sdylewski/Analog-Redial/README.md

**Home** · [1 · Get a board](docs/board.md) · [2 · Parts & assembly](docs/bom.md) · [3 · Flash & test](docs/flashing.md) · [4 · Set up & use](docs/setup.md)

<p align="center">
  Analog Redial logo
</p>

<h1 align="center">Analog Redial</h1>

<p align="center">
  <b>Bring old telephones back to life.</b><br>
  Plug in one or two analog phones, rotary or touch-tone, and they get real
  dial tone, ringing, an operator recording and an answering machine: a complete standalone phone system.<br>
  Hackable open source hardware and software with a working web UI for configuration.</p>

<p align="center">
  <a href="#everything-it-connects-to">Overview</a> ·
  <a href="#what-can-i-do-with-it">What it does</a> ·
  <a href="#set-it-up-from-your-browser">Web interface</a> ·
  <a href="#what-does-one-cost">Cost</a> ·
  <a href="#build-one">Build one</a> ·
  <a href="#community">Community</a>
</p>

<table>
  <tr>
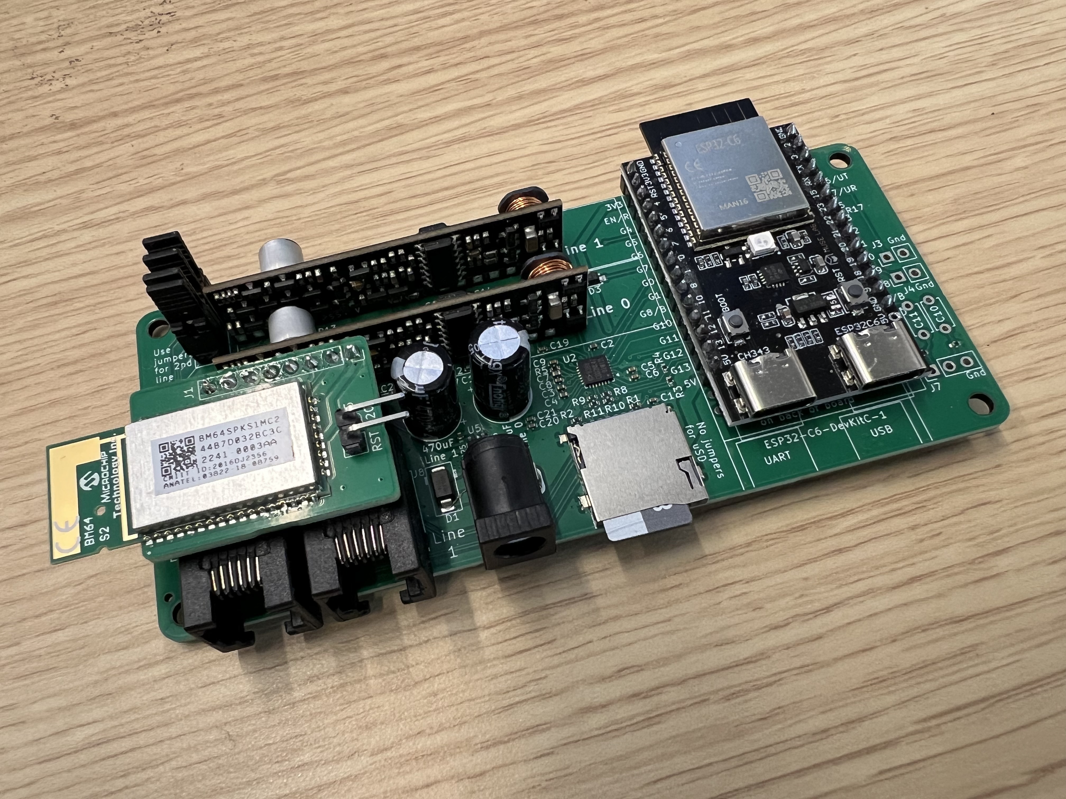
[picture p1: docs/pics/V5_board.jpg]
The Analog Redial board
    <td width="50%"></td>
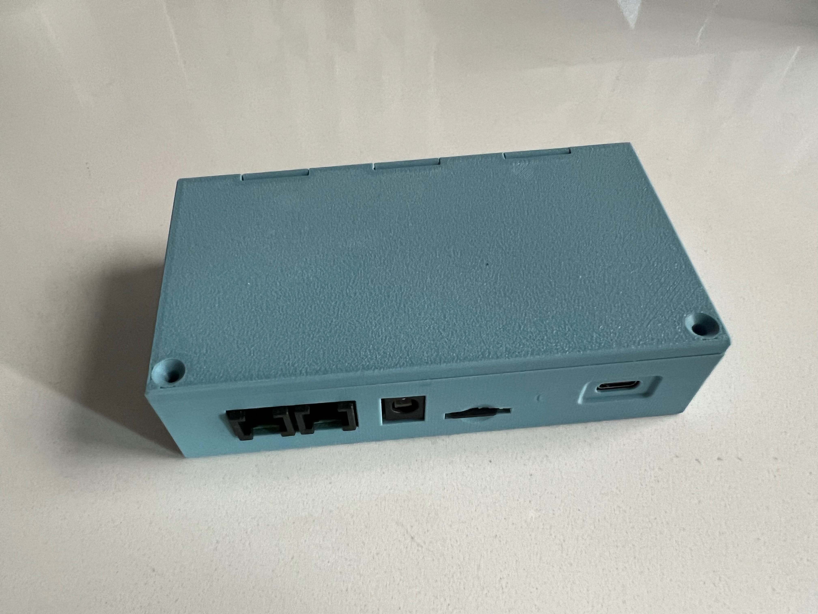
[picture p2: docs/pics/v4_case.jpg]
The board in its 3D-printed case
    <td width="50%"></td>
  </tr>
  <tr>
    <td align="center">The board: an ESP32-C6, an audio codec, with dual phone lines and the bluetooth module.</td>
    <td align="center">In its 3D-printed case <br>(<a href="https://github.com/sdylewski/Analog-Redial/blob/main/docs/case.md">case guide and print files</a>)</td>
  </tr>
</table>

## What can I do with it?

| | What you get | What you need |
|---|---|---|
| **Offline Calling** | Two phones, one board. Dial **321** (configurable) and the other phone rings.  No Wi-Fi required. Use in 2 rooms of a house or a fun toy for kids| 2 phones |
| **A phone that does things** | Dial a code and something happens: play a clip, leave a message, hear a joke. For museum exhibits, art pieces, a wedding guestbook phone. Add your own codes and audio from the browser. | One phone |
| **Call between boards** | Put a board in each room. Each gets its own 4-digit number the first time it's on your Wi-Fi; dial another board's number and its phone rings. It's VoIP over your home network: no server needed. | Two or more boards <br> Wi-Fi |
| **VoIP server** | Register a line with Asterisk, FreePBX or any SIP server and call anything that server can reach, at home or away. If the server goes down, the boards can still call each other directly. | One phone <br> Wi-Fi <br> SIP server |
| **Home Assistant** | Every pickup, hang-up and dial code becomes an event, so a dial code can turn on a light and the phone can ring when your doorbell does. Over MQTT or a plain webhook. *Experimental.* | Wi-Fi and Home Assistant (or any MQTT broker) |
| **Switch things** | Dial a code and a pin goes high for a few seconds or continuously: a relay, a buzzer, a lamp. | One line <br> no microSD <br> a relay |
| **Bluetooth calls** | Pair your mobile and the rotary phone becomes its handset: the bell rings for incoming calls, lift to answer, dial out on the rotary dial. | The BM64 Bluetooth board |

### Why not just buy a VoIP adapter?

You can do a lot with VoIP adapters and an Asterisk server, but this system can work fully offline if desired while also adding VoIP when needed.  There's also the possibility of uSD card access, bluetooth, or 4 GPIO pins to do even more.

## System overview

<p align="center">
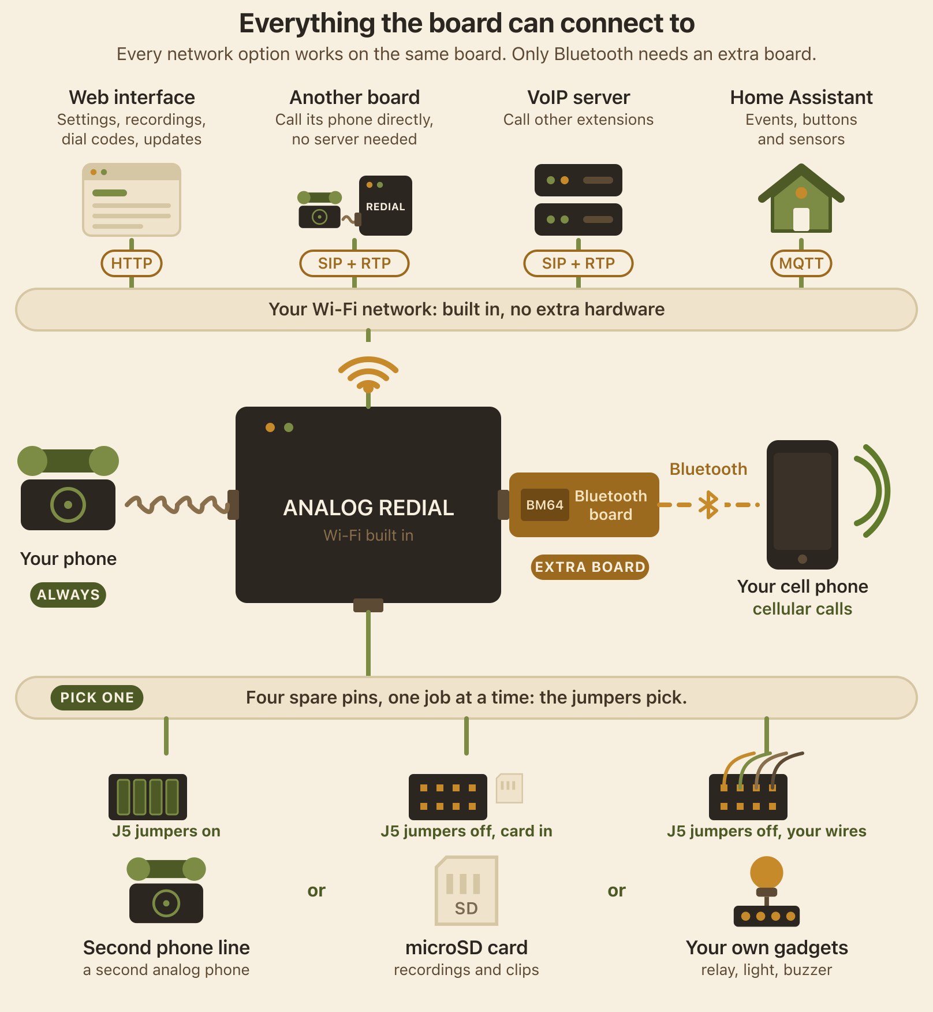
[picture p3: docs/assets/setup-overview-top-web.png]
Everything the Analog Redial board can connect to: one phone always, then a second phone line or a microSD card or your own gadgets on four spare pins chosen with the J5 jumpers; Wi-Fi to the web interface, other Analog Redial boards, a VoIP server and Home Assistant; and Bluetooth to a cell phone 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
  
</p>

Every network option runs on the board's own Wi-Fi, with nothing to add.
Bluetooth is the only one that needs an extra board.

### The finer print

- **Dialing.** Rotary pulse and touch-tone, on either line. Dial codes can be
  up to 10 digits (spaces, dashes and parentheses are ignored). Add your own
  codes and audio clips from the browser and give any built-in
  code a different number. 
  	- Play an audio file after dialing a number: **412** plays dial-up modem sounds
  	- Respond to any number: **314** reads pi aloud.
  	- A kitchen timer: dial **846**, then the number of minutes, and the phone rings when time is up.
  	- An alarm clock: dial **256**, then the time (0730), and the phone rings at that time.
  	- A weather line: dial **1212** for the forecast, read out like the old time-and-temperature numbers.
  	- Optional digit readback speaks each digit you dial (**822**
  on, **821** off)
- **Calls.** Line-to-line calls with ringback and busy tones. 
	- Optional intercom mode: lift one handset, wait, and the other phone rings with its
  own double ring. 
  	- Optional VoIP calls (G.711): directly between Analog Redial boards on the same network, with no server, or through a SIP server such as Asterisk.
- **Sound.** Dial tone, ringback and busy that match your country (North
  America, several European countries, Japan, China, or a generic
  international set). Echo cancellation and earpiece volume per line. An
  off-hook alert if a handset is left off. Experimental voice effects
  (Dalek, chipmunk, robot) mid-call.
- **Messages.** Record a message with **211** and download it from the
  browser. 
  	- Optional per-line answering machine, each line with its own greeting,
  that also answers VoIP or local calls. 
  	- Storage to internal flash or microSD card for hours of storage
  (1-line version only). 
- **Payphones.** Dial tone, ringing, dialing and calls work on a payphone like
  on any phone; the coin mechanism isn't supported yet. See
  [Payphones](docs/setup.md#10-payphones).
- **Home automation.** Every pickup, hang-up, dial code and incoming ring
  can go to Home Assistant, or any system that takes a webhook or MQTT. Home
  Assistant can ring a phone or fire a pin output back. Experimental; see
  [Home Assistant](docs/home-assistant.md).
- **Things on the pins.** A dial code can switch one of four spare pins
  (a relay, a buzzer, a lamp) for a set number of seconds, or toggle it.
- **Day to day.** Quiet hours that silence the bell overnight. Remembers
  several Wi-Fi networks. An optional web password. Firmware updates from
  the browser. A one-button rescue mode for when it can't find its network.
  Board blink codes to indicate activity and errors.
- **Open.** ESP-IDF C firmware under the MIT license, KiCad hardware files,
  and a serial console for debugging.

Full feature list and firmware architecture: [Features](docs/features.md).

---

## Set it up from your browser

The board serves its own web page at **`http://phone.local`**, reachable
from any phone or laptop on your Wi-Fi. No app, no account, no cloud. On
first boot it makes its own Wi-Fi network with a setup page that gets it
onto yours. Firmware is updating frequently, so these are just examples.

<table>
  <tr>
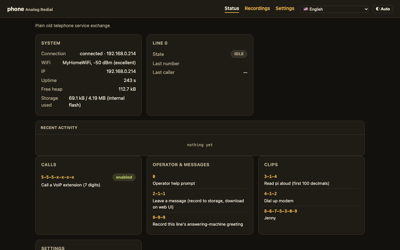
[picture p4: docs/pics/thumbs/status.png]
Status page
    <td align="center" width="33%"><br><b>Status</b><br>Lines, activity, the dial guide</td>
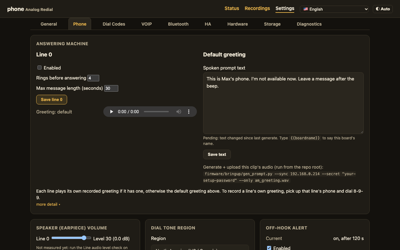
[picture p5: docs/pics/thumbs/settings-phone.png]
Phone settings
    <td align="center" width="33%"><br><b>Phone settings</b><br>Answering machine, tones, effects</td>
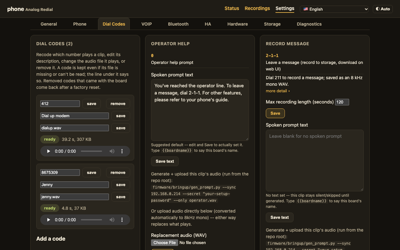
[picture p6: docs/pics/thumbs/settings-dialcodes.png]
Dial codes and prompts
    <td align="center" width="33%"><br><b>Dial codes</b><br>Your own codes and audio</td>
  </tr>
  <tr>
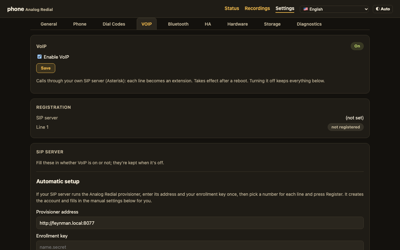
[picture p7: docs/pics/thumbs/settings-voip.png]
VoIP settings
    <td align="center"><br><b>VoIP</b><br>SIP server, generated Asterisk script</td>
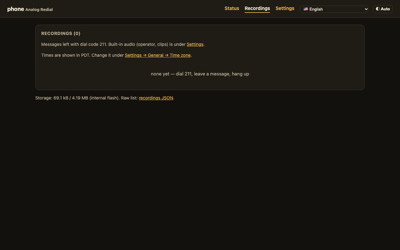
[picture p8: docs/pics/thumbs/recordings.png]
Recordings
    <td align="center"><br><b>Recordings</b><br>Play or download messages</td>
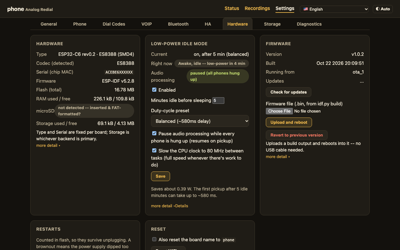
[picture p9: docs/pics/thumbs/settings-hardware.png]
Hardware settings
    <td align="center"><br><b>Hardware</b><br>Line count, microSD, firmware update</td>
  </tr>
</table>

Click any picture for the full page. A guided tour is in
[Set up & use](docs/setup.md).

---

## What does one cost?

US prices from October 2026, including shipping and import tariff:

| | Per board | 5 boards |
|---|---:|---:|
| Assembled PCB from JLCPCB, delivered (5-board minimum) | $17.11 | $85.53 |
| Parts you solder, from DigiKey ([parts list](docs/bom.md)) | $19 | $95 |
| DigiKey shipping, about $5 an order | $1 | $5 |
| **Total, one phone line** | **about $37** | **about $186** |
| Second phone line (optional) | +$10 | +$50 |
| Bluetooth board (optional, v5) | +$15 | +$80 |

**Five boards cost about $186 in all, about $37 each.**
JLCPCB's minimum is five, so it's about $110 up front, with four spare PCBs.
The five-board Bluetooth figure is $15 a board plus about $5 shipping. Buying
the hand-solder parts from AliExpress saves $7 per board.

You'll also want a 2 A USB-C charger (or a regulated 5-6 V, 2 A DC supply for the DC jack; never 9 V or 12 V) and one or two analog phones. 

Most of a small order is fixed PCB setup fees, so boards get cheaper when people
order together. If you'd like a board,
**[fill out the interest form](https://forms.gle/kVKHiXejV6M2ZxC17)**. It's
only to show interest, so I can email you when boards are available on Tindie;
there's no commitment. Questions? [Join the Discord](https://discord.gg/zEZkqfcxqE) and ask there.

Price breakdown: [Get a board](docs/board.md#what-it-costs).

---
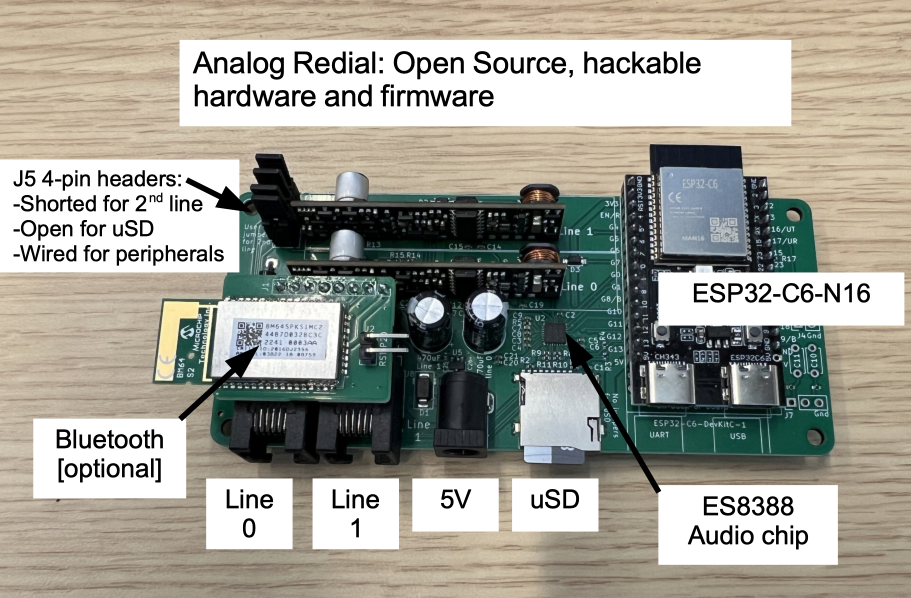
[picture p10: docs/pics/V5_board_annotated.png]
Analog Redial v5 board, with its parts labelled
<br>

## Build one

No surface-mount soldering needed: the fab places the small parts, and
everything you solder is through-hole. If you can solder a header and type a
few commands in a terminal, you can build one.

| Step | Guide | What's in it |
|---|---|---|
| **1** | [Get a board](docs/board.md) | Board versions, ordering from JLCPCB, buying on Tindie, costs |
| **2** | [Parts](docs/bom.md) and [assembly](docs/building.md) | What to buy, soldering order, checks before power-on; [v5 step by step](docs/build-v5.md) |
| **3** | [Flash & test](docs/flashing.md) | Install ESP-IDF, flash the firmware, run the hardware self-test |
| **4** | [Set up & use](docs/setup.md) | Wi-Fi, the web interface, dial codes, your own audio |

Going further: [Troubleshooting](docs/troubleshooting.md) ·
[VoIP setup](docs/voip-setup.md) ·
[Home Assistant](docs/home-assistant.md) ·
[Board reference (v4)](docs/hardware-smd4.md) ·
[Board reference (v5)](docs/hardware-smd5.md) ·
[Features & firmware architecture](docs/features.md) ·
[Firmware developer notes](https://github.com/sdylewski/Analog-Redial/blob/main/firmware/README.md)

> ⚠️ **Phone lines carry real voltage.** The board drives about 48 V DC on
> an off-hook line and about 60 V AC while ringing, with peaks near 90 V.
> Don't touch the phone jacks or the line chips while it's powered, and never
> connect it to your house or telephone-company wiring. This is a hobby
> project, not certified telecom equipment.

---

## Community

- **Discord:** [join the server](https://discord.gg/zEZkqfcxqE) for questions, build help and show-and-tell
- **Want a board?** [Interest form](https://forms.gle/kVKHiXejV6M2ZxC17): just to show interest, so I can email you when boards are available on Tindie. Questions? Ask in the Discord.
- **Bugs and questions:** [GitHub Issues](https://github.com/sdylewski/Analog-Redial/issues)
- **Built one?** Post a picture in the Discord channel! We'd love to see it.

---

## Project history

| When | Version | What it was |
|---|---|---|
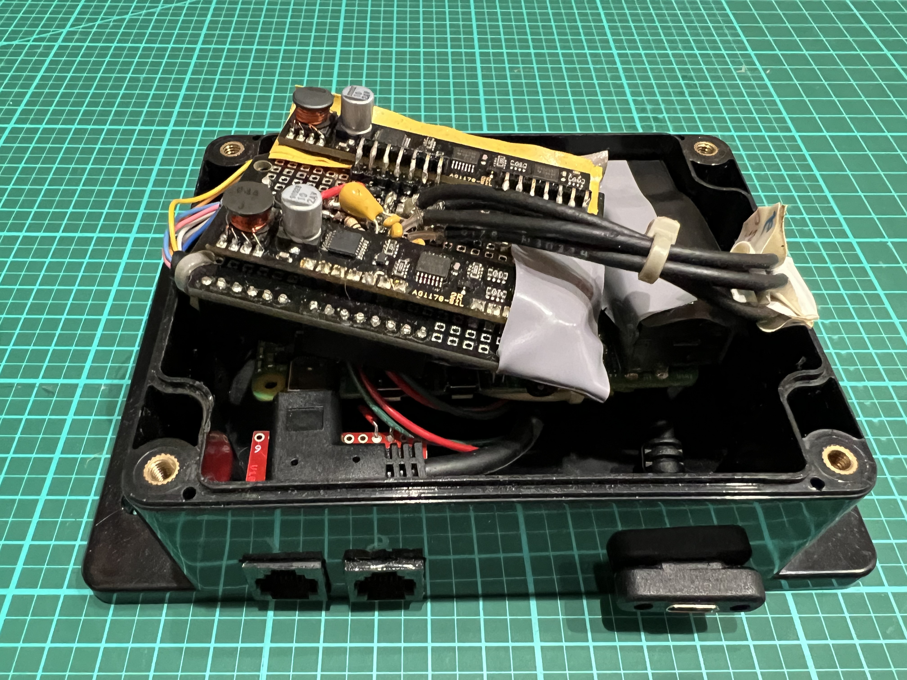
[picture p11: docs/pics/pi_version.jpg]
Raspberry Pi version in its project box
| Aug 2020 | **Raspberry Pi** <br> | A Raspberry Pi 4 in a project box, two SLIC modules hand-wired on breadboard to the GPIO header, and a USB sound dongle per phone line. Hand written python software and shell scripts. No web UI, but it worked!|
| Jun 2026 | **v1** | The first ESP32 board: through-hole, with a WM8731 codec and two AG1170 SLICs. The Pi's job on a $5 microcontroller. Never built because boards got lost in the mail.|
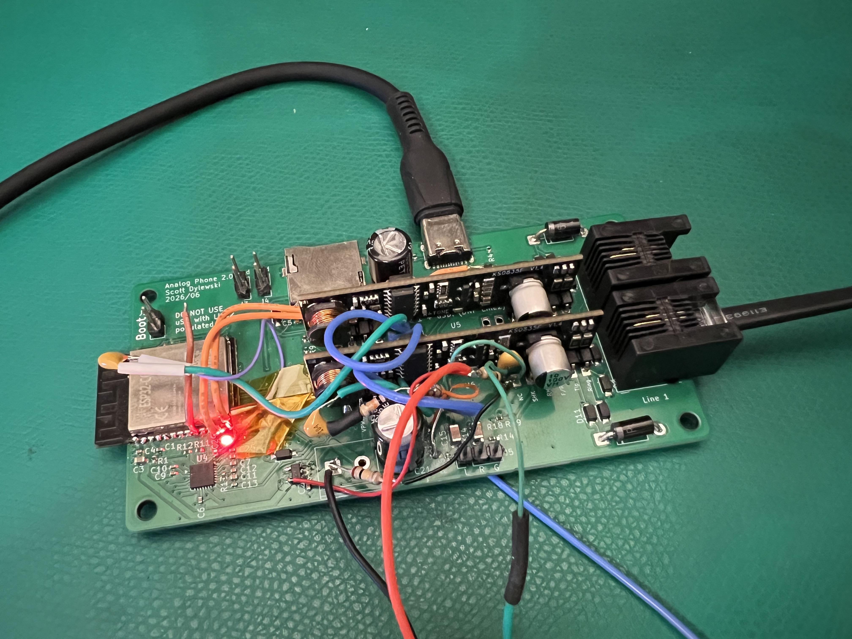
[picture p12: docs/pics/smd2_board.jpg]
Analog Redial v2 board
| Jul 2026 | **v2** <br> | First surface-mount board: ESP32-C6 module, ES8388 codec, AG1171 SLICs, microSD. Required rework on audio lines and usb connection but it worked. |
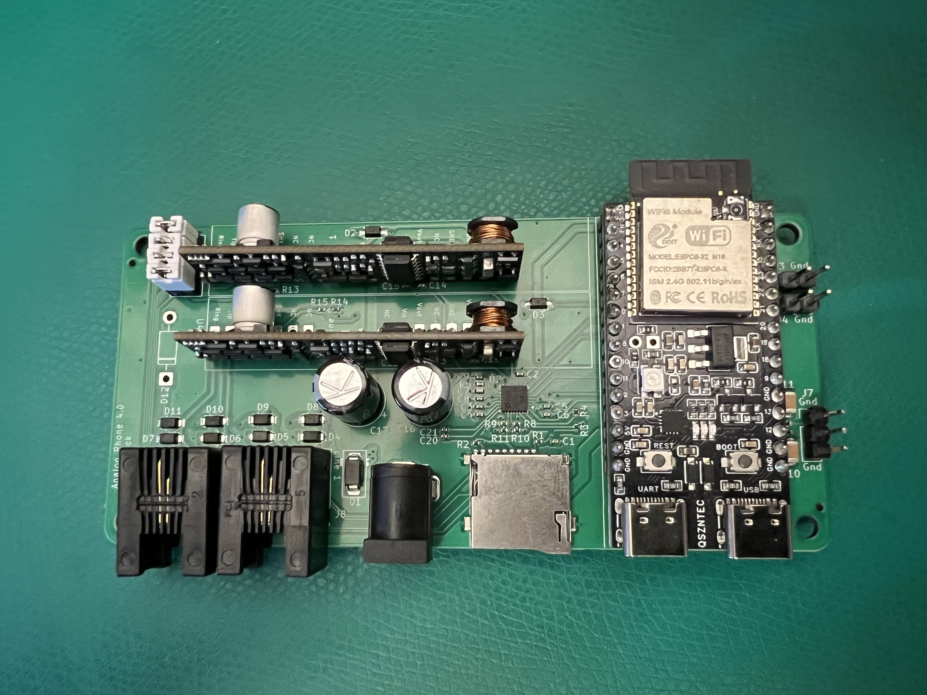
[picture p13: docs/pics/smd4_board.jpg]
Analog Redial v4 board
| Sep 2026 | **v4** <br> | 2-layer, built around a cheaper 32-pin ESP32-C6-DevKitC-1, one or two phone lines, optional microSD. |
| Oct 2026 | **v5** <br>Analog Redial v5 board| Working: takes a genuine or clone ESP32-C6 module, and adds the expansion header (used for the Bluetooth board). <br>**With a clone module, remove the clone's bottom-right 5V pin** (see [Get a board](docs/board.md)). |
| Oct 2026 | **v5.1** | **RECOMMENDED VERSION** v5 with the clone-module 5V pin fixed (nothing to remove) and small silkscreen and fab-file updates. |
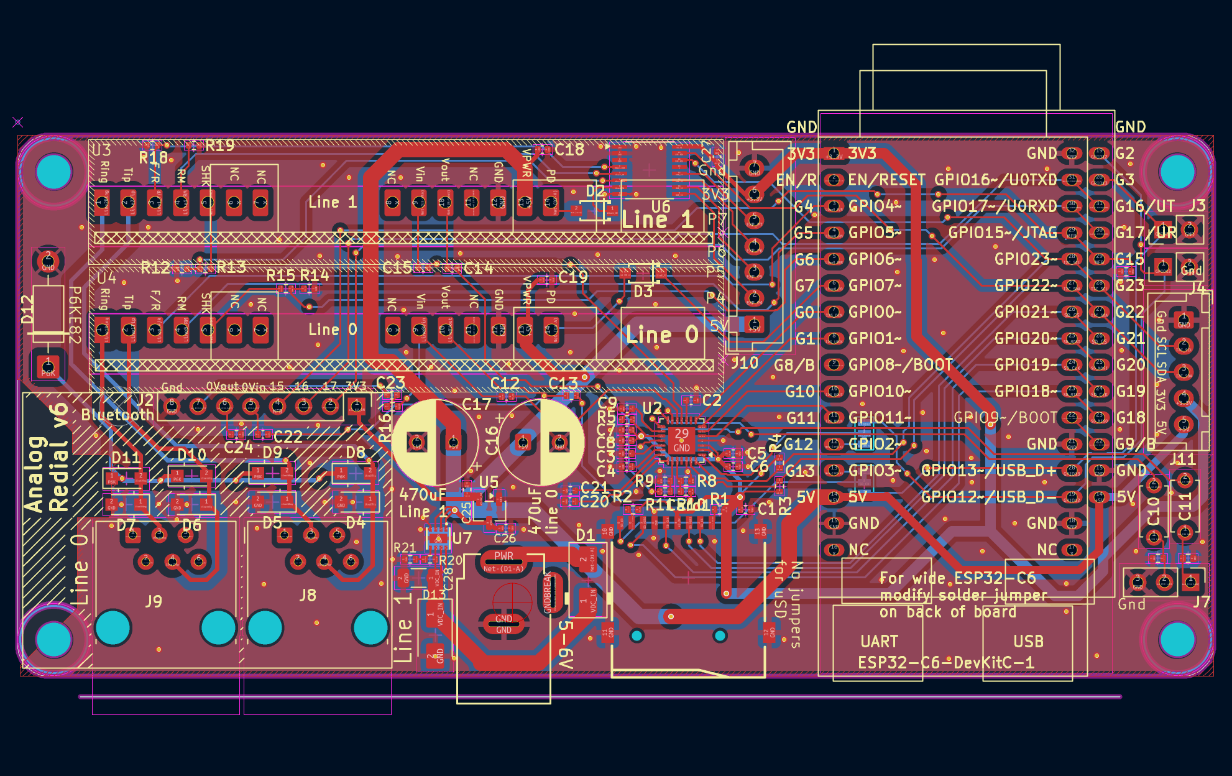
[picture p14: docs/pics/V6_board_top.png]
Analog Redial v6 board
| Nov 2026 | **v6** <br> | **Released, not built or tested yet.** Two phone lines, the microSD card, payphone support and extra I/O all working at once (an I²C I/O expander drives the second line), plus the clone-module 5V pin fix and a 3 A diode (SS34) for the DC jack. |

### Related projects

Other open-source projects that bring old phones back to life:

| | [Analog Redial](https://github.com/sdylewski/Analog-Redial) | [RotaryCell](https://github.com/fregacmols/RotaryCell) | [weeBell](https://github.com/danjulio/weeBell_hardware) | [1dcoinctrl](https://github.com/hharte/1dcoinctrl) |
|---|---|---|---|---|
| **What it is** | Standalone phone system | Cellular conversion | Bluetooth adapter | Payphone coin controller |
| **MCU** | ESP32-C6 | ESP32 (LilyGO) | ESP32 (gCore) | PIC18F |
| **SLIC** | AG1171 | AG1171 | AG1171 | — |
| **Codec** | ES8388 | Passive | ES8388 | — |
| **Custom PCB** | ✅ | ✅ | ✅ | ✅ |
| **Rotary dial** | ✅ | ✅ | ✅ | ✅ |
| **Touch-tone (DTMF)** | ✅ | ❌ | ✅ | ❌ |
| **VoIP / SIP** | ✅ | ❌ | ❌ | ❌ |
| **Bluetooth calling** | ✅ | ❌ | ✅ | ❌ |
| **Cellular (SIM)** | ❌ | ✅ | ❌ | ❌ |
| **Web UI** | ✅ | ✅ Maintenance | ❌ LCD only | ❌ |
| **Answering machine** | ✅ | ❌ | ❌ | ❌ |
| **2nd phone line** | ✅ +$10 | ❌ | ❌ | ✅ Up to 4 |
| **Offline phone-to-phone** | ✅ | ❌ | ❌ | ❌ |
| **Dial codes & actions** | ✅ | ❌ | ❌ | ❌ |
| **Home automation** | ✅ | ❌ | ❌ | ❌ |
| **Payphone coin support** | In progress | ❌ | ❌ | ✅ +/-130 V |
| **OTA firmware update** | ✅ | ✅ | ❌ | ❌ |
| **Battery powered** | USB-C power bank | ✅ | ✅ | ❌ |
| **Approx. cost** | **~$37** (+$15 BT) | **~$60** + SIM | **~$60** shield + gCore (~$80-100) | **~$50-80** est. |
| **License** | MIT | MIT | CC0 | MIT |
| **GitHub stars** | — | 196 | 18 | 75 |

**RotaryCell** puts a cellular modem (LilyGO T-SIM7670G) and an AG1171
inside a rotary phone, turning it into a standalone battery-powered cell
phone with no Wi-Fi needed. It's the most polished project in the list,
with an illustrated build guide and multiple documented builds. The
published BOM is ~$52 for the core parts (LilyGO $29, PCBs $9, AG1171
$8.50, battery $5) plus a SIM card with ongoing service.

**weeBell** by [danjulio](https://github.com/danjulio) pairs a phone to
your cellphone via Bluetooth (the phone becomes a handset). It uses the
same ES8388 codec as Analog Redial, and the gCore it runs on brings a large
display. The POTS shield is
[available assembled on Tindie](https://www.tindie.com/products/30895/)
for about $60, but it also needs a [gCore](https://www.tindie.com/products/29204)
(ESP32 board with a 480 × 320 display, roughly $80-100) and an 18650
battery, so a complete build costs well over $140. weeBell replaces
danjulio's earlier Teensy-based Blue Pot.

**1dcoinctrl** by [hharte](https://github.com/hharte) is a coin-line
controller for Western Electric 1D/2D "dumb" payphones. It generates
+/-130 VDC for coin collect/refund and interfaces with Asterisk — the
closest existing project to the Analog Redial payphone coin board.
It requires a separate ATA and Asterisk server; it does not generate
dial tone or ring voltage itself. Cost is estimated at $50-80 for a
full 4-line build (PIC MCU, DC-DC converter, 7+ relays, PCB).

## License

[MIT](LICENSE) for the firmware and documentation. Hardware design files are
provided as-is for personal and hobby use; see the note in [`LICENSE`](LICENSE).
