sdylewski/Analog-Redial/firmware/README.md

# Analog Redial — ESP32-C6 firmware

ESP-IDF firmware for a two-line analog phone exchange. Replaces the
Raspberry Pi software (`../../pi_rotary_phone`) with on-chip peripherals: an
I²S/I²C audio codec, one or two Silvertel AG1171 SLICs (GPIO), and an
embedded SIP/RTP path for VoIP.

Current production board is **SMD4**, ESP32-C6-DevKitC-1 + **ES8388** codec
+ AG1171 SLIC(s) (`board_pins_smd4.h`) — see
[`../docs/hardware-smd4.md`](../docs/hardware-smd4.md). The original
through-hole reference board (WM8731 codec) is no longer supported by this
firmware; its docs are archived under
[`archive/hardware/through-hole-wm8731/`](../archive/hardware/through-hole-wm8731/).

See [`../docs/features.md`](../docs/features.md) for the feature list and
architecture. GPIO maps live in `components/board/include/`
(`board_pins_smd4.h`, `board_pins_smd.h` for SMD2; `board_pins.h` picks one)
— match `CONFIG_BOARD_*` to your actual board; parts are in
[`docs/bom.md`](../docs/bom.md).

## Requirements

- **ESP-IDF v5.2.8** exactly (the tracked `sdkconfig` is generated by it; the
  build warns on any other version).
- Target: **esp32c6** (ESP32-C6-DevKitC-1 for SMD4, or your own board).

## Toolchain setup (macOS)

Linux and Windows: the install steps for all three are in
[docs/flashing.md §2](../docs/flashing.md#2-install-the-toolchain-once); the build, flash and console
sections below are the same on every OS (on Windows run the Python scripts with `python <script>.py`, and
the port is `COMn`). This section is the longer macOS walk-through.

These steps install ESP-IDF and the cross-compiler/tools on your Mac. You only
run the install once; after that you just `get_idf` (or `source export.sh`) in
each new terminal before building.

Official reference:
[ESP-IDF macOS setup (ESP32-C6)](https://docs.espressif.com/projects/esp-idf/en/v5.2/esp32c6/get-started/linux-macos-setup.html).

### 1. Prerequisites

Install Xcode command-line tools (compiler, `git`, etc.):

```bash
xcode-select --install
```

Install build helpers with Homebrew (you already have `cmake` from Homebrew; add
the rest):

```bash
brew install cmake ninja dfu-util ccache python3
```

Check Python 3 is available (`python3 --version` should be 3.8+).

### 2. Clone ESP-IDF

Pick a fixed install location (default `~/esp`). Use the **v5.2.8** tag --
the version the tracked `sdkconfig` is generated with. (`-b v5.2` is also a
*tag*, meaning 5.2.0, not "latest 5.2"; building on a different version
rewrites `sdkconfig` and shows it as modified.)

```bash
mkdir -p ~/esp
cd ~/esp
git clone -b v5.2.8 --recursive https://github.com/espressif/esp-idf.git
```

That creates `~/esp/esp-idf`. To move an existing checkout to the pinned
version: `git fetch --tags && git checkout v5.2.8 && git submodule update
--init --recursive && ./install.sh esp32c6` (delete any leftover untracked
submodule dirs git warns it couldn't remove), then `idf.py fullclean build`
in a new terminal. Moving the project to a newer ESP-IDF is a deliberate
change: bump `IDF_PINNED_VERSION` in `firmware/CMakeLists.txt`, these docs,
and commit the regenerated `sdkconfig` together.

### 3. Install tools (compiler, OpenOCD, Python venv, …)

Install the toolchain **for ESP32-C6 only** (faster than `all`):

```bash
cd ~/esp/esp-idf
./install.sh esp32c6
```

This downloads compilers and utilities into `~/.espressif/` and may take several
minutes on first run.

If GitHub downloads are slow or fail, use Espressif’s mirror before `install.sh`:

```bash
export IDF_GITHUB_ASSETS="dl.espressif.com/github_assets"
./install.sh esp32c6
```

On Apple Silicon, if you see `bad CPU type in executable` for an old tool, install
Rosetta once: `/usr/sbin/softwareupdate --install-rosetta --agree-to-license`

If Python SSL errors appear on macOS, run Apple’s certificate installer for your
Python (often `Applications/Python 3.x/Install Certificates.command`) — see
[ESP-IDF tool install troubleshooting](https://docs.espressif.com/projects/esp-idf/en/v5.2/esp32c6/get-started/linux-macos-setup.html).

### 4. Activate the environment (every new shell)

ESP-IDF uses a Python virtualenv and PATH changes that are **not** global. In
each terminal where you want `idf.py`:

```bash
. $HOME/esp/esp-idf/export.sh
```

Add a shortcut to `~/.zshrc` so you can type `get_idf` instead:

```bash
echo 'alias get_idf=". $HOME/esp/esp-idf/export.sh"' >> ~/.zshrc
source ~/.zshrc
```

Then in any new terminal:

```bash
get_idf
idf.py --version    # should print ESP-IDF v5.2.8
```

Do **not** put `export.sh` in `.zshrc` permanently — it activates the IDF
virtualenv in every shell and can interfere with other Python tools.

### 5. Find the serial port

Plug in the board (USB). On macOS the port is usually under
`/dev/cu.*` (use `cu`, not `tty`, for flashing):

```bash
ls /dev/cu.usb*
```

Typical names: `/dev/cu.usbmodem101` or `/dev/cu.usbmodem1101`. Unplug/replug
and run `ls` again if unsure which device appeared.

The DevKit’s built-in **USB Serial/JTAG** is the default console for this
firmware (the prompt is the board's name, e.g. `telephono>`). The PCB’s UART headers (J4/J5, GPIO16/17) are an
alternate if you wire them.

### 6. Verify with a smoke test (optional)

After `get_idf`, confirm the toolchain can see your chip:

```bash
cd ~/esp/esp-idf/examples/get-started/hello_world
idf.py set-target esp32c6
idf.py -p /dev/cu.usbmodemXXXX build flash monitor
```

Exit the monitor with **Ctrl+]**. Then build this project (below).

### Cursor / VS Code (optional)

The [Espressif IDF extension](https://marketplace.visualstudio.com/items?itemName=espressif.esp-idf-extension)
can run `idf.py build flash monitor` from the UI. Point it at `~/esp/esp-idf`
and set the project directory to this repo’s `firmware/` folder.

## Build / flash / monitor

```bash
get_idf    # or: . $HOME/esp/esp-idf/export.sh

cd /path/to/esp32_rotary_phone/firmware
idf.py set-target esp32c6    # first time only (or after changing target)
idf.py build
idf.py -p /dev/cu.usbmodemXXXX flash monitor
```

Replace `/dev/cu.usbmodemXXXX` with your port from step 5 above.

### Building for a different board type (SMD2/SMD4/SMD5/SMD5-cheap)

The default `build/` directory (and its tracked `sdkconfig`) targets SMD4.
Every other board type gets its own build directory and its own
`sdkconfig.<type>.defaults` file layered on top of the shared
`sdkconfig.defaults`:

| Board type | Build dir | Kconfig |
|---|---|---|
| SMD4 (default) | `build/` | `CONFIG_BOARD_TYPE_SMD4` |
| SMD2 | `build.smd2/` | `CONFIG_BOARD_TYPE_SMD2` |
| SMD5, real MCU module | `build.smd5/` | `CONFIG_BOARD_TYPE_SMD5` |
| SMD5, AliExpress clone module | `build.smd5_cheap/` | `CONFIG_BOARD_TYPE_SMD5_CHEAP` |
| SMD6 (v6, in progress, not tested on hardware), either MCU module, JP2/JP3 to match | `build.smd6/` | `CONFIG_BOARD_TYPE_SMD6` |

Create (or regenerate) a non-default board's build directory with an
**explicit `-D SDKCONFIG=`** — leaving it out can silently make `idf.py`
write to the *shared root* `sdkconfig` instead of the build directory you
asked for:

```bash
idf.py -B build.smd5 -D SDKCONFIG="build.smd5/sdkconfig" \
  -D SDKCONFIG_DEFAULTS="sdkconfig.defaults;sdkconfig.smd5.defaults" \
  set-target esp32c6
idf.py -B build.smd5 build
```

Then plain `idf.py -B build.smd5 build`/`flash`/`monitor` from then on —
`-B` alone is enough once the build directory's own `sdkconfig` exists.
**Always pass `-B`** for a non-default board type; a bare `idf.py build`
targets `build/` (SMD4) regardless of which directory you last touched.

SMD5's two Kconfig choices exist because of *which MCU module variant* is
soldered down (see `archive/hardware/smd5.md`), not a different
pin map — same SLIC/codec wiring either way. The real module keeps native
USB working (flash/monitor exactly like SMD2/SMD4); the AliExpress clone
module's native-USB pins don't reach the board's own USB connector once
assembled, so that variant's `sdkconfig.smd5_cheap.defaults` leaves the
console on plain UART0 instead — flash and monitor it over an external
UART adapter on `GPIO16`/`GPIO17`/`EN`/`GPIO9`, or use OTA
(`/ota_upload`) once a build is confirmed good.

If you edit a `sdkconfig.<type>.defaults` file, note that defaults files
only fill in values not already set in an existing `sdkconfig` — they never
retroactively override one. Delete the build directory
(`rm -rf build.<type>`) and re-run `set-target` for a defaults-file change
to actually take effect.

### Monitor keys

`idf_monitor` intentionally does **not** bind Ctrl+C to quit — Ctrl+C is
passed through to the target instead. Use:

| Keys | Action |
|---|---|
| **Ctrl+]** | Quit |
| **Ctrl+T, Ctrl+X** | Quit (alternate, if your terminal app eats Ctrl+]) |
| **Ctrl+T, Ctrl+H** | Full shortcut list (menu help) |
| **Ctrl+T, Ctrl+R** | Reset the target (RTS pin toggle) without leaving the monitor |

`Ctrl+T` is the menu prefix — press it, release, then press the second key.

> No PCB yet? You can still flash a bare DevKit and run the console — the
> hardware-dependent commands fail gracefully (e.g. `i2c_scan` finds nothing,
> `hookmon` reads floating pins). The DSP commands (tones, DTMF gen) and the
> state machine run regardless.

## Bring-up checklist (serial console)

After boot you get a prompt named after the board (e.g. `telephono>`). The full
telephony stack is already running concurrently. Type `help` for the full
list.

For a board-agnostic, scripted bring-up (SMD2/SMD4/SMD5), see
[`firmware/bringup/README.md`](bringup/README.md)'s `flash_board.py --setup`
and `bringup_checklist.py` — they drive this same console over serial, one
step per subsystem, without typing each command by hand.

### Console command reference

| Command | Description |
|---|---|
| `board_info` | Board type, line count, I2C pins |
| `i2c_scan` | Probe the I²C bus for the codec |
| `codec_detect` | Check the ES8388 answers on I²C |
| `codec_init` | Initialize the ES8388 codec |
| `codec_dump` | Print codec registers (written vs. read back) |
| `tone <hz> <ms> <line>` | Arbitrary test tone on a line |
| `dialtone\|ringback\|busy [line]` | Call-progress tones |
| `tonetest [line] [tx]` | Plays a 350 + 450 Hz test tone and measures what the SLIC returns: level, clipping and distortion (clean is under 3%). Add `tx` to measure the digital samples going to the codec instead, to tell firmware problems from analog ones. The same measurement backs the Diagnostics page's "Line audio level" check |
| `spkamp <l> <r>` | Earpiece drive level, 1.5 dB per step, 30 = 0 dB, default 24; the web slider uses the same numbers. Re-run `tonetest` after changing it |
| `fx <line> <effect> [both]` | Set a voice effect by hand (1 Dalek, 2 chipmunk, 5 robot, 6 tremolo, 0 off). With `loopback <line> 1` you hear your own voice through it, no call needed |
| `fxtest [Hz] [line] [effect]` | Deterministic effect check: a pure tone (default 1 kHz) through every effect, reporting the two strongest spectral lines out (chipmunk at the default 130%: 1000 Hz → 1300 Hz, Dalek → 970 + 1030 Hz, …), levels, tremolo depth, and the CPU time per 10 ms frame. With a line (handset on-hook) it repeats the test through the real engine path, DAC, SLIC and back in through the hybrid; with an effect number it repeats just that effect three times |
| `fxgain [percent]` | Output gain applied after every voice effect, 10–300% (default 100, resets on reboot) — for testing how much headroom the effects have |
| `dtmfbench` | Times the touch-tone detector per 10 ms audio frame (the CPU it takes out of the audio task) |
| `audiostat` | Counts the frames of clip/VoIP audio that were replaced by silence because the source was late (a dropout adds several; a clip starting and ending adds about 5) |
| `fxstat [secs]` | Live levels through the effects, peak and rms in and out, and how often the peak limiter acted. The same numbers are on the Diagnostics page ("Voice effects: live levels") |
| `silence [line]` | Stop audio on a line |
| `loopback [line] [0\|1]` | Mic → own speaker round-trip |
| `capture [ms]` | RX RMS level meter for both lines |
| `dtmf_gen <digits> [line]` | Emit DTMF digits |
| `slic <line> <pd\|fr\|rm> <0\|1>` | Raw SLIC pin control |
| `ring [line] [secs]` | Ring cadence on a line |
| `hookmon [secs]` | Live SHK / hook state |
| `status` | Per-line telephony state |

## Layout

```
firmware/
├── CMakeLists.txt          # project
├── sdkconfig.defaults      # target esp32c6, console, 4MB flash, custom parts
├── partitions.csv          # factory app + two SPIFFS partitions: storage (writable) + bundled (build-time assets)
├── main/app_main.c         # boot + wire-up + console
└── components/
    ├── board/      # GPIO map (board_pins.h) + I2C bus init + codec auto-detect
    ├── es8388/     # codec I2C driver
    ├── audio/      # I2S engine, routing, RX taps (VoIP seam)
    ├── tones/      # dual-tone + call-progress synth
    ├── dtmf/       # DTMF gen + Goertzel detect
    ├── ag1170/     # SLIC: hook debounce, pulse dial, ring cadence
    ├── dialplan/   # dial-code table (ported from DIAL_CODES.md)
    ├── telephony/  # per-line call state machine
    ├── voip/       # SIP/RTP interface (stub now; impl last)
    └── bringup/    # esp_console test harness
```

## WiFi setup & factory reset

**Setting credentials** — any of:
- Serial console: `wifi_set <ssid> <password>`; or `wifi_scan` then
  `wifi_set #N <password>` for names a terminal can't type (apostrophes,
  accents, emoji); `wifi_set -u` takes `%XX` escapes
- Web UI: **Settings → General → WiFi**
- First boot with nothing saved: the device starts its own **SoftAP**
  (`AnalogRedial-XXXX`, open) — join it and a setup page opens (captive portal),
  or browse to `http://192.168.4.1`.
- No saved network in range (or none will connect after 3 tries each): the
  same setup network comes up, named after the board once it has a name
  (`Analog Redial - <name>`), and the board keeps rescanning every minute to
  rejoin a saved network when one appears.

**Factory-resetting WiFi (GPIO9 / BOOT strap)**

With the device **powered on and running**, short **GPIO9 (BOOT)** to **GND**
(or hold the BOOT button) for **~3 seconds**. The firmware erases the saved
WiFi credentials and reboots into SoftAP provisioning. The status LED flashes
the error pattern while it resets.

> ⚠️ Do this **at runtime, not at power-on**. GPIO9 is a boot strapping pin:
> if it's held low *during reset/power-up* the ROM enters serial-download
> (flashing) mode and the app never runs — so it wouldn't reset anything.
> Power up first (leave BOOT alone), *then* short it once the phone is up.

The chip MAC (Settings → Hardware → Serial) is untouched by a reset; only the
WiFi credentials and — if you never set a custom board name — the auto-picked
name are cleared.

## Notes / current limitations

- **VoIP** (`components/voip`) is a custom embedded SIP UA + RTP/G.711
  (µ-law). It registers to a LAN Asterisk with MD5 digest auth and places/
  answers calls; dial `555` + a 4-digit extension. Configure from Settings →
  VOIP (server + per-line extension/username/password, takes effect on
  reboot) or the console (`sip_set <server> <user0> <pass0> [user1] [pass1]`,
  then reboot) — either writes the same NVS config. That same Settings tab
  also has a "Download Asterisk server setup script" link that generates a
  ready-to-run script for the Asterisk/PBX box (marker-tagged config blocks,
  safe to run alongside other phones already configured on that server).
  Bench-tested registering both accounts and running an outbound call (echo
  test) end to end; no TLS/SRTP (LAN only). Check state with `sip_status`
  or the registration pill on that same Settings page.
- **microSD (single-line build)** — the `sdcard` component mounts a FAT card over SPI
  (CS=21, MOSI=20, SCLK=19, MISO=18 — the pins line 2 otherwise uses) at `/sd`.
  It's a **runtime setting**, not a build option: Settings → General → Board
  hardware → "A microSD card (one phone line)" (or `first_setup.py --lines 1`),
  with the J5 shunts off. Recordings then go to the card; clips and prompts stay
  on internal flash so they survive a card being removed. `sd_test` from the
  console prints card info and a write/read/verify.
- **Audio assets** live in two SPIFFS partitions (`components/storage`):
  `storage` (writable — recordings + anything uploaded over HTTP, subject to
  eviction once near full; protects everything except `rec_`/`cb_`-prefixed
  transient files, not a fixed asset-name allowlist) and `bundled` (built
  from `firmware/assets/` at compile time via `spiffs_create_partition_image`,
  reflashed with every `idf.py flash`, never touched by a recording).
  Playback and the `/media` download route check `storage` first, then fall
  back to `bundled`, so an upload of the same name overrides a bundled
  default without a rebuild. Only `operator.wav`, `am_greeting.wav` and
  `dialup.wav` ship by default (the `BUNDLED_AUDIO` list in
  `main/CMakeLists.txt`) — see
  [`firmware/assets/README.md`](assets/README.md) for the mechanism and why
  the fun-clip test set isn't bundled (copyright). Dial codes with no
  matching file still log and play a confirmation tone.
- **Dial codes** (`components/dialplan`) — the fixed compile-time `TABLE[]`
  covers operator/record/inter-phone/radio/mode codes, but the "silly clip"
  codes (401/411/…) are a separate mutable `dialplan_clip_entry_t` table
  (code + filename + desc + builtin flag), seeded once from
  `dialplan_defaults.h`'s `CLIP_DEFAULTS` -- now just 412, the dial-up modem
  sound -- with plain filenames (`dialup.wav`, not the old `clip_412.wav`
  convention). Settings → Dial Codes lets you recode any of them and/or
  upload new audio for them independently, plus add brand new codes — a real
  `<input type=file>` browser upload (new `multipart.c` reader in `webui` +
  the `audio_convert` component) converts whatever WAV comes in to 8kHz mono,
  no host-side conversion step needed. Settings → Operator has the same kind
  of upload form for `operator.wav` specifically (fixed code `0`, not part of
  the mutable table). MP3 upload is available too behind
  `CONFIG_AUDIO_CONVERT_MP3` (off by default) — see that Kconfig option's
  help text for the real cost (not flash — the RAM/stack minimp3 needs).
- Audio runs at **48 kHz stereo** so the codec sees a clean 12.288 MHz MCLK
  (256fs). VoIP will resample to 8 kHz G.711 in the `voip` component.
- The SLIC's `PD` pin is driven through a diode: GPIO low = power-down,
  released (input) = run (`set_pd_run()` in `ag1170.c`).

## Releasing a firmware update

The web UI's "Check for updates" reads `latest.json` from the repo's `firmware`
branch. To cut a release: tag the commit (`git tag -a v1.2.3 -m v1.2.3`), run
`firmware/release/release.py --version v1.2.3 --notes "..."` from an ESP-IDF
shell (builds every board type in `build.release/`, writes
`release/out/v1.2.3/`), then `--publish --no-build` to force-push the branch.
Details in the script's header. The manifest is readable from a browser only
once the repository is public.
