sdylewski/Analog-Redial/docs/flashing.md

[Home](../README.md) · [1 · Get a board](board.md) · [2 · Parts & assembly](bom.md) · **3 · Flash & test** · [4 · Set up & use](setup.md)

# 3 · Flash & test

Put the firmware on an assembled board and check every part of the hardware
works. No ESP32 experience needed. Most of the time goes into installing the
toolchain, which you only do once.

## 1. What you need

- An assembled board ([step 2](building.md))
- A USB-C cable that carries data, not just power
- A computer running macOS, Linux or Windows
- An analog phone to test with

## 2. Install the toolchain (once)

The firmware is built with **ESP-IDF v5.2.8**, Espressif's official SDK. It
brings its own compiler and Python environment. Install it once, following
the section for your computer. Afterwards you start each session by opening
an "ESP-IDF terminal", which has `idf.py` ready to use.

<details>
<summary><b>macOS</b></summary>

Install Apple's command-line tools and, with [Homebrew](https://brew.sh), the build helpers:

```bash
xcode-select --install
brew install cmake ninja dfu-util python3
```

Then ESP-IDF itself:

```bash
mkdir -p ~/esp && cd ~/esp
git clone -b v5.2.8 --recursive https://github.com/espressif/esp-idf.git
cd esp-idf
./install.sh esp32c6
```

**In every new terminal** you use for this project, activate it:

```bash
. ~/esp/esp-idf/export.sh
```

On Apple Silicon, if a tool fails with `bad CPU type in executable`, install
Rosetta once: `softwareupdate --install-rosetta --agree-to-license`.

</details>

<details>
<summary><b>Linux</b></summary>

Install the build helpers with your distribution's package manager:

```bash
# Ubuntu, Debian, Raspberry Pi OS
sudo apt-get install git wget flex bison gperf python3 python3-pip python3-venv \
  cmake ninja-build ccache libffi-dev libssl-dev dfu-util libusb-1.0-0
# Fedora
sudo dnf install git wget flex bison gperf python3 cmake ninja-build ccache dfu-util libusbx
# Arch
sudo pacman -S --needed gcc git make flex bison gperf python cmake ninja ccache dfu-util libusb
```

Let your user open serial ports (the group is `uucp` on Arch), then log out
and back in:

```bash
sudo usermod -a -G dialout $USER
```

Then ESP-IDF itself:

```bash
mkdir -p ~/esp && cd ~/esp
git clone -b v5.2.8 --recursive https://github.com/espressif/esp-idf.git
cd esp-idf
./install.sh esp32c6
```

**In every new terminal** you use for this project, activate it:

```bash
. ~/esp/esp-idf/export.sh
```

</details>

<details>
<summary><b>Windows</b></summary>

1. Download the **ESP-IDF Tools Installer** from
   [Espressif's download page](https://dl.espressif.com/dl/esp-idf/) and
   pick ESP-IDF **v5.2.8** when it asks for a version. It also installs Git
   and Python.
2. Install to a short path with no spaces (the default `C:\Espressif` is
   fine); a long or spaced path breaks the build.
3. Start each session from the **ESP-IDF 5.2 PowerShell** (or CMD) shortcut
   it adds to the Start menu. That's the terminal the rest of this page
   means.

Windows 10 and 11 recognize the board's USB port with no driver: it shows up
as a `COM` port in Device Manager under *Ports (COM & LPT)*.

Already have ESP-IDF set up by hand? `git clone -b v5.2.8 --recursive
https://github.com/espressif/esp-idf.git C:\esp\esp-idf`, then
`C:\esp\esp-idf\install.bat esp32c6` once, and `C:\esp\esp-idf\export.ps1`
(PowerShell) or `export.bat` (CMD) in every new terminal.

</details>

To check it worked, `idf.py --version` should print `ESP-IDF v5.2.8`. More
detail on every step:
[Espressif's getting-started guide](https://docs.espressif.com/projects/esp-idf/en/v5.2/esp32c6/get-started/)
and the [firmware developer notes](https://github.com/sdylewski/Analog-Redial/blob/main/firmware/README.md).

## 3. Get the code

In the ESP-IDF terminal:

```bash
git clone https://github.com/sdylewski/Analog-Redial.git analog-redial
cd analog-redial/firmware
```

On Windows, clone to a short path with no spaces, such as `C:\redial`
(`cd C:\` first, then `git clone https://github.com/sdylewski/Analog-Redial.git redial`
and `cd redial\firmware`): the build makes deep folder paths, and a long
starting path can push them past Windows' path-length limit.

## 4. Flash it

Plug the board into your computer through the DevKit's USB-C port marked
**USB** (the right-hand one). The DevKitC-1 has two; the other, marked
**UART**, isn't connected to the console on this board.

Then run `flash_board.py` from the ESP-IDF terminal. That terminal's Python
already has the serial and flashing libraries the script needs.

<details open>
<summary><b>macOS</b></summary>

```bash
cd bringup
./flash_board.py --board smd5 --yes
```

The board appears as `/dev/cu.usbmodem…` (`ls /dev/cu.usbmodem*` lists it).
The scripts find it on their own; if they ever need `--port`, use the `cu.`
name, not the `tty.` one.

The first time a script talks to the board over Wi-Fi, macOS may ask whether
your terminal app may find devices on your local network. Allow it, or the
spoken-prompt upload fails with "No route to host".

</details>

<details>
<summary><b>Linux</b></summary>

```bash
cd bringup
./flash_board.py --board smd5 --yes
```

The board appears as `/dev/ttyACM0` (`ls /dev/ttyACM*` lists it).

- **"Permission denied" on the port:** your user isn't in the `dialout`
  group yet (`uucp` on Arch). Run the `usermod` line from step 2, then log
  out and back in.
- **Flashing fails just after plugging in (Ubuntu, Debian, Fedora):**
  ModemManager probes new USB serial ports for a few seconds. Wait 10
  seconds and try again; if it keeps happening, `sudo systemctl stop
  ModemManager` (or remove it if you don't use a USB modem).

</details>

<details>
<summary><b>Windows</b></summary>

In the **ESP-IDF 5.2 PowerShell** (or CMD), run the scripts through `python`:

```powershell
cd bringup
python flash_board.py --board smd5 --yes
```

The board appears as a `COM` port (`COM3`, `COM5`, …) in Device Manager
under *Ports (COM & LPT)*, as "USB Serial Device". The scripts find it on
their own; pass `--port COM5` if several are plugged in.

</details>

`--board smd5` is for a v5 or v5.1 board, including a 30-pin clone whose two solder jumpers were moved (see [the v5 reference](hardware-smd5.md#10-mcu-module-variants)); a clone with the jumpers left at the default needs `--board smd5_cheap`, which has no USB console. A v4 board uses `--board smd4`. The script reads the chip's flash size,
builds the matching image and flashes it. Later flashes don't need
`--board`: the script asks the running firmware what it is.

<details>
<summary>Prefer to drive <code>idf.py</code> yourself?</summary>

Each board type builds in its own directory with its own settings. From
`firmware/`, for a v5 board, create its directory once, then build and flash into it:

```bash
idf.py -B build.smd5 -D SDKCONFIG="build.smd5/sdkconfig" \
  -D SDKCONFIG_DEFAULTS="sdkconfig.defaults;sdkconfig.smd5.defaults" set-target esp32c6
idf.py -B build.smd5 -D SDKCONFIG="build.smd5/sdkconfig" -p <PORT> flash monitor
```

Always pass the same `-B` and `-D SDKCONFIG=` pair, or the build can fall back to
the v4 settings in the default `build/` directory (which a v4 board uses: plain
`idf.py build` and `idf.py -p <PORT> flash monitor`).

On Windows, type each command on one line: the `\` at a line end continues
it on macOS and Linux only.

`<PORT>` is the board's serial device: `/dev/cu.usbmodem…` on macOS,
`/dev/ttyACM…` on Linux, `COM…` on Windows. Leave `-p` off to let idf.py
find it. Quit the monitor with **Ctrl-]**.

On a module with **8 MB** of flash, use a separate directory with the 8 MB
settings added (`smd4` here; use `smd5` for a v5 board):

```bash
idf.py -B build.smd4_8mb -D SDKCONFIG="build.smd4_8mb/sdkconfig" \
  -D SDKCONFIG_DEFAULTS="sdkconfig.defaults;sdkconfig.smd4.defaults;sdkconfig.8mb.defaults" \
  set-target esp32c6
idf.py -B build.smd4_8mb -D SDKCONFIG="build.smd4_8mb/sdkconfig" -p <PORT> flash
```

The number of phone lines and microSD aren't build options: set them after
flashing in Settings → General → Board hardware (or with
`first_setup.py --lines`).

</details>

## 5. Watch it boot

Open the serial monitor from `firmware/`, with the port from step 4:

| | Command |
|---|---|
| macOS | `idf.py -p /dev/cu.usbmodem101 monitor` |
| Linux | `idf.py -p /dev/ttyACM0 monitor` |
| Windows | `idf.py -p COM5 monitor` |

Quit it with **Ctrl-]**. You'll see each part come up (codec, phone lines, audio,
telephony) ending with:

```
All subsystems up. Lift a handset to get dial tone.
```

Lift the handset: you should hear dial tone.

> **Opening the serial port resets the board.** That's how the ESP32-C6's
> USB works, not a fault, so connecting a monitor mid-call ends the call.

## 6. Test the hardware
Note: a lot of these functions are available in the web UI, but the console gives you more control and debugging capability.

The same USB connection gives you a console that works with or without
Wi-Fi. Type `help` for the full list. A good first run on a new board:

1. `selftest`: a guided check of the board's hardware
2. `hookmon 20`: lift and replace the handset a few times and watch it register
3. `dialtone 0`: dial tone on line 0
4. `ring 0 3`: rings the bell for 3 seconds

| Command | What it does |
|---|---|
| `selftest` | Guided hardware check; start here |
| `board_info` | Board type and pin map the firmware is using |
| `codec_detect` | Checks the audio codec answers |
| `status` | State of each phone line |
| `hookmon [secs]` | Shows hook-switch changes as you lift and replace the handset |
| `pulsemon [secs]` | Shows rotary dial pulses with timing |
| `tonemon [secs]` | Shows touch-tone digits |
| `dialtone [line]` / `silence [line]` | Dial tone on or off |
| `ring [line] [secs]` | Ring the bell |
| `capture [ms]` | Live input level meter for both lines |
| `miclevel [secs]` | Handset microphone level; talk into it |
| `spkamp` / `micamp` | Earpiece volume and microphone gain, live |
| `sd_test` | microSD card info plus a write/read check |
| `wifi_status` / `wifi_set <ssid> <pass>` | Check or set Wi-Fi without the web interface. For a network name with an apostrophe, accent or emoji (an iPhone hotspot's "Name’s iPhone"), run `wifi_scan` and use `wifi_set #3 <pass>`; `wifi_set -u` takes `%XX` escapes for any bytes |
| `reboot` | Restart, keeping the monitor attached |

## 7. Preparing boards for someone else

To set up a batch of boards that each come up fresh for whoever gets them:

1. Flash each board and set it up on your own Wi-Fi.
2. Run its checks: `./first_setup.py --host <board> --tests`, or the
   bring-up check under Settings → Diagnostics.
3. Finish with `./first_setup.py --host <board> --reset-wifi`. This forgets
   your Wi-Fi and the board name, keeps everything else, and reboots into
   setup mode.
4. Unplug it once its setup network appears.

On Windows, run these as `python first_setup.py …`. `first_setup.py` uses
`curl`, which macOS, Linux and Windows 10/11 all include, and makes its
spoken prompts on your computer with no other tools to install (the first
run downloads a speech model of about 350 MB).

The recipient powers it up and follows [step 4](setup.md). Full script
reference: [`firmware/bringup/README.md`](https://github.com/sdylewski/Analog-Redial/blob/main/firmware/bringup/README.md).

---

**Next: [4 · Set up & use](setup.md)**
