sdylewski/Analog-Redial/BM64/eeprom_write/eeprom_write.md

# BM64 EEPROM Write — Procedure & Standalone ESP32 Writer Plan

## CONFIRMED 2026-09-25: Full EEPROM read/write protocol (HCI ACL Data)

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

### Required init sequence (must run once after entering IBDK mode)

```
1. 01 31 FC 0C 00 02 00 00 00 00 00 00 00 02 00 00   (vendor init 0xFC31)
2. 01 05 10 00                                         (Read_Buffer_Size)
3. 01 33 0C 07 01 00 02 03 00 04 00                    (Host_Buffer_Size)
4. 01 05 04 0D 00 00 00 00 00 00 00 00 00 00 00 00 00 (Create_Connection → handle 0xFFF)
5. 02 FF 0F 07 00 00 01 03 00 05 02 00                 (ACL setup: memory type)
6. 02 FF 0F 04 00 20 00 00 00                           (ACL setup: buffer config)
```

### EEPROM READ command (ACL Data to handle 0xFFF)

```
02 FF 0F 0E 00  10 01  0A 00 05 02  [ADDR LE32]  [LEN LE32]
│  └─handle──┘  │  │   └─EEPROM──┘
│    ACL hdr    │  │    read type
│   len=14      │  └─status
└─ACL indicator └─sub-cmd: read
```

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

### EEPROM WRITE command

```
02 FF 0F 0F 00  11 01  0B 00 05 02  [ADDR LE32]  [LEN LE32]  [DATA...]
                │  │   └─EEPROM──┘
                │  │    write type
                │  └─status
                └─sub-cmd: write
```

### Firmware commands

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

### Earlier DMS analysis (still valid, just reinterpreted)

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

---

## TOMORROW: quick reference (do this first)

**The one byte that fixes audio:** address `0x348` currently holds `0x09`
("capless with earphone") but needs to be `0x0A` ("single-end with
earphone") to agree with `0x1D7` (already correctly `0x94` = Single End) --
see "Found 2026-09-24 (evening)" section below for the full reasoning. This
is a real inconsistency in Microchip's own `BM64CLS1` reference table, not
something done wrong during the original flash.

1. isUpdate Tool -> memory type = **eeprom** -> connect
2. **Write** single byte: Address `0348`, Length `01`, Value `0A`
3. **Verify**: Read Address `0348`, Length `01` -> should now read `0A`
4. Also re-verify `0x1D7` still reads `94` (bit4=1, Single End) -- should be
   unchanged, just confirming nothing else drifted
5. Return to normal mode, re-pair, re-test audio (record + inspect for real
   varying content, not a flat/repeating tone -- see the analysis approach
   in "Verify audio output" below)

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

---

## What Was Done (2026-09-24)

### Problem
BM64 shipped with speaker output config (`IS2064S_012_SPK02_V2.1_BETA`).
Need headphone DAC output on A0HPL/A0HPR + mic input on MIC_P1.

### Solution
Flashed EEPROM with `MCHP_DSPKv2.1.7_BM64CLS1.txt` (headphone DAC config)
using `isUpdate Tool v3.14` via an ESP32-C6 Arduino bridge sketch.

### Verified EEPROM bytes (headphone DAC)
| Address | Value | Meaning |
|---|---|---|
| 0x0094  | 0x73  | Codec function — headphone DAC output |
| 0x0171  | 0x46  | Audio path config |
| 0x01FC  | 0x4A  | Audio routing |

---

## Found 2026-09-24 (evening): Capless vs Single-End conflict -- needs a fix

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

### The fix (do this first, before anything else, next isUpdate session)

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

---

## Step-by-Step Flash Procedure

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

---

## Key Gotchas Discovered

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

---

## DMS Log Reverse-Engineering Findings (2026-09-24, continued)

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

### DMS log binary format (reverse-engineered)
The `.dmslog8` file wraps every USB `WriteFile`/`ReadFile` call in a
Windows-driver-style record:
```
[00 00 00 00][LEN: uint32 LE][... LEN bytes of raw serial data ...]
```
Records are interspersed with unrelated IOCTL/status-polling noise (a fixed
repeating pattern: `00 02 FF 0F 8E 00 11 01 8A 00 05 02 ...` — this is NOT
serial traffic, just internal DeviceIoControl chatter) and FILETIME-stamped
records (8-byte Windows FILETIME, recognizable by trailing `79 4C DD 01` /
`6A 79 4C DD 01` etc. — the DD 01 high bytes are consistent because the
capture was all done within the same few minutes).

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

```
file offset 0x02313B and 0x0231FF (128 bytes each)
04 00 00 00 00 00 01 04 04 24 00 0A 16 00 B8 06 00 00 31 11 10 18 09 2A 09 00
03 0A 00 9B 00 AE 31 03 05 BF FE FF FE 98 3D 19 86 01 0C 72 10 00 00 00 10 3C
00 00 0A CE 01 A4 03 00 00 52 5A CE E2 00 00 00 00 10 11 30 30 30 30 00 ... (zero-padded to 128 bytes)
```
— **121/121 bytes match EEPROM addresses 0x0006–0x007B exactly (100%)**.

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

---

## Standalone ESP32 EEPROM Writer (TODO)

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

### Update 2026-09-25 (macOS session, continued): live probing + deeper log analysis

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

### Architecture
```
ESP32-C6 firmware:
  setup():
    if (button pressed OR first boot):
      enter_ibdk_mode()
      hci_reset()
      write_eeprom_table(bm64_cls1_eeprom, sizeof(bm64_cls1_eeprom))
      verify_eeprom()
      reset_to_normal()
    else:
      normal_bluetooth_audio_operation()
```
