sdylewski/Analog-Redial/archive/hardware/bk3266.md

# BK3266 Bluetooth module — bring-up journal

> **Driver removed (2026-10-22).** The firmware driver, console commands and
> test scripts mentioned below were deleted when the BK3266 option was replaced
> by the BT401 (`bt401.md`). The last tag that still has them is `v1.0.1`.

> **Status (2026-10-09): firmware written, nothing tested on a real module.**
> The BK3266 daughter board was sent to fab with the SMD5 main board and
> hasn't been mated to anything yet. Everything below marked **UNVERIFIED**
> comes from the vendor's documents. When a real module is on the bench,
> work through [the bring-up sequence](#bring-up-sequence) and write what
> actually happened into [the log](#log) and the unverified list.

A cheap (~$2–3) alternative to the BM64 (~$8–12) for the same job: pair a
phone, and make the rotary phone its handset. Same 8-pin header (`J2` on
SMD5), same analog audio path, different UART protocol — and **it can't
dial out**.

Related files:

| | |
|--|--|
| [`Bluetooth/BK3266_do_not_use/BK3266_RESEARCH.md`](../../Bluetooth/BK3266_do_not_use/BK3266_RESEARCH.md) | Pre-order research: chip, protocol tables, pin descriptions, wiring plan |
| `Bluetooth/BK3266_do_not_use/reference_docs/` | Vendor manuals, protocol spreadsheets, reference schematics |
| `Bluetooth/BK3266_board_v1/` | The daughter board's KiCad project |
| [`smd5.md`](smd5.md) | The main board it plugs into |
| `firmware/components/bt_companion/bk3266*.{c,h}` | The driver |
| `firmware/test/host/` | Protocol tests that run on the Mac (`run.sh`) |
| `firmware/bringup/test_bk3266.py` | The guided bench test |

## What the daughter board is

`Bluetooth/BK3266_board_v1/` — BK3266SR module (40-pin, `U1`), an 8-pin
female socket `J1` that mates with the main board's `J2`, a 6-pin
diagnostic header `J2` (unpopulated), and a few resistors and an LED.

| Ref | What | Notes |
|--|--|--|
| U1 | BK3266SR module | VBAT pin 37, UART pins 10/11, WAKEUP pin 7 |
| J1 | 1×8 female socket | The connection to the main board, see below |
| J2 | 1×6 male header | Probe/tweezer access: S/R, STAT, GND, MODE, COM, PP/CALL |
| R1 | 1 kΩ | LED current (module pin 14 → D2 → R1 → GND) |
| R2 | 1 kΩ | Series on STAT (pin 19) → J2.2 |
| R3 | 1 kΩ | Series on S/R → J2.1. On pin 22 (the duplicate S/R pad); pin 13 is unconnected |
| R4 | 10 kΩ | +3.3 V → J2.5 "COM" (current-limited button supply) |
| D2 | 5 mm LED | Module pin 14 (GPIO8) status LED |

Left unconnected on purpose: both `AUDIOLN`/`AUDIORN` and the right channel
(`AUDIORP`), `AUX_L/R`, `VBUS`, `V2MICBIAS`, the SD pins, `Mute`, `Next/Vol+`,
`Prev/Vol-`, and the two 3 V outputs. `AGND` (pin 40) is tied to GND with the
other grounds.

### J2 diagnostic header

| Pin | Net | Module pin | Use |
|--|--|--|--|
| 1 | S/R | 22 (via 1 kΩ) | Output: high = transmit mode, low = receive. Should read **low**. |
| 2 | STAT | 19 (via 1 kΩ) | Output: high = linked to a phone |
| 3 | GND | | Scope/meter reference |
| 4 | MODE | 12 | Button input, active **high**: bridge 4–5 to press |
| 5 | COM | | +3.3 V through 10 kΩ |
| 6 | PP/CALL | 6 | Button input, active **high**: bridge 5–6 to press |

No shunts, ever: a shunt to GND does nothing and one to 3.3 V holds the
button down, and a 6 s hold powers the module off or re-pairs it.

## How it connects to the SMD5 main board

Both boards' netlists were checked against each other (2026-10-09). The
daughter board uses the same J1 order as the BM64 carrier, so either
plugs into the same header.

| Header pin | Main board `J2` | Daughter board `J1` → BK3266 module |
|--|--|--|
| 1 | `+3.3V_BM` from **U5** (XC6206 LDO) | → `VBAT` (pin 37) |
| 2 | GPIO17 / U0RXD (ESP receives) | ← `TX` (pin 10) |
| 3 | GPIO16 / U0TXD (ESP transmits) | → `RX` (pin 11) |
| 4 | `MFB` net, GPIO15, **R17** 100 kΩ to GND | → `WAKEUP` (pin 7) |
| 5 | **C22** 1 µF ← `Line0Vout` (SLIC) | → `MICP` (pin 30) |
| 6 | **C24** 1 µF to GND | → `MICN` (pin 29) |
| 7 | **C23** 1 µF → **R16** 1 kΩ → `Line0Vin` (SLIC) | ← `AUDIOLP` (pin 33) |
| 8 | GND | → GND, `AGND` |

- **Audio is analog.** The ESP32 never sees it; it only runs the UART and
  (optionally) WAKEUP. Line 0 is the Bluetooth line.
- **Single-ended use of a differential pair.** Only the positive leg of the
  speaker output (`AUDIOLP`) reaches the header; `AUDIOLN` floats. The mic
  input is `MICP` with `MICN` AC-grounded by C24 on the main board.
- **Header orientation matters:** pin 1 is +3.3 V and pin 8 GND, so a board
  mated 180° shorts the LDO.

### Pins the firmware uses

| Signal | Pin | Direction | Handling |
|--|--|--|--|
| UART TX/RX | GPIO16 / GPIO17 | | UART1, **9600 8N1** (the BM64 uses 115200 on the same pins) |
| WAKEUP | GPIO15 | out, rarely | Left as a plain input in normal use; only `bk_wake` drives it |

The module powers itself on at boot, so no wake handshake is needed. The
BM64's MFB sequence is *not* used.

## What the firmware does

Settings → Hardware → **Bluetooth companion module**: *Not fitted* /
*BM64 module fitted* / *BK3266 module fitted (no dial-out)*. Takes effect on
reboot (the two backends use the same UART at different speeds). Settings →
Bluetooth then turns the feature on, as before. `/api/status` carries
`bt_module` (`none`/`bm64`/`bk3266`).

| Feature | BM64 | BK3266 |
|--|--|--|
| Pair a phone from the web UI | yes | yes (`BT_CMD_MATCH`) |
| Incoming call rings the bell, lift handset answers | yes | yes (`BT_CMD_ACK`) |
| Hang up ends the call | yes | yes (`BT_CMD_NACK`) |
| Caller ID in the activity log | yes | yes (frame `0x03`) |
| Move a call placed on the phone to the handset | yes | yes (passthrough on a live call) |
| Dial out (1 + area code + number) | yes | **no** — no command for it; the dialplan stops offering it |
| EEPROM audio configuration check | yes (needed) | n/a |

The driver (`bk3266.c`) runs a task that parses frames and keeps a state
(`bk_state_t`); every 1.5 s it asks `BT_CMD_MY` for the call status, because
the protocol table has no "call ended" message. At start it queries version,
address and name, then sends `BT_CMD_RECMODE` once.

The protocol/state code (`bk3266_proto.c`) has no ESP-IDF dependency and is
tested on the Mac against the vendor's own example frames:
`firmware/test/host/run.sh` → `36 checks, 0 failed`. That proves the framing,
checksum and state mapping do what this note says — not that the module
behaves the way the documents say.

### The protocol in one screen

```
52 42 23  LEN  CMD  DATA...  CRC  23 42 52        9600 8N1
LEN = 3 + len(DATA)        CRC = (LEN + CMD + DATA...) & 0xFF
```

- **To the module:** `CMD = 0x01`, `DATA[0]` = command code.
  `52 42 23 04 01 01 06 23 42 52` = pair.
  Codes: `01` pair, `02` reconnect, `03` disconnect, `04` answer, `05`
  reject, `06` hang up, `07` redial last, `08/09` volume ±, `0A` clear
  pairings, `11` address?, `12` name?, `13` phone name?, `14` version?, `15`
  ACL?, `16` call status?, `1A` volume?, `1D` factory reset, `25` receive
  mode, `29` set name.
- **From the module:** `CMD = 0x00`, `DATA[0]` = status:
  `64` booted, `65` linked, `66/67` ACL no/yes, `68` not connected, `69` HFP
  connected (no call), `70/71/74` calling out, `72` in a call, `73`
  incoming call, `7A` disconnected. Other `CMD`s carry data: `03` caller's
  number, `02` outgoing number, `04` volume, `07` own address, `08` own name,
  `09` phone name, `0A` version.

### Console commands

All on the device's serial console (`idf.py monitor`, or the host scripts).

| Command | Does |
|--|--|
| `bk_selftest` | Parser + state mapping on built-in frames; needs no module |
| `bk_probe` | Is anything answering? Listens 2 s, sends a version query two ways, says what it saw |
| `bk_listen [ms]` | Prints raw bytes and decoded frames |
| `bk_cmd <hex> [ms]` | One command code in a proper frame (works with the driver running too) |
| `bk_frame <cmd> [data] [ms]` | Any CMD + DATA with LEN/CRC computed — for trying the other reading of the protocol |
| `bk_send <hex> [ms]` | Raw bytes, no framing |
| `bk_at <text> [ms]` | A text line + CRLF, for the text-AT firmware variant |
| `bk_state` | Decoded connection/call/name state and parser counters |
| `bk_wake [ms]` | Pulse WAKEUP (GPIO15); a short pulse is a button press |

Everything except `bk_state`/`bk_cmd` needs `bt_enable 0` first (they own
the UART). `bm64_*` commands speak the BM64 protocol and are meaningless on
this module.

## Supply voltage

`+3.3V_BM` (U5, XC6206P332MR) feeds only J2 pin 1, so it can be any voltage
both modules accept without touching anything else. VBAT/BAT_IN ranges:
BK3266SR 3.3–4.2 V (manual; the bare chip says 2.8–4.2 V), BM64 3.2–4.2 V.
A 3.3 V ±2% part sits at the bottom of both. **3.6 V** is the comfortable
choice: the middle of both ranges, and still 0.6 V under the top. The XC6206
family uses the same SOT-23 pinout for every voltage (pin 2 out, pin 3 in),
so it's a drop-in value swap with no layout change; from 5 V in, dropout and
heat are no issue at these currents (≈ 10–20 mA, RF peaks higher; the part is
good for 100–200 mA).

Candidates (checked by web search 2026-10-09, **stock and "basic/extended"
status not confirmed**):

| Part | LCSC/JLCPCB | Voltage |
|--|--|--|
| XC6206P362MR (UMW) | [C351446](https://jlcpcb.com/partdetail/327398-XC6206P362MR/C351446) | 3.6 V |
| XC6206P372MR-G (Torex) | [C6754163](https://www.lcsc.com/product-detail/C6754163.html) | 3.7 V |

Two things this probably doesn't change: the module's UART I/O level
appears to come from its own internal 3 V supply rather than VBAT (pins
38/39 are listed as "3 V output"; not confirmed), and the ESP32 drives it
at 3.3 V either way; and a higher VBAT does nothing for the BK3266's audio
level. Only change the value if bench measurement shows a
problem (open question 7), or just do it on the next spin: it costs nothing.

## Bring-up sequence

Run `firmware/bringup/test_bk3266.py` for the guided version; this is the
manual one, with what each result means.

**Before the module is involved**
1. Mac: `firmware/test/host/run.sh` → all checks pass.
2. Main board: finish the SMD5 bring-up first ([`smd5.md`](smd5.md)). The
   daughter board needs U5's 3.3 V on J2 pin 1 — check it with the module
   *removed* (3.30 V ±2%).
3. Daughter board off the main board: continuity from J1 pins to the module
   pins in the table above (1→37, 2→10, 3→11, 4→7, 5→30, 6→29, 7→33,
   8→GND); no short between 3.3 V and GND.

**With it plugged in** (pin 1 at the 3.3 V end of J2!)
4. Power on. Measure VBAT (J1 pin 1) under load; note the current.
5. Firmware: Settings → Hardware → BK3266 → Save → reboot.
6. `bt_enable 0`, then `bk_selftest` → PASS.
7. `bk_probe`:
   - *Frames decoded* → binary-protocol firmware, carry on.
   - *Nothing at all* → check power, swap TX/RX, scope module pin 10.
   - *Printable text* → text-AT firmware; the binary driver won't work as
     is (see [open question 1](#open-questions)).
8. `bk_listen 10000` while power-cycling: a `status 0x64 ON booted` frame.
9. `bt_enable 1`; wait 8 s; `bk_state` → version, own address and name
   filled in, "last frame … ms ago" small and refreshing.
10. Probe header J2.1 (S/R) with a meter: **low** = receive mode. If it's
    high the module is in transmit mode (see open question 4).
11. Pair: web UI Settings → Bluetooth → *Start pairing*, or `bk_cmd 01`.
    The phone should see the module; `bk_state` → `connected: yes` and the
    phone's name. J2.2 (STAT) goes high.
12. Incoming call from another phone: the bell rings, `bk_state` shows
    `incoming` + caller number; lift the handset → both ends hear each
    other.
13. Hang up from either end: `bk_state` returns to `idle`. **Record what
    the module sent** (`bk_listen` during the hang-up).
14. A call placed from the phone itself, audio moved to the handset.
15. Audio: levels both ways (too hot into Vin? too quiet from the mic?),
    hiss, and whether AGND tied vs floating changes it.

### If it turns out to be the text AT firmware

From the RGB-LED manual (`reference_docs/BK3266_module_manual_RGB-LED_ENGLISH.pdf`,
§1.8; 9600 8N1, lines end `\r\n`). Not implemented; the driver is binary only.

| To the module | Does | Module says |
|--|--|--|
| `BT+PR` / `BT+AC` / `BT+DC` | pair / reconnect / disconnect | |
| `BT+CA` / `BT+CJ` / `BT+CE` / `BT+CR` | answer / reject / hang up / redial last | |
| `BT+GAD` / `BT+GNM` / `BT+GPI` | address / name / PIN | `AD_xxxxxxxxxxxx` / `NA_name` / `PN_1234` |
| `COM+SNAME+xxxx`, `COM+Vxx`, `COM+CALLON` ... | name, volume, call function | `OK` / `ERR` |
| (unsolicited) | | `SY_PO` boot, `BT_CN` connected, `BT_IC` incoming call, `BT_OC` outgoing, `BT_EC` in a call |

No caller-ID message is listed, and (as in the binary protocol) no
dial-this-number command. A text-firmware module could still pair, ring and
answer; it would show no caller number. `bk_probe` does not yet send
`BT+GNM`; `bk_at BT+GNM` does it by hand.

## Open questions

Each is something the documents leave open; the fix named is what the
firmware already does about it, and what to look at on the bench.

| # | Question | Assumed | Settle it by |
|--|--|--|--|
| 1 | **Which firmware is on the module** — the binary "SR" protocol or the text AT one (`BT+CA`, `COM+…`)? Listings say "SR" but vendors flash either. | Binary | `bk_probe`. If text: needs a second driver, and the text firmware's unsolicited events are undocumented |
| 2 | **Does a command go out as CMD `0x01` + code in DATA**, or with the code as CMD? The spreadsheet's worked examples show the former; the research note read the latter. | CMD `0x01` | `bk_probe` tries both and shows which one gets a reply |
| 3 | **What announces a call ending?** The status table has none. | Poll `BT_CMD_MY` every 1.5 s; `0x69` = idle | Hang up during `bk_listen` and read the frames |
| 4 | **Does it boot in transmit mode?** The manual's wording is garbled. | `BT_CMD_RECMODE` once after the first reply | S/R pin (J2.1) before and after; does `0x25` survive a power cycle? |
| 5 | **Are `0x70`, `0x71` and `0x74` all "calling out"?** The sheets disagree on the labels. | All three = outgoing | Place a call from the phone and watch which arrives |
| 6 | **Own address format:** 6 raw bytes or ASCII? | Either (parser handles both) | `bk_state` after boot |
| 7 | **Is 3.3 V enough?** The module manual says VBAT 3.3–4.2 V; the chip datasheet 2.8–4.2 V. U5 gives 3.3 V ±2% (3.23–3.37 V), so it sits at the module's stated minimum. | Fine, probably | Watch `bk_state` for resets, and scope VBAT during a Bluetooth TX burst. If marginal, swap U5 for a 3.6 V part (see [Supply voltage](#supply-voltage)) |
| 8 | **WAKEUP semantics:** the schematic says a short press = disconnect/reconnect; the manual says power on. | Never touch it | `bk_wake 300` with a phone connected |
| 9 | **Output level and DC bias** of `AUDIOLP` into `Line0Vin` (through 1 µF + 1 kΩ). The DAC is rated 1.1 Vrms differential; one leg is about half. | Fine | Scope J1.7 on a call with loud speech |
| 10 | **Does the module need a "single-ended output" setting?** The text firmware has `COM+DACSINGLE`; the binary protocol has no such command. | No | Listen for distortion/low level; compare with `AUDIOLN` jumpered |
| 11 | **Dial-out.** See [Dial-out](#dial-out-what-the-vendor-files-say-2026-10-14). Neither command set has a "dial this number" command; the only call the module starts is `BT_CMD_REDIAL` (`0x07`, last number). Codes `0x26`–`0x28` are undocumented gaps in the table. (An earlier version of this note and the research file read `0x13`–`0x1C` as "DTMF digit 0–9"; in the serial protocol those are queries and test tones. Corrected 2026-10-09.) | None | `firmware/bringup/test_bk3266_dialout.py --number <your other phone> --explore`: tests REDIAL, then the undocumented gaps and a few text-AT guesses, and reports whether the phone started a call |
| 12 | **Name:** `BT_CMD_BT_NAME` (`0x29`) takes the name as DATA. The driver doesn't send it yet, so the module advertises its own default name. | Default name | `bk_frame 01 "29 …name bytes…"` and see what the phone shows |

## Dial-out: what the vendor files say (2026-10-14)

Went back through everything for a way to dial a number from the analog phone.

- **The serial protocol's frame types are one enum in both directions**
  (`BK3266SR_serial_protocol_V1.0.0_ENGLISH.xls`): `0x00` status, `0x01`
  command, `0x02` "data is outgoing number", `0x03` caller number, `0x04`
  volume, `0x05` transmit-mode command, `0x06` found device, `0x07` address,
  `0x08` name, `0x09` phone name, `0x0A` version, `0x0B` "MCU sends an address
  to connect to". The vendor's saved terminal presets (`sscom51.ini` inside
  `BK3266_AT_command_reference.rar`) really do send `0x05` and `0x0B` frames
  with data, so an MCU-sent `0x02` frame carrying digits is the one place a
  dial command would fit. `test_bk3266_dialout.py --explore` already tries it.
- **Command `0x0C` is "reserved"** (`BT_CMD_STOP`). `0x0D`-`0x10` are track
  controls, `0x1E` test mode, `0x1F` idle mode, `0x23` query the connected
  address, `0x27` power off, `0x28` transmit-mode Bluetooth on/off. `0x26` is
  the only other gap.
- **"VOICE NUM 0-9" is not DTMF.** In the ToolKit those names sit in the
  voice-prompt event table (next to LOW BATTERY, INCOMING RINGING, POWER ON):
  they are the "zero".."nine" clips the module plays to read out a caller's
  number.
- **The firmware has an HF VOICE DIAL action** (Siri / Google Assistant,
  HFP `AT+BVRA`), but only as a *button* action the ToolKit can assign to a
  press pattern (`cfg.button_code`). It is not in the serial command table,
  unless `0x0C` turns out to be it.
- **No public SDK.** Beken supplies the BK3266 SDK to customers; nothing
  usable turned up publicly, so adding a dial command to the module's own
  firmware isn't a practical option.

Ways to dial out, best first:

1. **Siri.** Get HF VOICE DIAL triggered (`0x0C` if it is that; otherwise a
   ToolKit change mapping a WAKEUP double-press to it, which the ESP32 can
   pulse on GPIO15 with no hardware change), then the caller says "call Mom"
   or the digits into the handset. Needs the ToolKit to write the module's
   config, which hasn't been tried.
2. **Siri with spoken digits from the ESP32.** The board would speak the
   dialled digits into Siri. The module's mic input comes straight from the
   SLIC's Vout, so the ESP32 can only reach it through the SLIC hybrid's echo
   of Vin; whether that is loud enough is untested.
3. **Use the BM64**, which has a real dial command (`MAKE_CALL`).

## Learned / log

Newest first. Put real bench results here.

- **2026-10-09** — Protocol code and driver written from the spreadsheets
  and manuals; host tests against the spreadsheet's example frames pass.
  Compared both boards' netlists: header pin order matches the BM64
  carrier (so the SMD5 main board needs nothing different between the two
  modules, and the module choice is firmware-only). The daughter board
  puts MICN on the header (the main board's C24 grounds it) and uses the
  duplicate S/R pad (22) for the diagnostic header.

### 2026-10-19: first look at a real module (clone MCU board, jumpers probably default)

No frames at all. With the driver off: `bk_probe` (binary version query two
ways) 0 bytes; `bk_listen` 0 bytes, including after `bk_wake` pulses of 0.3,
1.5, 3 and 4.5 s; `bk_baudscan` (binary + `BT+GNM` + `AT`, 10 baud rates from
1200 to 460800) nothing. `gpiotest 17`: reads high with both the pull-down and
the pull-up enabled, so GPIO17 (module TX) is driven high from outside, i.e. the
line is idle-high, probably a powered module; GPIO16 (our TX) floats as expected.
`bk_selftest` passes (the parser is fine). Not yet separated: module
unpowered/held off, vendor firmware with no UART protocol enabled, or
GPIO16/17 not reaching J2 on this clone module's pads. Next: look at the
daughter board's LED (module GPIO8) and measure `+3.3V_BM` and module pin 10.

### 2026-10-20: second session (daughter board plugged back in, LED added)

3.3 V measured at the daughter board's VBAT (J1 pin 1). A white LED + 1 kΩ was
added on module pin 14 and does not light. Still no bytes at any baud, with
`bk_powercycle` (WAKEUP held 6.5 s, then a 0.3 s press, listening 10 s) and
`bk_wakeseq` patterns for an active-high press (`H1000,L300,H8000` is the
active-low version; `L7000,Z1000,H500,Z8000`; `H20000`). Next, in order of
cheapness: (1) meter on module pin 7 while `bk_wakeseq H20000` runs, which
proves GPIO15 reaches the module; (2) meter on the module's own supply pin 37 under
load, and try 3.6-3.8 V on VBAT (the XC6206 3.3 V sits at the bottom of the
module's range: swap U5 for the 3.6 V part, see Supply voltage above); (3) watch
the LED across a power-up; (4) listen on module TX (pin 10) with a scope or
logic analyser during power-up. Open question: is WAKEUP active-low (R17 would
then be holding the module "pressed")?

### 2026-10-20, later: the module on the genuine-MCU board

Moved the daughter board to the genuine DevKit board (the BM64 carrier went to the clone, where
it works, so the clone's J2 power/ground/UART and its RST_N/P2_0 leads on GPIO18/19 are fine).
The LED on module pin 14 **blinks**, so the module is powered and running (pairing /
discoverable pattern). The UART is still completely silent: no boot chatter, no reply to the
binary version query or to `BT+GNM` / `AT`, at 1200 to 460800 baud, with TX/RX as designed and
swapped (`bk_swap 1`). A silent but running module points at firmware with the UART protocol
disabled, i.e. a plain button/LED module, not the UART variant; the earlier "no LED on the
clone" may have been the LED wired backwards or a power problem on that board (not tested
again). JP2/JP3 only steer MCLK and card-detect and have nothing to do with J2. Next: pair a
phone with it (name?), check the module's label/part number against the vendor variants,
and ask the seller for the UART-protocol firmware if that's what it needs.

### 2026-10-20, evening: what WAKEUP really does; the listing; the QR label

- **WAKEUP is active-high and needs about 3 s to power the module on.** The module switches
  itself off again after a few minutes unpaired (the LED stops blinking, TX goes from
  idle-high to floating). 0.3-1.5 s pulses did nothing; `bk_wakeseq H3500,Z500` brought it
  back (TX idle-high again). So "silent on the clone" earlier proves nothing: it may simply
  have been off. The manual's "short press turns on" is wrong for this module, or "short"
  means a few seconds.
- **UART silent even when on**, at 1200-460800 baud, binary frames and text: `BT+GNM`, `AT`,
  `AT+`, `AT+GMR`, `AT+STATUS` (the KCX_BT_EMITTER "AT+" / "OK+" set from
  reference_docs/BK3266SR_module_photo.jpg, which is really that AT sheet, not a photo),
  with TX/RX as designed and swapped.
- `pinshort 16 17`, `16 15`, `17 15`: GPIO16 and GPIO17 are not joined to each other or to
  WAKEUP, and neither reads as stuck to GND; so no bridge between the TX and RX nets at the
  ESP end of the header.
- **Seller listing** (AliExpress): "AT Commands SPP", "replacement for BK8000L and
  BK6988", supply **3.6-6.5 V** (the BK3266SR manual says 3.3-4.2 V); our +3.3V_BM rail is
  below the listing's minimum. The QR sticker ("RRD-74470F / BH519 / 2024.01.24 / 156c") is a
  batch/traceability label and says nothing about the firmware variant.
- Not yet tried: 3.6-4.0 V on VBAT (U5 -> XC6206P362MR, or a bench supply on J1 pin 1),
  a logic analyser on module pad 10 during the power-on press, other UART pads.

### 2026-10-20, night: it is "BH519", paired with a phone, UART still silent

The module's Bluetooth name is **BH519** (same as the QR sticker); a phone paired with it fine, so audio side is alive.
WAKEUP both ways: held low does nothing, held high ~3.5 s powers it on (TX goes idle-high and
stays so for 4+ min). With a phone connected: `bk_probe`, `AT+`, `AT+GMR`, `AT+STATUS`,
`BT+GAD`, `BT+GPI`, `COM+CALLON`, `COM+V08`, `BT+GNM` (CRLF and LF) at 9600: 0 bytes. Still
unproven: pad mapping on this module (it may not be the BK3266SR pinout), or UART
disabled in its firmware. Candidate regulator for a 3.6 V VBAT: UMW XC6206P362MR (Digikey
17635261, SOT-23-3, same family and footprint as the 3.3 V U5).
