sdylewski/Analog-Redial/archive/hardware/smd5.md

# Analog Redial v5 (SMD5) — dev notes

> **Status: boards back (2026-10-19), first bring-up under way** — see [Bring-up log](#bring-up-log) at the end. Originally sent to fab untested. Ordered together with the BM64
> Bluetooth carrier (`Bluetooth/Bluetooth_board/`) and a BK3266 test board
> (`Bluetooth/BK3266_board_v1/`) for a first look at that module as a BM64
> alternative.

KiCad project: `hardware/kicad/Analog Redial v5/`. Working notes per
[`CLAUDE.md`](../../CLAUDE.md)'s public-vs-internal-docs split; the public
reference is [`docs/hardware-smd5.md`](../../docs/hardware-smd5.md).
Everything not listed here is the same as SMD4 — see
[`smd4.md`](smd4.md) and
[`docs/hardware-smd4.md`](../../docs/hardware-smd4.md).

## What's different from SMD4

- **Dual MCU footprint** (`U1`): takes a genuine Espressif
  ESP32-C6-DevKitC-1 or a cheaper AliExpress clone, selected with two solder
  jumpers (JP2, JP3).
- **Bluetooth header** `J2`, 8 pins, with its own 3.3 V LDO (U5) and MFB
  on GPIO15. Takes the BM64 carrier or the BK3266 daughter board
  ([`bk3266.md`](bk3266.md)); same pins, chosen in Settings → Hardware.
- **SHK divider 10 kΩ / 100 kΩ** (R15/R14 line 0, R13/R12 line 1).

## Dual MCU footprint

The schematic has one symbol (`PCM_Espressif:ESP32-C6-DevKitC-1`, real
module's pad numbering); the footprint is what's dual-compatible. The two
modules disagree at four pad positions:

| Footprint pad | Genuine module | Clone module |
|--|--|--|
| 12 | `GPIO2` | `GPIO12` / `USB_D-` |
| 13 | `GPIO3` | `GPIO13` / `USB_D+` |
| 19 | `GPIO12` / `USB_D-` | `GPIO2` |
| 20 | `GPIO13` / `USB_D+` | `GPIO3` |

The ESP32-C6's native USB is fixed to GPIO12/13 in silicon, so whichever
pads those land on carry live USB on that module. Other duplicate pad
entries in the `.kicad_mod` files (15, 18, 22–31) are positions where both
vendors agree.

### JP3 / JP2: MCLK and card-detect select

| Jumper | Net | Pad 1 (default, bridged) | Pad 3 (clone) |
|--|--|--|--|
| **JP3** | `I2S_MCLK` → codec `MCLK` (U2 pin 1) | footprint pad 12 | footprint pad 19 |
| **JP2** | `SD_CD` → Card1 pin 9 | footprint pad 13 | footprint pad 20 |

Set to match the module, both nets land on GPIO2/GPIO3 and the normal
`CONFIG_BOARD_TYPE_SMD5` build works on either module with native USB.
To switch: cut the 1–2 trace, bridge 2–3. Bridge one side only — both
sides together short GPIO2 to a USB data line.

**Wrong jumper: nothing errors.** What you'll see, and why:

- *Missing MCLK* (JP3 wrong): the ES8388's control port is independent of
  its clock, so I²C works and `codec_detect`, `es8388: init ok`, and the
  self-test's "Audio codec on I²C" and "Codec output configuration" rows all
  pass. With no clock its digital core is stopped: the handset hears **no dial
  tone, no ringback, no prompts, nothing**, and the mic path reads as dead
  (no DTMF detected). Everything that doesn't go through the codec still
  works — hook detection, ringing, Wi-Fi, web UI — which is what makes it
  look like a dead codec rather than a clocking fault. The self-test's
  "Line 0 dial tone" and "audio level" rows fail. Scope U2 pin 1.
- *Card-detect on the wrong pin* (JP2 wrong): the firmware reads a floating
  GPIO with its internal pull-up, always "empty", and logs `no card detected
  (CD pin) -- not attempting a mount`. Settings → Storage shows no card,
  recordings go to internal flash. A card that's seated on a genuine module
  with the clone-side jumper also pulls USB D+ low, so USB stops enumerating.

The MCLK behaviour is what the codec's design implies (it runs as an I²S
slave and needs MCLK); confirm it on the first SMD5 by deliberately
mis-jumpering one board.

| Module | Jumpers | Firmware | Result |
|--|--|--|--|
| Genuine | default | `SMD5` | works |
| Clone | clone side | `SMD5` | works |
| Clone | default | `SMD5_CHEAP` | works, but no USB console (see below) |
| Clone | default | `SMD5` | no audio, microSD "no card" |
| Clone | clone side | `SMD5_CHEAP` | no audio, no USB console |
| Genuine | clone side | `SMD5` | no audio; MCLK and card-detect sit on USB D−/D+, so a seated card stops USB enumerating |

Fastest check: scope U2 pin 1 for 12.288 MHz. Present at the ESP32 pad but
not at the codec means the jumper is on the wrong side.

**J3/J4** (spare 2-pin headers) are on footprint pads 20/19: live USB
D+/D− with the genuine module. Leave them unconnected on those boards.

**KiCad symbol note** (for future spins): use the stock
`Jumper:SolderJumper_3_Bridged12` symbol — its pins really are 1/2/3, with
letters A=1, C=2, B=3, so wire by pin number. SparkFun's
`SolderJumper_3_Bridged12_No_Silk` symbol numbers B and C both as pin 2.
Footprint: `Jumper_3_NC-1_Trace_NoSilk` (only pads 1–2 joined).

### `SMD5_CHEAP` build (clone module, jumpers at default)

Only for a clone board whose jumpers were left at the default, so MCLK and
card-detect are on the clone's GPIO12/13:

- `board_pins_smd4.h` maps MCLK → GPIO12, CD → GPIO13, and
  `board_early_pin_init()` detaches the USB PHY from those pads before
  audio starts. For ~1 s after reset the ROM owns them.
- No USB console: the port disappears ~1 s into every boot. Use the web
  UI, or UART0.
- Flashing over native USB still works (the ROM owns the pads at reset).
  The `download` console command restarts into the ROM; power-cycle when
  flashing is done. BOOT + RESET does the same in hardware.
- A seated microSD card holds USB D+ low (card-detect shorts to GND), so
  USB can't enumerate. Pull the card before flashing.
- `sdkconfig.smd5_cheap.defaults` puts the console on UART0 (GPIO16/17),
  the same pins as the BM64 UART on J2 — they can't share.
- Don't plug a cable into the clone module's own USB-C while the app runs:
  MCLK is on its D− pin.

UART0 flashing (GPIO16 TX, GPIO17 RX, EN, GPIO9 boot strap, with a 3.3 V
USB-serial adapter) works on any module and is the fallback if firmware
won't come up far enough for `download`.

## BM64 Bluetooth header (J2)

8 pins, mating with `J1` on the carrier. Both boards' netlists agree:

| J2 pin | Main board | Carrier J1 → BM64 |
|--|--|--|
| 1 | `+3.3V_BM` from **U5** | `BAT_IN` |
| 2 | GPIO17 / U0RXD (ESP receives) | `HCI_TXD` |
| 3 | GPIO16 / U0TXD (ESP transmits) | `HCI_RXD` |
| 4 | `MFB` → GPIO15, **R17** 100 kΩ to GND | `MFB` |
| 5 | **C22** 1 µF ← `Line0Vout` (SLIC U4 pin 10) | `MIC_P1` |
| 6 | **C24** 1 µF ← GND | `MIC_N1` |
| 7 | **C23** 1 µF → **R16** 1 kΩ → `Line0Vin` | `AOHPL` |
| 8 | GND | GND |

Audio is analog between the BM64 and line 0's SLIC; the ESP32 only drives
the UART and MFB (`bt_companion_line()` always returns line 0). Pin 1 is
3.3 V and pin 8 GND, so a board mated 180° round shorts the LDO. Parts for
this option: [`BOM-bluetooth.md`](BOM-bluetooth.md).

- **Supply:** U5 (XC6206P332MR, +5 V → 3.3 V, C26/C25 1 µF) gives the BM64
  its own rail, isolated from the module's regulator. BAT_IN spec is
  3.2–4.2 V; draw is ~0.6 mA standby, ~16 mA in a call, with short RF peaks
  well above that.
- **MFB** is the BM64's power button. Held high from power-up it triggers a
  master reset that wipes pairings, so R17 holds it low while the ESP32
  boots. Firmware drives it per the datasheet (Fig 5-3/5-4): high 400 ms
  to power on, then low, with a 1 ms wake pulse and ≥150 ms high around
  each UART command. GPIO15 is a strapping pin only for JTAG source select
  with an eFuse that ships unburned, so the pull-down is harmless; GPIO8
  (RGB LED) and GPIO9 (download strap) weren't usable.
- **RST_N** stays unconnected in normal use (internal power-on reset). It's
  only connected for EEPROM programming.
- **R16 (1 kΩ)** limits fault current into the SLIC's Vin from the BM64
  output. C23 at 1 µF puts the corner under ~30 Hz into Vin's ~60 kΩ.
- **Keep line 0's C12 (codec → Vin) at 10 nF.** During a Bluetooth call the
  codec's LOUT1 is a low-impedance output, so C12 shunts the BM64's signal:
  10 nF costs ~1.5 dB at 3 kHz through R16, 100 nF would cost ~9 dB. Line
  1's C15 has no BM64 branch and isn't affected.

### BM64 EEPROM programming (through J5)

The BM64's IBDK mode needs RST_N and P2_0 driven at reset — a one-time step
per module. The carrier brings the two signals out on `J2`, a **1×2**
footprint (pin 1 `P2_0`, pin 2 `RST_N`; the symbol draws four pins but only
two exist on the board). On the main board they come from `J5`, the 2×4
header whose odd pins are the ESP32 side and even pins line 1's SLIC:

| J5 pin | Net | GPIO | Carrier J2 |
|--|--|--|--|
| 3 | `SD_MOSI` / line 1 `RM` | GPIO20 | pin 1 `P2_0` |
| 5 | `SD_CLK` / line 1 `SHK` | GPIO19 | pin 2 `RST_N` |

(Checked 2026-10-09 against both netlists and the firmware's
`BOARD_BT_P20_PIN`/`BOARD_BT_RST_PIN`.) J5 pins 3 and 5 are adjacent in the
same column, so a 1×2 header spans them. With the carrier seated on `J2`
its programming pads do **not** land over J5 (they're ~20 mm off), so this
is done with the carrier connected by wires or a short 2-pin lead, not by
stacking.

1. Pull J5's four shunts (line 1's SLIC, if fitted, is then disconnected).
2. Connect carrier J2 pin 1 to J5 pin 3 and pin 2 to J5 pin 5.
3. Settings → Hardware: one line, BM64 fitted. Run the EEPROM check.
4. Remove the leads and refit the shunts.

`bt_companion_ibdk_enter()` drives GPIO18–20 for this and refuses on a
board configured for two lines.

**Holding the programming header in place.** A 2.54 mm header pin is a
0.64 mm square post (~0.90 mm across the corners). A snug fit needs a
~0.9 mm drill, but JLCPCB's ±0.08 mm plated-hole tolerance is bigger than
the interference, so friction isn't repeatable. Options: stagger alternate
holes 0.05–0.15 mm off the centreline (grip then comes from bending the
pins, set by hole position, which is held more tightly than diameter), or
tack-solder two end pins. Since a dropout mid-write leaves the module
half-configured, tack-soldering is the safe default.

## SHK divider

10 kΩ series, 100 kΩ to ground, both lines. The AG1171's SHK output is
~3.3 V through an internal 3.3 kΩ pull-up (VOH 2.8 V min); with 100 kΩ the
GPIO sees ~2.9 V off-hook, above the C6's 2.475 V input-high threshold, and
a defined low with the SLIC powered down.

## Bring-up checklist

Nothing on this board has been powered yet. In order; stop at the first
thing that's wrong.

**Which firmware, which jumpers.** The two MCU modules differ at four pads
(see above), and the jumpers JP2/JP3 steer `I2S_MCLK` and `SD_CD` to match.
So there's one firmware for both modules as long as the jumpers agree with
the module:

| Module fitted | JP2 / JP3 | Firmware |
|--|--|--|
| Genuine ESP32-C6-DevKitC-1 | as shipped (pads 1–2 bridged) | `smd5` |
| Clone, jumpers moved | cut 1–2, bridge 2–3 | `smd5` |
| Clone, jumpers left | as shipped | `smd5_cheap` (no USB console) |

Moving the jumpers is a cut and a solder blob on the back of the board;
the firmware doesn't change. Do one module at a time and re-check the
table's "wrong jumper" symptom (no audio, microSD "no card") if it
misbehaves.

1. **Before power.** Beep out: +5 V to GND (no short), +3.3 V to GND, U5
   output (`+3.3V_BM`) to GND. Check JP2/JP3 against the module fitted,
   and that only one side of each is bridged.
2. **First power, no phone, no daughter board.** 5 V in. Measure +3.3 V on
   the MCU rail and on `+3.3V_BM` (U5), and the SLIC rails.
3. **Flash.** `firmware/bringup/flash_board.py --board smd5` (or
   `smd5_cheap`), 16 MB or 8 MB is detected from the chip. A fresh board has
   no firmware to ask, so `--board` is required the first time.
4. **Console and board identity.** `board_info` reports the pin map;
   `codec_detect` → ES8388 at 0x10. If audio is silent but I²C answers,
   suspect the MCLK jumper (scope U2 pin 1 for 12.288 MHz).
5. **The standard steps:** `firmware/bringup/bringup_checklist.py`
   (MCU → codec → audio → SLIC → DTMF), then `first_setup.py` for Wi-Fi and
   the default prompts. microSD: insert a card, `sd_test`.
6. **SHK divider.** With a handset lifted, the SHK GPIO should read high
   (~2.9 V with the 10 kΩ / 100 kΩ divider); `hookmon` shows it.
7. **Bluetooth, one module at a time:**
   - BM64 carrier on `J2` (pin 1 at the 3.3 V end). Settings → Hardware →
     BM64, reboot. `bm64_test`, `bm64_addr`, then the EEPROM check
     (programming leads per the section above).
   - BK3266 daughter board: [`bk3266.md`](bk3266.md) has its own sequence
     (`firmware/bringup/test_bk3266.py`).
   Switching modules is a Hardware-tab change plus a reboot; no jumper or
   firmware difference.
8. **Results** go in the sections above (replace "not yet tested") and in
   [`bk3266.md`](bk3266.md)'s log.

## Open questions

- **Clone module regulator.** The clone's onboard 3.3 V regulator is
  smaller than the genuine module's. With the BM64 on U5, it supplies the
  MCU and codec; measure worst-case draw (Wi-Fi TX bursts + codec) on a real
  clone board before relying on it.
- **Clone pad map.** Only the 12/13 ↔ 19/20 swap was checked against a real
  sample (one clone's silkscreen). Verify pad by pad (continuity, or a
  GPIO-toggle build) before ordering a batch.
- **Power sequencing** between the BM64 and the SLICs — see
  [`archive/BLUETOOTH_AUDIO_UPGRADE.md`](../BLUETOOTH_AUDIO_UPGRADE.md).

## Ideas not on this board

- **A multi-function button** on a spare ESP32 GPIO (not on MFB): click to
  start Bluetooth pairing, ~3 s hold for the rescue Wi-Fi network, ~10 s
  to forget Wi-Fi — the same gestures `board_boot_button_start()` already
  handles for BOOT. A side-mounted tactile switch, reachable through the
  enclosure wall.

- **A wider-input DC jack (next board version, idea):** a 5 V step-down converter between
  the DC jack and the diode-OR (D1), so a 9 V wall supply works. The SMD4/SMD5 jack path is
  limited to about 5.5-6 V: the +5 V rail feeds the DevKit's onboard LDO, the AG1171 SLICs
  and U5, an XC6206 rated about 6 V in. Spec the jack as roughly 7-24 V, 9 V recommended; a
  5 V adapter does not work through a buck (no headroom), so 5 V stays on USB-C. Set the
  output about 5.3 V so the rail is still about 5 V after D1. Needs an inductor, input and
  output capacitors, and reverse-polarity and TVS protection at the jack. Listen for
  switching noise on the handset.

  JLCPCB candidates (the MP2315 is custom-order only there):

  | | **MP1584EN** (JLCPCB C49367328, listed "MP1584EN-LF-Z-JSM") | **MP2307DN** (JLCPCB C49375228, "MSMP2307DN-LF-Z") |
  |--|--|--|
  | Input | 4.5-28 V, abs max 30 V (MPS datasheet Rev 1.0) | 4.75-23 V |
  | Output / current | 0.8-25 V, 3 A, current limit 4.0-4.7 A | 0.925 V reference, 3 A |
  | Type | non-synchronous: **external Schottky diode** (3 A, 40 V) | synchronous (100 mΩ switches), no diode |
  | Frequency | set by a resistor, 100 kHz-1.5 MHz (900 kHz typ. at 100 kΩ) | 340 kHz (MPS datasheet; some listings say 380 kHz) |
  | Feedback | 0.8 V (0.776-0.824) | 0.925 V |
  | Headroom | min off time 100 ns: about 95 % duty at 500 kHz, so 5 V out needs about 6 V in | not read (datasheet unavailable here) |
  | Package | SOIC-8E (exposed pad), theta-JA 50 °C/W | SOIC-8N, exposed pad |
  | Status | **Not recommended for new designs**, MPS points to the MP2338 | **NRND** per distributors (not confirmed from the MPS datasheet) |

  Read from the MP1584 datasheet (an RS Components copy; MPS's own site blocks downloads
  here): EN is enabled when floating or above 1.5 V, but its absolute maximum is 6 V, so
  it cannot be tied to Vin at 9 V; the datasheet's circuit uses 100 kΩ (Vin to EN) and
  24.9 kΩ (EN to ground), which only turns the converter on above about 7.5 V. Feedback
  divider for 5.3 V with 40.2 kΩ to ground: **226 kΩ** on top (5.0 V: 210 kΩ). Typical
  circuit: 10 µF input, 22 µF output (ceramic), 10 µH inductor, 100 nF bootstrap, COMP
  network 68.1 kΩ + 220 pF. Soft start 1.5 ms, quiescent 100 µA, UVLO 3.0 V. The efficiency
  curve at 12 V in, 3.3 V out shows about 85-88 % at 1-3 A.

  **Not checked:** the MP2307 datasheet (every copy was blocked or unreadable), so its
  headroom, EN pin and recommended parts are unverified. The two JLCPCB listings carry
  third-party names ("MS..." and "-JSM"), so they may be second-source parts made by other
  companies, not MPS; their own datasheets may differ from the MPS ones above. Get those
  from the JLCPCB part pages before choosing. Rejected earlier: TPS54202 and AP63205 (about
  8 V in for 5 V out), RAA2114054GP3 and MAX77596 (300 mA only), TPS63070 buck-boost ($3.37,
  QFN, accepts any input; the fallback if a 5 V adapter must work), MP2315 (not in stock on
  JLCPCB), XL1509-5.0 (fixed 5 V, 2 A, about 1.5 V dropout, non-synchronous).

## Bring-up log

**2026-10-19, first two boards, no phone attached, one line, no microSD.** Both
flashed with the `smd5` build over native USB (16 MB flash each). Boards
named by MAC: `…b1:14` = genuine DevKitC-1 + BM64 carrier, `…b4:64` = 30-pin
clone + BK3266 board. Settings set from the console with `hwcfg` (new) since a
board in Wi-Fi setup mode can't reach Settings -> Hardware without moving the
laptop off its network.

| Check | Genuine + BM64 | Clone + BK3266 |
|--|--|--|
| Boots, console, `board_info` = SMD5 | ok | ok |
| ES8388 at 0x10 (I²C) | ok | ok |
| Codec -> SLIC -> codec (`tonetest`) | tone returns, -31 dBFS | **no tone**; both ADC inputs read rms ~80 (genuine: 1-3) |
| BT module on UART | BM64 answers at 115200, BD address 3C:BC:32:D0:B7:44; pairing mode (discoverable) starts | **silent** at every baud tried (`bk_baudscan`), binary and text |
| BT EEPROM check | **can't verify**: IBDK entry fails (no P2_0/RST_N leads fitted); the module is "unverified" until they are | n/a |

- Clone + `smd5` firmware and no audio is the documented "clone, jumpers left
  at default" row: MCLK is on the wrong pad. Either move JP2/JP3 to the clone
  side (then `smd5` works with the USB console) or run `smd5_cheap`, which
  has no USB console and puts the console on the same UART0 pins the Bluetooth
  module uses, so serial bring-up of the BK3266 can't be done in that mode.
  Which the jumpers are: unconfirmed, the symptoms point at default.
- BM64 `config check: 6/6 correct, 0 written, error: couldn't enter IBDK`
  prints "6/6 correct" even though nothing could be read: the count is
  misleading when IBDK entry fails.
- Wi-Fi: `the home Wi-Fi` was not in a scan from where the boards sit
  (11 networks seen, not that one); credentials are saved and they will join
  when it is in range.

**2026-10-20.** Genuine + BM64: the carrier's RST_N and P2_0 leads were fitted
on J5 pins 7 and 5 (GPIO18 and GPIO19), one pin off the documented pins 5 and
3 (GPIO19, GPIO20). `bm64_findwire 18` found RST_N; `bm64_diagpins 18 19` told the
firmware; the EEPROM check then ran: 2/6 correct, `bm64_config apply` wrote 4,
6/6 correct, self-test "Bluetooth audio EEPROM" PASS. The pin numbers are now a
runtime setting (NVS), and a failed IBDK entry tries RST/P2_0 swapped once.
Clone + BK3266 and both boards on Wi-Fi (the home Wi-Fi, 2.4 GHz works). OTA over
Wi-Fi of a release image to a 3 MB slot worked; the old-layout gate in the web
UI renders as intended.

**BM64 supply, 2026-10-20 (datasheet DS60001403F).** `BAT_IN` takes 3.2-4.2 V (typical 3.8 V); `ADAP_IN` (4.5-5.5 V) is the
battery-charger input, not a way to run the module, and the datasheet says to power `BAT_IN` from a battery or a
regulated rail. So 5 V straight onto `BAT_IN` is out of range: keep the LDO (U5). The XC6206P372MR-G (3.7 V) is closer to
the BM64's typical 3.8 V than 3.3 V is to its 3.2 V minimum, and meets the BK3266 listing's 3.6 V minimum too.
Two series diodes from 5 V (about 3.8 V under 15 mA) would also work but sag with load; the LDO costs the same.
The BM64's EEPROM audio config lives in the module, so the RST_N / P2_0 leads are only needed to program a new one.

**v5 PCB error, clone module (2026-10-20):** the footprint ties the clone's bottom-right 5V pin to GND; remove that pin (the bottom-left 5V pin supplies 5 V). v6 has the footprint fixed, its 5V wiring for that pad not done yet. Public docs carry the warning (README, board.md, bom.md, hardware-smd5.md).
