sdylewski/Analog-Redial/archive/hardware/ANALOG_REDIAL_SMD5.md

# Analog Redial 5 board (SMD5) — dev notes

> **Status (2026-10-04): sent to fab, not yet tested.** Three boards went out
> together: this main board, the BM64 Bluetooth carrier
> (`Bluetooth/Bluetooth_board/`), and a BK3266 test board
> (`Bluetooth/BK3266_board_v1/`) for a first look at that module as a
> possible BM64 alternative. The fab version includes the re-routes these
> notes used to list as planned (checked against the schematic netlist
> 2026-10-04): MFB on GPIO15 via an 8-pin **J2** BM64 header with a 100 kΩ
> pull-down (R17), the JP3/JP2 MCLK/card-detect solder jumpers, and the
> 100 kΩ SHK divider. Not in it: the multi-function button.

KiCad project: `hardware/kicad/Analog Redial v5/`. These are working notes
per [`CLAUDE.md`](../../CLAUDE.md)'s public-vs-internal-docs split, not a
public build guide. Nothing here is proven until boards come back and get
bench-tested.

## What's different from SMD4

The headline change is the MCU module footprint: SMD5 accepts **either** a
genuine Espressif ESP32-C6-DevKitC-1 module **or** a cheaper AliExpress
clone module with a different physical pinout, via a dual-compatible
footprint (`Scott.pretty/ESP32-C6-DevKitC-dual.kicad_mod` for the real
module, `ESP32-C6-DevKitC-cheap.kicad_mod` for the clone). Everything else
(SLIC/codec/tip-ring layout, clearance rules) carries over unchanged from
SMD4 — see [`ROTARY_PHONE_SMD4.md`](ROTARY_PHONE_SMD4.md) and
[`docs/hardware-smd4.md`](../../docs/hardware-smd4.md) for that baseline.

## The module swap: what actually changes

Both module types are electrically the same chip (ESP32-C6), so the
schematic itself (`Analog Redial v5.kicad_sch`) only needs **one** symbol
(`PCM_Espressif:ESP32-C6-DevKitC-1`, ref `U1`) using the real module's
standard pad numbering. The clone module's PCB routes some of its own chip
pins to *different physical pad positions* than the real module does — the
footprint (not the schematic) is what's dual-compatible, by physically
placing each shared pad number at whichever location lines up with *both*
modules' silkscreens, wherever they agree.

**The one confirmed discrepancy** (found by directly comparing the two
modules side by side): pad positions 12/13 and 19/20 disagree between
vendors.

| Schematic pad # | Real Espressif module | AliExpress clone module |
|--|--|--|
| 12 | `GPIO2` | `GPIO12` / `USB_D-` |
| 13 | `GPIO3` | `GPIO13` / `USB_D+` |
| 19 | `GPIO12` / `USB_D-` | `GPIO2` |
| 20 | `GPIO13` / `USB_D+` | `GPIO3` |

In other words: wherever the real module's native-USB pins physically are,
the clone's `GPIO2`/`GPIO3` show up instead, and vice versa. **This is a
silicon-level constraint, not a Kconfig one**: on the ESP32-C6, the
USB-Serial-JTAG *peripheral* is hard-wired to GPIO12 (D-)/GPIO13 (D+) —
unlike UART/SPI/I²C, which route through a flexible GPIO matrix to whatever
pin you configure, native USB cannot be relocated to different pins in
software. That's exactly why Espressif's own schematic labels these pins
"GPIO12"/"GPIO13" first (with the USB function as a secondary annotation,
same as this project's own symbol does above) — they're ordinary GPIOs any
time the native-USB peripheral isn't in use. **With the real module, it is
in use**: native USB is the board's flash/console link (corrected
2026-09-28 — an earlier version of this note called it "the normal case"
that they're free). So don't put MFB or anything else on GPIO12/13.

**Practical consequence**: whichever physical pad position ends up wired to
this board's actual USB-C/micro connector will only carry real native-USB
signaling with the real Espressif module populated. With the AliExpress
clone installed in the same footprint, that same connector position instead
carries the clone's `GPIO2`/`GPIO3` — ordinary digital pins, not USB — so
the board's own USB port goes data-dead (still fine as power-only) on
clone-populated units. No electrical risk either way (both are just 3.3V
digital pins), just a functional loss of native-USB flash/console on that
variant.

**Layout rule this implies**: apart from the two nets handled by the
jumpers below, don't assign anything to pad positions 12/13/19/20 — one
module or the other puts live USB D-/D+ signaling there.

### Solder-jumper select for MCLK and card-detect (in the fab version)

Decided 2026-09-29; **in the board sent to fab** as **JP3** (`I2S_MCLK`:
pad 1 → footprint pad 12, pad 3 → pad 19) and **JP2** (`SD_CD`: pad 1 → pad
13, pad 3 → pad 20). With the jumpers moved to the clone side, a clone board
can run the normal `CONFIG_BOARD_TYPE_SMD5` build with native USB intact;
`SMD5_CHEAP` is only needed if they're left at the default. Only two nets need a pad in the
swapped group: `I2S_MCLK` and `SD_CD`. Give each a 3-pad solder jumper
(symbol `Jumper:SolderJumper_3_Bridged12`, footprint
`Jumper:SolderJumper-3_P1.3mm_Bridged12_Pad1.0x1.5mm`) so the same net can
reach *either* module's GPIO2/GPIO3:

| Jumper | Centre pad (common) | Default, pre-bridged | Alternate, open |
|--|--|--|--|
| `JP_MCLK` | `I2S_MCLK` → codec `MCLK` | footprint pad **12** = real module `GPIO2` | footprint pad **19** = clone `GPIO2` |
| `JP_CD` | `SD_CD` → `Card1` pin 9 | footprint pad **13** = real module `GPIO3` | footprint pad **20** = clone `GPIO3` |

Both positions land on **GPIO2/GPIO3 in firmware** whichever module is
fitted, so the pin map stops depending on the variant and native USB keeps
its own pads in both cases. The `Bridged12` footprints ship with pads 1-2
joined by a hair-thin trace, so the board has a working default straight
from the fab: cut that trace and blob 2-3 to switch. (Two 2-pad jumpers at
90° work too — the 3-pad part just reads as one A/B selector.)

- **Bridge one side only.** Bridging both shorts pad 12 to pad 19 — with
  the real module that's GPIO2 fighting USB D-.
- **Silkscreen each jumper** ("MCLK: ESP / CLONE"): a wrong one gives a
  board with no audio and no obvious cause.
- **Drop J3/J4 from pads 19/20** while in there. They tap those pads today,
  which with the real module puts header stubs on live USB D-/D+, and after
  this change they'd also hang off the MCLK/CD alternates.
- Signal integrity isn't a concern here (MCLK is 12.288 MHz, card-detect is
  DC). Don't extend the same trick to the USB pair itself.
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
