sdylewski/Analog-Redial/archive/hardware/ROTARY_PHONE_SMD3.md

# Rotary Phone Gateway — SMD3 board

Design reference for the **third** SMD spin. This doc only covers what's
**different from SMD2** — everything else (ES8388 pin table, AG1171 SLIC
wiring, GND/audio path, JLC assembly notes) still applies from
[`smd2.md`](smd2.md) unless noted here (archived: only 3 SMD2 boards were ever built).

KiCad project: `hardware/kicad/Old/Analog Redial v3/`.

## Status
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
