sdylewski/Analog-Redial/docs/pics/case_empty.jpg

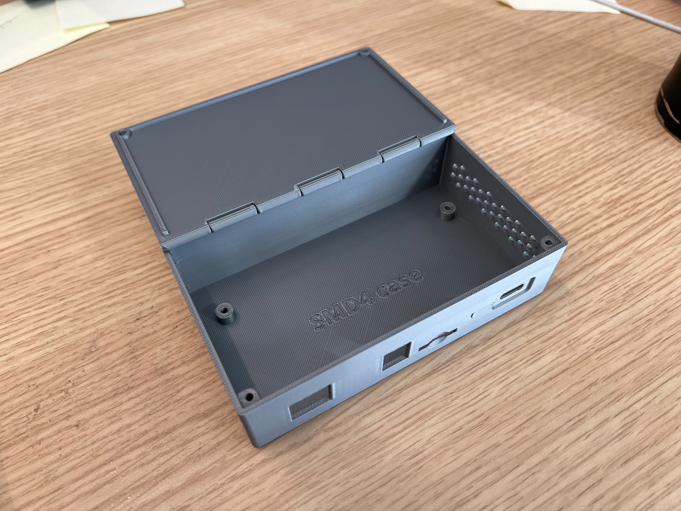
docs/pics/case_empty.jpg
