sdylewski/Analog-Redial/docs/pics/phone_calling.jpg

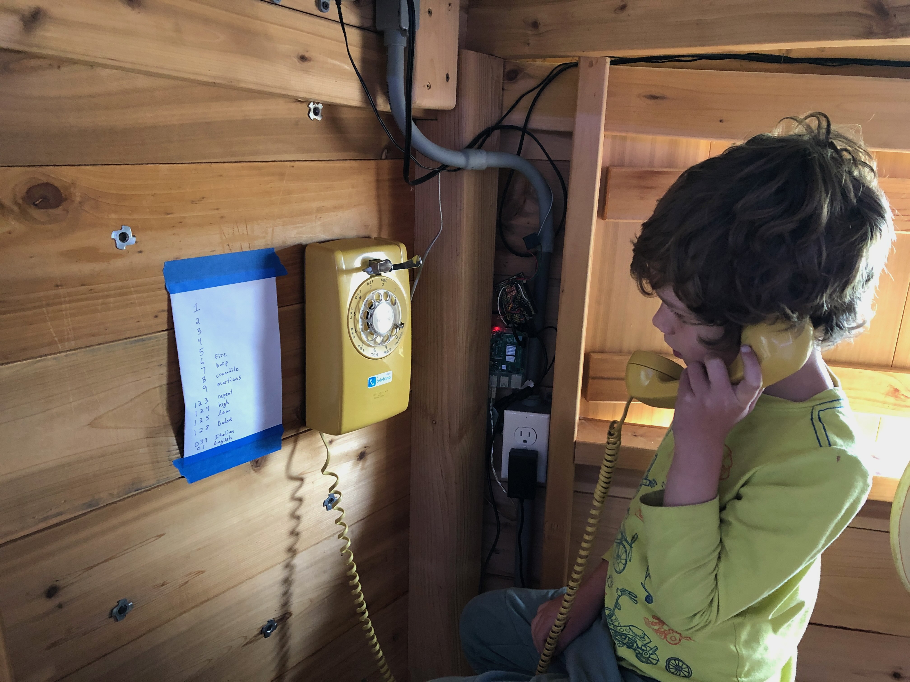
docs/pics/phone_calling.jpg
