sdylewski/Analog-Redial/docs/pics/phone_on_wall.jpg

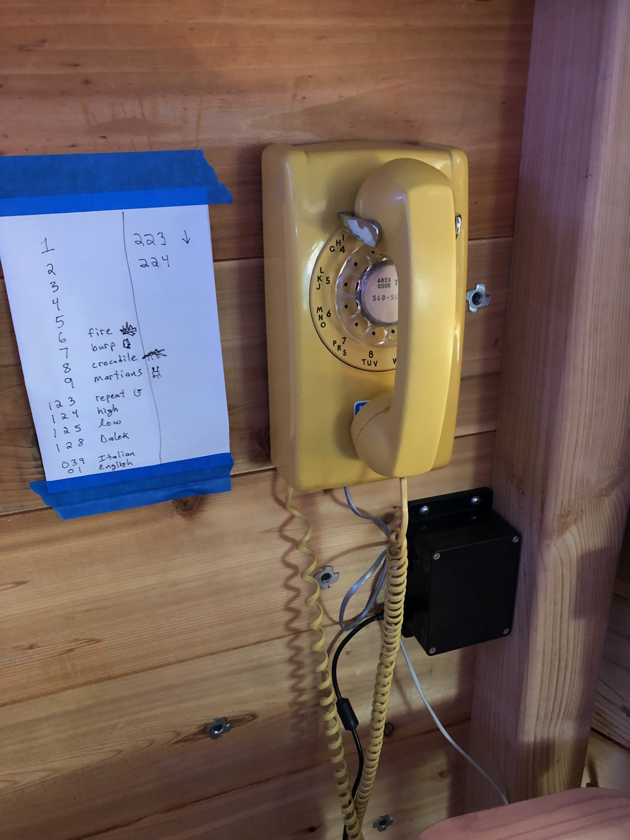
docs/pics/phone_on_wall.jpg
