sdylewski/Analog-Redial/docs/pics/recordings-light.png

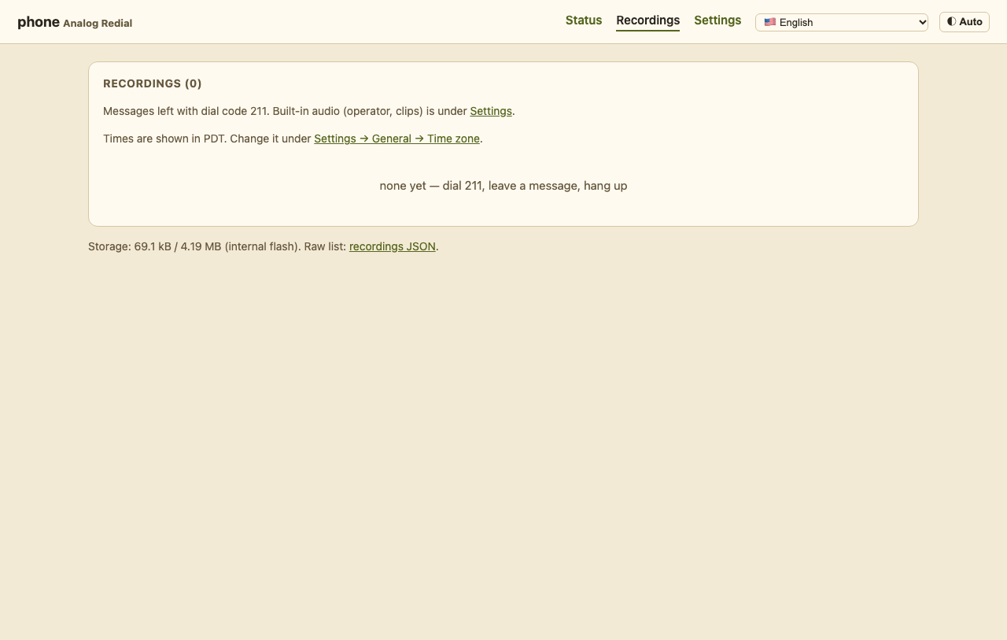
docs/pics/recordings-light.png
