sdylewski/Analog-Redial/docs/pics/settings-bluetooth-light.png

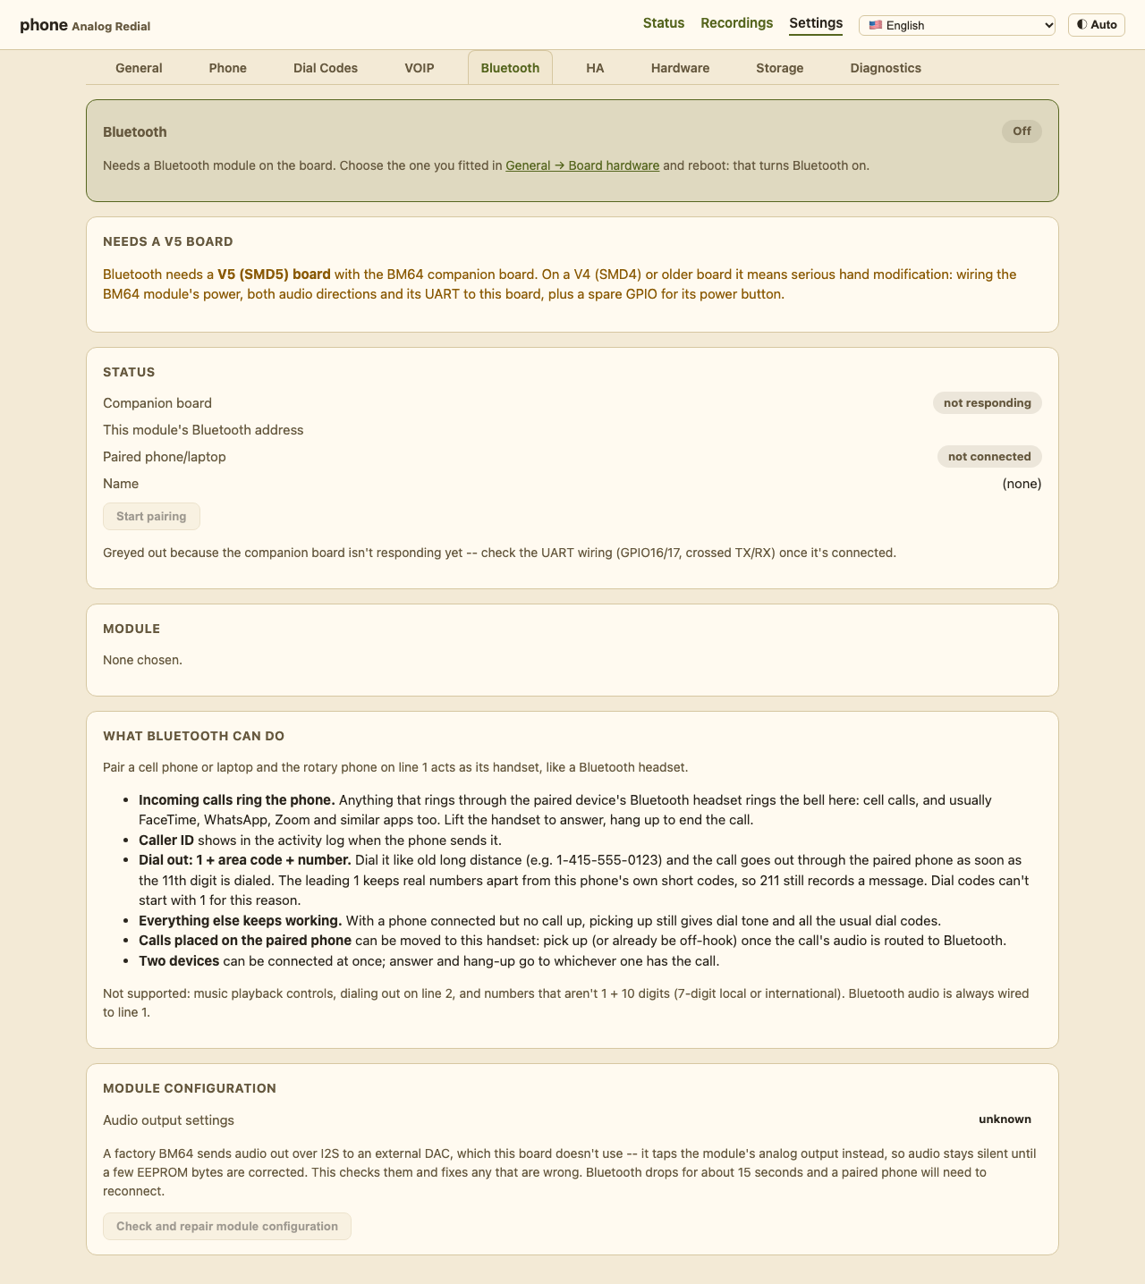
docs/pics/settings-bluetooth-light.png
