sdylewski/Analog-Redial/docs/pics/settings-bluetooth.png

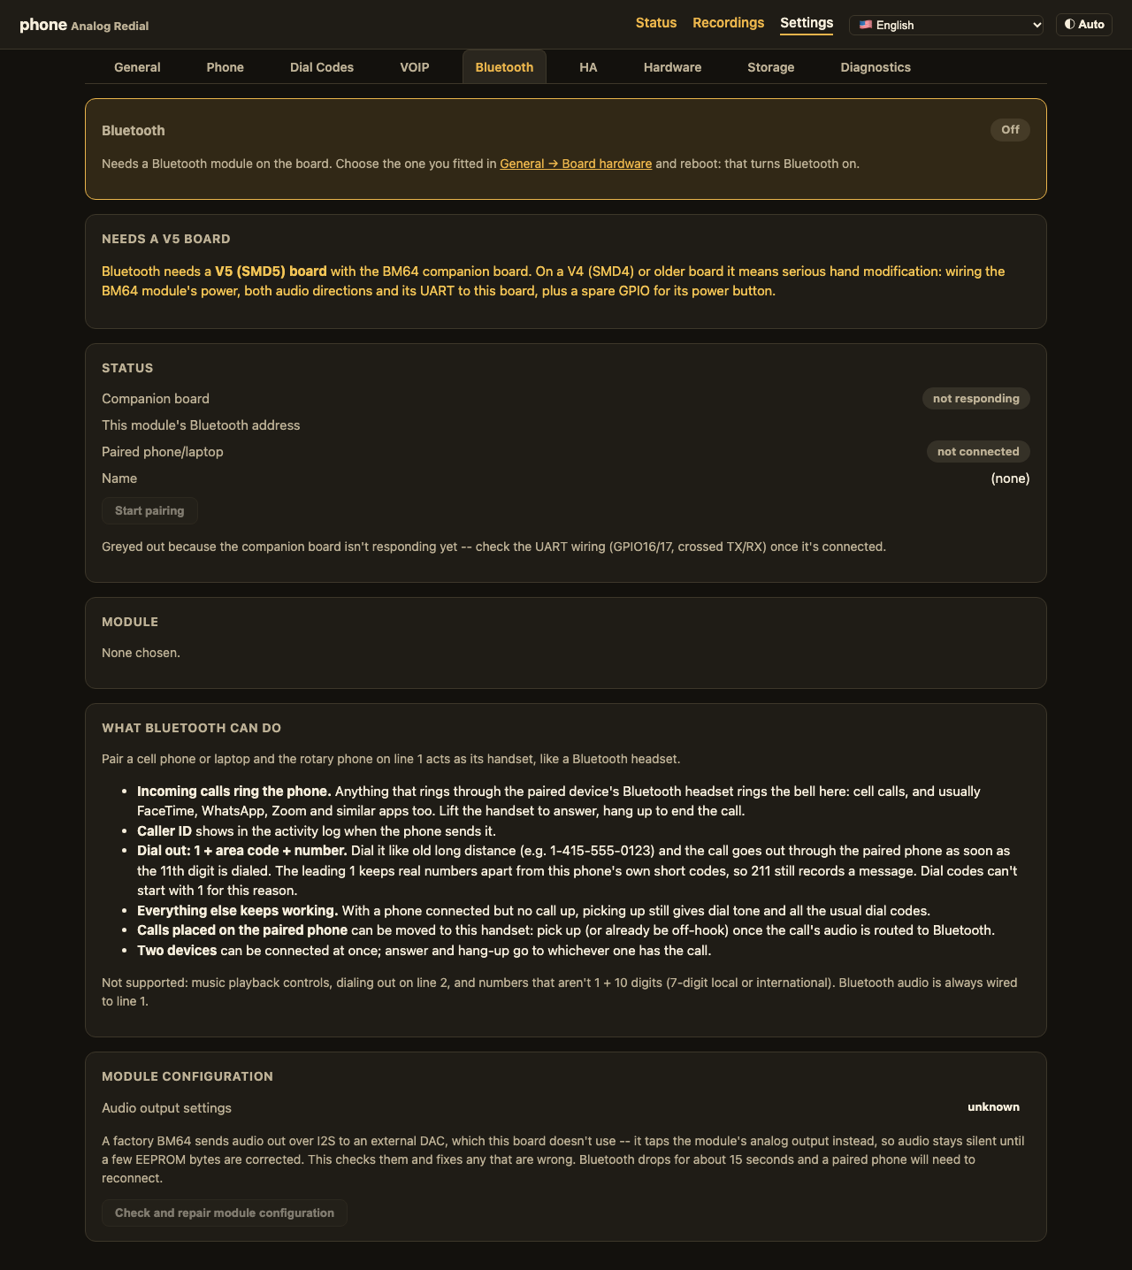
docs/pics/settings-bluetooth.png
