sdylewski/Analog-Redial/docs/pics/settings-diag-light.png

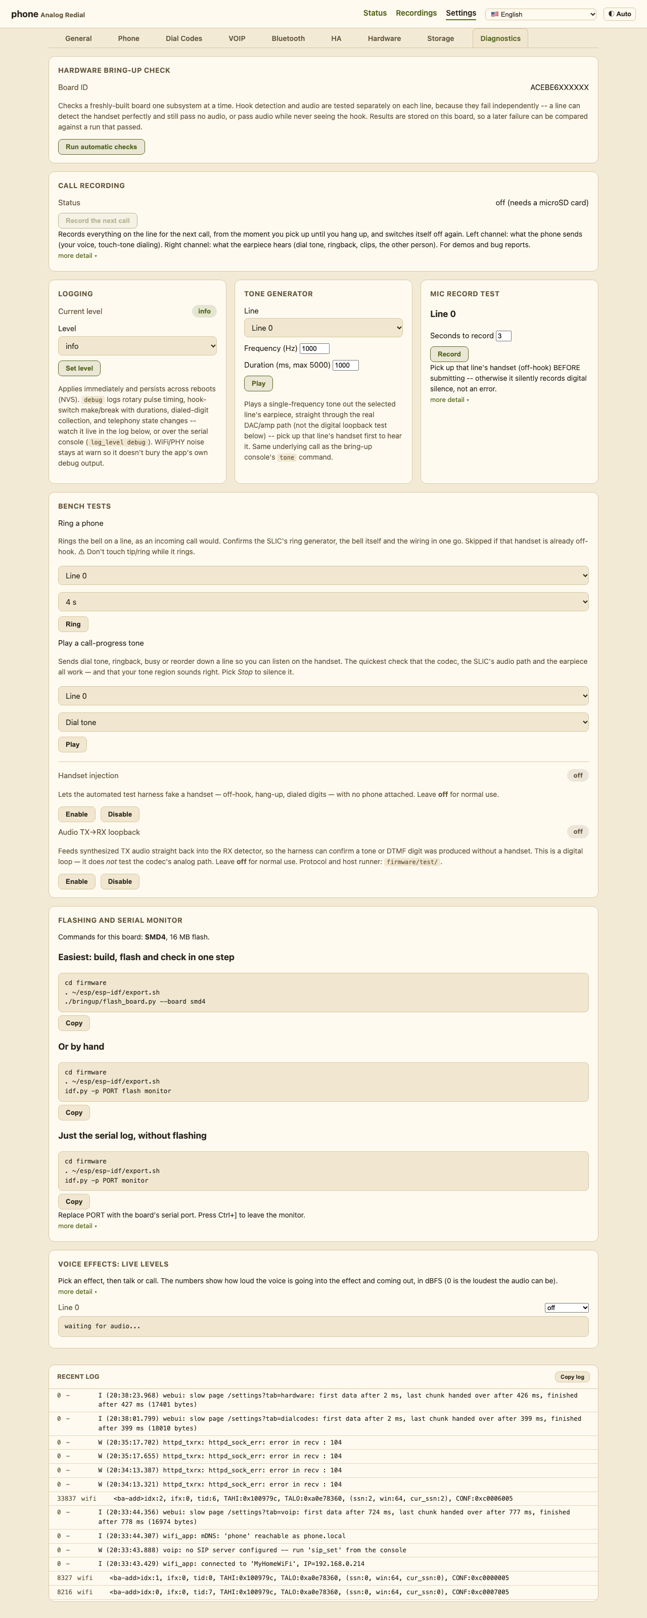
docs/pics/settings-diag-light.png
