sdylewski/Analog-Redial/docs/pics/settings-diag.png

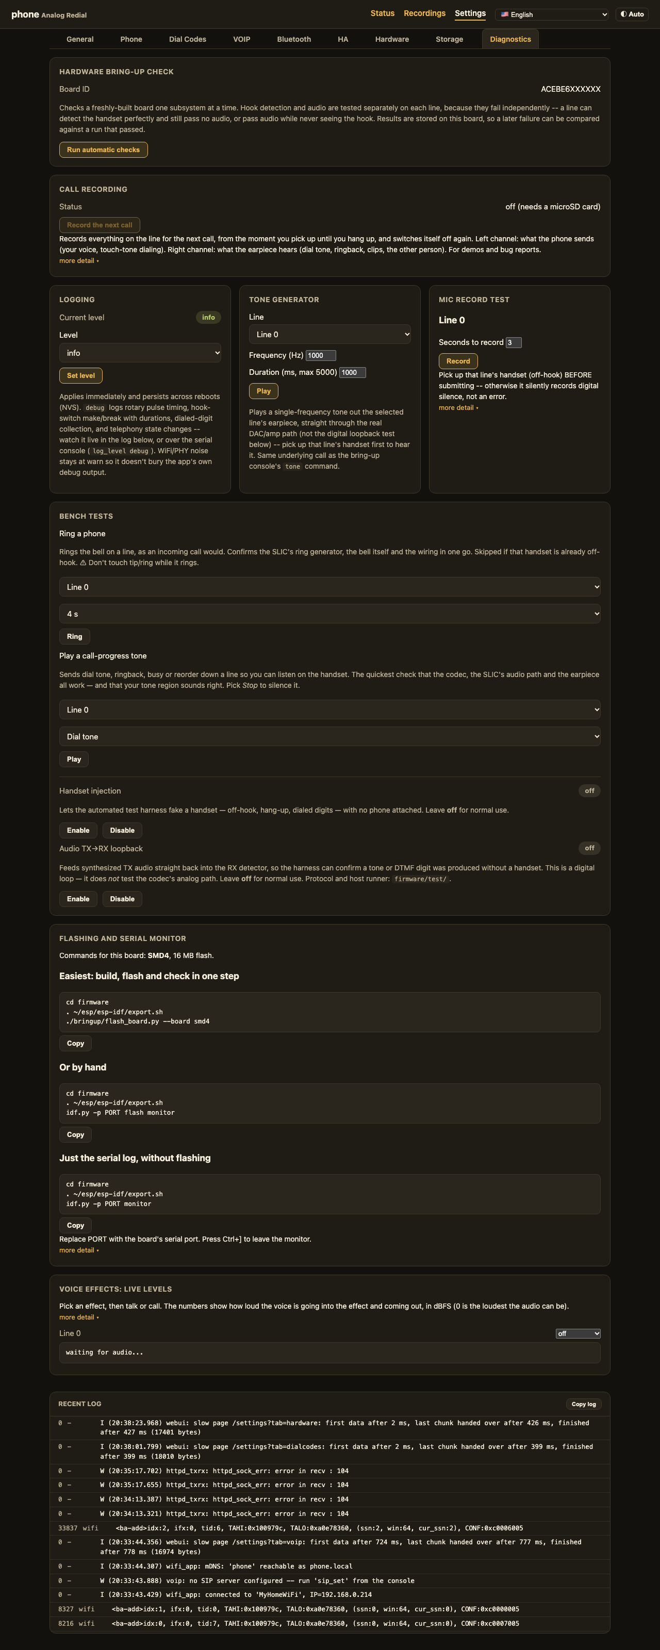
docs/pics/settings-diag.png
