sdylewski/Analog-Redial/docs/pics/settings-dialcodes-light.png

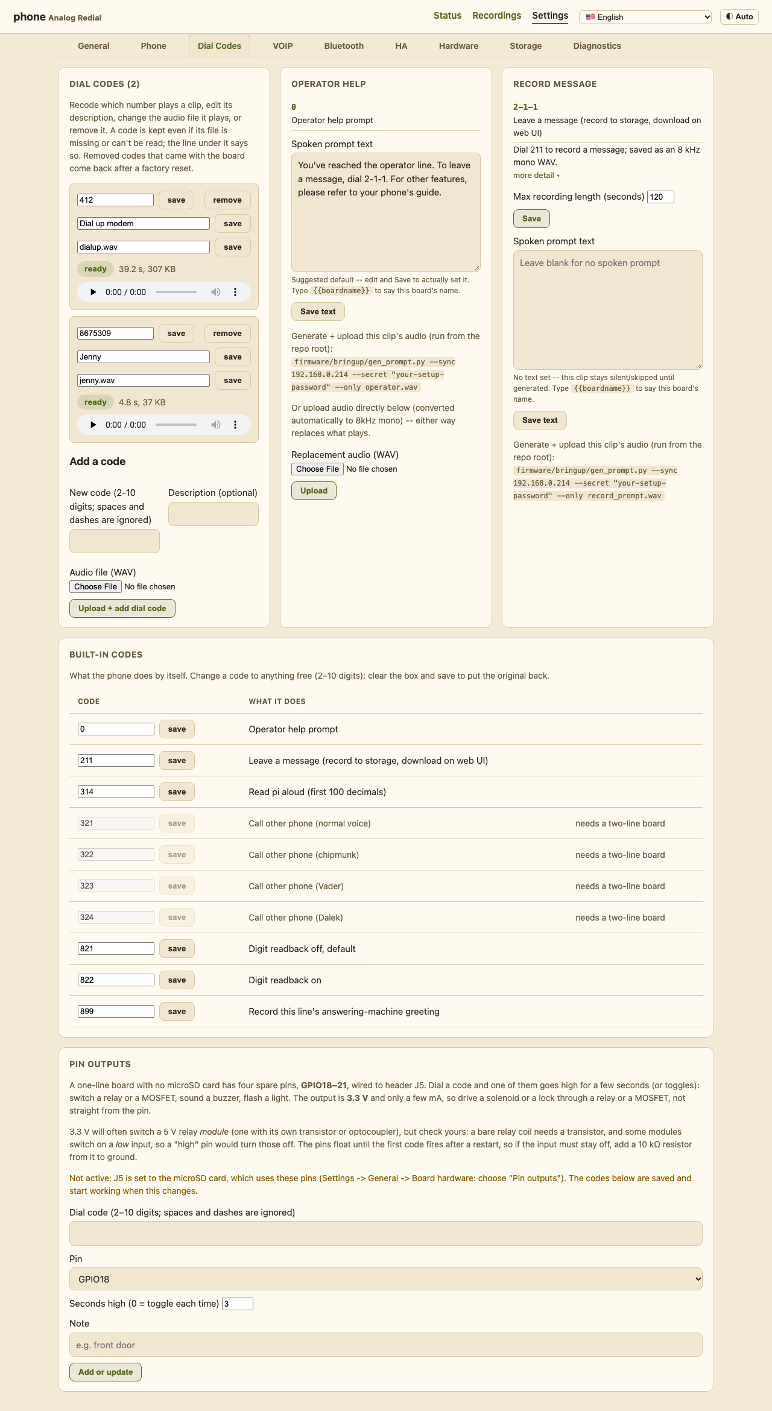
docs/pics/settings-dialcodes-light.png
