sdylewski/Analog-Redial/docs/pics/settings-dialcodes.png

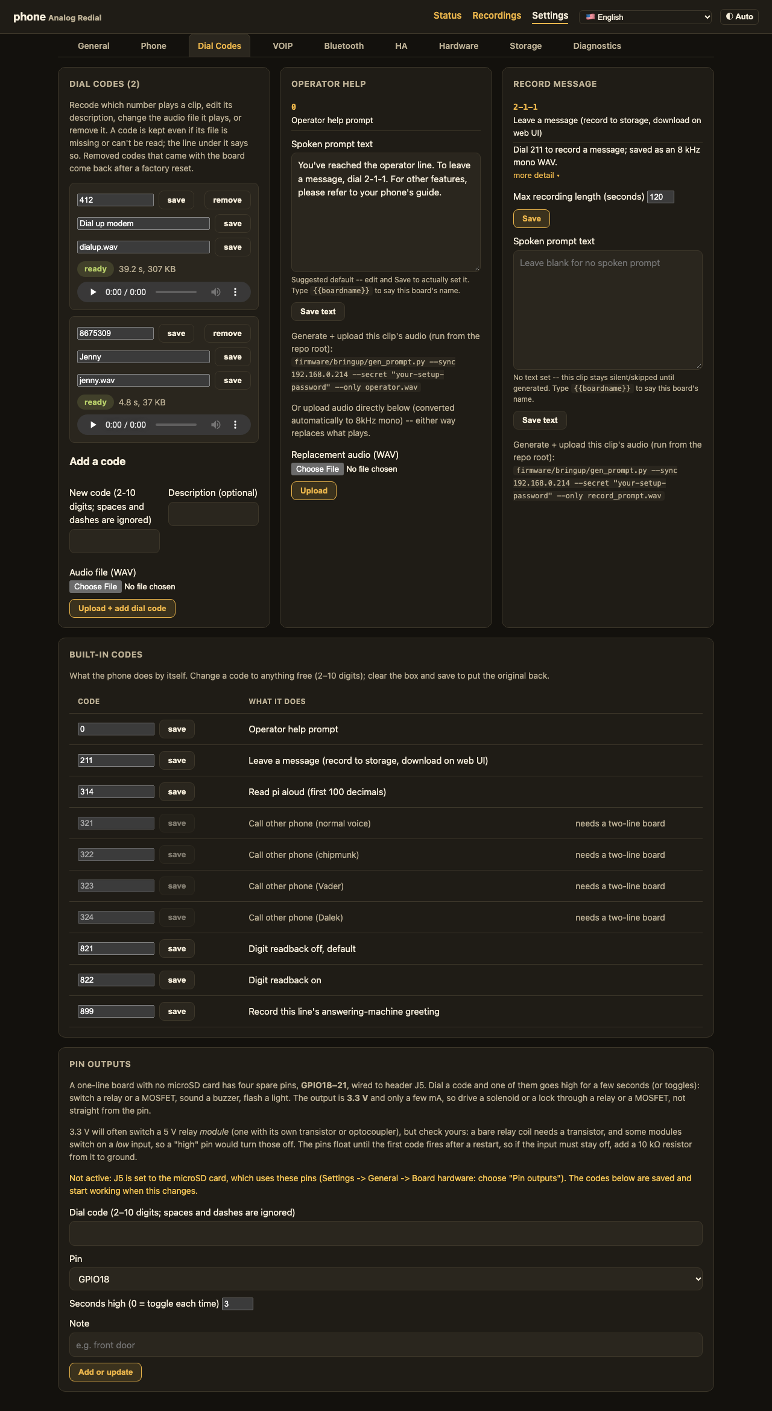
docs/pics/settings-dialcodes.png
