sdylewski/Analog-Redial/docs/pics/settings-general-light.png

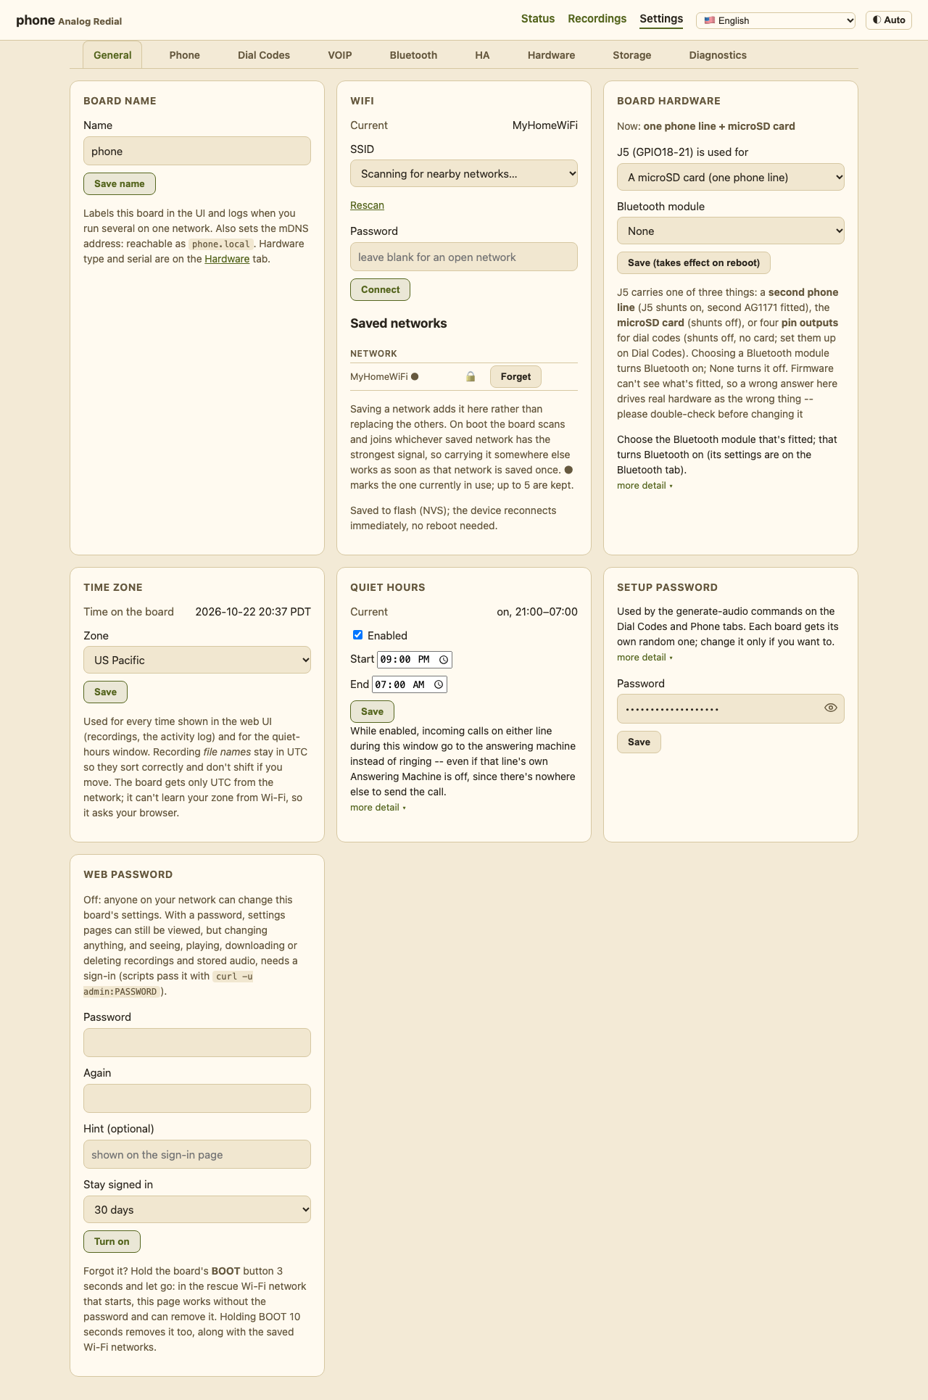
docs/pics/settings-general-light.png
