sdylewski/Analog-Redial/docs/pics/settings-general.png

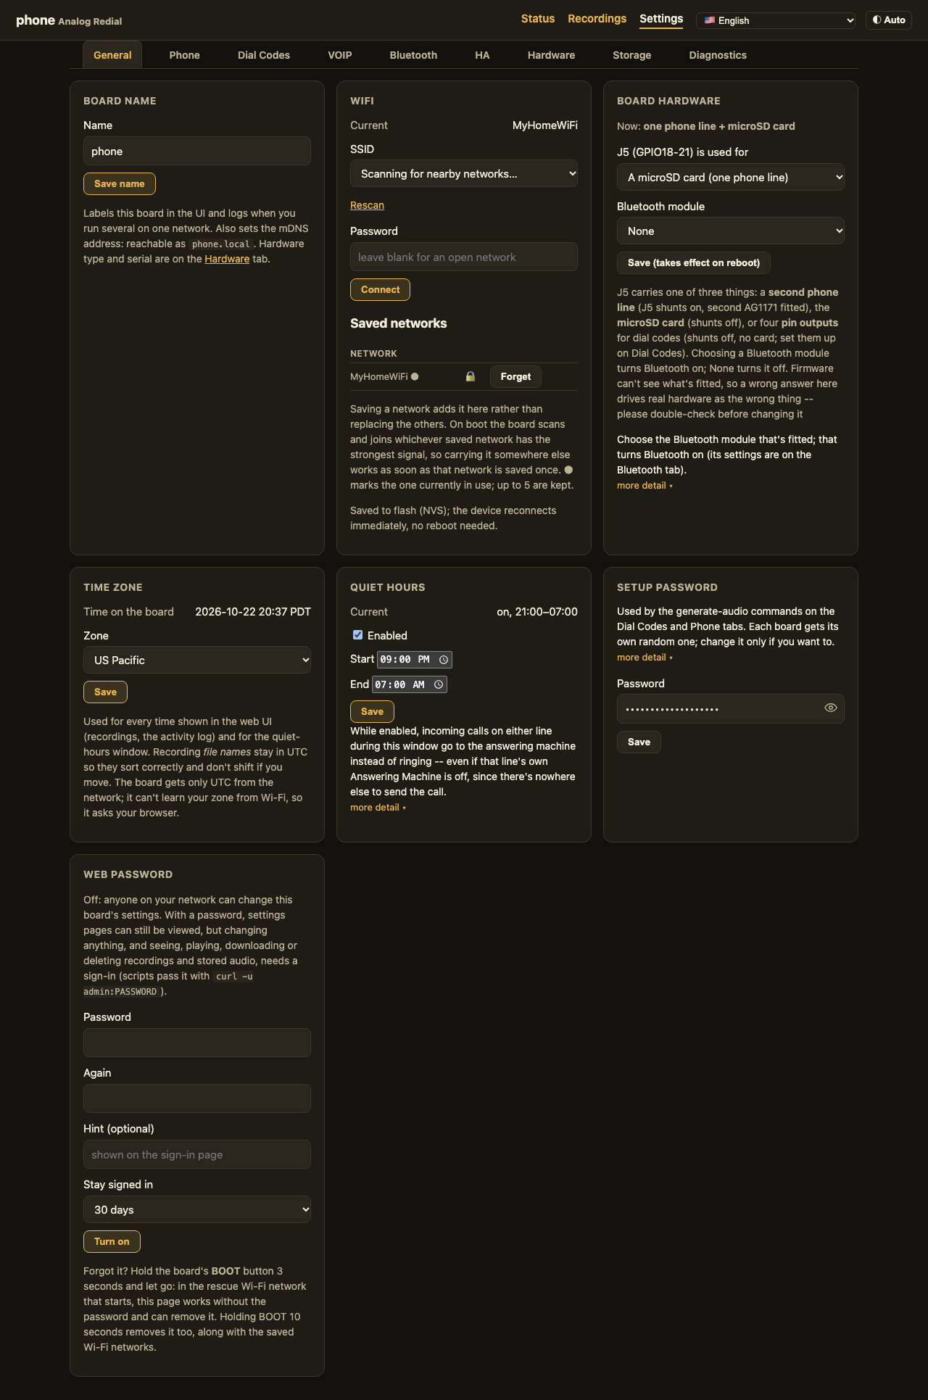
docs/pics/settings-general.png
