sdylewski/Analog-Redial/docs/pics/settings-hardware-light.png

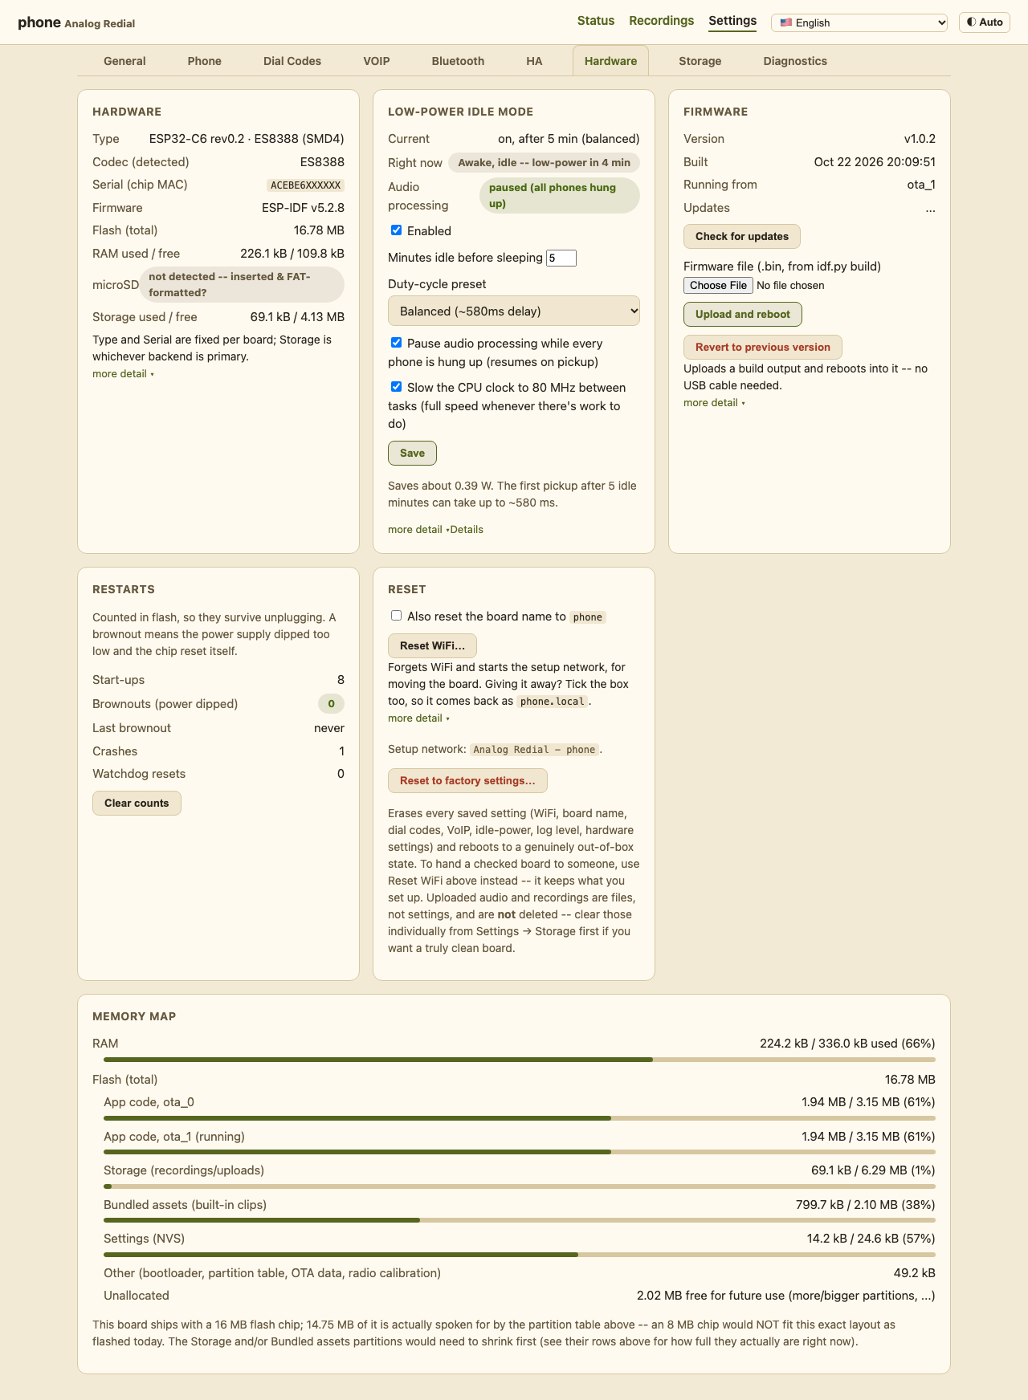
docs/pics/settings-hardware-light.png
