sdylewski/Analog-Redial/docs/pics/settings-hardware.png

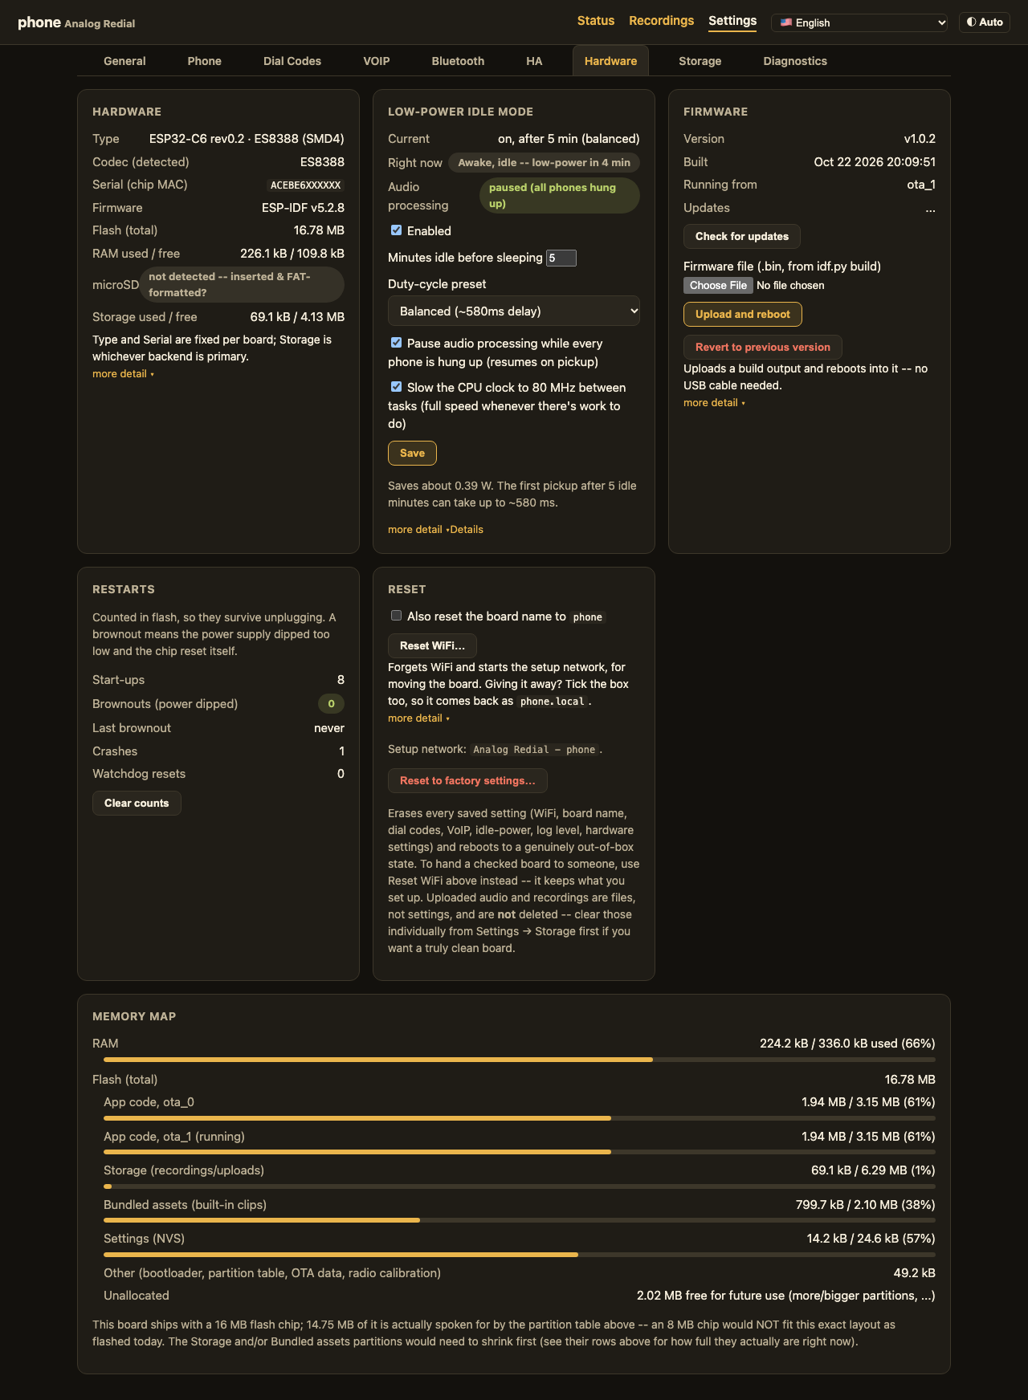
docs/pics/settings-hardware.png
