sdylewski/Analog-Redial/docs/pics/settings-home-light.png

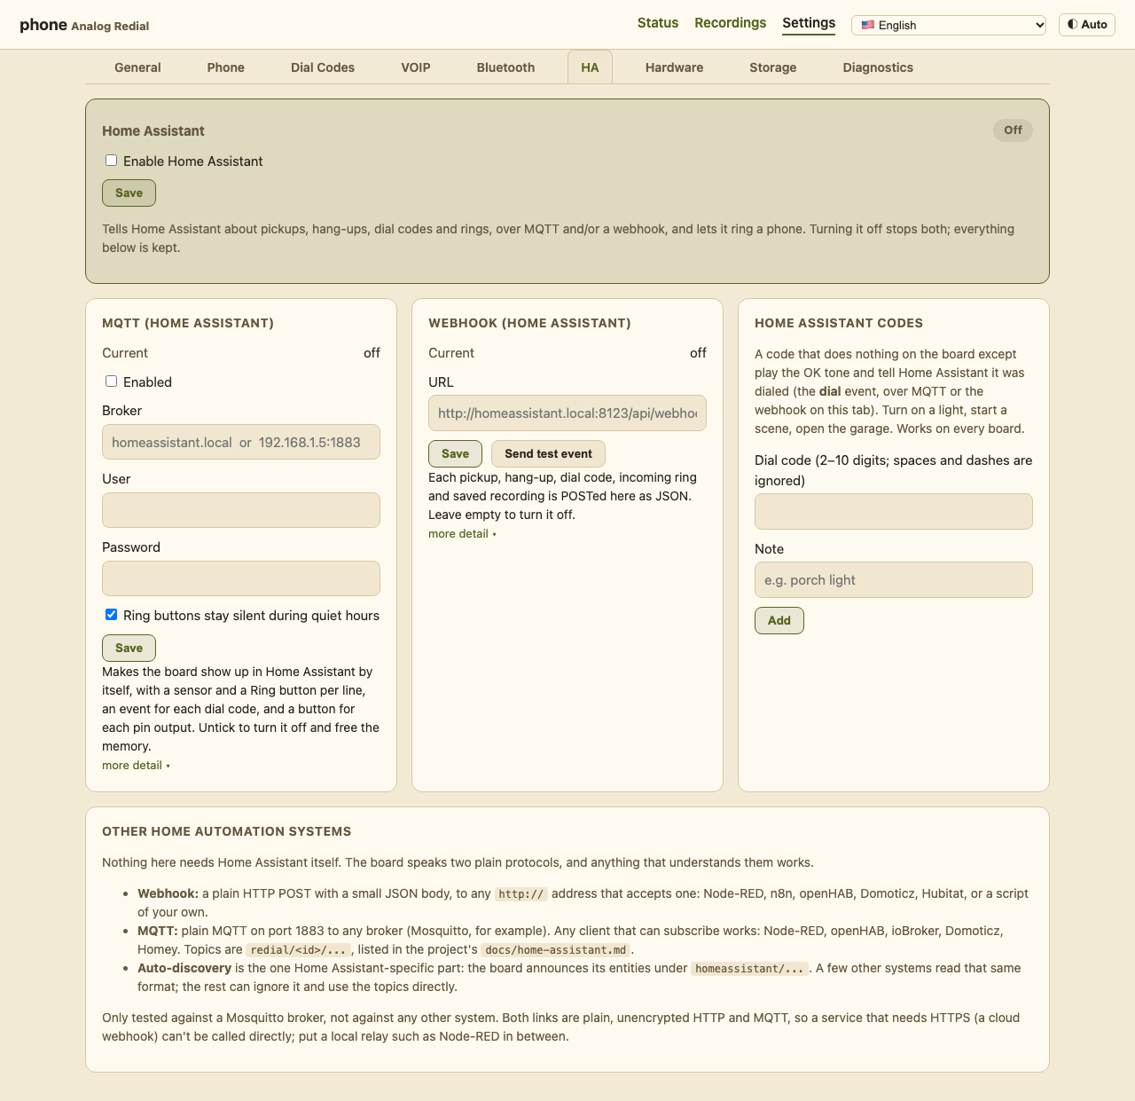
docs/pics/settings-home-light.png
