sdylewski/Analog-Redial/docs/pics/settings-home.png

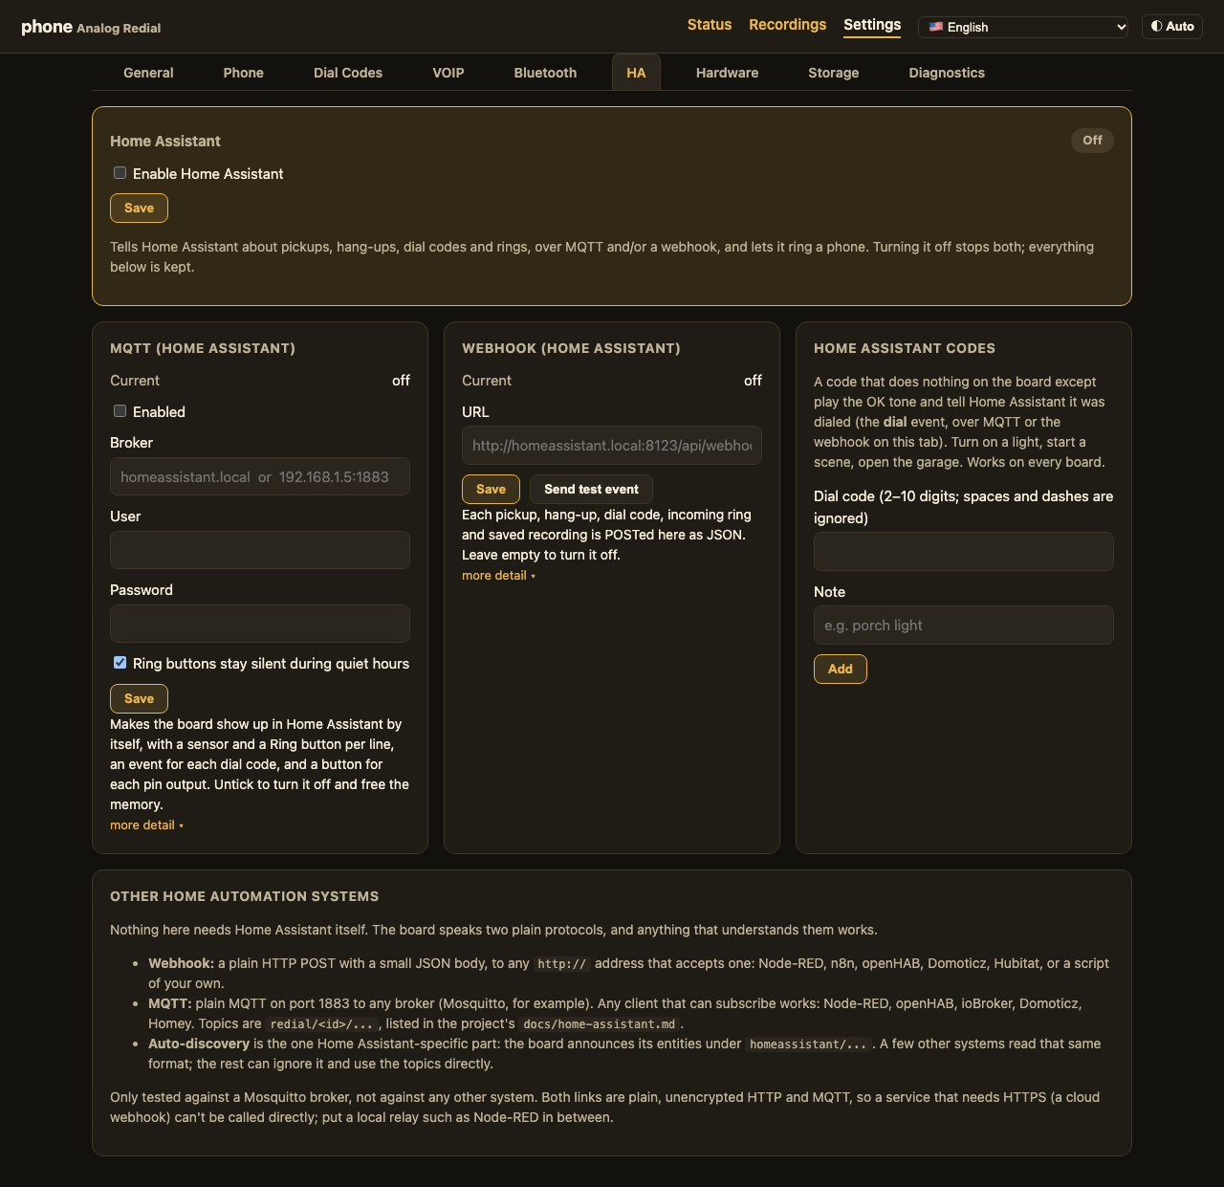
docs/pics/settings-home.png
