sdylewski/Analog-Redial/docs/pics/settings-phone-light.png

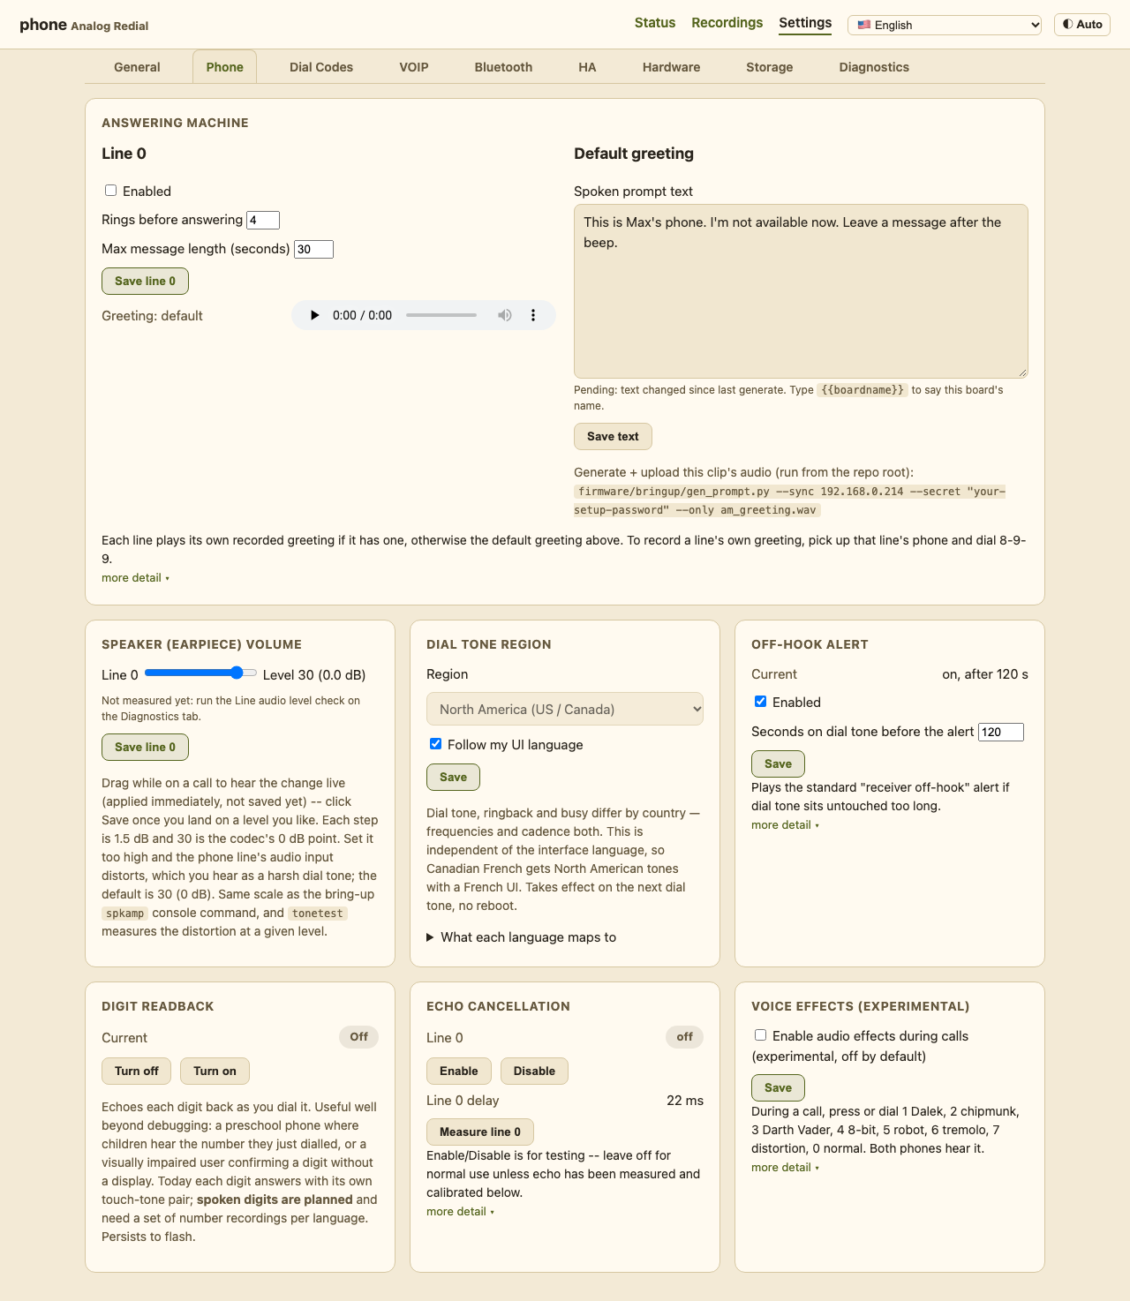
docs/pics/settings-phone-light.png
