sdylewski/Analog-Redial/docs/pics/settings-phone.png

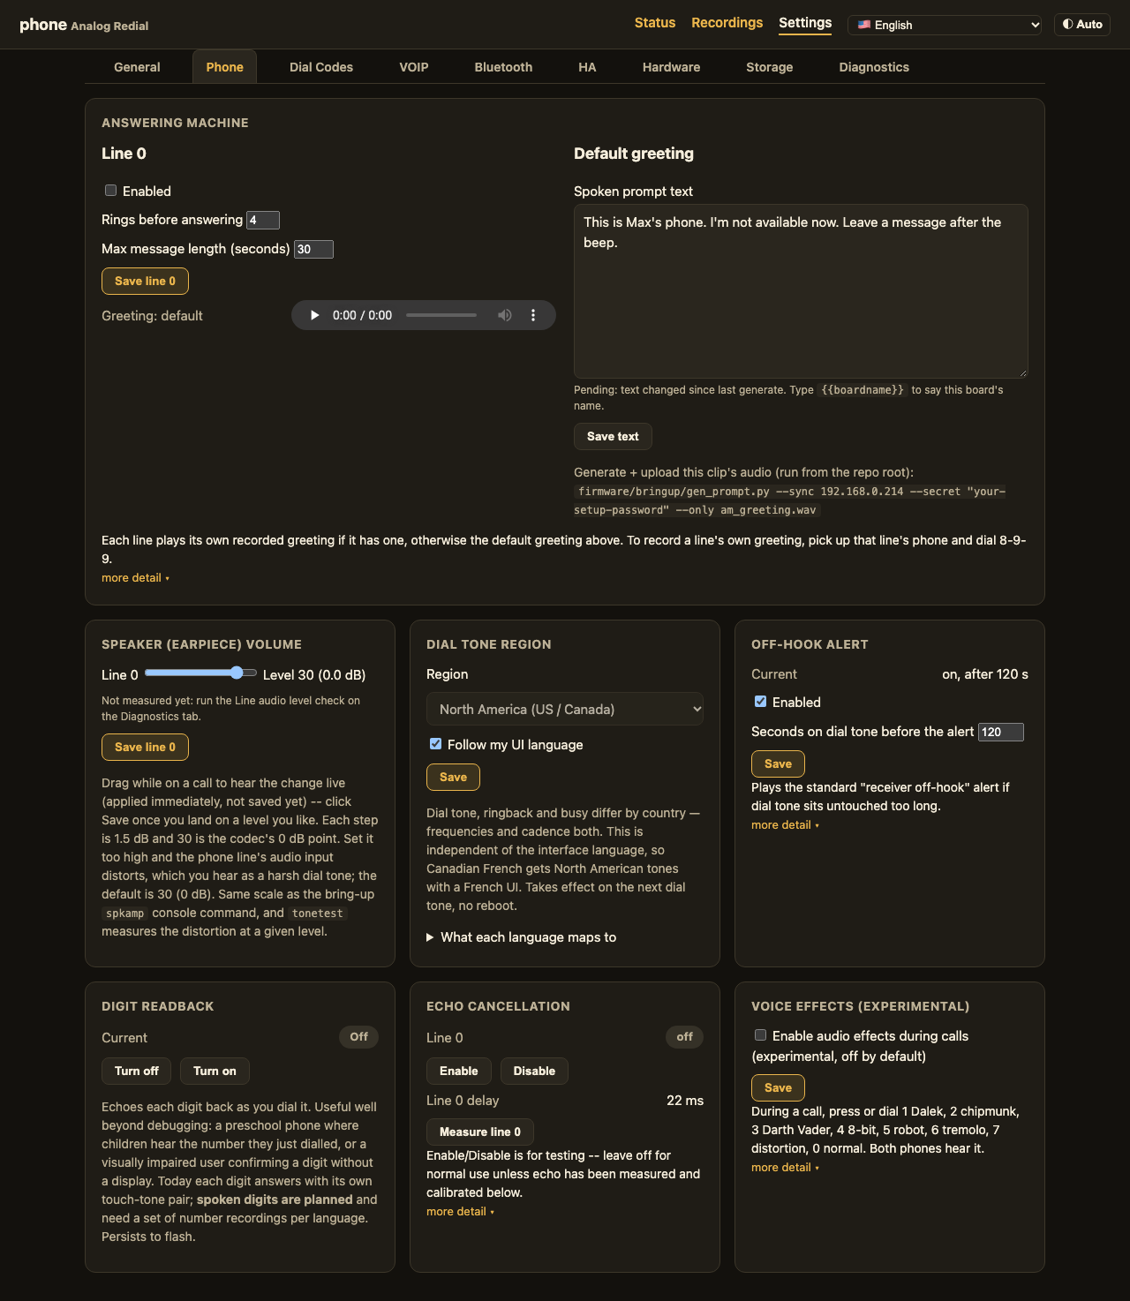
docs/pics/settings-phone.png
