sdylewski/Analog-Redial/docs/pics/settings-storage-light.png

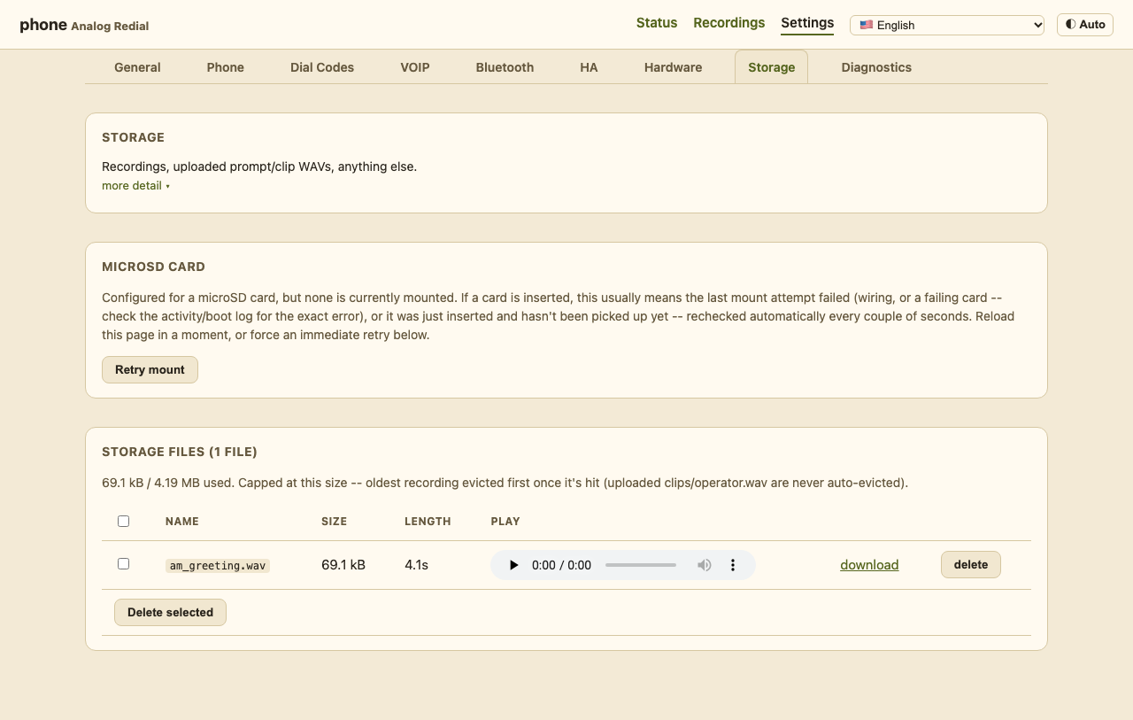
docs/pics/settings-storage-light.png
