sdylewski/Analog-Redial/docs/pics/settings-storage.png

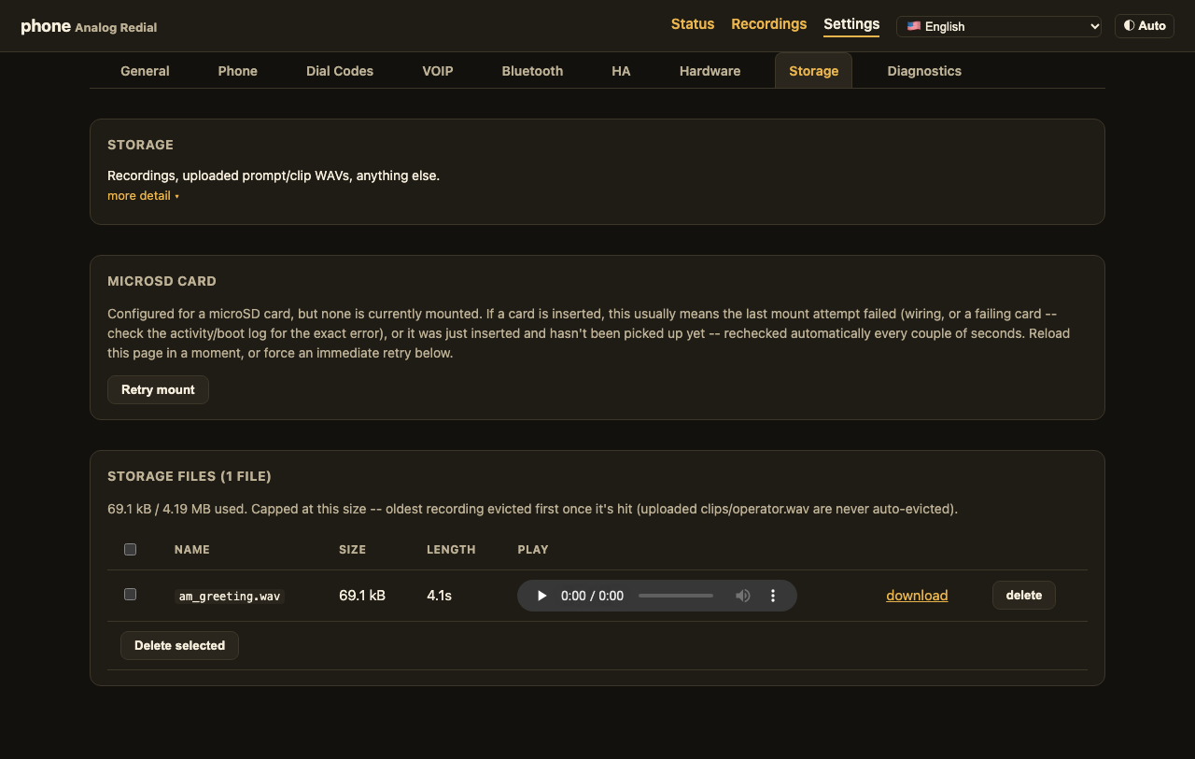
docs/pics/settings-storage.png
