sdylewski/Analog-Redial/docs/pics/settings-voip-light.png

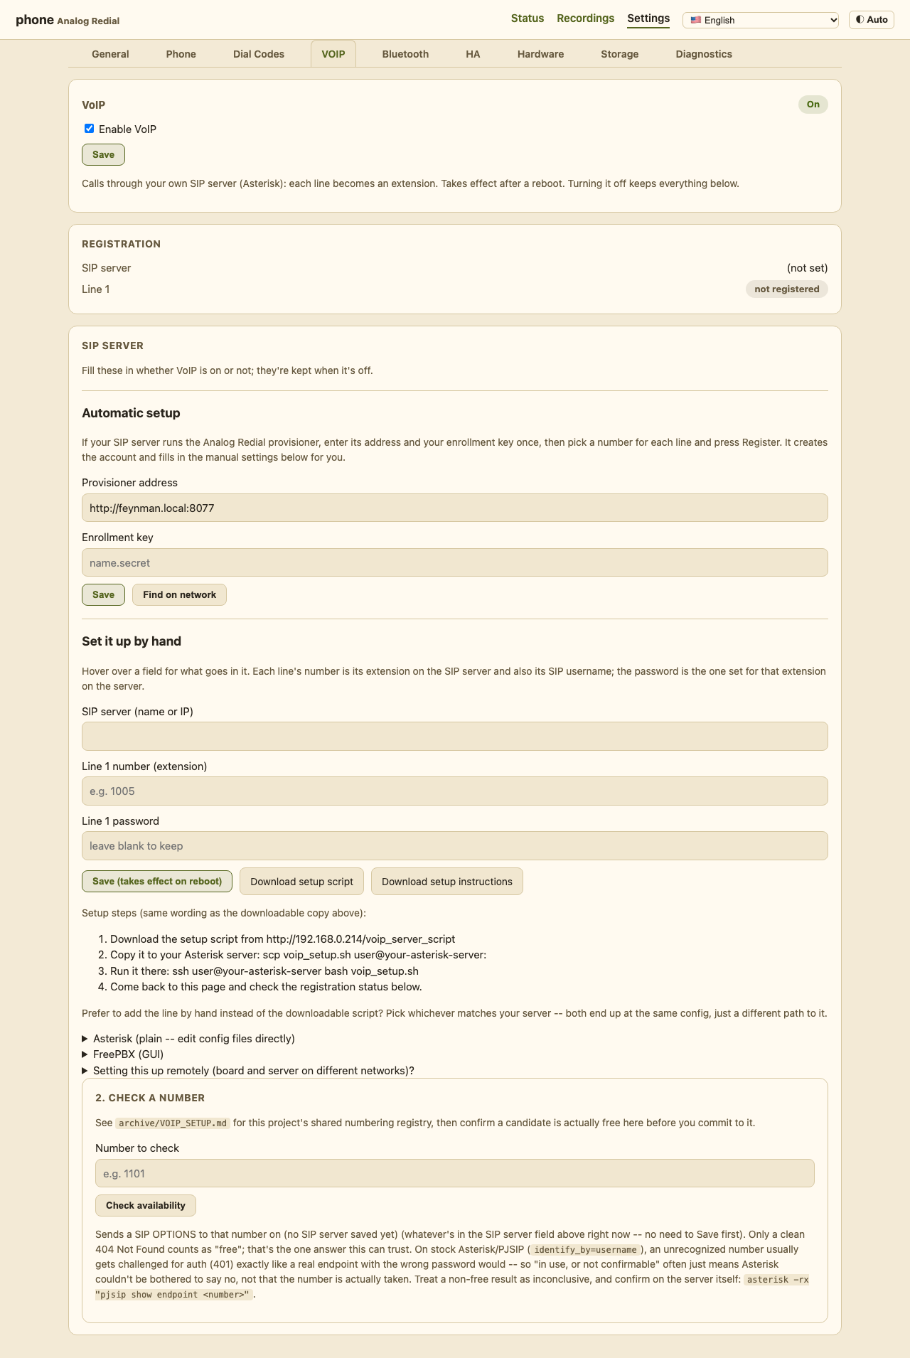
docs/pics/settings-voip-light.png
