sdylewski/Analog-Redial/docs/pics/settings-voip.png

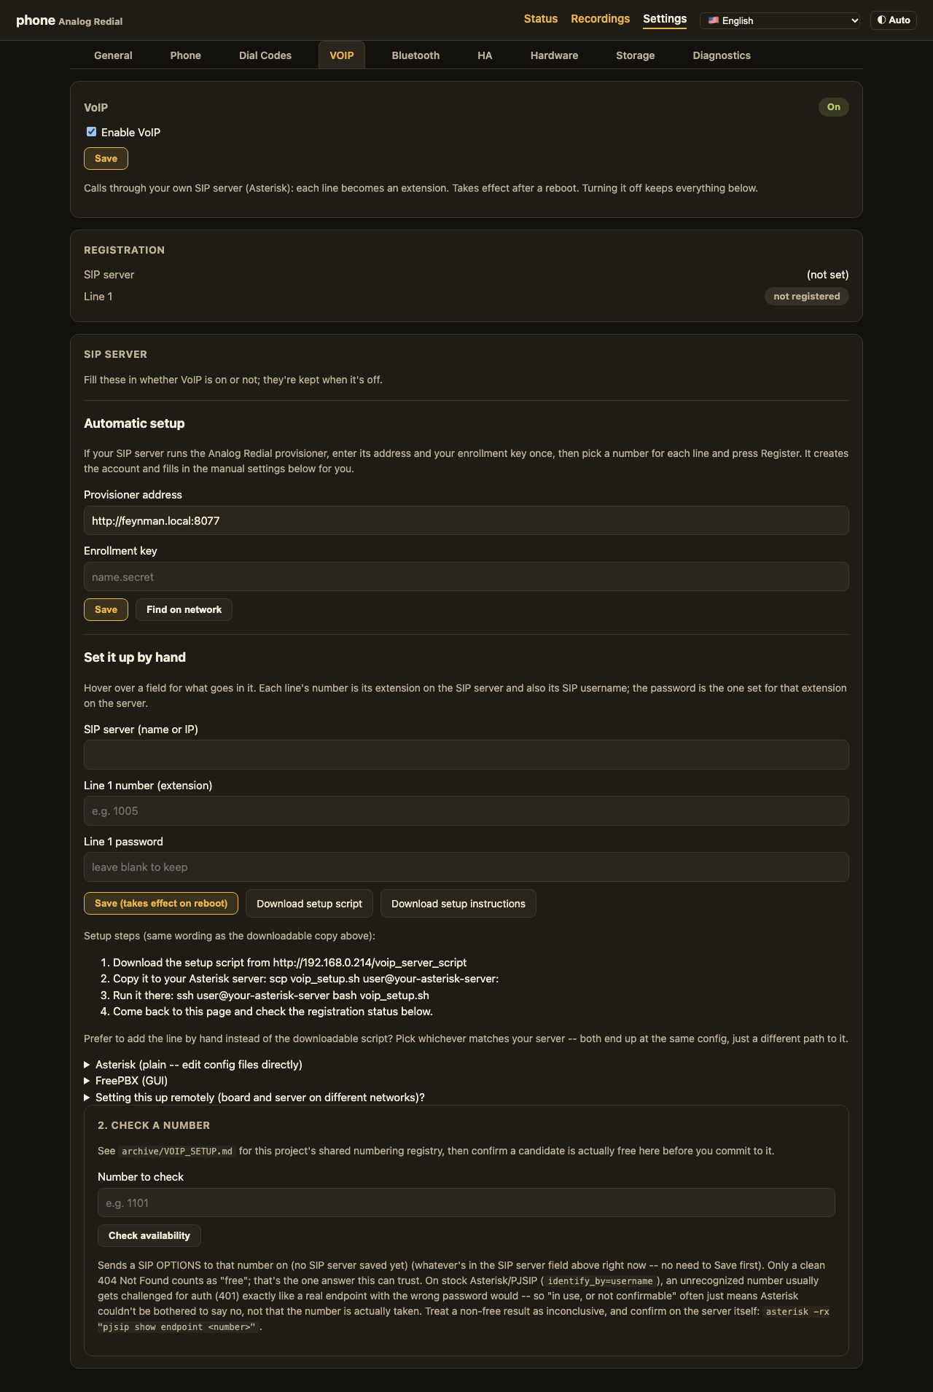
docs/pics/settings-voip.png
