sdylewski/Analog-Redial/docs/pics/smd4_board_annotated.jpg

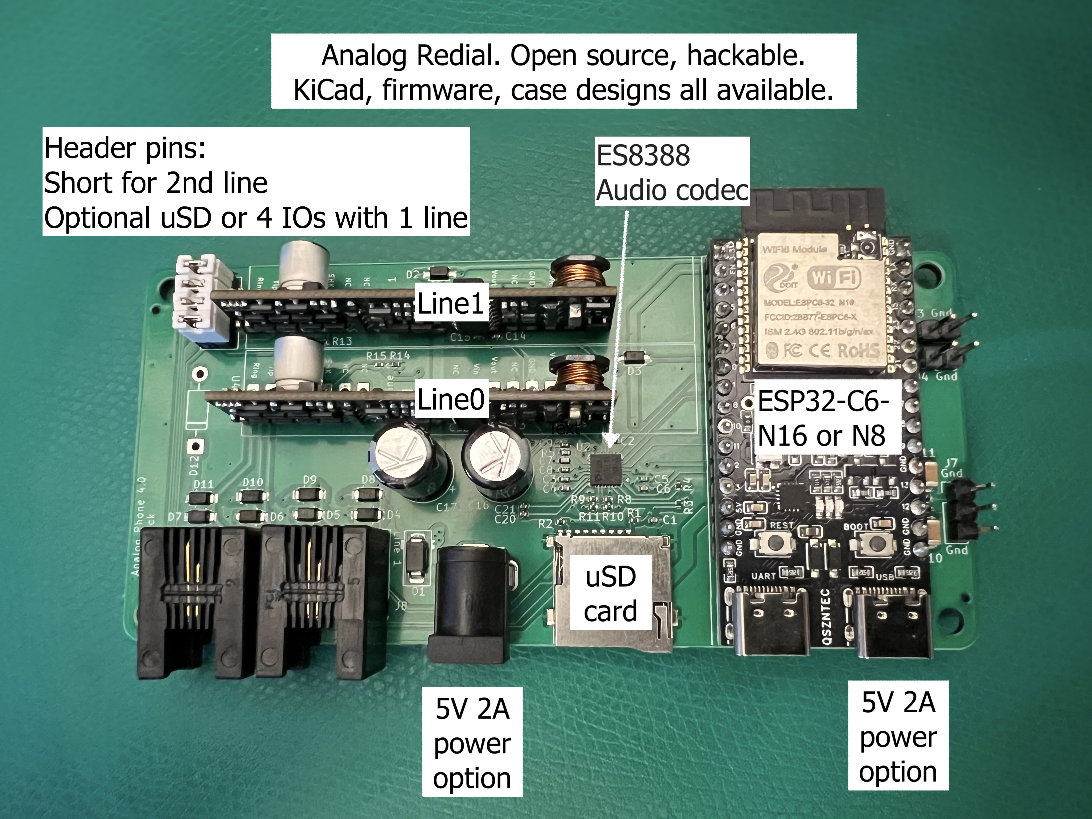
docs/pics/smd4_board_annotated.jpg
