sdylewski/Analog-Redial/docs/pics/smd4_layout_bottom.png

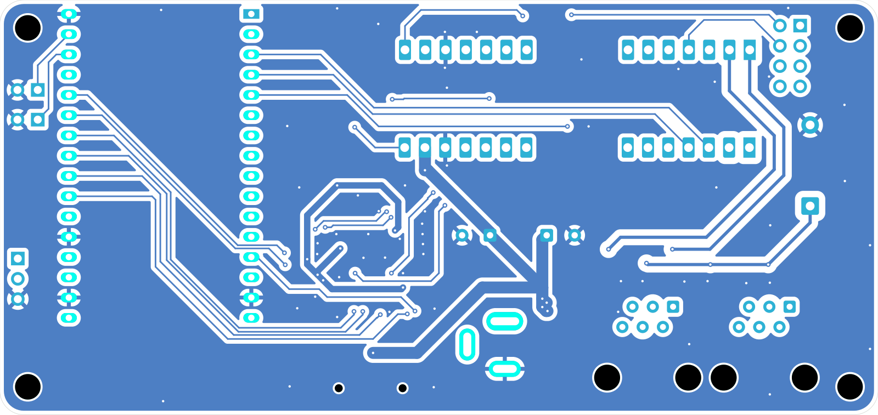
docs/pics/smd4_layout_bottom.png
