sdylewski/Analog-Redial/docs/pics/smd5_layout_bottom.png

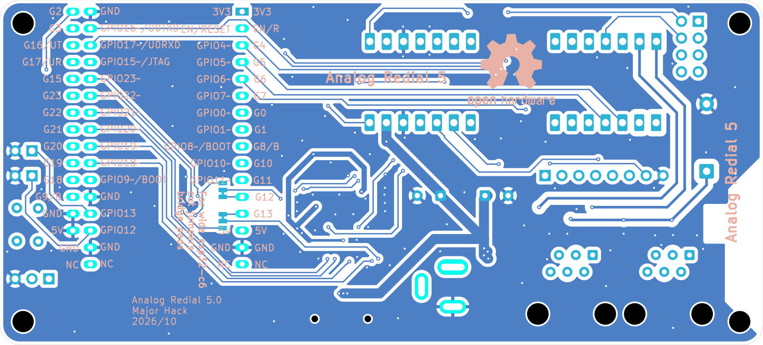
docs/pics/smd5_layout_bottom.png
