sdylewski/Analog-Redial/docs/pics/smd5_layout_top.png

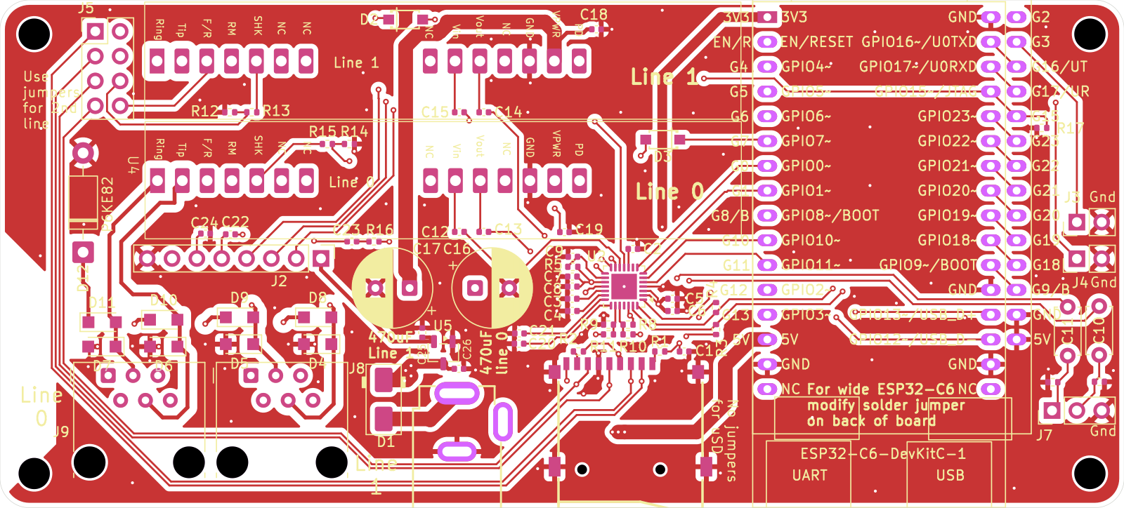
docs/pics/smd5_layout_top.png
