sdylewski/Analog-Redial/docs/pics/status-light.png

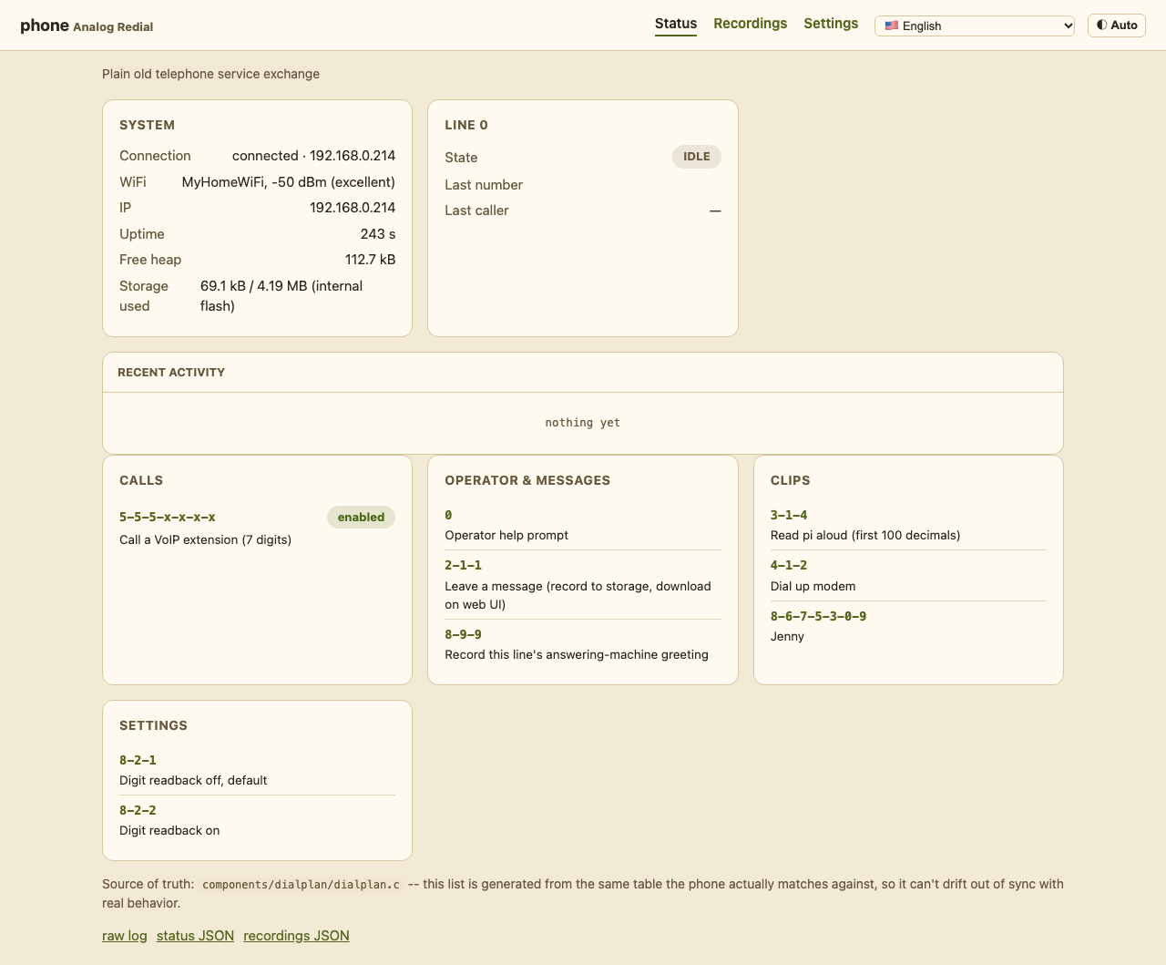
docs/pics/status-light.png
