sdylewski/Analog-Redial/docs/pics/status.png

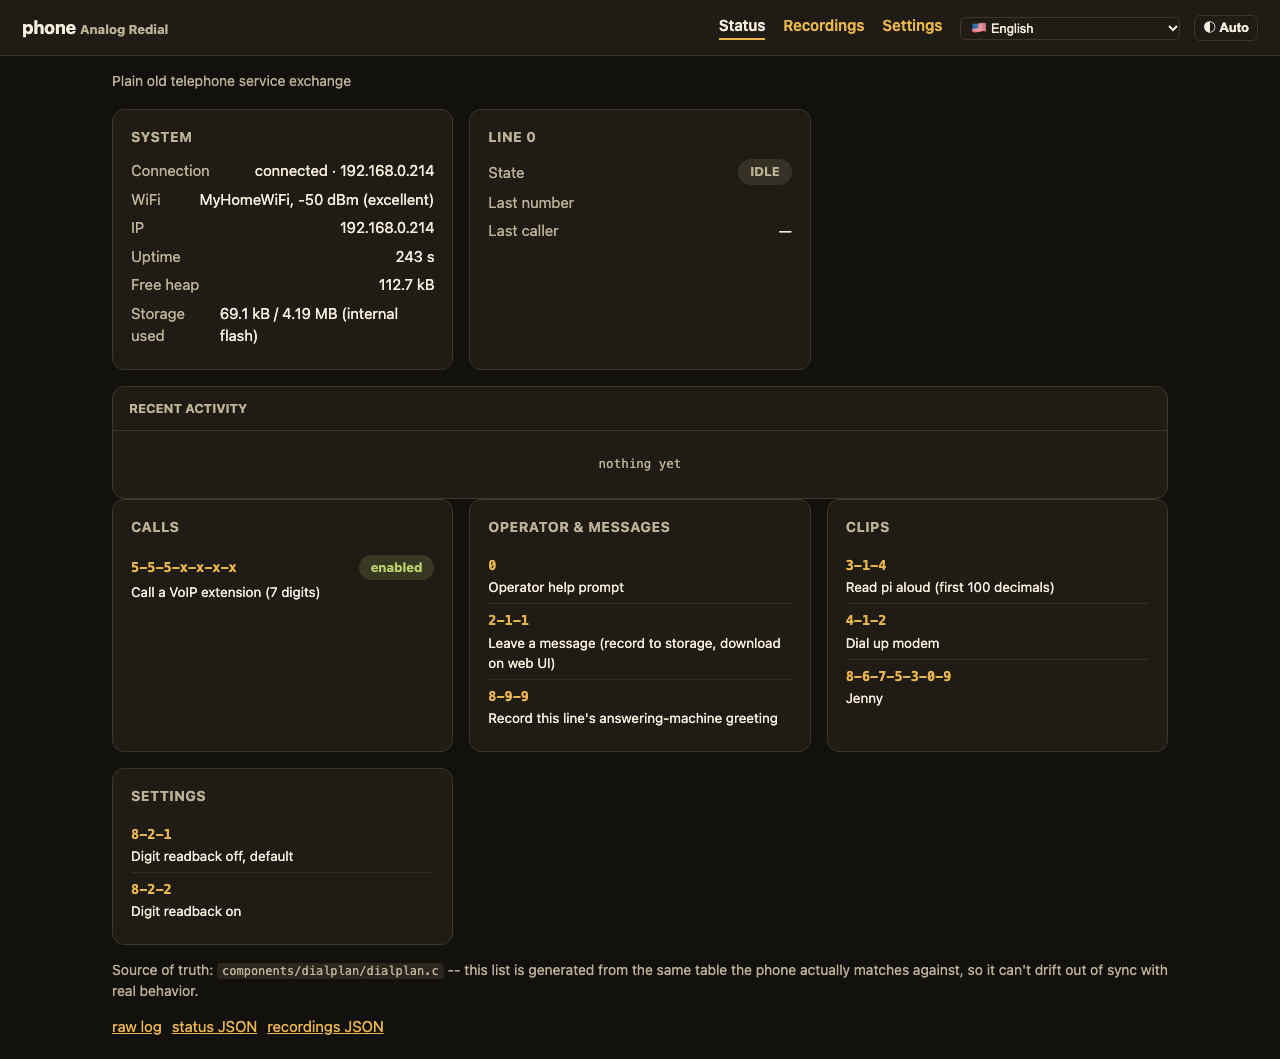
docs/pics/status.png
