sdylewski/Analog-Redial/docs/pics/thumbs/settings-bluetooth-light.png

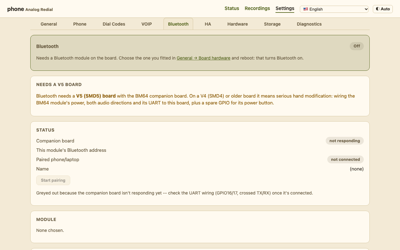
docs/pics/thumbs/settings-bluetooth-light.png
