sdylewski/Analog-Redial/docs/pics/thumbs/settings-bluetooth.png

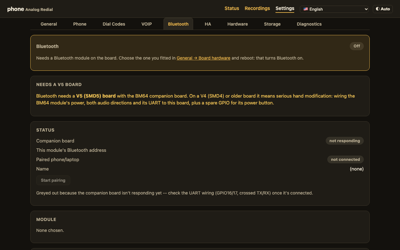
docs/pics/thumbs/settings-bluetooth.png
