sdylewski/Analog-Redial/docs/pics/thumbs/settings-diag-light.png

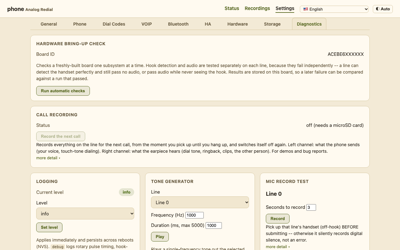
docs/pics/thumbs/settings-diag-light.png
