sdylewski/Analog-Redial/docs/pics/thumbs/settings-dialcodes-light.png

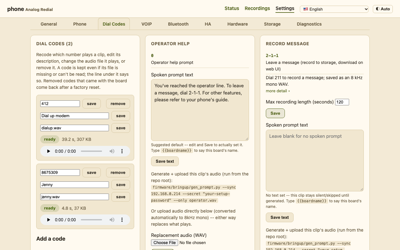
docs/pics/thumbs/settings-dialcodes-light.png
