sdylewski/Analog-Redial/docs/pics/thumbs/settings-general-light.png

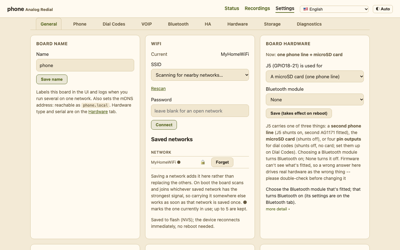
docs/pics/thumbs/settings-general-light.png
