sdylewski/Analog-Redial/docs/pics/thumbs/settings-hardware-light.png

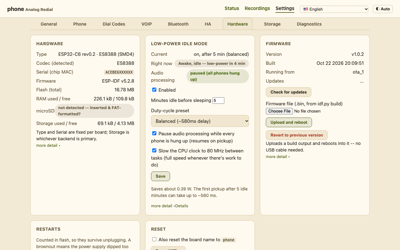
docs/pics/thumbs/settings-hardware-light.png
