sdylewski/Analog-Redial/docs/pics/thumbs/settings-home-light.png

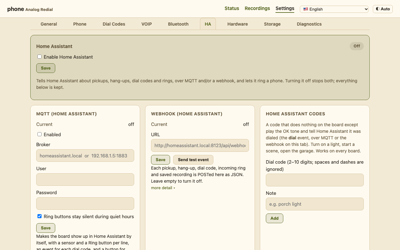
docs/pics/thumbs/settings-home-light.png
