sdylewski/Analog-Redial/docs/pics/thumbs/settings-home.png

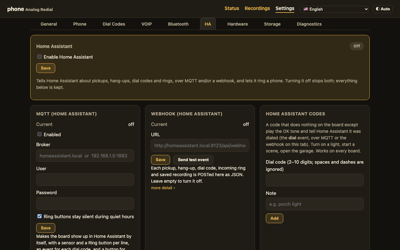
docs/pics/thumbs/settings-home.png
