sdylewski/Analog-Redial/docs/pics/thumbs/settings-phone-light.png

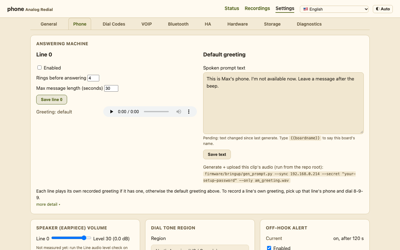
docs/pics/thumbs/settings-phone-light.png
