sdylewski/Analog-Redial/docs/pics/thumbs/settings-storage-light.png

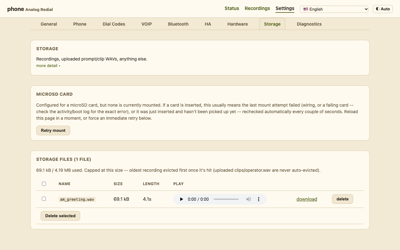
docs/pics/thumbs/settings-storage-light.png
