sdylewski/Analog-Redial/docs/pics/thumbs/settings-voip-light.png

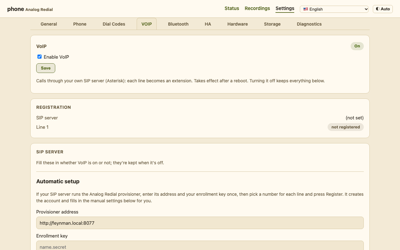
docs/pics/thumbs/settings-voip-light.png
