sdylewski/Analog-Redial/docs/pics/thumbs/status-light.png

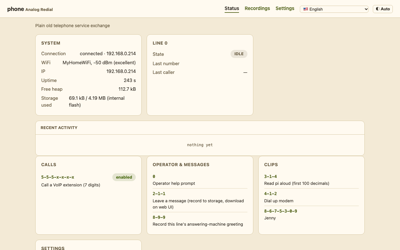
docs/pics/thumbs/status-light.png
