sdylewski/Analog-Redial/docs/pics/v4_case_open.jpg

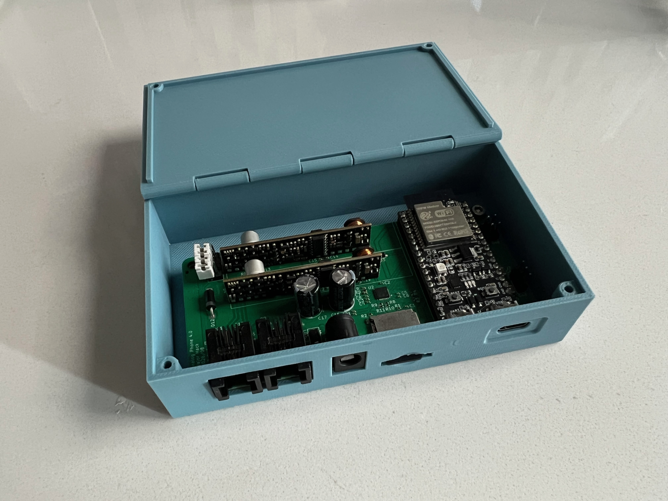
docs/pics/v4_case_open.jpg
