sdylewski/Analog-Redial/docs/pics/V5_board_far.jpg

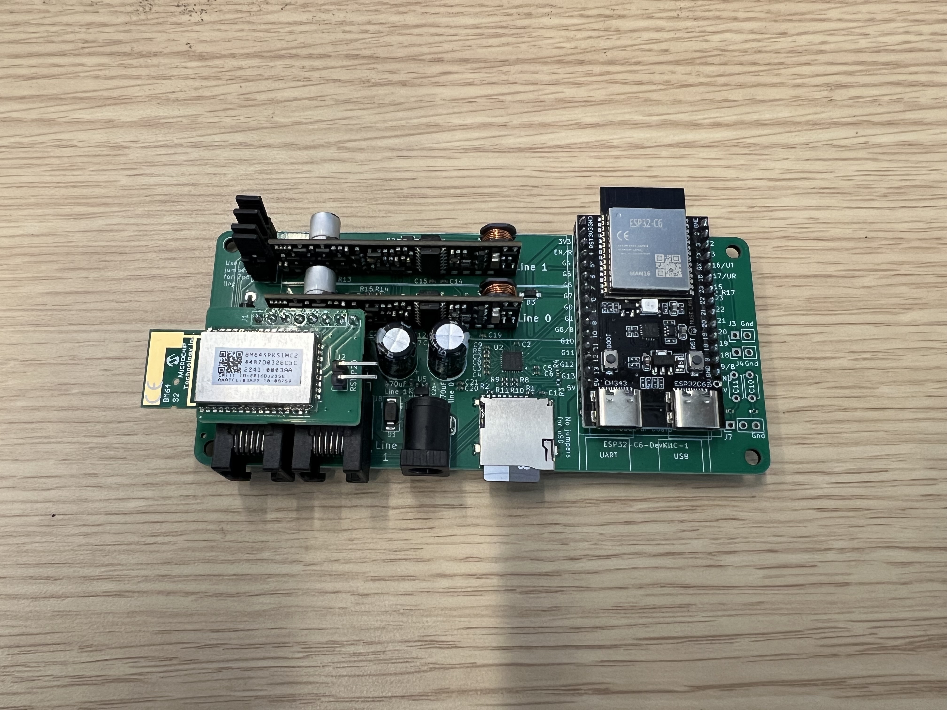
docs/pics/V5_board_far.jpg
