sdylewski/Analog-Redial/docs/pics/v6_board_3d.png

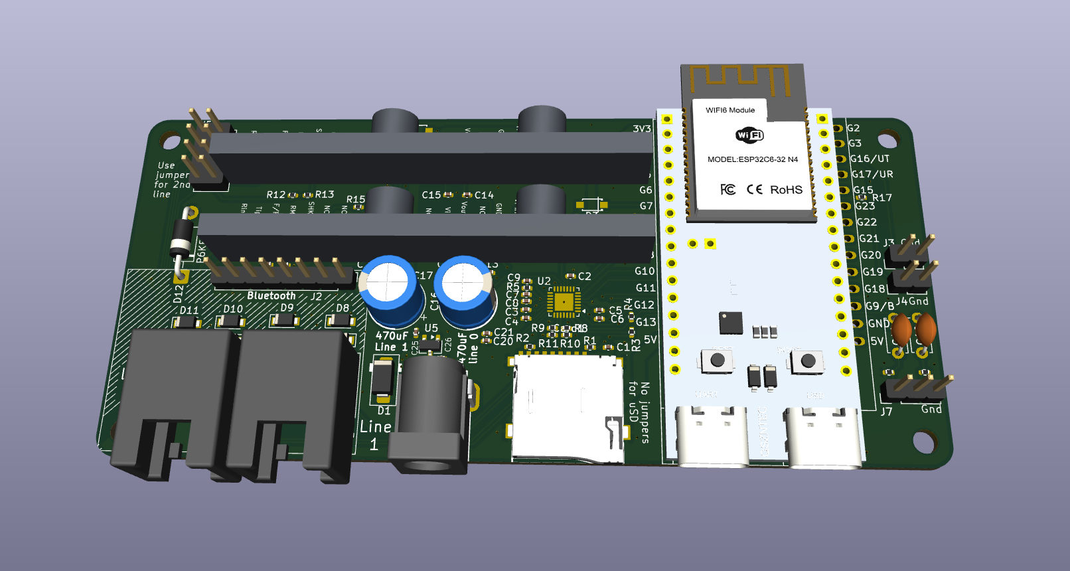
docs/pics/v6_board_3d.png
