sdylewski/Analog-Redial/docs/pics/v6_board_front.png

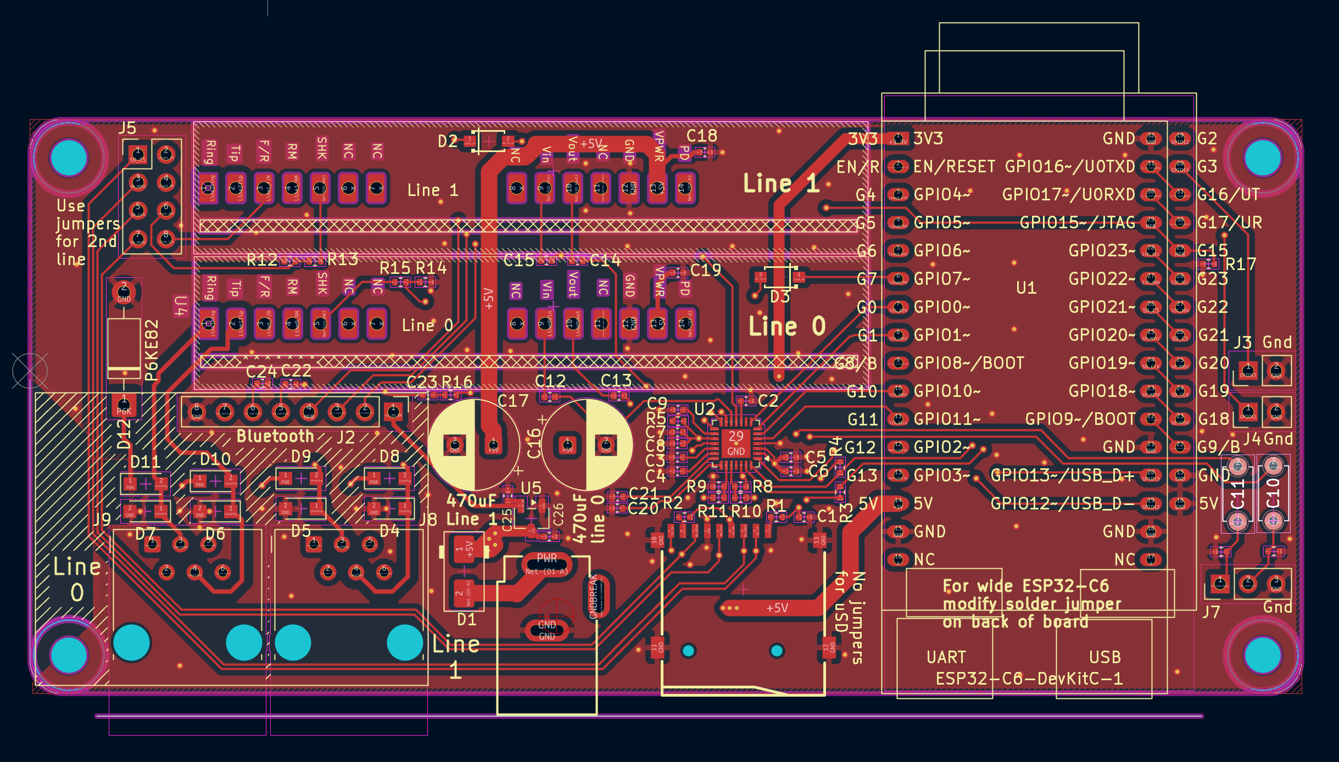
docs/pics/v6_board_front.png
