sdylewski/Analog-Redial/docs/pics/v6_board_rear.png

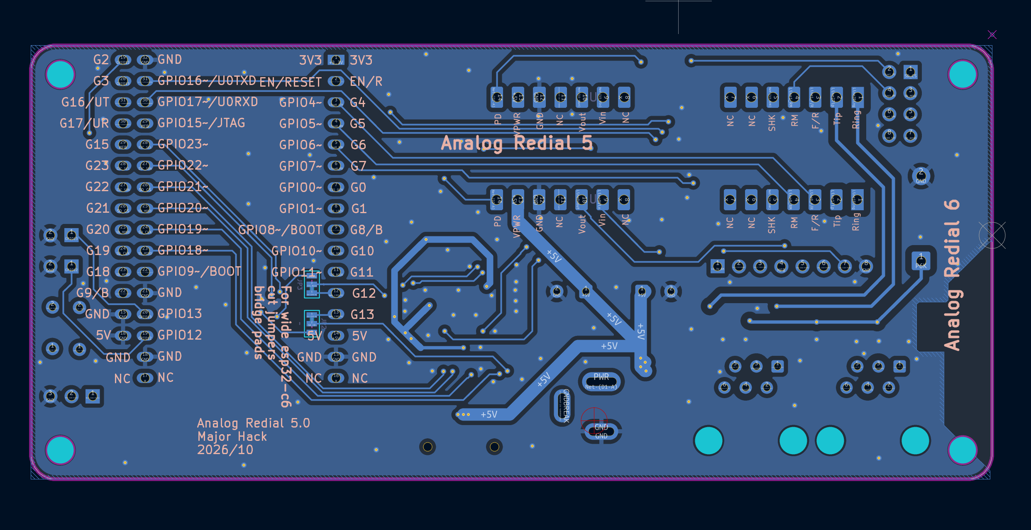
docs/pics/v6_board_rear.png
