sdylewski/Analog-Redial/docs/bom.md

[Home](../README.md) · [1 · Get a board](board.md) · **2 · Parts & assembly** · [3 · Flash & test](flashing.md) · [4 · Set up & use](setup.md)

# 2 · Parts

The parts you solder yourself. The surface-mount parts come already placed
on the board from the fab ([step 1](board.md)). Once you have everything,
continue to [assembly](building.md).

Mark rows done in the leading empty column as you buy them.

Reference designators: **U1** = ESP32-C6-DevKitC-1, **U3**/**U4** = AG1171
SLICs, **J8**/**J9** = their RJ12 jacks, **J1** = DC jack, **J5** =
line-1/microSD jumper header, **Card1** = microSD socket.

---

## Build options

| Build | Lines | microSD | J5 jumpers | Parts |
|---|---|---|---|---|
| **Dual line** | **J9** + **J8** | No | All four pairs bridged | Base board **+ second line** |
| **Single line + microSD** | **J9** only | **Card1** | Open, no shunts | Base board only |
| **Single line + your own gadgets** | **J9** only | No | Open, no shunts | Base board only. **J5** pins 1, 3, 5 and 7 are free for your wires: see below |

**Four spare pins, one job at a time.** The board has four spare pins that
can do one job at a time, and the **J5** jumpers choose which. With the
jumpers **on**, they run the second phone line. With the jumpers **off**,
they read a microSD card if one is in the slot, or they're free for your own
wires (a relay, a light, a buzzer) if not. So it's a second line, or
microSD, or your own gadgets: one of the three.

The firmware checks: put a card in a board set up for two lines and it shuts
line 1 off and shows a warning in the web interface until you remove the
card or switch the board to single-line in Settings → General → Board hardware.

Without microSD, recordings go to internal flash: about 4 MB on a 16 MB module, 1.5 MB on an 8 MB one.

**Your own gadgets.** With the jumpers off and no card in the slot, the four
pins (GPIO18–21) are free on the odd-numbered pins of **J5**:

| J5 pin | GPIO |
|---|---|
| 1 | 21 |
| 3 | 20 |
| 5 | 19 |
| 7 | 18 |

Leave the shunts off (with one in, the pin is wired to line 1's chip), leave
the microSD socket empty, and set J5 to "Pin outputs" in Settings → General →
Board hardware. Then **Settings → Dial Codes → Pin outputs** connects a dial code to
a pin: it goes high for a few seconds, or toggles. The output is **3.3 V**
and only a few mA, so switch a relay or MOSFET with it rather than a load
directly; take ground from any GND on the board.

**Check your relay.** 3.3 V will often switch a 5 V relay *module* (one with
its own transistor or optocoupler), but confirm that yours does:

- A bare relay coil needs a transistor between the pin and the coil.
- Some modules switch on a *low* input, so a "high" pin turns them off.
- The pins float from power-up until the first dial code fires, so if the
  input must stay off in the meantime, add a 10 kΩ resistor from it to
  ground.

---

## Base board: every build · about $19

**Shortcut: [DigiKey parts list for a two-line board](https://www.digikey.com/en/mylists/list/WF3K3HFAQY)**,
ready to add to a cart. For a single-line board, leave out the parts in
*Second phone line*.

DigiKey prices are for quantity 1, checked September 2026, before shipping
(about $5). Generic 2.54 mm headers and M3 hardware aren't priced.

| | Qty | Component | DigiKey | AliExpress | Notes |
|---|-----|---|---|---|---|
| | 1 | **U1** ESP32-C6-DevKitC-1 | [8 MB, 32-pin](https://www.digikey.com/en/products/detail/espressif-systems/ESP32-C6-DEVKITC-1-N8/17728861) $9.00 | [16 MB, 32-pin](https://www.aliexpress.us/item/3256806563223929.html) $7.72 <br> 16 MB 30-pin $4 variant on Ali/Amazon, requires a board mod and 5V DC jack power.  | **16 MB recommended, 8 MB fine.** 8 MB just leaves less room for recordings (see [Flash size](#flash-size-16-mb-or-8-mb)). DigiKey stocks the 8 MB only. Use the **32-pin** module if possible; see [Microcontroller module](#microcontroller-module-32-pin-or-30-pin-clone) |
| | 1 | **U4** AG1171 SLIC (line 0, at **J9**) | [DigiKey](https://www.digikey.com/en/products/detail/silvertel/AG1171/21187236) $8.50 | [AliExpress](https://www.aliexpress.us/item/3256804758849823.html) $3.79 | 14-pin SIL module. DigiKey lead time can be 16 weeks, so buy a spare |
| | 1 | **C16** 470 µF 16 V radial electrolytic | [DigiKey](https://www.digikey.com/en/products/detail/rubycon/16YXJ470M8X11-5/3134104) $0.42 | [AliExpress](https://www.aliexpress.us/item/2255799897996539.html) $1.99 / 20 | Rubycon **16YXJ470M8X11.5**, or any 470 µF ≥16 V that is 8 mm across with 3.5 mm lead spacing |
| | 1 | **J9** RJ12 jack, horizontal, 6p2c | [DigiKey](https://www.digikey.com/en/products/detail/amphenol-cs-fci/87180-062LF/1001369) $1.07 | [AliExpress](https://www.aliexpress.us/item/3256810043215346.html) $3.38 / 10 | Amphenol **87180-062LF**. On AliExpress pick the **322** variant. Alternative: [54601-006](https://www.digikey.com/en/products/detail/amphenol-icc/54601-006/1158894) |
| | 1 | **J5** 2×4 pin header, 2.54 mm | [DigiKey](https://www.digikey.com/en/products/detail/same-sky-formerly-cui-devices/SSK03-MPH-254-B4/28772142) $0.13 | | **SSK03-MPH-254-B4**, or two 1×4 strips cut from any header stock. Fitted on every build |

## Second phone line · +about $10

| | Qty | Component | DigiKey | AliExpress | Notes |
|---|-----|---|---|---|---|
| | 1 | **U3** AG1171 SLIC (line 1, at **J8**) | same as **U4** | same as **U4** | |
| | 1 | **C17** 470 µF 16 V radial | same as **C16** | same as **C16** | |
| | 1 | **J8** RJ12 jack | same as **J9** | same as **J9** | |
| | 4 | **J5** jumper shunts, 2.54 mm | [DigiKey](https://www.digikey.com/en/products/detail/sullins-connector-solutions/QPC02SXGN-RC/2618262) $0.29 / 10 | | **QPC02SXGN-RC**. Bridge all four pairs: 1-2, 3-4, 5-6, 7-8 |

## Optional: DC jack and line protection

| | Qty | Component | DigiKey | AliExpress | Notes |
|---|-----|---|---|---|---|
| | 1 | **J1** DC barrel jack, 5.5 × 2.1 mm | [DigiKey](https://www.digikey.com/en/products/detail/mpd-memory-protection-devices/EJ508A/2439547) $1.25 | [AliExpress](https://www.aliexpress.us/item/3256802445218613.html) $2.70 / 10 | The AliExpress jack is verified to fit. **EJ508A** should, but its pins haven't been checked against the footprint |
| | 1 | **D12** line TVS diode | [DigiKey](https://www.digikey.com/en/products/detail/taiwan-semiconductor-corporation/P6KE82A/1050320) $0.58 | [AliExpress](https://www.aliexpress.us/item/3256809218310441.html) $1.96 / 20 | **P6KE82A**, any maker. Get the **A** version: the plain P6KE82 breaks down too close to ringing voltage. |

### Power: either input, and 2A

USB-C and the DC jack are diode-ORed onto one 5 V rail, so use whichever is
convenient:

- **USB-C** into the DevKit's own port, from a **2A** charger.
- **DC jack**: a **2A**, 5.5 × 2.1 mm, centre-positive, **regulated 5–6 V**
  supply. It loses about 0.4 V through the OR diode, so **5.5–6 V** is better
  than a bare 5 V one.

> ⚠️ **Never use a 9 V or 12 V adapter on the DC jack.** The 5.5 × 2.1 mm jack
> is the same size as those very common adapters, but there is no regulator
> between it and the board: the voltage goes straight to the phone-line chips
> and the 3.3 V regulators (rated about 6 V), and it will destroy them. Check
> the label: **5–6 V DC, centre-positive, regulated**. An unregulated "6 V"
> adapter can read 8 V or more with no load, so avoid those too. If you're not
> sure, power the board from USB-C instead.

2A covers the worst case: two phones ringing at once while the Wi-Fi
transmits. One idle line needs far less, but an undersized supply browns out
mid-ring, which looks exactly like a random reboot.

Fit the DC jack if the board lives somewhere permanent; skip it if it will
always run from a USB charger. 

If using the 30-pin esp32-c6 cheaper variant, you will want the DC jack because the usb-C connection is inset from the edge of the board.

### Is the line TVS worth fitting?

**Recommended.** Normal operation never reaches it (it clamps at 113 V,
above anything the board produces). It protects the SLICs in two realistic
accidents:

- **Someone plugs the board into a real phone line.** The RJ12 jacks look
  exactly like wall jacks, and a live telco line has ring voltage of its own.
- **Surges from outside wiring**: lightning-induced transients and static
  arriving down a long phone cord.

If every phone sits in the same room on a short cord and the jacks can never
reach house wiring, you can leave it off. Otherwise, $0.58 protecting an
$8.50 SLIC is cheap insurance.

## Optional: hacker headers

None of these are needed for any feature. Generic 2.54 mm pin headers.

| Ref | What it is | What it's for |
|-----|---|---|
| **J7** | 1×3 audio monitor output | Mirrors the earpiece audio: scope it, feed a powered speaker, or listen in without picking up. Needs **C10** and **C11** fitted (below) |
| **J3**, **J4** | 1×2 each, signal and GND | **v4:** GPIO16 (J3) and GPIO17 (J4), spare pins for a button, an LED, a relay or a serial port. **v5:** J3 is module pad 20 and J4 pad 19, so what they carry depends on the module. On the genuine 32-pin DevKitC-1 they are GPIO13 (USB D+) and GPIO12 (USB D−), the module's live USB lines: leave them unconnected unless you mean to wire USB there. On a 30-pin clone with JP2/JP3 set for the clone they are GPIO3 (microSD card-detect) and GPIO2 (the codec's MCLK clock): in use, don't connect anything |

**C10/C11, for J7 only:** fit two **1 µF** non-polarized film or ceramic
capacitors in the 5 mm disc footprints. That passes the whole phone band.
To drive headphones directly, use 47 µF electrolytics instead, **+ toward
the codec** (U2) and − toward J7. Left empty, J7 carries no signal.

## Bluetooth board (v5 expansion header, optional)

The v5 board's 8-pin **expansion header** (**J2**; pinout in the [v5 board reference](hardware-smd5.md#9-expansion-header-j2-currently-used-for-the-bluetooth-board)) is currently used for a small board carrying a **BM64** Bluetooth
module (about $14, **working**). The companion's KiCad project is `Bluetooth/BM64/BM64_Board_v1`
in the repository; the main board adds one 3.3 V regulator (**U5**) and a handful of 1 µF capacitors
and resistors that are already on the board.

- **BM64 module:** Microchip `BM64SPKS1MC2-0003AA`, about $14 on
  [DigiKey](https://www.digikey.com/en/products/detail/microchip-technology/BM64SPKS1MC2-0003AA/13252265).
- **Headers:** an 8-pin 2.54 mm female header on the companion, a male one on the main board.
- **One-time setup:** the BM64's audio settings are written to the module by the firmware the first
  time it runs. That needs two thin wires from the companion's 2-pin programming pads to the main
  board's J5 header (the firmware looks for them on GPIO19/20; `bm64_diagpins` in the console tells it
  if they're elsewhere), and the board configured as one line with no microSD. After that the wires come off.
- **Cheaper option:** the DFRobot **DFR0781** (BT401 module), about $3.50 on
  [DigiKey](https://www.digikey.com/en/products/result?keywords=DFR0781) (DigiKey part `1738-DFR0781-ND`)
  or from [AliExpress](https://www.aliexpress.us/item/3256807742050408.html), with call control over a
  simple text command set, wired to the same header. Choose it in Settings → General → Board hardware;
  it needs no setup step. Music, incoming calls and dialing out work on a v5 board, with the module
  hand-wired to the header. An [adapter board](https://github.com/sdylewski/Analog-Redial/tree/main/Bluetooth/DFR0781_BT401/DFR0781_BT401_board_v1) that plugs into the
  header like the BM64 carrier is designed and ready to order, but not yet built or tested. Its parts are
  through-hole: the module, an 8-pin female header, a 1 uF ceramic capacitor, an optional status LED with
  a 1 kohm resistor, and an optional 6-pin header (USB, reset and the right audio channel).
  On AliExpress, choose the **"DAC output"** version: this board takes the module's analog audio output,
  so another version won't work.

---

## Microcontroller module: 32-pin or 30-pin clone

The v5 board also takes a cheap 30-pin clone. They aren't equivalent:

> ⚠️ **v5 boards with the 30-pin clone module: read before soldering.** On a v5 board the clone's
> **bottom-right 5V pin** is wired to **GND** (the footprint is wrong for the clone's pinout). If you fit a
> clone, **take that pin out**: cut it off the module, or leave it unsoldered, so it doesn't connect to the
> board at all. The **bottom-left 5V pin** is then the module's only 5 V connection, and it is enough. Left
> in, the pin shorts the 5 V rail to ground. With the power off, check with a meter that the 5 V pin has no
> continuity to ground. The genuine 32-pin DevKitC-1 is not affected. **v5.1** (and v6) have the footprint
> fixed, so nothing needs removing there.

| | **32-pin (recommended)** | **30-pin clone (v5 only)** |
|----|----|----|
| Part | Genuine ESP32-C6-DevKitC-1 | AliExpress clone, about $4 |
| Fitting | Drops straight in | Move two solder jumpers on back of board, **JP2** and **JP3** |
| USB flashing and console | Works | Works once the jumpers are set |
| Status | Known good | Works; on a v5 board remove one pin first (see the warning above); v5.1 needs nothing |

<table>
  <tr>
    <td width="50%">The Analog Redial v5 board: solder jumpers for the 30-pin clone module</td>
    <td width="50%">(photo coming soon)</td>
  </tr>
  <tr>
    <td align="center">v5 board: modification needed for the cheap 30-pin esp32-c6-devkit</td>
    <td align="center">add photo of finished rework</td>
  </tr>
</table>

Use the genuine module unless you're happy to debug. Details in the
[v5 board reference](hardware-smd5.md#10-mcu-module-variants).

## Flash size: 16 MB or 8 MB

The firmware fits either. What changes is room for recordings on a board
without a microSD card:

| | 16 MB | 8 MB |
|---|---|---|
| Two firmware-update slots | 3.5 MB each | 2.25 MB each |
| Built-in audio | 1.5 MB | 1 MB |
| Recordings, prompts, greetings | 7.375 MB (about 6.9 MB usable) | 2.375 MB (about 2.1 MB usable) |

Nothing to choose by hand: the flashing script reads the flash size off the
chip and builds the right image ([step 3](flashing.md)).

---

**Next: [Assembly](building.md)**
