sdylewski/Analog-Redial/PayPhone/Payphone_coin_board_v1/jlcpcb/production_files/BOM-Payphone_coin_board_v1.csv

Comment | Designator | Footprint | LCSC | Quantity
1.5k | R34,R35,R36,R37,R38,R39,R51 | R_0805_2012Metric | C4310 | 7
100R | R40,R41,R54 | R_0805_2012Metric | C17408 | 3
100R 1206 | R12 | R_1206_3216Metric | C17901 | 1
100k | R2,R3,R55 | R_0805_2012Metric | C149504 | 3
100k 1206 | Rfbt1,Rfbt2,Rfbt3 | R_1206_3216Metric | C17900 | 3
100nF | C16,C17,C18,C19,C2,C24,C25,C26,C27,C28,C3,C4,C6 | C_0805_2012Metric | C28233 | 13
100nF 50V 1206 | C21,C22,C23 | C_1206_3216Metric | C24497 | 3
100pF | Cp1 | C_0805_2012Metric | C1790 | 1
100uH SMDRI127-101MT | L1 | L_SXN_SMDRI127 | C10150 | 1
10R | R26 | R_1206_3216Metric | C17903 | 1
10k | R1,R14,R23,R25,R4,R49,R5,R52,R53,R6 | R_0805_2012Metric | C17414 | 10
12k | R18 | R_0805_2012Metric | C17444 | 1
150k | R13,R17 | R_0805_2012Metric | C17470 | 2
15k | Rfbb4 | R_0805_2012Metric | C17475 | 1
1M | Rz1 | R_0805_2012Metric | C17514 | 1
1M 1206 | R32,R57,R58,R59 | R_1206_3216Metric | C17927 | 4
1N4148W | D4 | D_SOD-123 | C81598 | 1
1R | R11,R45,R46 | R_1206_3216Metric | C17928 | 3
1SMA4744A (15V 1W) | Dz1 | D_SMA | C19077482 | 1
1k | R20,R21,R24,R44,R50,R56,R7,R8,R9 | R_0805_2012Metric | C17513 | 9
1nF | C8 | C_0805_2012Metric | C46653 | 1
2.2R | Rcs1 | R_0805_2012Metric | C17521 | 1
2.2nF | Ct1 | C_0805_2012Metric | C28260 | 1
220uH SMDRI127-221MT | L2 | L_SXN_SMDRI127 | C10151 | 1
22k | Rfbb1 | R_0805_2012Metric | C17560 | 1
27k | R19,R33 | R_0805_2012Metric | C17593 | 2
2N7002 | Q1,Q4 | SOT-23 | C8545 | 2
30k | Rfbb2 | R_0805_2012Metric | C17621 | 1
33k | R27,R28 | R_0805_2012Metric_Pad1.20x1.40mm_HandSolder | C17633 | 2
4.7k | R22 | R_0805_2012Metric | C17673 | 1
470pF | Cf1 | C_0805_2012Metric | C1743 | 1
B5819W | D16,D17,D18,D19 | D_SOD-123 | C8598 | 4
BZT52C12 | D6 | D_SOD-123 | C19077410 | 1
BZT52C22 | D5 | D_SOD-123 | C22375295 | 1
ES2D | D14,D2 | D_SMA | C18199161 | 2
LED red | D7 | LED_0805_2012Metric | C84256 | 1
MC34063ADR2G | U2 | SOIC-8_3.9x4.9mm_P1.27mm | C32078 | 1
MMBT3904 | Q2 | SOT-23 | C20526 | 1
MMBT3906 | Q5 | SOT-23 | C7420354 | 1
SS34 | D1 | D_SMA | C8678 | 1
STN4NF20L | Q3,Q6 | SOT-223-3_TabPin2 | C7603336 | 2
TCA9534APWR | U1 | TSSOP-16_4.4x5mm_P0.65mm | C206010 | 1
green | D10,D11,D12,D13,D15,D8,D9 | LED_0805_2012Metric | C2297 | 7
