sdylewski/Analog-Redial/hardware/kicad/Analog Redial v6/jlcpcb/production_files/BOM-Analog Redial v6.csv

Comment | Designator | Footprint | LCSC | Quantity
100k | R12,R14,R17 | R_0402_1005Metric | C25741 | 3
100nF | C1,C13,C14,C18,C19,C20,C21,C27,C5,C6,C8,C9 | C_0402_1005Metric | C1525 | 12
10R | R5 | R_0402_1005Metric | C25077 | 1
10k | R1,R10,R11,R13,R15,R18,R19,R2,R21,R8,R9 | R_0402_1005Metric | C25744 | 11
10nF | C12,C15 | C_0402_1005Metric | C15195 | 2
10uF | C7 | C_0402_1005Metric | C15525 | 1
1N4148 | D2,D3 | 1N4148W_C81598 | C81598 | 2
1k | R16 | R_0402_1005Metric | C11702 | 1
1uF | C2,C22,C23,C24,C25,C26,C3,C4 | C_0402_1005Metric | C52923 | 8
1uF 50V | C28 | C_1206_3216Metric | C1848 | 1
39k | R20 | R_0402_1005Metric | C25783 | 1
4.7k | R3,R4 | R_0402_1005Metric | C25900 | 2
47k | R6,R7 | R_0402_1005Metric | C25792 | 2
ES8388 | U2 | QFN-28-1EP_4x4mm_P0.45mm_EP2.6x2.6mm | C365736 | 1
SM4007PL | D10,D11,D4,D5,D6,D7,D8,D9 | Nexperia_CFP3_SOD-123W | C64898 | 8
SMAJ22A | D13 | D_SMA | C41376403 | 1
SS34 | D1 | D_SMA | C8678 | 1
TCA9534APWR | U6 | TSSOP-16_4.4x5mm_P0.65mm | C206010 | 1
TF-01A | Card1 | TF-01A | C91145 | 1
WS3222D-8/TR | U7 | WS3222D_WDFN-8_2x2mm_P0.5mm | C239703 | 1
XC6206P332MR | U5 | SOT-23-3 | C5446 | 1
