sdylewski/Analog-Redial/Bluetooth/BM64/BM64_Board_v1/jlcpcb/production_files/BOM-Bluetooth_board.csv

Comment | Designator | Footprint | LCSC | Quantity
BM64SPKS1MC2-0003AA | U5 | BM64_MCH |  | 1
PINHD_1x8_Female | J1 | PinSocket_1x08_P2.54mm_Vertical |  | 1
PINHD_1x4_Male | J2 | PinHeader_1x02_P2.54mm_Vertical |  | 1
