sdylewski/Analog-Redial/Bluetooth/DFR0781_BT401/DFR0781_BT401_board_v1/jlcpcb/production_files/BOM-DFR0781_BT401_board_v1.csv

Comment | Designator | Footprint | LCSC | Quantity
PINHD_1x8_Female | J1 | PinSocket_1x08_P2.54mm_Vertical |  | 1
~ | U1 | DFR0781_BT401_new |  | 1
1k | R1 | R_Axial_DIN0207_L6.3mm_D2.5mm_P10.16mm_Horizontal |  | 1
1uF 105_Ceramic | C1 | C_Disc_D5.0mm_W2.5mm_P2.50mm |  | 1
LED_5mm | D1 | LED_D5.0mm |  | 1
PINHD_1x6_Male | J2 | PinHeader_1x06_P2.54mm_Vertical |  | 1
