sdylewski/Analog-Redial/hardware/kicad/Analog Redial v6/pcbway_production/2026-10-05-18-57-52/Analog Redial v6.kicad_pcb_bom.csv

Designator | Quantity | Value | Footprint | Package | MPN | DNP | Mount_Type | Description | PROD_ID | Voltage | Tolerance | LCSC | KiLib_Generator | Manufacturer | Manufacturer Part | Sim.Device | Sim.Pins
C1, C13, C14, C18, C19, C20, C21, C5, C6, C8, C9 | 11 | 100nF | C_0402_1005Metric |  |  |  | smt | Unpolarized capacitor | CAP-00000 | 1kV | 100% | C1525
C12, C15 | 2 | 10nF | C_0402_1005Metric |  |  |  | smt | Unpolarized capacitor |  |  |  | C15195
C2, C22, C23, C24, C25, C26, C3, C4 | 8 | 1uF | C_0402_1005Metric |  |  |  | smt | Unpolarized capacitor | CAP-00000 | 1kV | 100% | C52923 | SMD_2terminal_chip_molded
C7 | 1 | 10uF | C_0402_1005Metric |  |  |  | smt | Unpolarized capacitor | CAP-00000 | 1kV | 100% | C15525
Card1 | 1 | TF-01A | TF-01A |  |  |  | smt | 1.85mm Connector and Ejector MicroSD Card (TF Card) Push-Push With Locating Pins SMD SD Card / Memory Card Connector ROHS |  |  |  | C91145 |  | Korean Hroparts Elec | TF-01A
D1 | 1 | SS14 | D_SMA |  |  |  | smt | SMA Schottky diode, 40V, 1A, Alternate KiCAD Library |  |  |  | C2480
D10, D11, D4, D5, D6, D7, D8, D9 | 8 | SM4007PL | Nexperia_CFP3_SOD-123W |  |  |  | smt | DO-41 Diode, Rectifier, 1000V, 1A, Alternate KiCad Library |  |  |  | C64898
D2, D3 | 2 | 1N4148 | 1N4148W_C81598 |  |  |  | smt | 150mA 1A 1V@50mA 1uA@75V 400mW 4ns 75V Independent SOD-123 Switching Diodes ROHS |  |  |  | C81598 |  | ST(Semtech) | 1N4148W | D | 1=K 2=A
H1, H2, H3, H4 | 4 | MountingHole_M3 | MountingHole_3.2mm_M3 |  |  |  | tht | 3.2mm Diameter Mounting Hole (M3)
J2 | 1 | PINHD_1x8_Male | PinHeader_1x08_P2.54mm_Vertical |  |  |  | tht | Pin Header male with pin space 2.54mm. Pin Count -8 |  |  |  |  | connector/pin_header_socket
R1, R10, R11, R13, R15, R2, R8, R9 | 8 | 10k | R_0402_1005Metric |  |  |  | smt | Resistor | RES-07856 |  |  | C25744
R12, R14, R17 | 3 | 100k | R_0402_1005Metric |  |  |  | smt | Resistor | RES-07856 |  |  | C25741 | SMD_2terminal_chip_molded
R16 | 1 | 1k | R_0402_1005Metric |  |  |  | smt | Resistor | RES-07856 |  |  | C11702 | SMD_2terminal_chip_molded
R3, R4 | 2 | 4.7k | R_0402_1005Metric |  |  |  | smt | Resistor | RES-07856 |  |  | C25900
R5 | 1 | 10R | R_0402_1005Metric |  |  |  | smt | Resistor | RES-07856 |  |  | C25077
R6, R7 | 2 | 47k | R_0402_1005Metric |  |  |  | smt | Resistor | RES-07856 |  |  | C25792
U2 | 1 | ES8388 | QFN-28-1EP_4x4mm_P0.45mm_EP2.6x2.6mm |  |  |  | smt | Low Power Stereo Audio CODEC With Headphone Amplifier, 24-bit, 8kHz - 96kHz ADC / DAC sampling frequency, 1.8V - 3.3V supply, WQFN-28 |  |  |  | C365736
U5 | 1 | XC6206PxxxMR | SOT-23-3 |  |  |  | smt | Positive 60-250mA Low Dropout Regulator, Fixed Output, SOT-23 |  |  |  | C5446 | package/gullwing
