sdylewski/Analog-Redial/hardware/2026-07-02T230626.csv

Index | Quantity | Part Number | Manufacturer Part Number | Description | Customer Reference | Available | Backorder | Unit Price | Extended Price USD
1 | 10 | 609-1055-ND | 87180-062LF | CONN MOD JACK 6P2C R/A UNSHLD |  | 10 | 0 | 0.83300 | 8.33
2 | 2 | 5061-AG1171-ND | AG1171 | LOW COST RINGING SLIC WITH DC-DC |  | 2 | 0 | 8.50000 | 17.00
3 | 10 | 1189-1146-ND | 16YXJ470M8X11.5 | CAP ALUM 470UF 20% 16V RADIAL TH |  | 10 | 0 | 0.23800 | 2.38
4 | 10 | AP2112K-3.3TRG1DICT-ND | AP2112K-3.3TRG1 | IC REG LINEAR 3.3V 600MA SOT-25 |  | 10 | 0 | 0.17100 | 1.71
5 | 3 | MCP1700T1802ETTCT-ND | MCP1700T-1802E/TT | IC REG LINEAR 1.8V 200MA SOT23-3 |  | 3 | 0 | 0.51000 | 1.53
6 | 10 | 5399-BC846ACT-ND | BC846A | 65V 110@2MA,5V 200MW 100MA NPN S |  | 10 | 0 | 0.04900 | 0.49
7 | 25 | CF14JT15K0CT-ND | CF14JT15K0 | RES 15K OHM 5% 1/4W AXIAL |  | 25 | 0 | 0.02280 | 0.57
8 | 25 | CF14JT4K70CT-ND | CF14JT4K70 | RES 4.7K OHM 5% 1/4W AXIAL |  | 25 | 0 | 0.02280 | 0.57
