sdylewski/Analog-Redial/docs/assets/parts/png/bluetooth-adapter-below.png

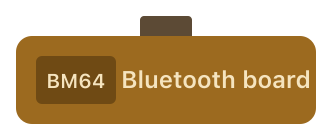
docs/assets/parts/png/bluetooth-adapter-below.png
