sdylewski/Analog-Redial/docs/assets/parts/png/bluetooth-adapter-side.png

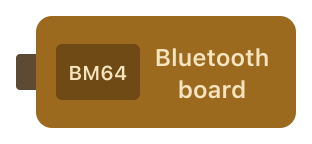
docs/assets/parts/png/bluetooth-adapter-side.png
