sdylewski/Analog-Redial/docs/assets/parts/png/bluetooth-adapter.png

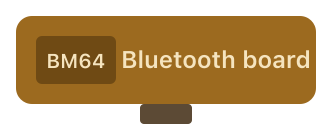
docs/assets/parts/png/bluetooth-adapter.png
