sdylewski/Analog-Redial/docs/assets/parts/png/board-core-down.png

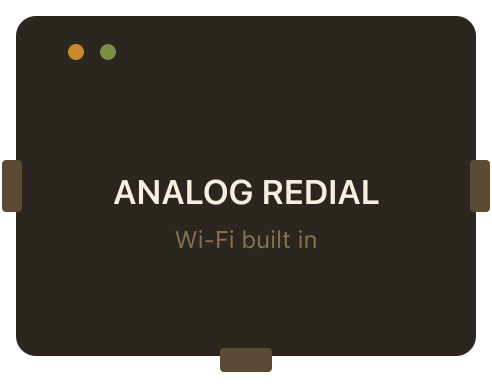
docs/assets/parts/png/board-core-down.png
