sdylewski/Analog-Redial/docs/assets/parts/png/board-core.png

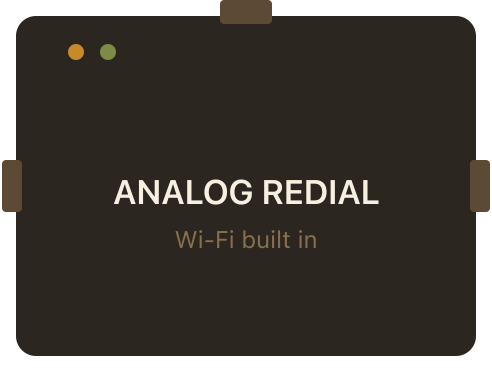
docs/assets/parts/png/board-core.png
