sdylewski/Analog-Redial/docs/assets/parts/png/browser.png

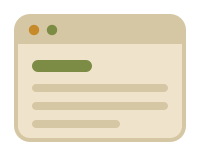
docs/assets/parts/png/browser.png
