sdylewski/Analog-Redial/docs/assets/parts/png/cell-phone.png

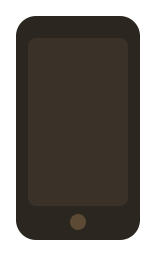
docs/assets/parts/png/cell-phone.png
