sdylewski/Analog-Redial/docs/assets/parts/png/cellular.png

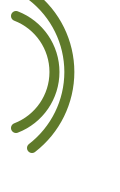
docs/assets/parts/png/cellular.png
