sdylewski/Analog-Redial/docs/assets/parts/png/home.png

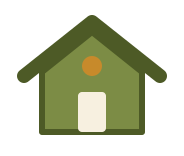
docs/assets/parts/png/home.png
