sdylewski/Analog-Redial/docs/assets/parts/png/j5-jumpers-off-card.png

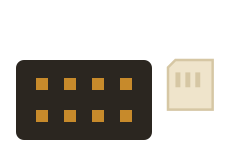
docs/assets/parts/png/j5-jumpers-off-card.png
