sdylewski/Analog-Redial/docs/assets/parts/png/j5-jumpers-off-wires.png

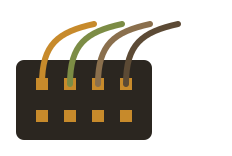
docs/assets/parts/png/j5-jumpers-off-wires.png
