sdylewski/Analog-Redial/docs/assets/parts/png/j5-jumpers-on.png

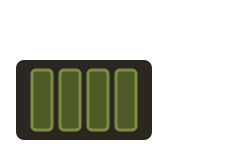
docs/assets/parts/png/j5-jumpers-on.png
