sdylewski/Analog-Redial/docs/assets/parts/png/phone.png

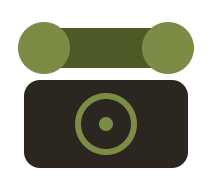
docs/assets/parts/png/phone.png
