sdylewski/Analog-Redial/docs/assets/parts/png/pin-outputs.png

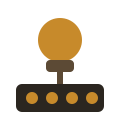
docs/assets/parts/png/pin-outputs.png
