sdylewski/Analog-Redial/docs/assets/parts/png/redial-board.png

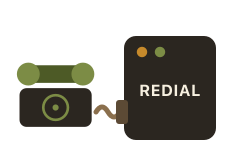
docs/assets/parts/png/redial-board.png
