sdylewski/Analog-Redial/docs/assets/parts/png/server.png

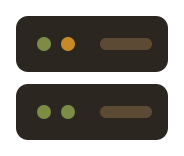
docs/assets/parts/png/server.png
