sdylewski/Analog-Redial/hardware/3d-printed-case/Analog Redial v4/AnalogRedial-4 - Box-SingleLine.step

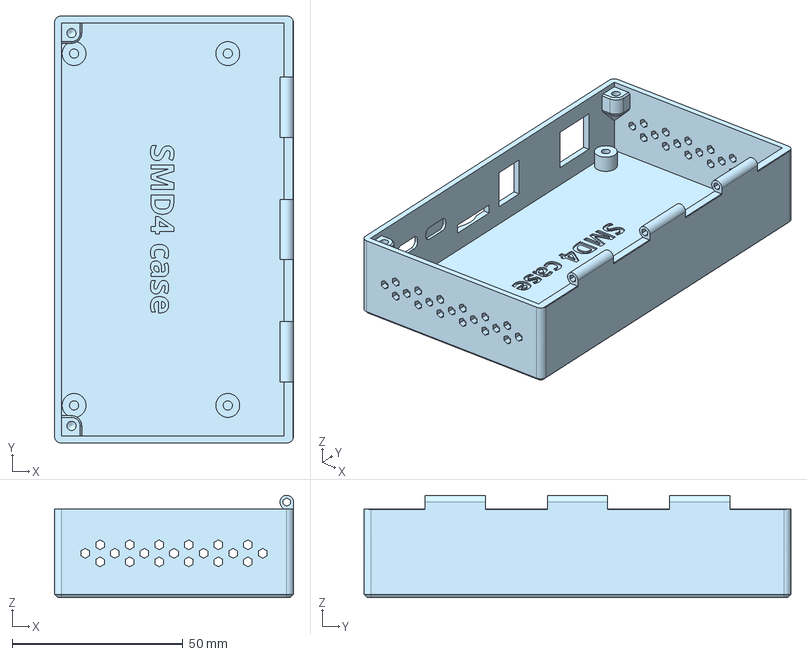
[picture p88: CAD file, 2026-10-08]
hardware/3d-printed-case/Analog Redial v4/AnalogRedial-4 - Box-SingleLine.step
70.0 x 125.0 x 30.0 mm
