sdylewski/Analog-Redial/hardware/3d-printed-case/Analog Redial v4/AnalogRedial-4 - Lid.step

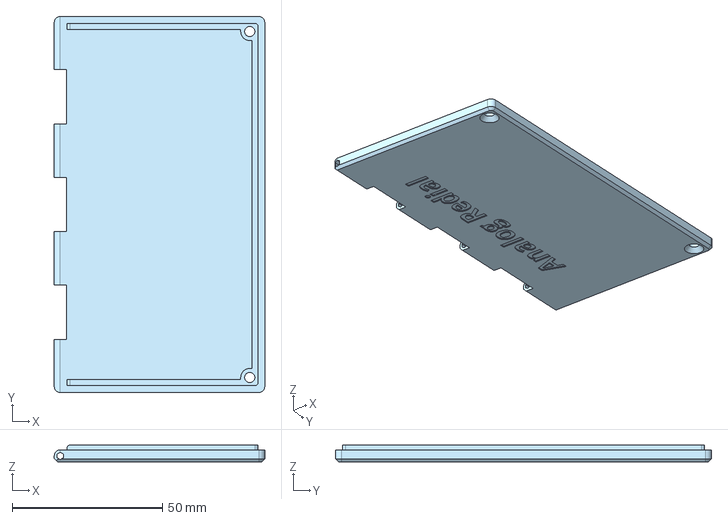
[picture p89: CAD file, 2026-10-08]
hardware/3d-printed-case/Analog Redial v4/AnalogRedial-4 - Lid.step
70.0 x 125.0 x 5.60 mm
