sdylewski/Analog-Redial/hardware/3d-printed-case/Analog Redial v2/AnalogPhone SMD2 - SingleLine - Case.step

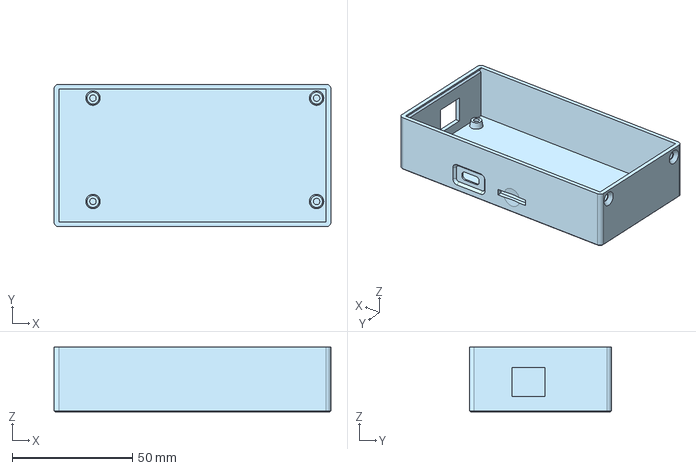
[picture p90: CAD file, 2026-10-08, an earlier design]
hardware/3d-printed-case/Analog Redial v2/AnalogPhone SMD2 - SingleLine - Case.step
115.2 x 59.2 x 27.0 mm
