sdylewski/Analog-Redial/hardware/3d-printed-case/Analog Redial v2/AnalogPhone SMD2 - SingleLine - Lid.step

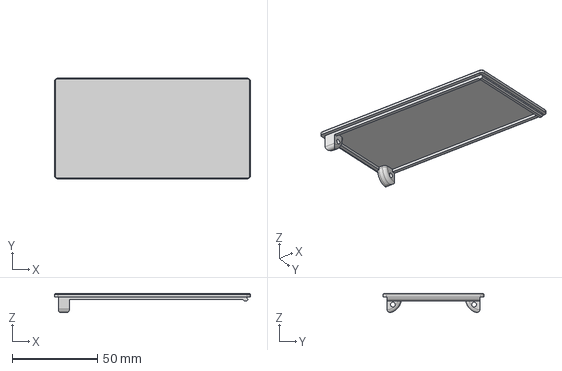
[picture p91: CAD file, 2026-10-08, an earlier design]
hardware/3d-printed-case/Analog Redial v2/AnalogPhone SMD2 - SingleLine - Lid.step
115.2 x 59.2 x 11.2 mm
