sdylewski/Analog-Redial/(list of files, cad)

Other CAD files:
hardware/3d-printed-case/Analog Redial v4/AnalogRedial-4 - Box- DualLine.step
hardware/3d-printed-case/Analog Redial v2/AnalogPhone SMD2 - SingleLine - Case.3mf
hardware/3d-printed-case/Analog Redial v2/AnalogPhone SMD2 - SingleLine - Case.stl
hardware/3d-printed-case/Analog Redial v2/AnalogPhone SMD2 - SingleLine - Lid.stl
hardware/3d-printed-case/Analog Redial v4/AnalogRedial-4 - Box - dualLine.stl
hardware/3d-printed-case/Analog Redial v4/AnalogRedial-4 - Box-SingleLine.stl
hardware/3d-printed-case/Analog Redial v4/AnalogRedial-4 - Lid.stl
