sdylewski/Analog-Redial/hardware/3d-printed-case/README.md

# 3D-printed case

A two-part case, box and lid, for the Analog Redial board. The build guide
(which one to print, screws, assembly) is the
[case page](../../docs/case.md).

<!-- TODO: replace with a photo of the board in its case, e.g. ../../docs/pics/board_in_case.jpg -->
Photo coming soon: the board in its 3D-printed case

## v4 board

In [`Analog Redial v4/`](Analog%20Redial%20v4/). Print one box and the lid.

| File | Print it for |
|---|---|
| `AnalogRedial-4 - Box-SingleLine.stl` | Single-line board |
| `AnalogRedial-4 - Box - dualLine.stl` | Dual-line board |
| `AnalogRedial-4 - Lid.stl` | Either |

The `.step` files are the same parts, for editing in CAD.

## Other boards

- **v5** is 5 mm longer than v4, so the v4 case won't fit it. Its case is
  being designed and will be added here.
