sdylewski/Analog-Redial/docs/setup.md

[Home](../README.md) · [1 · Get a board](board.md) · [2 · Parts & assembly](bom.md) · [3 · Flash & test](flashing.md) · **4 · Set up & use**

# 4 · Set up & use

Get a flashed board onto your Wi-Fi. This describes everything you can do from its
web interface. If someone handed you a ready-made board, start here. If something
isn't working, see [Troubleshooting](troubleshooting.md).

## 1. Get it on your Wi-Fi

Power the board up. With no Wi-Fi saved yet, it makes **its own Wi-Fi
network** for setup:

1. On your phone or laptop, join the open network **`AnalogRedial-XXXX`**.
2. A setup page should pop up. If it doesn't, browse to
   **`http://192.168.4.1`**.
3. Enter your home Wi-Fi name and password, and optionally give the board
   a name. Submit, and it reboots onto your network.

The board needs **2.4 GHz** Wi-Fi; the ESP32-C6 can't use 5 GHz.

The phones work before any of this: dial tone, calls between the two lines,
clips and recordings all run without a network. Wi-Fi is for modifying settings through the web interface, and VoIP.

## 2. Open the web interface

Browse to **`http://phone.local`** from any device on the same Wi-Fi. If you
named the board, it's `http://<name>.local` instead.

- **More than one board?** If `phone` is already taken on the network, the
  board uses `phone1`, `phone2` and so on. Give each board its own name in
  Settings → General to keep it fixed.
- **`.local` not loading?** Some networks don't pass these names. Find the
  board in your router's list of connected devices and open its IP address
  directly.
- **Web password (optional).** Out of the box, anyone on your Wi-Fi can
  change the settings. Settings → General → **Web password** turns on a
  password: settings pages can still be viewed, but changing anything asks
  you to sign in, and so does everything to do with recordings and stored
  audio: the Recordings page, playing, downloading and deleting them. Scripts
  pass it with `curl -u admin:PASSWORD`, or by setting `REDIAL_PASSWORD`
  for the tools in `firmware/bringup/`. The board talks plain HTTP, so the
  password crosses your network unencrypted: it keeps out casual changes
  and other websites, not someone watching your Wi-Fi traffic.
  - **How long you stay signed in** is a setting: until you close the
    browser, 1, 7, 30 (the default), 90 days or 1 year. That's the
    *sign-in*; the password itself never expires. Restarting the board
    always signs everyone out.
  - **A hint** (optional, up to 80 characters) is shown on the sign-in page.
    Anyone who can reach the board can read it, so describe the password
    ("the dog + the year"); don't write it. The board refuses a hint that
    is the password.
  - Forgot it? See [§8](#8-the-boot-button-rescue-and-reset).

## 3. Dialing

On a touch-tone phone, **#** ends a number at once instead of waiting for the pause
after the last digit. Dial codes you set can also use **\*** and **#** (`*72`, say),
and Bluetooth dial-out passes them on for service codes like `*86#`.

The **Status** page always shows the board's current dial codes. The
defaults:

| Dial | What happens |
|---|---|
| **0** | Operator: a spoken help message |
| **211** | Record a message after the beep. Play or download it under Recordings. Spoken prompts start about a second after you dial, so you have time to get the handset to your ear |
| **314** | Reads pi aloud: "three point one four one five...", the first 100 decimals. Hang up to stop |
| **321** | Ring the other phone (two-line boards) |
| **256** | Alarm ("ALM" on the keypad): asks "What time should the alarm ring?", then dial the time as four digits on a 24 hour clock (0730 is 7:30 am, 1815 is 6:15 pm); dial 9 9 instead to cancel. At that time the phone rings in its own pattern (three 2-second rings, repeated up to 8 times; change it on the Alarm card in Settings → Dial Codes) until you pick up, then says "This is your alarm." Rings once, at the next matching time, kept through a restart; needs the board's clock, which it gets over Wi-Fi |
| **412** | A dial-up modem sound, for old times' sake |
| **846** | Timer ("TIM" on the keypad): asks "How many minutes for the timer?", then dial 1 or 2 digits (1-99; a single 0 cancels). One second after the last digit the timer is set and dial tone returns. When it's up the phone rings, up to four times, until you pick up (the ring pattern is on the Timer card), then says "Your timer is done." (change the words in Settings → Dial Codes, Timer card). One timer per line, forgotten if the board restarts |
| **674** | Answering machine messages ("MSG" on the keypad): plays them oldest first. After each one, dial **1** to hear it again, **3** to delete it, or **5** for the next. Deleting or skipping says "Next message." and plays the next one; with none left it says "You have no new messages." The keys work while a message is playing too |
| **1212** | The weather report, once it's set up (Settings → Dial Codes, Weather report card): pick a place by name, download the voice pack once, and dialing reads the forecast, for example "Right now, partly cloudy, and 58 degrees. Today, partly cloudy, with a high of 64 and a low of 51. 20 percent chance of rain." Tick which parts it reads: right now, today (after 5 pm, tonight's low) and tomorrow; Fahrenheit or Celsius. The forecast comes from [Open-Meteo](https://open-meteo.com) once an hour. The voice pack (about 0.9 MB, English) goes in internal storage on a 16 MB board; an 8 MB board needs a microSD card |
| **8675309** | A short spoken message: "If you're trying to reach Jenny, she's not home right now." |
| A board's 4-digit number | A VoIP call straight to another Analog Redial board on your network, no server. Each board's number is on its Settings → VOIP page ([VoIP setup](voip-setup.md)) |
| **555** + 4 digits | A VoIP call to that extension on your SIP server ([VoIP setup](voip-setup.md)) |
| **821** / **822** | Digit readback off / on: each digit you dial is spoken back to you |
| **899** | Record this line's answering-machine greeting |

Add your own codes with your own audio in Settings → Dial Codes. The built-in codes above can be given other codes there too (Built-in codes card); clear a box to put the original back.

**Make a code switch something.** On a one-line board with no microSD card,
four spare pins (GPIO18–21) are wired to header J5. Under Settings → Dial
Codes → **Pin outputs**, pick a code, a pin and a time: dial it and that pin
goes high for that many seconds (or toggles, if you set 0). Wire a relay or
a MOSFET to it to unlock a door, sound a buzzer, switch a lamp. The output
is 3.3 V at only a few mA, so don't connect a solenoid directly. It will
often switch a 5 V relay module, but check that yours does (the parts page
says what to look for). Set the board to
"Pin outputs" under Settings → General → Board hardware, take the four shunts off J5, and leave
the microSD socket empty. The card shows what's in the way if it isn't
active.

**Home Assistant (experimental).** The board can POST every pickup,
hang-up, dial code and incoming ring to a Home Assistant webhook, and Home
Assistant can ring a phone or fire a pin output over HTTP. Or turn on MQTT and
the board appears in Home Assistant as a device. Home Assistant codes are dial
codes whose only job is to tell Home Assistant they were dialed. All three are
on the **Settings → HA** tab, with its on/off switch at the top. It is not tied to Home Assistant: the webhook and MQTT work with any system that speaks plain HTTP or MQTT (see the end of [Home Assistant](home-assistant.md)). Experimental: see [Home Assistant](home-assistant.md).

## 4. The web interface

Click any picture for the full page.

<table>
  <tr>
    <td width="40%"><a href="pics/status.png">Status page</a></td>
    <td valign="top"><b>Status.</b> Each line's state and last caller, this
    phone's number and the other phones on your network it can call, Wi-Fi
    and storage, recent activity (calls, recordings, misdials) and the dial
    guide. On a new board it also shows a one-time setup card for the board
    name and hardware type.</td>
  </tr>
  <tr>
    <td><a href="pics/recordings.png">Recordings page</a></td>
    <td valign="top"><b>Recordings.</b> Messages left with 211 and on the
    answering machine: length, time, play, download, delete.</td>
  </tr>
  <tr>
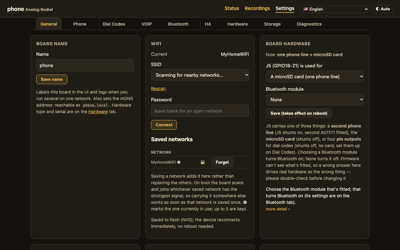
[picture p92: docs/pics/thumbs/settings-general.png]
General settings
    <td></td>
    <td valign="top"><b>Settings → General.</b> Board name, saved Wi-Fi
    networks, the board's hardware (what J5 is used for: a second line,
    microSD or pin outputs; and the Bluetooth module), time zone, quiet
    hours that keep the bell silent overnight, and the passwords.</td>
  </tr>
  <tr>
    <td><a href="pics/settings-phone.png">Phone settings</a></td>
    <td valign="top"><b>Settings → Phone.</b> The answering machine
    per line, your country's dial tone, the off-hook alert, echo
    cancellation, digit readback, voice effects, intercom mode and earpiece
    volume.</td>
  </tr>
  <tr>
    <td><a href="pics/settings-dialcodes.png">Dial codes and prompts</a></td>
    <td valign="top"><b>Settings → Dial Codes.</b> Every clip code
    and its audio, editable: change a code, upload new audio, or add a new
    one. Also the operator message, the record-message prompt, the timer's
    spoken question and message, and the pin outputs.</td>
  </tr>
  <tr>
    <td><a href="pics/settings-voip.png">VoIP settings</a></td>
    <td valign="top"><b>Settings → VOIP.</b> Each line's board-to-board
    number and the other phones found on your network; then, folded away until
    VoIP is turned on, the SIP server and per-line extension, registration
    status, and a generated setup script for your Asterisk server. Walkthrough
    in §6 below.</td>
  </tr>
  <tr>
    <td><a href="pics/settings-hardware.png">Hardware settings</a></td>
    <td valign="top"><b>Settings → Hardware.</b> Board and chip
    details, low-power idle mode (on by default; it saves power when the
    phones have been idle for a few minutes), each line's ring frequency, firmware updates (with a check for new
    releases), restart counts, the memory map, and resets.</td>
  </tr>
  <tr>
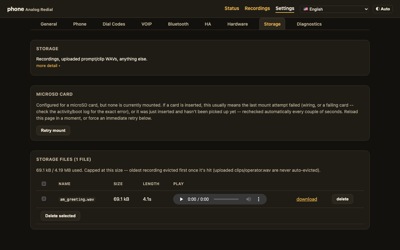
[picture p93: docs/pics/thumbs/settings-storage.png]
Storage settings
    <td></td>
    <td valign="top"><b>Settings → Storage.</b> A file manager for the
    board's flash and the microSD card.</td>
  </tr>
  <tr>
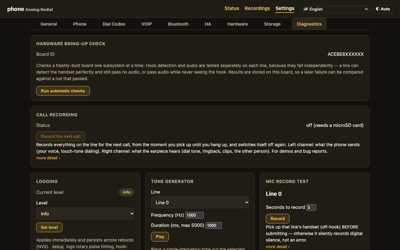
[picture p94: docs/pics/thumbs/settings-diag.png]
Diagnostics
    <td></td>
    <td valign="top"><b>Settings → Diagnostics.</b> The full log, log
    level, the hardware self-test (including a line audio level check that
    recommends an earpiece level, with a button to apply it), a
    ring frequency test for a phone that rings weakly, and a one-shot <b>call recording</b>: arm
    it, lift the handset, and the whole call (dial tone, dialing, voice) is
    saved as a stereo WAV: to the microSD card (up to 20 minutes), or with
    no card to internal flash (a minute or two, using only free space).
    <b>Live call audio</b> sends a line's call, both voices, to OBS or VLC
    on your network as it happens, for filming a video: turn it on, copy
    its link into an OBS Media Source.</td>
  </tr>
</table>

Optional features (VoIP, Bluetooth, Home Assistant, Payphone) always have their tab, so
you can read how they work first. A bar at the top says whether the feature
is on: VoIP, Home Assistant and Payphone have their switch there, and Bluetooth turns on
when you choose its module in Board hardware. Settings are kept while a
feature is off. Bluetooth needs the v5 board with the BM64 companion.

## 5. Your own audio

**From the browser:** Settings → Dial Codes takes a WAV upload in
almost any format (any sample rate, 8 to 32 bit, mono or stereo) and
converts it on the board. Changes take effect immediately, no rebuild.

**From the command line:** `firmware/bringup/gen_prompt.py` makes a clip
from an MP3 or from text (text-to-speech on your computer) and uploads it.
It runs on macOS, Linux and Windows (`python gen_prompt.py` there); text and
WAV files need nothing else installed, while an MP3 needs
[ffmpeg](https://ffmpeg.org) on Linux and Windows.
To build your own clips into every firmware image instead, see
[`firmware/assets/README.md`](https://github.com/sdylewski/Analog-Redial/blob/main/firmware/assets/README.md).

Each dial code's file name is editable in Settings → Dial Codes, so a
built-in code can point at a different clip without being removed.

Use audio you have the rights to. The board ships with its spoken prompts
(the operator message, the record-message prompt, the timer's question and
message, the answering machine's default greeting, the Jenny message and the
spoken digits), made with an open text-to-speech voice, and a public-domain
modem sound.

## 6. VoIP

VoIP has two uses. **Between your own boards** it needs nothing: each line gets
a 4-digit number on first start, and you dial another board's number to ring it.
**Through a server**, register one or both lines with Asterisk, FreePBX or another
SIP server to call beyond your network, then dial **555** + an extension (the same
four digits by default). With the
VoIP provisioner running next to Asterisk, it's one button: Settings →
VOIP → Automatic setup, pick a number, **Register**. Otherwise fill in the
form, download the generated setup script and run it on your server. Calls stay on your local network (no encryption).
Walkthrough: [VoIP setup](voip-setup.md).

## 7. The status light

The DevKit's RGB LED shows what the board is doing. It's deliberately dim.

| Light | Meaning |
|---|---|
| **Red, fast blink** | Starting up |
| **Red, slow blink** | Something failed to start, but the board is running. Check Settings → Diagnostics |
| **Green, slow blink** | Joining Wi-Fi, or waiting in setup mode. If it keeps blinking after boot, it's in setup mode: see [§1](#1-get-it-on-your-wi-fi) |
| **Green, solid** (30 s) | Just joined Wi-Fi |
| **Off** | Running normally |
| **Yellow, fast blink** | Installing a firmware update. Don't unplug it |
| **Amber, double blink every 2 s** | The board restarted because its power supply dipped (a brownout). Dismiss the banner on any page; use a 5 V, 2 A supply |
| **Blue, slow blink** | Bluetooth pairing (v5) |
| **Blue, solid** (5 s) | A phone just connected over Bluetooth (v5) |

## 8. The BOOT button: rescue and reset

With the board **running**, hold the **BOOT** button on the DevKit:

| Hold | What happens |
|---|---|
| **3 seconds, then let go** | **Rescue mode.** The board brings up its own Wi-Fi network (named after the board) for one session, keeping your saved networks. Join it and browse to **192.168.4.1** for the full web interface, which doesn't ask for the web password there, so you can remove a forgotten one (Settings → General). Use this when it can't reach the network in front of it |
| **10 seconds** | **Forget Wi-Fi.** Erases saved networks and the web password, and restarts in setup mode ([§1](#1-get-it-on-your-wi-fi)) |

The light changes at the 3-second mark so you know when to let go. Holding
BOOT **while plugging in** does something different: it puts the chip in
USB flashing mode.

With the board plugged into a computer, the serial console command
`webpass clear` also removes a forgotten web password.

## 9. Updating the firmware

**From the web page.** Settings → Hardware → Firmware shows the version this
board runs and a **Check for updates** button. When a newer release exists for
this board type it says so, shows what changed, and **Install** does the rest:
your browser downloads the release and hands it to the board, which writes it
to the spare slot and restarts into it. If the new version doesn't start, the
board goes back to the old one by itself. A banner on every page tells you when
an update is out; "Not now" hides it for that version. It needs a browser
that's online (the board itself never connects to GitHub).

**By hand.** Build a new image ([step 3](flashing.md)) and either flash it over
USB, or upload the `rotary_phone_gateway.bin` from your build directory in the
same Firmware card. The board checks that the file is a firmware image for this
board type before it will use it.

**When USB is still needed.** A board's first flash, and moving a board to a newer
flash layout (a board keeps working on its old layout until then, and web updates
never change it). Moving to a new layout erases recordings and clips, so download
any you want to keep first. Settings are kept.

## 10. Payphones

The board works with a payphone just as with any other phone: it gives dial
tone, rings the bell, reads the dial or keypad, and handles calls and every
other feature the same way.

**Settings → Payphone (experimental)** adds what a payphone needs, with no
extra hardware:

- **Coin tones:** a payphone whose totalizer still works sends a tone down the
  line for each coin, and the board hears them while the handset is up: one beep
  for a nickel, two for a dime, five short ones for a quarter. Not every phone
  converted for home use still sends them; drop a coin and watch the tab's log.
- **Coin required:** lifting the handset plays a spoken "please deposit" message
  instead of dial tone until the coins add up to the price of a call. Calls need
  the credit; the board's own dial codes can stay free.
- **A message after a coin**, one for each coin or one for all.
- **A coin count** with a reset, simulate buttons for testing, a log of every
  coin, and a `coin` event for Home Assistant.

Set the two spoken messages' text on the tab, then generate their audio like the
operator message (the tab shows the command).

**Not tested yet: the coin mechanism itself**, meaning the coin switches and the
solenoid that collects or returns coins. That needs a separate
[coin board](hardware-coin-board.md), which is sent to fab but not built or tested yet;
its settings are on the same tab, on the Coin board card.

Also still to find out: whether the board can sit inside a payphone's metal
housing and still reach Wi-Fi and Bluetooth through it.

---

**Back to: [Home](../README.md)**
