sdylewski/Analog-Redial/datasheets/S-C 500D and 554B Telephone Wiring Diagram.pdf

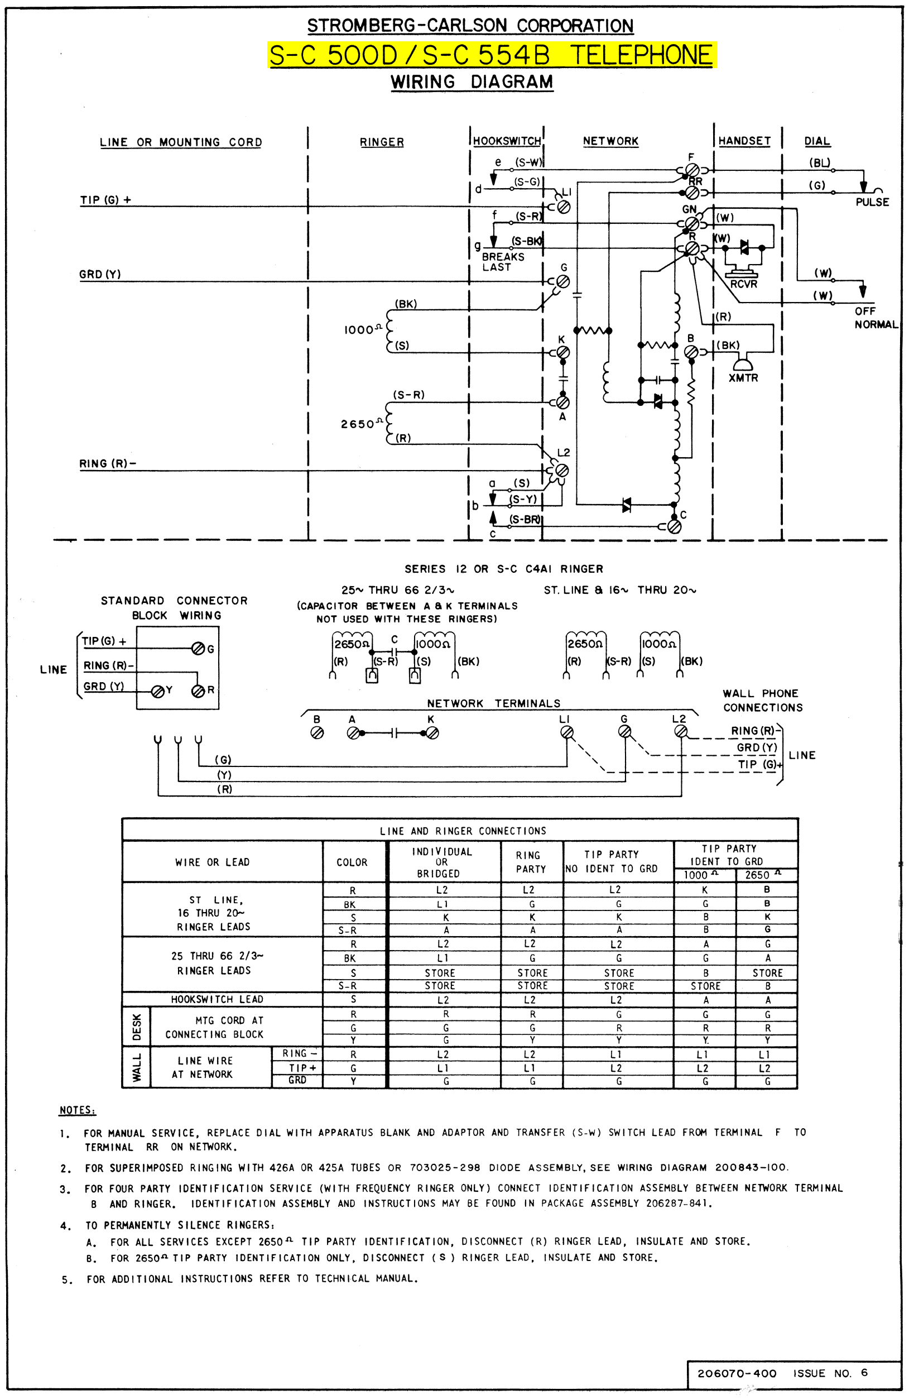
[picture p95: page 1]
