sdylewski/Analog-Redial/docs/assets/setup-overview-docs.png

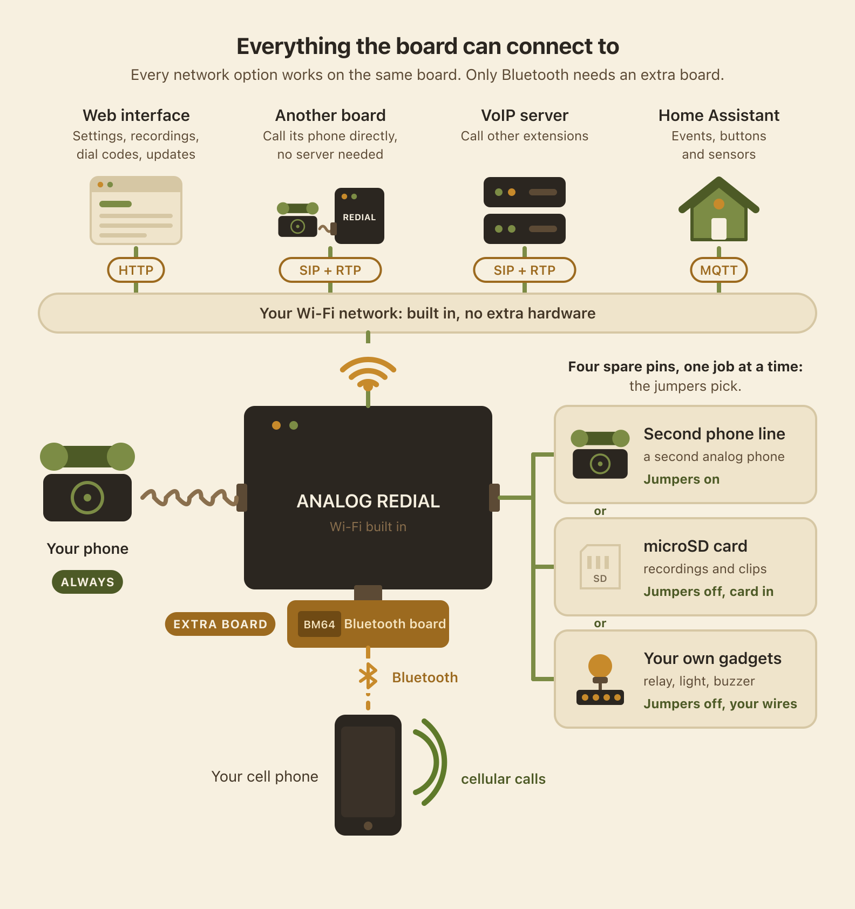
docs/assets/setup-overview-docs.png
