sdylewski/Analog-Redial/docs/assets/setup-overview-letter-landscape-notext.png

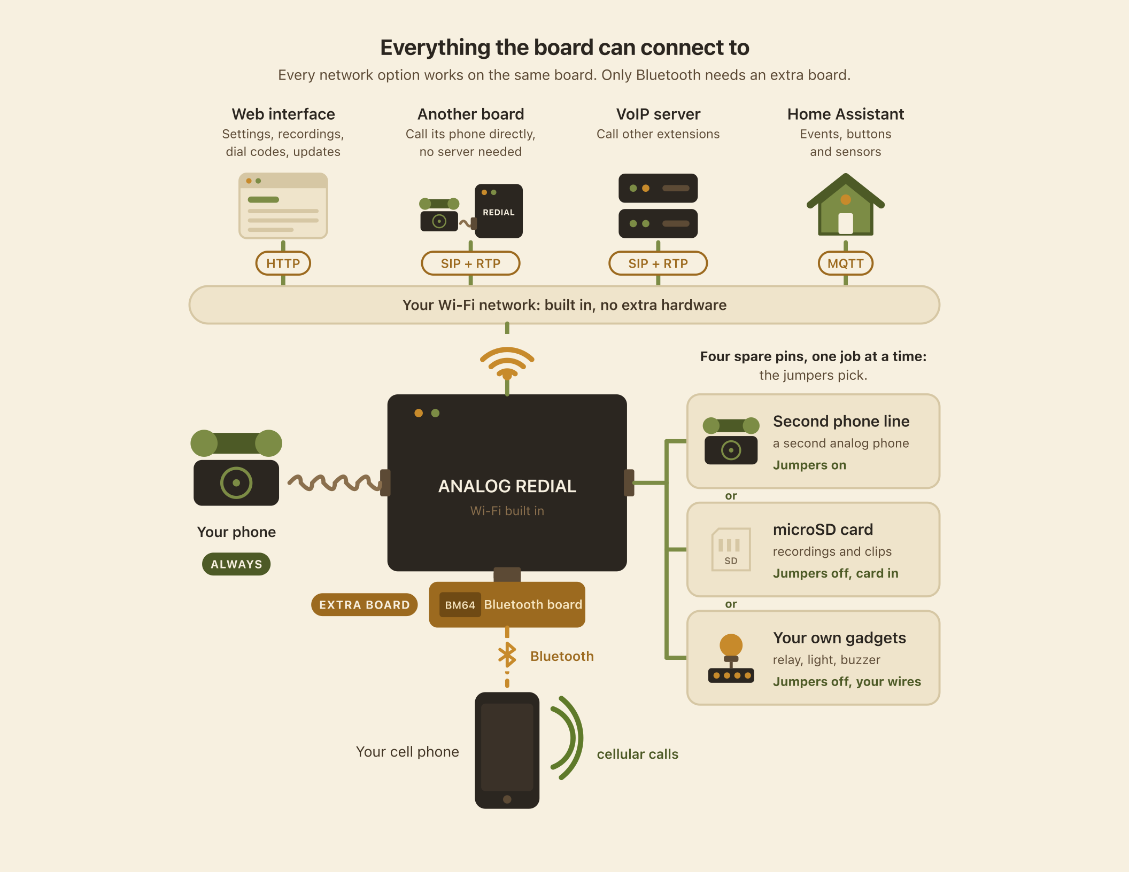
docs/assets/setup-overview-letter-landscape-notext.png
