sdylewski/Analog-Redial/docs/assets/setup-overview-letter-landscape.png

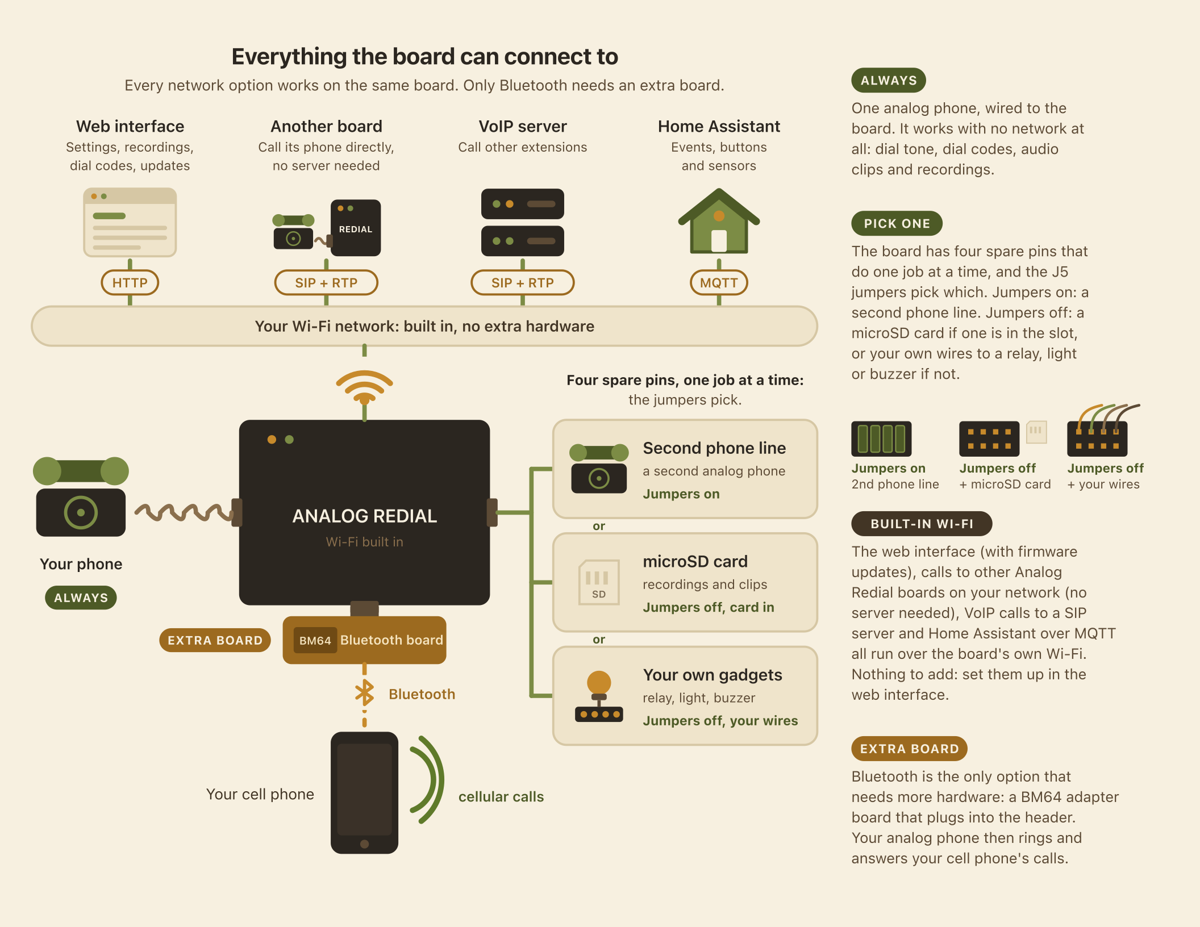
docs/assets/setup-overview-letter-landscape.png
