sdylewski/Analog-Redial/docs/assets/setup-overview-letter-portrait-notext.png

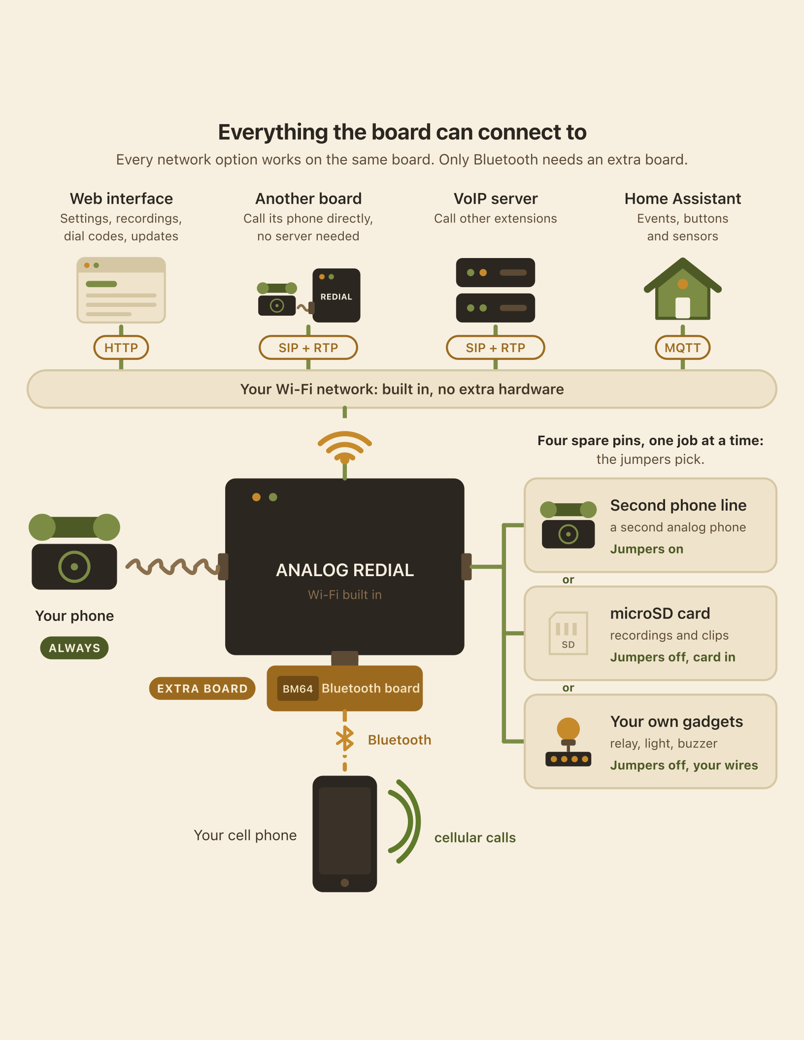
docs/assets/setup-overview-letter-portrait-notext.png
