sdylewski/Analog-Redial/docs/assets/setup-overview-letter-portrait.png

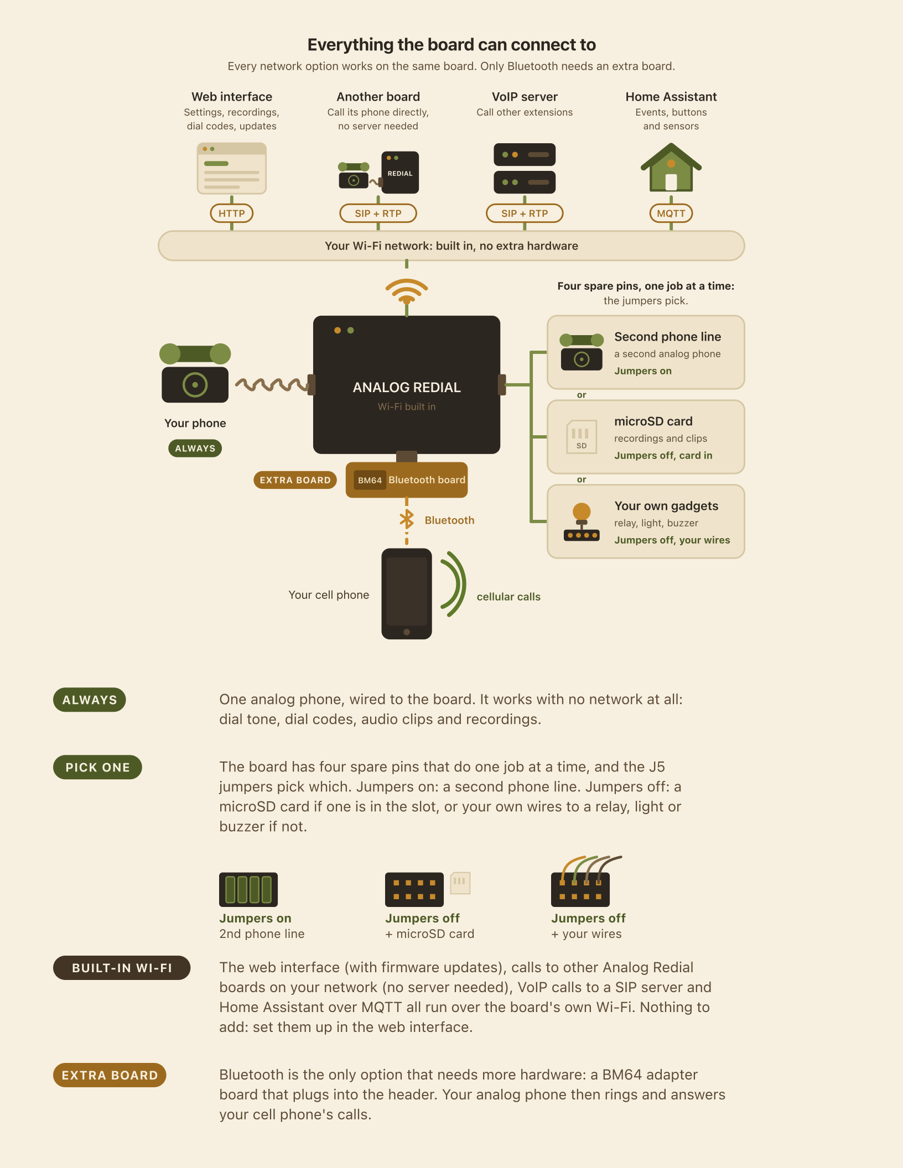
docs/assets/setup-overview-letter-portrait.png
