sdylewski/Analog-Redial/docs/assets/setup-overview-top-letter-landscape-notext.png

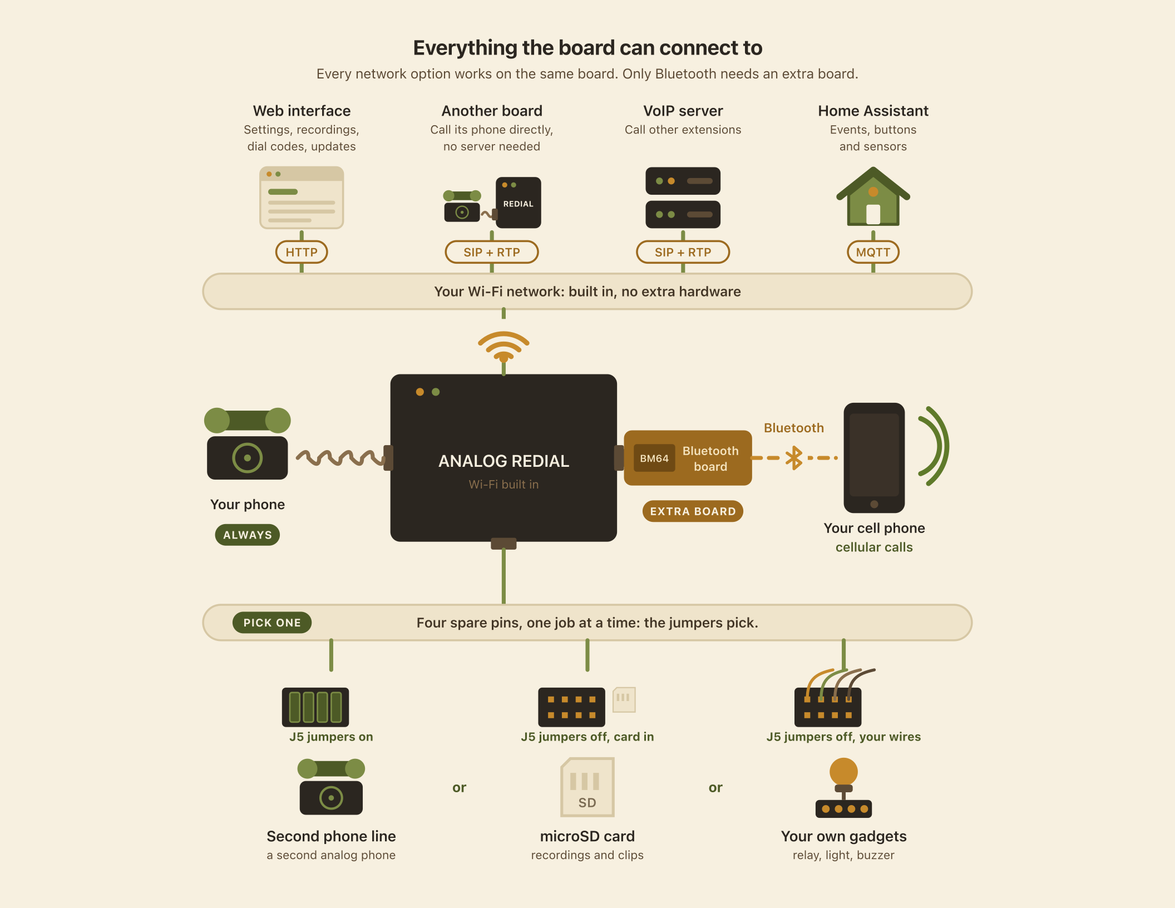
docs/assets/setup-overview-top-letter-landscape-notext.png
