sdylewski/Analog-Redial/docs/assets/setup-overview-top-letter-landscape.png

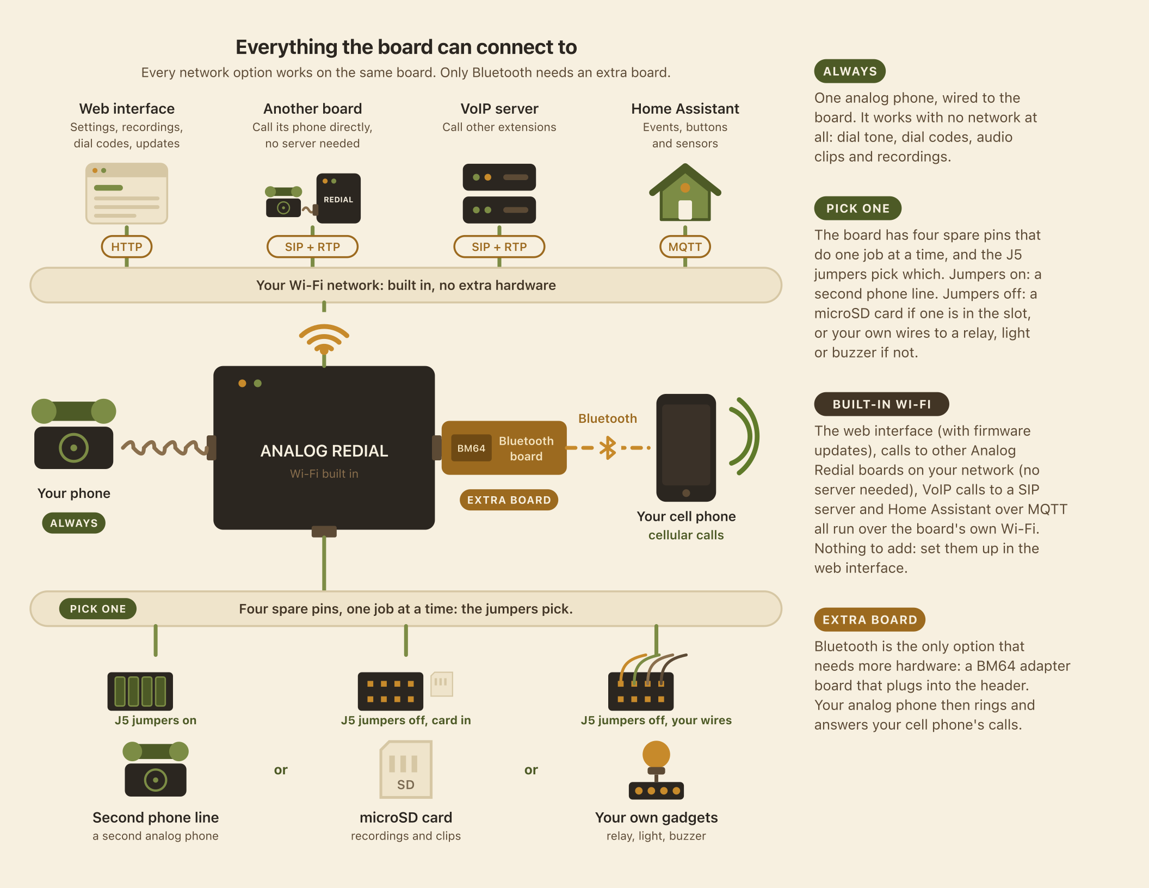
docs/assets/setup-overview-top-letter-landscape.png
