sdylewski/Analog-Redial/docs/assets/setup-overview-top-letter-portrait-notext.png

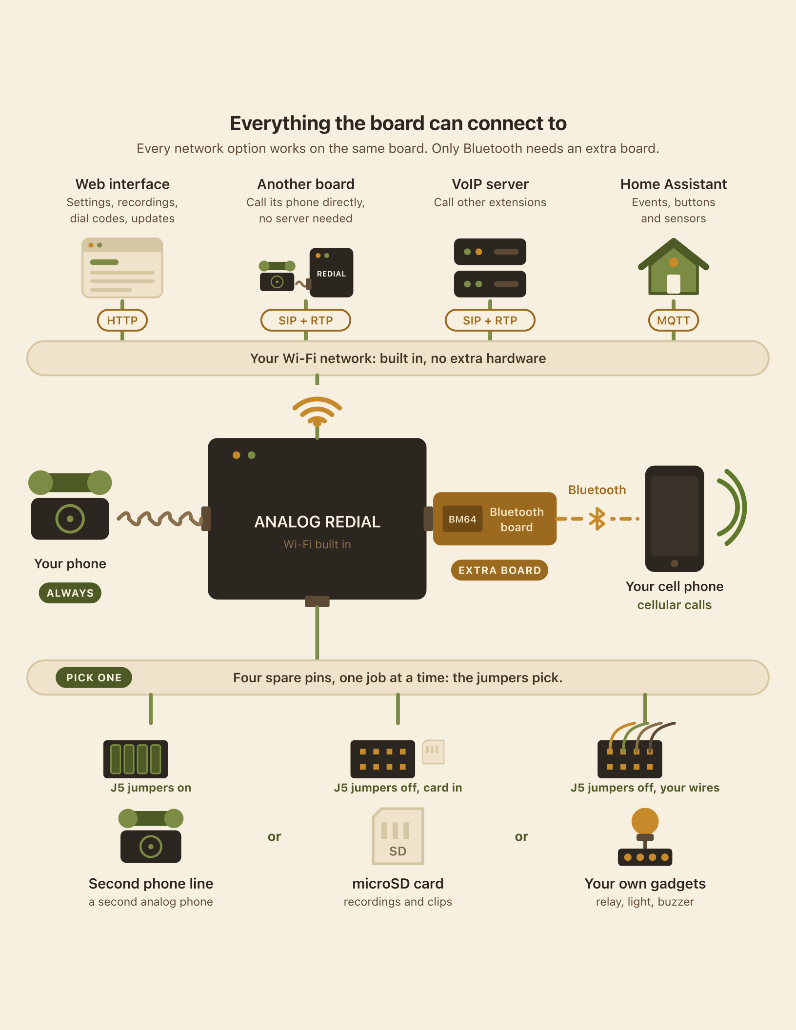
docs/assets/setup-overview-top-letter-portrait-notext.png
