sdylewski/Analog-Redial/docs/assets/setup-overview-top-letter-portrait.png

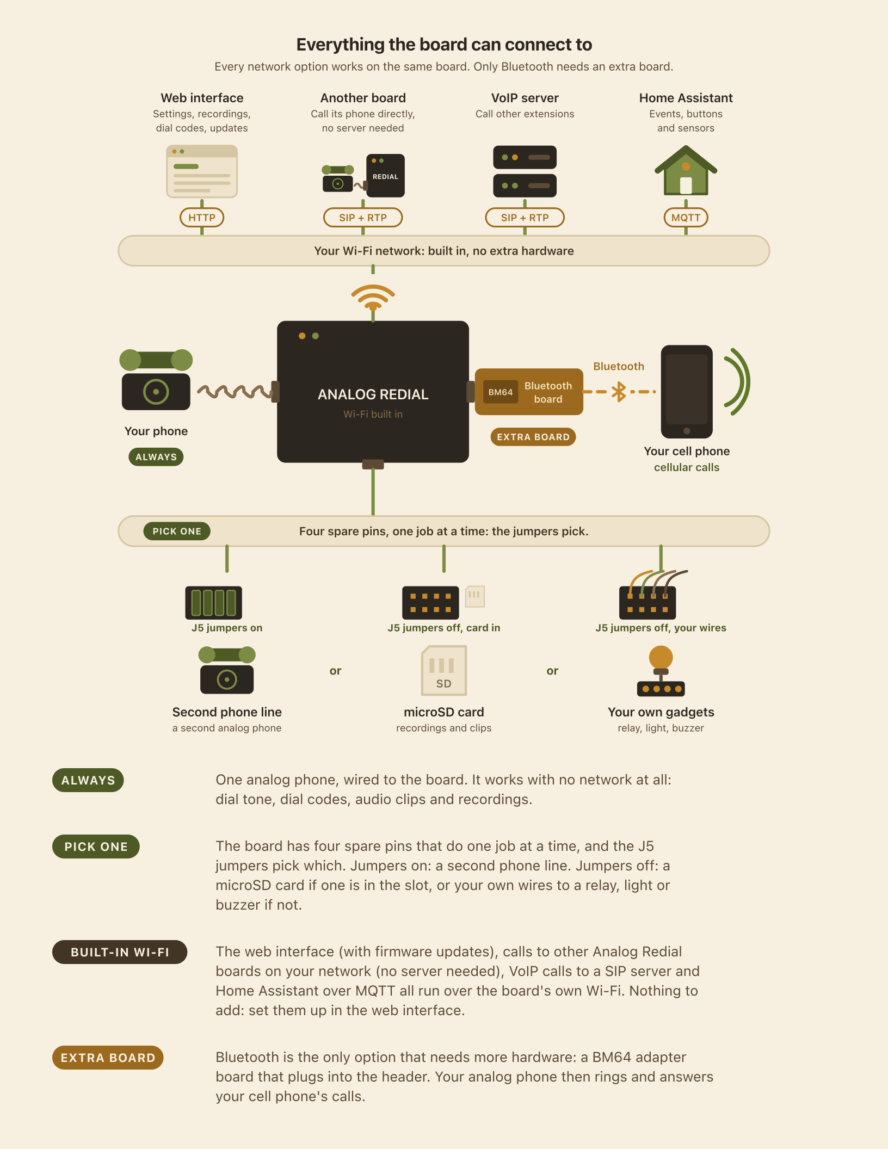
docs/assets/setup-overview-top-letter-portrait.png
