sdylewski/Analog-Redial/docs/assets/setup-two-line-everything.png

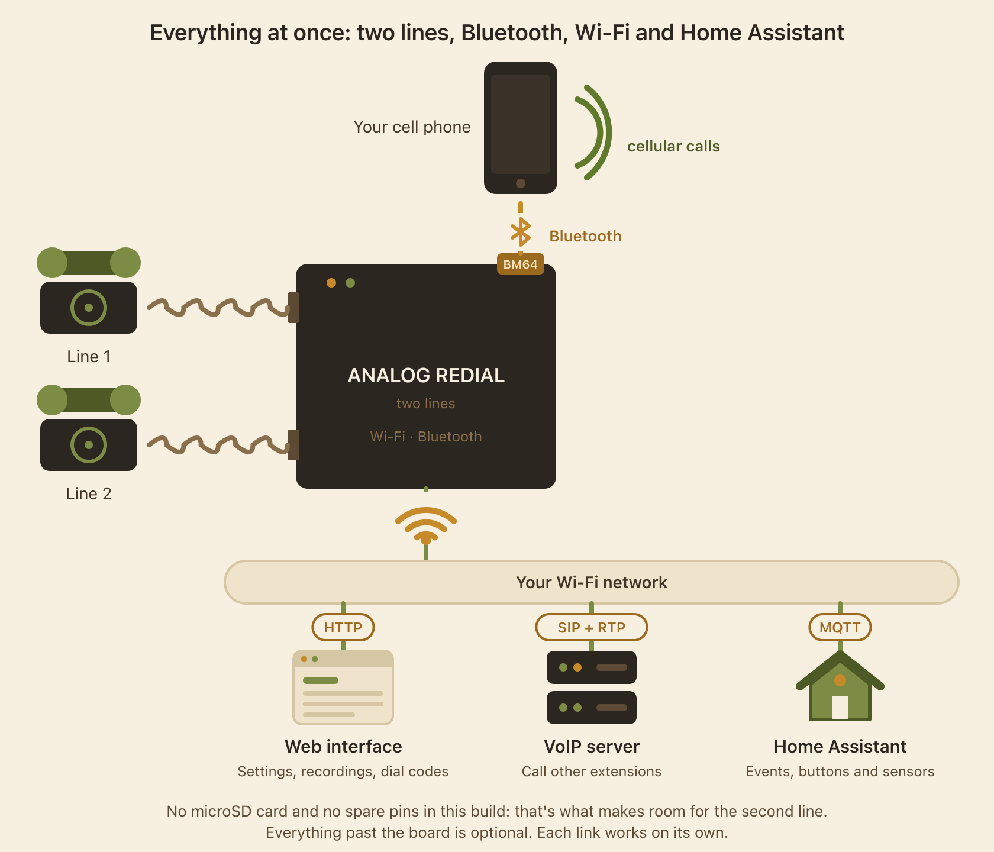
docs/assets/setup-two-line-everything.png
