sdylewski/Analog-Redial/PayPhone/instruction_cards/png/lower_card_example_dialing.png

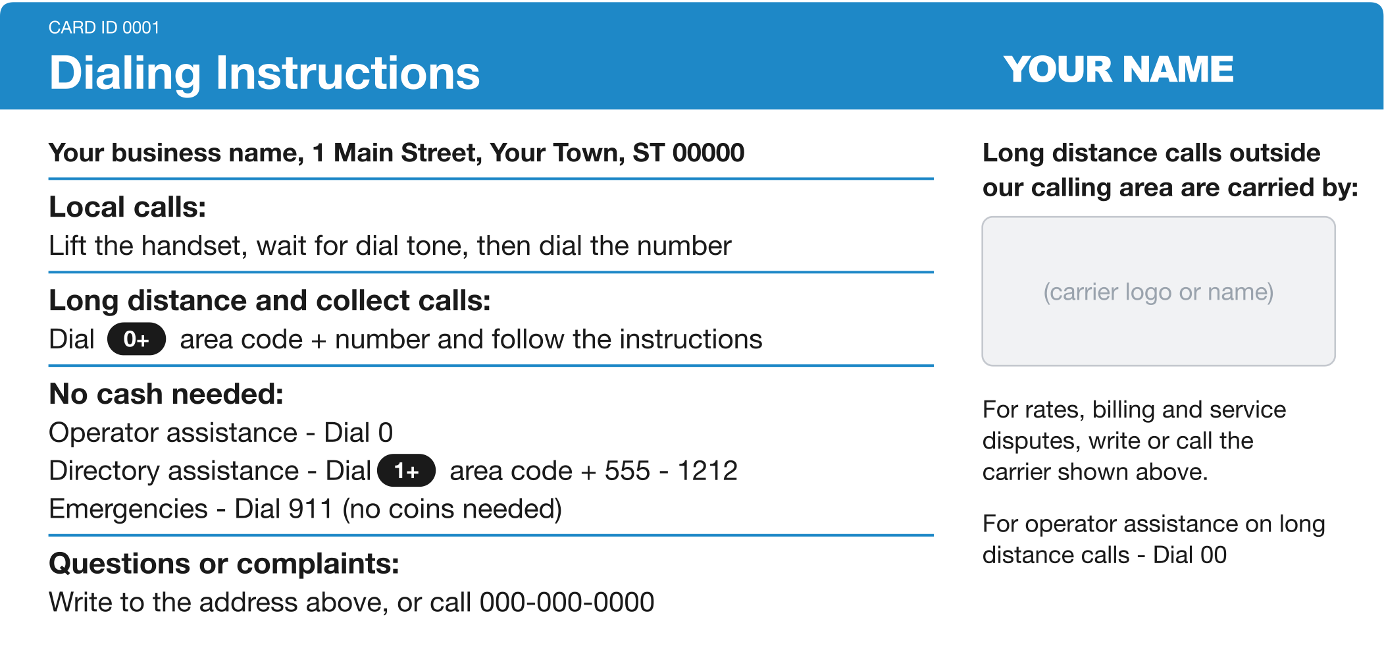
PayPhone/instruction_cards/png/lower_card_example_dialing.png
