sdylewski/Analog-Redial/PayPhone/instruction_cards/png/lower_card_pacific_redial.png

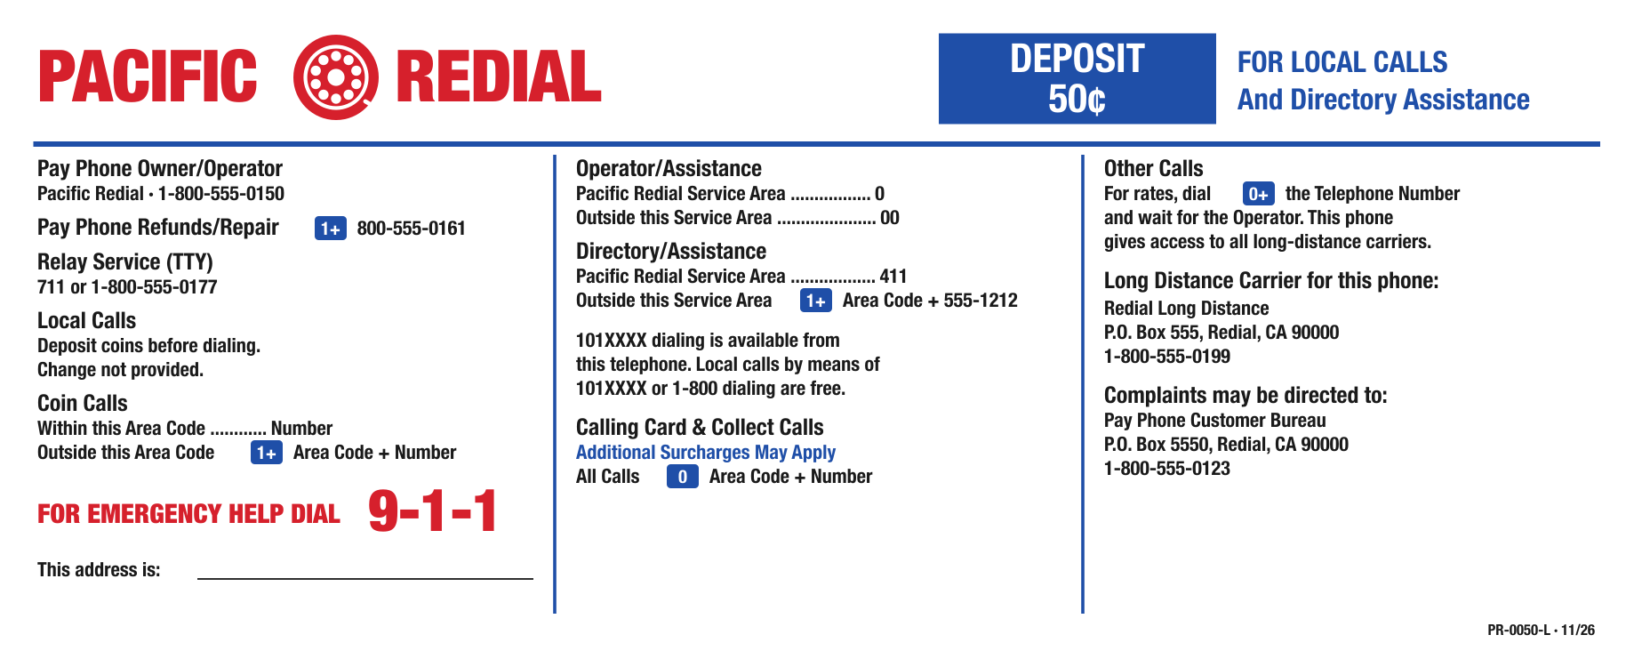
PayPhone/instruction_cards/png/lower_card_pacific_redial.png
