sdylewski/Analog-Redial/PayPhone/instruction_cards/png/upper_card_example_rates.png

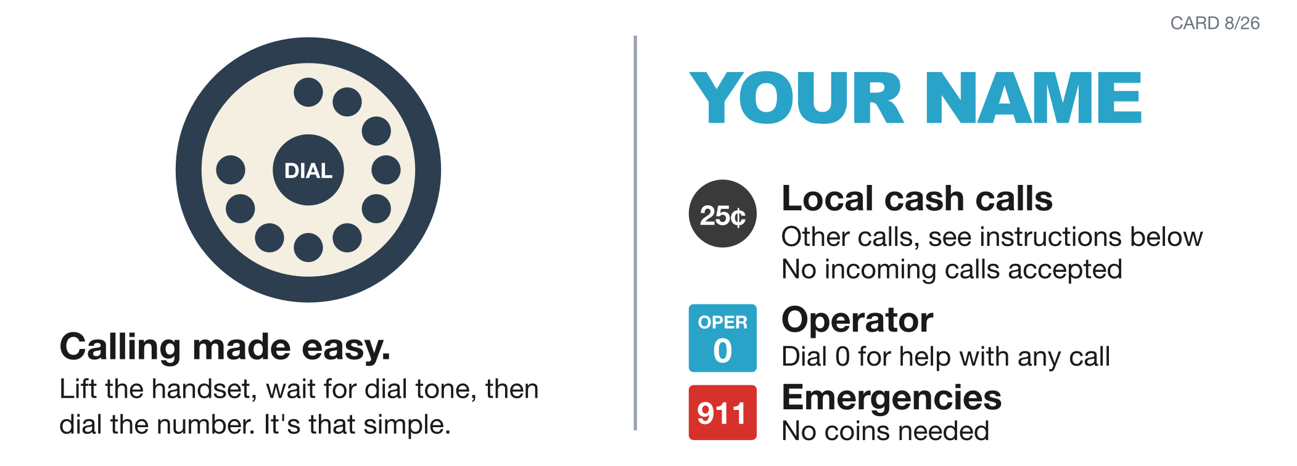
PayPhone/instruction_cards/png/upper_card_example_rates.png
