sdylewski/Analog-Redial/PayPhone/instruction_cards/png/upper_card_example_steps.png

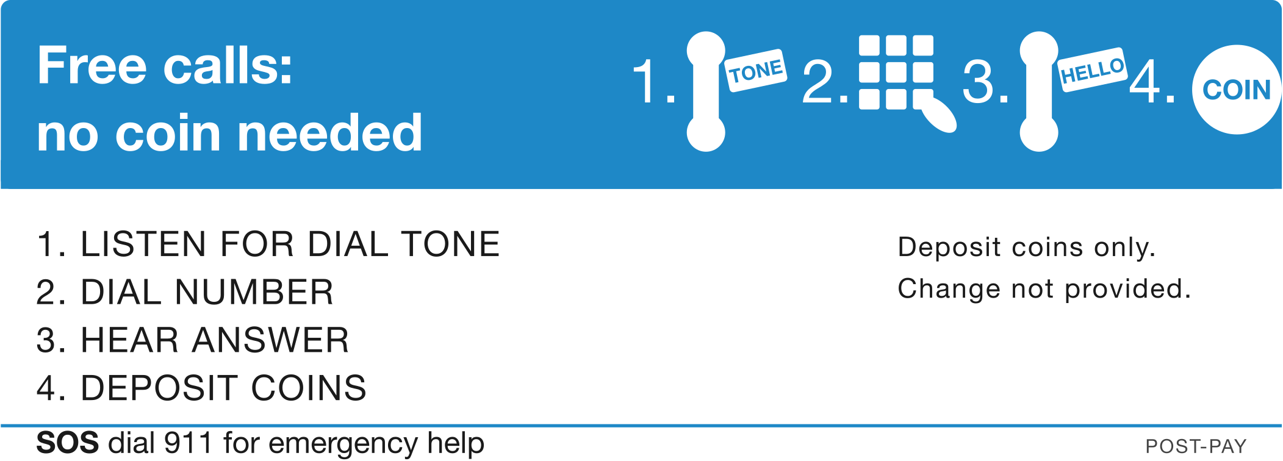
PayPhone/instruction_cards/png/upper_card_example_steps.png
