sdylewski/Analog-Redial/PayPhone/instruction_cards/png/upper_card_pacific_redial.png

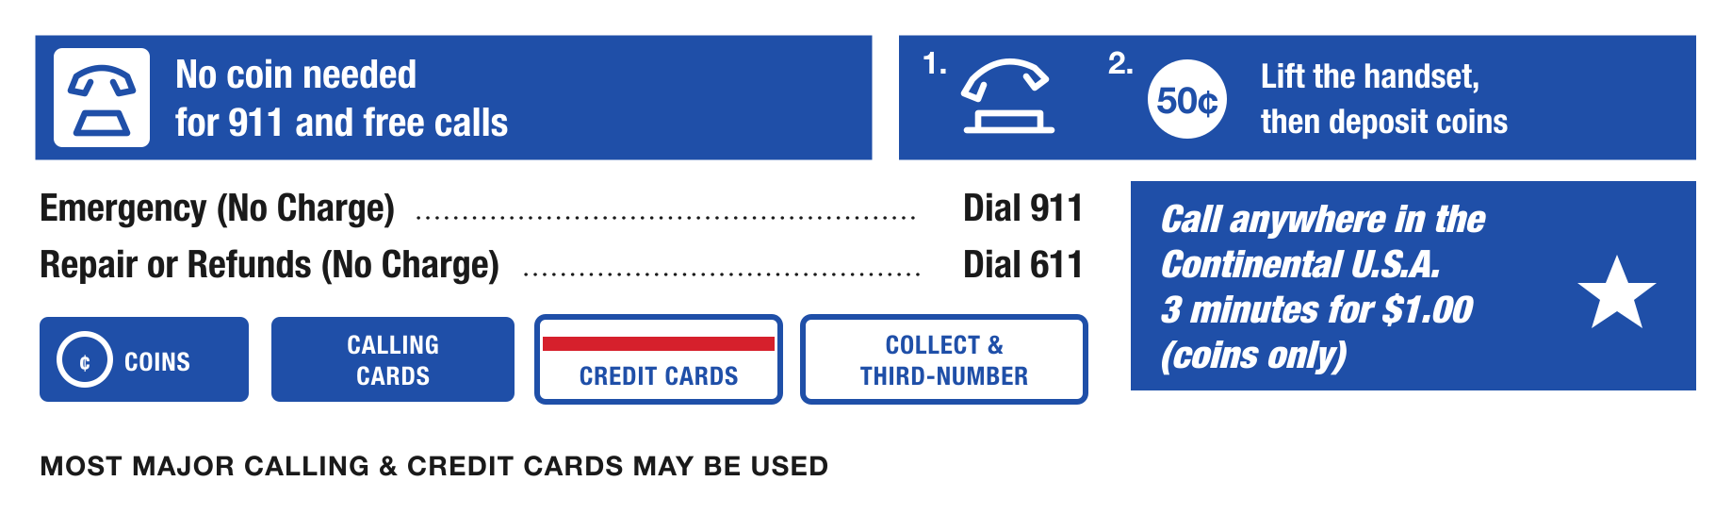
PayPhone/instruction_cards/png/upper_card_pacific_redial.png
