sdylewski/Analog-Redial/firmware/bringup/README.md

# Bring-up guide

**macOS, Linux and Windows.** Run every script here from an ESP-IDF terminal
(`. ~/esp/esp-idf/export.sh` on macOS/Linux, the *ESP-IDF 5.2 PowerShell* or
CMD shortcut on Windows): its Python already has pyserial and esptool. On
macOS and Linux run them as `./flash_board.py ...`; on Windows as
`python flash_board.py ...`. The board's port is `/dev/cu.usbmodem*` on
macOS, `/dev/ttyACM*` on Linux and `COMn` on Windows, and the scripts find it
on their own when one board is plugged in.

Hardware bring-up for Analog Redial boards (SMD2/SMD4/SMD5, ES8388 codec).
Two layers:

1. **On-target console** (`firmware/components/bringup`) — a serial REPL
   built into the firmware itself, with one command per subsystem
   (`codec_init`, `tone`, `slic`, `ring`, `hookmon`, ...). This is what
   actually talks to the hardware.
2. **Host-side scripts** (this folder) — drive that console over serial so
   each subsystem can be tested with one command from your laptop, and so the
   full sequence can be scripted instead of typed by hand.

## flash_board.py — detect the board, build the right image, flash it

```bash
./flash_board.py                 # detect, show the plan, ask, flash
./flash_board.py --setup --host telephono.local   # then run first_setup.py
./flash_board.py --dry-run       # detect only
```

- **Board type:** `--board`, else read from the firmware already on the
  board (`board_info` reports the PCB it was built for and the type the
  board last confirmed booting as), else it asks. A board running firmware
  from before 2026-10-02 only says "smd", so pass `--board` once.
- **Flash size:** read off the chip with esptool — no firmware needed.
- **Build directory:** `build/` for SMD4 on 16 MB (the tracked sdkconfig),
  `build.<board>/` for other boards, `build.<board>_8mb/` for 8 MB parts
  (`partitions_8mb.csv`). Created with the right defaults chain and an
  explicit `SDKCONFIG` path if it doesn't exist yet.
- After flashing it checks `board_info` again and warns if the board last
  confirmed as a different PCB.

## first_setup.py — bring up and provision a board, one gated step at a time

Run it from an ESP-IDF terminal, with the board on
USB and, for the HTTP steps, on Wi-Fi. Close any `idf.py monitor` first — it
holds the serial port.

```bash
./first_setup.py --host telephono.local                 # the usual run
./first_setup.py --host telephono.local --lines 2 --language de
./first_setup.py --chip-info --only chip                # chip, flash size, MAC only
./first_setup.py --host telephono.local --only audio verify
```

Each step runs only if the steps it depends on passed, and the run ends with
a PASS / WARN / FAIL / SKIP table:

| Step | What it does | Gates |
|---|---|---|
| `chip` | *(opt-in, `--chip-info`)* esptool reads chip, flash size, MAC — no firmware needed; warns if flash isn't 16 MB | — |
| `console` | serial REPL answers; reads the board type the firmware was built for | `codec`, `microsd` test, `tests` |
| `codec` | ES8388 found on I²C | `tests` |
| `network` | board answers `/api/status` at `--host` | everything below |
| `hardware` | sets lines / microSD / Bluetooth — only when you pass `--lines`, `--bluetooth` (BM64) or `--bt-module none\|bm64\|bt401` | — |
| `voip` | saves the VoIP provisioner address and enrollment key and reads back the board's ✓/✕ result — only with `--prov-url` (key from `--prov-key` or `REDIAL_PROV_KEY`) | — |
| `microsd` | skipped on 2-line boards (shared pins); WARN if no card is in use; otherwise `sd_test` write/read/verify over serial | — |
| `audio` | generates and uploads `operator.wav`, `record_prompt.wav` (dial 211), `am_greeting.wav`, the answering machine's default greeting ("Leave a message after the beep"; a line's own recording via 899 still wins), and with `--digits`, `digit_0..9.wav` | `verify` |
| `verify` | reads every uploaded file back and checks it's a WAV | — |
| `tests` | *(opt-in, `--tests`)* the interactive `bringup_checklist.py` | — |

The operator message is assembled from what the board actually is: a
single-line board isn't told to dial 321, and the Bluetooth sentence only
appears when Bluetooth is fitted. Prompts go to internal flash, so they don't
depend on a card.

HTTP goes through `curl` (built into macOS, Linux distributions and Windows
10/11): on macOS, Python's sockets to a LAN address are blocked unless the
terminal has Local Network permission. Speech is generated locally by
`gen_prompt.py` with Kokoro, which it installs into `tts_venv/` the first
time; converting the result to the board's 8 kHz WAV needs no other tool
(`afconvert` or `ffmpeg` are used when present, and `ffmpeg` is needed only
for MP3 input or output).

## 1. Build and flash

Board type is a compile-time Kconfig choice — GPIO routing is fixed per PCB,
so this can't be selected at runtime. Pick the one matching your board:

```bash
cd firmware
idf.py set-target esp32c6

idf.py -D "CONFIG_BOARD_TYPE_SMD2=y" build flash monitor
```

**SMD boards also need one more Kconfig setting**, easy to miss since it's a
separate `choice` from the board type above (line count and microSD are runtime
settings in the web UI, not Kconfig):

| Setting | Value for a dual-line SMD board | Why |
|---|---|---|
| `Component config -> ESP System Settings -> Channel for console output` | **USB Serial/JTAG Controller** | SMD boards have no UART bridge chip -- the default (UART0) reads keystrokes from GPIO16/17, which aren't wired to anything the host can talk to. Symptom if wrong: boot log prints fine, but the console never responds to typed input at all (UART0 output is mirrored to USB by the *secondary* console, so you still see logs -- input isn't). |

**`-D "CONFIG_X=y"` on the command line is not reliable for these** — it only sets a
`build/CMakeCache.txt` entry, and a later `reconfigure`/`set-target`/plain `build` can
silently drop it back to the Kconfig default without any error, even if an earlier
build with the same flag succeeded. Confirm the setting actually stuck with
`grep CONFIG_WHATEVER sdkconfig` (project root, not `build/`) after building, and fix
it via `idf.py menuconfig` (writes directly to `sdkconfig`, survives `set-target`) if
it didn't. Press `/` in menuconfig to jump straight to a config symbol by name instead
of hunting through the menu tree.

At boot the firmware also checks that the ES8388 answers at 0x10 on I²C and
logs a warning if it doesn't. Run it manually any time with the
`codec_detect` console command.

## 2. Install the host-side script dependencies

Nothing to do in an ESP-IDF terminal. From any other Python:

```bash
cd firmware/bringup
python3 -m pip install -r requirements.txt      # Windows: python -m pip install -r requirements.txt
```

## 3. Find the serial port

```bash
./serial_probe.py            # Windows: python serial_probe.py
```

It lists the ESP32-C6 boards it finds (by USB ID), or every serial port if
there are none. With exactly one board, every script below auto-detects it.
With more than one, pass `--port` to each script: `--port /dev/cu.usbmodem101`
(macOS), `--port /dev/ttyACM0` (Linux) or `--port COM5` (Windows).

## 4. Run the bring-up sequence

Either run everything in order:

```bash
./bringup_checklist.py       # Windows: python bringup_checklist.py
```

This runs each step below, in order, and stops at the first failure (each
step depends on the previous one working). Pass `--yes` to skip the
confirmation prompt between steps.

Or run one subsystem at a time while debugging a specific block:

| Script | What it checks |
|---|---|
| `test_mcu.py` | Board boots, console REPL responds, reports board type |
| `test_codec.py` | I2C scan finds the codec, `codec_init` succeeds, register dump looks sane |
| `test_audio.py` | Tone generation, ADC capture level, digital loopback (mic -> earpiece) |
| `test_slic.py` | SLIC power-up, hook-switch detection, ringing |
| `test_dtmf.py` | DTMF digit generation and call-progress tones (dial/ringback/busy) |

Each takes `--port`, `--baud`, and (except `test_mcu.py`) `--line 0|1`. Steps
that require a human to listen or lift a handset say so explicitly and print
`Manual check required` at the end — these can't be fully automated without
an audio analyzer on the line.

## gen_weather_pack.py — the weather report's voice pack

The weather report (dial 1212) strings recorded words together: every number from
0 to 110, each kind of weather, and the joining phrases. This script speaks them all
once with Kokoro and writes one file, `firmware/assets/weather/weather_en.pak` (a WAV
with an index chunk), plus `weather_en.json` (its size and SHA-256).

```bash
./gen_weather_pack.py
./gen_weather_pack.py --kokoro-voice bf_emma
```

Commit both files: boards download them from the main branch on GitHub when you press
"Download voice pack" on the Weather report card. To try a new pack before pushing it,
serve the folder from your computer and point a board at it on the console:

```bash
cd firmware/assets/weather && python3 -m http.server 8000
# board console:
weather install http://<your computer's IP>:8000/
weather            # settings, pack, forecast and what it would say
weather play 0     # play the report on line 0 (handset off-hook)
```

## Web UI screenshots for the docs

`screenshot_webui.py <board-ip>` (macOS, needs Google Chrome) saves every
page to `docs/pics/` as `status.png`, `recordings.png` and
`settings-<tab>.png`, overwriting the previous set. It replaces the board's
Wi-Fi name and setup password with placeholders before capturing.

## Audio path on SMD2 (ES8388)

- **RX (mic/line-in):** LIN1 = Line 0, RIN1 = Line 1 — independent left/right
  ADC channels, both digitize simultaneously every I2S frame. (Originally
  Line 1's rx was wired into LIN2, sharing Line 0's left channel via a mux,
  with RIN1/RIN2 dead/grounded — bodge-fixed by moving Line 1's rx to RIN1;
  see `archive/hardware/smd2.md` and the comment in
  `firmware/components/es8388/include/es8388.h`.) `capture` and `loopback`
  see both lines' incoming audio at once.
- **TX (playback):** LOUT1 = Line 0, ROUT1 = Line 1, and both play back
  simultaneously (no mux limitation on this side) — `tone`/`dtmf_gen`/etc.
  work on both lines at once.
- **Debug header J5:** a 3-pin header (LOUT2, ROUT2, GND) for bench-testing
  with headphones. Per the ES8388 datasheet, LOUT2/ROUT2 always carry the
  same left/right mix as LOUT1/ROUT1 — it's a monitor tap of the same two
  lines' tx audio, not an independent signal.

## Manual console reference

If you'd rather drive the console by hand (`idf.py monitor` or any serial
terminal at 115200 8N1), the commands used by the scripts above are:

```
board_info
i2c_scan
codec_detect
codec_init
codec_dump
tone <hz> <ms> <line>
capture <ms>
loopback <line> <0|1>
dtmf_gen <digits> <line>
dialtone|ringback|busy <line>
silence <line>
slic <line> <pd|fr|rm> <0|1>
ring <line> <secs>
hookmon <secs>
status
```

For an audio pass-through test use `loopback` (a DSP/I2S loopback).

`echopulse <line> <on|off> [period_ms]` — periodic timestamped test tone
for characterizing hybrid/line echo on real hardware (oscilloscope or ear,
not a log-timestamp exercise). See [`../../archive/ECHO_DEBUGGING.md`](../../archive/ECHO_DEBUGGING.md).
