sdylewski/Analog-Redial/archive/VERIFY_2026-10.md

# To verify: changes of 2026-10-04 .. 2026-10-10

Everything below was built (all board variants) and, where noted, tested on
one SMD4 board with 8 MB flash over curl and the serial console. What was
*not* done is a person at the phone, a second board, a card in the slot, a
real browser, or any Bluetooth module. Tick items off as you go; put results
in the commit that fixes anything.

Priority: **A** can bite a working board. **B** needs the hardware you have.
**C** needs hardware that hasn't arrived. **D** is housekeeping.

## Status 2026-10-11 (dualphone2, SMD4 16 MB, over an iPhone hotspot)

Proven, with curl: Origin guard (same-origin 303, other site and `null` 403);
web password set / refuse / Basic / cookie / secret script / remove; wrong
board and wrong flash-size images refused with 400; OTA of a correct image
twice (both slots); recordings and name survive an update; `/api/status`
fields (`reset_reason`, `bt_module`, `voip_server_found`). Over serial:
`test_mcu`, `test_codec`, self-test (1 line + microSD confirmed), `sd_test`,
`bk_selftest`, `webpass`.

Still open from this list: everything that needs a handset (section B), the
web password and the Origin guard **in a real browser**, rescue-mode and
10 s-hold password reset, the VoIP provisioner on the PBX, Bluetooth
hardware, and the SMD5 board. The ESP-IDF `reset_reason` reports 11 (USB)
after a software restart on this board; harmless but worth a look.

## Status 2026-10-12: web UI memory and watchdog (dualphone2, SD card mounted)

Before the change, on the board: 64-68 KB free at idle; Dial Codes and
Diagnostics returned **HTTP 500** (they needed 37-50 KB in one block); a
firmware upload was refused once for lack of a buffer; eight browsers took
the low-water mark to 4 KB; two unexplained freezes on 2026-10-11.

After pages were streamed in 4 KB chunks (`7f8ec64`), measured over Wi-Fi:
- All 11 pages answer; contents identical to before (digits ignored) except
  live idle-power text. Dial Codes (8.3 KB) and Diagnostics (22.6 KB) now work.
- Idle free heap 74-79 KB (was 64-68 KB).
- 8 clients, 30 s, on General, Dial Codes, Diagnostics and Recordings: 41 OK,
  2 client-side timeouts (queued behind others); low-water mark 33.6 KB
  (was 4 KB with lighter pages).
- Watchdog does not false-trigger: a 150 s download at 2 KB/s (threshold
  ~100 s) left uptime continuous.
- Time zone changes: 51 changes, incl. 41 under load, no hang.

Not yet done: the watchdog **firing** on a really frozen server
(`webhang yes` from a serial console; expect `webui watchdog` lines, a
restart in ~100 s, and "Restarted: the web server stopped answering" in the
activity log). The cause of the two freezes is still not identified; memory
exhaustion is the leading suspect, not proven.

## Call recording (2026-10-16, dualphone2)

New `callcap` component + Diagnostics card. Arm, pick up, hang up: writes
`call record YYMMDD HHMMSS.wav` to the microSD card (16 kHz stereo; left =
uplink, right = what the earpiece hears). Name is 29 characters: the
requested "call recording ..." is 32 and storage's limit (also baked into the
saved dial-code and prompt tables) is 31.

Tested with test-mode injection and loopback on dualphone2 (MQTT connected,
~58 KB free): arm/arm-again/cancel; a 20.5 s call gave a 20.5 s file (timing
exact), right channel carried the 350 Hz dial tone then the operator clip;
valid 2-channel header; memory returned to baseline after. The first build used
one 24 KB stream buffer and failed silently (largest free block was 19 KB):
now ten 2 KB chunks. Dropped audio (a slow card) is written as silence so the
file keeps real time, and the activity log says how much.

- [ ] With a real handset: dial tone from the instant of pickup, touch-tone
      digits on the left channel, ringback and the far end on the right.
- [ ] Rotary dial clicks: do they show on either channel at all?
- [ ] A long call (5 min): check for "lost to a slow card" and file size.
- [ ] Pull the card mid-call: the file should keep what reached the card.
- [ ] Incoming call: recording starts at pickup, not at ring (by design).
- [ ] Memory: the call starts ~24 KB; fine at 58 KB free, untested lower.

## Memory: player stack, header buffer, AEC, RTP (2026-10-14, dualphone2)

Measured over Wi-Fi (free / largest block, KB):

| | MQTT off | MQTT on |
|---|---|---|
| Idle, before | 76 / 29 | 59 / 29 |
| Idle, after | 83 / 49 | 64 / 36 |
| Playing a WAV, before | 35 / 15 | 17 / 11 |
| Playing a WAV, after | 71 / 43 | 53 / 27 |
| Playing the old dialup.mp3 (OTA'd board) | 33 / 15 | 16 / 11 |

What changed: WAV clips get a 6 KB player stack (MP3 keeps 28 KB) and a 1 KB
read buffer (the header is found by walking chunks, not an 8 KB scan);
AEC's 6.8 KB of buffers are allocated on first enable; 412 ships as 8 kHz
u-law WAV (314 KB, 1 MB bundled image builds); RTP tasks at priority 6
(above httpd) and a failed task start ends the call instead of connecting
it with one-way audio. The SIP task already exits when VoIP is off.

Tested: dial 0 (bundled 16-bit WAV), dial 412 falling back to the bundled
dialup.mp3, a u-law WAV and an afconvert WAV with a 4 KB FLLR chunk (as a
temporary operator.wav, deleted after) all play.

- [x] 2026-10-14 dualphone2: `first_setup.py --only network clips verify`
      uploaded dialup.wav and pointed 412 at it (new /dialcode_set_file);
      dial 412 played it (69 / 40 KB free / largest while playing, against
      33 / 15 with the MP3). The bundled dialup.mp3 is still in `bundled`
      (read-only; it goes at the next USB flash).
- [ ] USB-flash a board so `bundled` holds dialup.wav; dial 412 plays the
      u-law clip via the .mp3 -> .wav fallback (saved code still says .mp3).
- [ ] Decide whether to stop baking dialup.wav into the firmware and rely on
      first_setup.py's `clips` step alone (frees 314 KB of the bundled
      partition; boards nobody runs the script on lose 412).
- [ ] Listen: u-law dial-up and resampling in 256-sample pieces sound right.
- [ ] A VoIP call while a big page loads or a file downloads: no choppy audio.
- [ ] The low-water mark still reaches ~8.5 KB at times (uploads, the MP3
      path with MQTT on); worth finding what else dips it.

## Review fixes + HA codes, message waiting, quiet-hours ring (2026-10-13, dualphone2)

Tested over Wi-Fi with test-mode injection and Mosquitto: HA code 42 added,
conflicting 21 refused; lift + dial 42 gave offhook/dial 42/onhook over MQTT
(through the new event queue) and "dial code 42 for Home Assistant"; dial 211
x3 left messages, count 1 -> 2, MQTT "Mark messages heard" -> 0, Recordings
page view -> 0, each with a `recording` event "message rec_....wav"; ring
with quiet hours on -> skipped (logged), box unticked -> rang 2 s and
stopped; line 1 on a 1-line board and a lifted handset both refused;
Diagnostics test ring rang and stopped; MQTT re-save with blank password kept
it (same broker/user). Two OTAs on the sequential-erase handler: no stall.

Found while testing, fixed: with MQTT connected, every bundled clip (8 kHz)
failed to play ("resample buffer alloc failed": one 24 KB block, 27 KB for
MP3) and the line then sat in PLAYING forever because the player never
called back on a failure. Resampling is now in 256-sample pieces (~3 KB) and
a failed clip still ends. Also: OTA erased the whole 2 MB slot up front in
the web server task (task watchdog warning, one dropped upload).

- [ ] A real handset: pick up during a Home Assistant ring stops it; a real
      incoming call during a HA ring keeps ringing after the HA timer.
- [ ] Two-line board: ring line 1 then line 2 at once; both stop.
- [ ] Answering-machine message (caller hangs up) counts as a new message
      and sends `recording` "voicemail ...".
- [ ] Webhook `answering_machine` event name arrives in full.
- [ ] Clips sound unchanged after the resampling change (operator, 412 MP3).
- [ ] Old saved pin codes (4-slot table) survive the update to 8 slots.

## Home Assistant MQTT (2026-10-13, tested against Mosquitto on dualphone2)

Done: enable/disable from the card; 7 discovery messages valid JSON;
line state, attributes, RSSI and heap published; `cmd/ring/0` rang the
line; a test event arrived on `.../event`; 5 on/off toggles with no leak;
wrong password stays "connecting"; bad host refused with 400; 12 cycles of
wrong-password then restart with no crash (see below). Connected cost
about 21 KB of heap, +46 KB flash.

Found and fixed: esp-mqtt (IDF 5.2.8) writes `client->state` after
`esp_mqtt_client_stop()` returns, so destroying the client at once corrupts
whatever reuses the memory (crashed 1 time in 4 on stop-then-start while
retrying a refused login). `stop()` now waits 300 ms before destroying.

- [ ] Against a real Home Assistant: the device appears; Ring button; the
      event entity fires on dial; the line sensor changes on pickup.
- [ ] A pin button (needs the card out, 1-line board).
- [ ] Line state publishing with a real handset (not exercised: no phone).
- [ ] Broker restart: the board reconnects on its own within ~10 s.

## Home Assistant webhook (2026-10-13, built, never run)

- [ ] Settings → General → Webhook: save an `http://` URL, **Send test
      event**; a `test` POST arrives (`nc -l 8123` on the laptop is enough).
      `https://` is refused with a 400.
- [ ] Lift, dial a code, hang up: `offhook`, `dial` (digits), `onhook` in order.
      An unknown number gives `wrong_number`.
- [ ] Incoming VoIP / line-to-line ring gives `ring` with the caller;
      a saved message gives `recording`.
- [ ] Unreachable URL: phone behaviour unaffected (posts run on their own
      task, 4 s timeout); `/api/status` `webhook_last_status` goes negative.
- [ ] Signed out with a web password set: the card hides the URL.
- [ ] The YAML in `docs/home-assistant.md` against a real Home Assistant.
- [ ] Heap after enabling: expect ~6 KB less (4.6 KB task stack + queue).

## A. Regression risk on boards that already work

- [x] **16 MB board and a fresh flash.** The OTA slots grew to 2 MB
      (`9596baa`) with explicit offsets so `storage` and `bundled` keep
      their addresses. Only the 8 MB layout was exercised. On a 16 MB board:
      flash over USB (OTA can't change the table), confirm recordings and
      dial codes survive, then do one OTA update.
      *Done 2026-10-11: flashed over USB, then two OTA updates on the 16 MB dualphone2; booted, recordings and settings kept.*
- [ ] **Every Settings form still saves in a real browser.** Every POST now
      checks `Origin` (`9ac1d3a`). curl sends no Origin, so this path never
      ran with real headers. Try each tab's Save, the volume sliders,
      voice-effect buttons, Start pairing, firmware upload, and loading the
      page by `.local` name, by IP, and via any alias or proxy you use.
- [ ] **BM64 still works** if you have one wired. `bt_companion.c` now
      dispatches on module type (`6ce8cc2`): enable/disable, status,
      pairing, accept/reject/hang up, dial-out, the EEPROM check.
- [ ] **A board that had "BM64 fitted" saved** still reads as BM64 after
      the update (the old flag is migrated, not cleared): Settings →
      Hardware shows *BM64 module fitted*, Bluetooth tab shows the module.
- [ ] **Setup password / `gen_prompt.py --sync`** still work (the card now
      hides the password and its generate-commands until you're signed in,
      but only when a web password is set).

## B. Fixes that need a person and a phone

- [ ] **Barge-in** (`c6abae9`): let a call go to the answering machine,
      pick up during the greeting, both sides hear each other. Local and via
      VoIP. Also a very quick re-pickup after hang-up: dial tone intact.
- [ ] **Ring safety** (`9df5d61`): lift a handset, run the self-test ringer
      check on that line: no ring voltage in the earpiece. Then a normal
      incoming call still rings, and answering stops the ring.
- [ ] **Loop polarity after ringing** (`102d817`): answer several incoming
      calls; each should be clean (about half used to be reversed).
- [ ] **Incoming VoIP call** (SIP only from the server, `c6abae9`): call
      1005 from 101–104 and answer. Spoofed INVITEs from other hosts were
      ignored; a real one from the server was never tested.
- [ ] **Files with spaces and symbols**: upload `Tom & Jerry.wav`; play it,
      download it, delete it from Storage and from Recordings; bulk-delete
      a mix of names.
- [ ] **Dial-code upload** (`1b844ee`, and the open item in memory that the
      new-code path was never tried on hardware): add a clip named
      `operator.wav` and a second `song.wav` — neither may overwrite the
      other, and a rejected code must not leave a file behind.
- [ ] **Wi-Fi/VoIP passwords with symbols** (`f5327ef`): save a
      full-length password with `& % + "` and confirm it connects/registers.
- [ ] **Long file lists**: with more than 64 recordings (an SD card), the
      Recordings/Storage pages show the *newest*.
- [ ] **Restart reason**: pull power, then trigger a crash or watchdog if
      you can; Recent activity and `/api/status` (`reset_reason`) say why.
- [ ] **Doubled digits from memory redial** (review "not changed"): store a
      number like `5551005` on a push-button phone and redial; if digits go
      missing, the same-digit lockout (~205 ms) is too long.

## B2. SD card

- [x] **Pull the card mid-playback** (`59fb0a6`): no crash; playback ends;
      storage falls back to internal flash; reinserting remounts.
      *Done 2026-10-11: dualphone2: read errors, "card removed", no crash/reboot, auto-remount, card data intact. The wait-for-users branch was not exercised.*
- [ ] Also pull it during a recording, a web upload and a download.
      Expect the operation to fail cleanly, not hang or reboot.
- [ ] Look for `unmounting with N user(s) still active` in the log; if it
      appears, something held the card longer than the 5 s allowance.

## B3. Web password (`d6b999d`)

- [ ] In a real browser: set a password, submit a form while signed out →
      sign-in page → returns to the page, make the change again; sign out;
      30-day cookie survives closing the browser.
- [ ] Password persists across a reboot; sessions don't (sign in again).
- [ ] **Rescue mode** (BOOT 3 s): the board's own network shows the full
      UI with no sign-in and a working *Remove password*. **Not tested.**
- [ ] **10 s hold** removes the password along with the Wi-Fi networks.
      **Not tested.**
- [ ] **The automatic setup network** (no saved Wi-Fi reachable) must NOT
      skip the password. **Not tested** (it's the case that matters).
- [ ] `webpass clear` from the serial console (tested).
- [ ] Lockout: 5 wrong passwords → 30 s refusal, then doubling. Check the
      message in the sign-in page; confirm a right password during lockout
      is also refused.
- [ ] Scripts: `gen_prompt.py --password`, `first_setup.py`,
      `test/verify.py`, `keep_bundled_audio.py` with `REDIAL_PASSWORD` set.
      Only `gen_prompt.py --upload` was run.
- [ ] `docs/setup.md` wording about the web password reads right.

## B4. VoIP provisioner

- [ ] On the PBX host: run the pending
      `sudo install -m 755 ~/redial-provisioner-install/redial_provisioner.py /opt/redial-provisioner/ && sudo systemctl restart redial-provisioner`.
- [ ] Disable the old `rotary-voip-provisioner` service.
- [ ] Keyed register + a call test with an enrolled board end to end.
- [ ] Generated setup script (`8c9b38f`): run it on the PBX with a board
      name containing `$(...)`, a quote and a space; confirm nothing runs
      and the SIP password with `$` is written correctly.
- [ ] HTTPS to your internet server: the certificate bundle is now the
      *common* set (to fit flash). Check the board can reach the real
      server's CA before relying on it.

## C. Bluetooth (no module has been on a board yet)

- [ ] `firmware/test/host/run.sh` on your machine → `36 checks, 0 failed`.
      (Quirk: a binary built straight from the repo tree hung at launch on
      the machine this was written on; the script builds from a copy.)
- [ ] Hardware tab: the three-way module select saves and reloads;
      `first_setup.py --bt-module bt401` sets it.
- [ ] **BT401 bring-up**: follow `archive/hardware/bt401.md` (9 open
      questions): `bt401_probe`, pair, incoming call, answer, hang up.
- [ ] **BT401 dial-out**: `bt401_dial <your other phone>`, then "1 + number"
      from the handset.
- [ ] **3.3 V supply**: scope VBAT at J2 pin 1 under load; swap U5 for a
      3.6 V XC6206 variant if it's marginal (check LCSC stock first).
- [ ] **BM64 carrier programming leads**: carrier J2 pin 1 → J5 pin 3,
      pin 2 → J5 pin 5, shunts pulled.
- [ ] **Module auto-detect** and **wrong-jumper self-check**: ideas only,
      in `archive/FEATURE_IDEAS.md`.

## C2. SMD5 board (not powered yet)

- [ ] Work through the checklist in `archive/hardware/smd5.md`.
- [ ] Deliberately mis-jumper one board (clone + default JP3) and record
      what you see: expected is no audio, codec still answers on I²C.
- [ ] Confirm which firmware each module/jumper combination needs
      (`smd5` vs `smd5_cheap`) and that `flash_board.py --board smd5` works
      on a blank board.
- [ ] 8 MB vs 16 MB parts on SMD5.

## D. Files and documents

- [ ] **The v5 file is not the board that was fabbed.** The fab zip was
      made from the Oct 5 07:00 save; the current `Analog Redial v5.*` is
      the Oct 7 edit: silkscreen text, 14 THT parts now in BOM/position
      files, **46 holes 0.8 → 1.0 mm**, one rotation, RJ12 footprint. The
      as-fabbed file is in git at `d18d89c`. If you reorder, you get these
      changes, so confirm each is intended.
- [ ] Silkscreen text: "Analog Redial 5" vs "v5" (you said you'd do this).
- [ ] The RJ12 3D model path is absolute (`/Users/…/KiCad/Custom/…`).
- [ ] Docs images: `docs/hardware-smd5.md` uses `V5_board_front.png` with
      the alt text "SMD5 PCB bottom"; `docs/board.md` links
      `../docs/pics/v6_board_front.png`. `v6_board_3d.png` and
      `v6_board_rear.png` aren't referenced anywhere.
- [ ] Preview the GitHub Pages site once (links, thumbnails).
- [ ] Shared KiCad library `~/Documents/KiCad/Custom/` (3D models you
      added) isn't in this repo; commit it in its own repo if wanted.
- [ ] Decisions left open in `archive/CODE_REVIEW_2026-10.md` ("Not
      changed — worth a decision": same-digit lockout, ringer self-test
      ending a real ring, RTP source address, small input nits).
- [ ] The 16 MB board you plugged in on Oct 9 (MAC `ac:eb:e6:c0:b6:5c`)
      still has older firmware; none of this has run on it.
