sdylewski/Analog-Redial/PayPhone/Payphone_coin_board_v1/Payphone_coin_board_v1_schematic.pdf

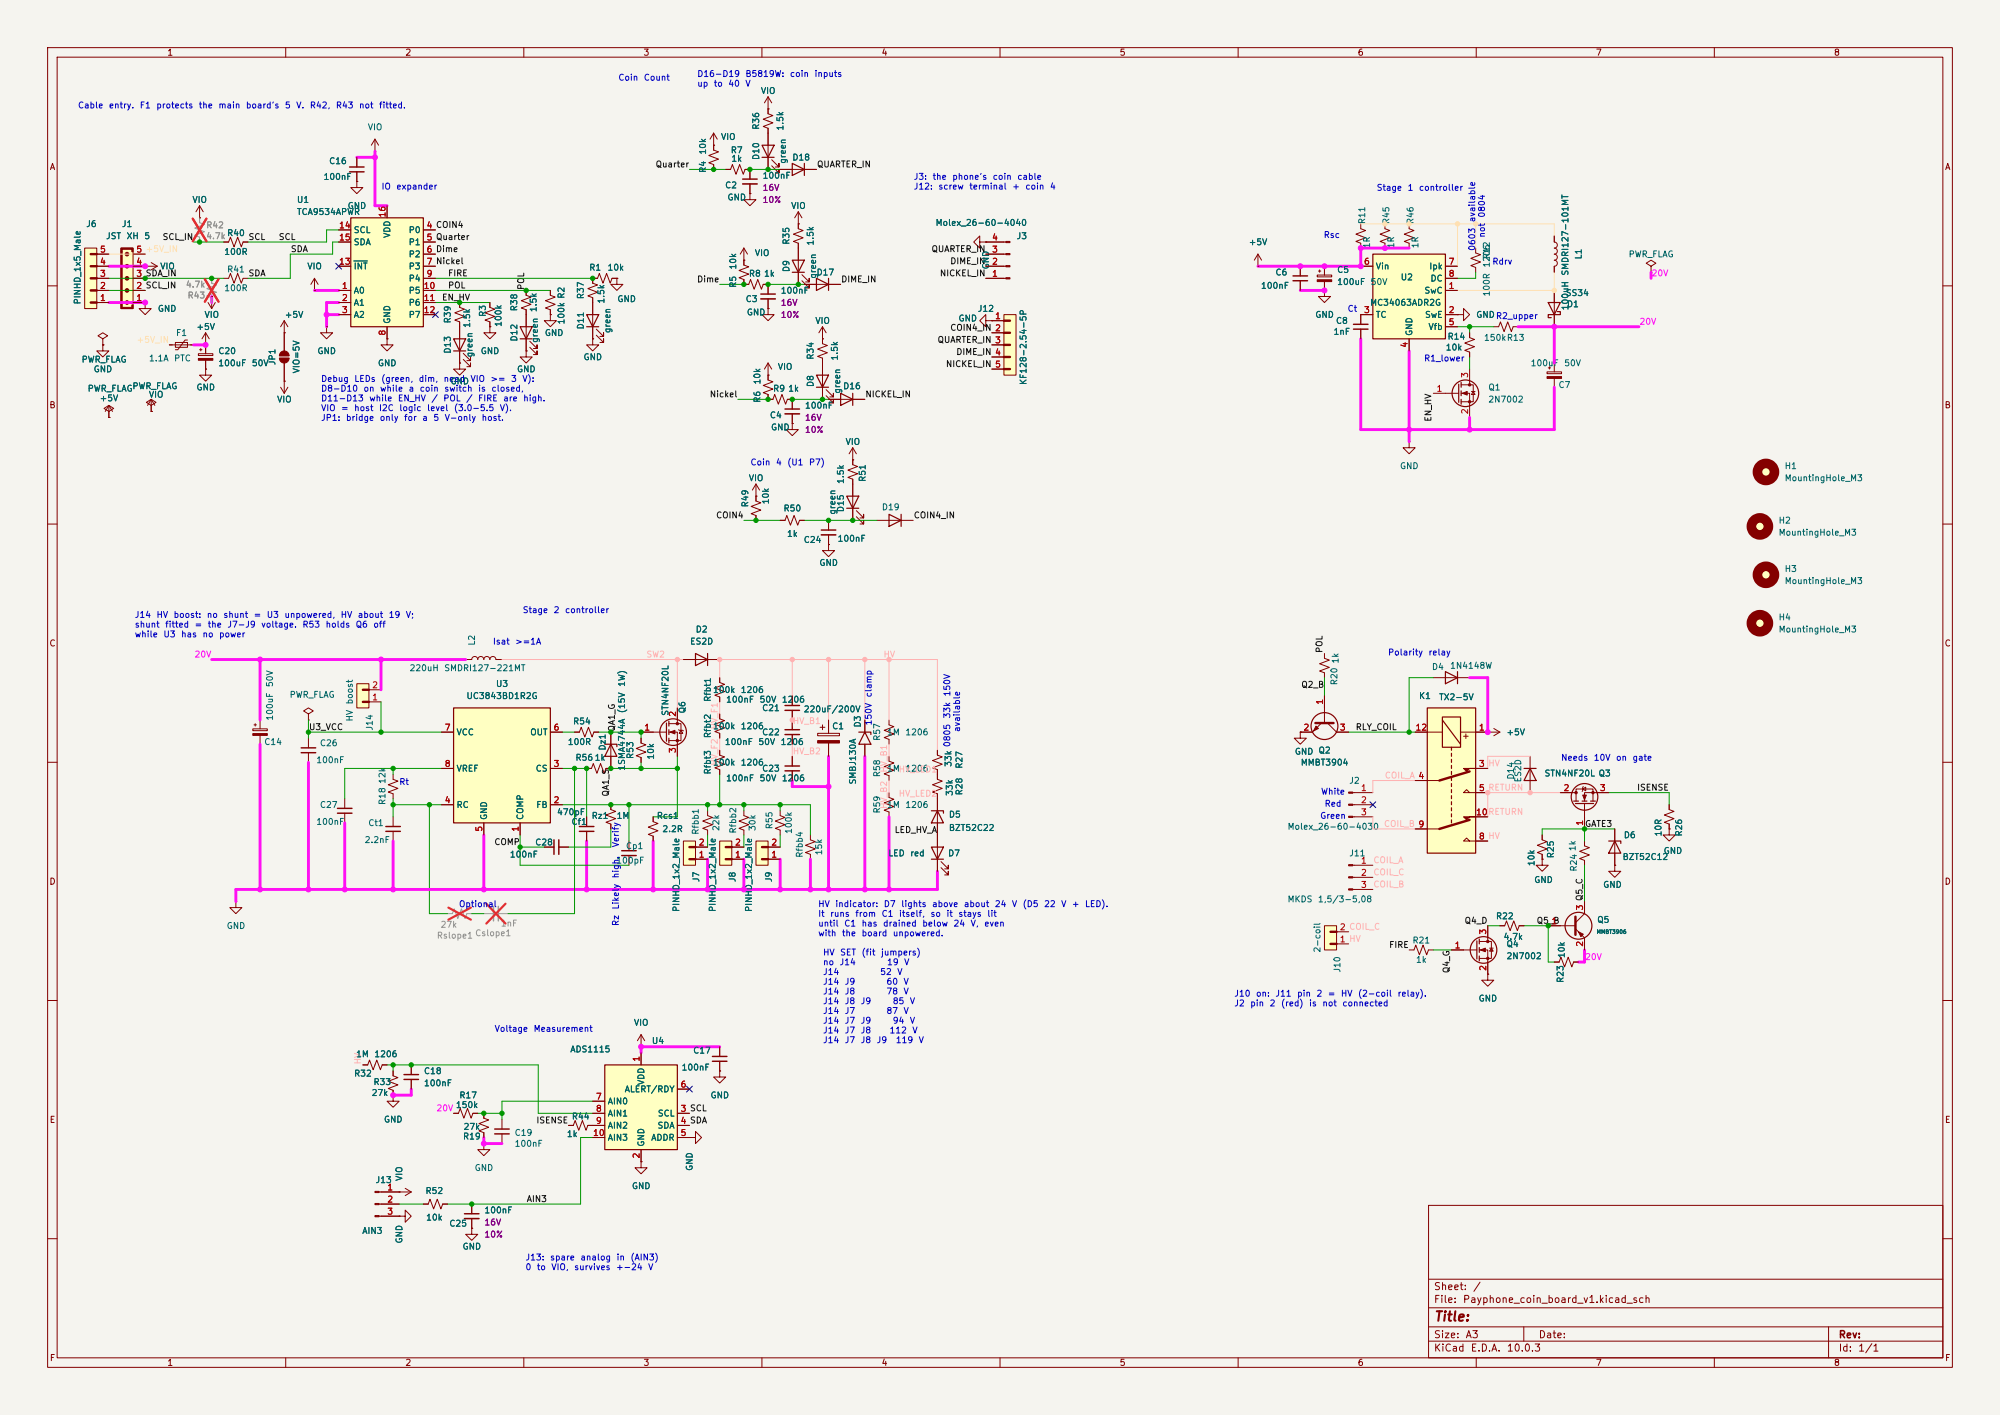
[picture p111: page 1]

D16-D19 B5819W: coin inputs up to 40 V

Cable entry. F1 protects the main board's 5 V. R42, R43 not fitted.

J3: the phone's coin cable
J12: screw terminal + coin 4

Polarity relay White Green Optional

It runs from C1 itself, so it stays lit until C1 has drained below 24 V, even with the board unpowered.

J10 on: J11 pin 2 = HV (2-coil relay). J2 pin 2 (red) is not connected

Size: A3 | Rev: | F Date:
KiCad E.D.A. 10.0.3 | Id: 1/1
