sdylewski/Analog-Redial/hardware/kicad/Analog Redial v6/Analog_Redial_v6_schematic.pdf

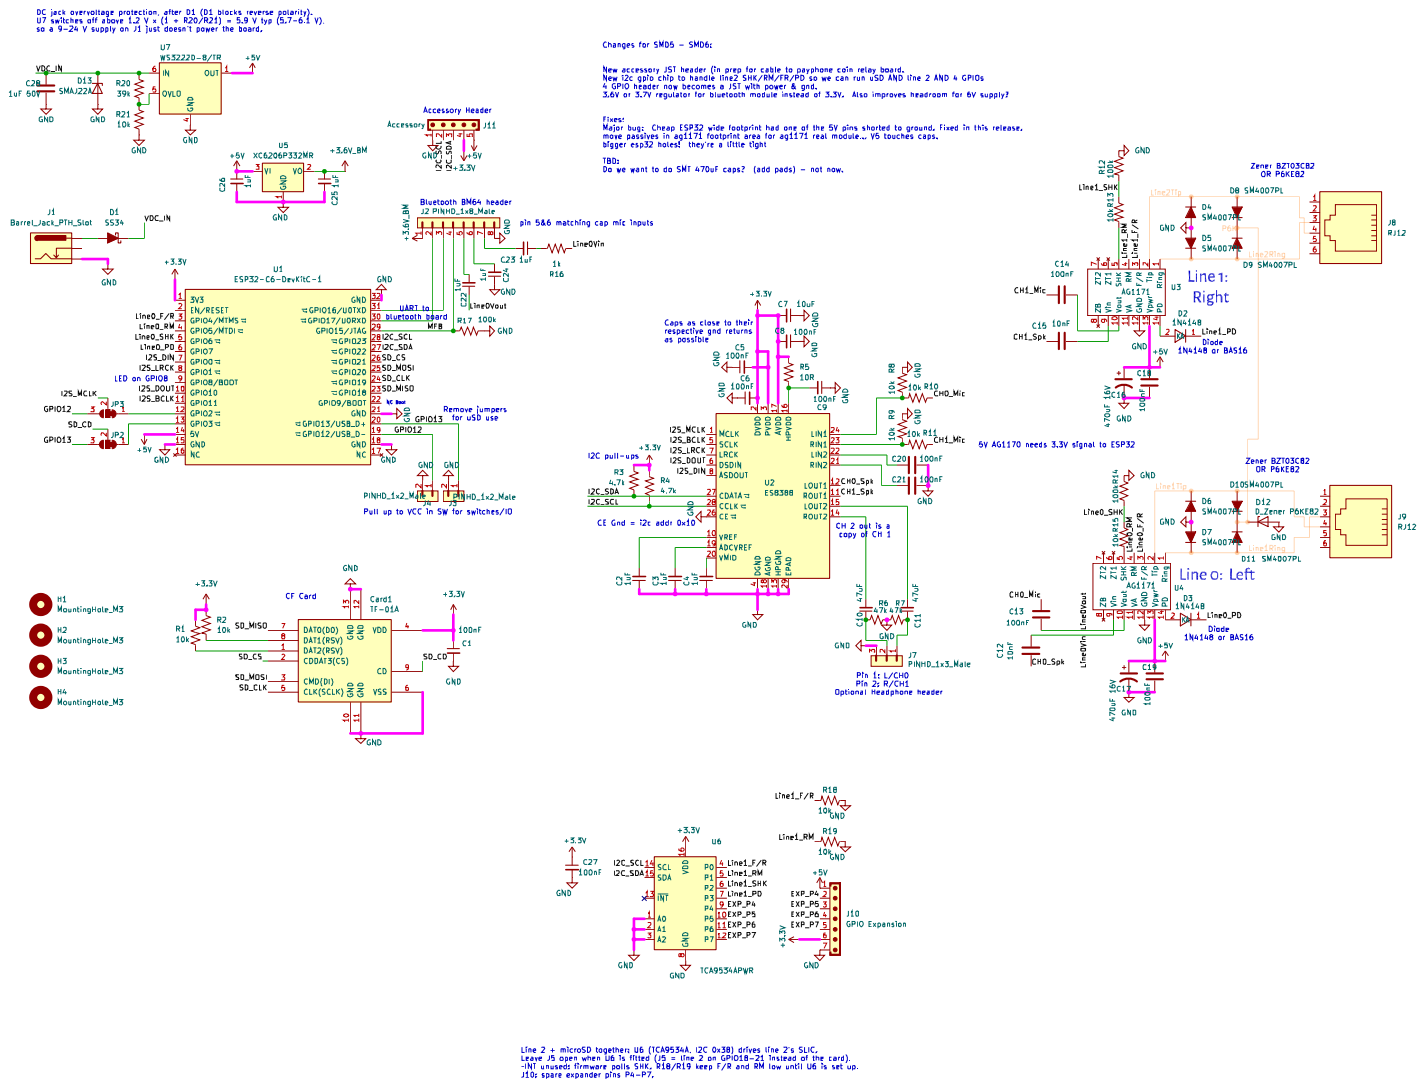
[picture p112: page 1]
