sdylewski/Analog-Redial/hardware/kicad/Analog Redial v2/Print Schematic.pdf

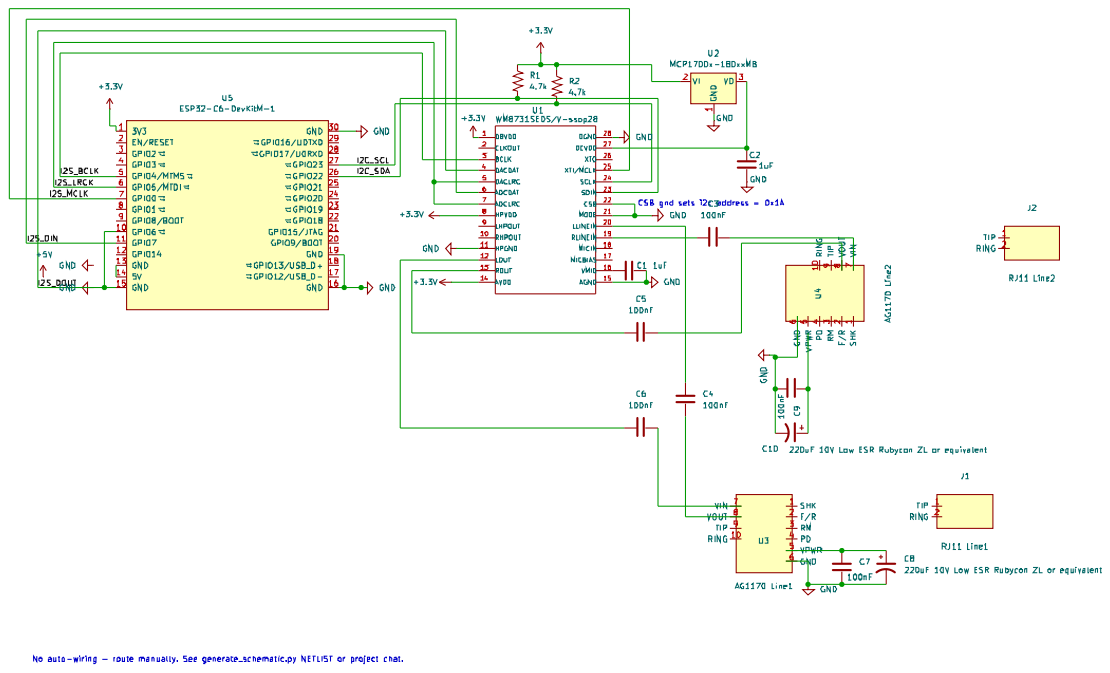
[picture p113: page 1]
