sdylewski/Analog-Redial/hardware/kicad/Analog Redial v6/Analog Redial v6.kicad_pcb

## KiCad design hardware/kicad/Analog Redial v6/Analog Redial v6.kicad_pcb (2026-11-13)

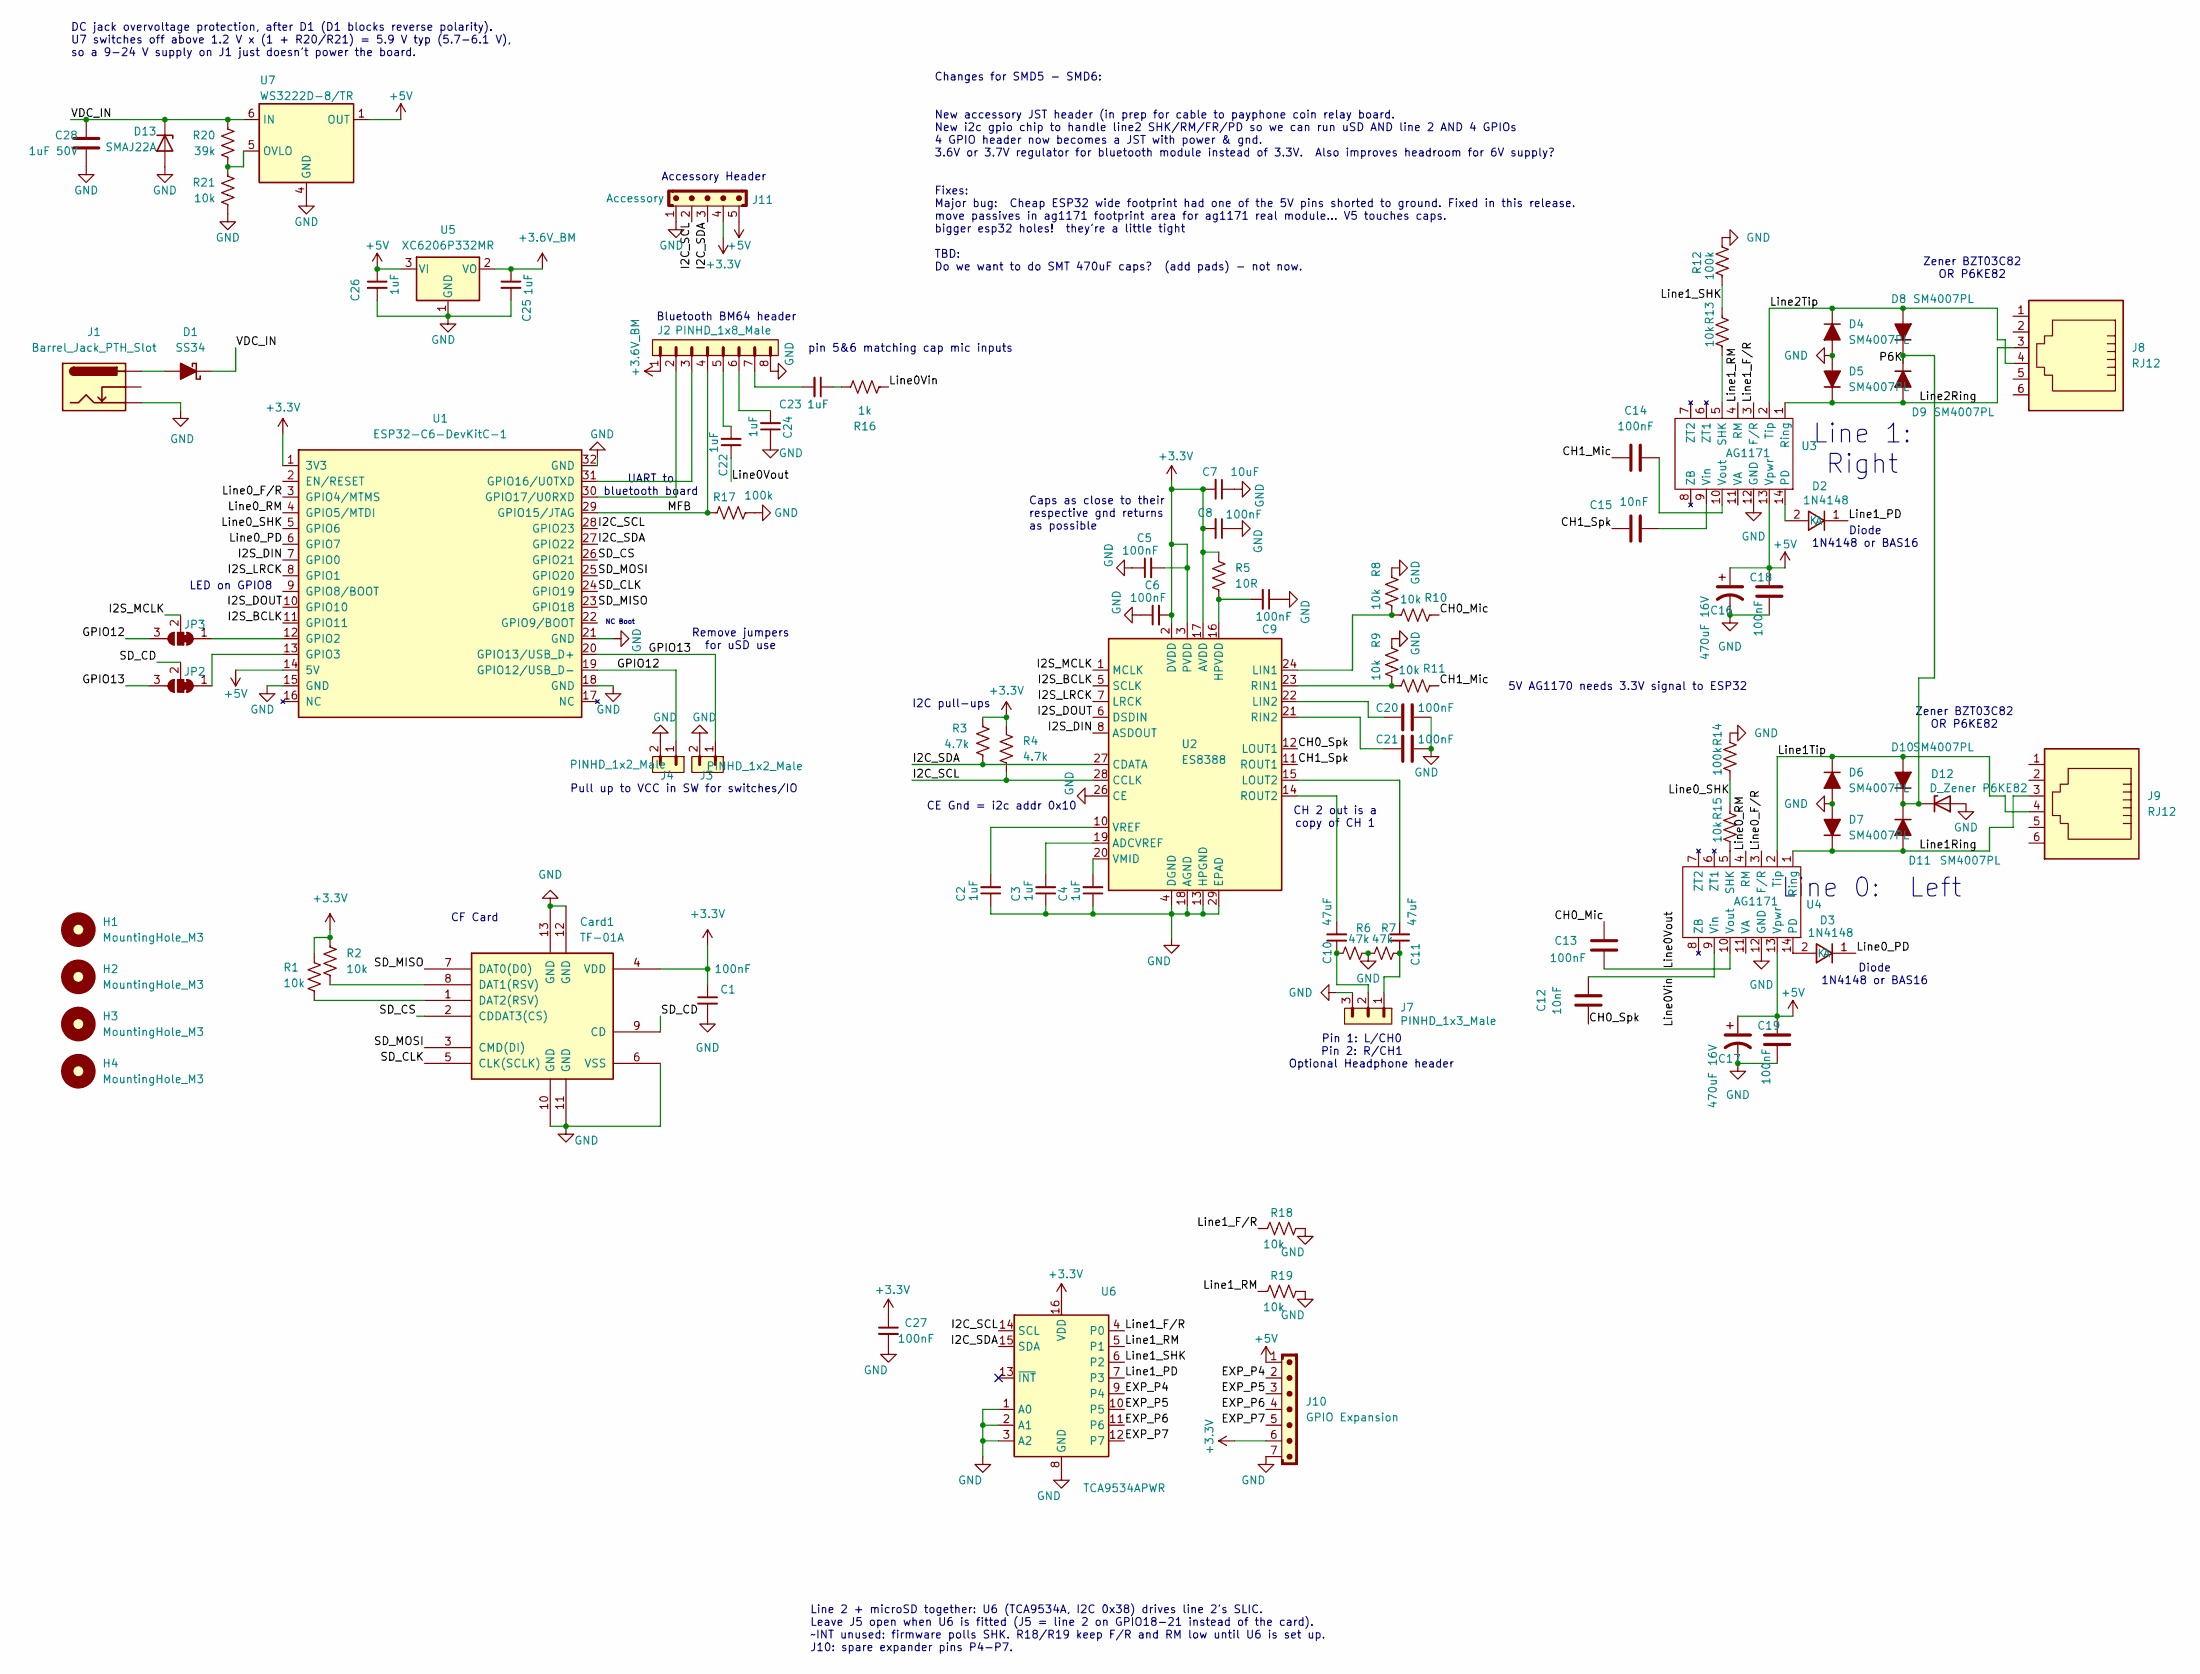
[picture p114: schematic Analog Redial v6.kicad_sch]

Parts:
C1, C5, C6, C8, C9, C27: 100nF; C_0402_1005Metric; Voltage 1kV; Tolerance 100%
C2, C3, C4, C22, C23, C24, C25, C26: 1uF; C_0402_1005Metric; Voltage 1kV; Tolerance 100%
C7: 10uF; C_0402_1005Metric; Voltage 1kV; Tolerance 100%
C10, C11: 47uF; C_Disc_D4.7mm_W2.5mm_P5.00mm; Voltage 1kV; Tolerance 100%
C12, C15: 10nF; C_0402_1005Metric
C13, C14, C18, C19, C20, C21: 100nF; C_0402_1005Metric
C16, C17: 470uF 16V; CP_Radial_D8.0mm_P3.50mm
C28: 1uF 50V; C_1206_3216Metric; LCSC C1848
Card1: TF-01A; Manufacturer Part TF-01A; LCSC C91145
D1: SS34; D_SMA
D2, D3: 1N4148; 1N4148W_C81598; Manufacturer Part 1N4148W; LCSC C81598
D4, D5, D6, D7, D8, D9, D10, D11: SM4007PL; Nexperia_CFP3_SOD-123W
D12: D_Zener P6KE82; D_DO-41_SOD81_P10.16mm_Horizontal
D13: SMAJ22A; D_SMA
H1, H2, H3, H4: MountingHole_M3; MountingHole_3.2mm_M3
J1: Barrel_Jack_PTH_Slot; Barrel_Jack_PTH_Slot_tight
J2: PINHD_1x8_Male; PinHeader_1x08_P2.54mm_Vertical
J3, J4: PINHD_1x2_Male; PinHeader_1x02_P2.54mm_Vertical
J7: PINHD_1x3_Male; PinHeader_1x03_P2.54mm_Vertical
J8, J9: RJ12; RJ12_Amphenol_87180_Horizontal
J10: GPIO Expansion; JST_XH_B7B-XH-A_1x07_P2.50mm_Vertical
J11: Accessory; JST_XH_B5B-XH-A_1x05_P2.50mm_Vertical
JP2, JP3: Jumper_3_NC-1_Trace_NoSilk
R1, R2, R8, R9, R10, R11, R13, R15, R18, R19: 10k; R_0402_1005Metric
R3, R4: 4.7k; R_0402_1005Metric
R5: 10R; R_0402_1005Metric
R6, R7: 47k; R_0402_1005Metric
R12, R14, R17: 100k; R_0402_1005Metric
R16: 1k; R_0402_1005Metric
R20: 39k; R_0402_1005Metric; LCSC C25783
R21: 10k; R_0402_1005Metric; LCSC C25744
U1: ESP32-C6-DevKitC-1; ESP32-C6-DevKitC-dual
U2: ES8388; QFN-28-1EP_4x4mm_P0.45mm_EP2.6x2.6mm
U3, U4: AG1171; AG1171_SIL
U5: XC6206P332MR; SOT-23-3
U6: TCA9534APWR; TSSOP-16_4.4x5mm_P0.65mm; Manufacturer Part TCA9534APWR; LCSC C206010
U7: WS3222D-8/TR; WS3222D_WDFN-8_2x2mm_P0.5mm; LCSC C239703

Connections:
+3.3V: C1.1, C5.2, C6.2, C7.2, C8.2, C27.1, Card1.4 (VDD), J10.6, J11.4, R1.2, R2.1, R3.1, R4.1, R5.1, U1.1 (3V3), U2.2 (DVDD), U2.3 (PVDD), U2.17 (AVDD), U6.16 (VDD)
+3.6V_BM: C25.1, J2.1, U5.2 (VO)
+5V: C16.1, C17.1, C18.1, C19.1, C26.1, J10.1, J11.5, U1.14 (5V), U3.13 (Vpwr), U4.13 (Vpwr), U5.3 (VI), U7.1 (OUT), U7.2 (OUT), U7.3 (OUT)
/CH0_Mic: C13.1, R10.1
/CH0_Spk: C12.1, U2.12 (LOUT1)
/CH1_Mic: C14.2, R11.1
/CH1_Spk: C15.2, U2.11 (ROUT1)
/EXP_P4: J10.2, U6.9 (P4)
/EXP_P5: J10.3, U6.10 (P5)
/EXP_P6: J10.4, U6.11 (P6)
/EXP_P7: J10.5, U6.12 (P7)
/GPIO12: J4.1, JP3.3 (B), U1.19 (GPIO12/USB_D-)
/GPIO13: J3.1, JP2.3 (B), U1.20 (GPIO13/USB_D+)
/I2C_SCL: J11.2, R4.2, U1.28 (GPIO23), U2.28 (CCLK), U6.14 (SCL)
/I2C_SDA: J11.3, R3.2, U1.27 (GPIO22), U2.27 (CDATA), U6.15 (SDA)
/I2S_BCLK: U1.11 (GPIO11), U2.5 (SCLK)
/I2S_DIN: U1.7 (GPIO0), U2.8 (ASDOUT)
/I2S_DOUT: U1.10 (GPIO10), U2.6 (DSDIN)
/I2S_LRCK: U1.8 (GPIO1), U2.7 (LRCK)
/I2S_MCLK: JP3.2 (C), U2.1 (MCLK)
/Line0Vin: C12.2, R16.1, U4.9 (Vin)
/Line0Vout: C13.2, C22.1, U4.10 (Vout)
/Line0_F/R: U1.3 (GPIO4/MTMS), U4.3 (F/R)
/Line0_PD: D3.1 (K), U1.6 (GPIO7)
/Line0_RM: U1.4 (GPIO5/MTDI), U4.4 (RM)
/Line0_SHK: R14.2, R15.1, U1.5 (GPIO6)
/Line1Ring: D7.1 (K), D11.2 (A), J9.3, U4.1 (Ring)
/Line1Tip: D6.1 (K), D10.2 (A), J9.4, U4.2 (Tip)
/Line1_F/R: R18.2, U3.3 (F/R), U6.4 (P0)
/Line1_PD: D2.1 (K), U6.7 (P3)
/Line1_RM: R19.2, U3.4 (RM), U6.5 (P1)
/Line1_SHK: R12.2, R13.1, U6.6 (P2)
/Line2Ring: D5.1 (K), D9.2 (A), J8.3, U3.1 (Ring)
/Line2Tip: D4.1 (K), D8.2 (A), J8.4, U3.2 (Tip)
/MFB: J2.4, R17.2, U1.29 (GPIO15/JTAG)
/P6K: D8.1 (K), D9.1 (K), D10.1 (K), D11.1 (K), D12.1 (K)
/SD_CD: Card1.9 (CD), JP2.2 (C)
/SD_CLK: Card1.5 (CLK(SCLK)), U1.24 (GPIO19)
/SD_CS: Card1.2 (CDDAT3(CS)), U1.26 (GPIO21)
/SD_MISO: Card1.7 (DAT0(D0)), U1.23 (GPIO18)
/SD_MOSI: Card1.3 (CMD(DI)), U1.25 (GPIO20)
/VDC_IN: C28.1, D1.1 (K), D13.1 (K), R20.1, U7.6 (IN), U7.7 (IN), U7.8 (IN)
GND: C1.2, C2.1, C3.1, C4.1, C5.1, C6.1, C7.1, C8.1, C9.1, C16.2, C17.2, C18.2, C19.2, C20.1, C21.1, C24.1, C25.2, C26.2, C27.2, C28.2, Card1.6 (VSS), Card1.10 (GND), Card1.11 (GND), Card1.12 (GND), Card1.13 (GND), D4.2 (A), D5.2 (A), D6.2 (A), D7.2 (A), D12.2 (A), D13.2 (A), J1.GND, J2.8, J3.2, J4.2, J7.3, J10.7, J11.1, R6.1, R7.2, R8.1, R9.1, R12.1, R14.1, R17.1, R18.1, R19.1, R21.2, U1.15 (GND), U1.18 (GND), U1.21 (GND), U1.32 (GND), U2.4 (DGND), U2.13 (HPGND), U2.18 (AGND), U2.26 (CE), U2.29 (EPAD), U3.12 (GND), U4.12 (GND), U5.1 (GND), U6.1 (A0), U6.2 (A1), U6.3 (A2), U6.8 (GND), U7.4 (GND), U7.9 (GND)
unnamed: C10.1, J7.2, R6.2
unnamed: C11.1, J7.1, R7.1
unnamed: C22.2, J2.5
unnamed: C23.1, R16.2
unnamed: C23.2, J2.7
unnamed: C24.2, J2.6
unnamed: Card1.8 (DAT1(RSV)), R2.2
unnamed: Card1.1 (DAT2(RSV)), R1.1
unnamed: D1.2 (A), J1.PWR
unnamed: D2.2 (A), U3.14 (PD)
unnamed: D3.2 (A), U4.14 (PD)
unnamed: JP2.1 (A), U1.13 (GPIO3)
unnamed: JP3.1 (A), U1.12 (GPIO2)
unnamed: J2.3, U1.31 (GPIO16/U0TXD)
unnamed: J2.2, U1.30 (GPIO17/U0RXD)
unnamed: C3.2, U2.19 (ADCVREF)
unnamed: C9.2, R5.2, U2.16 (HPVDD)
unnamed: R8.2, R10.2, U2.24 (LIN1)
unnamed: C20.2, U2.22 (LIN2)
unnamed: C11.2, U2.15 (LOUT2)
unnamed: R9.2, R11.2, U2.23 (RIN1)
unnamed: C21.2, U2.21 (RIN2)
unnamed: C10.2, U2.14 (ROUT2)
unnamed: C4.2, U2.20 (VMID)
unnamed: C2.2, U2.10 (VREF)
unnamed: R13.2, U3.5 (SHK)
unnamed: C15.1, U3.9 (Vin)
unnamed: C14.1, U3.10 (Vout)
unnamed: R15.2, U4.5 (SHK)
unnamed: R20.2, R21.1, U7.5 (OVLO)

Notes on the sheet:
Caps as close to their respective gnd returns as possible
pin 5&6 matching cap mic inputs
LED on GPIO8
Pin 1: L/CH0 Pin 2: R/CH1
Diode 1N4148 or BAS16
NC Boot
Line 2 + microSD together: U6 (TCA9534A, I2C 0x38) drives line 2's SLIC. Leave J5 open when U6 is fitted (J5 = line 2 on GPIO18-21 instead of the card). ~INT unused: firmware polls SHK. R18/R19 keep F/R and RM low until U6 is set up. J10: spare expander pins P4-P7.
CE Gnd = i2c addr 0x10
Remove jumpers for uSD use
CF Card
Line 1: Right
I2C pull-ups
Zener BZT03C82 OR P6KE82
UART to bluetooth board
Pull up to VCC in SW for switches/IO
CH 2 out is a copy of CH 1
Bluetooth BM64 header
Accessory Header
Line 0: Left
5V AG1170 needs 3.3V signal to ESP32
Optional Headphone header
DC jack overvoltage protection, after D1 (D1 blocks reverse polarity). U7 switches off above 1.2 V x (1 + R20/R21) = 5.9 V typ (5.7-6.1 V), so a 9-24 V supply on J1 just doesn't power the board.
Changes for SMD5 - SMD6: New accessory JST header (in prep for cable to payphone coin relay board. New i2c gpio chip to handle line2 SHK/RM/FR/PD so we can run uSD AND line 2 AND 4 GPIOs 4 GPIO header now becomes a JST with power & gnd. 3.6V or 3.7V regulator for bluetooth module instead of 3.3V. A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

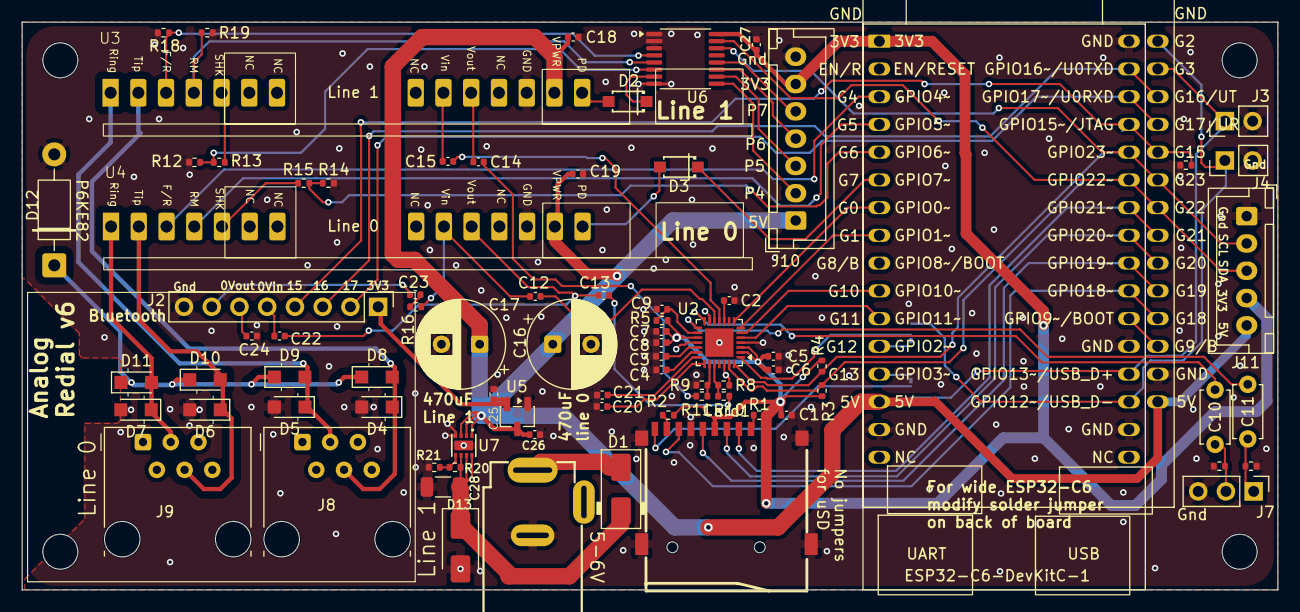
[picture p115: board Analog Redial v6.kicad_pcb from above]

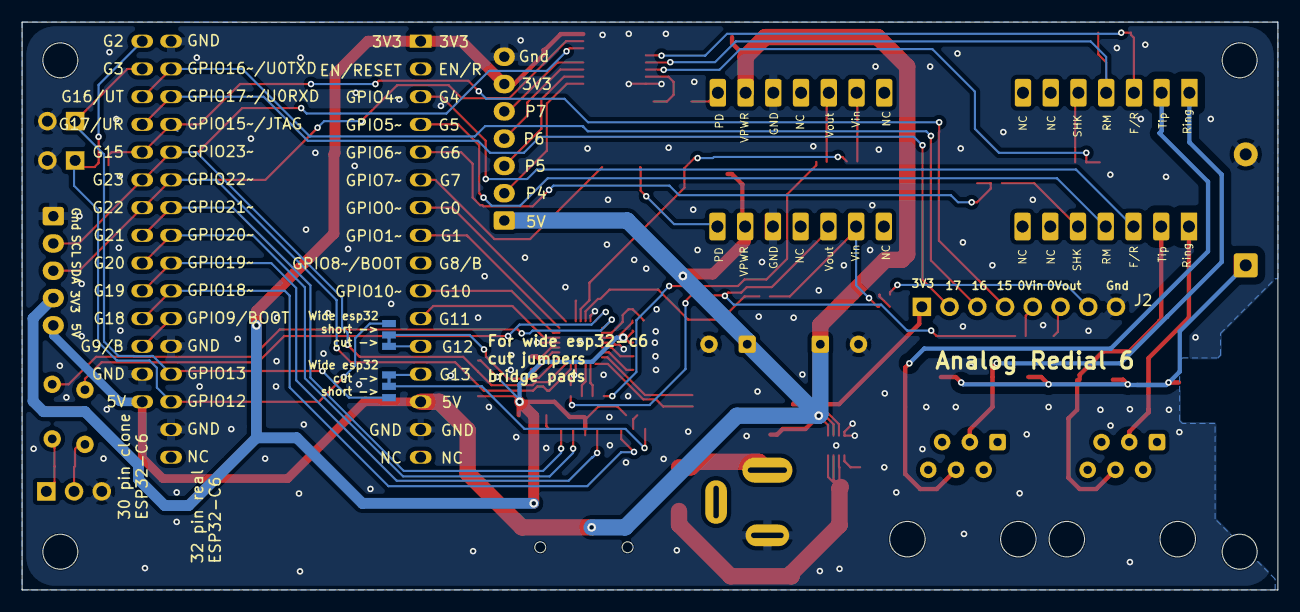
[picture p116: board Analog Redial v6.kicad_pcb from below]

Board: 2 copper layers, 115.0 x 52.0 mm, 85 parts (2 on the bottom side), 73 nets.
