sdylewski/Analog-Redial/PayPhone/Payphone_coin_board_v1/Payphone_coin_board_v1.kicad_pcb

## KiCad design PayPhone/Payphone_coin_board_v1/Payphone_coin_board_v1.kicad_pcb (2026-11-08)

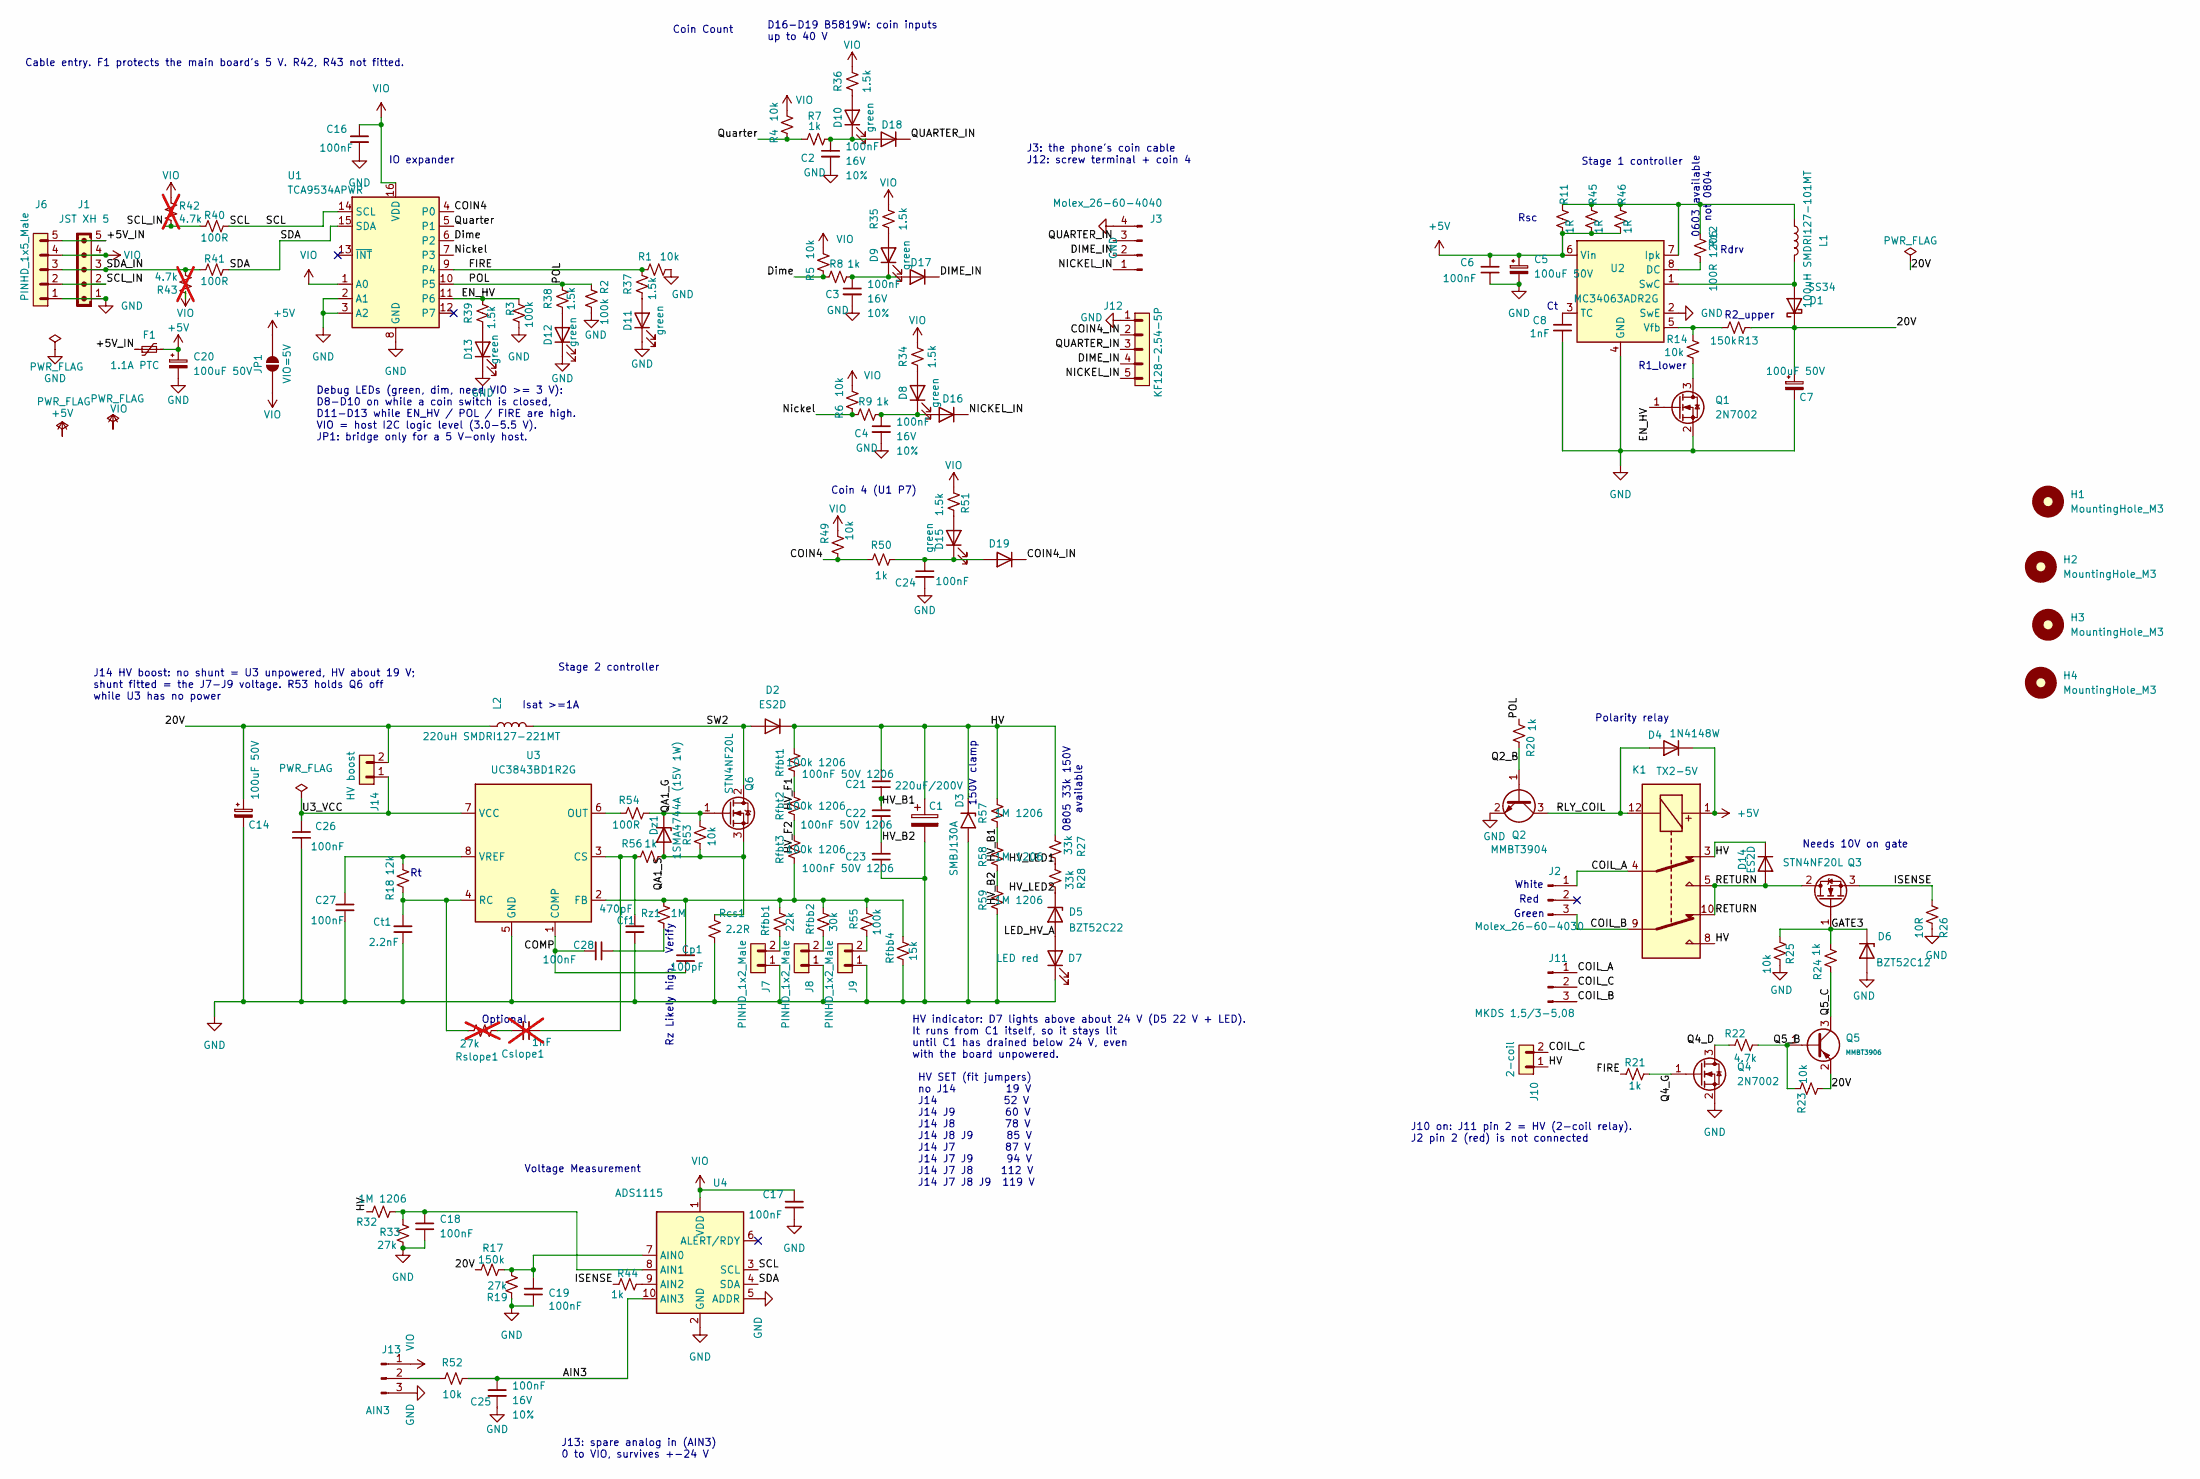
[picture p117: schematic Payphone_coin_board_v1.kicad_sch]

Parts:
C1: 220uF/200V; CP_Radial_D18.0mm_P7.50mm
C2, C3, C4, C24, C25: 100nF; C_0805_2012Metric; Voltage 16V; Tolerance 10%; LCSC C28233
C5, C7, C14, C20: 100uF 50V; CP_Elec_8x10
C6, C16, C17, C18, C19, C26, C27, C28: 100nF; C_0805_2012Metric; LCSC C28233
C8: 1nF; C_0805_2012Metric; LCSC C46653
C21, C22, C23: 100nF 50V 1206; C_1206_3216Metric; LCSC C24497
Cf1: 470pF; C_0805_2012Metric; LCSC C1743
Cp1: 100pF; C_0805_2012Metric; LCSC C1790
Cslope1: 1nF; C_0805_2012Metric; LCSC C46653; not fitted
Ct1: 2.2nF; C_0805_2012Metric; LCSC C28260
D1: SS34; D_SMA; LCSC C8678
D2, D14: ES2D; D_SMA; LCSC C18199161
D3: SMBJ130A; D_SMB
D4: 1N4148W; D_SOD-123; LCSC C81598
D5: BZT52C22; D_SOD-123; LCSC C22375295
D6: BZT52C12; D_SOD-123; LCSC C19077410
D7: LED red; LED_0805_2012Metric; LCSC C84256
D8, D9, D10, D11, D12, D13, D15: green; LED_0805_2012Metric; LCSC C2297
D16, D17, D18, D19: B5819W; D_SOD-123; LCSC C8598
Dz1: 1SMA4744A (15V 1W); D_SMA; LCSC C19077482
F1: 1.1A PTC; Fuse_1812_4532Metric
H1, H2, H3, H4: MountingHole_M3; MountingHole_3.2mm_M3
J1: JST XH 5; JST_XH_B5B-XH-A_1x05_P2.50mm_Vertical
J2: Molex_26-60-4030; Molex_KK-396_A-41791-0003_1x03_P3.96mm_Vertical; MPN 0026604030; DigiKey WM4621-ND
J3: Molex_26-60-4040; Molex_KK-396_A-41791-0004_1x04_P3.96mm_Vertical; MPN 0026604040; DigiKey WM4622-ND
J6: PINHD_1x5_Male; PinHeader_1x05_P2.54mm_Vertical
J7, J8, J9: PINHD_1x2_Male; PinHeader_1x02_P2.54mm_Vertical
J10: 2-coil; PinHeader_1x02_P2.54mm_Vertical
J11: MKDS 1,5/3-5,08; TerminalBlock_Phoenix_MKDS-1,5-3-5.08_1x03_P5.08mm_Horizont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
J12: KF128-2.54-5P; TerminalBlock_Xinya_XY308-2.54-5P_1x05_P2.54mm_Horizontal
J13: AIN3; PinHeader_1x03_P2.54mm_Vertical
J14: HV boost; PinHeader_1x02_P2.54mm_Vertical
JP1: VIO=5V; SolderJumper-2_P1.3mm_Open_RoundedPad1.0x1.5mm
K1: TX2-5V; Relay_DPDT_Omron_G6S-2
L1: 100uH SMDRI127-101MT; L_SXN_SMDRI127; LCSC C10150
L2: 220uH SMDRI127-221MT; L_SXN_SMDRI127; LCSC C10151
Q1, Q4: 2N7002; SOT-23; LCSC C8545
Q2: MMBT3904; SOT-23; LCSC C20526
Q3, Q6: STN4NF20L; SOT-223-3_TabPin2; LCSC C7603336
Q5: MMBT3906; SOT-23; Part MMBT3906; LCSC C7420354
R1, R4, R5, R6, R14, R23, R25, R49, R52, R53: 10k; R_0805_2012Metric; LCSC C17414
R2, R3, R55: 100k; R_0805_2012Metric; LCSC C149504
R7, R8, R9, R20, R21, R24, R44, R50, R56: 1k; R_0805_2012Metric; LCSC C17513
R11, R45, R46: 1R; R_1206_3216Metric; LCSC C17928
R12: 100R 1206; R_1206_3216Metric; LCSC C17901
R13, R17: 150k; R_0805_2012Metric; LCSC C17470
R18: 12k; R_0805_2012Metric; LCSC C17444
R19, R33: 27k; R_0805_2012Metric; LCSC C17593
R22: 4.7k; R_0805_2012Metric; LCSC C17673
R26: 10R; R_1206_3216Metric; LCSC C17903
R27, R28: 33k; R_0805_2012Metric_Pad1.20x1.40mm_HandSolder; LCSC C17633
R32, R57, R58, R59: 1M 1206; R_1206_3216Metric; LCSC C17927
R34, R35, R36, R37, R38, R39, R51: 1.5k; R_0805_2012Metric; LCSC C4310
R40, R41, R54: 100R; R_0805_2012Metric; LCSC C17408
R42, R43: 4.7k; R_0805_2012Metric; LCSC C17673; not fitted
Rcs1: 2.2R; R_0805_2012Metric; LCSC C17521
Rfbb1: 22k; R_0805_2012Metric; LCSC C17560
Rfbb2: 30k; R_0805_2012Metric; LCSC C17621
Rfbb4: 15k; R_0805_2012Metric; LCSC C17475
Rfbt1, Rfbt2, Rfbt3: 100k 1206; R_1206_3216Metric; LCSC C17900
Rslope1: 27k; R_0805_2012Metric; LCSC C17593; not fitted
Rz1: 1M; R_0805_2012Metric; LCSC C17514
U1: TCA9534APWR; TSSOP-16_4.4x5mm_P0.65mm; LCSC C206010
U2: MC34063ADR2G; SOIC-8_3.9x4.9mm_P1.27mm; LCSC C32078
U3: UC3843BD1R2G; SOIC-8_3.9x4.9mm_P1.27mm
U4: ADS1115; ADS1115 Module

Connections:
+5V: C5.1, C6.2, C20.1, D4.1 (K), F1.2, JP1.2 (B), K1.1, R11.2, R45.2, R46.2, U2.6 (Vin)
/20V: C7.1, C14.1, D1.1 (K), J14.2, L2.1, Q5.2 (E), R13.2, R17.2, R23.1
/+5V_IN: F1.1, J1.5, J6.5
/AIN3: C25.1, R52.1, U4.10 (AIN3)
/COIL_A: J2.1, J11.1, K1.4
/COIL_B: J2.3, J11.3, K1.9
/COIL_C: J10.2, J11.2
/COIN4: R49.1, R50.2, U1.4 (P0)
/COIN4_IN: D19.1 (K), J12.2
/COMP: C28.1, Cp1.1, U3.1 (COMP)
/DIME_IN: D17.1 (K), J3.2, J12.4
/Dime: R5.2, R8.2, U1.6 (P2)
/EN_HV: Q1.1 (G), R3.1, R39.2, U1.11 (P6)
/FIRE: R1.2, R21.1, R37.2, U1.9 (P4)
/GATE3: D6.1 (K), Q3.1 (G), R24.2, R25.1
/HV: C1.1, C21.1, D2.1 (K), D3.1 (A1), D14.1 (K), J10.1, K1.3, K1.8, R27.2, R32.2, R57.2, Rfbt1.2
/HV_B1: C21.2, C22.1, R57.1, R58.2
/HV_B2: C22.2, C23.1, R58.1, R59.2
/HV_F1: Rfbt1.1, Rfbt2.2
/HV_F2: Rfbt2.1, Rfbt3.2
/HV_LED1: R27.1, R28.2
/HV_LED2: D5.1 (K), R28.1
/ISENSE: Q3.3 (S), R26.1, R44.1
/LED_HV_A: D5.2 (A), D7.2 (A)
/NICKEL_IN: D16.1 (K), J3.1, J12.5
/Nickel: R6.2, R9.2, U1.7 (P3)
/POL: R2.2, R20.1, R38.2, U1.10 (P5)
/Q2_B: Q2.1 (B), R20.2
/Q4_D: Q4.3 (D), R22.1
/Q4_G: Q4.1 (G), R21.2
/Q5_B: Q5.1 (B), R22.2, R23.2
/Q5_C: Q5.3 (C), R24.1
/QA1_G: Dz1.1 (K), Q6.1 (G), R53.2, R54.1
/QA1_S: Dz1.2 (A), Q6.3 (S), R53.1, R56.1, Rcs1.2
/QUARTER_IN: D18.1 (K), J3.3, J12.3
/Quarter: R4.2, R7.2, U1.5 (P1)
/RETURN: D14.2 (A), K1.5, K1.10, Q3.2 (D)
/RLY_COIL: D4.2 (A), K1.12, Q2.3 (C)
/SCL: R40.2, U1.14 (SCL), U4.3 (SCL)
/SCL_IN: J1.2, J6.2, R40.1, R42.1
/SDA: R41.2, U1.15 (SDA), U4.4 (SDA)
/SDA_IN: J1.3, J6.3, R41.1, R43.1
/SW2: D2.2 (A), L2.2, Q6.2 (D)
/U3_VCC: C26.2, J14.1, U3.7 (VCC)
GND: C1.2, C2.2, C3.2, C4.2, C5.2, C6.1, C7.2, C8.1, C14.2, C16.2, C17.2, C18.2, C19.2, C20.2, C23.2, C24.2, C25.2, C26.1, C27.1, Cf1.1, Ct1.1, D3.2 (A2), D6.2 (A), D7.1 (K), D11.1 (K), D12.1 (K), D13.1 (K), J1.1, J3.4, J6.1, J7.1, J8.1, J9.1, J12.1, J13.3, Q1.2 (S), Q2.2 (E), Q4.2 (S), R1.1, R2.1, R3.2, R19.1, R25.2, R26.2, R33.1, R59.1, Rcs1.1, Rfbb4.1, U1.2 (A1), U1.3 (A2), U1.8 (GND), U2.2 (SwE), U2.4 (GND), U3.5 (GND), U4.2 (GND), U4.5 (ADDR)
unnamed: C28.2, Rz1.1
unnamed: Cslope1.2, Rslope1.2
unnamed: D1.2 (A), L1.2, U2.1 (SwC)
unnamed: D8.2 (A), R34.1
unnamed: D9.2 (A), R35.1
unnamed: D10.2 (A), R36.1
unnamed: C2.1, D10.1 (K), D18.2 (A), R7.1
unnamed: D11.2 (A), R37.1
unnamed: D12.2 (A), R38.1
unnamed: D13.2 (A), R39.1
unnamed: D15.2 (A), R51.1
unnamed: C24.1, D15.1 (K), D19.2 (A), R50.1
unnamed: C4.1, D8.1 (K), D16.2 (A), R9.1
unnamed: C3.1, D9.1 (K), D17.2 (A), R8.1
unnamed: J7.2, Rfbb1.1
unnamed: J8.2, Rfbb2.1
unnamed: J9.2, R55.1
unnamed: J13.2, R52.2
unnamed: Q1.3 (D), R14.2
unnamed: R12.1, U2.8 (DC)
unnamed: L1.1, R11.1, R12.2, R45.1, R46.1, U2.7 (Ipk)
unnamed: C8.2, U2.3 (TC)
unnamed: R13.1, R14.1, U2.5 (Vfb)
unnamed: Cf1.2, Cslope1.1, R56.2, U3.3 (CS)
unnamed: Cp1.2, R55.2, Rfbb1.2, Rfbb2.2, Rfbb4.2, Rfbt3.1, Rz1.2, U3.2 (FB)
unnamed: R54.2, U3.6 (OUT)
unnamed: Ct1.2, R18.2, Rslope1.1, U3.4 (RC)
unnamed: C27.2, R18.1, U3.8 (VREF)
unnamed: C19.1, R17.1, R19.2, U4.7 (AIN0)
unnamed: C18.1, R32.1, R33.2, U4.8 (AIN1)
unnamed: R44.2, U4.9 (AIN2)
VIO: C16.1, C17.1, J1.4, J6.4, J13.1, JP1.1 (A), R4.1, R5.1, R6.1, R34.2, R35.2, R36.2, R42.2, R43.2, R49.2, R51.2, U1.1 (A0), U1.16 (VDD), U4.1 (VDD)

Notes on the sheet:
Voltage Measurement
Rdrv
J14 HV boost: no shunt = U3 unpowered, HV about 19 V; shunt fitted = the J7-J9 voltage. R53 holds Q6 off while U3 has no power
D16-D19 B5819W: coin inputs up to 40 V
R2_upper
Debug LEDs (green, dim, need VIO >= 3 V): D8-D10 on while a coin switch is closed, D11-D13 while EN_HV / POL / FIRE are high. VIO = host I2C logic level (3.0-5.5 V). JP1: bridge only for a 5 V-only host.
Coin Count
IO expander
Needs 10V on gate
Cable entry. F1 protects the main board's 5 V. R42, R43 not fitted.
0805 33k 150V available
Stage 1 controller
Rz Likely high. Verify
Isat >=1A
Coin 4 (U1 P7)
White
Rsc
Optional
Green
150V clamp
HV SET (fit jumpers) no J14 19 V J14 52 V J14 J9 60 V J14 J8 78 V J14 J8 J9 85 V J14 J7 87 V J14 J7 J9 94 V J14 J7 J8 112 V J14 J7 J8 J9 119 V
HV indicator: D7 lights above about 24 V (D5 22 V + LED). It runs from C1 itself, so it stays lit until C1 has drained below 24 V, even with the board unpowered.
J10 on: J11 pin 2 = HV (2-coil relay). J2 pin 2 (red) is not connected
Red
Polarity relay
0603 available not 0804
R1_lower
Stage 2 controller
J13: spare analog in (AIN3) 0 to VIO, survives +-24 V
J3: the phone's coin cable J12: screw terminal + coin 4

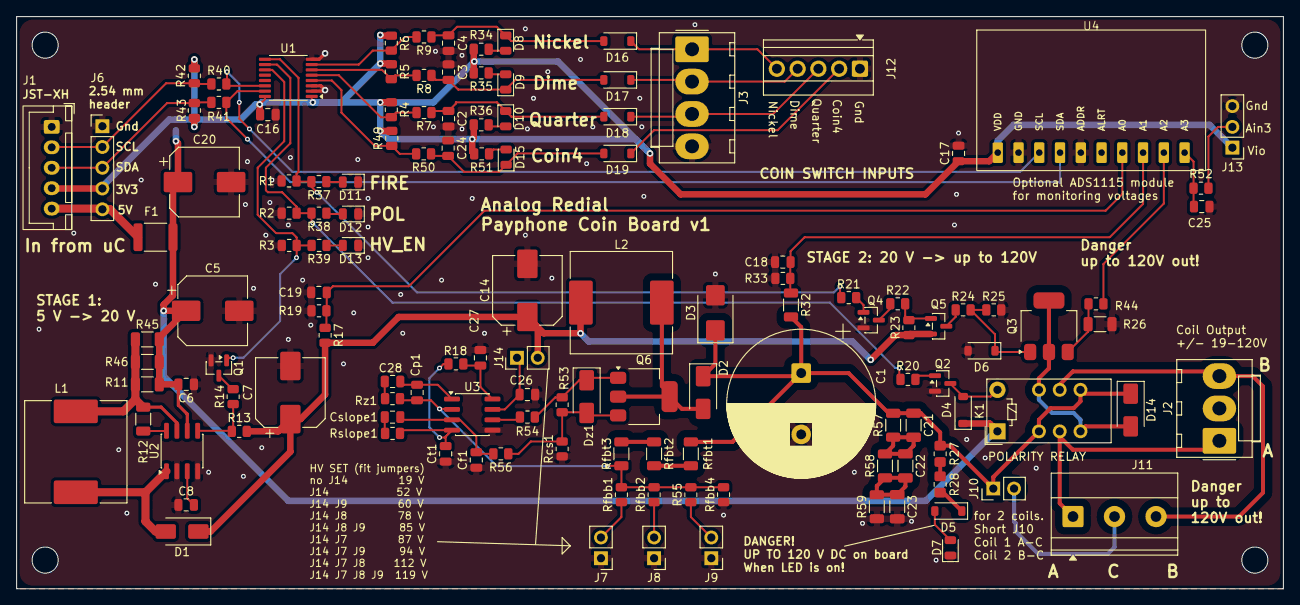
[picture p118: board Payphone_coin_board_v1.kicad_pcb from above]

Board: 2 copper layers, 155.0 x 70.0 mm, 137 parts (1 on the bottom side), 77 nets.
