sdylewski/Analog-Redial/Bluetooth/DFR0781_BT401/DFR0781_BT401_board_v1/DFR0781_BT401_board_v1.kicad_pcb

## KiCad design Bluetooth/DFR0781_BT401/DFR0781_BT401_board_v1/DFR0781_BT401_board_v1.kicad_pcb (2026-10-29)

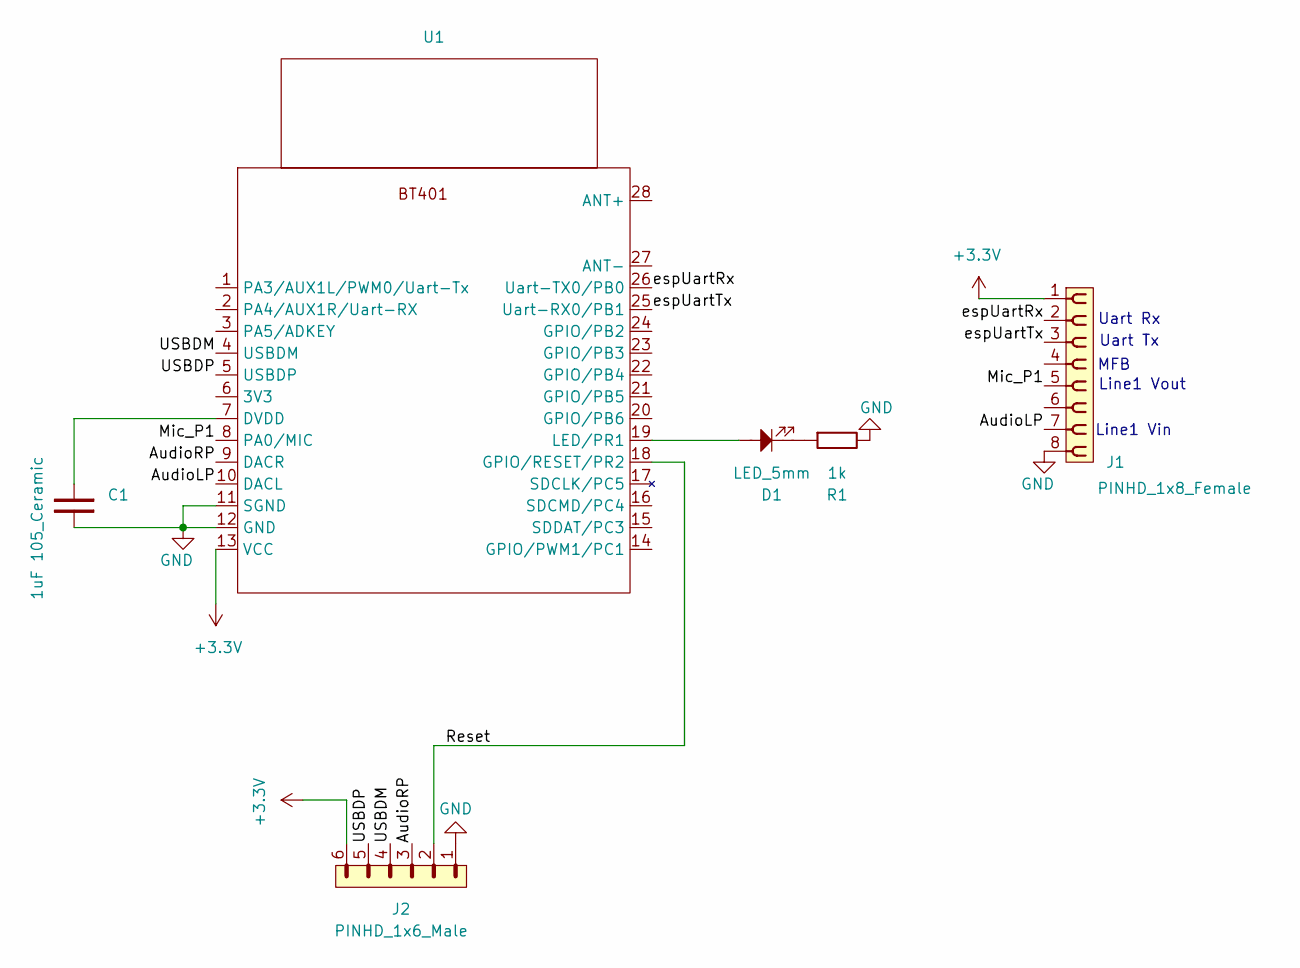
[picture p119: schematic DFR0781_BT401_board_v1.kicad_sch]

Parts:
C1: 1uF 105_Ceramic; C_Disc_D5.0mm_W2.5mm_P2.50mm
D1: LED_5mm; LED_D5.0mm
J1: PINHD_1x8_Female; PinSocket_1x08_P2.54mm_Vertical
J2: PINHD_1x6_Male; PinHeader_1x06_P2.54mm_Vertical
R1: 1k; R_Axial_DIN0207_L6.3mm_D2.5mm_P10.16mm_Horizontal
U1: DFR0781_BT401_new

Connections:
+3.3V: J1.1, J2.6, U1.13 (VCC)
/AudioLP: J1.7, U1.10 (DACL)
/AudioRP: J2.3, U1.9 (DACR)
/Mic_P1: J1.5, U1.8 (PA0/MIC)
/Reset: J2.2, U1.18 (GPIO/RESET/PR2)
/USBDM: J2.4, U1.4 (USBDM)
/USBDP: J2.5, U1.5 (USBDP)
/espUartRx: J1.2, U1.26 (Uart-TX0/PB0)
/espUartTx: J1.3, U1.25 (Uart-RX0/PB1)
GND: C1.2, J1.8, J2.1, R1.2, U1.11 (SGND), U1.12 (GND)
unnamed: D1.1, R1.1
unnamed: C1.1, U1.7 (DVDD)
unnamed: D1.2, U1.19 (LED/PR1)

Notes on the sheet:
Uart Tx
Line1 Vin
Uart Rx
Line1 Vout
MFB

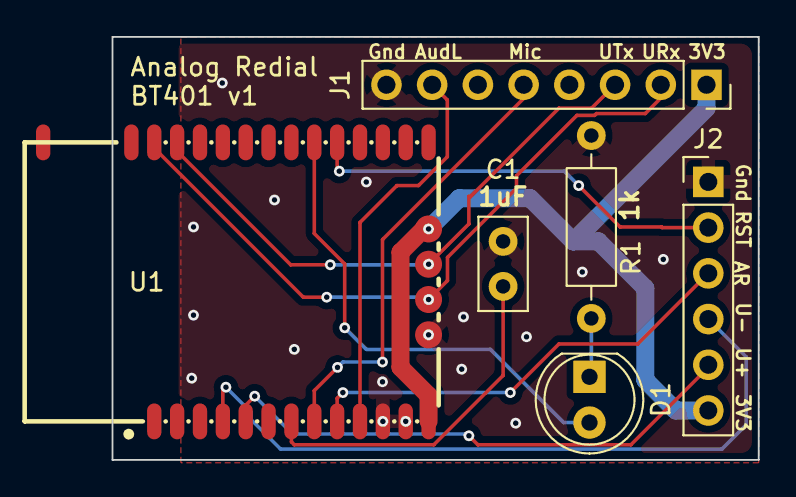
[picture p120: board DFR0781_BT401_board_v1.kicad_pcb from above]

Board: 2 copper layers, 35.9 x 23.5 mm, 6 parts (0 on the bottom side), 13 nets.
