sdylewski/Analog-Redial/Bluetooth/BK3266_board_v1/BK3266_board_v1.kicad_pcb

## KiCad design Bluetooth/BK3266_board_v1/BK3266_board_v1.kicad_pcb (2026-10-04)

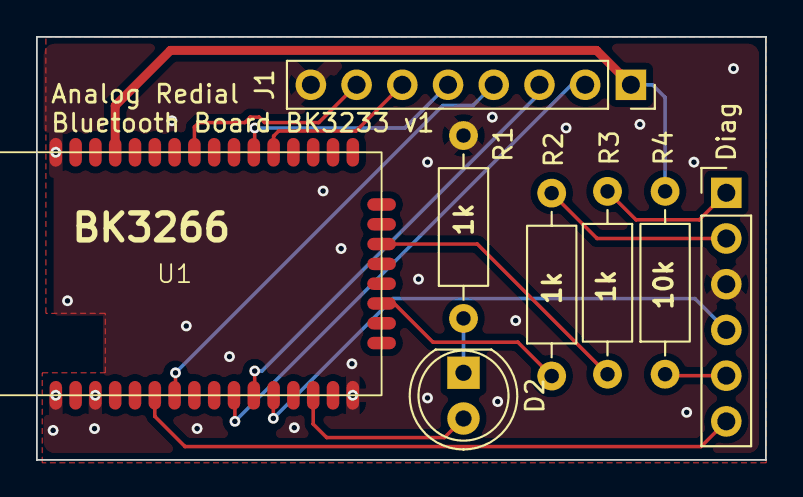
[picture p121: board BK3266_board_v1.kicad_pcb from above]

Board: 2 copper layers, 40.5 x 23.5 mm, 8 parts (0 on the bottom side), 17 nets.

Parts:
D2: LED_5mm; LED_D5.0mm
Diag: PINHD_1x6_Male; PinHeader_1x06_P2.54mm_Vertical
J1: PINHD_1x8_Female; PinSocket_1x08_P2.54mm_Vertical
R1, R2, R3: 1k; R_Axial_DIN0207_L6.3mm_D2.5mm_P10.16mm_Horizontal
R4: 10k; R_Axial_DIN0207_L6.3mm_D2.5mm_P10.16mm_Horizontal
U1: BK3266SR

Connections:
+3.3V: J1.1, R4.2, U1.37 (VBAT_(3.3-4.2V))
/AudioLP: J1.7, U1.33 (AudioLP)
/Mic_N1: J1.6, U1.29 (MicN)
/Mic_P1: J1.5, U1.30 (MicP)
/PP_Call: Diag.6, U1.6 (P.P/Call_(GPIO4))
/Wake: J1.4, U1.7 (Wakeup_(GPIO15))
/espUartRx: J1.2, U1.10 (TX_(GPIO0))
/espUartTx: J1.3, U1.11 (RX_(GPIO1))
GND: Diag.3, J1.8, R1.2, U1.1 (GND), U1.3 (GND), U1.16 (GND), U1.40 (AGND)
unnamed: D2.1, R1.1
unnamed: Diag.1, R3.1
unnamed: Diag.2, R2.2
unnamed: Diag.5, R4.1
unnamed: D2.2, U1.14 (LED_(GPIO8))
unnamed: Diag.4, U1.12 (Mode_(GPIO7)#1)
unnamed: R2.1, U1.19 (STAT_(GPIO10_)
unnamed: R3.2, U1.22 (S/R_(GPIO6)#2)
