sdylewski/Analog-Redial/hardware/kicad/Analog Redial v2/Analog Redial v2.kicad_pcb

## KiCad design hardware/kicad/Analog Redial v2/Analog Redial v2.kicad_pcb (2026-10-04, an earlier design)

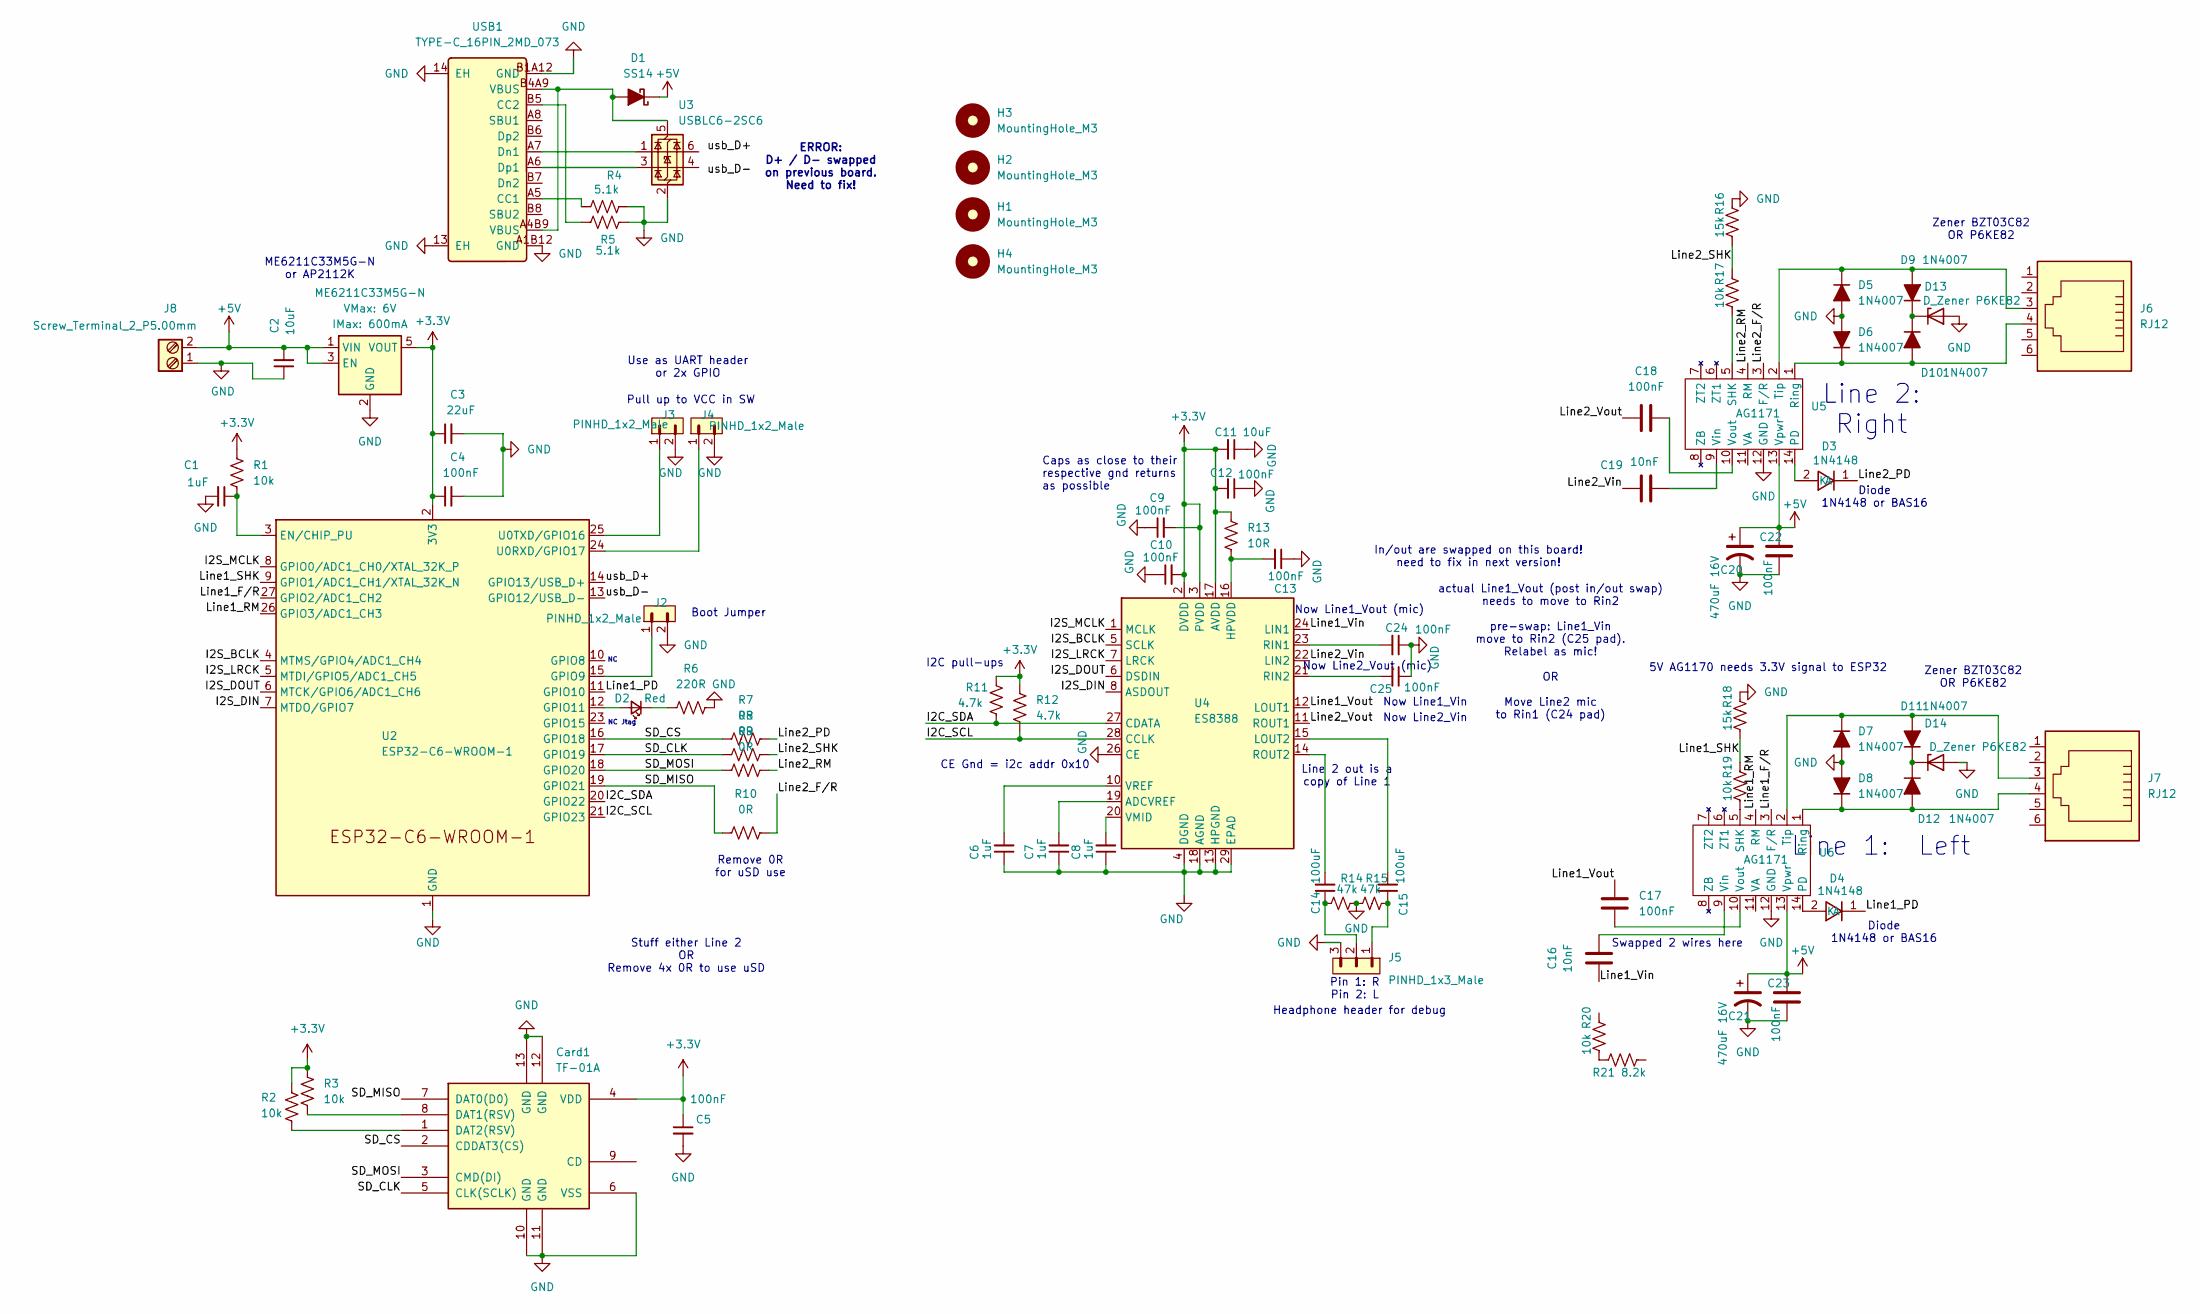
[picture p122: schematic Analog Redial v2.kicad_sch, Rotary Phone SIP Gateway]

Parts:
C1, C6, C7, C8: 1uF; C_0402_1005Metric; Voltage 1kV; Tolerance 100%
C2, C11: 10uF; C_0402_1005Metric; Voltage 1kV; Tolerance 100%
C3: 22uF; C_0603_1608Metric; Voltage 1kV; Tolerance 100%
C4, C5, C9, C10, C12, C13, C24, C25: 100nF; C_0402_1005Metric; Voltage 1kV; Tolerance 100%
C14, C15: 100uF; C_1206_3216Metric; Voltage 1kV; Tolerance 100%
C16, C19: 10nF; C_0402_1005Metric
C17, C18, C22, C23: 100nF; C_0402_1005Metric
C20, C21: 470uF 16V; CP_Radial_D6.3mm_P2.50mm
Card1: TF-01A; Manufacturer Part TF-01A; LCSC C91145
D1: SS14; D_SMA
D2: Red; LED_0603_1608Metric_Red
D3, D4: 1N4148; 1N4148W_C81598; Manufacturer Part 1N4148W; LCSC C81598
D5, D6, D7, D8, D9, D10, D11, D12: 1N4007; 1N4007W_C18199088
D13, D14: D_Zener P6KE82; D_DO-41_SOD81_P10.16mm_Horizontal
H1, H2, H3, H4: MountingHole_M3; MountingHole_3.2mm_M3
J2, J3, J4: PINHD_1x2_Male; PinHeader_1x02_P2.54mm_Vertical
J5: PINHD_1x3_Male; PinHeader_1x03_P2.54mm_Vertical
J6, J7: RJ12; RJ12_Amphenol_87180_Horizontal
J8: Screw_Terminal_2_P5.00mm; TerminalBlock_Phoenix_PT-1,5-2-5.0-H_1x02_P5.00mm_Horizontal
R1, R2, R3, R17, R19, R20: 10k; R_0402_1005Metric
R4, R5: 5.1k; R_0402_1005Metric
R6: 220R; R_0402_1005Metric
R7, R8, R9, R10: 0R; R_0402_1005Metric
R11, R12: 4.7k; R_0402_1005Metric
R13: 10R; R_0402_1005Metric
R14, R15: 47k; R_0402_1005Metric
R16, R18: 15k; R_0402_1005Metric
R21: 8.2k; R_0402_1005Metric
U1: ME6211C33M5G-N; SOT23-5
U2: ESP32-C6-WROOM-1
U3: USBLC6-2SC6; SOT-23-6
U4: ES8388; QFN-28-1EP_4x4mm_P0.45mm_EP2.6x2.6mm
U5, U6: AG1171; AG1171_SIL
USB1: TYPE-C_16PIN_2MD_073; Manufacturer Part TYPE-C 16PIN 2MD(073); LCSC C2765186

Connections:
+3.3V: C3.1, C4.1, C5.1, C9.2, C10.2, C11.2, C12.2, Card1.4 (VDD), R1.2, R2.2, R3.1, R11.1, R12.1, R13.1, U1.5 (VOUT), U2.2 (3V3), U4.2 (DVDD), U4.3 (PVDD), U4.17 (AVDD)
+5V: C2.2, C20.1, C21.1, C22.1, C23.1, D1.1 (K), J8.2, U1.1 (VIN), U1.3 (EN), U5.13 (Vpwr), U6.13 (Vpwr)
/I2C_SCL: R12.2, U2.21 (GPIO23), U4.28 (CCLK)
/I2C_SDA: R11.2, U2.20 (GPIO22), U4.27 (CDATA)
/I2S_BCLK: U2.4 (MTMS/GPIO4/ADC1_CH4), U4.5 (SCLK)
/I2S_DIN: U2.7 (MTDO/GPIO7), U4.8 (ASDOUT)
/I2S_DOUT: U2.6 (MTCK/GPIO6/ADC1_CH6), U4.6 (DSDIN)
/I2S_LRCK: U2.5 (MTDI/GPIO5/ADC1_CH5), U4.7 (LRCK)
/I2S_MCLK: U2.8 (GPIO0/ADC1_CH0/XTAL_32K_P), U4.1 (MCLK)
/Line1_F/R: U2.27 (GPIO2/ADC1_CH2), U6.3 (F/R)
/Line1_PD: D4.1 (K), U2.11 (GPIO10)
/Line1_RM: U2.26 (GPIO3/ADC1_CH3), U6.4 (RM)
/Line1_SHK: R18.2, R19.1, U2.9 (GPIO1/ADC1_CH1/XTAL_32K_N)
/Line1_Vin: C16.1, U4.24 (LIN1)
/Line1_Vout: C17.1, U4.12 (LOUT1)
/Line2_F/R: R10.2, U5.3 (F/R)
/Line2_PD: D3.1 (K), R7.2
/Line2_RM: R9.2, U5.4 (RM)
/Line2_SHK: R8.2, R16.2, R17.1
/Line2_Vin: C19.2, U4.22 (LIN2)
/Line2_Vout: C18.2, U4.11 (ROUT1)
/SD_CLK: Card1.5 (CLK(SCLK)), R8.1, U2.17 (GPIO19)
/SD_CS: Card1.2 (CDDAT3(CS)), R7.1, U2.16 (GPIO18)
/SD_MISO: Card1.7 (DAT0(D0)), R10.1, U2.19 (GPIO21)
/SD_MOSI: Card1.3 (CMD(DI)), R9.1, U2.18 (GPIO20)
/usb_D+: U2.14 (GPIO13/USB_D+), U3.6 (I/O1)
/usb_D-: U2.13 (GPIO12/USB_D-), U3.4 (I/O2)
GND: C1.2, C2.1, C3.2, C4.2, C5.2, C6.1, C7.1, C8.1, C9.1, C10.1, C11.1, C12.1, C13.1, C20.2, C21.2, C22.2, C23.2, C24.1, C25.1, Card1.6 (VSS), Card1.10 (GND), Card1.11 (GND), Card1.12 (GND), Card1.13 (GND), D5.2 (A), D6.2 (A), D7.2 (A), D8.2 (A), D13.2 (A), D14.2 (A), J2.2, J3.2, J4.2, J5.3, J8.1, R4.1, R5.1, R6.2, R14.1, R15.2, R16.1, R18.1, U1.2 (GND), U2.1 (GND), U2.28 (GND), U2.29 (GND), U3.2 (GND), U4.4 (DGND), U4.13 (HPGND), U4.18 (AGND), U4.26 (CE), U4.29 (EPAD), U5.12 (GND), U6.12 (GND), USB1.13 (EH), USB1.14 (EH), USB1.A1B12 (GND), USB1.B1A12 (GND)
unnamed: C14.1, J5.2, R14.2
unnamed: C15.1, J5.1, R15.1
unnamed: Card1.8 (DAT1(RSV)), R3.2
unnamed: Card1.1 (DAT2(RSV)), R2.1
unnamed: D1.2 (A), U3.5 (VBUS), USB1.A4B9 (VBUS), USB1.B4A9 (VBUS)
unnamed: D2.2 (A), U2.12 (GPIO11)
unnamed: D2.1 (K), R6.1
unnamed: D3.2 (A), U5.14 (PD)
unnamed: D4.2 (A), U6.14 (PD)
unnamed: D5.1 (K), D9.2 (A), J6.3, U5.2 (Tip)
unnamed: D6.1 (K), D10.2 (A), J6.4, U5.1 (Ring)
unnamed: D9.1 (K), D10.1 (K), D13.1 (K)
unnamed: D7.1 (K), D11.2 (A), J7.3, U6.2 (Tip)
unnamed: D11.1 (K), D12.1 (K), D14.1 (K)
unnamed: D8.1 (K), D12.2 (A), J7.4, U6.1 (Ring)
unnamed: R20.2, R21.1
unnamed: C1.1, R1.1, U2.3 (EN/CHIP_PU)
unnamed: J2.1, U2.15 (GPIO9)
unnamed: J4.1, U2.24 (U0RXD/GPIO17)
unnamed: J3.1, U2.25 (U0TXD/GPIO16)
unnamed: C7.2, U4.19 (ADCVREF)
unnamed: C13.2, R13.2, U4.16 (HPVDD)
unnamed: C15.2, U4.15 (LOUT2)
unnamed: C24.2, U4.23 (RIN1)
unnamed: C25.2, U4.21 (RIN2)
unnamed: C14.2, U4.14 (ROUT2)
unnamed: C8.2, U4.20 (VMID)
unnamed: C6.2, U4.10 (VREF)
unnamed: R17.2, U5.5 (SHK)
unnamed: C19.1, U5.9 (Vin)
unnamed: C18.1, U5.10 (Vout)
unnamed: R19.2, U6.5 (SHK)
unnamed: C16.2, U6.9 (Vin)
unnamed: C17.2, U6.10 (Vout)
unnamed: R4.2, USB1.A5 (CC1)
unnamed: R5.2, USB1.B5 (CC2)
unnamed: U3.1 (I/O1), USB1.A7 (Dn1)
unnamed: U3.3 (I/O2), USB1.A6 (Dp1)

Notes on the sheet:
Caps as close to their respective gnd returns as possible
Pin 1: R Pin 2: L
Boot Jumper
Headphone header for debug
Remove 0R for uSD use
Stuff either Line 2 OR Remove 4x 0R to use uSD
Diode 1N4148 or BAS16
CE Gnd = i2c addr 0x10
Line 2: Right
actual Line1_Vout (post in/out swap) needs to move to Rin2 pre-swap: Line1_Vin move to Rin2 (C25 pad). Relabel as mic! OR Move Line2 mic to Rin1 (C24 pad)
Swapped 2 wires here
Pull up to VCC in SW
I2C pull-ups
Zener BZT03C82 OR P6KE82
Now Line1_Vout (mic)
NC Jtag
Use as UART header or 2x GPIO
ME6211C33M5G-N or AP2112K
Line 2 out is a copy of Line 1
Now Line1_Vin
Line 1: Left
ERROR: D+ / D- swapped on previous board. Need to fix!
Now Line2_Vout (mic)
5V AG1170 needs 3.3V signal to ESP32
In/out are swapped on this board! need to fix in next version!
Now Line2_Vin

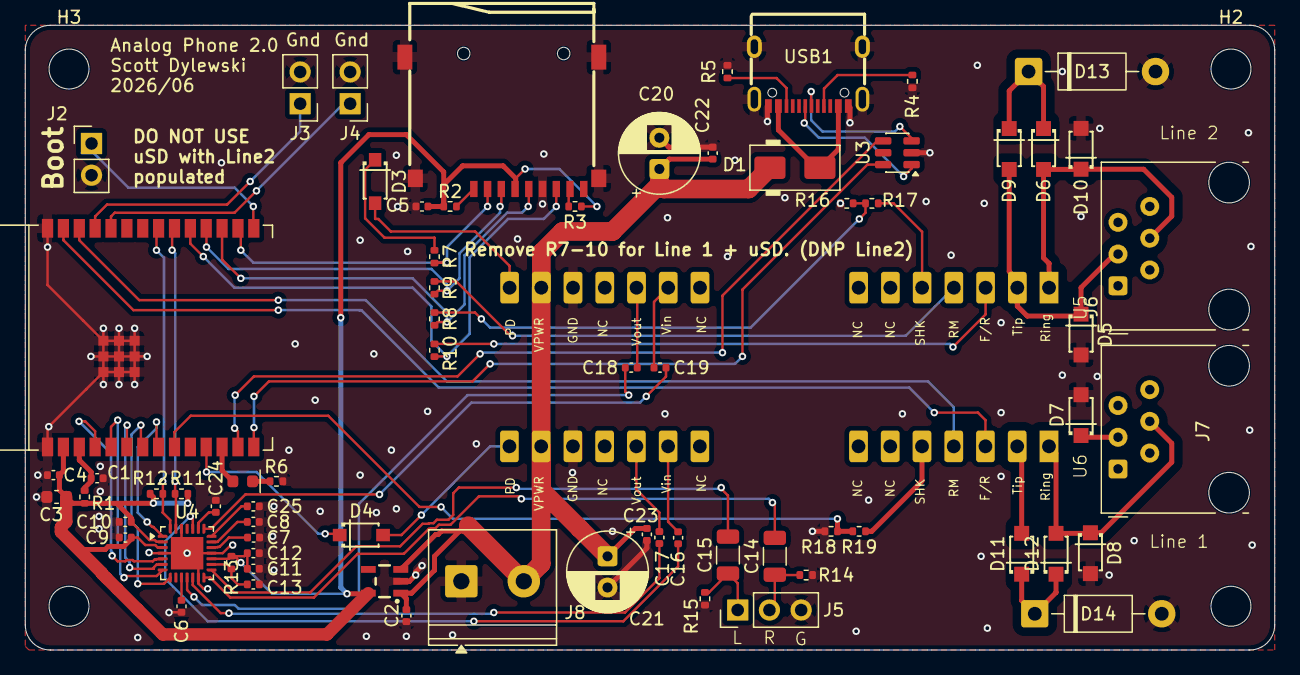
[picture p123: board Analog Redial v2.kicad_pcb from above]

Board: 2 copper layers, 100.0 x 50.0 mm, 77 parts (0 on the bottom side), 65 nets.
