sdylewski/Analog-Redial/Bluetooth/Bluetooth_board/Bluetooth_board.kicad_pcb

## KiCad design Bluetooth/Bluetooth_board/Bluetooth_board.kicad_pcb (2026-09-28)

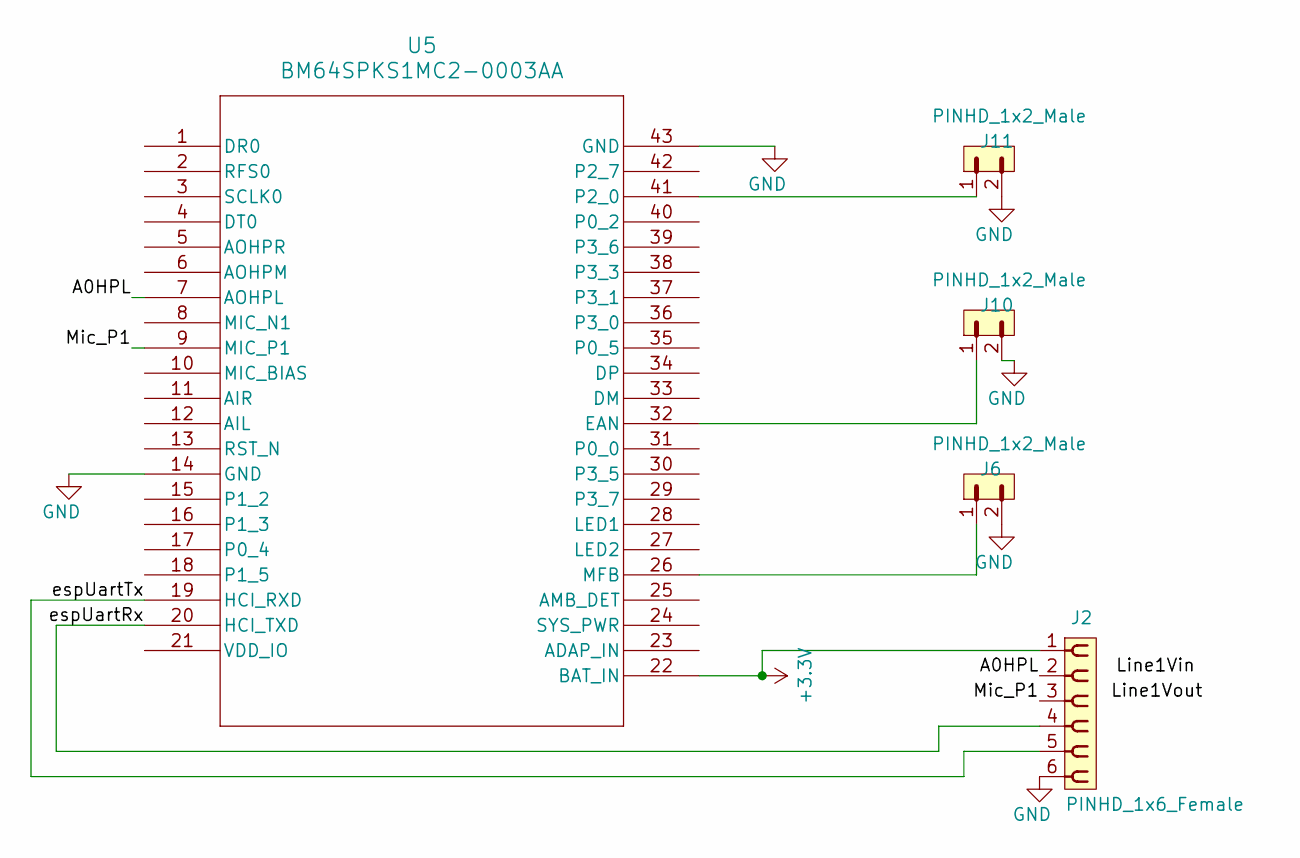
[picture p124: schematic Bluetooth_board.kicad_sch]

Parts:
J2: PINHD_1x6_Female; PinSocket_1x06_P2.54mm_Vertical
J6, J10, J11: PINHD_1x2_Male; PinHeader_1x02_P2.54mm_Vertical
U5: BM64SPKS1MC2-0003AA; BM64_MCH

Connections:
+3.3V: J2.1, U5.22 (BAT_IN)
/A0HPL: J2.2, U5.7 (AOHPL)
/Mic_P1: J2.3, U5.9 (MIC_P1)
/espUartRx: J2.4, U5.20 (HCI_TXD)
/espUartTx: J2.5, U5.19 (HCI_RXD)
GND: J2.6, J6.2, J10.2, J11.2, U5.14 (GND), U5.43 (GND)
unnamed: J10.1, U5.32 (EAN)
unnamed: J6.1, U5.26 (MFB)
unnamed: J11.1, U5.41 (P2_0)

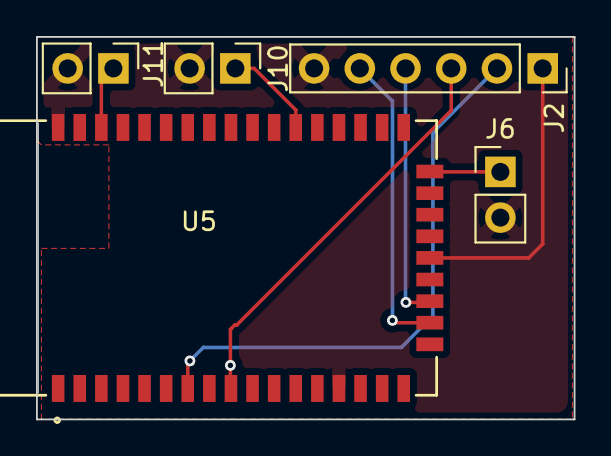
[picture p125: board Bluetooth/Bluetooth_board/Bluetooth_board.kicad_pcb from above]

Board: 2 copper layers, 29.9 x 21.2 mm, 5 parts (0 on the bottom side), 9 nets.
