sdylewski/Analog-Redial/hardware/kicad/Rotary_phone_SMD_old/Rotary_phone_SMD.kicad_pcb

## KiCad design hardware/kicad/Rotary_phone_SMD_old/Rotary_phone_SMD.kicad_pcb (2026-07-06, an earlier design)

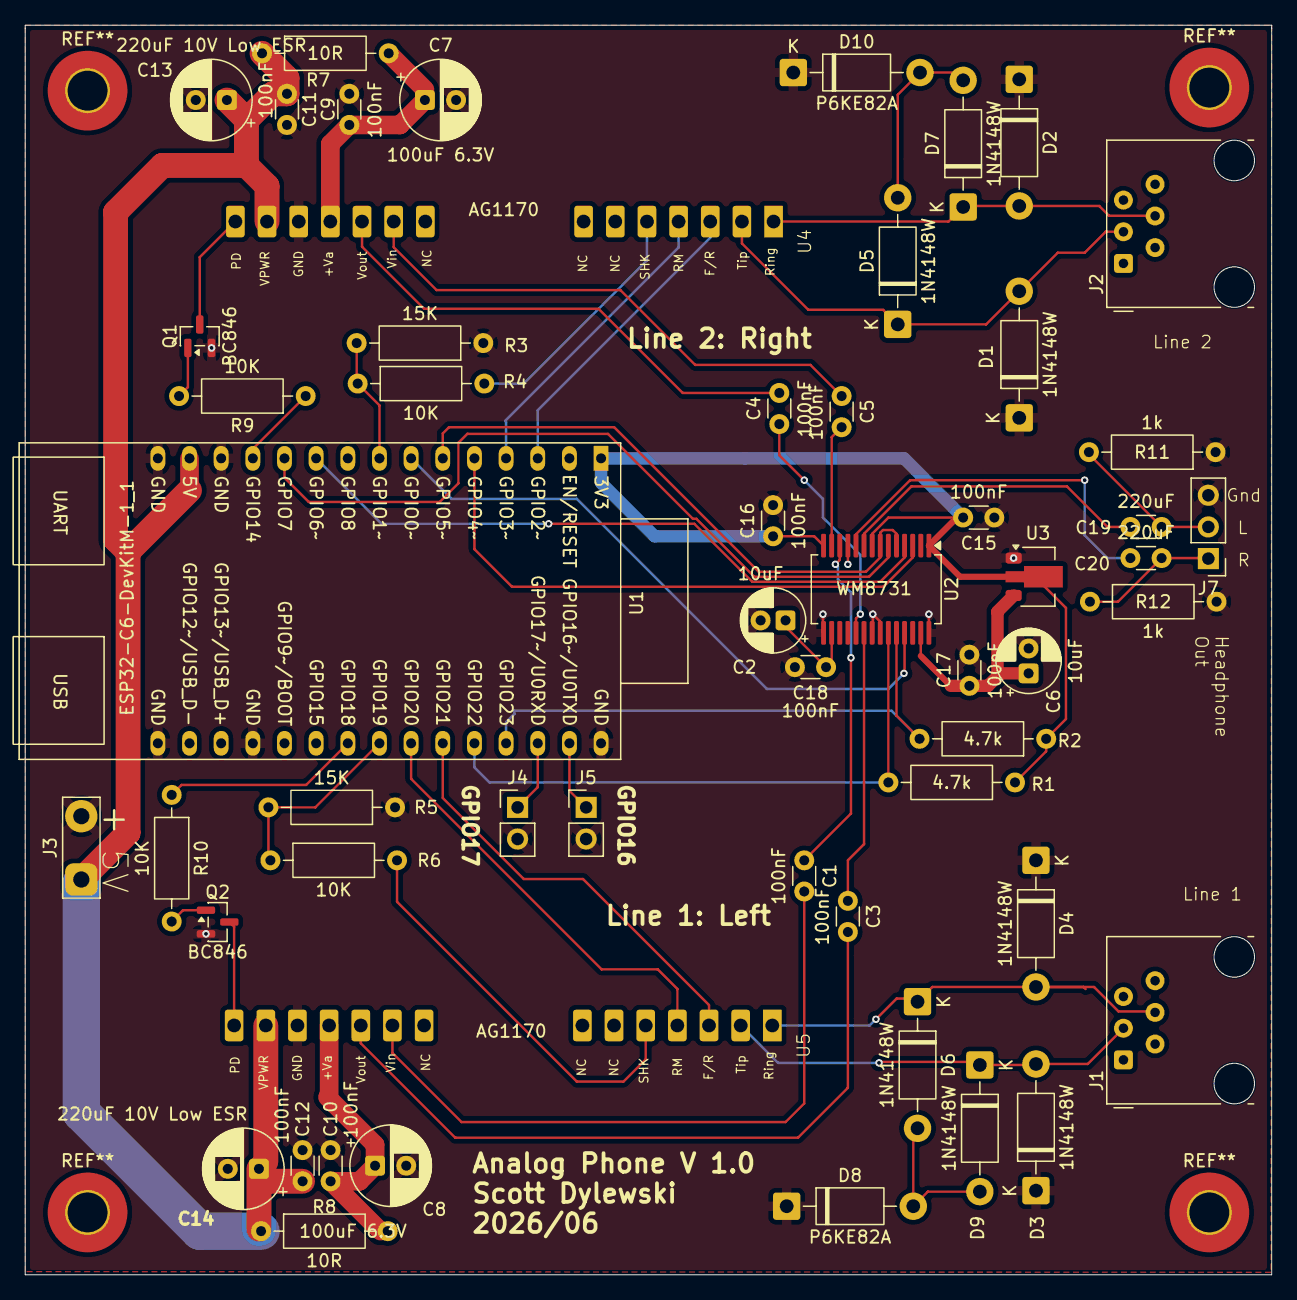
[picture p126: board Rotary_phone_SMD.kicad_pcb from above]

Board: 2 copper layers, 100.0 x 100.2 mm, 55 parts (0 on the bottom side), 48 nets.

Parts:
C1, C3, C4, C5, C9, C10, C11, C12, C15, C16, C17, C18: 100nF; C_0402_1005Metric
C2, C6: 10uF; C_0603_1608Metric
C7, C8: 100uF 6.3V; CP_Elec_6.3x7.7
C13, C14: 220uF 10V Low ESR; CP_Elec_8x10.5
C19, C20: 220uF; CP_Elec_8x10.5
D1, D2, D3, D4, D5, D6, D7, D9: 1N4148W; D_SOD-123
D8, D10: P6KE82A; D_SOD-123
J1, J2: RJ12; RJ12_Amphenol_54601-x06_Horizontal
J3: Conn_01x02_Pin; TestPoint_2Pads_Pitch5.08mm_Drill1.3mm
J4, J5: PINHD_1x2_Male; PinHeader_1x02_P2.54mm_Vertical
J7: PINHD_1x3_Male; PinHeader_1x03_P2.54mm_Vertical
Q1, Q2: BC846; SOT-23
R1, R2: 4.7k; R_0402_1005Metric
R3, R5: 15K; R_0402_1005Metric
R4, R6, R9, R10: 10K; R_0402_1005Metric
R7, R8: 10R; R_0402_1005Metric
R11, R12: 1k; R_0402_1005Metric
U1: ESP32-C6-DevKitM-1_1; ESP32-C6-DevKitM-1
U2: WM8731; WM8731_SSOP-28
U3: MCP1700x-180xxMB; SOT-89-3
U4, U5: AG1170; AG1170_SIL

Connections:
+3.3V: C15.2, C16.1, R1.1, R2.1, U1.1 (3V3), U2.1 (DBVDD), U2.8 (HPVDD), U2.14 (AVDD), U3.2 (VI)
+5V: C11.1, C12.1, C13.1, C14.1, J3.1, R7.1, R8.1, U1.14 (5V), U4.13 (Vpwr), U5.13 (Vpwr)
/I2C_SCL: R2.2, U1.27 (GPIO23), U2.24 (SCLK)
/I2C_SDA: R1.2, U1.26 (GPIO22), U2.23 (SDIN)
/I2S_BCLK: U1.5 (GPIO4/MTMS), U2.3 (BCLK)
/I2S_DIN: U1.11 (GPIO7), U2.6 (ADCDAT)
/I2S_DOUT: U1.10 (GPIO6), U2.4 (DACDAT)
/I2S_LRCK: U1.6 (GPIO5/MTDI), U2.5 (DACLRC), U2.7 (ADCLRC)
/I2S_MCLK: U1.7 (GPIO0), U2.25 (XTI/MCLK)
/Line1_F/R: U1.25 (GPIO21), U5.3 (F/R)
/Line1_PD: R10.1, U1.22 (GPIO18)
/Line1_RM: U1.24 (GPIO20), U5.4 (RM)
/Line1_SHK: R5.2, R6.1, U1.23 (GPIO19)
/Line2_F/R: U1.3 (GPIO2), U4.3 (F/R)
/Line2_PD: R9.1, U1.12 (GPIO14)
/Line2_RM: U1.4 (GPIO3), U4.4 (RM)
/Line2_SHK: R3.2, R4.1, U1.8 (GPIO1)
GND: C2.2, C6.2, C7.2, C8.2, C9.2, C10.2, C11.2, C12.2, C13.2, C14.2, C15.1, C16.2, C17.2, C18.2, D1.1 (K), D2.1 (K), D3.1 (K), D4.1 (K), D8.1 (K), D10.1 (K), J3.2, J4.2, J5.2, J7.3, Q1.2 (E), Q2.2 (E), R3.1, R5.1, R11.1, R12.2, U1.13 (GND), U1.15 (GND), U1.16 (GND), U1.19 (GND), U1.30 (GND), U2.11 (HPGND), U2.15 (AGND), U2.21 (MODE), U2.22 (CSB), U2.28 (DGND), U3.1 (GND), U4.12 (GND), U5.12 (GND)
unnamed: C19.1, J7.2, R11.2
unnamed: C20.1, J7.1, R12.1
unnamed: D1.2 (A), D5.1 (K), J2.3, U4.2 (Tip)
unnamed: D2.2 (A), D7.1 (K), J2.4, U4.1 (Ring)
unnamed: D3.2 (A), D9.1 (K), J1.3, U5.2 (Tip)
unnamed: D4.2 (A), D6.1 (K), J1.4, U5.1 (Ring)
unnamed: D6.2 (A), D8.2 (A), D9.2 (A)
unnamed: D5.2 (A), D7.2 (A), D10.2 (A)
unnamed: Q1.1 (B), R9.2
unnamed: Q1.3 (C), U4.14 (PD)
unnamed: Q2.1 (B), R10.2
unnamed: Q2.3 (C), U5.14 (PD)
unnamed: J5.1, U1.29 (GPIO16/U0TXD)
unnamed: J4.1, U1.28 (GPIO17/U0RXD)
unnamed: C6.1, C17.1, U2.27 (DCVDD), U3.3 (VO)
unnamed: C19.2, U2.9 (LHPOUT)
unnamed: C3.1, U2.20 (LLINEIN)
unnamed: C1.1, U2.12 (LOUT)
unnamed: C20.2, U2.10 (RHPOUT)
unnamed: C4.1, U2.19 (RLINEIN)
unnamed: C5.2, U2.13 (ROUT)
unnamed: C2.1, C18.1, U2.16 (VMID)
unnamed: R4.2, U4.5 (SHK)
unnamed: C7.1, C9.1, R7.2, U4.11 (VA)
unnamed: C5.1, U4.9 (Vin)
unnamed: C4.2, U4.10 (Vout)
unnamed: R6.2, U5.5 (SHK)
unnamed: C8.1, C10.1, R8.2, U5.11 (VA)
unnamed: C1.2, U5.9 (Vin)
unnamed: C3.2, U5.10 (Vout)
