sdylewski/Analog-Redial/Bluetooth/BM64/BM64_Board_v1/Bluetooth_board.kicad_pcb

## KiCad design Bluetooth/BM64/BM64_Board_v1/Bluetooth_board.kicad_pcb (2026-10-20)

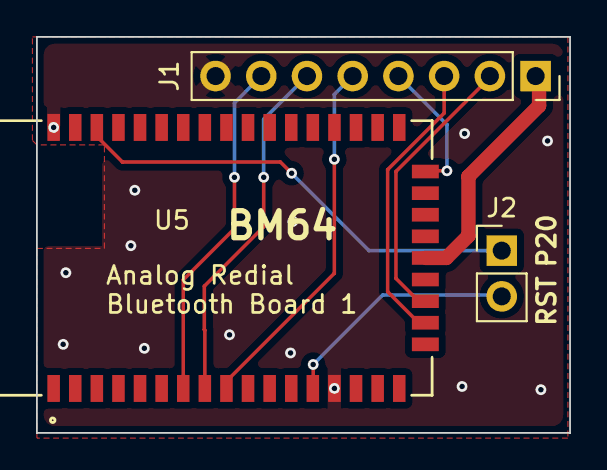
[picture p127: board Bluetooth/BM64/BM64_Board_v1/Bluetooth_board.kicad_pcb from above]

Board: 2 copper layers, 29.6 x 22.0 mm, 3 parts (0 on the bottom side), 10 nets.

Parts:
J1: PINHD_1x8_Female; PinSocket_1x08_P2.54mm_Vertical
J2: PINHD_1x4_Male; PinHeader_1x02_P2.54mm_Vertical
U5: BM64SPKS1MC2-0003AA; BM64_MCH

Connections:
+3.3V: J1.1, U5.22 (BAT_IN)
/A0HPL: J1.7, U5.7 (AOHPL)
/Mic_N1: J1.6, U5.8 (MIC_N1)
/Mic_P1: J1.5, U5.9 (MIC_P1)
/RST: J2.2, U5.13 (RST_N)
/espUartRx: J1.2, U5.20 (HCI_TXD)
/espUartTx: J1.3, U5.19 (HCI_RXD)
GND: J1.8, U5.14 (GND), U5.43 (GND)
unnamed: J1.4, U5.26 (MFB)
unnamed: J2.1, U5.41 (P2_0)
