sdylewski/Analog-Redial/firmware/components/board/board.c

#include "sdkconfig.h"
#if CONFIG_BOARD_TYPE_SMD5_CHEAP
#include "hal/usb_serial_jtag_ll.h"
#endif
#include "board.h"
#include "board_pins.h"
#include "board_config.h"
#include "esp_log.h"
#include "esp_timer.h"
#include "esp_mac.h"
#include "esp_chip_info.h"
#include "esp_idf_version.h"
#include "nvs_flash.h"
#include "nvs.h"
#include "esp_system.h"
#include "driver/gpio.h"
#include "esp_rom_sys.h"
#include "driver/ledc.h"
#include "led_strip.h"
#include "freertos/FreeRTOS.h"
#include "freertos/task.h"
#include <stdbool.h>
#include <stdlib.h>
#include <string.h>
#include <ctype.h>
#include <stdio.h>
#include <time.h>

const char board_image_marker[] = "\x01" "AR-BOARD" "\x02" BOARD_IMAGE_ID "\x03";

static const char *TAG = "board";
static i2c_master_bus_handle_t s_bus;
static board_codec_t s_detected_codec = BOARD_CODEC_NONE;

#define BOARD_NAME_NVS_NS  "board"
#define BOARD_NAME_NVS_KEY "name"
#define BOARD_NAME_MAX     32
#define BOARD_LANG_NVS_KEY "lang"
#define BOARD_LANG_MAX     8
#define BOARD_ROH_EN_KEY   "roh_en"
#define BOARD_ROH_SECS_KEY "roh_secs"
#define BOARD_TONE_LANG_KEY "tone_lang"

void board_early_pin_init(void)
{
#if CONFIG_BOARD_TYPE_SMD5_CHEAP
    /* The chip's ROM hands GPIO12/13 to the native-USB PHY at every reset
     * (D+ pull-up on), and ESP-IDF's GPIO driver doesn't take them back on
     * its own -- with the PHY still attached, MCLK never reaches the
     * codec. The clone's USB port isn't the console on this variant
     * (UART0 is), so nothing is lost. Don't plug a USB cable into the
     * clone module's own native-USB port while it runs: it shares these
     * two pins with MCLK and card-detect. */
    usb_serial_jtag_pull_override_vals_t no_pulls = { 0 };
    usb_serial_jtag_ll_phy_enable_pull_override(&no_pulls);
    usb_serial_jtag_ll_phy_enable_pad(false);
    ESP_LOGI(TAG, "clone MCU module: native USB detached from GPIO12/13 (MCLK, SD card-detect)");
#endif
}

#if BOARD_LINE1_ON_EXPANDER
/* SMD6 reads the bus every few ms, so a reset can land mid-transfer. A slave
 * left holding SDA low then blocks the codec too, and only clocks free it:
 * nine, then a STOP. */
static void i2c_bus_clear(void)
{
    gpio_config_t io = {
        .pin_bit_mask = (1ULL << BOARD_I2C_SCL) | (1ULL << BOARD_I2C_SDA),
        .mode = GPIO_MODE_INPUT_OUTPUT_OD,
        .pull_up_en = GPIO_PULLUP_ENABLE,
        .pull_down_en = GPIO_PULLDOWN_DISABLE,
        .intr_type = GPIO_INTR_DISABLE,
    };
    gpio_set_level(BOARD_I2C_SCL, 1);
    gpio_set_level(BOARD_I2C_SDA, 1);
    gpio_config(&io);
    for (int i = 0; i < 9 && !gpio_get_level(BOARD_I2C_SDA); i++) {
        gpio_set_level(BOARD_I2C_SCL, 0);
        esp_rom_delay_us(5);
        gpio_set_level(BOARD_I2C_SCL, 1);
        esp_rom_delay_us(5);
    }
    gpio_set_level(BOARD_I2C_SDA, 0);
    esp_rom_delay_us(5);
    gpio_set_level(BOARD_I2C_SDA, 1);
    esp_rom_delay_us(5);
}
#endif

esp_err_t board_i2c_init(void)
{
    if (s_bus) {
        return ESP_OK;
    }
#if BOARD_LINE1_ON_EXPANDER
    i2c_bus_clear();
#endif
    i2c_master_bus_config_t cfg = {
        .clk_source = I2C_CLK_SRC_DEFAULT,
        .i2c_port = I2C_NUM_0,
        .scl_io_num = BOARD_I2C_SCL,
        .sda_io_num = BOARD_I2C_SDA,
        .glitch_ignore_cnt = 7,
        .flags.enable_internal_pullup = true,
    };
    esp_err_t err = i2c_new_master_bus(&cfg, &s_bus);
    if (err != ESP_OK) {
        ESP_LOGE(TAG, "i2c_new_master_bus failed: %s", esp_err_to_name(err));
        s_bus = NULL;
        return err;
    }
    ESP_LOGI(TAG, "I2C bus up (SDA=%d SCL=%d, board=%s)", BOARD_I2C_SDA,
             BOARD_I2C_SCL, board_pcb_variant_name());
    return ESP_OK;
}

i2c_master_bus_handle_t board_i2c_bus(void)
{
    return s_bus;
}

#define BOARD_ES8388_ADDR 0x10

void board_detect_codec(void)
{
    if (board_i2c_init() != ESP_OK) {
        ESP_LOGW(TAG, "board_detect_codec: I2C bus not available");
        return;
    }
    if (i2c_master_probe(s_bus, BOARD_ES8388_ADDR, 50) == ESP_OK) {
        s_detected_codec = BOARD_CODEC_ES8388;
        ESP_LOGI(TAG, "codec detect: ES8388 @ 0x10");
    } else {
        s_detected_codec = BOARD_CODEC_NONE;
        ESP_LOGW(TAG, "codec detect: no ES8388 answering at 0x10 (built for %s)",
                 board_pcb_variant_name());
    }
}

board_codec_t board_detected_codec(void) { return s_detected_codec; }

const char *board_codec_name(board_codec_t c)
{
    switch (c) {
        case BOARD_CODEC_ES8388:   return "ES8388";
        default:                    return "none detected";
    }
}

void board_serial_str(char *out, size_t len)
{
    uint8_t mac[6] = {0};
    /* ESP_MAC_WIFI_STA is the base factory MAC -- present even before WiFi
     * starts, and stable across reflashes/NVS erases. */
    esp_read_mac(mac, ESP_MAC_WIFI_STA);
    snprintf(out, len, "%02X%02X%02X%02X%02X%02X",
             mac[0], mac[1], mac[2], mac[3], mac[4], mac[5]);
}

#define PCB_TYPE_NVS_KEY "pcb_type"

static bool s_type_mismatch;

void board_type_check(void)
{
    nvs_handle_t h;
    if (nvs_open(BOARD_NAME_NVS_NS, NVS_READWRITE, &h) != ESP_OK) return;
    char recorded[16] = {0};
    size_t n = sizeof(recorded);
    esp_err_t err = nvs_get_str(h, PCB_TYPE_NVS_KEY, recorded, &n);
    const char *current = board_pcb_variant_name();
    if (err != ESP_OK || !recorded[0]) {
        /* Nothing recorded yet -- first boot ever, or a board already in
         * the field from before this feature existed. Either way, there's
         * nothing to compare against, so record the current type as the
         * trusted baseline rather than flagging a mismatch that isn't
         * actually one. */
        nvs_set_str(h, PCB_TYPE_NVS_KEY, current);
        nvs_commit(h);
        s_type_mismatch = false;
    } else {
        s_type_mismatch = (strcmp(recorded, current) != 0);
        if (s_type_mismatch) {
            ESP_LOGE(TAG, "BOARD TYPE MISMATCH: this firmware is built for %s, but this "
                          "physical board last confirmed booting as %s -- wrong firmware for "
                          "this board (Settings -> Hardware)", current, recorded);
        }
    }
    nvs_close(h);
}

bool board_type_mismatch(void) { return s_type_mismatch; }

void board_type_recorded(char *out, size_t len)
{
    if (len == 0) return;
    out[0] = '\0';
    nvs_handle_t h;
    if (nvs_open(BOARD_NAME_NVS_NS, NVS_READONLY, &h) != ESP_OK) return;
    size_t n = len;
    nvs_get_str(h, PCB_TYPE_NVS_KEY, out, &n);
    nvs_close(h);
}

esp_err_t board_type_confirm(void)
{
    nvs_handle_t h;
    esp_err_t err = nvs_open(BOARD_NAME_NVS_NS, NVS_READWRITE, &h);
    if (err != ESP_OK) return err;
    err = nvs_set_str(h, PCB_TYPE_NVS_KEY, board_pcb_variant_name());
    if (err == ESP_OK) err = nvs_commit(h);
    nvs_close(h);
    if (err == ESP_OK) {
        s_type_mismatch = false;
        ESP_LOGI(TAG, "board type confirmed as %s", board_pcb_variant_name());
    }
    return err;
}

void board_hardware_str(char *out, size_t len)
{
    esp_chip_info_t info;
    esp_chip_info(&info);
    const char *chip =
        (info.model == CHIP_ESP32C6) ? "ESP32-C6" :
        (info.model == CHIP_ESP32C3) ? "ESP32-C3" : "ESP32";
    /* "?" = the probe hasn't run or found nothing (e.g. bench, no codec). */
    const char *codec = (s_detected_codec == BOARD_CODEC_ES8388) ? "ES8388" : "ES8388?";
    snprintf(out, len, "%s rev%d.%d \xc2\xb7 %s (%s)",
             chip, info.revision / 100, info.revision % 100, codec,
             board_pcb_variant_name());
}

void board_name_get(char *out, size_t len)
{
    if (len == 0) return;
    out[0] = '\0';
    nvs_handle_t h;
    if (nvs_open(BOARD_NAME_NVS_NS, NVS_READONLY, &h) == ESP_OK) {
        size_t n = len;
        esp_err_t err = nvs_get_str(h, BOARD_NAME_NVS_KEY, out, &n);
        nvs_close(h);
        if (err == ESP_OK && out[0]) return;
    }
    strncpy(out, CONFIG_MDNS_HOSTNAME, len - 1);
    out[len - 1] = '\0';
}

bool board_name_is_set(void)
{
    nvs_handle_t h;
    if (nvs_open(BOARD_NAME_NVS_NS, NVS_READONLY, &h) != ESP_OK) return false;
    size_t n = 0;
    esp_err_t err = nvs_get_str(h, BOARD_NAME_NVS_KEY, NULL, &n); /* size probe */
    nvs_close(h);
    return err == ESP_OK && n > 1; /* n counts the NUL, so >1 means non-empty */
}

esp_err_t board_name_clear(void)
{
    nvs_handle_t h;
    esp_err_t err = nvs_open(BOARD_NAME_NVS_NS, NVS_READWRITE, &h);
    if (err != ESP_OK) return err;
    nvs_erase_key(h, BOARD_NAME_NVS_KEY); /* NOT_FOUND is fine */
    err = nvs_commit(h);
    nvs_close(h);
    return err;
}

esp_err_t board_name_set(const char *name)
{
    if (!name || !name[0]) return ESP_ERR_INVALID_ARG;
    char trimmed[BOARD_NAME_MAX];
    strncpy(trimmed, name, sizeof(trimmed) - 1);
    trimmed[sizeof(trimmed) - 1] = '\0';

    nvs_handle_t h;
    esp_err_t err = nvs_open(BOARD_NAME_NVS_NS, NVS_READWRITE, &h);
    if (err != ESP_OK) return err;
    err = nvs_set_str(h, BOARD_NAME_NVS_KEY, trimmed);
    if (err == ESP_OK) err = nvs_commit(h);
    nvs_close(h);
    if (err == ESP_OK) ESP_LOGI(TAG, "board name set to '%s'", trimmed);
    return err;
}

/* Every translated string on a web page asks for the language (i18n_str()),
 * a page has hundreds of them, and each flash lookup cost a few ms: a page
 * took a second to render, and the web server starved the audio meanwhile.
 * So it's read from flash once and kept here; board_language_set() updates it. */
static char s_lang_cache[BOARD_LANG_MAX];
static bool s_lang_cached;
static portMUX_TYPE s_lang_mux = portMUX_INITIALIZER_UNLOCKED;

void board_language_get(char *out, size_t len)
{
    if (len == 0) return;
    portENTER_CRITICAL(&s_lang_mux);
    bool have = s_lang_cached;
    if (have) {
        strncpy(out, s_lang_cache, len - 1);
        out[len - 1] = '\0';
    }
    portEXIT_CRITICAL(&s_lang_mux);
    if (have) return;

    char found[BOARD_LANG_MAX] = "en";
    nvs_handle_t h;
    if (nvs_open(BOARD_NAME_NVS_NS, NVS_READONLY, &h) == ESP_OK) {
        char tmp[BOARD_LANG_MAX];
        size_t n = sizeof(tmp);
        if (nvs_get_str(h, BOARD_LANG_NVS_KEY, tmp, &n) == ESP_OK && tmp[0]) {
            strncpy(found, tmp, sizeof(found) - 1);
            found[sizeof(found) - 1] = '\0';
        }
        nvs_close(h);
    }
    portENTER_CRITICAL(&s_lang_mux);
    strncpy(s_lang_cache, found, sizeof(s_lang_cache) - 1);
    s_lang_cache[sizeof(s_lang_cache) - 1] = '\0';
    s_lang_cached = true;
    portEXIT_CRITICAL(&s_lang_mux);
    strncpy(out, found, len - 1);
    out[len - 1] = '\0';
}

esp_err_t board_language_set(const char *lang)
{
    if (!lang || !lang[0]) return ESP_ERR_INVALID_ARG;
    char trimmed[BOARD_LANG_MAX];
    strncpy(trimmed, lang, sizeof(trimmed) - 1);
    trimmed[sizeof(trimmed) - 1] = '\0';

    nvs_handle_t h;
    esp_err_t err = nvs_open(BOARD_NAME_NVS_NS, NVS_READWRITE, &h);
    if (err != ESP_OK) return err;
    err = nvs_set_str(h, BOARD_LANG_NVS_KEY, trimmed);
    if (err == ESP_OK) err = nvs_commit(h);
    nvs_close(h);
    if (err == ESP_OK) {
        portENTER_CRITICAL(&s_lang_mux);
        strncpy(s_lang_cache, trimmed, sizeof(s_lang_cache) - 1);
        s_lang_cache[sizeof(s_lang_cache) - 1] = '\0';
        s_lang_cached = true;
        portEXIT_CRITICAL(&s_lang_mux);
        ESP_LOGI(TAG, "phone language set to '%s'", trimmed);
    }
    return err;
}

bool board_tone_follow_language_get(void)
{
    nvs_handle_t h;
    if (nvs_open(BOARD_NAME_NVS_NS, NVS_READONLY, &h) != ESP_OK) return true;
    uint8_t follow;
    esp_err_t err = nvs_get_u8(h, BOARD_TONE_LANG_KEY, &follow);
    nvs_close(h);
    return (err == ESP_OK) ? (follow != 0) : true;
}

void board_tone_region_get(char *out, size_t len)
{
    if (!out || !len) return;
    nvs_handle_t h;
    out[0] = '\0';
    if (nvs_open(BOARD_NAME_NVS_NS, NVS_READONLY, &h) == ESP_OK) {
        size_t n = len;
        if (nvs_get_str(h, "tone_region", out, &n) != ESP_OK) out[0] = '\0';
        nvs_close(h);
    }
    if (!out[0]) strlcpy(out, "us", len);
}

esp_err_t board_tone_region_set(const char *code)
{
    if (!code || !code[0]) return ESP_ERR_INVALID_ARG;
    nvs_handle_t h;
    esp_err_t err = nvs_open(BOARD_NAME_NVS_NS, NVS_READWRITE, &h);
    if (err != ESP_OK) return err;
    err = nvs_set_str(h, "tone_region", code);
    if (err == ESP_OK) err = nvs_commit(h);
    nvs_close(h);
    return err;
}

int board_feature_get(const char *key)
{
    nvs_handle_t h;
    if (nvs_open(BOARD_NAME_NVS_NS, NVS_READONLY, &h) != ESP_OK) return -1;
    uint8_t v;
    esp_err_t err = nvs_get_u8(h, key, &v);
    nvs_close(h);
    return err == ESP_OK ? (v != 0) : -1;
}

esp_err_t board_feature_set(const char *key, bool on)
{
    nvs_handle_t h;
    esp_err_t err = nvs_open(BOARD_NAME_NVS_NS, NVS_READWRITE, &h);
    if (err != ESP_OK) return err;
    err = nvs_set_u8(h, key, on ? 1 : 0);
    if (err == ESP_OK) err = nvs_commit(h);
    nvs_close(h);
    return err;
}

/* ---- restart record ---- */
static volatile bool s_power_warn;
static bool s_power_announced;

static uint32_t nvs_u32(nvs_handle_t h, const char *key, uint32_t dflt)
{
    uint32_t v;
    return nvs_get_u32(h, key, &v) == ESP_OK ? v : dflt;
}

void board_restart_record(void)
{
    esp_reset_reason_t rr = esp_reset_reason();
    nvs_handle_t h;
    if (nvs_open(BOARD_NAME_NVS_NS, NVS_READWRITE, &h) != ESP_OK) return;
    uint32_t boots = nvs_u32(h, "rst_boots", 0) + 1;
    nvs_set_u32(h, "rst_boots", boots);
    if (rr == ESP_RST_BROWNOUT) {
        nvs_set_u32(h, "rst_bo", nvs_u32(h, "rst_bo", 0) + 1);
        nvs_set_u32(h, "rst_bo_at", boots);
        nvs_set_u8(h, "pwr_warn", 1);
    } else if (rr == ESP_RST_PANIC) {
        nvs_set_u32(h, "rst_crash", nvs_u32(h, "rst_crash", 0) + 1);
    } else if (rr == ESP_RST_INT_WDT || rr == ESP_RST_TASK_WDT || rr == ESP_RST_WDT) {
        nvs_set_u32(h, "rst_wdt", nvs_u32(h, "rst_wdt", 0) + 1);
    }
    uint8_t w = 0;
    nvs_get_u8(h, "pwr_warn", &w);
    s_power_warn = w != 0;
    nvs_commit(h);
    nvs_close(h);
}

void board_restart_stats_get(board_restart_stats_t *out)
{
    memset(out, 0, sizeof(*out));
    out->boots_since_brownout = UINT32_MAX;
    out->power_warning = s_power_warn;
    nvs_handle_t h;
    if (nvs_open(BOARD_NAME_NVS_NS, NVS_READONLY, &h) != ESP_OK) return;
    out->boots = nvs_u32(h, "rst_boots", 0);
    out->brownouts = nvs_u32(h, "rst_bo", 0);
    out->crashes = nvs_u32(h, "rst_crash", 0);
    out->watchdogs = nvs_u32(h, "rst_wdt", 0);
    uint32_t at = nvs_u32(h, "rst_bo_at", 0);
    if (out->brownouts && at && at <= out->boots) out->boots_since_brownout = out->boots - at;
    nvs_close(h);
}

bool board_power_warning(void) { return s_power_warn; }

void board_power_warning_clear(void)
{
    s_power_warn = false;
    nvs_handle_t h;
    if (nvs_open(BOARD_NAME_NVS_NS, NVS_READWRITE, &h) != ESP_OK) return;
    nvs_set_u8(h, "pwr_warn", 0);
    nvs_commit(h);
    nvs_close(h);
}

void board_restart_stats_clear(void)
{
    s_power_warn = false;
    nvs_handle_t h;
    if (nvs_open(BOARD_NAME_NVS_NS, NVS_READWRITE, &h) != ESP_OK) return;
    const char *keys[] = { "rst_boots", "rst_bo", "rst_bo_at", "rst_crash", "rst_wdt", "pwr_warn" };
    for (size_t i = 0; i < sizeof(keys) / sizeof(keys[0]); i++) nvs_erase_key(h, keys[i]);
    nvs_commit(h);
    nvs_close(h);
}

bool board_power_warning_announce(void)
{
    if (!s_power_warn || s_power_announced) return false;
    s_power_announced = true;
    return true;
}

bool board_voice_fx_enabled_get(void)
{
    nvs_handle_t h;
    if (nvs_open(BOARD_NAME_NVS_NS, NVS_READONLY, &h) != ESP_OK) return false;   /* experimental: off unless turned on */
    uint8_t en;
    esp_err_t err = nvs_get_u8(h, "voice_fx_en", &en);
    nvs_close(h);
    return (err == ESP_OK) ? (en != 0) : false;
}

esp_err_t board_voice_fx_enabled_set(bool enabled)
{
    nvs_handle_t h;
    esp_err_t err = nvs_open(BOARD_NAME_NVS_NS, NVS_READWRITE, &h);
    if (err != ESP_OK) return err;
    err = nvs_set_u8(h, "voice_fx_en", enabled ? 1 : 0);
    if (err == ESP_OK) err = nvs_commit(h);
    nvs_close(h);
    return err;
}

size_t board_voice_fx_tuning_get(int16_t *v, size_t n)
{
    nvs_handle_t h;
    if (nvs_open(BOARD_NAME_NVS_NS, NVS_READONLY, &h) != ESP_OK) return 0;
    int16_t tmp[32];
    size_t len = sizeof(tmp), got = 0;
    if (nvs_get_blob(h, "fx_tune", tmp, &len) == ESP_OK) {
        got = len / sizeof(int16_t);
        if (got > n) got = n;
        memcpy(v, tmp, got * sizeof(int16_t));
    }
    nvs_close(h);
    return got;
}

esp_err_t board_voice_fx_tuning_set(const int16_t *v, size_t n)
{
    if (n > 32) return ESP_ERR_INVALID_ARG;
    nvs_handle_t h;
    esp_err_t err = nvs_open(BOARD_NAME_NVS_NS, NVS_READWRITE, &h);
    if (err != ESP_OK) return err;
    err = nvs_set_blob(h, "fx_tune", v, n * sizeof(int16_t));
    if (err == ESP_OK) err = nvs_commit(h);
    /* The earlier single-value keys, from before this was an array. */
    nvs_erase_key(h, "fx_chip_pct");
    nvs_erase_key(h, "fx_rb_mix");
    nvs_erase_key(h, "fx_rb_hz");
    nvs_commit(h);
    nvs_close(h);
    return err;
}

size_t board_voice_fx_keys_get(char *keys, size_t n)
{
    nvs_handle_t h;
    if (nvs_open(BOARD_NAME_NVS_NS, NVS_READONLY, &h) != ESP_OK) return 0;
    char tmp[16];
    size_t len = sizeof(tmp), got = 0;
    if (nvs_get_blob(h, "fx_keys", tmp, &len) == ESP_OK) {
        got = len < n ? len : n;
        memcpy(keys, tmp, got);
    }
    nvs_close(h);
    return got;
}

esp_err_t board_voice_fx_keys_set(const char *keys, size_t n)
{
    if (n > 16) return ESP_ERR_INVALID_ARG;
    nvs_handle_t h;
    esp_err_t err = nvs_open(BOARD_NAME_NVS_NS, NVS_READWRITE, &h);
    if (err != ESP_OK) return err;
    err = nvs_set_blob(h, "fx_keys", keys, n);
    if (err == ESP_OK) err = nvs_commit(h);
    nvs_close(h);
    return err;
}

bool board_alarm_quiet_override_get(void)
{
    nvs_handle_t h;
    if (nvs_open(BOARD_NAME_NVS_NS, NVS_READONLY, &h) != ESP_OK) return false;
    uint8_t v;
    esp_err_t err = nvs_get_u8(h, "alarm_qh", &v);
    nvs_close(h);
    return err == ESP_OK && v != 0;
}

esp_err_t board_alarm_quiet_override_set(bool on)
{
    nvs_handle_t h;
    esp_err_t err = nvs_open(BOARD_NAME_NVS_NS, NVS_READWRITE, &h);
    if (err != ESP_OK) return err;
    err = nvs_set_u8(h, "alarm_qh", on ? 1 : 0);
    if (err == ESP_OK) err = nvs_commit(h);
    nvs_close(h);
    return err;
}

/* Alarm: 2 s on, 1 s off, three times, so it's told apart from a call.
 * Timer: 1 s on, 1 s off, three times. */
static const board_ring_pattern_t RING_PATTERN_DEFAULT[2] = {
    [BOARD_RING_ALARM] = { 2000, 1000, 3 },
    [BOARD_RING_TIMER] = { 1000, 1000, 3 },
};

static board_ring_pattern_t ring_pattern_clamp(board_ring_pattern_t p)
{
    if (p.on_ms < BOARD_RING_ON_MIN_MS) p.on_ms = BOARD_RING_ON_MIN_MS;
    if (p.on_ms > BOARD_RING_ON_MAX_MS) p.on_ms = BOARD_RING_ON_MAX_MS;
    if (p.off_ms < BOARD_RING_OFF_MIN_MS) p.off_ms = BOARD_RING_OFF_MIN_MS;
    if (p.off_ms > BOARD_RING_OFF_MAX_MS) p.off_ms = BOARD_RING_OFF_MAX_MS;
    if (p.count < 1) p.count = 1;
    if (p.count > BOARD_RING_COUNT_MAX) p.count = BOARD_RING_COUNT_MAX;
    return p;
}

board_ring_pattern_t board_ring_pattern_get(board_ring_use_t use)
{
    if (use != BOARD_RING_TIMER) use = BOARD_RING_ALARM;
    board_ring_pattern_t p = RING_PATTERN_DEFAULT[use];
    nvs_handle_t h;
    if (nvs_open(BOARD_NAME_NVS_NS, NVS_READONLY, &h) != ESP_OK) return p;
    board_ring_pattern_t saved;
    size_t len = sizeof(saved);
    if (nvs_get_blob(h, use == BOARD_RING_TIMER ? "ringpat_t" : "ringpat_a", &saved, &len) == ESP_OK &&
        len == sizeof(saved))
        p = ring_pattern_clamp(saved);
    nvs_close(h);
    return p;
}

esp_err_t board_ring_pattern_set(board_ring_use_t use, board_ring_pattern_t p)
{
    if (use != BOARD_RING_TIMER && use != BOARD_RING_ALARM) return ESP_ERR_INVALID_ARG;
    p = ring_pattern_clamp(p);
    nvs_handle_t h;
    esp_err_t err = nvs_open(BOARD_NAME_NVS_NS, NVS_READWRITE, &h);
    if (err != ESP_OK) return err;
    err = nvs_set_blob(h, use == BOARD_RING_TIMER ? "ringpat_t" : "ringpat_a", &p, sizeof(p));
    if (err == ESP_OK) err = nvs_commit(h);
    nvs_close(h);
    return err;
}

esp_err_t board_tone_follow_language_set(bool follow)
{
    nvs_handle_t h;
    esp_err_t err = nvs_open(BOARD_NAME_NVS_NS, NVS_READWRITE, &h);
    if (err != ESP_OK) return err;
    err = nvs_set_u8(h, BOARD_TONE_LANG_KEY, follow ? 1 : 0);
    if (err == ESP_OK) err = nvs_commit(h);
    nvs_close(h);
    if (err == ESP_OK) {
        ESP_LOGI(TAG, "call-progress tones %s language setting",
                 follow ? "now follow" : "no longer follow");
    }
    return err;
}

board_offhook_alert_t board_offhook_alert_get(void)
{
    /* Defaults: on, 120 s. Real switches escalate in stages over ~30-60 s
     * (see the ROH notes in tones.h); 2 minutes is deliberately more patient
     * than a PSTN switch would be -- this is a home phone where sitting on
     * dial tone thinking for a minute is normal, and the alert is loud. */
    board_offhook_alert_t cfg = { .enabled = true, .seconds = 120 };

    nvs_handle_t h;
    if (nvs_open(BOARD_NAME_NVS_NS, NVS_READONLY, &h) != ESP_OK) return cfg;
    uint8_t en;
    if (nvs_get_u8(h, BOARD_ROH_EN_KEY, &en) == ESP_OK) cfg.enabled = (en != 0);
    uint32_t secs;
    if (nvs_get_u32(h, BOARD_ROH_SECS_KEY, &secs) == ESP_OK &&
        secs >= BOARD_OFFHOOK_ALERT_MIN_S && secs <= BOARD_OFFHOOK_ALERT_MAX_S) {
        cfg.seconds = secs;
    }
    nvs_close(h);
    return cfg;
}

esp_err_t board_offhook_alert_set(board_offhook_alert_t cfg)
{
    if (cfg.seconds < BOARD_OFFHOOK_ALERT_MIN_S ||
        cfg.seconds > BOARD_OFFHOOK_ALERT_MAX_S) {
        return ESP_ERR_INVALID_ARG;
    }
    nvs_handle_t h;
    esp_err_t err = nvs_open(BOARD_NAME_NVS_NS, NVS_READWRITE, &h);
    if (err != ESP_OK) return err;
    err = nvs_set_u8(h, BOARD_ROH_EN_KEY, cfg.enabled ? 1 : 0);
    if (err == ESP_OK) err = nvs_set_u32(h, BOARD_ROH_SECS_KEY, cfg.seconds);
    if (err == ESP_OK) err = nvs_commit(h);
    nvs_close(h);
    if (err == ESP_OK) {
        ESP_LOGI(TAG, "off-hook alert %s, %u s",
                 cfg.enabled ? "enabled" : "disabled", (unsigned)cfg.seconds);
    }
    return err;
}

board_intercom_t board_intercom_get(void)
{
    board_intercom_t cfg = { .enabled = false, .seconds = 4 };
    nvs_handle_t h;
    if (nvs_open(BOARD_NAME_NVS_NS, NVS_READONLY, &h) != ESP_OK) return cfg;
    uint8_t v;
    if (nvs_get_u8(h, "icom_en", &v) == ESP_OK) cfg.enabled = (v != 0);
    if (nvs_get_u8(h, "icom_secs", &v) == ESP_OK &&
        v >= BOARD_INTERCOM_MIN_S && v <= BOARD_INTERCOM_MAX_S) cfg.seconds = v;
    nvs_close(h);
    return cfg;
}

esp_err_t board_intercom_set(board_intercom_t cfg)
{
    if (cfg.seconds < BOARD_INTERCOM_MIN_S || cfg.seconds > BOARD_INTERCOM_MAX_S) return ESP_ERR_INVALID_ARG;
    nvs_handle_t h;
    esp_err_t err = nvs_open(BOARD_NAME_NVS_NS, NVS_READWRITE, &h);
    if (err != ESP_OK) return err;
    err = nvs_set_u8(h, "icom_en", cfg.enabled ? 1 : 0);
    if (err == ESP_OK) err = nvs_set_u8(h, "icom_secs", cfg.seconds);
    if (err == ESP_OK) err = nvs_commit(h);
    nvs_close(h);
    if (err == ESP_OK) ESP_LOGI(TAG, "intercom %s, %u s", cfg.enabled ? "enabled" : "disabled", (unsigned)cfg.seconds);
    return err;
}

#define AM_EN_NVS_KEY0     "am_en0"
#define AM_EN_NVS_KEY1     "am_en1"
#define AM_RINGS_NVS_KEY0  "am_rings0"
#define AM_RINGS_NVS_KEY1  "am_rings1"
#define AM_MAXMS_NVS_KEY0  "am_maxms0"
#define AM_MAXMS_NVS_KEY1  "am_maxms1"
#define AM_OTHER_NVS_KEY0  "am_other0"
#define AM_OTHER_NVS_KEY1  "am_other1"

board_am_cfg_t board_am_get(int line)
{
    board_am_cfg_t cfg = { .enabled = false, .rings = 4, .max_ms = 30000, .other_line = false };
    nvs_handle_t h;
    if (nvs_open(BOARD_NAME_NVS_NS, NVS_READONLY, &h) != ESP_OK) return cfg;
    uint8_t en, rings, other;
    if (nvs_get_u8(h, line == 1 ? AM_EN_NVS_KEY1 : AM_EN_NVS_KEY0, &en) == ESP_OK) {
        cfg.enabled = (en != 0);
    }
    if (nvs_get_u8(h, line == 1 ? AM_RINGS_NVS_KEY1 : AM_RINGS_NVS_KEY0, &rings) == ESP_OK &&
        rings >= BOARD_AM_RINGS_MIN && rings <= BOARD_AM_RINGS_MAX) {
        cfg.rings = rings;
    }
    uint32_t ms;
    if (nvs_get_u32(h, line == 1 ? AM_MAXMS_NVS_KEY1 : AM_MAXMS_NVS_KEY0, &ms) == ESP_OK &&
        ms >= BOARD_AM_MAX_MS_MIN && ms <= BOARD_AM_MAX_MS_MAX) {
        cfg.max_ms = ms;
    }
    if (nvs_get_u8(h, line == 1 ? AM_OTHER_NVS_KEY1 : AM_OTHER_NVS_KEY0, &other) == ESP_OK) {
        cfg.other_line = (other != 0);
    }
    nvs_close(h);
    return cfg;
}

esp_err_t board_am_set(int line, board_am_cfg_t cfg)
{
    if (cfg.rings < BOARD_AM_RINGS_MIN || cfg.rings > BOARD_AM_RINGS_MAX ||
        cfg.max_ms < BOARD_AM_MAX_MS_MIN || cfg.max_ms > BOARD_AM_MAX_MS_MAX) {
        return ESP_ERR_INVALID_ARG;
    }
    nvs_handle_t h;
    esp_err_t err = nvs_open(BOARD_NAME_NVS_NS, NVS_READWRITE, &h);
    if (err != ESP_OK) return err;
    err = nvs_set_u8(h, line == 1 ? AM_EN_NVS_KEY1 : AM_EN_NVS_KEY0, cfg.enabled ? 1 : 0);
    if (err == ESP_OK) err = nvs_set_u8(h, line == 1 ? AM_RINGS_NVS_KEY1 : AM_RINGS_NVS_KEY0, cfg.rings);
    if (err == ESP_OK) err = nvs_set_u32(h, line == 1 ? AM_MAXMS_NVS_KEY1 : AM_MAXMS_NVS_KEY0, cfg.max_ms);
    if (err == ESP_OK) err = nvs_set_u8(h, line == 1 ? AM_OTHER_NVS_KEY1 : AM_OTHER_NVS_KEY0, cfg.other_line ? 1 : 0);
    if (err == ESP_OK) err = nvs_commit(h);
    nvs_close(h);
    if (err == ESP_OK) {
        ESP_LOGI(TAG, "line %d: answering machine %s, %u rings, %u ms, other-line %s",
                 line, cfg.enabled ? "enabled" : "disabled", (unsigned)cfg.rings,
                 (unsigned)cfg.max_ms, cfg.other_line ? "on" : "off");
    }
    return err;
}

#define BOARD_TZ_NVS_KEY "tz"

/* setenv("TZ", ...) + tzset() only changes what localtime_r() does --
 * everything else that already cares about wall-clock time uses gmtime_r()
 * explicitly (recording timestamps, telephony.c), so this can't affect
 * them. Safe to call as often as the setting changes; not on any hot path. */
static void board_timezone_apply(const char *tz)
{
    /* "UTC0" rather than no TZ at all: with TZ unset newlib names the zone
     * "GMT", which is what the web UI then shows. */
    setenv("TZ", (tz && tz[0]) ? tz : "UTC0", 1);
    tzset();
}

void board_timezone_get(char *out, size_t len)
{
    if (len == 0) return;
    nvs_handle_t h;
    if (nvs_open(BOARD_NAME_NVS_NS, NVS_READONLY, &h) == ESP_OK) {
        size_t n = len;
        esp_err_t err = nvs_get_str(h, BOARD_TZ_NVS_KEY, out, &n);
        nvs_close(h);
        if (err == ESP_OK) return;
    }
    out[0] = '\0'; /* "" = UTC */
}

bool board_timezone_is_chosen(void)
{
    nvs_handle_t h;
    if (nvs_open(BOARD_NAME_NVS_NS, NVS_READONLY, &h) != ESP_OK) return false;
    size_t n = 0;
    esp_err_t err = nvs_get_str(h, BOARD_TZ_NVS_KEY, NULL, &n);
    nvs_close(h);
    return err == ESP_OK;
}

esp_err_t board_timezone_set(const char *tz)
{
    if (!tz) return ESP_ERR_INVALID_ARG;
    char trimmed[BOARD_TZ_MAX];
    strncpy(trimmed, tz, sizeof(trimmed) - 1);
    trimmed[sizeof(trimmed) - 1] = '\0';

    nvs_handle_t h;
    esp_err_t err = nvs_open(BOARD_NAME_NVS_NS, NVS_READWRITE, &h);
    if (err != ESP_OK) return err;
    err = nvs_set_str(h, BOARD_TZ_NVS_KEY, trimmed);
    if (err == ESP_OK) err = nvs_commit(h);
    nvs_close(h);
    if (err == ESP_OK) {
        board_timezone_apply(trimmed);
        ESP_LOGI(TAG, "timezone set to '%s'", trimmed[0] ? trimmed : "(UTC)");
    }
    return err;
}

void board_timezone_init(void)
{
    char tz[BOARD_TZ_MAX];
    board_timezone_get(tz, sizeof(tz));
    board_timezone_apply(tz);
}

#define QH_EN_NVS_KEY      "qh_en"
#define QH_START_H_NVS_KEY "qh_start_h"
#define QH_START_M_NVS_KEY "qh_start_m"
#define QH_END_H_NVS_KEY   "qh_end_h"
#define QH_END_M_NVS_KEY   "qh_end_m"

board_quiet_hours_t board_quiet_hours_get(void)
{
    /* 21:00-07:00 (9 pm-7 am) once enabled -- see board.h. */
    board_quiet_hours_t cfg = {
        .enabled = false, .start_hour = 21, .start_min = 0, .end_hour = 7, .end_min = 0
    };
    nvs_handle_t h;
    if (nvs_open(BOARD_NAME_NVS_NS, NVS_READONLY, &h) != ESP_OK) return cfg;
    uint8_t en, sh, sm, eh, em;
    if (nvs_get_u8(h, QH_EN_NVS_KEY, &en) == ESP_OK) cfg.enabled = (en != 0);
    if (nvs_get_u8(h, QH_START_H_NVS_KEY, &sh) == ESP_OK && sh <= 23) cfg.start_hour = sh;
    if (nvs_get_u8(h, QH_START_M_NVS_KEY, &sm) == ESP_OK && sm <= 59) cfg.start_min = sm;
    if (nvs_get_u8(h, QH_END_H_NVS_KEY, &eh) == ESP_OK && eh <= 23) cfg.end_hour = eh;
    if (nvs_get_u8(h, QH_END_M_NVS_KEY, &em) == ESP_OK && em <= 59) cfg.end_min = em;
    nvs_close(h);
    return cfg;
}

esp_err_t board_quiet_hours_set(board_quiet_hours_t cfg)
{
    if (cfg.start_hour > 23 || cfg.start_min > 59 || cfg.end_hour > 23 || cfg.end_min > 59) {
        return ESP_ERR_INVALID_ARG;
    }
    nvs_handle_t h;
    esp_err_t err = nvs_open(BOARD_NAME_NVS_NS, NVS_READWRITE, &h);
    if (err != ESP_OK) return err;
    err = nvs_set_u8(h, QH_EN_NVS_KEY, cfg.enabled ? 1 : 0);
    if (err == ESP_OK) err = nvs_set_u8(h, QH_START_H_NVS_KEY, cfg.start_hour);
    if (err == ESP_OK) err = nvs_set_u8(h, QH_START_M_NVS_KEY, cfg.start_min);
    if (err == ESP_OK) err = nvs_set_u8(h, QH_END_H_NVS_KEY, cfg.end_hour);
    if (err == ESP_OK) err = nvs_set_u8(h, QH_END_M_NVS_KEY, cfg.end_min);
    if (err == ESP_OK) err = nvs_commit(h);
    nvs_close(h);
    if (err == ESP_OK) {
        ESP_LOGI(TAG, "quiet hours %s, %02u:%02u-%02u:%02u", cfg.enabled ? "enabled" : "disabled",
                 cfg.start_hour, cfg.start_min, cfg.end_hour, cfg.end_min);
    }
    return err;
}

bool board_quiet_hours_active(void)
{
    board_quiet_hours_t cfg = board_quiet_hours_get();
    if (!cfg.enabled) return false;

    time_t now = time(NULL);
    struct tm t;
    localtime_r(&now, &t);
    int cur = t.tm_hour * 60 + t.tm_min;
    int start = cfg.start_hour * 60 + cfg.start_min;
    int end = cfg.end_hour * 60 + cfg.end_min;

    if (start == end) return true; /* degenerate "all day" window -- fail open, not silent */
    if (start < end) return cur >= start && cur < end;
    return cur >= start || cur < end; /* wraps past midnight, e.g. 21:00-07:00 */
}

#define AEC_DELAY_NVS_KEY0 "aec_delay0"
#define AEC_DELAY_NVS_KEY1 "aec_delay1"

static const char *aec_delay_key(int line)
{
    return (line == 1) ? AEC_DELAY_NVS_KEY1 : AEC_DELAY_NVS_KEY0;
}

uint32_t board_aec_delay_get(int line, uint32_t fallback_ms)
{
    nvs_handle_t h;
    if (nvs_open(BOARD_NAME_NVS_NS, NVS_READONLY, &h) != ESP_OK) return fallback_ms;
    uint32_t ms;
    esp_err_t err = nvs_get_u32(h, aec_delay_key(line), &ms);
    nvs_close(h);
    return (err == ESP_OK) ? ms : fallback_ms;
}

esp_err_t board_aec_delay_set(int line, uint32_t ms)
{
    nvs_handle_t h;
    esp_err_t err = nvs_open(BOARD_NAME_NVS_NS, NVS_READWRITE, &h);
    if (err != ESP_OK) return err;
    err = nvs_set_u32(h, aec_delay_key(line), ms);
    if (err == ESP_OK) err = nvs_commit(h);
    nvs_close(h);
    if (err == ESP_OK) {
        ESP_LOGI(TAG, "line %d: AEC delay %u ms persisted", line, (unsigned)ms);
    }
    return err;
}

uint8_t board_aec_on_get(int line)
{
    nvs_handle_t h;
    if (nvs_open(BOARD_NAME_NVS_NS, NVS_READONLY, &h) != ESP_OK) return 0;
    uint8_t v = 0;
    if (nvs_get_u8(h, line == 1 ? "aec_on1" : "aec_on0", &v) != ESP_OK) v = 0;
    nvs_close(h);
    return v;
}

esp_err_t board_aec_on_set(int line, uint8_t version)
{
    nvs_handle_t h;
    esp_err_t err = nvs_open(BOARD_NAME_NVS_NS, NVS_READWRITE, &h);
    if (err != ESP_OK) return err;
    err = nvs_set_u8(h, line == 1 ? "aec_on1" : "aec_on0", version);
    if (err == ESP_OK) err = nvs_commit(h);
    nvs_close(h);
    return err;
}

bool board_dtmf_tuning_get(int line, void *out, size_t len)
{
    nvs_handle_t h;
    if (nvs_open(BOARD_NAME_NVS_NS, NVS_READONLY, &h) != ESP_OK) return false;
    size_t got = len;
    esp_err_t err = nvs_get_blob(h, (line == 1) ? "dtmf_t1" : "dtmf_t0", out, &got);
    nvs_close(h);
    return err == ESP_OK && got == len;
}

esp_err_t board_dtmf_tuning_set(int line, const void *data, size_t len)
{
    nvs_handle_t h;
    esp_err_t err = nvs_open(BOARD_NAME_NVS_NS, NVS_READWRITE, &h);
    if (err != ESP_OK) return err;
    const char *key = (line == 1) ? "dtmf_t1" : "dtmf_t0";
    if (data) {
        err = nvs_set_blob(h, key, data, len);
    } else {
        err = nvs_erase_key(h, key);
        if (err == ESP_ERR_NVS_NOT_FOUND) err = ESP_OK;
    }
    if (err == ESP_OK) err = nvs_commit(h);
    nvs_close(h);
    return err;
}

uint8_t board_ring_hz_get(int line)
{
    nvs_handle_t h;
    if (nvs_open(BOARD_NAME_NVS_NS, NVS_READONLY, &h) != ESP_OK) return BOARD_RING_HZ_DEFAULT;
    uint8_t hz = 0;
    esp_err_t err = nvs_get_u8(h, (line == 1) ? "ring_hz1" : "ring_hz0", &hz);
    nvs_close(h);
    return (err == ESP_OK && hz >= BOARD_RING_HZ_MIN && hz <= BOARD_RING_HZ_MAX) ? hz : BOARD_RING_HZ_DEFAULT;
}

esp_err_t board_ring_hz_set(int line, uint8_t hz)
{
    if (hz < BOARD_RING_HZ_MIN || hz > BOARD_RING_HZ_MAX) return ESP_ERR_INVALID_ARG;
    nvs_handle_t h;
    esp_err_t err = nvs_open(BOARD_NAME_NVS_NS, NVS_READWRITE, &h);
    if (err != ESP_OK) return err;
    err = nvs_set_u8(h, (line == 1) ? "ring_hz1" : "ring_hz0", hz);
    if (err == ESP_OK) err = nvs_commit(h);
    nvs_close(h);
    if (err == ESP_OK) ESP_LOGI(TAG, "line %d: ring frequency %u Hz persisted", line, (unsigned)hz);
    return err;
}

#define SPK_VOL_NVS_KEY0 "spk_vol0"
#define SPK_VOL_NVS_KEY1 "spk_vol1"

static const char *spk_vol_key(int line)
{
    return (line == 1) ? SPK_VOL_NVS_KEY1 : SPK_VOL_NVS_KEY0;
}

uint8_t board_speaker_volume_get(int line, uint8_t fallback)
{
    nvs_handle_t h;
    if (nvs_open(BOARD_NAME_NVS_NS, NVS_READONLY, &h) != ESP_OK) return fallback;
    uint8_t vol;
    esp_err_t err = nvs_get_u8(h, spk_vol_key(line), &vol);
    nvs_close(h);
    return (err == ESP_OK) ? vol : fallback;
}

esp_err_t board_speaker_volume_set(int line, uint8_t vol)
{
    nvs_handle_t h;
    esp_err_t err = nvs_open(BOARD_NAME_NVS_NS, NVS_READWRITE, &h);
    if (err != ESP_OK) return err;
    err = nvs_set_u8(h, spk_vol_key(line), vol);
    if (err == ESP_OK) err = nvs_commit(h);
    nvs_close(h);
    if (err == ESP_OK) {
        ESP_LOGI(TAG, "line %d: speaker volume %u persisted", line, (unsigned)vol);
    }
    return err;
}

/* Highest earpiece level the self-test's audio-level check found still clean
 * on this line (0 = never measured). The web UI's slider marks it. */
uint8_t board_speaker_clean_max_get(int line)
{
    nvs_handle_t h;
    if (nvs_open(BOARD_NAME_NVS_NS, NVS_READONLY, &h) != ESP_OK) return 0;
    uint8_t v;
    esp_err_t err = nvs_get_u8(h, line == 1 ? "spk_clean1" : "spk_clean0", &v);
    nvs_close(h);
    return (err == ESP_OK) ? v : 0;
}

esp_err_t board_speaker_clean_max_set(int line, uint8_t level)
{
    nvs_handle_t h;
    esp_err_t err = nvs_open(BOARD_NAME_NVS_NS, NVS_READWRITE, &h);
    if (err != ESP_OK) return err;
    err = nvs_set_u8(h, line == 1 ? "spk_clean1" : "spk_clean0", level);
    if (err == ESP_OK) err = nvs_commit(h);
    nvs_close(h);
    return err;
}

#define RECORD_MAX_MS_NVS_KEY "rec_max_ms"

uint32_t board_record_max_ms_get(uint32_t fallback_ms)
{
    nvs_handle_t h;
    if (nvs_open(BOARD_NAME_NVS_NS, NVS_READONLY, &h) != ESP_OK) return fallback_ms;
    uint32_t ms;
    esp_err_t err = nvs_get_u32(h, RECORD_MAX_MS_NVS_KEY, &ms);
    nvs_close(h);
    return (err == ESP_OK) ? ms : fallback_ms;
}

esp_err_t board_record_max_ms_set(uint32_t ms)
{
    if (ms < BOARD_RECORD_MAX_MS_MIN || ms > BOARD_RECORD_MAX_MS_MAX) {
        return ESP_ERR_INVALID_ARG;
    }
    nvs_handle_t h;
    esp_err_t err = nvs_open(BOARD_NAME_NVS_NS, NVS_READWRITE, &h);
    if (err != ESP_OK) return err;
    err = nvs_set_u32(h, RECORD_MAX_MS_NVS_KEY, ms);
    if (err == ESP_OK) err = nvs_commit(h);
    nvs_close(h);
    if (err == ESP_OK) {
        ESP_LOGI(TAG, "record max duration %u ms persisted", (unsigned)ms);
    }
    return err;
}

#define HW_CONFIG_NVS_NS       "board"
#define HW_CONFIG_NVS_KEY_LINES "hw_lines"  /* u8: 1 or 2 */
#define HW_CONFIG_NVS_KEY_SD    "hw_sd"     /* u8: 0 or 1 */
#define HW_CONFIG_NVS_KEY_BT    "hw_bt"     /* u8: 0 or 1 -- a module fitted (written by older firmware: BM64) */
#define HW_CONFIG_NVS_KEY_BTMOD "hw_btmod"  /* u8: board_bt_module_t -- which module */
#define HW_CONFIG_NVS_KEY_CONFIRMED "hw_confirmed" /* u8: 1 once a human has actually reviewed this */

board_hw_config_t board_hw_config_get(void)
{
    /* safe fallback if nothing saved yet */
    board_hw_config_t cfg = { .num_lines = 1, .has_microsd = false, .has_bt_module = false,
                              .bt_module = BOARD_BT_NONE };
    nvs_handle_t h;
    if (nvs_open(HW_CONFIG_NVS_NS, NVS_READONLY, &h) == ESP_OK) {
        uint8_t lines = 0, sd = 0, bt = 0, btmod = 0;
        if (nvs_get_u8(h, HW_CONFIG_NVS_KEY_LINES, &lines) == ESP_OK && (lines == 1 || lines == 2)) {
            cfg.num_lines = lines;
        }
        if (nvs_get_u8(h, HW_CONFIG_NVS_KEY_SD, &sd) == ESP_OK) {
            cfg.has_microsd = (sd != 0);
        }
        if (nvs_get_u8(h, HW_CONFIG_NVS_KEY_BT, &bt) == ESP_OK) {
            cfg.has_bt_module = (bt != 0);
            /* Saved before module types existed: fitted meant BM64. */
            cfg.bt_module = cfg.has_bt_module ? BOARD_BT_BM64 : BOARD_BT_NONE;
        }
        if (nvs_get_u8(h, HW_CONFIG_NVS_KEY_BTMOD, &btmod) == ESP_OK &&
            btmod <= BOARD_BT_BT401) {
            cfg.bt_module = (board_bt_module_t)btmod;
            cfg.has_bt_module = (cfg.bt_module != BOARD_BT_NONE);
        }
        nvs_close(h);
    }
    return cfg;
}

/* Internal: has *any* value ever been written (by a human OR
 * board_hw_config_autodetect()), regardless of whether it's been reviewed?
 * This is the real "has something already claimed GPIO18-21 based on a
 * written config" signal -- board_hw_detect_evidence()'s safety guard needs
 * this, not board_hw_config_is_set() (which now means "human-confirmed" and
 * can be false for a while after autodetect() has already written and
 * applied a guess -- see that function's doc comment). */
static bool hw_config_value_written(void)
{
    nvs_handle_t h;
    if (nvs_open(HW_CONFIG_NVS_NS, NVS_READONLY, &h) != ESP_OK) return false;
    uint8_t lines = 0;
    esp_err_t err = nvs_get_u8(h, HW_CONFIG_NVS_KEY_LINES, &lines);
    nvs_close(h);
    return err == ESP_OK;
}

bool board_hw_config_is_set(void)
{
    nvs_handle_t h;
    if (nvs_open(HW_CONFIG_NVS_NS, NVS_READONLY, &h) != ESP_OK) return false;
    uint8_t confirmed = 0;
    esp_err_t err = nvs_get_u8(h, HW_CONFIG_NVS_KEY_CONFIRMED, &confirmed);
    nvs_close(h);
    return err == ESP_OK && confirmed != 0;
}

esp_err_t board_hw_config_set(board_hw_config_t cfg)
{
    if (cfg.num_lines < 1 || cfg.num_lines > 2) return ESP_ERR_INVALID_ARG;
#if !BOARD_LINE1_ON_EXPANDER
    if (cfg.num_lines == 2 && cfg.has_microsd) return ESP_ERR_INVALID_ARG; /* GPIO18-21 conflict */
#endif
    if (cfg.bt_module > BOARD_BT_BT401) return ESP_ERR_INVALID_ARG;
    /* The two fields describe one fact; callers may fill in either. */
    if (cfg.bt_module == BOARD_BT_NONE && cfg.has_bt_module) cfg.bt_module = BOARD_BT_BM64;
    cfg.has_bt_module = (cfg.bt_module != BOARD_BT_NONE);

    nvs_handle_t h;
    esp_err_t err = nvs_open(HW_CONFIG_NVS_NS, NVS_READWRITE, &h);
    if (err != ESP_OK) return err;
    err = nvs_set_u8(h, HW_CONFIG_NVS_KEY_LINES, (uint8_t)cfg.num_lines);
    if (err == ESP_OK) err = nvs_set_u8(h, HW_CONFIG_NVS_KEY_SD, cfg.has_microsd ? 1 : 0);
    if (err == ESP_OK) err = nvs_set_u8(h, HW_CONFIG_NVS_KEY_BT, cfg.has_bt_module ? 1 : 0);
    if (err == ESP_OK) err = nvs_set_u8(h, HW_CONFIG_NVS_KEY_BTMOD, (uint8_t)cfg.bt_module);
    /* A human went through the Settings/first-boot form and hit Save --
     * that's what makes this "confirmed", not just a value existing (see
     * board_hw_config_autodetect(), which writes lines/sd but deliberately
     * never this flag). */
    if (err == ESP_OK) err = nvs_set_u8(h, HW_CONFIG_NVS_KEY_CONFIRMED, 1);
    if (err == ESP_OK) err = nvs_commit(h);
    nvs_close(h);
    if (err == ESP_OK) {
        ESP_LOGI(TAG, "hardware config set: %d line%s, microSD %s, Bluetooth module: %s",
                 cfg.num_lines, cfg.num_lines == 1 ? "" : "s",
                 cfg.has_microsd ? "yes" : "no",
                 cfg.bt_module == BOARD_BT_BM64 ? "BM64"
                 : cfg.bt_module == BOARD_BT_BT401 ? "BT401" : "none");
    }
    return err;
}

/* Reads BOARD_SD_CD (a dedicated, always-safe-to-read mechanical
 * card-detect switch, SMD4 only) -- separate from the cached-once GPIO18-21
 * read below since this pin has no "might glitch a live peripheral" risk
 * and is worth reflecting live on every call. */
static bool read_card_present(void)
{
#ifdef BOARD_SD_CD
    /* Configure once, not per call. sd_line1_conflict_task() polls this every
     * 2 seconds forever, and ESP-IDF's gpio_config() logs the resulting pin
     * configuration at INFO level -- so re-configuring here buried the console
     * in a "gpio: GPIO[3]| InputEn: 1|..." line every 2 seconds. The level
     * itself is still read live on every call, which is the part that
     * actually needs to be fresh. */
    static bool configured;
    if (!configured) {
        gpio_config_t cd_cfg = {
            .pin_bit_mask = 1ULL << BOARD_SD_CD,
            .mode = GPIO_MODE_INPUT,
            .pull_up_en = GPIO_PULLUP_ENABLE,
        };
        gpio_config(&cd_cfg);
        configured = true;
    }
    return gpio_get_level(BOARD_SD_CD) == 0;
#else
    return false;
#endif
}

static board_hw_evidence_t s_cached_gpio_evidence;
static bool                s_have_cached_gpio_evidence;

board_hw_evidence_t board_hw_detect_evidence(void)
{
    board_hw_evidence_t ev = { .valid = false };

    /* GPIO18-21 are only safe to read as plain inputs if NO driver has
     * claimed them yet -- once a config value has been written
     * (hw_config_value_written() -- by a human OR by
     * board_hw_config_autodetect()'s guess), ag1170_init() may already own
     * them as a SLIC (line 2) or sdcard_init() may own them as SPI
     * (microSD), and re-reading would glitch a live peripheral (e.g. an
     * in-flight SD SPI transaction). Once a real read has happened, though,
     * it's cached and replayed here on every later call in the same boot --
     * autodetect() runs before anything claims these pins, but callers
     * after that (e.g. the Settings -> Hardware page, possibly loaded many
     * times) still need something to show a human sanity-checking the
     * guess against, not just "no evidence available" forever. */
#if BOARD_LINE1_ON_EXPANDER
    /* GPIO18-21 are the microSD socket's alone, so they say nothing about line 1. */
    const bool can_read_pads = false;
#else
    const bool can_read_pads = !hw_config_value_written();
#endif
    if (s_have_cached_gpio_evidence) {
        ev = s_cached_gpio_evidence;
    } else if (can_read_pads) {
        const gpio_num_t pins[4] = {
            BOARD_LINE2_PIN_PD_CS, BOARD_LINE2_PIN_SHK_SCLK,
            BOARD_LINE2_PIN_RM_MOSI, BOARD_LINE2_PIN_FR_MISO,
        };
        for (int i = 0; i < 4; i++) {
            gpio_config_t c = {
                .pin_bit_mask = 1ULL << pins[i],
                .mode = GPIO_MODE_INPUT,
                .pull_up_en = GPIO_PULLUP_DISABLE,
                .pull_down_en = GPIO_PULLDOWN_DISABLE,
            };
            gpio_config(&c);
            ev.raw_levels[i] = gpio_get_level(pins[i]);
        }
        /* An idle/on-hook AG1171 SHK divider (see docs/signal-levels.md)
         * pulls this low at rest; an unpopulated/floating microSD CLK pin
         * has no such reason to read consistently low. Weak evidence, not
         * proof -- purely advisory, see board.h. */
        ev.looks_like_line2 = (ev.raw_levels[1] == 0);
        ev.valid = true;
        s_cached_gpio_evidence = ev;
        s_have_cached_gpio_evidence = true;
    }

    ev.card_present = read_card_present();
    return ev;
}

bool board_sd_line1_conflict(void)
{
#if BOARD_LINE1_ON_EXPANDER
    return false;
#else
    return board_hw_config_get().num_lines == 2 && board_hw_detect_evidence().card_present;
#endif
}

bool board_shared_pads_free(void)
{
#if BOARD_LINE1_ON_EXPANDER
    return false;
#else
    board_hw_config_t cfg = board_hw_config_get();
    return cfg.num_lines == 1 && !cfg.has_microsd;
#endif
}

void board_hw_config_autodetect(void)
{
    if (hw_config_value_written()) return; /* already guessed once, or human-confirmed */

    board_hw_config_t cfg = { .num_lines = 1, .has_microsd = false }; /* fallback if evidence is ambiguous */

#if BOARD_LINE1_ON_EXPANDER
    /* The socket is always wired. The expander answering is the best sign of a
     * second line: with no SLIC fitted, R12 still holds SHK low, so a wrong guess
     * is an idle line nobody can use, and the first-boot banner asks about it. */
    cfg.has_microsd = true;
    if (s_bus && i2c_master_probe(s_bus, BOARD_EXP_I2C_ADDR, 50) == ESP_OK) cfg.num_lines = 2;
#else
    /* card_present first, and decisive if it fires: a card can only be
     * physically seated on a board actually wired for microSD, never a
     * line-2 SLIC -- this is a real mechanical switch reading, not a
     * heuristic. Only SMD4 has this pin (see read_card_present()'s own
     * #ifdef); SMD2 falls through to the SHK-divider evidence below. */
    board_hw_evidence_t ev = board_hw_detect_evidence();
    if (ev.card_present) {
        cfg.has_microsd = true;
    } else if (ev.valid && ev.looks_like_line2) {
        cfg.num_lines = 2;
        cfg.has_microsd = false;
    }
#endif

    nvs_handle_t h;
    if (nvs_open(HW_CONFIG_NVS_NS, NVS_READWRITE, &h) != ESP_OK) return;
    nvs_set_u8(h, HW_CONFIG_NVS_KEY_LINES, (uint8_t)cfg.num_lines);
    nvs_set_u8(h, HW_CONFIG_NVS_KEY_SD, cfg.has_microsd ? 1 : 0);
    /* Deliberately not HW_CONFIG_NVS_KEY_CONFIRMED -- this is a guess, not a
     * human's word; board_hw_config_is_set() must stay false so the
     * first-boot banner still asks for a one-time confirm-or-correct. */
    nvs_commit(h);
    nvs_close(h);

    ESP_LOGI(TAG, "hardware auto-detected: %d line%s, microSD %s (unconfirmed -- "
                  "check Settings -> Hardware when convenient)",
             cfg.num_lines, cfg.num_lines == 1 ? "" : "s", cfg.has_microsd ? "yes" : "no");
}

void board_hostname(char *out, size_t len)
{
    char name[BOARD_NAME_MAX];
    board_name_get(name, sizeof(name));

    /* RFC-1123-ish single label: [a-z0-9-], no leading/trailing '-', never
     * empty (mDNS would reject that). Collapses runs of separators. */
    size_t o = 0;
    bool prev_dash = false;
    for (size_t i = 0; name[i] && o < len - 1; i++) {
        char c = (char)tolower((unsigned char)name[i]);
        if (c == '\'') continue; /* drop apostrophes: "Scott's" -> "scotts" */
        if ((c >= 'a' && c <= 'z') || (c >= '0' && c <= '9')) {
            out[o++] = c;
            prev_dash = false;
        } else if (o > 0 && !prev_dash) {
            out[o++] = '-';
            prev_dash = true;
        }
    }
    while (o > 0 && out[o - 1] == '-') o--; /* trim trailing '-' */
    out[o] = '\0';
    if (out[0] == '\0') {
        strncpy(out, CONFIG_MDNS_HOSTNAME, len - 1);
        out[len - 1] = '\0';
    }
}


#if CONFIG_BOARD_TYPE_SMD2
#define LED_TICK_MS   100  /* fastest blink rate (BOOTING); ERROR blinks
                             * slower by only toggling every few ticks */
#define LED_DUTY_MAX  1023 /* 10-bit LEDC resolution */
#define LED_TIMER     LEDC_TIMER_0
#define LED_CHANNEL   LEDC_CHANNEL_0
#define LED_SPEED     LEDC_LOW_SPEED_MODE /* C6 has no high-speed LEDC mode */

static esp_timer_handle_t   s_led_timer;
static board_led_state_t    s_led_state = BOARD_LED_BOOTING;

static void led_set_duty(uint32_t duty)
{
    ledc_set_duty(LED_SPEED, LED_CHANNEL, duty);
    ledc_update_duty(LED_SPEED, LED_CHANNEL);
}

static void led_timer_cb(void *arg)
{
    static unsigned tick;
    tick++;
    switch (s_led_state) {
    case BOARD_LED_OK:
        led_set_duty(0);
        break;
    case BOARD_LED_ERROR:
        led_set_duty(((tick / 5) % 2) ? LED_DUTY_MAX : 0); /* ~500ms half-period */
        break;
    case BOARD_LED_WIFI_CONNECTING: {
        /* Slow linear ramp up/down (a triangle wave, not a true sine, but
         * reads as "breathing" at this rate and needs no lookup table) --
         * full cycle every 3s (30 ticks at 100ms/tick). */
        const unsigned period = 30, half = period / 2;
        unsigned phase = tick % period;
        uint32_t duty = (phase < half) ? (phase * LED_DUTY_MAX) / half
                                        : LED_DUTY_MAX - ((phase - half) * LED_DUTY_MAX) / half;
        led_set_duty(duty);
        break;
    }
    case BOARD_LED_BOOTING:
    default:
        led_set_duty((tick % 2) ? LED_DUTY_MAX : 0); /* ~100ms half-period */
        break;
    }
}

void board_led_init(void)
{
    ledc_timer_config_t tcfg = {
        .speed_mode = LED_SPEED,
        .duty_resolution = LEDC_TIMER_10_BIT,
        .timer_num = LED_TIMER,
        .freq_hz = 2000,
        .clk_cfg = LEDC_AUTO_CLK,
    };
    ESP_ERROR_CHECK(ledc_timer_config(&tcfg));

    ledc_channel_config_t ccfg = {
        .gpio_num = BOARD_STATUS_LED,
        .speed_mode = LED_SPEED,
        .channel = LED_CHANNEL,
        .intr_type = LEDC_INTR_DISABLE,
        .timer_sel = LED_TIMER,
        .duty = 0,
        .hpoint = 0,
    };
    ESP_ERROR_CHECK(ledc_channel_config(&ccfg));

    const esp_timer_create_args_t targs = {
        .callback = &led_timer_cb,
        .name = "status_led",
    };
    ESP_ERROR_CHECK(esp_timer_create(&targs, &s_led_timer));
    ESP_ERROR_CHECK(esp_timer_start_periodic(s_led_timer, LED_TICK_MS * 1000));
}

void board_led_set_state(board_led_state_t state)
{
    s_led_state = state;
}
#elif CONFIG_BOARD_TYPE_SMD4 || CONFIG_BOARD_TYPE_SMD5 || CONFIG_BOARD_TYPE_SMD5_CHEAP || \
      CONFIG_BOARD_TYPE_SMD6
/* No discrete status LED on this carrier (BOARD_STATUS_LED intentionally
 * not defined -- GPIO11, SMD2's LED pin, is I2S BCLK here instead). This
 * drives the ESP32-C6-DevKitC-1 MODULE's own onboard addressable RGB LED
 * instead, which the carrier leaves completely free (docs/hardware.md's
 * pin table: "GPIO8 (BOOT, strap) -- unconnected, free") -- a WS2812 on
 * GPIO8 is Espressif's standard DevKitC-1 layout, not something specific
 * to this project, so it needs no carrier PCB change. Unverified against
 * the DevKit's own schematic as of writing -- if GPIO8 turns out wrong for
 * a given DevKit revision, only ONBOARD_LED_GPIO below needs to change. */
#define LED_TICK_MS      100
#define ONBOARD_LED_GPIO GPIO_NUM_8
#define LED_OK_HOLD_MS   30000 /* solid green this long after WiFi connects, then off */
#define LED_DIM          2     /* out of 255 -- WS2812 is startlingly bright even at low values;
                                 * confirmed 2026-09-17 that 40 (~16%) was "SUPER BRIGHT" on real
                                 * hardware; 4 (2026-10) was still "pretty bright" on real
                                 * hardware -- halved again, aiming for barely-visible rather than
                                 * a straight 10%-of-255 read of the original complaint. Tune
                                 * further here if still too much (or not enough in bright light) */

static esp_timer_handle_t s_led_timer;
static board_led_state_t  s_led_state = BOARD_LED_BOOTING;
static led_strip_handle_t s_led_strip;
static unsigned           s_ok_ticks;  /* ticks spent in BOARD_LED_OK so far */
static unsigned           s_bt_ticks;  /* ticks spent in BOARD_LED_BT_CONNECTED */
#define LED_BT_HOLD_MS   5000  /* solid blue this long after BT connects, then revert */

static void led_set_rgb(uint8_t r, uint8_t g, uint8_t b)
{
    if (!s_led_strip) return;
    led_strip_set_pixel(s_led_strip, 0, r, g, b);
    led_strip_refresh(s_led_strip);
}

static void led_timer_cb(void *arg)
{
    static unsigned tick;
    tick++;
    switch (s_led_state) {
    case BOARD_LED_OK:
        /* Solid green for LED_OK_HOLD_MS (long enough to glance over and
         * confirm "WiFi's up"), then off -- an indicator that never turns
         * off is easy to stop noticing is even there, and by this point
         * the web UI/console are the real source of truth anyway. */
        s_ok_ticks++;
        if (s_ok_ticks * LED_TICK_MS < LED_OK_HOLD_MS) {
            led_set_rgb(0, LED_DIM, 0);
        } else if (s_power_warn) {
            /* Unacknowledged brownout: amber double blink every 2 s. */
            unsigned t = tick % 20;
            bool on = t == 0 || t == 3;
            led_set_rgb(on ? LED_DIM : 0, on ? 1 : 0, 0);
        } else {
            led_set_rgb(0, 0, 0);
        }
        break;
    case BOARD_LED_ERROR:
        led_set_rgb(((tick / 5) % 2) ? LED_DIM : 0, 0, 0); /* red, ~500ms half-period */
        break;
    case BOARD_LED_WIFI_CONNECTING:
        led_set_rgb(0, ((tick / 5) % 2) ? LED_DIM : 0, 0); /* green, ~500ms half-period */
        break;
    case BOARD_LED_OTA_UPDATING:
        led_set_rgb(((tick / 3) % 2) ? LED_DIM : 0, ((tick / 3) % 2) ? LED_DIM : 0, 0); /* yellow (r+g), ~300ms half-period */
        break;
    case BOARD_LED_BT_PAIRING:
        led_set_rgb(0, 0, ((tick / 5) % 2) ? LED_DIM : 0); /* blue, ~500ms half-period */
        break;
    case BOARD_LED_BT_CONNECTED:
        s_bt_ticks++;
        if (s_bt_ticks * LED_TICK_MS < LED_BT_HOLD_MS) {
            led_set_rgb(0, 0, LED_DIM); /* solid blue */
        } else {
            s_led_state = BOARD_LED_OK; /* revert automatically */
            led_set_rgb(0, 0, 0);
        }
        break;
    case BOARD_LED_BOOTING:
    default:
        led_set_rgb((tick % 2) ? LED_DIM : 0, 0, 0); /* red, ~100ms half-period */
        break;
    }
}

void board_led_init(void)
{
    led_strip_config_t strip_cfg = {
        .strip_gpio_num = ONBOARD_LED_GPIO,
        .max_leds = 1,
        .led_model = LED_MODEL_WS2812,
        .color_component_format = LED_STRIP_COLOR_COMPONENT_FMT_GRB,
    };
    led_strip_rmt_config_t rmt_cfg = {
        .clk_src = RMT_CLK_SRC_DEFAULT,
        .resolution_hz = 10 * 1000 * 1000,
    };
    esp_err_t err = led_strip_new_rmt_device(&strip_cfg, &rmt_cfg, &s_led_strip);
    if (err != ESP_OK) {
        ESP_LOGW(TAG, "onboard RGB LED init failed: %s -- no visible boot/WiFi status "
                      "(wrong GPIO for this DevKit revision? see board.c's board_led_init())",
                 esp_err_to_name(err));
        s_led_strip = NULL;
    }

    const esp_timer_create_args_t targs = {
        .callback = &led_timer_cb,
        .name = "status_led",
    };
    ESP_ERROR_CHECK(esp_timer_create(&targs, &s_led_timer));
    ESP_ERROR_CHECK(esp_timer_start_periodic(s_led_timer, LED_TICK_MS * 1000));
}

void board_led_set_state(board_led_state_t state)
{
    if (state == BOARD_LED_OK && s_led_state != BOARD_LED_OK) s_ok_ticks = 0;
    if (state == BOARD_LED_BT_CONNECTED && s_led_state != BOARD_LED_BT_CONNECTED) s_bt_ticks = 0;
    s_led_state = state;
}
#else
void board_led_init(void) { }
void board_led_set_state(board_led_state_t state) { (void)state; }
#endif

/* ---- BOOT button (GPIO9) watcher ----
 * GPIO9 is a boot strap: held low AT reset the ROM enters serial-download
 * mode and our app never runs. So this only ever reads it *after* boot -- a
 * runtime hold, not a power-on gesture. Free on both PCBs (not in either pin
 * map); the button itself lives on the DevKit module.
 *
 * Two gestures, so the useful one isn't destructive:
 *   ~3 s  -> rescue: bring up the setup SoftAP without touching credentials,
 *            so the web UI is reachable from a phone when the board's normal
 *            network isn't (a demo on someone else's site, a wrong password,
 *            a router that's moved on).
 *   ~10 s -> factory reset: erase WiFi credentials.
 * Holding through the first threshold fires it once, then keeps counting;
 * release before 10 s and only the rescue AP happens. */
#define BOOT_BTN_GPIO        GPIO_NUM_9
#define BOOT_BTN_RESCUE_MS   3000
#define BOOT_BTN_RESET_MS    10000
#define BOOT_BTN_POLL_MS     100

static void (*s_boot_rescue_cb)(void);
static void (*s_boot_reset_cb)(void);

static void boot_button_task(void *arg)
{
    gpio_config_t io = {
        .pin_bit_mask = 1ULL << BOOT_BTN_GPIO,
        .mode = GPIO_MODE_INPUT,
        .pull_up_en = GPIO_PULLUP_ENABLE,   /* idle high; the button shorts to GND */
        .pull_down_en = GPIO_PULLDOWN_DISABLE,
        .intr_type = GPIO_INTR_DISABLE,
    };
    gpio_config(&io);

    int held_ms = 0;
    bool rescue_fired = false;
    while (1) {
        if (gpio_get_level(BOOT_BTN_GPIO) == 0) {
            held_ms += BOOT_BTN_POLL_MS;
            if (!rescue_fired && held_ms >= BOOT_BTN_RESCUE_MS) {
                rescue_fired = true;
                ESP_LOGW(TAG, "BOOT held %d ms -- keep holding to %d ms for a factory reset, "
                              "or release now for the setup AP", held_ms, BOOT_BTN_RESET_MS);
                board_led_set_state(BOARD_LED_WIFI_CONNECTING); /* "let go now" */
            }
            if (held_ms >= BOOT_BTN_RESET_MS) {
                ESP_LOGW(TAG, "BOOT held %d ms -- factory reset", held_ms);
                if (s_boot_reset_cb) s_boot_reset_cb();
                held_ms = 0; rescue_fired = false; /* if the cb didn't reboot, don't re-fire */
            }
        } else {
            if (rescue_fired) {
                /* Released between the two thresholds: the rescue gesture. */
                ESP_LOGW(TAG, "BOOT released after %d ms -- starting the setup AP", held_ms);
                if (s_boot_rescue_cb) s_boot_rescue_cb();
            }
            held_ms = 0;
            rescue_fired = false;
        }
        vTaskDelay(pdMS_TO_TICKS(BOOT_BTN_POLL_MS));
    }
}

void board_boot_button_start(void (*on_rescue)(void), void (*on_factory_reset)(void))
{
    if (!on_rescue && !on_factory_reset) return;
    s_boot_rescue_cb = on_rescue;
    s_boot_reset_cb  = on_factory_reset;
    xTaskCreate(boot_button_task, "boot_btn", 3072, NULL, tskIDLE_PRIORITY + 1, NULL);
}
