sdylewski/Analog-Redial/firmware/bringup/gen_prompt.py

#!/usr/bin/env python3
"""Generate a prompt/clip WAV (text-to-speech or an existing audio file,
converted to the format the device's `player` component expects) and
optionally upload it straight to the phone over HTTP.

The ESP32 has no TTS of its own -- this is the host-side half of milestone 3
(docs/features.md): produce mono 16-bit PCM WAV. Defaults to 8000 Hz -- real
telephone bandwidth is ~300-3400Hz, so 8kHz (Nyquist to 4kHz) is genuine
phone-quality audio, not a compromise -- it's also what G.711 (the VoIP
milestone's eventual codec) uses. 8kHz vs. this device's native 48kHz I2S
rate is a 6x size win (storage is capped at 4MB total on the device) with no
decoder needed: player.c resamples on playback, so the device's live
telephony audio (still 48kHz) is untouched. Pass --rate 48000 if you'd
rather skip resampling for some reason.

Text-to-speech uses Kokoro (preferred: a small open neural model, Apache-2.0, runs
offline on a laptop; default voice af_sarah) when it can be set up, then Piper (also
neural; en_GB-jenny_dioco-medium), then espeak-ng, then macOS `say`. Kokoro needs
`pip install kokoro-onnx soundfile` and about 350 MB of model files. If the Python
running this script doesn't have Kokoro, the script makes its own virtual environment,
firmware/bringup/tts_venv/, installs Kokoro and Piper into it and re-runs itself there
(so a Homebrew or distribution Python that refuses `pip install` is fine), and
downloads the model into firmware/bringup/kokoro_models/, all the first time only
(skipped with --no-auto-install). Pass --kokoro-voice to pick another voice (af_*, am_*, bf_*, bm_*).

The paragraphs below describe the Piper path (the fallback). Piper (neural, cross-platform -- the same
engine pi_rotary_phone's install-piper.sh sets up there, since that's been
the better-sounding option). --engine auto (the default) sets Piper up for
you the first time it's needed: `pip install piper-tts` if the `piper`
command isn't on PATH, then downloads the default voice
(en_GB-jenny_dioco-medium -- picked for sounding more natural than
lessac, tried side-by-side; the Pi's install script still defaults to
en_US-lessac-medium, the two aren't kept in sync) into
firmware/bringup/piper_voices/ if no .onnx is there yet. Both steps are
skipped once already present, so this is a one-time cost. Pass
--piper-model to use a different voice, or grab one yourself from
https://huggingface.co/rhasspy/piper-voices.

If Piper can't be set up (offline, no pip, etc.) --engine auto falls back
to espeak-ng (`apt install espeak-ng` / `brew install espeak-ng`), then
macOS's `say` -- both noticeably more robotic than Piper, and auto prints
a warning when it lands on either so the drop in quality isn't silent.
--no-auto-install skips the automatic pip install/download and just fails
over to the next engine immediately, if you'd rather not have this script
touch your Python environment or make network calls on its own.

Two ways to use this:

  1. One-shot, same as before: pass text (or --from an existing audio file)
     and --name, optionally --upload HOST to push it straight to a board.

  2. --sync HOST [--secret ...]: ask the board itself what it wants
     generated (Settings -> Operator/Record/Dial Codes -> "Spoken prompt
     text" on each page, POST /prompt_text_set) via GET /api/prompt_requests,
     synthesize everything that's pending, and upload each result back.
     --secret is the board's setup password (Settings -> General; each
     board generates its own random one on first boot). The board skips checking it entirely for callers on the same
     LAN subnet it's on (its own security model, not something this script
     enforces) -- so --secret is only actually required when this runs
     somewhere else on the network than the board, e.g. over a VPN into a
     remotely-hosted phone. This is otherwise the no-server-dependency path:
     nothing but this script and a local TTS engine, so a board running on
     someone else's Asterisk server doesn't need access to *your*
     infrastructure to generate its own prompts.

Examples:
    # Text-to-speech (Piper/espeak-ng, auto-picked), saved locally only:
    ./gen_prompt.py "For assistance, please hang up and try again." --name operator.wav

    # Same, uploaded straight to the phone:
    ./gen_prompt.py "For assistance, please hang up and try again." \\
        --name operator.wav --upload phone.local

    # Generate + upload everything the board has pending text for, run from
    # the same LAN the board's on (no --secret needed):
    ./gen_prompt.py --sync phone.local

    # Same, but the board's on a different network (VPN, remote setup):
    ./gen_prompt.py --sync phone.local --secret "$(cat setup_password.txt)"

    # Convert an existing recording instead of synthesizing speech:
    ./gen_prompt.py --from banana_song.mp3 --name banana_phone.wav --upload phone.local

Well-known names the firmware looks for: operator.wav (dial 0, fixed),
record_prompt.wav (played before the beep on 211, dial 211). The
401/402/403/404/411/412/413/414 "silly clip" codes are NOT fixed filenames
any more -- they're a mutable code<->filename table seeded from
dialplan/dialplan_defaults.h (see CLIP_DEFAULTS there, and CLIP_MAP in
sync_pi_audio.py) and editable at runtime from Settings -> Dial Codes.
Match whatever filename that table currently points a code at, or add a new
code/filename pair from the web UI after uploading -- no firmware rebuild
needed for that part.
"""

from __future__ import annotations

import argparse
import base64
import json
import os
import shutil
import subprocess
import sys
import tempfile
import urllib.parse
import urllib.request
from pathlib import Path

DEFAULT_RATE = 8000
DEFAULT_SAY_VOICE = "Samantha"       # --engine say (macOS only)
DEFAULT_ESPEAK_VOICE = "en-us"       # --engine espeak
PIPER_VOICES_DIR = Path(__file__).resolve().parent / "piper_voices"

# Kokoro-82M through kokoro-onnx (Apache-2.0). af_sarah: picked by ear against the Piper voices.
DEFAULT_KOKORO_VOICE = "af_sarah"
KOKORO_DIR = Path(__file__).resolve().parent / "kokoro_models"
KOKORO_FILES = ("kokoro-v1.0.onnx", "voices-v1.0.bin")
# Kokoro and Piper are installed here rather than into the Python running the
# script: Homebrew's and most Linux distributions' Pythons refuse a plain
# `pip install` (PEP 668, "externally-managed-environment").
TTS_VENV_DIR = Path(__file__).resolve().parent / "tts_venv"
KOKORO_BASE_URL = "https://github.com/thewh1teagle/kokoro-onnx/releases/download/model-files-v1.0"

# en_GB-jenny_dioco-medium -- one of Piper's more natural-sounding voices
# (compared side-by-side against en_US-lessac-medium, which
# pi_rotary_phone's scripts/install-piper.sh still uses on the Pi; the two
# projects' defaults intentionally diverge here rather than picking one to
# keep them in sync). Still "medium" quality/size, same tradeoff reasoning
# as before. Only used when nothing else is dropped under PIPER_VOICES_DIR/.
DEFAULT_PIPER_VOICE_REL = "en/en_GB/jenny_dioco/medium/en_GB-jenny_dioco-medium.onnx"
PIPER_VOICES_BASE_URL = "https://huggingface.co/rhasspy/piper-voices/resolve/main"


def _which(cmd: str) -> str | None:
    return shutil.which(cmd)


def _download_default_piper_voice() -> Path | None:
    """Fetches the default voice (DEFAULT_PIPER_VOICE_REL) into
    PIPER_VOICES_DIR. Returns the .onnx path on success, None on any
    failure (offline, HF unreachable, ...) -- callers treat that the same as
    "no model available" and fall back a tier, they don't need to know why."""
    onnx_path = PIPER_VOICES_DIR / Path(DEFAULT_PIPER_VOICE_REL).name
    json_path = onnx_path.with_name(onnx_path.name + ".json")
    try:
        PIPER_VOICES_DIR.mkdir(parents=True, exist_ok=True)
        print(f"no Piper voice found -- downloading the default ({onnx_path.name}, ~60MB)...")
        urllib.request.urlretrieve(f"{PIPER_VOICES_BASE_URL}/{DEFAULT_PIPER_VOICE_REL}", onnx_path)
        urllib.request.urlretrieve(f"{PIPER_VOICES_BASE_URL}/{DEFAULT_PIPER_VOICE_REL}.json", json_path)
    except OSError as e:
        print(f"warning: couldn't download the default Piper voice ({e})", file=sys.stderr)
        onnx_path.unlink(missing_ok=True)
        json_path.unlink(missing_ok=True)
        return None
    print(f"downloaded {onnx_path}")
    return onnx_path


def _resolve_piper_model(explicit: str | None, auto_install: bool) -> Path | None:
    """Explicit --piper-model wins. Otherwise, exactly one *.onnx dropped
    under piper_voices/ next to this script is picked automatically -- more
    than one is ambiguous (which voice?), so that's an error, not a guess.
    With none present, auto_install (default) fetches DEFAULT_PIPER_VOICE_REL
    so a first run works with zero manual setup."""
    if explicit:
        p = Path(explicit)
        if not p.is_file():
            raise SystemExit(f"--piper-model {p} not found")
        return p
    if PIPER_VOICES_DIR.is_dir():
        found = sorted(PIPER_VOICES_DIR.glob("*.onnx"))
        if len(found) == 1:
            return found[0]
        if len(found) > 1:
            names = "\n".join(f"  {f}" for f in found)
            raise SystemExit(
                f"multiple Piper voices in {PIPER_VOICES_DIR}, pass --piper-model to pick one:\n{names}"
            )
    return _download_default_piper_voice() if auto_install else None


def _ensure_piper_cli(auto_install: bool) -> str | None:
    """Returns the `piper` binary's path, installing piper-tts via pip first
    if it's missing and auto_install is set. Returns None (never raises) if
    it's still not available after that -- callers decide what that means
    (hard error for --engine piper, a fallback tier for auto)."""
    found = _which("piper")
    if found or not auto_install:
        return found
    print("Piper not found -- installing via 'pip install piper-tts'...")
    try:
        subprocess.run([sys.executable, "-m", "pip", "install", "piper-tts"], check=True)
    except (OSError, subprocess.CalledProcessError) as e:
        print(f"warning: 'pip install piper-tts' failed ({e})", file=sys.stderr)
        return None
    return _which("piper")



def _use_tts_venv(engine: str, auto_install: bool) -> None:
    """If Kokoro isn't importable here, re-run this script with the Python in
    tts_venv/, creating it (and installing Kokoro and Piper into it) the first
    time. Returns only when that isn't needed or can't be done; the engines
    then fall back as before."""
    if engine not in ("auto", "kokoro", "piper") or os.environ.get("REDIAL_TTS_VENV"):
        return
    try:
        import kokoro_onnx  # noqa: F401
        import soundfile  # noqa: F401
        return
    except ImportError:
        pass
    if engine == "piper" and _which("piper"):
        return
    bin_dir = TTS_VENV_DIR / ("Scripts" if os.name == "nt" else "bin")
    py = bin_dir / ("python.exe" if os.name == "nt" else "python")
    if not py.exists():
        if not auto_install:
            return
        print(f"setting up Kokoro and Piper in {TTS_VENV_DIR} (one time, a few minutes)...")
        try:
            subprocess.run([sys.executable, "-m", "venv", str(TTS_VENV_DIR)], check=True)
            subprocess.run([str(py), "-m", "pip", "install", "-q", "kokoro-onnx", "soundfile", "piper-tts"],
                           check=True)
        except (subprocess.CalledProcessError, OSError) as e:
            print(f"warning: couldn't set up {TTS_VENV_DIR} ({e})", file=sys.stderr)
            shutil.rmtree(TTS_VENV_DIR, ignore_errors=True)
            return
    os.environ["REDIAL_TTS_VENV"] = "1"
    os.environ["PATH"] = str(bin_dir) + os.pathsep + os.environ.get("PATH", "")   # so `piper` is found
    script = str(Path(__file__).resolve())
    if os.name == "nt":   # execv on Windows doesn't keep the console attached cleanly
        raise SystemExit(subprocess.call([str(py), script, *sys.argv[1:]]))
    os.execv(str(py), [str(py), script, *sys.argv[1:]])


_KOKORO = None


def _ensure_kokoro(auto_install: bool):
    """Returns a kokoro_onnx.Kokoro (loaded once per run), installing the package and downloading the model files
    first when auto_install allows it; None if it can't be set up (callers fall back a tier)."""
    global _KOKORO
    if _KOKORO:
        return _KOKORO
    try:
        import kokoro_onnx  # noqa: F401
        import soundfile  # noqa: F401
    except ImportError:
        if not auto_install:
            return None
        print("Kokoro not found -- installing via 'pip install kokoro-onnx soundfile'...")
        try:
            subprocess.run([sys.executable, "-m", "pip", "install", "-q", "kokoro-onnx", "soundfile"], check=True)
            import kokoro_onnx  # noqa: F401
            import soundfile  # noqa: F401
        except (subprocess.CalledProcessError, ImportError, OSError) as e:
            print(f"warning: couldn't set up Kokoro ({e})", file=sys.stderr)
            return None
    missing = [f for f in KOKORO_FILES if not (KOKORO_DIR / f).exists()]
    if missing:
        if not auto_install:
            return None
        try:
            KOKORO_DIR.mkdir(parents=True, exist_ok=True)
            for f in missing:
                print(f"downloading Kokoro model file {f}...")
                urllib.request.urlretrieve(f"{KOKORO_BASE_URL}/{f}", KOKORO_DIR / f)
        except OSError as e:
            print(f"warning: couldn't download the Kokoro model ({e})", file=sys.stderr)
            for f in missing:
                (KOKORO_DIR / f).unlink(missing_ok=True)
            return None
    from kokoro_onnx import Kokoro
    _KOKORO = Kokoro(str(KOKORO_DIR / KOKORO_FILES[0]), str(KOKORO_DIR / KOKORO_FILES[1]))
    return _KOKORO


def speak_kokoro(kokoro, text: str, voice: str, out_wav: Path) -> None:
    import soundfile as sf
    lang = "en-gb" if voice.startswith("b") else "en-us"
    import re
    text = re.sub(r"(?<=\d)-(?=\d)", " ", text)   # read 2-1-1 as digits, not "two dash one"
    samples, rate = kokoro.create(text, voice=voice, speed=1.0, lang=lang)
    sf.write(str(out_wav), samples, rate)


def speak_piper(text: str, model_path: Path, out_wav: Path) -> None:
    cmd = ["piper", "--model", str(model_path), "--output_file", str(out_wav)]
    subprocess.run(cmd, input=text.encode("utf-8"), check=True)


def _text_file(text: str, near: Path) -> Path:
    """Writes `text` to a file beside `near`. The engines below read it with
    -f rather than taking it as an argument: prompt text can come from a
    board (--sync), and text starting with '-' would otherwise be parsed as
    an option -- e.g. `say -o <path>` overwriting a file of its choosing."""
    p = near.with_suffix(".txt")
    p.write_text(text, encoding="utf-8")
    return p


def speak_espeak(text: str, voice: str, out_wav: Path) -> None:
    txt = _text_file(text, out_wav)
    try:
        subprocess.run(["espeak-ng", "-v", voice, "-s", "135", "-w", str(out_wav), "-f", str(txt)],
                       check=True)
    finally:
        txt.unlink(missing_ok=True)


def speak_say(text: str, voice: str, out_aiff: Path) -> None:
    txt = _text_file(text, out_aiff)
    try:
        subprocess.run(["say", "-v", voice, "-o", str(out_aiff), "-f", str(txt)], check=True)
    finally:
        txt.unlink(missing_ok=True)


def synthesize(text: str, engine: str, piper_model: str | None,
                espeak_voice: str, say_voice: str, raw_path: Path,
                auto_install: bool = True, kokoro_voice: str = DEFAULT_KOKORO_VOICE) -> Path:
    """Synthesizes `text` with whichever engine `engine` picks ("auto" tries
    Piper -- installing it and its default voice first if auto_install and
    neither is present yet -- then espeak-ng, then macOS `say` as a last
    resort, warning on stderr when it lands on one of those lower-quality
    fallbacks). Returns the path actually written (raw_path itself, except
    for `say`'s AIFF output) -- still needs convert_to_wav() to reach the
    device's target format."""
    if engine in ("auto", "kokoro"):
        kokoro = _ensure_kokoro(auto_install)
        if kokoro:
            speak_kokoro(kokoro, text, kokoro_voice, raw_path)
            return raw_path
        if engine == "kokoro":
            raise SystemExit(
                "Kokoro requested (--engine kokoro) but not available (install or model download "
                "failed, or --no-auto-install was passed). Needs 'pip install kokoro-onnx soundfile' "
                f"and the model files in {KOKORO_DIR}.")
        print("note: Kokoro isn't available -- using Piper.", file=sys.stderr)
    if engine in ("auto", "piper"):
        piper_bin = _ensure_piper_cli(auto_install)
        if piper_bin:
            model = _resolve_piper_model(piper_model, auto_install)
            if model:
                speak_piper(text, model, raw_path)
                return raw_path
            if engine == "piper":
                raise SystemExit(
                    "Piper requested (--engine piper) but no voice model available (auto-download "
                    "failed -- see the warning above). Grab one from "
                    "https://huggingface.co/rhasspy/piper-voices and either pass --piper-model "
                    f"or drop it under {PIPER_VOICES_DIR}/."
                )
            print("warning: Piper installed but no voice model available -- "
                  "falling back to a more robotic-sounding engine.", file=sys.stderr)
        elif engine == "piper":
            raise SystemExit(
                "Piper requested (--engine piper) but not available (install failed or "
                "--no-auto-install was passed). Install it yourself with 'pip install piper-tts'."
            )
        else:
            print("warning: Piper not available -- falling back to a more robotic-sounding "
                  "engine. Run 'pip install piper-tts' yourself, or drop --no-auto-install "
                  "if you didn't want this script installing things automatically.",
                  file=sys.stderr)

    if engine in ("auto", "espeak"):
        if _which("espeak-ng"):
            if engine == "auto":
                print("using espeak-ng (more robotic than Piper) -- see the warning above "
                      "for how to get Piper instead.", file=sys.stderr)
            speak_espeak(text, espeak_voice, raw_path)
            return raw_path
        if engine == "espeak":
            raise SystemExit(
                "espeak-ng requested but not found on PATH -- install it "
                "(apt install espeak-ng / brew install espeak-ng)."
            )

    if engine in ("auto", "say") and _which("say"):
        if engine == "auto":
            print("using macOS 'say' (more robotic than Piper) -- see the warning above "
                  "for how to get Piper instead.", file=sys.stderr)
        aiff_path = raw_path.with_suffix(".aiff")
        speak_say(text, say_voice, aiff_path)
        return aiff_path
    if engine == "say":
        raise SystemExit("--engine say requires macOS's 'say' command, not found here.")

    raise SystemExit(
        "No TTS engine available. Install one of:\n"
        "  pip install piper-tts   (recommended -- this script does this automatically unless\n"
        "                           --no-auto-install was passed)\n"
        "  espeak-ng                (apt install espeak-ng / brew install espeak-ng)\n"
    )


def convert_to_wav(src: Path, dst: Path, rate: int) -> None:
    if shutil.which("afconvert") is not None:
        # Linear PCM, 16-bit little-endian, mono, at `rate` Hz -- exactly
        # what player.c's wav_parse() wants.
        subprocess.run(
            ["afconvert", "-f", "WAVE", "-d", f"LEI16@{rate}", "-c", "1",
             str(src), str(dst)],
            check=True,
        )
        return
    if shutil.which("ffmpeg") is not None:
        subprocess.run(
            ["ffmpeg", "-y", "-i", str(src), "-ar", str(rate), "-ac", "1",
             "-sample_fmt", "s16", str(dst)],
            check=True, capture_output=True,
        )
        return
    if src.suffix.lower() == ".wav":
        # Kokoro, Piper and espeak-ng all write PCM WAV, so Linux and Windows
        # need no extra tool for text-to-speech.
        _convert_wav_python(src, dst, rate)
        return
    raise SystemExit(
        "Need 'afconvert' (macOS, built in) or 'ffmpeg' on PATH to convert "
        f"{src.suffix or 'this'} audio (WAV converts without either)."
    )


def _convert_wav_python(src: Path, dst: Path, rate: int) -> None:
    """PCM WAV (8/16/24/32-bit, any channel count and rate) to mono 16-bit at
    `rate`, in plain Python: mixdown, a windowed-sinc low-pass below the new
    Nyquist when downsampling, then linear interpolation. Slow for long
    files, fine for a few seconds of speech."""
    import array
    import math
    import wave
    with wave.open(str(src), "rb") as w:
        nch, width, src_rate, n = w.getnchannels(), w.getsampwidth(), w.getframerate(), w.getnframes()
        raw = w.readframes(n)
    if width == 1:
        vals = [b - 128 << 8 for b in raw]
    elif width == 2:
        vals = array.array("h", raw)
        if sys.byteorder == "big":
            vals.byteswap()
    elif width in (3, 4):
        vals = [int.from_bytes(raw[i:i + width], "little", signed=True) >> (8 * (width - 2))
                for i in range(0, len(raw), width)]
    else:
        raise SystemExit(f"{src}: unsupported {width * 8}-bit WAV")
    mono = [sum(vals[i:i + nch]) / nch for i in range(0, len(vals), nch)]
    if rate < src_rate:
        cutoff = 0.9 * rate / 2 / src_rate          # cycles per input sample
        taps = 63
        mid = taps // 2
        h = []
        for k in range(taps):
            x = k - mid
            s = 2 * cutoff if x == 0 else math.sin(2 * math.pi * cutoff * x) / (math.pi * x)
            h.append(s * (0.54 - 0.46 * math.cos(2 * math.pi * k / (taps - 1))))
        total = sum(h)
        h = [c / total for c in h]
        padded = [0.0] * mid + mono + [0.0] * mid
        mono = [sum(c * padded[i + k] for k, c in enumerate(h)) for i in range(len(mono))]
    out = array.array("h")
    step = src_rate / rate
    pos = 0.0
    while pos <= len(mono) - 1:
        i = int(pos)
        f = pos - i
        v = mono[i] if i + 1 >= len(mono) else mono[i] * (1 - f) + mono[i + 1] * f
        out.append(max(-32768, min(32767, round(v))))
        pos += step
    if sys.byteorder == "big":
        out.byteswap()
    with wave.open(str(dst), "wb") as w:
        w.setnchannels(1)
        w.setsampwidth(2)
        w.setframerate(rate)
        w.writeframes(out.tobytes())


# Mono voice/music at telephone bandwidth (~300-3400Hz, matching this
# project's 8kHz WAV convention -- see the module docstring) holds up fine
# at a low bitrate; this is the same ballpark LAME's own docs suggest for
# mono speech/simple-music content. Chosen for a solid ~3-4x size win over
# 8kHz/16-bit PCM (128kbps) without being so low it gets warbly -- raise
# per-file with --mp3-bitrate if a specific clip sounds rough.
DEFAULT_MP3_KBPS = 40


def convert_to_mp3(src: Path, dst: Path, rate: int, kbps: int = DEFAULT_MP3_KBPS,
                    max_seconds: float | None = None) -> None:
    """Encodes to MP3 -- for player.c's CONFIG_PLAYER_MP3 playback path, not
    upload-time decode (this device never re-encodes; whatever's uploaded
    is what gets stored and played back as-is). ffmpeg-only: unlike WAV,
    afconvert doesn't do this (no MP3 encoder on macOS's Core Audio side).
    `rate` matters here more than it does for WAV -- MPEG-1 Layer III only
    supports 32/44.1/48kHz; 8kHz (this project's usual rate) needs the
    MPEG-2.5 extension, which LAME picks automatically for a low enough
    output rate, and which minimp3 (player.c's decoder) fully supports.
    `max_seconds`, if given, trims during encode (`-t`) -- trim_wav()'s
    raw-PCM byte surgery doesn't apply to a compressed stream."""
    if shutil.which("ffmpeg") is None:
        raise SystemExit(
            "Need 'ffmpeg' (with libmp3lame) on PATH to encode MP3 -- "
            "afconvert can't do this. brew install ffmpeg / apt install ffmpeg."
        )
    cmd = ["ffmpeg", "-y", "-i", str(src)]
    if max_seconds:
        cmd += ["-t", str(max_seconds)]
    cmd += ["-ar", str(rate), "-ac", "1", "-codec:a", "libmp3lame", "-b:a", f"{kbps}k", str(dst)]
    subprocess.run(cmd, check=True, capture_output=True)


def convert_to_target(src: Path, dst: Path, rate: int, kbps: int = DEFAULT_MP3_KBPS,
                       max_seconds: float | None = None) -> None:
    """Picks WAV vs MP3 encoding by `dst`'s extension -- name a clip
    something.mp3 (vs .wav) to get the compressed, CONFIG_PLAYER_MP3 path
    instead of raw PCM. Same convention gen_prompt.py already uses for
    picking a TTS engine from a flag, just keyed off the output name
    instead, since that's the one thing every caller (one-shot, --sync,
    sync_pi_audio.py) already has to specify anyway. WAV trimming still
    goes through the separate trim_wav() (byte-surgery on already-written
    PCM) -- callers should skip that call for an MP3 dst, since
    max_seconds is handled here instead, during encode."""
    if dst.suffix.lower() == ".mp3":
        convert_to_mp3(src, dst, rate, kbps, max_seconds)
    else:
        convert_to_wav(src, dst, rate)


def trim_wav(path: Path, max_seconds: float, rate: int) -> None:
    """Truncate a mono 16-bit PCM WAV's data chunk in place. Some of the
    original pi_rotary_phone audio files are multi-minute songs (the Pi just
    streamed them until hangup) -- this device's storage cap is 4MB total, so
    anything more than a short sting needs trimming before upload."""
    raw = bytearray(path.read_bytes())
    if raw[0:4] != b"RIFF" or raw[8:12] != b"WAVE":
        raise SystemExit(f"{path}: not a RIFF/WAVE file, can't trim")

    off = 12
    data_off = None
    while off + 8 <= len(raw):
        chunk_id = bytes(raw[off:off + 4])
        chunk_sz = int.from_bytes(raw[off + 4:off + 8], "little")
        body = off + 8
        if chunk_id == b"data":
            data_off = body
            break
        off = body + chunk_sz + (chunk_sz & 1)
    if data_off is None:
        raise SystemExit(f"{path}: couldn't find 'data' chunk to trim")

    max_bytes = int(max_seconds * rate) * 2  # mono, 16-bit
    max_bytes -= max_bytes % 2
    data_len = len(raw) - data_off
    if data_len <= max_bytes:
        return  # already short enough

    new_len = data_off + max_bytes
    raw[data_off - 4:data_off] = max_bytes.to_bytes(4, "little")  # this data chunk's size field
    raw[4:8] = (new_len - 8).to_bytes(4, "little")  # RIFF chunk size field
    path.write_bytes(raw[:new_len])


def _base_url(host: str) -> str:
    if not host.startswith("http://") and not host.startswith("https://"):
        host = f"http://{host}"
    return host.rstrip("/")


# The board's web password (Settings -> General), if it has one: --password,
# or the REDIAL_PASSWORD environment variable. Sent as HTTP Basic auth.
_web_password = os.environ.get("REDIAL_PASSWORD", "")


def _auth_headers() -> dict[str, str]:
    if not _web_password:
        return {}
    token = base64.b64encode(f"admin:{_web_password}".encode("utf-8")).decode("ascii")
    return {"Authorization": f"Basic {token}"}


def upload(path: Path, host: str, name: str) -> None:
    url = f"{_base_url(host)}/media/{name}"
    data = path.read_bytes()
    req = urllib.request.Request(url, data=data, method="POST",
                                  headers={"Content-Type": "audio/wav", **_auth_headers()})
    try:
        with urllib.request.urlopen(req, timeout=15) as resp:
            body = resp.read().decode("utf-8", errors="replace").strip()
    except urllib.error.HTTPError as e:
        if e.code == 401:
            raise SystemExit(f"{host} has a web password: pass it with --password "
                             "(or set REDIAL_PASSWORD).") from e
        raise
    print(f"uploaded -> {url} ({len(data)} bytes): {body}")


def fetch_prompt_requests(host: str, secret: str | None) -> list[dict]:
    url = f"{_base_url(host)}/api/prompt_requests"
    if secret:
        url += f"?secret={urllib.parse.quote(secret)}"
    try:
        with urllib.request.urlopen(url, timeout=15) as resp:
            return json.loads(resp.read().decode("utf-8"))
    except urllib.error.HTTPError as e:
        if e.code in (401, 403):
            raise SystemExit(
                f"{host} rejected this request ({e.code}) -- if this script isn't running on "
                "the same LAN subnet as the board, pass --secret (the setup password "
                "under Settings -> General on the board)."
            ) from e
        raise


def sync_prompts(host: str, secret: str | None, engine: str, piper_model: str | None,
                  espeak_voice: str, say_voice: str, rate: int, out_dir: Path,
                  only: list[str] | None, auto_install: bool = True,
                  kokoro_voice: str = DEFAULT_KOKORO_VOICE) -> None:
    entries = fetch_prompt_requests(host, secret)
    pending = [e for e in entries if e.get("pending") and e.get("text")]
    if only:
        pending = [e for e in pending if e["name"] in only]
    if not pending:
        print("nothing to generate -- all tracked prompts are up to date "
              "(or none have text set yet -- see Settings -> Operator/Record/Dial Codes)")
        return

    out_dir.mkdir(parents=True, exist_ok=True)
    for e in pending:
        name, text = e["name"], e["text"]
        print(f"generating '{name}': {text!r}")
        out_path = out_dir / name
        with tempfile.TemporaryDirectory() as td:
            raw = synthesize(text, engine, piper_model, espeak_voice, say_voice,
                              Path(td) / "speech.wav", auto_install, kokoro_voice)
            convert_to_wav(raw, out_path, rate)
        upload(out_path, host, name)
    print(f"synced {len(pending)} prompt(s)")


def main() -> None:
    p = argparse.ArgumentParser(description=__doc__,
                                 formatter_class=argparse.RawDescriptionHelpFormatter)
    p.add_argument("text", nargs="?", help="Text to speak")
    p.add_argument("--from", dest="from_file", metavar="FILE",
                    help="Convert an existing audio file instead of synthesizing speech")
    p.add_argument("--name",
                    help="Output filename, e.g. operator.wav or clip_401.wav (see module "
                         "docstring). Required unless --sync.")
    p.add_argument("--engine", default="auto", choices=("auto", "kokoro", "piper", "espeak", "say"),
                    help="TTS engine (default: auto -- Kokoro, then Piper, then espeak-ng, then macOS 'say')")
    p.add_argument("--kokoro-voice", default=DEFAULT_KOKORO_VOICE,
                    help=f"Kokoro voice, only used with Kokoro (default: {DEFAULT_KOKORO_VOICE})")
    p.add_argument("--piper-model", help="Path to a Piper .onnx voice model")
    p.add_argument("--espeak-voice", default=DEFAULT_ESPEAK_VOICE,
                    help=f"espeak-ng voice (default: {DEFAULT_ESPEAK_VOICE})")
    p.add_argument("--voice", dest="say_voice", default=DEFAULT_SAY_VOICE,
                    help=f"macOS 'say' voice, only used with --engine say (default: {DEFAULT_SAY_VOICE})")
    p.add_argument("--rate", type=int, default=DEFAULT_RATE,
                    help=f"Output sample rate in Hz -- must match the device's audio_sample_rate() "
                         f"(default: {DEFAULT_RATE})")
    p.add_argument("--out-dir", default=str(Path(__file__).resolve().parents[2] / "voice_prompts"),
                    help="Where to save the WAV locally (default: the repo's voice_prompts/)")
    p.add_argument("--max-seconds", type=float, default=None,
                    help="Trim to at most this many seconds (from the start) -- storage is capped "
                         "at 4MB total on the device, so multi-minute source files need this")
    p.add_argument("--mp3-bitrate", type=int, default=DEFAULT_MP3_KBPS, metavar="KBPS",
                    help=f"Bitrate for a .mp3 --name (default: {DEFAULT_MP3_KBPS}, mono) -- only "
                         "used when --name/--sync's clip name ends in .mp3; a .wav name is "
                         "unaffected and stays raw PCM.")
    p.add_argument("--upload", metavar="HOST",
                    help="Also POST the result to http://HOST/media/<name>, e.g. --upload phone.local "
                         "or --upload 192.168.0.148")
    p.add_argument("--sync", metavar="HOST",
                    help="Instead of a one-shot generate: fetch pending prompt text from the board "
                         "(GET /api/prompt_requests), generate + upload audio for each. --secret is "
                         "only needed if this isn't running on the board's own LAN subnet. Ignores "
                         "text/--from/--name/--upload/--max-seconds.")
    p.add_argument("--secret", help="Setup password for --sync (Settings -> General on the "
                                     "board). Not needed when "
                                     "running --sync from the same LAN subnet as the board -- only "
                                     "for a board reachable over a different network (VPN, remote "
                                     "setup, etc).")
    p.add_argument("--password", help="The board's web password, if it has one (Settings -> "
                                       "General -> Web password). Default: $REDIAL_PASSWORD.")
    p.add_argument("--only", action="append", metavar="NAME",
                    help="With --sync, only generate this clip name (repeatable). Default: everything pending.")
    p.add_argument("--no-auto-install", action="store_true",
                    help="Don't let --engine auto/piper run 'pip install piper-tts' or download a "
                         "voice model on your behalf -- fail over to the next engine immediately "
                         "instead (or, with --engine piper, error out) if Piper isn't already set up.")
    args = p.parse_args()
    auto_install = not args.no_auto_install
    global _web_password
    if args.password:
        _web_password = args.password
    if args.sync or not args.from_file:
        _use_tts_venv(args.engine, auto_install)

    if args.sync:
        sync_prompts(args.sync, args.secret, args.engine, args.piper_model,
                     args.espeak_voice, args.say_voice, args.rate, Path(args.out_dir), args.only,
                     auto_install, args.kokoro_voice)
        return

    if args.text and args.from_file:
        p.error("text and --from are mutually exclusive")
    if not args.text and not args.from_file:
        p.error("one of: text, --from FILE, or --sync HOST is required")
    if not args.name:
        p.error("--name is required")

    out_path = Path(args.out_dir) / args.name
    out_path.parent.mkdir(parents=True, exist_ok=True)

    is_mp3 = out_path.suffix.lower() == ".mp3"
    if args.from_file:
        convert_to_target(Path(args.from_file), out_path, args.rate, args.mp3_bitrate,
                           args.max_seconds if is_mp3 else None)
    else:
        with tempfile.TemporaryDirectory() as td:
            raw = synthesize(args.text, args.engine, args.piper_model,
                              args.espeak_voice, args.say_voice, Path(td) / "speech.wav",
                              auto_install, args.kokoro_voice)
            convert_to_target(raw, out_path, args.rate, args.mp3_bitrate,
                               args.max_seconds if is_mp3 else None)

    if args.max_seconds and not is_mp3:
        trim_wav(out_path, args.max_seconds, args.rate)

    size = out_path.stat().st_size
    print(f"wrote {out_path} ({size} bytes, {args.rate} Hz mono 16-bit PCM)")

    if args.upload:
        upload(out_path, args.upload, args.name)
    else:
        print(f"to upload later:  curl -X POST --data-binary @{out_path} "
              f"http://phone.local/media/{args.name}")


if __name__ == "__main__":
    main()
