sdylewski/Analog-Redial/firmware/components/board/include/board.h

/* board.h — board-level init helpers shared across components. */
#pragma once

#include "esp_err.h"
#include "driver/i2c_master.h"
#include <stddef.h>
#include <stdint.h>
#include <stdbool.h>

#ifdef __cplusplus
extern "C" {
#endif

/* Initialize the shared I2C master bus (codec control). Idempotent. */
esp_err_t board_i2c_init(void);

/* Pin setup that has to happen before any peripheral claims its pins. On
 * SMD5 with the clone MCU module, detaches the USB-Serial-JTAG PHY from
 * GPIO12/13 (which carry I2S MCLK and SD card-detect there); no-op on every
 * other board. Call first thing in app_main. */
void board_early_pin_init(void);

/* Handle to the shared I2C master bus, or NULL if not initialized. */
i2c_master_bus_handle_t board_i2c_bus(void);

/* Probes the I2C bus for the ES8388 (0x10) and logs a warning if it doesn't
 * answer. Safe to call before or after board_i2c_init(). */
void board_detect_codec(void);

/* ---- PCB type mismatch guard ----
 * CONFIG_BOARD_TYPE_SMD2/_SMD4/_SMD5 is fixed at compile time and drives
 * GPIO pin routing that differs between variants -- notably, SMD2 and
 * SMD4 disagree on which of the shared GPIO18-21 pads is SD's CS vs. MISO
 * (board_pins_smd.h vs. board_pins_smd4.h). Flashing the wrong variant's
 * firmware onto a given physical board doesn't fail loudly -- subsystems
 * that don't touch the differing pins (WiFi, VOIP, general telephony)
 * keep working fine, while the ones that do (microSD, line 1) just quietly
 * stop, with nothing pointing at "wrong board type" as the reason.
 *
 * board_type_check() remembers which variant last confirmed-booted on
 * THIS physical board (NVS, survives reflashes) and compares it against
 * the CURRENT binary's own compile-time type on every boot. First boot
 * ever (nothing recorded yet, including any board already in the field
 * from before this existed) just records the current type as a trusted
 * baseline -- there's nothing to compare against yet, so this can't create
 * a false mismatch on a board that was already working fine. Call once,
 * early in app_main() -- before board-specific GPIO is touched, so a real
 * mismatch can be reflected in the boot LED state immediately. */
void        board_type_check(void);
bool        board_type_mismatch(void);
/* What was recorded on a previous boot ("SMD2"/"SMD4"/"SMD5"), ""
 * if nothing recorded yet -- for the hazard banner/Hardware tab to show
 * expected-vs-actual. Compare against board_pcb_variant_name() (running
 * binary's own compile-time type, board_config.h) for the other half. */
void        board_type_recorded(char *out, size_t len);
/* Records the CURRENTLY RUNNING binary's type as correct, clearing any
 * mismatch -- for a genuine board swap (old hardware retired, new board
 * really is a different variant), not for silencing a real mixup. */
esp_err_t   board_type_confirm(void);

typedef enum {
    BOARD_LED_BOOTING,         /* fast blink -- subsystems still coming up */
    BOARD_LED_OK,               /* solid green for LED_OK_HOLD_MS (30s), then off -- everything initialized cleanly */
    BOARD_LED_ERROR,            /* slow blink -- a subsystem failed to init but
                                  * the device kept running (see app_main.c) */
    BOARD_LED_WIFI_CONNECTING,  /* slow PWM breathe -- WiFi connect in progress */
    BOARD_LED_OTA_UPDATING,     /* fast blink -- writing a new firmware image
                                  * (webui.c's ota_upload_handler); only ever
                                  * seen briefly before the reboot into it, or
                                  * not at all on SMD2 (single-color LED --
                                  * see board.c, no separate OTA pattern there) */
    BOARD_LED_BT_PAIRING,       /* blue blink -- BM64 in discoverable mode */
    BOARD_LED_BT_CONNECTED,     /* solid blue (brief) -- BT link established */
} board_led_state_t;

/* ---- Restart record (kept in NVS, so a power cycle or a boot loop can't
 * erase it the way it erases the RAM log) ---- */
typedef struct {
    uint32_t boots;          /* every boot since the counters were cleared */
    uint32_t brownouts;      /* restarts because the supply dipped too low */
    uint32_t crashes;
    uint32_t watchdogs;
    uint32_t boots_since_brownout; /* 0 = this boot was one; UINT32_MAX = never */
    bool     power_warning;  /* a brownout nobody has acknowledged yet */
} board_restart_stats_t;

/* Call once at boot, after NVS is up: counts this boot and why it happened.
 * After a brownout it also raises the power warning (amber LED, Status page
 * banner, the low-battery tone on the next pickup). */
void board_restart_record(void);
void board_restart_stats_get(board_restart_stats_t *out);
bool board_power_warning(void);
/* Acknowledge the warning (LED and banner off; counts kept). */
void board_power_warning_clear(void);
/* Zero all counts and the warning. */
void board_restart_stats_clear(void);
/* True once per boot while the warning is up: the first pickup hears it. */
bool board_power_warning_announce(void);

/* Configures the status LED (SMD only -- GPIO11 on SMD2, the DevKitC-1
 * module's own onboard addressable RGB on SMD4/GPIO8) and starts it blinking fast (BOARD_LED_BOOTING). Call once,
 * early in app_main(), before other subsystem init so there's visible boot
 * feedback even if something later hangs. Note this can only ever reflect
 * APPLICATION state -- the chip's own ROM bootloader (e.g. stuck in USB
 * download mode after a reset) runs before this code exists to run at all,
 * so there is no way for firmware to light anything during that state. */
void board_led_init(void);

/* Change the blink pattern. Safe to call from any task. */
void board_led_set_state(board_led_state_t state);

/* Starts a background task that watches the BOOT strap (GPIO9). Held low for
 * ~3 s *during normal runtime* (NOT at power-on -- low at reset just enters
 * the serial bootloader), it calls on_hold() once, meant for a WiFi factory
 * reset (erase creds + reboot). Reading the strap as an input after boot is
 * safe. Pass NULL to disable. */
void board_boot_button_start(void (*on_rescue)(void), void (*on_factory_reset)(void));

/* ---- Board identity ----
 * Lets several boards on one LAN be told apart in the web UI (see the
 * Settings page). Three layers:
 *   - serial: the factory-unique ESP32-C6 MAC, never changes, not settable.
 *   - hardware: chip + codec + PCB variant, detected, not settable.
 *   - name: a human label you set ("Scott's Room"); persists in NVS and,
 *     sanitized, becomes the mDNS <name>.local hostname. */

typedef enum {
    BOARD_CODEC_NONE = 0,  /* nothing ACKed on the I2C bus yet / at all */
    BOARD_CODEC_ES8388,    /* 0x10 */
} board_codec_t;

/* Result of the last board_detect_codec() probe (BOARD_CODEC_NONE before it
 * has run). Reflects what is physically on the bus, independent of the
 * CONFIG_BOARD_TYPE_* this firmware was built for. */
board_codec_t board_detected_codec(void);
const char   *board_codec_name(board_codec_t c);

/* Factory-unique chip id (the WiFi-station MAC) as "AABBCCDDEEFF". Stable
 * across reflashes and NVS erases -- the closest thing to a serial number. */
void board_serial_str(char *out, size_t len);

/* One-line hardware description, e.g. "ESP32-C6 rev1.0 · ES8388 (SMD2)".
 * Combines chip model/revision, the detected codec, and the built-for PCB. */
void board_hardware_str(char *out, size_t len);

/* Persisted, user-facing board name (NVS). Defaults to CONFIG_MDNS_HOSTNAME ("phone")
 * on first boot / if unset. board_name_set() rejects empty names. */
void      board_name_get(char *out, size_t len);
esp_err_t board_name_set(const char *name);
/* Forget the saved name, back to the "phone" default. */
esp_err_t board_name_clear(void);

/* True only if a name has actually been stored (user- or auto-assigned),
 * false when board_name_get() is still falling back to the default. Lets the
 * mDNS collision logic auto-rename only an un-personalized board. */
bool board_name_is_set(void);

/* mDNS label derived from the board name: lowercased, apostrophes dropped,
 * other non [a-z0-9] folded to a single '-', so "Living Room" ->
 * "living-room" (reachable as living-room.local). wifi_apply_hostname()
 * feeds this to mDNS. */
void board_hostname(char *out, size_t len);

/* ---- Phone language ----
 * One language for the whole phone, set once during configuration -- NOT
 * switchable in use (that was the Pi's 901/902 behavior; dropped here as
 * more complexity than it's worth). Whatever this is set to is what
 * setup-time prompt/number-audio generation (gen_prompt.py et al.) should
 * target; nothing in the dial plan changes it. A short code, e.g. "en",
 * "it" -- not validated against a fixed list, so new languages don't need a
 * firmware change, just matching audio assets. */
void      board_language_get(char *out, size_t len); /* defaults to "en" */
esp_err_t board_language_set(const char *lang);

/* ---- Call-progress tone region ----
 * Separate switch from the language above: on by default (so a board that
 * already picked a language to get its regional dial/ring/busy tones,
 * tones/tone_regions.h, keeps them after a firmware update that adds this
 * flag), but the two aren't the same thing -- someone might want the UI
 * language changed without also changing what a familiar dial tone sounds
 * like. Off means tones.c always uses the US entry (TONE_REGIONS[0])
 * regardless of board_language_get(). */
/* Dial/ringback/busy tone region, independent of the UI language -- a
 * region code from TONE_REGIONS[] in tones/tone_regions.h ("us", "gb",
 * "de", ...). Defaults to "us". Only consulted when
 * board_tone_follow_language_get() is false. */
void      board_tone_region_get(char *out, size_t len);
esp_err_t board_tone_region_set(const char *code);

bool      board_tone_follow_language_get(void); /* defaults to true */
esp_err_t board_tone_follow_language_set(bool follow);

/* In-call voice effects (keys 1, 2, 5, 6 during a call; dial 322 or 324). */
/* Optional features that get their own Settings tab (Settings -> General ->
 * Features). 1 on, 0 off, -1 never set (callers pick the default). */
int       board_feature_get(const char *key);
esp_err_t board_feature_set(const char *key, bool on);
bool      board_voice_fx_enabled_get(void);
esp_err_t board_voice_fx_enabled_set(bool enabled);
/* Voice effect settings (VOICE_FX_PARAMS, voice_fx.h), saved as an array.
 * get fills in only the entries that were saved and leaves the rest as the
 * caller set them (the defaults); returns how many it filled. */
size_t    board_voice_fx_tuning_get(int16_t *v, size_t n);
esp_err_t board_voice_fx_tuning_set(const int16_t *v, size_t n);
/* The key that picks each voice effect during a call (telephony.c's order):
 * get fills in what was saved, leaving the rest as the caller set them. */
size_t    board_voice_fx_keys_get(char *keys, size_t n);
esp_err_t board_voice_fx_keys_set(const char *keys, size_t n);
/* Alarms (dial 256) ring even during quiet hours. Off by default: quiet
 * hours silence alarms too, like every other ring. */
bool      board_alarm_quiet_override_get(void);
esp_err_t board_alarm_quiet_override_set(bool on);

/* How the alarm (dial 256) and the timer (dial 846) ring: `count` bursts of
 * `on_ms`, `off_ms` apart, repeated a few times until someone answers. Each
 * has its own, saved; out-of-range values are clamped by the setter. */
typedef enum { BOARD_RING_ALARM = 0, BOARD_RING_TIMER = 1 } board_ring_use_t;
typedef struct { uint16_t on_ms, off_ms; uint8_t count; } board_ring_pattern_t;
#define BOARD_RING_ON_MIN_MS   200
#define BOARD_RING_ON_MAX_MS   10000
#define BOARD_RING_OFF_MIN_MS  200
#define BOARD_RING_OFF_MAX_MS  10000
#define BOARD_RING_COUNT_MAX   10
board_ring_pattern_t board_ring_pattern_get(board_ring_use_t use);
esp_err_t            board_ring_pattern_set(board_ring_use_t use, board_ring_pattern_t p);

/* ---- Off-hook ("receiver off-hook" / ROH) alert ----
 * A handset left off the hook sits on dial tone forever otherwise: the line
 * is unreachable (callers get busy) with nothing to draw attention to it.
 * Real switches escalate to a deliberately loud, dissonant alert tone after
 * a timeout; this reproduces that (TONE_OFFHOOK_ALERT, tones.h), triggered
 * from the dial-tone state only -- the other idle-ish states either already
 * play something attention-getting (reorder) or represent a real call.
 * Hanging up clears it, same as any other state. */
#define BOARD_OFFHOOK_ALERT_MIN_S 10
#define BOARD_OFFHOOK_ALERT_MAX_S 3600
typedef struct {
    bool     enabled;
    uint32_t seconds; /* dial-tone dwell before the alert starts */
} board_offhook_alert_t;

/* Defaults to enabled / 120 s until board_offhook_alert_set() says otherwise. */
board_offhook_alert_t board_offhook_alert_get(void);
/* ESP_ERR_INVALID_ARG outside BOARD_OFFHOOK_ALERT_MIN_S..MAX_S. Takes effect
 * on the next dial tone -- no reboot (the FSM reads this when it starts the
 * dwell timer). */
esp_err_t board_offhook_alert_set(board_offhook_alert_t cfg);

/* ---- Intercom (2-line boards) ----
 * Lift the handset, wait `seconds` on dial tone without dialling, and the other
 * line rings with a short double ring. Dialling a digit first makes it a
 * normal call. Off by default. */
#define BOARD_INTERCOM_MIN_S 1
#define BOARD_INTERCOM_MAX_S 30
typedef struct {
    bool    enabled;
    uint8_t seconds;
} board_intercom_t;
board_intercom_t board_intercom_get(void);
/* ESP_ERR_INVALID_ARG outside MIN..MAX. Applies from the next dial tone. */
esp_err_t board_intercom_set(board_intercom_t cfg);

/* ---- Answering machine (per line) ----
 * After `rings` unanswered rings, auto-answers and plays this line's own
 * greeting (recorded via dial code 999, see telephony.c) then records the
 * caller after a beep. `other_line` gates whether an unanswered call FROM
 * this board's other line (not VoIP) also gets auto-answered -- off by
 * default, since routing a family member's unanswered intercom call to
 * voicemail isn't obviously wanted. Meaningless/hidden in the UI on a
 * 1-line board. See archive/ANSWERING_MACHINE.md. */
#define BOARD_AM_RINGS_MIN    1
#define BOARD_AM_RINGS_MAX   15
#define BOARD_AM_MAX_MS_MIN 5000    /* 5 s */
#define BOARD_AM_MAX_MS_MAX 120000  /* 2 min -- matches BOARD_RECORD_MAX_MS_MAX's ceiling */
typedef struct {
    bool     enabled;
    uint8_t  rings;      /* rings before auto-answer */
    uint32_t max_ms;     /* max caller message length */
    bool     other_line;
} board_am_cfg_t;

/* Defaults to disabled / 4 rings / 30000 ms / other_line off. */
board_am_cfg_t board_am_get(int line);
/* ESP_ERR_INVALID_ARG if rings or max_ms are outside their MIN..MAX above. */
esp_err_t board_am_set(int line, board_am_cfg_t cfg);

/* ---- Timezone (for Quiet hours below) ----
 * Nothing else in this firmware cares about local time -- recording
 * timestamps and everything else deliberately use UTC (gmtime_r()), and
 * stay that way regardless of this setting. A POSIX TZ string (e.g.
 * "PST8PDT,M3.2.0,M11.1.0" for US Pacific with DST, "EST5" for fixed-offset
 * US Eastern with no DST rule) -- newlib's localtime_r() parses this
 * directly, so no timezone database needs to ship in firmware. See
 * https://github.com/nayarsystems/posix_tz_db for a lookup table of common
 * strings. "" (default) means UTC. */
#define BOARD_TZ_MAX 64
void      board_timezone_get(char *out, size_t len); /* "" = UTC (default) */
/* True once a zone has been saved, by a person or by the browser default
 * (even "" = UTC). False on a board that has never had one, which still
 * shows UTC. */
bool      board_timezone_is_chosen(void);
/* Applies immediately (setenv("TZ", ...) + tzset()) -- no reboot needed. */
esp_err_t board_timezone_set(const char *tz);
/* Applies whatever's saved in NVS to the process's C library timezone.
 * Call once at boot, before anything might call board_quiet_hours_active(). */
void      board_timezone_init(void);

/* ---- Quiet hours ----
 * While enabled and the current local time (board_timezone_get(), UTC if
 * unset) falls in [start, end), nothing rings: incoming calls go straight
 * to the answering machine (or, with none, are never answered), and timers
 * and alarms stay silent -- old mechanical ringers are loud, and not
 * everyone wants one going off at 2 a.m. One setting for both lines (not
 * per-line -- if you're asleep, you're asleep regardless of which line
 * rings). See start_ring() in telephony.c for the call routing. */
typedef struct {
    bool    enabled;
    uint8_t start_hour, start_min; /* 0-23, 0-59 */
    uint8_t end_hour, end_min;
} board_quiet_hours_t;

/* Defaults to disabled, 21:00-07:00 (9 pm-7 am) once enabled. `start` later
 * than `end` (the common case) means a window that wraps past midnight --
 * see board_quiet_hours_active(). */
board_quiet_hours_t board_quiet_hours_get(void);
/* ESP_ERR_INVALID_ARG if any hour/minute is out of range. Takes effect on
 * the next incoming call -- no reboot needed. */
esp_err_t board_quiet_hours_set(board_quiet_hours_t cfg);
/* True if quiet hours are enabled and right now (local time) falls inside
 * the configured window. */
bool board_quiet_hours_active(void);

/* ---- AEC bulk delay (per-line, per-device) ----
 * Each physical board's own I2S/codec/acoustic path has a slightly different
 * bulk delay (measured via the bringup `echoprobe` command, applied by hand
 * or via `aec sweep`) -- one firmware image serves every board of a given
 * type, so this can't be a compile-time default the way most of aec.h's
 * tuning constants are. Persisted per line so a value set by hand or found
 * by `aec sweep` survives a reboot instead of reverting to the generic
 * compiled default every time. */
/* Returns the persisted value for `line`, or `fallback_ms` if nothing has
 * been persisted yet -- callers pass their own compiled default so this
 * component doesn't need to know AEC's tuning constants. */
uint32_t board_aec_delay_get(int line, uint32_t fallback_ms);
esp_err_t board_aec_delay_set(int line, uint32_t ms);
/* The web page's Enable switch, per line: 0 = off, otherwise the
 * AEC_SAVE_VERSION it was saved with (aec_init compares). 0 if never saved. */
uint8_t board_aec_on_get(int line);
esp_err_t board_aec_on_set(int line, uint8_t version);

/* ---- 211 "record a message" max duration ----
 * Board-wide (not per-line): recording is a local feature, not something
 * that varies by which line placed the call. Returns `fallback_ms` if
 * never set. */
#define BOARD_RECORD_MAX_MS_MIN  5000   /* 5 s -- below this isn't a useful message */
#define BOARD_RECORD_MAX_MS_MAX 120000  /* 2 min -- generous ceiling, storage is the real limit */
uint32_t board_record_max_ms_get(uint32_t fallback_ms);
/* ESP_ERR_INVALID_ARG outside BOARD_RECORD_MAX_MS_MIN..MAX. */
esp_err_t board_record_max_ms_set(uint32_t ms);

/* ---- Ring frequency, per line ----
 * Saved for a phone whose ringer is tuned away from the normal 20 Hz. Every
 * ring on that line uses it. _set returns ESP_ERR_INVALID_ARG outside MIN..MAX. */
#define BOARD_RING_HZ_DEFAULT 20
#define BOARD_RING_HZ_MIN     16
#define BOARD_RING_HZ_MAX     66
uint8_t   board_ring_hz_get(int line);
esp_err_t board_ring_hz_set(int line, uint8_t hz);

/* ---- Touch-tone detector limits, per line ----
 * Saved by the touch-tone test, as an opaque blob (dtmf_tuning_t: board can't
 * depend on dtmf). _get returns false if none is saved, or it's another size.
 * _set with data NULL goes back to none. */
bool      board_dtmf_tuning_get(int line, void *out, size_t len);
esp_err_t board_dtmf_tuning_set(int line, const void *data, size_t len);

/* ---- Speaker (earpiece) drive level, per line ----
 * ES8388 LOUT1VOL/ROUT1VOL convention (see es8388.h / the bring-up `spkamp`
 * command): 0 = mute, 33 = 0 dB, 1 dB/step, 63 = max. Persisted so a level
 * tuned by ear (console `spkamp`, or the webui volume control) survives a
 * reboot instead of reverting to the compiled boot default every time. */
uint8_t board_speaker_volume_get(int line, uint8_t fallback);
esp_err_t board_speaker_volume_set(int line, uint8_t vol);
/* Highest level found clean by the self-test's audio-level check; 0 = never measured. */
uint8_t   board_speaker_clean_max_get(int line);
esp_err_t board_speaker_clean_max_set(int line, uint8_t level);

/* ---- Line/microSD hardware configuration (SMD2 only) ----
 * The SMD2 PCB's GPIO 18-21 are wired to EITHER a second AG1171 SLIC (line
 * 2) OR a microSD socket, never both -- a BOM/jumper choice made when the
 * board was assembled (see archive/hardware/smd2.md's "Build options": populate
 * line 2's 0R jumpers, or the microSD's 0R jumpers, one set only). This used
 * to be a build-time choice (CONFIG_BOARD_NUM_LINES/CONFIG_BOARD_MICROSD),
 * meaning a separate firmware image per board variant. Now runtime,
 * NVS-backed, so one firmware image works on either board -- but that means
 * something has to decide which peripheral those 4 pins actually are, and a
 * wrong guess doesn't just misbehave in software, it drives real GPIO pins
 * as the wrong peripheral (the line-2 side of that pair carries SLIC
 * control signals). So: defaults to the SAFEST option (1 line, no SD) until
 * a human explicitly confirms otherwise -- see board_hw_config_set(). */
/* Which Bluetooth companion is on the J2 header, if any. Same 8 pins, same
 * analog audio path; they differ in UART protocol and in what they can do
 * (the BT401 speaks plain-text AT commands, the BM64 a binary protocol). Chosen in Settings -> Hardware, takes effect
 * on reboot. */
typedef enum {
    BOARD_BT_NONE = 0,
    BOARD_BT_BM64,
    BOARD_BT_BT401,
} board_bt_module_t;

typedef struct {
    int  num_lines;    /* 1 or 2 */
    bool has_microsd;  /* only meaningful combined with num_lines == 1 */
    /* A BM64 Bluetooth companion is physically fitted. Deliberately separate
     * from bt_companion_set_enabled(), which is the runtime feature toggle:
     * conflating "this board has the hardware" with "the feature is on" is
     * what let a stray enabled flag claim a phone line on a board with no
     * module attached, killing dial tone with no way to tell why (2026-09-26,
     * hours of it). "Fitted" is a fact about the board; "enabled" is a
     * choice, and the feature only acts when both are true.
     *
     * Orthogonal to num_lines: the companion's audio is always line 0's
     * Vin/Vout and its UART is always GPIO16/17, neither of which collides
     * with line 1. (Its MFB/RST_N/P2_0 pins DO land on line 1's SLIC control
     * pins on SMD4/SMD5. On SMD4 that means a 2-line board takes a BM64 by
     * pulling J5's shunts -- line 1's SLIC stays stuffed but disconnected --
     * and is then configured as one line. SMD5 plans to give MFB its own GPIO
     * and use J5 only temporarily for EEPROM programming. See
     * archive/BLUETOOTH_AUDIO_UPGRADE.md and bt_companion_ibdk_enter().) */
    bool has_bt_module;
    /* Which one. board_hw_config_set() keeps the two in step: a caller that
     * only sets has_bt_module = true gets BOARD_BT_BM64 (the only module
     * that existed when that field was the whole story). */
    board_bt_module_t bt_module;
} board_hw_config_t;

/* Current config: whatever was last written, by a human
 * (board_hw_config_set()) OR by board_hw_config_autodetect()'s best-effort
 * guess -- see board_hw_config_is_set() to tell those apart from each other
 * and from "nothing written yet, on the hardcoded (1, false) fallback". */
board_hw_config_t board_hw_config_get(void);

/* True once a human has explicitly confirmed a configuration via
 * board_hw_config_set() -- NOT true just because board_hw_config_autodetect()
 * has written a guess (that's the whole point: the guess should work
 * out-of-the-box, but still needs a one-time human look, see the first-boot
 * banner in webui.c). The web UI should prompt for this if false, rather
 * than silently trusting an unconfirmed value forever. */
bool board_hw_config_is_set(void);

/* Rejects num_lines outside 1-2, and num_lines==2 combined with
 * has_microsd==true (the GPIO conflict this whole API exists to prevent;
 * SMD6 allows it, having no conflict), with ESP_ERR_INVALID_ARG. Takes effect on reboot -- like every other
 * hardware config in this project, peripheral GPIO/driver init only runs
 * once at boot. Marks the config human-confirmed (board_hw_config_is_set()
 * becomes true) -- this is the one function that does. */
esp_err_t board_hw_config_set(board_hw_config_t cfg);

/* Best-effort auto-guess, run once early in app_main() (before ag1170_init()
 * and any sdcard_init()) so line 2 or microSD actually works out of the box
 * on a fresh board instead of sitting on the conservative (1, false)
 * fallback until someone visits Settings. No-op if a value already exists
 * (a prior guess, or a human's explicit confirm) -- only ever fires once,
 * on the very first boot after flashing/factory-reset. Deliberately does
 * NOT mark the config confirmed (board_hw_config_is_set() stays false) --
 * it's a guess, not a human's word, so the first-boot banner still asks for
 * a one-time review. Evidence used, strongest first: the SD_CD card-detect
 * pin (SMD4 only -- a real physical switch, decisive when a board has one:
 * a card can only be seated on a board actually wired for microSD), then
 * board_hw_detect_evidence()'s weaker SHK-divider heuristic for 2-line vs
 * 1-line. Falls back to (1, false) if neither gives a positive read. */
void board_hw_config_autodetect(void);

/* Best-effort, purely advisory evidence for a human to sanity-check
 * board_hw_config_autodetect()'s guess against -- e.g. Settings ->
 * Hardware's "Advisory evidence" row, or the first-boot banner. NOT
 * authoritative on its own (see that function's doc comment for why a wrong
 * guess matters). The raw_levels/looks_like_line2 GPIO18-21 read is only
 * physically possible before any peripheral has claimed those pins -- input-
 * only, drives nothing, but a floating/undriven pin reads as whatever noise
 * it picks up, so it's cached from whenever that first real read happened
 * (autodetect(), very early in app_main(), before ag1170_init()/
 * sdcard_init() can claim them) and just replayed on every later call in
 * the same boot -- this function does NOT re-read those 4 pins once
 * something owns them, it would glitch a live peripheral. card_present
 * (BOARD_SD_CD, SMD4 only) has no such restriction -- it's a dedicated,
 * always-safe-to-read pin -- so that field is live every call, not cached. */
typedef struct {
    bool valid;               /* false if board type isn't SMD -- no GPIO18-21 pair to read, or no cached reading exists (already had a confirmed/guessed value before the first read this boot) */
    int  raw_levels[4];        /* GPIO 18,19,20,21 as read at cache time, 0/1 each */
    bool looks_like_line2;     /* SHK-equivalent (GPIO19) read low at rest, as a bare/idle AG1171 SHK divider would */
    bool card_present;         /* BOARD_SD_CD read low (card physically seated) -- always false on boards without a CD pin (SMD2) */
} board_hw_evidence_t;
board_hw_evidence_t board_hw_detect_evidence(void);

/* True when this board is configured for 2 lines but a microSD card is
 * mechanically present (BOARD_SD_CD) anyway -- see docs/hardware.md's "J5:
 * line-1 SLIC vs. microSD" for the physical wiring this reasons about.
 * GPIO18-21 are a real jumper header, not a soft/logical switch: when
 * jumpered for line 1, the card's data lines are electrically disconnected
 * from the ESP32 entirely, so this is NOT an electrical hazard on those
 * lines the way it might sound -- the card just sits there powered but
 * silent. It's still a real physical/config mismatch worth surfacing
 * loudly (someone built/jumpered for one option and left a card meant for
 * the other sitting in the socket) rather than leaving "the SD card just
 * silently doesn't work" as the only symptom. Just combines two existing
 * calls (board_hw_config_get(), board_hw_detect_evidence()), so it's as
 * cheap and safe to call from anywhere, any time, as they already are --
 * no new state, no GPIO side effects. */
bool board_sd_line1_conflict(void);

/* True when nothing is using GPIO18-21: one line, no microSD. Always false on
 * SMD6, where they're wired to the microSD socket and nothing else. */
bool board_shared_pads_free(void);

#ifdef __cplusplus
}
#endif
