sdylewski/Analog-Redial/firmware/components/audio/audio.c

#include "audio.h"
#include "board_pins.h"
#include "dtmf.h"
#include "aec.h"
#include "esp_log.h"
#include "esp_heap_caps.h"
#include "esp_timer.h"
#include "freertos/FreeRTOS.h"
#include "freertos/task.h"
#include "freertos/stream_buffer.h"
#include "freertos/semphr.h"
#include "driver/i2s_std.h"
#include <string.h>
#include <stdlib.h>
#include <math.h>

static const char *TAG = "audio";

typedef enum {
    SRC_SILENCE = 0,
    SRC_TONE,
    SRC_DTMF,
    SRC_BRIDGE,
    SRC_EXTERNAL,
} tx_src_t;

typedef struct {
    tx_src_t        src;
    progress_tone_t prog;     /* SRC_TONE */
    tone_osc_t      dtmf;     /* SRC_DTMF */
    uint32_t        dtmf_left;/* samples remaining in DTMF burst */
    int             bridge_from;
    StreamBufferHandle_t ext; /* SRC_EXTERNAL downlink */

    audio_rx_tap_fn rx_tap;
    void           *rx_ctx;
    audio_rx_tap_fn diag_tap; /* second, independent slot -- see audio_add_diag_tap() */
    void           *diag_ctx;
    audio_rx_tap_fn downlink_tap; /* see audio_add_downlink_tap() */
    void           *downlink_ctx;
    audio_rx_tap_fn extwrite_tap; /* see audio_add_extwrite_tap() */
    void           *extwrite_ctx;
    StreamBufferHandle_t rx;  /* uplink capture for voip/record */
    uint16_t        rx_level;
    /* AEC path: 8 kHz echo-cancelled uplink, fed only while the canceller is
     * enabled. Kept separate from `rx` above so the 48 kHz raw capture stays
     * exactly that -- recorder/diag taps/echoprobe must keep seeing the true
     * uncancelled mic signal, or they'd be measuring the canceller instead of
     * the hardware. */
    StreamBufferHandle_t aec_out;
    int32_t         dec_ref_acc, dec_near_acc; /* 48k->8k decimation accumulators */
    uint32_t        dec_n;
    volatile bool   inject_uplink; /* see audio_set_uplink_inject() */
    /* Voice effect (audio_set_voice_fx()): fx_down shapes what this line's
     * earpiece hears from a bridge/VoIP peer; fx_up/fx_up8 shape the uplink
     * VoIP reads (48 kHz raw or 8 kHz echo-cancelled). Allocated when an
     * effect is turned on; when it's turned off (every call end does that)
     * fx_release asks the audio task to free them between frames, see
     * fx_release_pending(). */
    voice_fx_t        fx;
    bool              fx_release;
    voice_fx_state_t *fx_down, *fx_up, *fx_up8;   /* all run at 8 kHz, see fx_at_8k() */
    int16_t           fx_down_prev, fx_up_prev;   /* fx_at_8k()'s upsampler, per stream */
    /* When something (the VoIP RTP task, the recorder) last asked for this
     * line's uplink. The uplink effect costs as much as the downlink one
     * (~2 ms of every 10 ms frame for pitch effects), so on a call between two
     * local phones, where nobody reads the uplink, it's skipped. */
    volatile int64_t uplink_read_us;
    volatile int64_t aec_read_us;    /* last audio_aec_read(): a call is taking the cancelled uplink */
    /* Frames of external audio (VoIP, player) the engine had to fill with
     * silence because the source hadn't delivered in time; see audio_ext_underruns(). */
    volatile uint32_t ext_underruns;
} line_t;

static line_t s_line[AUDIO_NUM_LINES];
static int16_t *s_rx_mono[AUDIO_NUM_LINES]; /* last RX frame, for bridge */
static int16_t *s_fx_tmp[AUDIO_NUM_LINES];  /* uplink copy for the voice effect */

static i2s_chan_handle_t s_tx, s_rx;

/* Runs a voice effect on a 48 kHz frame at 8 kHz: averages each group of 6
 * samples down, runs the effect, interpolates back up. A call carries nothing
 * above 4 kHz, the effects (robot's FFT, the pitch splicer's correlation
 * search) are sized for 8 kHz, and it's a sixth of the work: at 48 kHz the
 * pitch effects took ~2 ms of each 10 ms frame per stream, and a VoIP call with
 * echo cancellation could run out of time and drop audio. */
static void fx_at_8k(voice_fx_state_t *st, voice_fx_t fx, int16_t *x, size_t n, int16_t *prev,
                     uint32_t sr)
{
    if (!st || fx == VOICE_FX_NONE) return;
    uint32_t dec = sr >= 8000 ? sr / 8000 : 1;
    if (dec <= 1) { voice_fx_process(st, fx, x, n); return; }
    int16_t y[160];
    size_t m = n / dec;
    if (m > 160) m = 160;
    for (size_t i = 0; i < m; i++) {
        int32_t acc = 0;
        for (uint32_t k = 0; k < dec; k++) acc += x[i * dec + k];
        y[i] = (int16_t)(acc / (int32_t)dec);
    }
    voice_fx_process(st, fx, y, m);
    int32_t p = *prev;
    for (size_t i = 0; i < m; i++) {
        for (uint32_t k = 0; k < dec; k++)
            x[i * dec + k] = (int16_t)(p + (int32_t)(y[i] - p) * (int32_t)(k + 1) / (int32_t)dec);
        p = y[i];
    }
    *prev = (int16_t)p;
}
static uint32_t s_sr = 48000;
static size_t   s_frame = 480;
static portMUX_TYPE s_mux = portMUX_INITIALIZER_UNLOCKED;
static TaskHandle_t s_task;

/* Test-only digital loopback: when on, the RX processing chain (level meter,
 * DTMF detector tap, rx stream buffer) is fed the TX we just synthesized
 * instead of the codec's real ADC input -- so an automated test can play a
 * tone/DTMF/clip and confirm it's actually produced and detectable, without
 * a physical handset. This is a DSP-domain loopback (TX buffer -> RX
 * processing); it does NOT exercise the analog codec I/O, which is what the
 * mic->speaker `loopback` command + a listen are for. */
static volatile bool s_test_loopback;

/* Idle pause (see audio_allow_pause()). The task normally runs a full
 * read-process-write cycle every 10ms forever, even with every phone hung up
 * -- the biggest steady CPU load on the board. When the layer above says all
 * lines are idle AND nothing has touched audio for AUDIO_PAUSE_AFTER_MS, the
 * task disables both I2S channels and sleeps. Anything that wants audio
 * wakes it through audio_wake(), called from every setter that starts a
 * source/tap and from audio_rx_read(), so tools that use audio with the
 * phones on-hook (bring-up `tone`, `capture`, test loopback, the web UI's
 * test recording) keep working without knowing any of this exists. */
#define AUDIO_PAUSE_AFTER_MS 2000
static volatile bool    s_allow_pause;
static volatile bool    s_paused;
static volatile int64_t s_last_use_us;   /* last time something asked for audio */

static void audio_wake(void)
{
    s_last_use_us = esp_timer_get_time();
    if (s_paused && s_task) xTaskNotifyGive(s_task);
}

uint32_t audio_sample_rate(void) { return s_sr; }

/* ---- source setters (short critical sections) ---- */
void audio_tx_silence(int line)
{
    if (line < 0 || line >= AUDIO_NUM_LINES) return;
    portENTER_CRITICAL(&s_mux);
    s_line[line].src = SRC_SILENCE;
    portEXIT_CRITICAL(&s_mux);
}

void audio_tx_tone(int line, call_progress_t tone)
{
    audio_wake();
    if (line < 0 || line >= AUDIO_NUM_LINES) return;
    progress_tone_t p;
    progress_tone_start(&p, s_sr, tone);
    portENTER_CRITICAL(&s_mux);
    s_line[line].prog = p;
    s_line[line].src = SRC_TONE;
    portEXIT_CRITICAL(&s_mux);
}

void audio_tx_dtmf(int line, char key, uint32_t ms)
{
    audio_wake();
    if (line < 0 || line >= AUDIO_NUM_LINES) return;
    tone_osc_t o;
    if (!dtmf_make_osc(&o, s_sr, key, 0.5f)) return;
    uint32_t n = (uint32_t)((uint64_t)ms * s_sr / 1000);
    portENTER_CRITICAL(&s_mux);
    s_line[line].dtmf = o;
    s_line[line].dtmf_left = n;
    s_line[line].src = SRC_DTMF;
    portEXIT_CRITICAL(&s_mux);
}

void audio_tx_burst(int line, float f1, float f2, float amp, uint32_t ms)
{
    audio_wake();
    if (line < 0 || line >= AUDIO_NUM_LINES) return;
    tone_osc_t o;
    tone_osc_init(&o, s_sr, f1, f2, amp);
    uint32_t n = (uint32_t)((uint64_t)ms * s_sr / 1000);
    portENTER_CRITICAL(&s_mux);
    s_line[line].dtmf = o;
    s_line[line].dtmf_left = n;
    s_line[line].src = SRC_DTMF;
    portEXIT_CRITICAL(&s_mux);
}

void audio_tx_bridge(int line, int from_line, bool enable)
{
    if (enable) audio_wake();
    if (line < 0 || line >= AUDIO_NUM_LINES) return;
    portENTER_CRITICAL(&s_mux);
    if (enable) {
        s_line[line].bridge_from = from_line;
        s_line[line].src = SRC_BRIDGE;
    } else if (s_line[line].src == SRC_BRIDGE) {
        s_line[line].src = SRC_SILENCE;
    }
    portEXIT_CRITICAL(&s_mux);
}

/* Held while something outside the audio task reads the effect states
 * (audio_voice_fx_stats()) and while the audio task frees them. */
static StaticSemaphore_t s_fx_mtx_buf;
static SemaphoreHandle_t s_fx_mtx;   /* created in audio_init() */

/* Audio task only, between frames (nothing else processes the states): free
 * the effect states of lines whose effect was turned off, about 10 KB per
 * line. Skips a round if a stats reader holds the mutex. */
static void fx_release_pending(void)
{
    for (int line = 0; line < AUDIO_NUM_LINES; line++) {
        if (!s_line[line].fx_release) continue;
        if (!s_fx_mtx || xSemaphoreTake(s_fx_mtx, 0) != pdTRUE) return;
        voice_fx_state_t *d = NULL, *u = NULL, *u8 = NULL;
        portENTER_CRITICAL(&s_mux);
        line_t *l = &s_line[line];
        if (l->fx_release && l->fx == VOICE_FX_NONE) {
            d = l->fx_down; u = l->fx_up; u8 = l->fx_up8;
            l->fx_down = l->fx_up = l->fx_up8 = NULL;
            l->fx_down_prev = l->fx_up_prev = 0;
        }
        l->fx_release = false;
        portEXIT_CRITICAL(&s_mux);
        voice_fx_destroy(d);
        voice_fx_destroy(u);
        voice_fx_destroy(u8);
        xSemaphoreGive(s_fx_mtx);
        if (d) ESP_LOGI(TAG, "line %d: voice effect off, memory freed", line);
    }
}

esp_err_t audio_set_voice_fx(int line, voice_fx_t fx)
{
    if (line < 0 || line >= AUDIO_NUM_LINES) return ESP_ERR_INVALID_ARG;
    line_t *l = &s_line[line];
    if (fx != VOICE_FX_NONE && !l->fx_down) {
        voice_fx_state_t *down = voice_fx_create(8000);
        voice_fx_state_t *up   = voice_fx_create(8000);
        voice_fx_state_t *up8  = voice_fx_create(8000);
        if (!down || !up || !up8) {
            voice_fx_destroy(down);
            voice_fx_destroy(up);
            voice_fx_destroy(up8);
            return ESP_ERR_NO_MEM;
        }
        portENTER_CRITICAL(&s_mux);
        l->fx_down = down;
        l->fx_up = up;
        l->fx_up8 = up8;
        portEXIT_CRITICAL(&s_mux);
    }
    portENTER_CRITICAL(&s_mux);
    l->fx = fx;
    l->fx_release = (fx == VOICE_FX_NONE && l->fx_down);
    portEXIT_CRITICAL(&s_mux);
    if (l->fx_release && s_paused && s_task) xTaskNotifyGive(s_task);   /* free it now, not in 0.5 s */
    return ESP_OK;
}

void audio_voice_fx_stats(int line, bool downlink, voice_fx_stats_t *out)
{
    memset(out, 0, sizeof(*out));
    if (line < 0 || line >= AUDIO_NUM_LINES) return;
    if (!s_fx_mtx) return;
    xSemaphoreTake(s_fx_mtx, portMAX_DELAY);
    if (downlink) {
        voice_fx_take_stats(s_line[line].fx_down, out);
    } else {
        /* The uplink effect runs on the echo-cancelled 8 kHz stream when a
         * call reads that, otherwise on the plain one: report whichever ran. */
        voice_fx_stats_t a, b;
        voice_fx_take_stats(s_line[line].fx_up, &a);
        voice_fx_take_stats(s_line[line].fx_up8, &b);
        *out = b.samples >= a.samples ? b : a;
    }
    xSemaphoreGive(s_fx_mtx);
    out->fx = s_line[line].fx;
}

voice_fx_t audio_voice_fx(int line)
{
    return (line >= 0 && line < AUDIO_NUM_LINES) ? s_line[line].fx : VOICE_FX_NONE;
}

void audio_tx_external(int line, bool enable)
{
    if (enable) audio_wake();
    if (line < 0 || line >= AUDIO_NUM_LINES) return;
    portENTER_CRITICAL(&s_mux);
    s_line[line].src = enable ? SRC_EXTERNAL : SRC_SILENCE;
    portEXIT_CRITICAL(&s_mux);
}

void audio_set_uplink_inject(int line, bool on)
{
    if (on) audio_wake();
    if (line < 0 || line >= AUDIO_NUM_LINES) return;
    s_line[line].inject_uplink = on; /* read in audio_task's RX-processing loop; no lock needed for a single bool */
}

uint32_t audio_ext_underruns(int line)
{
    if (line < 0 || line >= AUDIO_NUM_LINES) return 0;
    return s_line[line].ext_underruns;
}

size_t audio_ext_write(int line, const int16_t *mono, size_t n)
{
    if (line < 0 || line >= AUDIO_NUM_LINES || !s_line[line].ext) return 0;
    if (s_line[line].extwrite_tap) {
        s_line[line].extwrite_tap(line, mono, n, s_line[line].extwrite_ctx);
    }
    return xStreamBufferSend(s_line[line].ext, mono, n * sizeof(int16_t), 0)
           / sizeof(int16_t);
}

size_t audio_ext_write_downlink(int line, const int16_t *mono, size_t n)
{
    if (line < 0 || line >= AUDIO_NUM_LINES || !s_line[line].ext) return 0;
    if (s_line[line].inject_uplink) {
        /* Answering machine on a VoIP call: the greeting/beep are being
         * queued by the player, and this is the CALLER'S voice. Queuing it
         * too would interleave the two in one buffer (the caller hears the
         * greeting chopped up and their own voice echoed back). The
         * recorder still gets it, through the tap. */
        if (s_line[line].extwrite_tap) s_line[line].extwrite_tap(line, mono, n, s_line[line].extwrite_ctx);
        return n;
    }
    return audio_ext_write(line, mono, n);
}

void audio_set_rx_tap(int line, audio_rx_tap_fn fn, void *ctx)
{
    if (line < 0 || line >= AUDIO_NUM_LINES) return;
    portENTER_CRITICAL(&s_mux);
    s_line[line].rx_tap = fn;
    s_line[line].rx_ctx = ctx;
    portEXIT_CRITICAL(&s_mux);
}

void audio_add_diag_tap(int line, audio_rx_tap_fn fn, void *ctx)
{
    audio_wake();
    if (line < 0 || line >= AUDIO_NUM_LINES) return;
    portENTER_CRITICAL(&s_mux);
    s_line[line].diag_tap = fn;
    s_line[line].diag_ctx = ctx;
    portEXIT_CRITICAL(&s_mux);
}

void audio_remove_diag_tap(int line)
{
    if (line < 0 || line >= AUDIO_NUM_LINES) return;
    portENTER_CRITICAL(&s_mux);
    s_line[line].diag_tap = NULL;
    s_line[line].diag_ctx = NULL;
    portEXIT_CRITICAL(&s_mux);
}

void audio_add_downlink_tap(int line, audio_rx_tap_fn fn, void *ctx)
{
    audio_wake();
    if (line < 0 || line >= AUDIO_NUM_LINES) return;
    portENTER_CRITICAL(&s_mux);
    s_line[line].downlink_tap = fn;
    s_line[line].downlink_ctx = ctx;
    portEXIT_CRITICAL(&s_mux);
}

void audio_remove_downlink_tap(int line)
{
    if (line < 0 || line >= AUDIO_NUM_LINES) return;
    portENTER_CRITICAL(&s_mux);
    s_line[line].downlink_tap = NULL;
    s_line[line].downlink_ctx = NULL;
    portEXIT_CRITICAL(&s_mux);
}

void audio_add_extwrite_tap(int line, audio_rx_tap_fn fn, void *ctx)
{
    audio_wake();
    if (line < 0 || line >= AUDIO_NUM_LINES) return;
    portENTER_CRITICAL(&s_mux);
    s_line[line].extwrite_tap = fn;
    s_line[line].extwrite_ctx = ctx;
    portEXIT_CRITICAL(&s_mux);
}

void audio_remove_extwrite_tap(int line)
{
    if (line < 0 || line >= AUDIO_NUM_LINES) return;
    portENTER_CRITICAL(&s_mux);
    s_line[line].extwrite_tap = NULL;
    s_line[line].extwrite_ctx = NULL;
    portEXIT_CRITICAL(&s_mux);
}

/* record_tap-style plumbing, private to audio_echo_probe() -- deliberately
 * not reusing audio_rx_read()'s stream buffer (see its own doc comment: one
 * reader max, and the RTP task may already own it) or bringup.c's identical
 * helper for `record` (that one streams to storage in chunks; this one just
 * needs a single bounded in-RAM capture). */
typedef struct {
    StreamBufferHandle_t sb;
} echo_probe_tap_ctx_t;

static void echo_probe_tap(int line, const int16_t *mono, size_t n, void *ctx)
{
    (void)line;
    echo_probe_tap_ctx_t *c = ctx;
    xStreamBufferSend(c->sb, mono, n * sizeof(int16_t), 0);
}

/* Background noise is measured for 1.5 s in 100 ms blocks before the burst,
 * and the result is trusted only if the blocks agree: a floor measured over a
 * moment that happened to be quiet (or loud) would make a real echo vanish
 * or a cough look like one.
 *
 * Memory: the samples are processed as they arrive (a 10 KB stream buffer and
 * a 1 KB chunk) rather than stored, because a board with a microSD card
 * fitted can have no free block bigger than about 24 KB. The echo itself is
 * reduced to the loudest sample of each millisecond; the console's envelope
 * plot gets the raw samples only if it passed a buffer for them. */
#define ECHO_NOISE_BLOCKS    15
#define ECHO_NOISE_BLOCK_MS  100
#define ECHO_CHUNK           480        /* samples handled at a time (10 ms at 48 kHz) */
#define ECHO_MAX_LISTEN_MS   1000       /* the envelope holds 1 ms per entry */

bool audio_echo_probe(int line, uint32_t burst_hz, uint32_t burst_ms,
                       uint32_t listen_ms, int16_t *cap_out, size_t cap_out_n,
                       audio_echo_probe_t *out)
{
    if (line < 0 || line >= AUDIO_NUM_LINES || !out) return false;
    memset(out, 0, sizeof(*out));
    if (listen_ms > ECHO_MAX_LISTEN_MS) listen_ms = ECHO_MAX_LISTEN_MS;

    uint32_t sr = s_sr;
    size_t n_samples = (size_t)((uint64_t)sr * listen_ms / 1000);
    size_t blk = (size_t)((uint64_t)sr * ECHO_NOISE_BLOCK_MS / 1000);
    size_t ms1 = sr / 1000;                       /* samples per millisecond */
    int16_t *chunk = malloc(ECHO_CHUNK * sizeof(int16_t));
    uint16_t *env = calloc(ECHO_MAX_LISTEN_MS, sizeof(uint16_t));
    /* Slack for the time the caller spends processing between receives; the tap
     * never blocks, so an undersized buffer silently drops samples. */
    StreamBufferHandle_t sb = xStreamBufferCreate(4 * ECHO_CHUNK * sizeof(int16_t) * 2, 1);
    if (!chunk || !env || !sb) {
        ESP_LOGW(TAG, "echo probe: not enough free memory to run (largest free block %u bytes)",
                 (unsigned)heap_caps_get_largest_free_block(MALLOC_CAP_8BIT));
        free(chunk); free(env);
        if (sb) vStreamBufferDelete(sb);
        return false;
    }
    echo_probe_tap_ctx_t ctx = { .sb = sb };

    /* 1. Quiet the line (a dial tone would otherwise be in the measurement),
     *    let what was playing drain out of the DMA buffers, then listen. */
    audio_tx_silence(line);
    vTaskDelay(pdMS_TO_TICKS(200));
    audio_add_diag_tap(line, echo_probe_tap, &ctx);
    uint64_t sum = 0;
    uint32_t bmax = 0;
    bool ok = true;
    for (int bi = 0; bi < ECHO_NOISE_BLOCKS && ok; bi++) {
        uint64_t acc = 0;
        size_t done = 0;
        while (done < blk) {
            size_t want = blk - done < ECHO_CHUNK ? blk - done : ECHO_CHUNK;
            size_t n = xStreamBufferReceive(sb, chunk, want * sizeof(int16_t), pdMS_TO_TICKS(500)) / sizeof(int16_t);
            if (n == 0) { ok = false; break; }
            for (size_t i = 0; i < n; i++) acc += (uint64_t)((int32_t)chunk[i] * chunk[i]);
            done += n;
        }
        if (!ok) break;
        uint32_t r = (uint32_t)sqrt((double)acc / (double)blk);
        sum += r;
        if (r > bmax) bmax = r;
    }
    audio_remove_diag_tap(line);
    if (!ok) {
        ESP_LOGW(TAG, "echo probe: no audio arrived while measuring the background");
        vStreamBufferDelete(sb); free(chunk); free(env);
        return false;
    }
    uint32_t noise_rms = (uint32_t)(sum / ECHO_NOISE_BLOCKS);
    out->noise_rms = noise_rms;
    out->noise_max_rms = bmax;
    /* Steady: no block louder than half as much again as the average (plus a
     * little slack for a very quiet floor). */
    out->noise_steady = bmax <= noise_rms + noise_rms / 2 + 4;
    xStreamBufferReset(sb);

    /* 2. The burst. Tap first, THEN emit: starting the burst before the tap is
     *    armed would lose the very leading edge this measurement is all about. */
    audio_add_diag_tap(line, echo_probe_tap, &ctx);
    audio_tx_burst(line, (float)burst_hz, 0.0f, 0.8f, burst_ms);

    size_t got = 0;
    int32_t peak = 0;
    size_t peak_i = 0;
    while (got < n_samples) {
        size_t want = n_samples - got < ECHO_CHUNK ? n_samples - got : ECHO_CHUNK;
        size_t n = xStreamBufferReceive(sb, chunk, want * sizeof(int16_t), pdMS_TO_TICKS(500)) / sizeof(int16_t);
        if (n == 0) break;
        for (size_t i = 0; i < n; i++) {
            size_t gi = got + i;
            int32_t a = chunk[i] < 0 ? -chunk[i] : chunk[i];
            if (a > peak) { peak = a; peak_i = gi; }
            size_t m = gi / ms1;
            if (m < ECHO_MAX_LISTEN_MS && a > env[m]) env[m] = (uint16_t)(a > 65535 ? 65535 : a);
            if (cap_out && gi < cap_out_n) cap_out[gi] = chunk[i];
        }
        got += n;
    }
    audio_remove_diag_tap(line);
    vStreamBufferDelete(sb);
    audio_tx_silence(line);
    free(chunk);

    if (got == 0) { free(env); return false; }
    if (cap_out && cap_out_n > got) memset(cap_out + got, 0, (cap_out_n - got) * sizeof(int16_t));

    /* A floor of 0 or 1 would call anything an echo. */
    uint32_t floor_rms = noise_rms < 2 ? 2 : noise_rms;

    /* Tail: the last millisecond still above max(4x noise floor, 5% of peak),
     * scanned from the end so a mid-burst dip doesn't cut it short. */
    int32_t thresh = (int32_t)floor_rms * 4;
    if (thresh < peak / 20) thresh = peak / 20;
    size_t peak_m = peak_i / ms1, last_m = got / ms1;
    if (last_m > ECHO_MAX_LISTEN_MS) last_m = ECHO_MAX_LISTEN_MS;
    size_t tail_i = peak_i;
    for (size_t m = last_m; m > peak_m; m--) {
        if (env[m - 1] > thresh) { tail_i = m * ms1 - 1; break; }
    }
    free(env);

    out->leak_detected = peak >= (int32_t)floor_rms * 4;
    out->peak = peak;
    out->delay_ms = (double)peak_i * 1000.0 / (double)sr;
    out->tail_ms = tail_i > peak_i ? (double)(tail_i - peak_i) * 1000.0 / (double)sr : 0.0;
    return true;
}

size_t audio_rx_read(int line, int16_t *mono, size_t n, uint32_t timeout_ms)
{
    audio_wake();
    if (line < 0 || line >= AUDIO_NUM_LINES || !s_line[line].rx) return 0;
    s_line[line].uplink_read_us = esp_timer_get_time();
    size_t got = xStreamBufferReceive(s_line[line].rx, mono, n * sizeof(int16_t),
                                      pdMS_TO_TICKS(timeout_ms)) / sizeof(int16_t);
    s_line[line].uplink_read_us = esp_timer_get_time();
    return got;
}

size_t audio_aec_read(int line, int16_t *mono, size_t n, uint32_t timeout_ms)
{
    if (line < 0 || line >= AUDIO_NUM_LINES || !s_line[line].aec_out) return 0;
    s_line[line].uplink_read_us = s_line[line].aec_read_us = esp_timer_get_time();
    size_t got = xStreamBufferReceive(s_line[line].aec_out, mono, n * sizeof(int16_t),
                                      pdMS_TO_TICKS(timeout_ms)) / sizeof(int16_t);
    s_line[line].uplink_read_us = s_line[line].aec_read_us = esp_timer_get_time();
    return got;
}

uint16_t audio_rx_level(int line)
{
    if (line < 0 || line >= AUDIO_NUM_LINES) return 0;
    return s_line[line].rx_level;
}

void audio_set_test_loopback(bool on)
{
    if (on) audio_wake();
    s_test_loopback = on;
}

bool audio_test_loopback(void)
{
    return s_test_loopback;
}

/* Fill one line's mono TX frame according to its current source. */
static void fill_tx_line(int line, int16_t *out, size_t n)
{
    /* Copy out the volatile bits under lock, then synthesize outside it. */
    line_t snap;
    portENTER_CRITICAL(&s_mux);
    snap = s_line[line];
    portEXIT_CRITICAL(&s_mux);

    switch (snap.src) {
        case SRC_TONE: {
            progress_tone_fill(&snap.prog, out, n);
            portENTER_CRITICAL(&s_mux);
            if (s_line[line].src == SRC_TONE) s_line[line].prog = snap.prog;
            portEXIT_CRITICAL(&s_mux);
            break;
        }
        case SRC_DTMF: {
            size_t emit = (snap.dtmf_left < n) ? snap.dtmf_left : n;
            if (emit) tone_osc_fill(&snap.dtmf, out, emit);
            for (size_t i = emit; i < n; i++) out[i] = 0;
            portENTER_CRITICAL(&s_mux);
            if (s_line[line].src == SRC_DTMF) {
                s_line[line].dtmf = snap.dtmf;
                s_line[line].dtmf_left = (snap.dtmf_left > emit) ? snap.dtmf_left - emit : 0;
                if (s_line[line].dtmf_left == 0) s_line[line].src = SRC_SILENCE;
            }
            portEXIT_CRITICAL(&s_mux);
            break;
        }
        case SRC_BRIDGE: {
            int from = snap.bridge_from;
            if (from >= 0 && from < AUDIO_NUM_LINES && s_rx_mono[from]) {
                memcpy(out, s_rx_mono[from], n * sizeof(int16_t));
                fx_at_8k(snap.fx_down, snap.fx, out, n, &s_line[line].fx_down_prev, s_sr);
            } else {
                memset(out, 0, n * sizeof(int16_t));
            }
            break;
        }
        case SRC_EXTERNAL: {
            size_t got = 0;
            if (snap.ext) {
                got = xStreamBufferReceive(snap.ext, out, n * sizeof(int16_t), 0)
                      / sizeof(int16_t);
            }
            if (got < n) s_line[line].ext_underruns++;
            for (size_t i = got; i < n; i++) out[i] = 0; /* underrun -> silence */
            fx_at_8k(snap.fx_down, snap.fx, out, n, &s_line[line].fx_down_prev, s_sr);
            break;
        }
        case SRC_SILENCE:
        default:
            memset(out, 0, n * sizeof(int16_t));
            break;
    }
}

static uint16_t rms_of(const int16_t *x, size_t n)
{
    if (!n) return 0;
    uint64_t acc = 0;
    for (size_t i = 0; i < n; i++) acc += (int32_t)x[i] * x[i];
    return (uint16_t)sqrt((double)acc / (double)n);
}

/* Something still needs the pipeline running, independent of what the layer
 * above says. The telephony DTMF rx_tap is deliberately NOT counted -- it's
 * registered permanently on every line, and DTMF only matters off-hook,
 * which the layer above already reports as not-idle. */
static bool audio_busy(void)
{
    if (s_test_loopback) return true;
    for (int i = 0; i < AUDIO_NUM_LINES; i++) {
        const line_t *l = &s_line[i];
        if (l->src != SRC_SILENCE || l->inject_uplink || l->diag_tap ||
            l->downlink_tap || l->extwrite_tap) {
            return true;
        }
    }
    return (esp_timer_get_time() - s_last_use_us) < (int64_t)AUDIO_PAUSE_AFTER_MS * 1000;
}

void audio_allow_pause(bool allow)
{
    if (!allow) s_last_use_us = esp_timer_get_time();
    s_allow_pause = allow;
    if (!allow && s_paused && s_task) xTaskNotifyGive(s_task);
}

bool audio_is_paused(void) { return s_paused; }
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
