sdylewski/Analog-Redial/firmware/components/storage/storage.c

#include "freertos/FreeRTOS.h"
#include "freertos/task.h"
#include "storage.h"
#include "sdcard.h"
#include "esp_spiffs.h"
#include "esp_log.h"
#include <sys/stat.h>
#include <dirent.h>
#include <stdio.h>
#include <string.h>
#include <stdlib.h>
#include <unistd.h>
#include <stdint.h>
#include <errno.h>

static const char *TAG = "storage";
#define MOUNT_POINT "/assets"          /* writable: recordings + uploads */
#define SD_MOUNT_POINT "/sd"           /* mirrors sdcard.c's SD_MOUNT -- kept as a separate
                                        * literal rather than a shared header so this component
                                        * doesn't need to reach into sdcard's internals, just its
                                        * public sdcard_mounted()/sdcard_capacity() */
#define BUNDLED_MOUNT_POINT "/bundled" /* read-only-in-spirit: baked in at build time */

static bool s_bundled_mounted;

/* A bare file name: no path separators, no "..", no control characters.
 * Names arrive from URLs and upload forms, so every path below goes
 * through this; a bad name yields an empty path, which every open/stat/
 * unlink then simply fails. */
static bool safe_name(const char *name)
{
    if (!name || !name[0] || strlen(name) >= STORAGE_MAX_NAME) return false;
    if (strstr(name, "..")) return false;
    for (const char *p = name; *p; p++) {
        if (*p == '/' || *p == '\\' || (unsigned char)*p < 0x20) return false;
    }
    return true;
}

static void mount_path(char *out, size_t out_len, const char *mount, const char *name)
{
    if (safe_name(name)) snprintf(out, out_len, "%s/%s", mount, name);
    else if (out_len) out[0] = '\0';
}

static void full_path(char *out, size_t out_len, const char *name)
{
    mount_path(out, out_len, MOUNT_POINT, name);
}

static void sd_full_path(char *out, size_t out_len, const char *name)
{
    mount_path(out, out_len, SD_MOUNT_POINT, name);
}
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
