sdylewski/Analog-Redial/(commit log)

2026-07-06 Initial commit: ESP32-C6 rotary phone gateway (firmware, hardware, docs)
    Import existing firmware (ESP-IDF), KiCad hardware designs (SMD + through-hole),
    datasheets, and project documentation. Add CLAUDE.md consolidating project
    context previously kept in .cursor/rules for use with Claude Code.
2026-07-21 Add network/web layer, milestone-3 prompt playback, and hardware fixes
    Squashes a long bring-up/dev session into one checkpoint (going forward,
    commits will be per-feature/fix as requested):
    - WiFi (NVS + Kconfig credentials), NTP, in-RAM log ring buffer, SPIFFS-backed
    storage layer, and a web UI (status/log/recordings/dial-guide/settings)
    styled to match the original Pi Flask app.
    - Dual-board Kconfig (SMD2/THT) with runtime codec_detect, ES8388 driver,
    status LED breathing during WiFi connect.
    - Real SMD2 hardware bugs found and fixed: USB D+/D- swap, AG1171 Vin/Vout
    swap, SLIC PD polarity, ES8388 DAC mute-by-default, single-ADC-channel mono
    capture bodge-fixed to true stereo (R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
2026-07-21 Add storage file manager to Settings page + WAV trim option for gen_prompt.py
    Settings now lists every file in the storage layer (name/size/download/
    delete) via a new POST /media_delete/<name> endpoint -- storage.c has no
    concept of "recording" vs "prompt clip", it's all just files, so this is
    the one place to see and manage everything.
    gen_prompt.py gained --max-seconds: several of the original pi_rotary_phone
    audio files (martians.wav, crocfa.wav, ringfire.wav) are multi-minute songs
    the Pi just streamed until hangup, way past this device's 4MB total storage
    cap. Trims the WAV data chunk in place after conversion.
2026-07-21 Resample prompt playback so 8kHz phone-quality clips work at native pitch
    player.c required the WAV's sample rate to match the device's fixed 48kHz
    I2S rate or played at the wrong speed/pitch. Added a streaming linear-
    interpolation resampler so clips can be stored at 8kHz (real telephone
    bandwidth, ~6x smaller than 48kHz, no decoder needed) while live telephony
    audio stays untouched at 48kHz.
    gen_prompt.py now defaults to 8000 Hz for generated/converted prompts.
    Verified on hardware: storage usage for 5 clips dropped from 2.7MB to
    466KB, console confirms "resampling to device rate 48000 Hz" and clean
    playback.
2026-07-21 Fix player.c truncating nearly every clip to ~0.25s
    wav_parse()'s data-chunk-size clamp (body+sz <= len ? sz : len-body) was
    correct in the original whole-file-buffered player, where `len` was the
    real file length. After the streaming rewrite, `len` became the small
    8KB header-scan buffer size instead -- so any real clip (data starting
    around a 4KB filler-chunk offset, which afconvert always adds) got
    silently truncated to roughly HEADER_SCAN_BYTES minus that offset,
    regardless of true length. Explains "burp plays for a second then stops,
    everything else plays nothing" -- longer clips were being cut to a
    fraction of a second, not failing outright.
    Now trusts the WAV header's declared data-c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
2026-07-21 firmware: sync dial plan to Pi, add board identity, provisioning, recording
    Dial plan / web:
    - Rewrite dialplan.c TABLE to match pi_rotary_phone DIAL_CODES.md + live
    phone_config.json (211-215 record, 321-324 interphone, 401-414 clips,
    811/812 radio, 901/902/921/922/931/932 modes); drop old placeholder codes.
    - /guide regrouped into cards; real Settings page with tabs (modes + WiFi
    editable, others read-only placeholders).
    - Fix Safari rendering: declare UTF-8 charset; strip ANSI colour codes from
    the log panel. Recordings tab now shows only user recordings (rec_*).
    Persistence / identity:
    - dialplan modes + board name persist to NVS. Board name -> mDNS hostname
    with LAN collision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
2026-07-22 voip: custom embedded SIP/RTP user agent (registers + calls real Asterisk)
    Replaces the voip.c stub with a hand-rolled SIP UA + RTP media, implementing
    the existing voip.h seam so telephony needs no changes. Bench-verified against
    a live Asterisk (feynman.local): both accounts register with MD5 digest auth
    (qop=auth), and an outbound INVITE to the echo test completes INVITE -> 401 ->
    auth -> 200 OK -> ACK -> RTP up -> BYE.
    - g711.h: G.711 u-law (PCMU) codec.
    - rtp.c/.h: RTP/G.711 media session per line, bridged to the audio component
    (audio_rx_read 48k->8k->u-law tx; rx u-law->8k->48k->audio_ext_write),
    20 ms packets, fixed local ports 4000/4002.
    - voip.c: SIP UA over one UDP socket :50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
2026-07-22 sdcard: microSD (SPI/FAT) support for the Line-2-traded-for-SD build
    New sdcard component mounts a FAT card over SPI at /sd on the SMD build that
    uses GPIO 18-21 for a microSD socket instead of Line 2 (CS=18, SCLK=19,
    MOSI=20, MISO=21). Opt-in at build time: CONFIG_BOARD_MICROSD + 1 line; all
    calls are no-op stubs otherwise so app_main/console reference them freely.
    - sdcard_init() mounts /sd via esp_vfs_fat_sdspi_mount and logs card info;
    called from app_main under CONFIG_BOARD_MICROSD so the boot log shows
    whether the card came up.
    - Console: sd_test -- mount (if needed), print card type/size + FAT usage,
    and write/read/verify a temp file.
    - Bench-verified on hardware: a 16 GB SDHC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
2026-07-22 config: single-line build gating, human-readable sizes, getting-started guide
    Make the firmware cleanly configurable across board variants (for open-source
    release) and clarify the web UI.
    - Single-line builds (CONFIG_BOARD_NUM_LINES=1): compile out the 3xx
    "call other phone" dial codes, and hide the pieces that depend on a second
    line -- the Inter-phone Settings tab, the Dial Guide "Call other phone"
    card (guide now skips any empty category), and the extra Line card on
    Status. Nothing 2-line shows up on a 1-line phone.
    - Web UI sizes are human-readable (fmt_bytes -> "4.19 MB", "152.8 kB", "0 B")
    everywhere instead of raw byte counts. Hardware tab relabels the ambiguous
    values a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
2026-07-22 esp32: single setup-time language, fix monitor/console bugs, drop unreliable detect
    Single language, config-time only (matches the Pi refactor in the same
    commit series):
    - Remove 901/902 dial codes, MODE_ENGLISH/MODE_ITALIAN, and the per-line
    italian[2] flag from dialplan_modes_t. Call-only no longer silently forces
    a language change (that was Pi-inherited behavior, dropped along with the
    rest of in-use switching).
    - New board_language_get/set (NVS, "board" namespace) -- one language for
    the whole phone, set once via Settings -> General, meant to drive
    setup-time prompt/number audio generation (gen_prompt.py), not runtime
    switching.
    - Settings General tab: single "Language" card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
2026-07-22 Add browser-based audio upload with on-device format conversion
    New multipart/form-data reader (multipart.c/.h) -- nothing in this
    codebase could parse a real <input type=file> POST before (uploads
    were either raw-body PUT/POST via curl, or small url-encoded forms).
    Streams the request body through a small heap-allocated buffer rather
    than buffering the whole upload.
    Settings -> Operator now has a real upload form: pick a WAV of any
    common sample rate/bit-depth/channel count, and it's converted to
    8kHz mono 16-bit PCM via audio_convert and streamed straight into
    storage as operator.wav, replacing the old "run gen_prompt.py by hand"
    instruction.
    Bugs found via live end-to-end testing (uploa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
2026-07-22 Wire real file upload into the Dial Codes tab
    Settings -> Dial Codes now supports uploading new audio directly, on
    top of the existing "pick an already-uploaded file" option: a per-row
    "upload new audio" form replaces a code's audio in place (same
    filename), and a new "upload + add dial code" form creates a brand new
    code with a fresh file (destination filename derived from the upload's
    own name, sanitized, falling back to clip_<code>.wav).
    New dialplan_clip_get_filename() looks up a single entry's filename by
    code without needing the caller to pull the whole clip table into a
    local array first.
    Two more bugs in the same "large stack local" family as the earlier
    multipart-buffer stack over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
2026-07-22 Add VoIP config form and Asterisk server-script generator
    Settings -> VOIP was read-only status before (server string, per-line
    registration pill), with a comment flagging "a web form for this is a
    TODO". Now has: a form (server host, per-line extension/username/
    password) that calls the already-existing voip_set_config(), and a
    "Download Asterisk server setup script" link generating a bash script
    that adds this phone's line(s) as SIP peers on an Asterisk/PBX box --
    marker-tagged blocks (named after the board) so re-running it only
    replaces this phone's own pjsip.conf/extensions.conf entries, safe to
    run alongside other phones' scripts on the same server. Modeled on the
    sibling pi_rotary_pho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
2026-07-22 Add optional MP3 upload support (trial) + finish docs for this session's work
    Vendors minimp3 (CC0, third_party-style under audio_convert/minimp3/)
    behind a new CONFIG_AUDIO_CONVERT_MP3 Kconfig option, off by default.
    When enabled, Settings -> Operator / Dial Codes accept .mp3 uploads
    directly from the browser (magic-byte sniffed), decoded frame-by-frame
    through a rolling compressed-bytes buffer and fed through the same
    normalize/downmix/LPF/resample pipeline WAV uploads use -- no whole-file
    buffering.
    This was explicitly a size/feasibility trial, and the real finding
    isn't the flash cost (a modest ~23KB) -- it's the RAM cost. minimp3's
    mp3dec_decode_frame() declares a ~16KB local (its inte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
2026-07-22 Add per-language call-progress tones; extract dial-code defaults to a config file
    Dial/ringback/busy tones were hardcoded to North American frequencies
    regardless of the board's language setting. Added a per-language region
    table (tones/tone_regions.h, builder-editable) covering US (default),
    Italy, Germany, France, Japan, China, and Spain, sourced from ITU
    Operational Bulletin No. 781's country-by-country tone annex (not
    guessed) -- with a generic ITU-T European default as the fallback for
    any other language code. Required generalizing the cadence model from a
    fixed on/off duty cycle to an arbitrary alternating phase-length
    sequence (tone_cadence_t), since e.g. Italy's dial tone is a distin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
2026-07-26 Add logging control, test-mode injection/loopback, and a DVT harness
    Code review (Phase 0): whole-stack pass with cppcheck (clean) + manual
    review of the timing-critical paths. One correctness fix: telephony now
    services only BOARD_NUM_LINES real lines and drops events for the phantom
    line, so on a 1-line board an inbound VoIP call to the 2nd extension can't
    leave a line stuck "ringing" a handset that isn't there. Array stays
    2-wide (matches the codec's stereo pair) so there's no out-of-bounds risk.
    Logging (Phase 1): new logctl component -- an NVS-persisted global log
    level, settable from Settings -> Diagnostics (dropdown) or the console
    (log_level cmd), applied at boot. Raised CONFIG_LOG_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
2026-07-26 Disable WiFi modem power-save; make DVT harness use curl
    Root-caused the intermittent "board unreachable" flakiness that recurred
    throughout development: WiFi was left at the ESP-IDF default
    WIFI_PS_MIN_MODEM, so the radio slept between DTIM beacons -- giving
    ~108 ms ping latency, high jitter, and periodic EHOSTUNREACH dropouts
    under load. For an always-on, mains-powered gateway whose job is to
    serve a web UI (and later carry VoIP RTP), that's the wrong tradeoff.
    esp_wifi_set_ps(WIFI_PS_NONE) after start drops latency to ~11 ms with
    0% loss.
    verify.py now shells out to curl for HTTP instead of using Python
    sockets: on macOS the Local Network privacy permission blocks the
    Python interpreter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
2026-08-01 Add copy-to-clipboard button to the web UI's Recent log panel
    Makes it easy to grab the full log for pasting elsewhere without
    manually selecting text; falls back to execCommand since the page is
    normally loaded over plain http://<name>.local (not a secure context).
2026-08-01 Fix HTTP 431 on VoIP settings save; make DVT harness restore VoIP config
    Real browsers add enough headers (Origin, Sec-Fetch-*, Sec-Ch-Ua, a long
    User-Agent) to a POST that the default 512-byte header scratch buffer
    overflowed, rejecting /voip_set with "Header fields too long" and
    leaving the SIP server stuck on whatever was last saved. Bump
    CONFIG_HTTPD_MAX_REQ_HDR_LEN to 1536.
    Also expose the persisted (non-secret) VoIP server/user config on
    /api/status so the DVT harness's voip_config_script test -- which
    writes a dummy "dvt.local"/"1000" straight to the live device's NVS to
    exercise the config-save path -- can snapshot it beforehand and put it
    back afterward instead of leaving the phone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
2026-08-01 Archive record+callback (212-215); wire up dial-plan clip audio; timestamp and play/delete recordings
    Three related changes to the telephony/audio/web-UI stack:
    Archive record + callback (dial 212-215): low usage didn't justify the FSM
    complexity (rec_callback/rec_fx fields, a cb_*.wav transient with its own
    eviction carve-out, a dedicated Settings tab). Code is preserved at the
    archive/record-and-callback git tag; see FEATURES.md "Archived features"
    for how it worked and exactly what to restore to revive it. 211 (leave a
    message) is untouched.
    Wire up the 4xx dial-plan clips: dialplan_defaults.h already pointed each
    code at a filename (ring_of_fire.wav, burp.wav, ...) but the WAVs
    themsel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
2026-08-01 Add VoIP number-availability check; fix Asterisk script extensions.conf bug; add VOIP_SETUP.md
    Settings -> VOIP gets a "Check availability" box: fires a standalone SIP
    OPTIONS at a candidate number (voip_probe_number() in voip.c, its own
    throwaway socket, safe to call before VoIP is even configured) and reports
    back. Only a clean 404 counts as "free" -- tested live against a real
    Asterisk/PJSIP server, an unrecognized number gets the same 401
    auth-challenge a real endpoint with the wrong password would, so anything
    short of 404 is reported as not-confirmed rather than guessing. The UI
    copy says so explicitly instead of overselling it.
    Also fixes a latent bug in the generated Asterisk setup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
2026-08-01 Add FreePBX auto-provisioning: voip_provisioner companion service + web UI
    feynman.local moved from plain Asterisk to FreePBX (Docker), which owns
    pjsip.conf/extensions.conf and regenerates them from its own database --
    the existing marker-tagged-script approach (safe for plain Asterisk)
    doesn't survive that. voip_provisioner/ is a small companion service that
    runs on the FreePBX Docker host (not this device) and creates an extension
    via FreePBX's own Core::processQuickCreate() -- the same call its GUI
    "Quick Create" and GraphQL API both use -- when asked over a password-gated
    HTTP endpoint. Verified end-to-end against the real server: create,
    duplicate-detect, and the authoritative database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
2026-08-01 Switch voip_provisioner to native Asterisk, retiring FreePBX
    FreePBX added Docker/PHP/OAuth2/GraphQL overhead this project doesn't
    need now that feynman.local runs plain Asterisk. Rewrite provisioner.py
    to edit pjsip.conf/extensions.conf directly (marker-tagged blocks,
    same idempotent technique used elsewhere) and reload via
    `asterisk -rx`, dropping add_extension.php entirely. Same wire
    protocol, so the ESP32 firmware needed no changes beyond updating the
    manual-fallback instructions in the VOIP tab.
    Fixes a real corruption risk found during local testing: the original
    existence check only looked for this tool's own `; BEGIN` marker,
    which would have reported the server's pre-existing 101-1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
2026-08-01 Add bare local-extension dialing; deploy provisioner under /opt
    Numbers on the new native-Asterisk registry (105+) are 2-6 digits, not
    the fixed 7-digit 555-xxxx scheme the dial plan only supported before.
    Add a second VoIP pattern to dialplan.c: any buffer starting with '1'
    is treated as a local extension and dialed on interdigit timeout
    (variable length, same as any other ambiguous/prefix code), while
    555-xxxx keeps working unchanged for a remote/legacy PBX. Also reject
    custom clip dial-codes starting with '1' in code_conflicts_except(),
    since that prefix is now claimed the same way '555' already was.
    webui.c's VOIP tab and Dial Guide still described the FreePBX
    quickstart/555-only flow f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
2026-08-01 Revert bare local-extension dialing; back to 555-xxxx only
    Real-hardware testing (dialing on the actual rotary phone in DTMF/tone
    mode) surfaced a genuine dial-plan bug: dialing just the leading '1'
    and pausing fell through dialplan_timeout()'s fallback case straight
    to ACT_WRONG_NUMBER (the len>=2 guard meant to fire the call on pause
    didn't have a matching "still waiting" case for len==1), producing an
    audible error tone after the very first digit -- unusable in practice.
    Rather than patch the timeout gap, revert to the original,
    already-proven 555+4-digit scheme: fixed length, fires the instant the
    7th digit lands, no ambiguous-pause resolution needed at all. Simpler
    and known to work.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
2026-08-01 DTMF: add same-digit lockout for real keypad chatter; quiet esp_netif_lwip
    Live testing on the actual tone-dial phone kept registering doubled
    digits ("5" dialed 3 times decoded as 6-7 fives). Debug logs showed
    genuine ~50-440ms gaps between the repeats -- too long to be Goertzel
    block noise, consistent with real contact bounce or a keypad's own
    auto-repeat on a held button actually re-sending the DTMF burst. The
    detector's existing debounce only asked "was there a brief quiet gap",
    which a real bounce/repeat still satisfies.
    Decoupled the two questions dtmf_detector_push() needs answered:
    in_tone/silence_blocks (unchanged, ~50ms) still tracks "is a tone
    active right now", so a genuinely *d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
2026-08-01 Fix DTMF Goertzel block size: 852Hz/941Hz shared one bin
    Explains why '7'/'8'/'9' and '*'/'0'/'#' all failed to register
    (confirmed by testing every key): the detector used 10ms blocks
    (100Hz bin spacing), but DTMF rows 852Hz and 941Hz are only 89Hz
    apart -- both rounded to the *same* Goertzel bin, so their computed
    magnitudes were always identical. classify()'s own dominance check
    (the chosen row must clearly beat the others) then rejected every
    such tie as noise, silently dropping the whole row-3/row-4 half of
    the keypad against each other.
    Fixed by switching to 205 samples @ 8kHz (~25.6ms, ~39Hz bins) --
    the standard Bellcore/ITU-T DTMF Goertzel block size, chosen
    specifically to resolve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
2026-08-02 Fix VoIP CANCEL/re-INVITE bugs; add caller ID; list registered lines
    voip_hangup() sent BYE for a still-ringing outbound call (CALL_OUTGOING),
    but BYE only applies to an answered dialog -- with no to_tag yet, it
    produced a malformed request Asterisk couldn't match to anything, so
    hanging up before the callee answered left them ringing until they
    picked up or timed out. Added send_cancel() (reuses the INVITE's own
    branch/CSeq per RFC 3261 SS9.1, unlike BYE which is a new transaction)
    and use it for the CALL_OUTGOING case.
    Also fixed the mid-call re-INVITE bug from last session properly: any
    INVITE was matched by ruri_user/CALL_IDLE state before checking whether
    its Call-ID belonged to an alr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
2026-08-02 Fix web UI audio playback: HTTP Range support was missing entirely
    "Play" in the web UI always errored. Root cause: browsers' <audio>
    elements routinely probe with a Range request before they'll attempt
    playback at all, and media_handler ignored Range headers completely,
    always answering 200 with the full file -- confirmed via curl (a plain
    GET returned a perfectly valid WAV, same request with a Range header
    still came back 200/whole-file instead of 206). Several browsers
    (Safari especially) refuse to play at all without a proper 206.
    media_handler now parses "Range: bytes=X-Y"/"bytes=X-", answers 206
    Partial Content with Content-Range when present (416 if unsatisfiable),
    advertises Accept-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
2026-08-02 Add echopulse: timestamped periodic test tone for echo-path debugging
    Diagnosing a 500-750ms echo on VoIP calls (both boards, all near the
    router, so not WiFi) needs a known, precisely-timed reference signal
    rather than judging delay by ear in a live conversation. echopulse
    <line> <on|off> [period_ms] plays a 1kHz/150ms burst on a fixed
    period, logging esp_timer_get_time() for each one -- correlate against
    an oscilloscope on the codec output (or the mic/ADC input, if there's
    a second probe point) or just listen for a delayed, quieter repeat of
    the pulse to measure the echo path length directly.
    Deliberately goes out through the real DAC -> codec -> SLIC path
    (reusing audio_tx_burst(), same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
2026-08-03 Document the echopulse echo-debugging procedure
    Standalone doc (not just the command's own help text) covering what's
    already been ruled out for the 500-750ms VoIP echo (WiFi, RTP jitter
    buffer, internal audio stream buffers, I2S DMA depth) and the two-test
    procedure (local oscilloscope-only, then over a real call) for
    pinpointing it before deciding whether a line vs. acoustic-scale echo
    canceller is actually needed.
2026-08-03 Add ROTARY_PHONE_SMD3.md: delta doc vs SMD2, DevKit+Pi header plan
    New spin switches from a hand-soldered WROOM-1 module to a complete
    ESP32-C6-DevKit (own USB-C/reset/onboard LDO), adds a DC jack as an
    alternate 5V input, and adds a Raspberry Pi 40-pin header as an
    alternative main driver to the ESP32 (one or the other, not both).
    Structured as a delta from ROTARY_PHONE_SMD.md rather than duplicating
    it, per the project's stated intent to track each board revision's
    differences separately.
    Worked out the actual Pi-header pin constraints: I2S0 (audio samples,
    not just I2C control) is fixed-position on the Pi same as I2C1/SPI0,
    and matters more than I2C for this design since without it a po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
2026-08-03 SMD3 doc: resolve UART question, confirm open-hardware either/or intent
    Confirmed with the designer: ESP32 and Pi are never both populated --
    this is meant to be an open-hardware board released with either driver
    as an option, not a dual-driver product. No cross-wiring needed between
    Pi UART0 and ESP32 UART pins; instead, give the Pi build its own
    optional debug break-out header (independent implementation, same idea
    as the ESP32 side's existing J3/J4) for parity between the two options.
2026-08-04 SMD3 doc: drop Raspberry Pi header option, ESP32-only
    Decided against the dual-driver (ESP32-DevKit or Pi) design due to
    complexity -- SMD3 is ESP32-only. Removed the Pi header section, the
    Pi-specific power/ground table, and the Pi-related open questions;
    left a pointer to git history for the pin-mapping research in case a
    future spin revisits it. Confirmed the barrel-jack diode is the
    originally-planned Schottky in series (isolation) -- "zener" in the
    prior message was a naming slip, not a design change.
2026-08-15 Add spkamp and echosweep for tomorrow's echo test
    spkamp <line> <left 0-63> <right 0-63>: live ES8388 earpiece drive
    level (LOUT1VOL/ROUT1VOL), mirroring the existing micamp (mic PGA
    gain) command. Lets you dial gain down mid-call and see whether an
    active echo weakens, without ending the call -- direct test of the
    "our levels are louder than a normal phone, so a handset's own
    mic->earpiece feed-through becomes audible" theory.
    echosweep <line> <on|off> [period_ms]: like echopulse but cycles
    through 9 tones spanning classic telephone bandwidth (300-3400Hz)
    instead of a fixed 1kHz burst. echopulse's single frequency didn't
    reliably reproduce the echo that real speech did -- a handset's
    acous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
2026-08-15 Add ECHO_REDUCTION_TESTS.md: today's test log + POTS loudness reference
    Live-tracking doc for the 6 tests planned today (reproduce, handset
    geometry, physical-vs-Linphone, live gain tuning, tone sweep, capture
    for delay measurement) -- results filled in as Scott runs each one.
    Includes sourced reference values (TIA-810/920 SLR=8+/-3dB,
    RLR=2+/-3dB per ITU-T P.79; G.712's -10dBm0/1020Hz test convention)
    and the standard-practice rationale for tuning speaker gain for
    comfort first, then mic gain as the primary echo-control lever (it's
    the one adjustment that doesn't change what the local user hears).
2026-08-15 Fix VoIP registration going permanently stale on a single lost packet
    Found live: MaxPhone showed "registered" in its own web UI after 35
    minutes up, but Asterisk answered a real call attempt with 404 Not
    Found -- it had no live contact for that extension at all.
    Root cause: REGISTER's 401-challenge/authenticated-retry exchange is
    two UDP round trips with no reliability of its own, and
    reg_refresh_at_us (the periodic re-registration timer) was only ever
    armed by handle_response()'s 200 OK case. If any single packet in that
    exchange was lost -- the initial REGISTER, the 401, the authenticated
    retry, or the final 200 OK -- reg_refresh_at_us stayed 0 forever, so
    no future refresh was ever sche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
2026-08-15 gitignore: cover per-board build.* directories
    Set up separate build dirs (build.maxphone, build.dualphone) with
    their own SDKCONFIG each, so switching between the two SMD2 board
    variants (1-line+SD vs 2-line+no-SD) no longer means hand-editing the
    shared sdkconfig and occasionally needing a fullclean after a stale
    Kconfig-triggered linker error. The existing firmware/build/ ignore
    rule didn't cover these; widened it. sdkconfig.maxphone/sdkconfig.dualphone
    themselves stay untracked, same as the base sdkconfig already was
    throughout this project.
2026-08-16 Runtime board config, three bug fixes, off-hook alert tone
    One firmware image now runs both SMD2 variants. CONFIG_BOARD_NUM_LINES /
    CONFIG_BOARD_MICROSD are gone; the line-2-vs-microSD choice on the shared
    GPIO18-21 pads is an NVS setting (board_hw_config_*) confirmed by a human
    in Settings -> Hardware. It defaults to the safe combination (1 line, no
    SD) rather than guessing, because a wrong guess drives real GPIO as the
    wrong peripheral -- the line-2 side carries SLIC control signals. An
    advisory passive pin read is offered as evidence, never acted on, and is
    refused once a config is confirmed so it can't glitch a live peripheral.
    Bug fixes found while bench testing:
    - A canceled/unanswer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
2026-08-16 Add NLMS echo canceller (off by default)
    `echoprobe` on real hardware settled the design question. MaxPhone measured
    the leak arriving 36.3 ms after playout at +25 dB over noise, with only
    ~9.2 ms of ringing after that; DualPhone put its peak at 41.2 ms (buried in
    a 4.5x higher noise floor, so flagged inconclusive -- but two independent
    boards agreeing on arrival time is itself evidence the path is real).
    That splits the problem in two. The 36-41 ms is dominated by fixed I2S DMA
    buffering -- a constant integer sample offset, not something an adaptive
    filter should spend taps on -- so it is compensated separately and the
    adaptive part only covers the ~9 ms tail plus margin. 192 taps at 8 kHz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
2026-08-17 Add 'aec sweep' -- auto-search the bulk delay against live ERLE
    echoprobe's bulk-delay measurement turned out not to be directly usable as
    'aec delay': it timestamps end-to-end (console command -> burst -> captured
    echo), while the canceller pairs ref/near samples that are already sitting
    together within one audio_task iteration -- a different reference point
    with its own frame-level offset echoprobe never saw. Confirmed live on
    real hardware: echoprobe measured 36ms, but 'aec delay 36' measured worse
    (0-3dB ERLE) than the default 28ms (10dB).
    So: search empirically against the canceller's own ERLE instead of
    trusting the hardware measurement. Coarse pass in 4ms steps across the
    full range,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
2026-08-18 Widen AEC to 320 taps -- two real echo paths, not sweep noise
    'aec sweep' run live against a real call found two separate, reproducible
    ERLE peaks (~20ms and ~36ms), not a single clean maximum -- confirmed by
    running it twice on the same call and getting the same two-peak shape
    both times. That pattern means two distinct leak paths landing at
    different delays (plausibly an electrical leak arriving sooner, and the
    acoustic earpiece->mic leak echoprobe characterized arriving later), both
    real, both contributing echo.
    At 192 taps (24ms) the filter was narrower than the ~16ms gap between
    them, so it could only capture whichever one the anchor favored -- capping
    ERLE around 10-16dB instead of ca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
2026-08-18 Console prompt shows the board's own name, lowercased
    Was a hardcoded 'phone>' regardless of which board -- unhelpful once
    you're juggling two boards' monitor sessions side by side and the log
    you're reading doesn't say which one it's from.
2026-08-18 Wire up microSD as a real storage backend, priority over internal flash
    storage_using_sd() has returned hardcoded false since this file's own doc
    comment first described the seam for it: "when a microSD backend exists,
    this is where to swap it in." It exists now.
    New recordings/uploads go to the SD card when one's mounted -- no code
    changes needed in existing callers (recorder.c, dialplan clip playback,
    the web UI), since the whole plain API (storage_write*, storage_read*,
    storage_list, storage_used_bytes, storage_cap_bytes) now resolves to
    whichever backend is PRIMARY: SD when present, internal flash otherwise.
    storage_using_sd() reports which.
    Two behavioral differences from internal fla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
2026-08-18 Add on-the-fly prompt generation for 211 record message + operator/dial codes
    New `prompts` component tracks per-clip desired text (NVS blob, mirrors
    dialplan.c's clip-table pattern) so Settings -> Operator/Record/Dial Codes
    can each carry a "spoken prompt text" field next to the setting it belongs
    to. gen_prompt.py --sync fetches pending text from the board
    (GET /api/prompt_requests, gated by the same setup password as the VOIP
    auto-provisioner) and generates + uploads audio locally via Piper/espeak-ng
    (macOS `say` demoted to an explicit --engine fallback) -- no server
    dependency, so a board on someone else's Asterisk install doesn't need
    access to any shared infrastructure to build its own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
2026-08-18 Keep prompts/clips on internal flash regardless of microSD presence
    storage_write_begin() treats SD as primary for everything when a card is
    mounted, including prompt/clip uploads (operator.wav, dial-code clips,
    record_prompt.wav) -- fine for recordings (the card is for archiving those),
    but means pulling the card mid-use could take dial tone, the operator
    message, or 211's prompt/beep with it, since those live wherever the last
    write happened to land.
    New storage_write_begin_local() forces internal flash regardless of SD
    presence; the three webui.c upload paths (generic /media/<name>, the
    MP3/WAV conversion helper, and their shared convert_upload_part()) now use
    it. recorder.c's actual 211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
2026-08-19 Tighten DTMF twist ratio to fix a live false-positive; shrink I2S DMA ring
    DTMF: the classifier's twist check (row/col energy ratio) allowed up to
    8x either direction -- ~18dB, far looser than real DTMF ever needs (a
    few dB per spec). Loose enough that a real, reproducible false trigger
    made it through: live-captured line noise around 770Hz (the '4'/'5'/'6'/'B'
    row) consistently dominated its column axis by 4.1-7.7x, comfortably under
    8x, corrupting real dialing while off-hook (gating detection on off-hook,
    from an earlier fix, stops the on-hook log spam this same noise caused but
    doesn't stop it from firing while off-hook, which is exactly when dialing
    happens). Tightened to 3x -- clears ev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
2026-08-19 Document ES8388 DTMF clipping investigation + divider recommendation
    New HARDWARE_SIGNAL_LEVELS.md §1B covers the SMD2/SMD3 board (ES8388 +
    AG1171), parallel to the existing WM8731/AG1170 section: datasheet specs
    (1.0 Vrms full scale, 20kOhm input impedance), live-measured scope levels
    (dial tone vs. a clipping real DTMF press), why micamp alone can't fix it,
    and a starting-point divider value + placement rationale (after the
    coupling cap, shunt resistor after the series resistor -- not before).
    Also adds a pdftotext extraction of ES8388.pdf (datasheets/) matching the
    existing *_extracted.txt convention for the other datasheets, and flags
    the divider footprint as a from-scratch layout item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
2026-08-20 Confirm ES8388 DTMF divider fix working on DualPhone
    10K/8.2K (8.2K chosen over 6.8K for voice SNR margin, both were safely
    under the clipping ceiling on paper) built and verified via tonemon: all
    12 keys classify correctly, peak= roughly half of full scale, twist
    ratios tightened to ~0.6-1.2 (vs. 0.4-400+ while clipping). Holds at the
    codec's normal +3dB boot-default gain, not just the 0dB used to isolate
    the problem during diagnosis -- micamp isn't NVS-persisted so that
    distinction matters. MaxPhone rework still pending.
2026-08-21 Loosen row0/row1 DTMF dominance check for a handset-specific quirk
    DualPhone's physical handset produces real, simultaneous energy at both
    697Hz and 770Hz specifically when '3' or '6' is pressed -- confirmed not
    a board/firmware issue: synthetic dtmf_gen tones for the same digits are
    perfectly clean via digital loopback (bypasses codec+SLIC entirely), so
    it's the handset's keypad/encoder, not anything downstream. Live data
    across many real presses showed the correct row reliably 20-90% louder
    than the companion, just never near the 4x/75% separation the dominance
    check demands -- so this was a real signal the strict check was simply
    too tight for, not noise sneaking through.
    Row0/row1 (only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
2026-08-21 Add AGC to DTMF detector, simplify twist to a single limit
    Normalizes captured signal peak toward a consistent target before
    Goertzel analysis, so detection doesn't need per-phone amplitude
    tuning. Also lets the loudness-tiered twist check (3x quiet / 8x loud,
    added earlier to tolerate ADC-clipping-distorted twist) collapse back
    to a flat 3x -- clipping is now fixed at the analog level (voltage
    divider) and AGC keeps levels predictable on top of that, so the wide
    loud-tier tolerance is no longer needed. Verified live via tonemon on
    DualPhone: all 12 keys (0-9, *, #) classify correctly, including 3/6,
    with AGC gain converging smoothly and peaks staying well clear of
    clipping.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
2026-08-22 Drop ES8388 mic PGA boot default from +3dB to 0dB: fixes near-silent voice on the divider line
    Once the SLIC->codec voltage divider was in place (10K/8.2K, added to stop
    DTMF clipping), normal speech read near-zero RMS while DTMF still
    classified fine through the same path -- a "tone dialing works, voice
    doesn't" split traced to the ES8388's mic PGA input impedance dropping as
    its gain register increases. The divider was designed against the
    datasheet's static ~20k input impedance figure, which only holds at 0dB;
    at +3dB and up, the real impedance collapses enough to swamp the divider's
    8.2K shunt, so the fixed 10K series resistor drops most of the signal
    before the ADC ever sees it. DTMF su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
2026-08-22 Disable AEC on hangup: it was running unbounded outside calls, and that hid a real crash
    aec_set_enabled() is only ever called by hand from the bring-up console
    (`aec on`/`aec sweep`), and nothing ever turned it back off -- once
    enabled, audio_task kept running aec_process() on every frame forever,
    call or no call. enter_idle() is the single choke point every hangup path
    (on-hook, remote BYE, peer hangup, VOIP_CLOSED) funnels through, so it's
    the one place that reliably catches all of them.
    Found via a live watchdog panic: ran `aec sweep` on MaxPhone, the call
    ended (BYE) right as the sweep finished with AEC left enabled, and the
    board wedged into a permanent ~5s watchdog retrigger loop wit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
2026-08-22 AEC: persist bulk delay per device, expand echoprobe, stop auto-disabling on hangup
    - echoprobe gains an optional repeat count (echoprobe [line] [# repeats]):
    runs the probe N times with a settle gap between runs and reports
    aggregate min/max/mean delay and tail plus how many runs actually
    detected a leak, so a single noisy capture can't be mistaken for a real
    (or absent) echo. Single-run mode also gains a 5ms-bucket RMS envelope
    plot to see the actual return shape, not just the summary numbers.
    - AEC's bulk delay is now a per-device, NVS-persisted setting
    (board_aec_delay_get/set in board.c) instead of a single compiled
    constant -- one firmware image runs on every SMD2 board,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
2026-08-22 Document local echo (AEC) timing characterization: no AEC_TAPS increase needed
    Systematic echoprobe measurements (repeat mode, both boards, three handset
    positions each: against ear, face-down on desk, face-up on desk) show the
    real, repeatable local echo path is ~30-36ms total (bulk delay + tail) on
    both boards in every position -- comfortably inside the current 320-tap/
    40ms AEC filter. This supersedes an earlier single, uncontrolled ~380ms
    tail measurement on DualPhone, traced to a room-acoustics artifact of
    testing with the earpiece open to the room rather than a real property of
    the board or handset. One genuine anomaly (an intermittent, low-amplitude,
    non-reproducible long-tail room re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
2026-08-22 Add webui speaker volume slider and echo cancellation calibration wizard
    Two persisted, webui-accessible settings for a public release where users
    won't have serial console access:
    - Speaker (earpiece) volume: board_speaker_volume_get/set (NVS, per line),
    loaded at es8388 boot instead of the old hardcoded 0x1E/0x1E. Console
    `spkamp` now persists on set too (previously live-only, like micamp).
    Webui gets a range slider per line under Settings -> Diagnostics: dragging
    applies live via a small fetch()-based POST (no page reload, so you can
    adjust while listening on a real call), a separate Save button persists.
    - Echo cancellation calibration wizard: a "Measure" button runs 3 quick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
2026-08-23 Fix storage_delete/read silently failing on internal-flash files via broken access()
    resolve_existing_path() used access(path, F_OK) to confirm a file exists
    before deleting/reading it. That failed for files that plainly existed --
    confirmed live: /media/clip_7.wav 500'd and clip_6.wav's delete silently
    no-op'd (both logged "not found"), even though the exact same file was
    correctly listed on the settings page moments earlier via list_dir(),
    which relies on stat() succeeding on that same path. Swapped access() for
    stat() (path_exists()) -- list_dir() already proved stat() works reliably
    on this SPIFFS mount; access() apparently doesn't. Fixed reads and deletes
    for every affected file immedia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
2026-08-23 Add automated audio-quality (dropout) test: downlink tap + tone-clip gen/analyze scripts
    For checking whether the DMA ring tightening (or anything else in the
    audio path) introduced real dropouts, rather than guessing from how a call
    sounds:
    - New downlink tap (audio_add_downlink_tap/_remove, audio.c/h): observes
    exactly what's about to be played on a line -- decoded network audio for
    a call, before it reaches the DAC -- independent of test_loopback and
    the uplink-side taps, which all observe the opposite (mic) direction.
    Zero acoustic path, so it isolates network/decode/DMA quality from room
    noise/echo. `record_downlink <ms> [line]` (bringup console) captures it
    to a WAV, same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
2026-08-23 Fix player_play() 404ing every clip once an SD card is mounted
    Its existence pre-check called storage_list() (whichever ONE writable
    backend -- SD or internal -- is currently active) instead of using the
    same fallback storage_read_open() itself relies on (SD, then internal,
    then bundled). Clips/prompts always live on internal flash by design,
    specifically so they survive an SD card being inserted/removed -- so the
    moment any SD card was mounted, this check looked in the one place a clip
    is guaranteed not to be, and rejected it before storage_read_open() ever
    got a chance to prove it was readable fine.
    Found live: MaxPhone rebooted mid-session (cause TBD, first time it had
    booted with an SD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
2026-08-23 Run record/record_downlink in the background instead of blocking the console
    Both used to run their whole capture duration directly on the console REPL
    task, so the console couldn't accept ANY input -- not even Enter -- until
    the capture finished. Fine for a standalone `record`, but a hard blocker
    for the audio-quality-test workflow this session built record_downlink
    for: `record_downlink` then `play`, both typed on the SAME board's console,
    back to back. Confirmed live: the console was completely unresponsive for
    the full 20s, so `play` could never be typed in time.
    Both commands now spawn record_capture() on its own task and return
    immediately; the "saved ..." (or failure) message still p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
2026-08-25 Switch log timestamps to SNTP-synced wall clock instead of boot-relative ms
    CONFIG_LOG_TIMESTAMP_SOURCE_SYSTEM (ESP-IDF's own Kconfig option) instead
    of the default RTOS/tick-based source. Log lines now read "HH:MM:SS.mmm"
    (UTC, synced once SNTP completes -- same convention as
    record_name_timestamped()'s filenames) instead of milliseconds since boot.
    Motivated by this session's audio-quality testing: correlating DualPhone's
    and MaxPhone's logs for the same real-world event required manually
    computing each board's boot epoch from its uptime_s and converting every
    boot-relative timestamp by hand. Real timestamps make that unnecessary.
    Binary blobs (WiFi/BT libs) still print boot-relative rega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
2026-08-25 Fix httpd worker task stack overflow on Dial Codes tab with an SD card mounted
    8KB was sized (per the existing comment above this block) for SPIFFS-only
    traversal. append_dialcodes_tab() calls append_file_select() once per row
    plus once more for the "add" form, and each call puts storage_entry_t
    files[32]+bundled[16] (~2KB) on the stack on top of settings_page_handler()'s
    and append_dialcodes_tab()'s own locals. Confirmed live: reliably crashed/
    rebooted MaxPhone (has a microSD card mounted, so storage_list() there hits
    FATFS/SDMMC) on every request, while the identical request against DualPhone
    (no card, SPIFFS only) worked fine. FATFS/SDMMC is a known heavier stack
    consumer than SPIFFS in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
2026-08-25 Dial-code audio players, operator default prompt, and 211 record-message duration + ending beeps
    Dial Codes tab drops the per-row spoken-prompt editor (never applied to
    played clips) and gets an inline audio player per row instead, matching
    Storage/Recordings. Operator tab's prompt-text box now pre-fills with a
    sensible default greeting instead of starting blank. 211's record-message
    max duration is now settable from Settings -> Record message (persisted
    via NVS, 5-120s, defaulting to 30s) instead of a hardcoded 30s. When a
    recording hits its max duration while the caller's still on the line, it
    now plays three escalating beeps (TONE_RECORD_END_1/2/3, 900Hz, rising
    amplitude and shrinking ga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
2026-08-26 Operator/Record prompt fields: render a ready-to-paste gen_prompt.py --sync command
    Each "Spoken prompt text" box now shows an exact, copy-pasteable command
    line (device IP + the real VOIP auto-provisioner secret + --only
    <this clip>) instead of the generic "gen_prompt.py --sync HOST --secret
    ..." placeholder, so generating audio for a specific prompt no longer
    means hunting down setup_password.txt or the board's IP by hand. Only
    shown once a VOIP auto-provisioning password is actually set (Settings ->
    VOIP) -- otherwise falls back to the old generic hint plus a pointer to
    set one.
    The secret appears in plaintext here on purpose, unlike its masked
    display on the VOIP tab: anyone who can loa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
2026-08-26 /api/prompt_requests: skip the setup-password check for same-LAN callers
    gen_prompt.py --sync no longer needs --secret when it's running on the
    same subnet as the board -- prompt_requests_json_handler() now checks the
    caller's peer IP against the board's own WiFi-STA IP/netmask
    (peer_on_lan(), webui.c) and only falls back to requiring the VOIP
    auto-provisioner's setup password when that check fails (a genuinely
    different network -- VPN, port-forward, a remotely-hosted board). This
    matches the rest of the web UI, which already has zero auth for anything
    on the LAN; gating just this one endpoint bought nothing once the
    settings pages themselves already show this same prompt text without a
    pass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
2026-08-26 Add MP3 playback support for full-length clips; retire dead banana/lime dial codes
    Storage problem: the pi_rotary_phone song clips (Ring of Fire, Martians,
    Crocodile Rock) were trimmed to 20s because full-length versions as raw
    8kHz/16-bit PCM WAV run 2-3MB each -- more than fits in the few MB of
    flash these devices have for all clips/recordings combined. Rather than
    grow the storage partition (which would've meant reformatting it, wiping
    existing recordings), the fix is a compressed on-device format: MP3 at a
    low mono bitrate is 3-4x smaller for the same audio.
    - New CONFIG_PLAYER_MP3 (player/Kconfig): player.c can now stream-decode
    MP3 files at playback time (minimp3, reusing the same d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
2026-08-26 Full-length MP3 for Ring of Fire/Martians/Crocodile Rock; editable dial-code labels
    Converted the three trimmed song clips to full-length MP3 (40kbps mono):
    Ring of Fire 154s/~750KB, Martians 172s/~863KB, Crocodile Rock 125s/~628KB
    (Italian "Crocfa" dub -- no English source audio exists in this checkout).
    Combined they don't fit in the 2MB bundled partition alongside everything
    else already there, so they live on the writable storage partition
    instead (6MB, plenty of room) as a per-board upload+repoint rather than a
    firmware default -- the original short WAV versions stay bundled
    unchanged, so a board nobody's done this on still works out of the box.
    Uploaded and wired up live on MaxPhone (4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
2026-08-28 211 recording: proper answering-machine beep, more forgiving silence cutoff
    Two live-reported problems on the same call flow: leaving a message cut
    off after only ~5s of actual talking (not staying silent), and the beep
    before recording started didn't sound like an answering machine.
    - Trailing-silence auto-stop was 2000ms -- long enough to clip a message
    on an ordinary mid-sentence pause. Bumped to 5000ms (telephony.c's
    start_recording()). Confirmed via a bench test: recording length now
    matches 1s grace + 5s silence exactly (was landing around 2-3s before).
    - Added TONE_ANSWERING_BEEP (tones.h/tones.c): a single continuous 1000Hz
    tone, ~600ms. start_record_beep() now uses it inste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
2026-08-31 SMD3 doc: confirmed pin map, ERC/DRC review, firmware TODO after re-route
    Reviewed the schematic/PCB after the recent pin permutation and re-route
    (kicad-cli sch erc / pcb drc against hardware/kicad/Rotary_phone_SMD3/),
    and traced the actual netlist rather than reading net labels at face
    value, since this board repeats SMD2's "net names don't agree with each
    other" trap (three different Line0/1/2 numbering schemes across the
    control-signal vs. Tip/Ring nets, same as SMD2's U5/U6 gotcha).
    Confirmed correct, not bugs:
    - Both carried-forward SMD2 fixes (SLIC Vin/Vout swap, per-line dedicated
    ADC channel) are actually wired correctly -- verified via the netlist,
    not just the schematic's vis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
2026-09-01 Add SMD4 board doc: 2-layer re-route of SMD3's unchanged schematic
    Confirmed via diff that Rotary_phone_SMD4.kicad_sch is electrically
    identical to SMD3's -- same nets, same pin assignments, same components.
    SMD4 is a from-scratch 2-layer PCB layout of that design (SMD3 was
    4-layer: F.Cu/In1.Cu/In2.Cu/B.Cu; SMD4 is F.Cu/B.Cu only), not a new
    circuit -- so this doc follows the same delta-doc pattern SMD3.md uses
    against SMD2.md, pointing back to SMD3's pin map/J5 mechanism/GPIO
    constraints rather than duplicating them.
    Ran the same kicad-cli ERC/DRC review as SMD3 got. Same PD/EN false
    positives (unchanged schematic, same AG1171-datasheet-recommended diode
    wiring). One new, tooling-only find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
2026-09-01 sdcard: optional card-detect (CD) pin support, ready for SMD4
    Adds sdcard_card_present(), gated on a board defining BOARD_SD_CD (no
    board does yet -- this is prep for SMD4's planned GPIO3 wiring, see the
    new section in hardware/ROTARY_PHONE_SMD4.md). Uses the ESP32-C6's
    internal ~45k weak pull-up (confirmed from the WROOM-1 datasheet already
    in datasheets/) rather than requiring an external resistor -- plenty for
    a slow mechanical switch. sdcard_init() checks it before touching the SPI
    bus at all, so a genuinely empty slot fails fast with a clear log line
    (ESP_ERR_NOT_FOUND) instead of a full mount attempt/timeout.
    Inert on every board that doesn't define BOARD_SD_CD (SMD2/THT, and SMD3
    unt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
2026-09-06 211 recording rework, activity log, ag1170 pulse-debounce fix, SMD4 board, public docs pass
    Firmware:
    - ag1170: require a minimum loop-open duration (pulse_break_min_ms=15) for a
    rotary pulse to count, not just a maximum -- fixes a ~3-5ms mechanical
    contact-bounce glitch occasionally being miscounted as an extra pulse
    (confirmed live: "211" misread as "212"/"322").
    - 211 recording: drop the escalating warning-beep sequence in favor of just
    ending the recording silently; default max length raised 30s -> 2min
    (still user-adjustable, capped at BOARD_RECORD_MAX_MS_MAX); recorder AGC
    with a per-block hard ceiling to stop a startup transient from clipping;
    8s trailing-silence auto-st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
2026-09-06 Settings menu cleanup: 9 tabs down to 5, archive stale root-level docs
    webui: consolidate Settings tabs -- Operator, Record message, and Dial
    Codes were each thin (mostly one prompt-text + audio-upload card) and now
    render together under "Dial Codes & Prompts"; Hardware (stats), the SMD
    line2/microSD config card, and the Storage file manager similarly merge
    into one "Hardware" tab instead of splitting "this board's physical
    resources" across two clicks. Inter-phone is dropped outright -- it only
    ever showed the 3xx dial codes read-only, which the Status page's Dial
    Guide already covers. Old ?tab=operator/record/storage links and POST
    redirects now land on the tab that absorbed their content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
2026-09-07 Add low-power idle mode: SLIC PD duty-cycling + VoIP-gated WiFi power-save
    New idle_power component: once every line has been on-hook past a
    configurable idle threshold (default 5 min, off by default), duty-cycles
    each SLIC's PD pin (100ms on / 250ms period -- AG1171 wake-up time + SHK
    debounce + margin, ~44% average SLIC power savings) via the existing
    ag1170_set_power(). Only when no VoIP server is configured, also drops
    WiFi into WIFI_PS_MIN_MODEM -- gated on "configured" rather than "currently
    registered" so a board with VoIP set up but momentarily unreachable never
    loses reachability for an incoming call. Any line leaving TEL_IDLE (a
    literal off-hook, a call, dialing, recording, ringing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
2026-09-07 Add answering machine (auto-answer, greeting, voicemail) + settings-tab cleanup
    Per line (Settings -> Hardware): enable, rings-before-answer (default 4,
    ~24s at this board's 2s-on/4s-off cadence), max caller-message length
    (default 30s), and -- 2-line boards only -- a separate "calls from other
    line" toggle for whether an unanswered local intercom call also gets
    auto-answered. Greeting is recorded over the phone (dial 212, reusing
    211's exact record-prompt/beep/record shape with a fixed per-line
    filename instead of a timestamped archive entry) and reviewed/replaced
    via the web UI's own <audio> playback rather than a phone-side confirm
    loop. A caller's message is capped the same way as 211 (s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
2026-09-10 Add SMD4 board support, WiFi setup UX (SSID scan, reset buttons, DHCP hostname)
    SMD4 bring-up:
    - New board_pins_smd4.h pin map (verified against schematic), Kconfig
    choice, and CMake/preprocessor fixes so es8388/wm8731 build correctly
    for the new board type alongside SMD2/THT.
    - Bringup script comment fixes (test_audio.py) for boards past the
    SMD2-only ADC mux bodge.
    WiFi/setup UX:
    - Live SSID scan (wifi_scan()) with a dropdown picker (+ manual-entry
    fallback) on both the captive setup page and Settings -> General,
    replacing free-text SSID entry.
    - Setup AP renamed RotaryPhone-XXXX -> AnalogRedial-XXXX.
    - DHCP hostname now set from the board name (was the generic
    "espressif" def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
2026-09-10 Add first-boot setup banner + auto-detect hardware config; UI fixes
    - board_hw_config_autodetect(): runs once at boot (before ag1170_init())
    on a fresh board, guessing line2-vs-microSD from the SD_CD card-detect
    pin (decisive, SMD4) and the existing SHK-divider heuristic as
    fallback -- so line 2/microSD actually works out of the box instead
    of sitting on the conservative 1-line/no-SD default until someone
    visits Settings. Deliberately does not mark the config as
    human-confirmed, so it still gets reviewed.
    - board_hw_config_is_set() now means "a human confirmed this" rather
    than "any value exists" (new hw_confirmed NVS flag) -- decoupled from
    hw_config_value_written(), the saf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
2026-09-10 webui: board name/hardware-type forms bounce back to Referer, not Settings
    board_name_handler and board_hw_set_handler always redirected to their
    Settings tab, which was fine when those forms only lived there -- but
    they now also appear on the Status page's first-boot banner
    (append_first_boot_banner()), so confirming one from there bounced you
    to Settings, and you'd have to navigate back to Status to fill in the
    other field. Both now use a new shared redirect_to_referer_or() helper
    (factored out of language_set_handler's/prompt_text_set_handler's
    existing Referer-bounce logic, now shared by all four) so submitting
    from the banner returns to Status, and submitting from Settings still
    returns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
2026-09-10 Add live memory-map card; fix board type display; simplify hw-config card
    - New Settings -> Hardware "Memory map" card: RAM used/free, and every
    flash partition actually in the live partition table (via
    esp_partition_find(), not a copy of partitions.csv baked into the
    UI) with real usage where available (storage/bundled file sizes, NVS
    entry stats) plus a plain answer to "would an 8MB flash chip fit
    this layout" using today's real numbers.
    - Fixed two real bugs found while building it: esp_partition_next()
    releases its iterator internally once it reaches the end of the
    list, so an extra esp_partition_iterator_release() call after the
    loop (and, worse, reusing the same iterato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
2026-09-10 Add upload_i18n.py to sideload language files at flash/setup time
    Reuses the existing generic /media/<name> upload endpoint (the same
    one gen_prompt.py --upload already uses for prompt/clip WAVs) to push
    a language's string table onto a board's storage partition -- no new
    firmware endpoint needed. Matches the "don't bundle every language
    into firmware" design in i18n.h: only whichever language(s) you
    actually sideload cost anything on a given board.
    media_upload_handler now skips prompts_mark_generated() for anything
    that isn't a .wav/.mp3, so uploading a JSON file through it doesn't
    leave a stray audio-prompt-tracking entry behind.
    The actual translated string tables (firmware/assets/i18n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
2026-09-10 Implement real i18n_str() runtime; convert nav/Status/General/Hardware to it
    i18n_str() now actually loads and looks up the current language's
    string table (POST-uploaded to storage via upload_i18n.py, one JSON
    file per language, cJSON-parsed, cached until the language changes),
    instead of always returning its English fallback.
    Converted a first complete, verified vertical slice of webui.c to call
    through it: the header/nav (every page), the language picker itself,
    the Status page (System card, Line cards, tagline), the first-boot
    banner, and Settings -> General and -> Hardware (including the new
    Memory map card, the Line 2/microSD config card, and the WiFi
    Reset/Re-provision card). Confirm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
2026-09-11 Convert remaining webui.c pages to i18n_str(); rewrite i18n storage engine
    Converted the rest of the pages not covered by the previous i18n pass:
    Speaker/Echo/Idle-power/Answering-machine cards, the WiFi captive-setup
    page, Dial Codes, Operator, Record message, Diagnostics (Logging +
    Test mode), the Storage tab (shared table renderer + section), the
    Recordings page, the settings tab bar, and the VOIP tab's top summary
    card (server/line registration status -- its detailed setup
    instructions and script generator stay English for now, deliberately
    out of scope: advanced/sysadmin content, lower priority than the
    everyday-use surfaces).
    Found and fixed a second real bug while testing this agains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
2026-09-11 Auto-reload Recordings/Answering-machine pages after a recording ends; fix misleading idle-power error
    - New RECORDING_RELOAD_JS: polls /api/status for any line leaving
    RECORDING state and reloads the page once it does, since a recording
    only finishes at hang-up, well after the page that started it was
    rendered -- there's no request/response to hook a refresh onto.
    Wired into the Recordings page (211 messages) and the Hardware tab's
    Answering Machine card (212 greetings) so the Greeting row's audio
    player / "not recorded yet" text updates without a manual refresh.
    - idle_power_settings_handler: was showing "minutes out of range" for
    ANY idle_power_set() failure, not just an act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
2026-09-11 VOIP tab: check-a-number uses the live server field; add CallerID for board clarity
    - "Check a number" was always probing the currently-*saved* SIP server,
    so trying a candidate against a server you just typed (but haven't
    saved yet) required saving first -- backwards for a try-before-you-
    commit tool. Its server field is now a hidden input kept in sync via
    JS with the Save form's server field (voipSyncCheckServer(), fired on
    every keystroke), with voip_check_handler() falling back to the saved
    value only if that arrives empty (no-JS). Verified against the board:
    checking a number now genuinely resolves whatever server was typed,
    not the saved one.
    - Setup script (GET /voip_s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
2026-09-11 VOIP tab: rename "extension/user" labels, add copy-paste config examples
    - "Line 1/2 extension/user" -> "Line 1/2 extension" -- the field is the
    dialable extension number; calling it "/user" too just made it read
    as two different things.
    - The "add the line by hand" manual instructions now include real,
    copy-paste-ready <pre><code> blocks for both pjsip.conf (AOR+auth+
    endpoint trio per line, with the callerid line from the last commit)
    and extensions.conf ([rotary] context + exten/Hangup per line) --
    built from this board's own actual saved extensions, falling back to
    placeholder digits (1234/1235) with a clear note if nothing's saved
    yet. Verified rendered output against th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
2026-09-11 VOIP tab: separate Asterisk/FreePBX instructions; document remote/NAT deployment
    - Split the single "add the line by hand" collapsible into two: an
    Asterisk one (kept the existing config-file steps + copy-paste
    blocks) and a new FreePBX one (its own GUI-based steps: Add New
    PJSIP Extension, User Extension, Display Name using the board name
    for the same clarity purpose as callerid, Secret, Apply Config).
    Explicitly calls out that FreePBX manages its own config from a
    database and can overwrite hand edits, so the two paths shouldn't be
    mixed for the same extension.
    - New "Setting this up remotely?" collapsible with the actual firewall
    ports needed on both sides: this board's ro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
2026-09-11 voip: update in-RAM config cache immediately on save, not just NVS
    voip_set_config() wrote server/user/pass to NVS but left the in-RAM
    cache (read by voip_server()/voip_user()) stale until reboot, so the
    Settings -> VOIP form and its copy-paste pjsip.conf/extensions.conf
    examples appeared to revert to old/default values right after Save.
    Update the cache alongside the NVS write, matching how
    voip_set_setup_password() already behaves. Actual SIP re-registration
    still only happens on reboot, per the button's own label.
2026-09-11 Add Quiet hours: incoming calls go straight to voicemail overnight
    New board-wide setting (Settings -> General), defaults to disabled /
    21:00-07:00 once turned on. Applies to both lines from one switch --
    old mechanical ringers are loud, and there's no reason to ring a
    sleeping house. Works independently of each line's own Answering
    Machine config: during quiet hours a call still routes to voicemail
    even on a line whose AM is off, since there's nowhere else to send it.
    Needs a real notion of local time, which this board never had (SNTP
    keeps UTC only, gmtime_r() everywhere) -- added board_timezone_get/set
    (a POSIX TZ string, "" = UTC) so board_quiet_hours_active() has
    something to compare a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
2026-09-11 webui: add a real ICO favicon fallback for Safari
    favicon.svg was being re-served under the /favicon.ico path on the
    theory that browsers key off Content-Type, not the URL extension --
    true for Chrome/Firefox, but Safari's own-initiative /favicon.ico probe
    (which runs regardless of the page's <link rel="icon"> tags) has never
    reliably rendered SVG there, which is why the tab icon wasn't showing
    up in Safari.
    Adds a real multi-resolution PNG-in-ICO (16/32/48px), generated from
    the same favicon.svg via firmware/bringup/gen_favicon.py (needs
    rsvg-convert; re-run after any favicon.svg color change). /favicon.ico
    now serves that; /static/favicon.svg is unchanged. Every page's <link
    rel="icon"> n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
2026-09-11 Only have items that need to be hand-soldered in the initial BOM
    Removed unnecessary components and updated BOM details for clarity.
2026-09-12 archive: note Bluetooth Classic audio as a possible future upgrade path
    Dev-journal note, not implemented/scheduled: C6 has BLE only, no
    Bluetooth Classic, so A2DP/HFP (what "act like a Bluetooth headset"
    actually needs) aren't reachable on this board's current MCU. Records
    the two options considered (swap to original ESP32, or a companion
    Bluetooth Classic audio module over a couple of spare pins) and an
    example module (XS3868/CSR8635) for the latter.
2026-09-12 archive: update Bluetooth audio note with real BM64 pricing + wiring plan
    XS3868 turned out to be ~\$50 on AliExpress, not the cheap hobbyist
    buy assumed -- BM64 is ~\$14 on Digikey, flipping the earlier cost
    comparison. Records the physical integration plan taking shape
    (BM64 needs its own daughter board / vertical connector, ties into
    the existing I2S bus via its own I2S interface) and that the real
    pin count (3 control + possibly 2 UART, on top of the I2S tap) needs
    rechecking against actual spare GPIO before this is more than a
    hopeful plan.
2026-09-12 archive: correct I2S sharing claim, add real BM64 pin count + ESP32 comparison
    Checked the actual BM64 datasheet (now in datasheets/) and the C6's own
    datasheet instead of estimating. Two corrections to the earlier notes:
    - C6 has only one I2S controller (already fully used by the ES8388
    codec), so "tee into the existing I2S bus" for BM64 isn't the simple
    hardware tap it was described as -- clock lines can be shared, data
    lines can't without TDM slot-sharing or firmware-level bridging.
    Recommends BM64's analog audio pins instead, which sidesteps this
    entirely and costs zero C6 GPIO.
    - GPIO16/17 confirmed genuinely free (defined in the pin maps as a
    debug UART, never referenced e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
2026-09-12 Add BM62/64 Bluetooth audio module datasheet for reference
    Referenced by archive/BLUETOOTH_AUDIO_UPGRADE.md's pin-count analysis.
2026-09-13 bringup: add screenshot_webui.sh to capture web UI pages for docs/release
    macOS-only (unlike the other bringup/ tools): drives a real Safari
    window via AppleScript and captures it with screencapture, since a
    headless browser can't reach the board's LAN IP (macOS's Local Network
    permission gate) and there's no way to render the page otherwise
    without a real browser engine. Needs Screen Recording permission
    granted to whatever terminal runs it -- see the script's header
    comment. Re-runnable any time the UI changes; fixed filenames per page
    so it overwrites in place.
2026-09-13 Add Bluetooth companion scaffolding + "enable this feature" master toggles
    New bt_companion component: the C6 side of the link to an optional
    Bluetooth Classic audio companion board (BM64 or a second ESP32) over
    UART on GPIO16/17, per archive/BLUETOOTH_AUDIO_UPGRADE.md's pin plan.
    Defines a small line-based status/pairing protocol and a real (if
    currently silent, since no companion hardware exists yet) UART polling
    task. Master enable defaults off -- no board has this hardware today.
    New Settings -> Bluetooth tab: master "I have this daughter board wired
    in" checkbox, honest status (link up/down, paired device), and a
    pairing button disabled until the link responds.
    Also establishes the "e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
2026-09-13 archive: note bt_companion scaffolding + FaceTime/HFP ring finding, add pin table
    Records that the C6 side of the Bluetooth companion link now has real
    code (firmware/components/bt_companion/) rather than just being a
    design note, adds the concrete C6<->ESP32-original pin table, and
    records the FaceTime/HFP finding: RING notification and answer/hangup
    control come for free from the HFP spec once paired (same as any
    Bluetooth headset), no custom iPhone app needed.
2026-09-13 archive: trim Bluetooth audio note to just the two final options
    Drops the dated "Update (2026-09-...)" narrative sections now that the
    plan has settled -- keeps just the BM64 and ESP32-original options,
    their final pin tables, the A-vs-B comparison, and the FaceTime/HFP
    ring finding. Same content, no more history to wade through to find
    the current plan.
2026-09-13 Add OTA firmware updates: two 1.75MB slots + rollback safety + web upload
    Partition table: replaces the single "factory" app partition with the
    standard otadata + ota_0 + ota_1 layout (1.75MB per slot -- current app
    is ~1.4MB, leaves ~4.5MB of the 16MB flash still unallocated).
    CONFIG_BOOTLOADER_APP_ROLLBACK_ENABLE turns on ESP-IDF's built-in
    auto-revert: a newly-pushed image that crashes or hangs before
    app_main() reaches esp_ota_mark_app_valid_cancel_rollback() (placed
    after every subsystem -- audio, SLIC, telephony, webui -- has already
    come up) gets reverted to the last-known-good slot on the next boot,
    without needing physical/USB access to recover.
    New "Firmware" card (Settings -> Har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
2026-09-13 archive: settle on ESP32 DevKitC (not bare module) as the companion, BM64 fallback
    Decision: use the full ESP32-original DevKitC board permanently, not
    just for prototyping before moving to a bare WROOM-32 -- the devkit's
    built-in regulator, USB programming, and status LEDs are worth the
    extra board space for how much more fungible/debuggable it makes the
    daughter board. BM64 stays documented as the fallback if the 8-bit DAC
    audio quality isn't good enough in practice.
    Also records the regulator finding that prompted re-confirming this:
    the ESP32 module itself needs regulated 3.3V (per its datasheet), but
    a devkit's onboard LDO between 5V/VIN and the module's 3.3V rail is
    exactly why poweri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
2026-09-14 Add Bluetooth companion bring-up test projects (A2DP sink + HFP hands-free)
    Two standalone ESP-IDF projects (target esp32, not esp32c6 -- separate
    from firmware/ since they're a different chip) copied from ESP-IDF's
    own examples, adapted for this project's companion-board bring-up:
    - bt_companion_fw/: A2DP sink, internal-DAC output (GPIO25/26) per
    archive/BLUETOOTH_AUDIO_UPGRADE.md's pin plan. Confirmed working:
    paired and streamed audio from a laptop.
    - bt_companion_hfp_test/: HFP Hands-Free role (the real target role --
    bidirectional call audio, not just one-way music), configured for
    vHCI audio datapath instead of the default PCM, since vHCI hands
    audio samples to application c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
2026-09-14 Add real DAC/ADC audio bridging + C6 UART link to the HFP test firmware
    bt_audio_io.c/.h: replaces the stock hfp_hf example's loopback (echo
    incoming audio straight back out, "so you can hear your own voice")
    with real hardware I/O -- incoming HFP downlink samples (16-bit PCM,
    8kHz CVSD) convert and write to the internal DAC (GPIO25) via the
    dac_continuous driver; a background task continuously samples the ADC
    (GPIO34, ADC1_CHANNEL_6) into a ring buffer that the outgoing-data
    callback serves for the uplink direction. Matches
    archive/BLUETOOTH_AUDIO_UPGRADE.md's analog-handoff plan and the bias
    network the user wired to the SMD2 board's AG1171 Vout/Vin.
    bt_uart_link.c/.h: the ESP32 side of t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
2026-09-14 Fix ESP32 companion's Bluetooth visibility on phones; live pairing UI
    The HFP test firmware never set a Class of Device, so Bluedroid
    defaulted to uncategorized -- macOS lists nearly any discoverable
    classic BT device regardless of CoD, but phones filter the pairing
    list by CoD, which is why the board showed up on a laptop but not on
    a phone. Set CoD to Audio/Video major, Hands-free minor, Audio+
    Telephony service bits (esp_bt_gap_set_cod in main.c's STACK_UP
    handler).
    Also improved the C6 Settings -> Bluetooth tab: clicking "Start
    pairing" previously just re-rendered the same static page with no
    feedback. It now intercepts the form submit, shows a busy "Pairing..."
    state, polls the shared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
2026-09-14 ESP32 companion: blink status LED while pairing, clear stale bonds on pair
    Two bring-up gaps found testing pairing from a phone: no visual
    feedback that the board is actually in a pairing window (only the web
    UI's own busy state, nothing on the board itself), and a phone's
    "forget this device" only clears its own side -- if the board still
    holds an old link key for that address, later pairing attempts fail
    silently and the phone eventually stops offering the device at all.
    Adds bt_led.c/h: blinks the onboard LED (GPIO2, the standard ESP32
    DevKitC pin) at ~300ms while pairing, solid on once connected, off
    otherwise, with a 60s auto-timeout if nothing connects. Wired in from
    bt_uart_link.c's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
2026-09-14 Fix distorted Bluetooth audio (force CVSD, no resampling for mSBC); broadcast the C6's own board name
    Recording a WWV call through the analog bridge sounded completely
    wrong -- confirmed via spectral analysis the captured audio had a
    dominant ~40Hz component, way too low for real speech and consistent
    with ~2x pitch/speed distortion. Root cause: CONFIG_BT_HFP_WBS_ENABLE
    defaults on, so a phone that supports Wideband Speech (mSBC, 16kHz --
    iPhones do) negotiates it instead of CVSD (8kHz), but bt_audio_io.c's
    whole DAC/ADC pipeline is hardcoded to 8kHz and never calls
    esp_hf_client_pcm_resample_init(). Disabling WBS forces CVSD-only, so
    the negotiated codec's rate always matches the pipeline's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
2026-09-14 Document audio-tap passive components and the GPIO1/3 wiring gotcha
    Filled in what was previously just "GPIO25 (DAC1)"/"GPIO34 (ADC1_CH6)"
    with the actual components needed at each tap, worked out and wired on
    the bench this session: GPIO25 (downlink) needs its own new 100nF
    series coupling cap before joining the AG1171 Vin node (a DAC output
    actively drives the node, so it can't share the existing AC-only
    junction without stripping its own DC bias first); GPIO34 (uplink)
    needs a ~100k/100k bias divider to center it at ~1.65V but no new cap,
    since it's just listening on a node the SLIC's own existing 100nF cap
    already keeps AC-only.
    Also documents the actual root cause of this session's rep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
2026-09-15 Init audio DAC/ADC unconditionally at boot, not just on first HFP call
    bt_audio_io_test_tone() silently no-op'd if bt_audio_io_init() had
    never run -- and that only happened lazily, on the first real HFP
    audio connection (bt_app_hf_client_audio_open()). Meant the tone
    diagnostic needed a real phone call first just to warm up the DAC/ADC,
    defeating its own point (testing the analog bridge without needing
    live Bluetooth audio). Now called unconditionally in app_main(); made
    idempotent (early return if already initialized) so the existing call
    from bt_app_hf_client_audio_open() on a real connection stays a safe
    no-op.
2026-09-15 Add a static DC level diagnostic for GPIO25, easier to scope-check than a tone
    A constant DC level is much simpler to confirm with a multimeter/scope
    than a moving 1kHz waveform -- useful as a first sanity check before
    chasing a real tone signal, requested mid-oscilloscope-session.
    Companion side (bt_audio_io_test_level()) drives ~0.05V or ~3.25V out
    GPIO25 through the exact same bt_audio_io_write_downlink() path real
    audio uses. Wired through the same UART command / webui endpoint
    pattern as the existing tone diagnostic: C6's bt_companion_test_level()
    sends "LEVEL <0|1> <ms>", the companion's bt_uart_link.c parses it, and
    POST /test/bt_level (high=0|1&ms=N) triggers it from a browser/curl.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
2026-09-15 Add raw GPIO console commands for bench wiring checks (gpio_set/get/cycle)
    The UART-relayed tone/level diagnostics go through several layers (C6
    web UI -> C6 UART -> companion UART parse -> bt_audio_io task) and
    weren't showing any voltage movement on the scope -- before chasing
    that further, wanted a way to test raw pin continuity directly, no
    Bluetooth or UART relay involved at all.
    gpio_set <pin> <0|1> drives a pin and reads it back immediately;
    gpio_get <pin> just reads; gpio_cycle <ms> loops forever through
    36,39,34,35,32,33,25,26,27 (stop with `gpio_cycle stop`). Correctly
    treats 34/35/36/39 as read-only -- they're ADC1-only, input-only pins
    on the original ESP32 with no output driver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
2026-09-15 Add a console 'tone' command, direct on the ESP32, no C6/Bluetooth relay
    Bench-testing GPIO25/34 directly over screen(1) surfaced a real need:
    the existing tone diagnostic only triggers via the C6 web UI -> C6
    UART -> companion UART parse chain, and when nothing showed on the
    scope it wasn't obvious whether the DAC path itself was suspect or the
    relay never delivered the command. `tone <hz> <ms>` calls
    bt_audio_io_test_tone() directly from this console, cutting out every
    layer except the DAC itself.
2026-09-15 Make bt_audio_io_test_tone() report real success/failure, not just start it
    The console 'tone' command always printed "playing..." regardless of
    whether anything actually started -- bt_audio_io_test_tone() was void,
    so a NULL DAC handle or a failed xTaskCreate silently did nothing while
    still claiming success. Confirmed misleading in practice: DAC not
    producing anything, console said otherwise. Now returns bool and logs
    the specific reason (DAC not initialized / bad args / malloc failed /
    task create failed) so a failure is visible instead of masquerading as
    a working tone.
2026-09-15 Fix DAC clock source -- it was never actually initializing, all session
    Root cause of every downlink audio-quality issue chased today: DAC
    clk_src was DAC_DIGI_CLK_SRC_DEFAULT (PLL_D2), which is too fast a base
    clock to divide down to 8kHz within the driver's 8-bit mclk-divider
    limit. dac_continuous_new_channels() was returning ESP_ERR_INVALID_ARG
    ("Frequency is too small, the mclk division exceed the maximum value
    255") at every single boot, confirmed via a clean boot-log capture --
    silently, since nothing checked bt_audio_io_init()'s return value at
    any of its call sites. s_dac was NULL the entire session; every tone/
    level/real-HFP-audio test was writing to a DAC handle that didn't
    exist.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
2026-09-15 Append -HFP-Test to the broadcast BT name; guard against overlapping DAC test writers
    Name: was broadcasting the bare board name ("DualPhone"); appends
    "-HFP-Test" now ("DualPhone-HFP-Test") so it's identifiable as this
    companion firmware specifically. Not flashed yet per request -- staged
    for the next flash.
    DAC writer guard: connecting a laptop's Bluetooth flooded the console
    with dac_continuous "Get available descriptor timeout" errors --
    almost certainly two test writers (tone/level) racing to fill the same
    8-descriptor ring concurrently, starving each other. Added
    s_test_task_running to bt_audio_io.c so only one diagnostic writer can
    run at a time; a second attempt now fails cleanly wi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
2026-09-15 Decouple downlink writes from Bluedroid's callback -- likely fix for real-call dropout
    Diagnostic sequence today: a sustained synthetic tone through the exact
    same DAC/conversion/pacing ran 30+ seconds with zero descriptor errors,
    but real HFP calls flooded the console with dac_continuous "Get
    available descriptor timeout" after about a second. Since our own
    controlled writer never overruns the DMA pool, the DAC/descriptor
    capacity itself isn't the problem -- the problem is that
    bt_audio_io_write_downlink() called dac_continuous_write() directly
    from whatever thread Bluedroid's incoming-data callback runs on. Real
    HFP delivers audio at its own SCO-driven cadence/chunk size, not our
    neat 160-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
2026-09-15 Add AGC to downlink audio -- likely fix for "garbled/underwater" voice
    Live WWV call, post-decoupling fix: tick tones came through clean,
    but the announcer's voice sounded garbled/underwater while the
    Bluetooth connection stayed up the whole time. Strong signal (tick
    tones, like this file's own near-full-scale test tone) sounding fine
    on the same 8-bit DAC that mangles a quieter signal (real voice) is
    the signature of coarse quantization on an unboosted quiet source, not
    DAC/hardware distortion -- recorder.c already hit this exact problem
    on the recording side (its own AGC comment: real voice measured ~20%
    of full-scale peak). With only 256 total DAC voltage steps, a
    low-amplitude signal lef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
2026-09-15 Add raw downlink PCM capture for objective audio-quality analysis
    Two rounds of tuning by ear (AGC made it worse and was reverted) didn't
    converge, so capture real data instead. New console command
    capture_downlink [ms] records the PCM Bluedroid hands the firmware --
    before any 16->8-bit conversion or DAC -- and dumps it as base64 (this
    board has no local storage). tools/capture_downlink.py drives it over
    serial, rebuilds raw.wav plus raw_8bit_sim.wav (the same audio through
    the firmware's exact 8-bit conversion and back), and prints level,
    clipping, DAC-steps-used, and per-band energy for each. Separates
    "phone/Bluetooth already delivers bad audio" from "8-bit quantization
    ruins it" from "t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
2026-09-15 Switch Bluetooth companion plan to BM64 -- ESP32 HFP audio confirmed a dead end
    Documents today's bench-confirmed root cause: ESP-IDF's Bluedroid host
    stack does a byte-for-byte passthrough for CVSD (zero decode) --
    bta_hf_client_co.c, confirmed by reading the actual source. CVSD decode
    happens entirely inside the ESP32 Bluetooth controller's closed-source
    firmware, per ESP-IDF's own hfp_hf example README. Our own raw-PCM
    capture tooling showed 79% of energy below 300Hz on a live voice call,
    identical whether measured before or after our own DAC conversion --
    ruling out everything in our application code. Matches a long-standing,
    unresolved community pattern on this exact code path (multiple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
2026-09-16 Fix stale sdkconfig flag that silently disabled OTA rollback
    CONFIG_BOOTLOADER_APP_ROLLBACK_ENABLE was left "not set" from before the
    OTA feature existed -- sdkconfig.defaults only fills in keys a checked-in
    sdkconfig doesn't already have an explicit value for, so the crash/hang
    auto-revert safety net has never actually been compiled in on any board
    built from this checkout since OTA was added. Confirmed the fix works by
    pushing a deliberately-crashing build over OTA and watching it auto-revert.
2026-09-16 Add microSD card identification, a real self-test, and format support
    sdcard_get_info() surfaces the card's own CID/CSD data (product name,
    manufacturer ID, capacity, negotiated bus speed) for the web UI's card-info
    display. sdcard_selftest() now writes/reads/verifies a 128KB file and times
    both directions instead of a trivial few-byte round-trip, giving a real
    throughput figure -- SD cards have no portable SMART-style health check the
    way SATA/NVMe drives do, so this write/read/verify/speed test is the
    practical stand-in: a failing or unusually slow card tends to show up here
    as a mismatch or a low number. sdcard_format() wraps
    esp_vfs_fat_sdcard_format() for a destructive full-card wipe, g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
2026-09-16 Add a master VOIP enable/disable switch, independent of server config
    voip_is_enabled()/voip_set_enabled() gate the SIP task from ever
    binding/registering when disabled -- no incoming call can reach an
    unregistered board, and voip_dial() keeps failing its own existing
    "!s_server_ip[0]" check exactly as it already does for an unreachable
    server, so a 555-xxxx dial while disabled just plays the existing
    reorder/fast-busy tone with no changes needed in telephony.c/dialplan.c.
    Defaults true so upgrading a board with working VoIP doesn't silently turn
    it off. Same "saved now, applied on next reboot" convention as
    voip_set_config().
2026-09-16 Web UI: bulk delete, OTA revert, Phone Settings tab, SD/diag tools
    A lot of small, mostly-independent additions from one working session,
    all in webui.c so grouped into one commit rather than split awkwardly:
    - Recordings/Storage: checkbox-based bulk delete (select multiple, or
    check "select all" for a one-click delete-everything), reusing the
    existing per-row delete buttons via formaction overrides on one shared
    <form> instead of nested forms.
    - Fixed real render-buffer truncation bugs on the Dial Codes and Storage
    tabs -- both were silently cutting off HTML output before reaching
    their Save/generate buttons or the bulk-delete form, discovered while
    building the above and while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
2026-09-16 gen_prompt.py: switch default Piper voice to en_GB-jenny_dioco-medium
    Sounds more natural than en_US-lessac-medium, tried side by side.
    Deliberately not kept in sync with the Pi's install-piper.sh, which
    still defaults to lessac.
2026-09-16 archive: verify BM64 RST_N/EAN/P2_0 against the datasheet's own Table 5-1
    RST_N: confirmed no C6 connection needed at all (datasheet says so
    verbatim), not just an RC circuit.
    EAN/P2_0: the previous pin table guessed EAN has an internal pull-DOWN,
    so Application mode was "likely" the power-up default. Backwards --
    Table 5-1's own Note 1 says both pins pull HIGH internally, so floating
    EAN lands in ROM Application, not Flash Application. Documented the full
    mode table, the DFU-over-UART procedure (5.2.1.1 -- toggle into ROM TEST
    mode, write, switch back), and the actual decision: hardwire EAN low,
    leave P2_0 floating, matching the existing "just the UART pair" GPIO
    budget -- revisit only if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
2026-09-16 archive: add BM64 coupling cap values, fix EAN pull-down (it self-reverses)
    Coupling caps, both now real numbers instead of "a new DC-blocking cap":
    - Downlink (AOHPL -> AG1171 Vin): 47uF -- not derived, it's literally the
    value the datasheet used to characterize the DAC's own single-ended-mode
    frequency response (Figure 2-6's caption).
    - Mic input (MIC_P1 -> AG1171 Vout): 1uF -- calculated from the
    datasheet's 24kOhm typical mic input impedance, putting the high-pass
    corner ~6.6Hz, well below the 300-3400Hz voice band.
    EAN: yesterday's "correction" (external pull-down needed, based on Table
    5-1's generic "pins have internal pull high" note) was itself wrong.
    Table 1-3 -- the actual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
2026-09-17 Add a safety guard for microSD present + 2-line board misconfiguration
    GPIO18-21 are a real physical jumper (J5, docs/hardware.md "J5: line-1
    SLIC vs. microSD") between line 1's SLIC and the microSD socket -- when
    jumpered for line 1, the card's data lines are electrically disconnected,
    so this isn't contention on those lines. It's still a real physical/config
    mismatch worth surfacing loudly: someone jumpered/configured for one
    option and left a card meant for the other sitting in the socket, which
    would otherwise show up only as "the SD card silently doesn't work."
    board_sd_line1_conflict() (board.h/board.c) combines two already-existing,
    already-safe-to-call-anywhere functions (board_hw_c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
2026-09-17 archive: recommend 10uF Basic ceramic over 47uF for the BM64 downlink coupling cap
    No genuine 47uF part exists in JLCPCB's Basic library at any footprint
    -- every "47uF Basic" hit in a widely-used community parts CSV turned
    out to be mislabeled 4.7uF against LCSC's own listings, and the one
    real 47uF part found is Extended category. 47uF was never electrically
    required here (it's just the value Microchip's own test jig used); a
    10uF/0805 Basic ceramic (C15850) clears the needed high-pass corner
    with huge margin.
2026-09-17 Stop tracking datasheets/ -- keep reference PDFs local-only
    These are third-party reference material that never changes and adds
    real weight to repo history (the BM64 datasheet alone is ~7MB). Files
    stay on disk, just no longer version-controlled.
2026-09-17 Gate Answering Machine on VOIP/2-line, add US-tones override, mount SD on hot-insert
    - Answering Machine card (Settings -> Phone Settings) now shows a warning
    note when neither VOIP is enabled nor a second line is configured --
    there's no path for an incoming call in that state, so the settings
    would be saved but never do anything. Settings stay editable either way.
    - New "Call-progress tones" card (same tab): a checkbox to follow the
    phone's language setting for dial/ring/busy tones (tone_regions.h,
    existing default behavior) or always use standard US tones regardless
    of language. New board_tone_follow_language_get()/_set(), default true
    to preserve existing behavior for anyo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
2026-09-17 Add onboard RGB status LED for SMD4, detect SD wrong-filesystem vs. hardware failure
    - board: SMD4 has no discrete status LED (GPIO11 is I2S BCLK there), so
    board_led_set_state() has been a no-op on it. Adds a second
    implementation (#elif CONFIG_BOARD_TYPE_SMD4) driving the ESP32-C6-
    DevKitC-1 module's own onboard addressable RGB LED via espressif/led_strip
    -- red blink at boot, green blink while WiFi connects, solid green for
    30s once connected, then off. GPIO8 is an educated guess (Espressif's
    standard DevKitC-1 WS2812 pin, and this carrier leaves it fully free) --
    unverified against the actual DevKit schematic, only ONBOARD_LED_GPIO
    needs to change if it's wrong.
    - sdcard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
2026-09-17 Add yellow OTA-update LED state, dim onboard RGB way down
    Confirmed on real hardware 2026-09-17: the onboard GPIO8 WS2812 does
    exist and lights correctly (red boot / green connecting / solid green
    30s), but the prior LED_DIM=40 (~16% of 255) was startlingly bright at
    close range -- WS2812s have no current-limiting and read as much
    brighter than the same PWM duty would on a normal LED. Dropped to 4.
    Also adds BOARD_LED_OTA_UPDATING (yellow blink) around the actual
    firmware-write span in webui.c's ota_upload_handler -- restores to
    BOARD_LED_OK on a failed upload, left alone on success since a reboot
    into the new image follows shortly anyway.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
2026-09-17 Detect a firmware/physical-board type mismatch, warn loudly instead of silently misbehaving
    Confirmed live tonight: maxphone (physically SMD2, hand-soldered) was
    running SMD4-compiled firmware. CONFIG_BOARD_TYPE_* is a hard compile-
    time choice with no runtime detection, and SMD2/SMD4 disagree on which
    of the shared GPIO18-21 pads is SD's CS vs. MISO -- so subsystems that
    don't touch those pins (WiFi, VOIP, general telephony) kept working
    fine, while microSD quietly didn't, with nothing pointing at "wrong
    board type flashed" as the reason.
    board_type_check() (board.c/board.h) now remembers which variant last
    confirmed-booted on a given physical board (NVS, survives reflashes)
    and compares i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
2026-09-17 Fix microSD mount failures: revert SPI clock from 40MHz back to 20MHz
    Root-caused via a clean A/B test tonight: 11759ad bumped the SD SPI
    clock from SDSPI_HOST_DEFAULT()'s 20MHz to SDMMC_FREQ_HIGHSPEED
    (40MHz) for faster transfers. That single change is what's been
    causing "command CRC error" / sdmmc_card_init failed (0x109) on both
    dualphone2 (SMD4) and maxphone (SMD2) -- confirmed by git-worktree
    checking out the last commit before 11759ad (which predates SMD4
    support entirely) and finding the same card mounted fine there, then
    bisecting the difference down to this one line and confirming 20MHz
    alone fixes the mount on both boards with the same card that failed
    at 40MHz.
    Two different boa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
2026-09-18 Move Bluetooth companion analog passthrough from line 0 to line 1
    Line 0 must always work as a normal rotary-dial line regardless of
    whether the Bluetooth companion feature is enabled -- it's the
    always-present line on every board (1-line or 2-line), and pinning
    the companion's passthrough behavior to it meant a stray
    bt_enabled=true in NVS (however it got set -- easy to do just by
    visiting the Settings -> Bluetooth tab) silently killed dial tone
    system-wide, with no companion hardware even attached. Confirmed live
    today across two different boards.
    Line 1 only exists on a 2-line board at all -- ag1170.c's hook-service
    loop only runs for `line < s_active_lines` (board_hw_config().num_lines)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
2026-09-18 Fix GET /media/<name> 404ing on internal-flash-only files whenever SD is mounted
    Real bug, not the reported symptom's actual cause being formatting or
    upload failure: media_handler()'s existence/size pre-check used
    storage_list(), which dispatches to whichever backend is primary (SD
    when mounted, else internal) and only that one -- but prompt/clip
    uploads always land on internal flash specifically
    (storage_write_begin_local(), so pulling the card mid-use can't take
    dial tone or the operator message with it). The two disagree the
    instant a card is mounted: any internal-flash-only file 404s here,
    even though storage_read_open() (used moments later in the same
    handler!) already correctly search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
2026-09-18 Mention the physical BOOT-button WiFi reset on the Re-provision WiFi card
    The 3s-hold GPIO9 fallback (board.c's board_factory_reset_start()) has
    existed since early on and is documented in docs/getting-started.md,
    but was invisible from the web UI itself -- no help if you forget to
    click Re-provision before moving the board and can't reach the page
    anymore. Now mentioned right on the card that does the same thing.
2026-09-22 Remove the abandoned ESP32-original Bluetooth companion projects
    bt_companion_fw/ (A2DP-sink example) and bt_companion_hfp_test/ (HFP
    bring-up + the capture_downlink diagnostic) were the ESP32-original-
    DevKitC companion path (archive/BLUETOOTH_AUDIO_UPGRADE.md's "Option
    B"), superseded by BM64 back on 2026-09-15 once real bench testing
    confirmed a hard CVSD-decode limitation in the ESP32's Bluetooth
    controller firmware -- not something fixable from the application
    side (see that doc's "Confirmed: ESP32 software HFP audio is a dead
    end" section, kept as the permanent record of why).
    Standalone ESP-IDF projects, no connection to firmware/ -- doesn't
    touch the real build. Recoverable from git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
2026-09-22 Fix build.smd2 console: USB-Serial-JTAG must be the primary channel
    sdkconfig.smd2.defaults was missing the same UART-vs-USB console override
    the main SMD4 sdkconfig has carried for a long time. Without it, a freshly
    generated build.smd2/sdkconfig defaulted to UART0 as the primary
    (input-reading) console channel with USB-Serial-JTAG relegated to a
    secondary, output-only log mirror -- on SMD boards nothing is wired to
    UART0, so all log output still appeared over the USB-CDC port idf.py
    monitor uses, but no keystroke ever reached the interactive REPL.
    Confirmed via an A/B test against a pre-existing build from before this
    file existed (which had it right).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
2026-09-22 bt_companion: confirm BM64 protocol against real hardware, add BD-address read + baud sweep diagnostics
    Real BM64 module now bench-confirmed end to end: ACK/UART_VERSION/BD_ADDR
    frames all decode correctly (checksums, event dispatch, ACK handshake).
    Adds bt_companion_read_bd_addr() (new BM64_READ_LOCAL_BD_ADDR_CMD/
    BM64_EVENT_REPORT_LOCAL_BD_ADDR opcodes) surfaced as both a 'bm64_addr'
    console command and a live web UI status row, so pairing has a concrete
    address to look for. bt_companion_raw_ping() now drains the whole timeout
    window instead of returning on the first frame (an ACK is just receipt
    confirmation -- the real answer typically follows as a second frame) and
    reports raw byte coun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
2026-09-22 docs: add SMD5/Analog Redial 5 board notes, multi-board flashing gotchas to CLAUDE.md
    New archive/hardware/ANALOG_REDIAL_5.md documents the dual ESP32-C6 module
    footprint (real Espressif vs. AliExpress clone -- the clone swaps GPIO2/3
    with GPIO12/13, which is a silicon-fixed native-USB constraint, not a
    Kconfig one) and the confirmed BM64 companion header (J12) pinout traced
    from the schematic. CLAUDE.md gets a new section covering this session's
    actual incidents: the -B build.<type> silently-writes-the-wrong-sdkconfig
    trap, sdkconfig.<type>.defaults only filling gaps (never overriding an
    already-generated sdkconfig), and OTA rolling back to a stale image on a
    failed boot -- plus fixes two s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
2026-09-22 Add SMD5 board-type scaffolding: real-module vs. AliExpress-clone-module Kconfig split
    CONFIG_BOARD_TYPE_SMD5 and CONFIG_BOARD_TYPE_SMD5_CHEAP, both sharing
    SMD4's pin map (board_pins_smd4.h) since the two variants differ only in
    which MCU module physically populates SMD5's dual footprint -- see
    archive/hardware/ANALOG_REDIAL_5.md for why (a silicon-fixed native-USB
    pin swap between vendors, not a real pin-map difference). The cheap-module
    variant's sdkconfig.smd5_cheap.defaults deliberately leaves the console on
    plain UART0 instead of native USB, since that module's real USB pins don't
    reach the board's own USB connector once assembled.
    Building both variants surfaced a real bug: the wm873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
2026-09-22 bt_companion: real BM64 command-set doc confirms DEVICE_STATE table, adds device name + ACK visibility
    User supplied the actual Microchip "Audio UART Command Set" doc and BM62/64
    datasheet (datasheets/) -- replaces guesswork with authoritative values:
    - BM64_EVENT_DEVICE_STATE's State byte now uses the real, complete table
    (Power off/on, Pairing/discoverable, Pairing OK/failed, HF/A2DP/SCO
    link up/down, etc.) instead of a "nonzero probably means connected"
    placeholder. bt_connected now tracks actual HF/A2DP link-up/down states.
    - Added BM64_CHANGE_DEVICE_NAME_CMD (0x05, confirmed 32-byte fixed ASCII
    field, no length prefix) -- bt_companion now sets the module's advertised
    Bluetoot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
2026-09-22 bt_companion: fix pairing -- module needs a POWERON_BUTTON_PRESS/RELEASE MMI handshake first
    Confirmed on real hardware: sending the pairing MMI action (0x5D) alone
    got ACKed (status 0x00) but the module never actually broadcast as
    discoverable -- no BM64_EVENT_DEVICE_STATE followed at all, and a phone
    never saw it. Found the missing piece in reference/BM64_arduino's own
    powerOn(): it always sends MMI_POWERON_BUTTON_PRESS (0x51) then
    MMI_POWERON_BUTTON_RELEASE (0x52) before anything else. Doing that first
    (even with MFB itself just tied high on the bench, no GPIO control) is
    what got the module to actually emit DEVICE_STATE 0x02 (Power ON) -> 0x0F
    (Standby) -- and only after that did the pai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
2026-09-22 docs: record BM64 pairing confirmed working end-to-end
    archive/BLUETOOTH_AUDIO_UPGRADE.md and bt_companion.h's own doc comment
    now document the 2026-09-22 milestone: real hardware, real phone, real
    pairing -- and the POWERON_BUTTON_PRESS/RELEASE handshake that turned out
    to be the missing piece (see the prior commit for the code fix itself).
2026-09-24 Auto-assert BM64 control pins; add standalone idf.py UART bridge for EEPROM flashing
    bt_companion.c: fold MFB/RST_N/P2_0 assertion into ensure_uart() so every
    BM64 UART path (pairing, bm64_test, bm64_snoop) self-asserts on a compatible
    board, instead of requiring manual bm64_pin commands after every reset.
    Confirmed on real "newphone" SMD4 hardware that MFB must be held (not
    pulsed) for the module to respond at all.
    New firmware/bm64_bridge/: standalone ESP-IDF project turning the board
    into a transparent USB<->BM64-UART bridge so isupdate.exe/EEPROM_Tool.exe
    can flash BM64's EEPROM directly, without an Arduino toolchain. Uses the
    same esp_console/REPL mechanism bringup.c relies on daily --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
2026-09-25 Add bm64_raw console command for probing BM64's raw IBDK/EEPROM protocol
    bt_companion.c: split ensure_uart() into a peripheral-only helper plus the
    normal-mode pin-assertion wrapper, so a new bt_companion_raw_send() can talk
    to BM64 without forcing Flash Application mode -- needed for probing IBDK/
    test-mode traffic, which needs P2_0 held low instead. Also has
    assert_bm64_control_pins() force a real low-to-high edge on MFB rather than
    just setting it high, since the real datasheet names that pin "UART RX_IND,
    active-high (wakeup the Bluetooth system)" -- a wake trigger, not just a
    level. (Note: tonight's bench testing showed this edge alone doesn't fully
    explain the intermittent GPIO18/MFB c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
2026-09-25 Fix BM64 GPIO control: use gpio_config() not bare gpio_set_direction()
    Root cause of most of two evenings' worth of "MFB won't reliably hold
    high" debugging that looked exactly like a wiring/connection fault: both
    bringup.c's bm64_pin command and bt_companion.c's assert_bm64_control_pins()
    configured these pins with a bare gpio_set_direction()+gpio_set_level()
    pair, which never touches pull_up_en -- a leftover internal pull-up was
    silently fighting the output driver. gpio_set_level()'s return value and a
    gpio_get_level() readback both report success/whatever regardless (this
    chip leaves InputEn:0 for GPIO_MODE_OUTPUT, so software readback of an
    output-only pin isn't trustworthy either). Swit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
2026-09-25 Document tonight's EEPROM protocol findings and confirmed audio-fix bytes
    Quick-reference section at the top of eeprom_write.md: the concrete
    one-byte fix (0x348 = 0x0A) for the Capless/Single-End EEPROM
    inconsistency found earlier, ready to apply next isUpdate session.
    Live probing (via the new firmware bm64_raw console command) plus deeper
    analysis of the existing DMS capture (analyze_pre_write.py -- confirmed
    only 92 total records, not "1954" as earlier notes said) found two real,
    non-coincidental opcodes actually used by isUpdate.exe: 0xFC20 (device/ROM
    name query) and 0xFC31 (another status query), each appearing exactly
    twice -- matching connect -> write -> reconnect, with no read/ver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
2026-09-25 gitignore: exclude Microchip's proprietary BM64 tool package and vendor docs
    BM64/DSPK v2.1.5 Package/ (isupdate.exe, EEPROM_Tool, PIC18 reference
    source, MBA mobile app installers, ...) and BM64/Docs/ (vendor datasheets)
    are large, unmodified, copyrighted vendor material -- same reasoning as
    the existing datasheets/ entry. Our own research notes under BM64/ (the
    setup doc, eeprom_write/) are unaffected and stay tracked.
2026-09-25 BM64 BT companion: fix line assignment for 1-line boards, add pairing/name/LED commands
    - telephony: BT_COMPANION_LINE is now runtime (bt_companion_line()) —
    returns line 0 on 1-line boards, line 1 on 2-line boards. Previously
    hardcoded to 1, which meant BT passthrough never activated on 1-line
    boards (line 1 doesn't exist).
    - bt_companion: wait up to 3s for module Power ON/Standby before
    sending device name (was getting silently dropped). Re-send name
    right before entering pairing mode as belt-and-suspenders.
    - bringup: add 'bm64_pair' command (wraps bt_companion_start_pairing),
    'device_name' command (get/set board name from console, persists NVS),
    'bm64_ibdk exit' subcomm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
2026-09-26 Fix ES8388 LOUT1VOL/ROUT1VOL range: real datasheet caps at 33, not 63
    The near-silent dial tone on both SMD4 boards traced to a wrong constant,
    not a hardware fault: es8388_set_dac_volume() and the spkamp console
    command allowed 0-63 with a "33=0dB, 1dB/step" comment, but the ES8388
    datasheet (Reg. 46/47) only documents 0-33 (0=-45dB, 30=0dB, 1.5dB/step,
    33=+4.5dB max). Confirmed live with a scope on the SLIC VIN pin: 35/36
    gave plausible-looking output, but 37, 40, and 63 cut the AC signal to a
    dead 0 Vpp -- undefined register territory, not a mute, inverted gain, or
    a bad SLIC, and it reproduced identically on two separate SMD4 units
    since it's a pure firmware bug.
    Clamp to 33 in es8388_s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
2026-09-26 Document AOHPL tap loading/distortion measurement on Vin
    Confirmed 2026-09-26 with the BM64's audio wires reconnected: 1.97 Vpp at
    the SLIC VIN pin with AOHPL disconnected, dropping to 1.1 Vpp (and
    visibly squared off, not clean sine) once reconnected. The two coupling
    caps correctly isolate DC between the codec and BM64 branches, but say
    nothing about AC loading -- AOHPL's own output impedance/bias network is
    evidently loading and clipping the shared node. Not yet root-caused; a
    unity-gain buffer between AOHPL and Vin is the likely eventual fix for
    SMD5's BM64 header, since gain can't undo clipping that already happened
    upstream.
2026-09-26 BM64: CLS1 table routes to I2S not analog -- fix docs, add debug notes
    Root cause of silent AOHPL found: the MCHP_DSPKv2.1.7_BM64CLS1.txt
    EEPROM table (which was flashed) sets 0x1FC bit2=0 ('External CODEC'),
    routing A2DP audio to the I2S pins, not the internal analog DAC. The
    _SPKOUT table has bit2=1 ('Internal codec') and is the one that outputs
    on AOHPL/AOHPR. Only 3 bytes differ: 0x1FC, 0x0094, 0x0171.
    The repo docs had these two tables labeled backwards ('CLS1 = headphone
    DAC', 'SPKOUT = Class D amp'). The BM64 has no Class-D amplifier; its
    'speaker output' IS the AOHP headphone DAC.
    Pin numbers were also wrong (AOHPL=7 not 24, MIC_P1=9 not 19, etc).
    - New: BM64/BM64_AUDIO_DEBUG.md -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
2026-09-26 BM64: self-checking EEPROM config, keyed on the module's BD address
    A factory BM64 routes audio to I2S for the EVB's external DAC, so the
    analog pin this board taps stays silent until a handful of EEPROM bytes
    are corrected (BM64/BM64_AUDIO_DEBUG.md). Those were written by hand;
    this makes the board check and repair them itself.
    Moves the IBDK entry sequence, HCI init and ACL-based EEPROM read/write
    out of bringup.c into bt_companion, so the web UI can run them too --
    bringup's bm64_ibdk/bm64_eeprom are now thin wrappers over one
    implementation instead of a second copy. Adds:
    - bt_companion_config_check(apply, &report): reads a curated 6-byte
    table, writes only what differs, and verifies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
2026-09-27 BM64: add spkhiz codec-loading test, support multi-byte real commands
    spkhiz <line> <0|1> forces that line's ES8388 output to high-Z (DACPOWER
    LOUT1/ROUT1 disabled + VROI=40k, not just digital silence) for testing
    whether the codec's own active driver is shunting the BM64's analog audio
    on the shared Vin/Vout node -- see BM64/BM64_AUDIO_DEBUG.md's loading
    measurement. Also fixes spkamp's register_cmd help text, which still had
    the pre-datasheet-fix 0-63/1dB/33=0dB values.
    bt_companion_send_raw_cmd()/cmd_bm64_cmd only supported a fixed one-byte
    payload, which can't reach commands like Set_Overall_Gain (0x23) --
    Data_Base_Index/Mask/Type/Gain1-3, 6 parameter bytes (Microchip's Audio
    UART Comm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
2026-09-27 board: configure card-detect pin once, not on every poll
    sd_line1_conflict_task() polls read_card_present() every 2 seconds, and
    that function called gpio_config() each time. ESP-IDF's gpio_config()
    logs the resulting pin configuration at INFO level, so the console filled
    with a "gpio: GPIO[3]| InputEn: 1|..." line every 2 seconds indefinitely,
    drowning out everything else during bench debugging. Configure once and
    keep reading the level live, which is the part that actually needs to be
    fresh.
2026-09-27 Add guided hardware bring-up self-test, stored on the board
    Motivated by 2026-09-26, where two boards each had a different single fault
    and both presented identically as "no dial tone":
    - newphone line 0: SLIC's 2-wire/4-wire audio hybrid dead. DC feed and
    hook detection perfect (tip 51V -> 14V, SHK swinging), but a clean dial
    tone at Vin produced no AC on tip.
    - dualphone2 line 1: bad solder joint on the J5 SHK jumper. Audio
    perfect, hook detection never fired.
    So the design principle here: **the hook path and the audio path fail
    independently and must be tested independently.** A single "does line 0
    work?" check conflates them and misdiagnoses both. Each line therefore ge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
2026-09-27 bt_companion: actually disconnect when the feature is switched off
    Turning the Bluetooth companion off only stopped the poll task, leaving the
    module still paired, still connected, and still driving the SLIC's analog
    Vin node. On 2026-09-26 that presented as "I turned Bluetooth off in the UI
    and the phone still has no dial tone" -- the BM64 was streaming into Vin the
    whole time, contending with the codec, because a software toggle on our side
    never told the module anything.
    Now sends Disconnect (0x18) with flag bits 0|1|2 -- cancel any page still in
    progress, drop all HF links, drop all A2DP links (Microchip Audio UART
    Command Set 5.1.22) -- before stopping the task, so the module is still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
2026-09-27 Fix Vin protection schematic: clamp to +5V, and why not an optocoupler
    The clamp rail was wrong. Vin idles at ~3.9 V DC (measured), so a diode to
    +3.3 V would forward-bias continuously and short the audio away -- it has to
    clamp to the +5 V rail the SLIC itself runs from.
    Also records why a standard silicon diode beats a Schottky here, which is
    counter-intuitive: with a 3.9 V bias and the loudest measured signal at
    2.35 Vpp, the positive peak reaches ~5.1 V. A 1N4148/BAV99 (Vf ~0.7 V)
    conducts above ~5.7 V and stays clear; a Schottky (Vf ~0.3 V) would start
    clipping from ~5.3 V.
    And documents the optocoupler option as considered-and-rejected: cheap
    couplers are switching devices that badly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
2026-09-27 Board config: separate "BM64 fitted" from "BT enabled", pin BT to line 0
    Three related fixes, all from yesterday's debugging.
    1. board_hw_config_t gains has_bt_module -- whether the companion hardware is
    physically present, which is a fact about the board, as opposed to
    bt_companion_set_enabled(), which is the user's runtime choice. Conflating
    them is what let a stray enabled flag in NVS claim a phone line on a board
    with no module attached, killing dial tone with nothing to explain why.
    New bt_companion_active() = enabled AND fitted is what behavior gates on
    now; bt_companion_init() refuses to start the link with no module declared.
    2. bt_companion_line() stops deriving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
2026-09-27 Document BM64 fitting plans for SMD4 (via J5) and SMD5 (planned re-route)
    SMD4: a 2-line board takes a BM64 by pulling J5's four shunts -- line 1's
    SLIC stays stuffed but disconnected -- wiring the module's MFB/RST_N/P2_0 to
    J5's GPIO18-20 side, and configuring the board as one line + BM64 fitted.
    Firmware already handles that combination, including EEPROM programming.
    The Hardware tab hint and board.h now say so instead of just "needs a
    board without a second line".
    SMD5: marked prominently as not fabricated or tested. Records the planned
    re-route: grow J12 by a pin to put MFB on its own GPIO, do EEPROM
    programming through a separate Bluetooth-board header mating to J5, and add
    the Vin pro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
2026-09-27 Low-power idle: show whether the board is (or just was) asleep
    Adds a "Right now" row and a time-in-low-power total to the Low-power idle
    mode card, backed by a new idle_power_status().
    The catch this has to design around: any web request counts as activity and
    wakes the board, so a web page can essentially never observe "asleep" --
    loading the page ended it. Reporting only the current state would always say
    "awake" and tell you nothing. So the row reports what the board was doing
    just before: "Awake -- loading this page woke it from 35 s in low-power;
    sleeps again in 1 min". The page request also races idle_power_task()'s 50ms
    tick -- the first attempt rendered "In low-power mode (0 min)"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
2026-09-27 Adaptive WiFi TX power: back off from 20 dBm while the signal is strong
    New "Lower WiFi transmit power while the signal is strong" checkbox in the
    Low-power idle mode card, plus a live "WiFi transmit power" row showing the
    current ceiling and signal.
    Every 10s idle_power drops TX from 20 to 11 dBm once received RSSI is at or
    above -55 dBm, and restores full power below -62 dBm or on disconnect (so a
    reconnect never has to happen at reduced power). The link is roughly
    symmetric, so a strong downlink means the AP still hears us ~9 dB quieter.
    Lowering our own TX power doesn't change the RSSI we measure, so there's no
    feedback loop to oscillate -- the 7 dB gap between the thresholds only rides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
2026-09-27 Pause the audio pipeline while every phone is hung up
    The audio task ran a full I2S read -> process (tones, DTMF Goertzel, level
    metering, taps) -> write cycle every 10ms forever, even with nobody on the
    phone -- likely the biggest steady CPU load on the board. New opt-in
    "Pause audio processing while every phone is hung up" (Low-power idle mode
    card, off by default until tested by ear) disables both I2S channels and
    parks the task once idle_power reports all lines idle and nothing has used
    audio for 2s.
    Hook detection doesn't go through audio (it's the SLIC's SHK pin), so a
    paused pipeline can't miss a pickup; the off-hook -> dial tone path wakes it
    via audio_tx_tone(). More generally, rat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
2026-09-27 Dynamic CPU frequency scaling (80-160 MHz), opt-in
    Compiles in esp_pm (CONFIG_PM_ENABLE) and adds "Slow the CPU clock to 80 MHz
    between tasks" to the Low-power idle mode card, applied at runtime with
    esp_pm_configure() -- min == max pins the clock, which is how "off" is
    expressed. Light sleep stays disabled: it isolates GPIOs between wakeups,
    and the SLIC hook poll runs every 1ms anyway.
    FreeRTOS switches the clock to 160 MHz the instant any task runs, so real
    work -- including the 10ms audio frames -- always happens at full speed; only
    idle time runs slower, so audio deadlines aren't at risk. Measured on
    dualphone2 with a temporary CONFIG_PM_PROFILING build: 89% of time at
    80 MHz idle with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
2026-09-27 Docs: SHK is a 3.3 V output, so the 10k/15k divider is marginal
    The AG1171 datasheet specifies SHK as a logic output with a 3.3 kOhm
    internal pull-up (VOH 2.8 V min) -- not the 4.5-5 V swing the docs claimed
    and the SHK divider was sized for. Measured on dualphone2: 3.15 V into the
    divider, 1.88 V at the GPIO off-hook, on both lines. That's below the
    ESP32-C6's guaranteed input-high of 0.75 x VDD = 2.475 V, so whether a line
    works depends on the individual pad's switching point: line 0 (GPIO6, an
    LP-domain pad) reads it as high, line 1 (GPIO19) never sees the handset
    lift. Firmware was checked and treats both lines identically -- same config
    (input, no pulls, per the boot-time GPIO dump), an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
2026-09-28 Only route to BT passthrough when a phone is actually connected
    on_offhook()'s BT check was bt_companion_active() alone (enabled + a module
    fitted) -- not whether anything is actually paired. So a board with
    Bluetooth simply switched on, with nothing connected, went silent on every
    pickup. Found on newphone with the freshly rebuilt SLIC: `tone` played loud
    and clear over the exact physical path a real off-hook produced nothing on,
    because BT_PASSTHROUGH was intercepting the line with no live connection to
    hand it to.
    New bt_companion_should_intercept() adds bt_companion_get_status().bt_connected
    to the check, matching the design intent from archive/BLUETOOTH_AUDIO_UPGRADE.md:
    normal telepho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
2026-09-28 bt_companion: track the paired phone's call state; answer/reject/end
    Parses the BM64's Call_Status (0x02: idle / voice dial / incoming /
    outgoing / active / active+waiting / active+hold) and Caller_ID (0x03,
    ASCII number) events -- both previously fell into the "unhandled" hex dump
    -- into bt_companion_status_t, and notifies a single registered listener on
    every change. Also re-notifies when a caller ID arrives for a call already
    ringing, since the number often lands after the ring starts, and fires
    BT_CALL_IDLE when the HF link drops or the feature is switched off mid-call,
    so a ringing bell always gets told to stop.
    Adds bt_companion_accept_call()/_reject_call()/_end_call() (MMI actions
    0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
2026-09-28 Ring line 0 for the paired phone's calls; answer on pickup, end on hangup
    An incoming call on the Bluetooth-paired phone now rings line 0 (the line
    the companion's audio is wired to), and the handset behaves like a
    Bluetooth headset:
    - Lifting the handset while it rings answers the call (MMI accept) and
    goes to passthrough; ag1170's ring-trip path already silences the bell.
    - Answering or declining on the phone itself stops the bell. An answered
    call stays on the phone, and lifting the handset afterwards still picks
    it up, since a live connection routes pickup into passthrough.
    - The caller giving up stops the bell and logs a missed call, with the
    caller ID when the phone sent one.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
2026-09-28 Bluetooth calls: route answer/hang-up to the right connected device
    The BM64 can hold two devices at once (a phone and a laptop), and every
    Call_Status/Caller_ID event carries a Data_Base_Index saying which one it's
    about. All call-control MMIs were going to device 0, so with two connected a
    call on the second would ring the rotary phone, and picking up would send
    "answer" to the wrong device.
    Now call state and caller ID are tracked per device, and each command picks
    its target: accept/reject go to the device that's ringing, end goes to the
    one with a live call. That matters beyond the obvious case -- with the phone
    mid-call and the laptop ringing, answering must reach the laptop and hangi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
2026-09-28 bringup: miclevel command -- handset mic peak/RMS/clipping check
    Taps the line's diag RX tap while you talk and prints a live peak/RMS meter
    plus a summary: peak dBFS, loudest-window RMS, clipped and near-full-scale
    sample counts, and an estimated voltage at the codec pin (from ES8388 ADC
    full scale and the current PGA). On line 0 it also relates that level to
    the BM64 MIC_P1 full-scale range, since the same SLIC VOUT feeds both.
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2026-09-28 Rename BM64/ to Bluetooth/; add the BM64 carrier board KiCad project
    Moves the BM64 research notes, EEPROM-write analysis, probe scripts and
    Arduino bridge under Bluetooth/, alongside the carrier board's KiCad
    project (Bluetooth/Bluetooth_board, previously untracked under
    hardware/kicad/). .gitignore follows the rename so Microchip's DSPK
    package and datasheets stay local-only, and the carrier board gets the
    same KiCad local-file rules as hardware/kicad/. Path references in docs
    and code comments updated.
2026-09-28 README board photo, SD self-test heap fix, SMD5 KiCad project, doc path fixes
    - README: SMD4 board photo (docs/pics/) and wording tweaks
    - sdcard: self-test reuses one buffer for read-back (halves peak heap;
    256KB contiguous wasn't available on a busy single-line board)
    - SMD5 defaults / firmware README: point at ANALOG_REDIAL_SMD5.md
    - Add the Analog Redial 5 (SMD5) KiCad project (schematic, PCB, dual
    DevKitC footprints); SMD2/SMD4 KiCad project/PCB touch-ups
2026-09-29 Pin ESP-IDF v5.2.8 and managed-component versions across machines
    - firmware/CMakeLists.txt: warn at configure time when the ESP-IDF in use
    isn't the pinned v5.2.8 (a mismatch rewrites the tracked sdkconfig)
    - Docs: clone -b v5.2.8, not -b v5.2 -- the latter is the 5.2.0 *tag*,
    which is how the laptop ended up on 5.2.0 while work had 5.2.8
    - Track firmware/dependencies.lock (mdns 1.13.1, led_strip 3.0.3): with it
    gitignored each machine resolved its own mdns, and its Kconfig options
    churned sdkconfig too
    - sdkconfig: the four options 5.2.8 derives from CONFIG_PM_ENABLE
2026-09-29 bt_companion: readable BM64 state events, log paired-device records
    Device-state events now print their name from the command-set spec (e.g.
    'call audio (SCO) up'), the Read_Paired_Device_Record reply (0x1F) is
    decoded at INFO, and remaining unhandled events log at INFO instead of
    DEBUG -- all for chasing silent call audio and failed reconnects.
2026-09-29 bt_companion: max call speaker level when call audio starts
    First real test calls (WWV) came through faint: the phone restores its
    remembered call volume per headset, and it reported level 4/15 (event
    0x0F). A rotary handset has no volume control, so on SCO-up send
    Set_HF_Speaker_Gain_Level 0x0F; the phone's buttons still adjust it.
    Also decode the HF gain and call-codec events, and drop the phone
    battery/signal/ringtone chatter to DEBUG.
2026-09-29 bt_companion: take 'phone connected' from the link-status poll too
    With the BM64's RST_N no longer bench-wired (it reset the module on every
    ESP32 reboot, losing the pairing), a phone stays linked across our reboot
    and no link-up event arrives, so bt_connected stayed false and dial-out
    would refuse. The 2 s Read_Link_Status reply's Device_State now sets it.
    Notes: RST_N stays unconnected in normal use; test results from newphone.
2026-09-29 bt_companion: release MFB once the BM64 answers (held MFB wiped pairings)
    MFB is the BM64's power button (EEPROM 0xAE bit0 = 0) as well as its UART
    RX_IND. Holding it high from power-up is a press that starts while the
    module is off, and past reset_to_default_timer (0x1AC) that's a MASTER
    RESET clearing the paired-device list -- which is why every cold boot lost
    the phone's pairing even after the module reported saving its EEPROM.
    Bench test: with the module on, the UART works with MFB low; with it off
    and MFB low, the module ignores the UART. So raise MFB to wake/power it,
    drop it at the first valid reply. SMD5 note: never pull MFB up permanently.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
2026-09-29 bt_companion: drive MFB per the BM64 datasheet timing
    MFB idles low (the module sleeps in 32 kHz mode); power-on raises it for
    400 ms before the power-on command and hands it back once the module
    answers (Fig 5-3/5-6); every UART command gets a 1 ms wake pulse, 2 ms
    low, then MFB high >= 150 ms around the frame (Fig 5-4) -- the same
    pattern the reference Arduino library uses (txInd high around each
    write). Replaces holding MFB high forever, which the module reads as a
    power button held from off -> master reset -> pairing list wiped.
    SMD5 notes: 100k pull-down on MFB; RST_N NC or pulled up.
2026-09-29 docs: GPIO12/13 are the native-USB flash/console pins, not free
    hardware.md listed them as unconnected/free and the SMD5 notes called
    native USB unused, but every SMD board is flashed and monitored over
    USB-Serial-JTAG on exactly these pins, and the ROM enables USB on them
    at every reset. Came up choosing an SMD5 GPIO for the BM64's MFB.
2026-09-29 SMD5 clone module: MCLK/SD-CD on GPIO12/13, detach USB PHY at boot
    The dual footprint puts the I2S_MCLK and SD_CD nets on pads 12/13, which
    are the clone module's GPIO12/13 (native USB), not GPIO2/3 as on the real
    module -- so a clone-fitted board had no MCLK (no audio) and no card
    detect. SMD5_CHEAP now maps them there, and board_early_pin_init() detaches
    the USB-Serial-JTAG PHY and its D+ pull-up from those pads before audio
    starts (IDF's GPIO driver doesn't). Notes record the remaining clone-only
    conflict: UART0 console vs. the BM64 on GPIO16/17.
2026-09-29 SMD5: MFB on its own pin (GPIO15), console command to reboot into download mode
    - board_pins_smd4.h: BOARD_BT_MFB_PIN = GPIO15 + BOARD_BT_MFB_DEDICATED for
    both SMD5 variants (GPIO8 is the DevKit RGB LED, GPIO9 the download strap;
    GPIO15's strapping role needs an eFuse that ships unburned)
    - bt_companion/bringup: a dedicated MFB no longer needs the single-line,
    no-microSD gate -- only RST_N/P2_0 on the shared GPIO19/20 pads still do
    - bringup: 'download' command -- quiets codec/SLICs, sets the force-
    download-boot bit and restarts, so the ROM keeps native USB alive. Needed
    on the clone variant, where GPIO12/13 become MCLK/SD-CD ~1s into boot and
    the USB device vanishes from the h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
2026-09-29 SMD5 notes: document the MCLK/card-detect solder-jumper plan
    Restructures the module-swap section around the real Espressif module as
    the default build, with a single 'what's different' list for the clone.
    Adds the planned fix: 3-pad solder jumpers (Jumper:SolderJumper_3_Bridged12)
    on I2S_MCLK and SD_CD selecting footprint pad 12/13 (real module GPIO2/3,
    pre-bridged default) or pad 19/20 (clone GPIO2/3), so both variants land on
    GPIO2/GPIO3 in firmware and native USB keeps its own pads either way --
    which also retires the clone pin map and the USB-PHY detach once fitted.
    Folds in the J3/J4 stub cleanup and corrects the now-stale claim that the
    two SMD5 board types share a pin map.
    Co-Author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
2026-09-29 SMD5 + BM64 carrier: dedicated 3.3V rail, MFB pin, Vin protection, 8-pin link
    Schematic work from the last few sessions' decisions:
    SMD5 (Analog Redial 5)
    - U5 XC6206P332MR (SOT-23) from +5V with C25/C26 1uF -> new +3V3_BM rail
    feeding the BM64 only, off the DevKit's own 3.3V
    - BM64 header J12 -> J2, 6 -> 8 pins: +3V3_BM, AOHPL, MIC_P1, MIC_N1,
    U0RXD, U0TXD, MFB, GND
    - MFB on GPIO15 with R17 100k pull-down (it's the BM64's power button --
    held from power-up it master-resets the pairing list)
    - R16 1k in series into Line0Vin, and C23 10uF 0805 -> 1uF for the AOHPL
    coupling cap (Vin is 60k, not the few hundred ohms it was sized for)
    - C24 1uF from MIC_N1 to GND (the differential mic i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
2026-09-29 SMD5 notes: symptoms of a wrong MCLK/card-detect jumper
    The failure mode is silent -- MCLK is an output into an open pad, I2C is on
    other pins, so codec detect and es8388 init still pass and only audio is
    gone. Table of module x jumper x firmware outcomes, what it looks like from
    the console, and the scope check (12.288 MHz at U2 pin 1) that separates it
    from a dead codec.
2026-09-30 SMD5 notes: SparkFun solder-jumper symbol numbers two pins as pad 2
    Its SolderJumper_3_Bridged12_No_Silk symbol has A=1, B=2, C=2, so wiring
    the two outer pins to different nets fails ERC with pad 2 on multiple nets
    and leaves pad 3 unconnected. The footprint is fine; swap to KiCad's stock
    Jumper:SolderJumper_3_Bridged12 (A=1, C=2, B=3 -- wire by number) and keep
    the footprint, so nothing moves on the PCB. Also records that the NC-1
    footprint closes one gap and NC-2 closes both.
2026-09-30 Add BOM for the optional Bluetooth companion
    Carrier board (BM64 module, 8-pin socket, programming header) plus the
    main-board parts that exist only for this option (8-pin header, the 3.3V
    LDO and its caps, the coupling caps, the Vin series resistor, the MFB
    pull-down). DigiKey links carry live prices; AliExpress/Amazon block
    automated fetches, so those are hand-entered.
    Also records which BM64 suffix to order: -0003AA is DSPK 2.1.5, the
    firmware whose parameter table our EEPROM byte addresses came from.
    -0002AA is 2.1.2; -00M3AA's meaning could not be confirmed.
2026-09-30 BOM: real DigiKey/AliExpress prices, per-table totals, flash-size and C10/C11 notes
    - Hand-solder table: live prices for the carrier (DevKitC-1-N8 $9.00),
    AG1171 ($8.50 / AliExpress $3.79), RJ12 ($1.07 / $3.38 per 10), the
    2x4 J5 header (SSK03-MPH-254-B4 $0.13) and the 470uF bulk cap ($0.42,
    up from the $0.24 recorded before). Totals per build, and the note that
    AliExpress saves ~$9.50 on the three big items while giving 16MB flash
    - New 'Flash size' section: the app (~1.5MB) fits an 8MB part fine; what
    shrinks is /assets, so the recording cap needs lowering -- partitions.csv
    edit, not a code change
    - C10/C11 (100uF 1206, Extended) were missing from the JLC BOM entirely.
    Added,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
2026-09-30 BOM: TVS + DC jack parts, THT option for C10/C11, concrete 8MB checklist
    - Line TVS: P6KE82A (Littelfuse) $0.75 + AliExpress, with the caveat that
    it's DO-204AC/DO-15 against the board's DO-41 pads; BZT03C82 kept as the
    genuinely-DO-41 alt. New section on when it can be skipped -- it clamps at
    113 V, above anything the board produces, so it only guards against
    surges arriving from outside wiring
    - DC jack: EJ508A $1.25 + AliExpress, flagged to verify against the
    Barrel_Jack_PTH_Slot footprint. Totals now cover every row ($31.86 / $20.99)
    - MCU row: N16 recommended, N8 acceptable with less recording room
    - C10/C11: added the fit-a-THT-footprint-and-DNP option
    (CP_Radial_D6.3mm_P2.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
2026-09-30 BOM: clearer TVS rationale, BZT03C82-TR link, THT cap lead-spacing table
    - TVS: spell out the two failure modes it guards against -- someone plugging
    a board jack into a live phone line, and surges/ESD off outside wiring --
    and mark it optional-but-recommended rather than just optional
    - Add the BZT03C82-TR listing ($2.17, SOD-57) with the caveat that it's a
    1.3 W zener, not a 600 W TVS: same clamp voltage, far less surge energy,
    and dearer than the P6KE82A
    - DC jack: AliExpress part verified to fit; EJ508A footprint still unchecked
    - C10/C11: lead-spacing table for THT caps (100 uF is 6.3 mm can / 2.5 mm
    pitch), plus the correction that C_Disc_* is ceramic-only so it can't hold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
2026-09-30 BOM: drop BZT03C82, record C10/C11 as a 5 mm THT footprint left unpopulated
    P6KE82A is the only TVS option now -- the zener alternate was dearer and far
    weaker. C10/C11 are a 5 mm-pitch THT footprint, DNP: fit 1 uF to use J7,
    with room to splay a 6.3 mm electrolytic in if headphone drive is ever
    wanted.
2026-09-30 BOM: drop the SMT passive tables, add the missing hand-solder parts
    - SMT section now lists only the parts worth naming -- ES8388, the microSD
    socket, the tip/ring bridge and the diode-OR -- and points at the KiCad
    project for the full list, which is authoritative anyway
    - Hand-solder table was missing J3/J4 (UART breakout), J7 (audio monitor
    header), the four J5 shunts and H1-H4 mounting hardware
    - **The TVS is one per board, not one per line**: the netlist shows both
    lines' bridges (D4-D11) meeting at the shared /P6K node that D12 clamps.
    Build A total drops to ~$31.11
    - C10/C11 moved into their own subsection with the polarity answer: + toward
    the ES8388, since LOUT2/ROUT2 idl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
2026-09-30 BOM: restructure around build options, trim to required parts
    Hand-solder BOM is now additive rather than one table with build caveats:
    base board (~$18.99: ESP32 + SLIC + bulk cap + RJ12), add second line
    (+~$10.12, doubling those plus the 2x4 header and shunts), add Bluetooth
    (+~$14.97: 8-pin header, carrier PCB, BM64), and a short optional table for
    the DC jack and the TVS. Fully loaded ~$46.08.
    Dropped the J3/J4 UART breakout, J7 monitor header and M3 hardware -- they
    aren't needed to get any option working. Dropped the tip/ring bridge and
    diode-OR from the SMT list too; the KiCad export has them.
    C10/C11: back to the 5 mm disc footprint (electrolytic cans were too big),
    47 uF nominal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
2026-09-30 BOM: J5 into the base build, and a section per option explaining it
    - J5 2x4 header moves into the base board at $0.13: a second line needs it
    and so does Bluetooth, and two 1x4 strips off a stock rail work as well
    - Second line: spells out that it rules out microSD, and that the firmware
    powers line 1 down with a banner if a card shows up on a 2-line board
    - Bluetooth: needs a second PCB fabricated, the BM64 is surface-mount (reflow
    oven or hotplate, not an iron), and it borrows J5 for EEPROM programming
    - DC jack: either input needs ~2 A -- USB-C charger or a 5.5-6 V DC brick
    (the OR diode eats ~0.4 V). Sized for two SLICs ringing during a WiFi
    burst, which is what browns out an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
2026-09-30 docs: board type in the menuconfig steps, 2 A supply, BOM covers SMD4/SMD5
    getting-started never mentioned the Target board type choice at all, even
    though Kconfig still defaults to the old through-hole board -- and picking
    it wrong on a clone-populated SMD5 costs audio entirely, since MCLK lands on
    the wrong pin. Also states the 2 A supply requirement up front.
    bom.md retitled: it already documents SMD5-only options (Bluetooth, the
    30-pin clone), so the SMD4-only title was wrong.
2026-09-30 docs: split hardware reference into SMD4 and SMD5, archive signal-levels
    - docs/hardware.md -> hardware-smd4.md (unchanged content, plus a note that
    Bluetooth needs hand-wiring here and is designed in on the next spin)
    - docs/hardware-smd5.md: same board reference with the SMD5 changes -- a
    'what's new' table, MFB on GPIO15, the clone module's MCLK/card-detect
    swap, the SHK divider as fixed by design rather than an as-built defect,
    and two new sections: the 8-pin Bluetooth header pinout and the MCU
    module variants
    - docs/signal-levels.md -> archive/signal-levels.md; it's background, not
    something a builder needs
    - cross-references updated across README, CLAUDE.md, docs/ and archi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
2026-09-30 docs: name the SHK rework resistors, confirm C5446 for the BM64 LDO
    - SHK rework note now names the parts to lift: R14 (line 0) and R12 (line 1)
    are the 15k pull-downs; R15/R13 stay. Records that removing both is
    confirmed on hardware, not just calculated
    - BM64 LDO: LCSC C5446 verified as XC6206P332MR-G, SOT-23-3L, a JLC Basic
    part at ~$0.14 -- no Extended fee. Added a caution that its ~6 V input
    ceiling leaves little margin if the DC jack runs at the top of the
    recommended 5.5-6 V range
2026-09-30 docs: real board dimensions, and hole sizing for a solderless header
    Board size was recorded as ~100x50 mm for both spins; the Edge.Cuts
    outlines are 110x54 (SMD4) and 115x54 (SMD5). SMD5 is 5 mm longer, so it
    needs its own enclosure -- called out in the what's-new table too.
    Added hole-size guidance for the BM64 programming header: 0.9 mm drill
    (~0.85 mm finished) is the snug figure against a 0.90 mm pin diagonal, but
    JLC's +-0.08 mm hole tolerance is wider than that interference, so friction
    alone isn't repeatable. Staggering alternate holes or tack-soldering two
    pins is better -- and a flaky contact matters here because the header's job
    is writing the BM64's EEPROM.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
2026-09-30 SMD5 notes: explain the staggered-hole header fit properly
    Replaces a one-line assertion with the reasoning and two diagrams:
    interference fits are dimension-controlled and lose to the fab's +-0.08 mm
    diameter tolerance, whereas a staggered row is force-controlled -- grip
    comes from elastically deflecting straight pins by an offset you draw, and
    hole position is better controlled than hole diameter.
    Also corrects the earlier overstatement that this is 'the standard trick':
    real press-fit uses compliant eye-of-the-needle pins, so with plain square
    posts it's the pin that bends. Suggests prototyping 0.05/0.10/0.15 mm on a
    test strip rather than trusting a figure.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
2026-09-30 SMD5 + carrier: solder jumpers, C10/C11 to a disc footprint, 2-pin programming header
    - SMD5: JP2/JP3 solder jumpers placed; C10/C11 100 uF 1206 -> 47 uF on
    Capacitor_THT:C_Disc_D4.7mm_W2.5mm_P5.00mm (DNP, fit 1 uF to use J7)
    - Carrier: programming header down to 2 pins (P2_0, RST_N) now that MFB
    reaches the module through the main 8-pin link -- this also removes the
    hazard of MFB being driven from two connectors at once
    - Cross-reference fixes missed by the hardware-doc split commit
    - .gitignore: the Bluetooth carrier lives outside hardware/kicad/, so repeat
    the jlcpcb/, production_files/, tmp*.rpt and _restore_backup_* rules there
    KNOWN ISSUE, not fixed here: carrier J1 pins 2 and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
2026-09-30 kicad: consolidate custom footprints/3D/symbols into libraries/
    Move all per-project Scott.pretty, JLCImport.pretty, .3dshapes, and
    .kicad_sym files into a single shared kicad/libraries/ directory.
    Rename "Scott" library to "Custom" throughout. Update fp-lib-table,
    sym-lib-table, .kicad_pcb, and .kicad_sch files in all 6 board
    projects to resolve Custom: and JLCImport: via ${KIPRJMOD}/../libraries/.
    Also fixes broken 3D model paths (hardcoded /Users/... and
    _restore_backup_ references in SMD3/SMD4/AR5 PCBs).
    Generated with [Devin](https://devin.ai)
2026-10-01 docs: use-model diagrams and a board-assembly page
    Three SVG diagrams (white background, matching the logo's palette) for the
    deployment models -- intercom, VoIP, and Bluetooth-as-cell-handset -- with a
    'What people build with it' section leading the README.
    New docs/building.md covers the path most people take: a board that arrives
    with the SMT side done, hand-soldering the through-hole parts. Solder order,
    socketing the DevKit, the dual-line vs microSD jumper choice, the phone-line
    voltage warning, a pre-power multimeter checklist, first power-on, and the
    SMD4 15k hook-switch rework. SMD5 differences noted inline.
    getting-started now opens by pointing at building.md for anyone who hasn't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
2026-10-01 BOOT button: 3 s for a rescue web UI, 10 s to factory-reset WiFi
    The 3 s hold used to erase WiFi credentials outright, which is the wrong
    thing to have on the shorter gesture. Now:
    ~3 s, then release -> reboot into the setup SoftAP with credentials
    intact, so the full web UI is reachable from a phone when the board's
    usual network isn't -- a demo on someone else's site, a wrong
    password, a router that's moved on
    ~10 s -> erase credentials, as before
    The LED switches at the 3 s mark so you know when to let go, and the log
    says which gesture you're in. The AP flag is one-shot in NVS: the next
    ordinary reboot rejoins the saved network. A forced AP serves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
2026-10-01 docs: bring-up console commands, and correct the BOOT-button section
    Section 9 still described the 3 s hold as a factory reset; it now brings up
    the rescue AP with credentials intact, and 10 s is the erase. Documents both
    with a table, and spells out the on-site case the short hold exists for.
    Adds a console-command table to the flashing section -- selftest, hookmon,
    pulsemon, miclevel, dialtone and friends -- with a suggested first sequence
    and the warning that opening the port resets the chip.
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2026-10-01 docs: international dial tones in the feature list, multi-function button note
    Adds the planned SMD5 multi-function button: its own GPIO rather than the
    BM64's MFB pin (a human-length press on MFB is the gesture that master-
    resets the module and wipes pairings), GPIO12/13 as candidates pending the
    jumper rework, and click/3s/10s gestures reusing the existing BOOT watcher.
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2026-10-01 WiFi: remember several networks and join the strongest in range
    One saved SSID meant re-provisioning every time the board moved. Now up to
    five are stored (ssid0..ssid4 in NVS), and at connect time it scans and
    joins whichever saved network has the strongest signal -- so carrying it to
    a friend's house just works once theirs is saved. If the scan sees none of
    them it still tries the first entry, since a hidden SSID never appears in a
    scan. After five consecutive failures it re-scans and re-picks rather than
    hammering one SSID, which is what a board that has physically moved needs.
    Boards with the old single 'ssid'/'pass' pair migrate into slot 0 on first
    read, so nothing is lost. Both save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
2026-10-01 WiFi list UI, quiet hours no longer forces the answering machine, 9xx -> 8xx
    - WiFi card gains a Saved networks table with a Forget button per row;
    saving adds rather than replaces, and the active network is marked.
    Forgetting the current network doesn't drop the live connection
    - Quiet hours: if a line's answering machine is off, the board now stays
    silent and simply never answers, so the caller hears ringback until they
    give up. It used to force the AM on, which piled up messages on a machine
    the owner never set up. Deliberately not a busy signal -- that would
    suggest someone is awake and on the phone
    - Dial codes 921/922/999 -> 821/822/899, freeing the whole 9xx block for a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
2026-10-01 bringup: first_setup.py, one command to set up a freshly flashed board
    Checks the board answers, runs the hardware checklist, sets the hardware
    config remotely, then generates and uploads the default spoken prompts and
    digits 0-9 in the chosen language. Every step is skippable and idempotent,
    so it doubles as the way to change one thing later.
    The operator message is assembled from what the board actually is -- a
    single-line board isn't told to dial 321, and the Bluetooth sentence only
    appears when a companion is fitted. Default wording for all five UI
    languages.
    Orchestrates gen_prompt.py and bringup_checklist.py rather than duplicating
    them. Digits are generated against the planned spoke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
2026-10-02 BK3266: pinout reference, daughter-board header plan, S/R correction
    Pinout table from the BK3266SR manual's own IO description, cross-checked
    against the reference schematic. Power input is VBAT (pin 37); the old
    wiring sketch fed 3.3 V into VCC3YS, which is a 3 V output.
    8-pin companion header mirrors the BM64's J12: VBAT, audio each way,
    UART, GND, WAKEUP on GPIO15. Call control, pairing and status all have
    UART equivalents, so no other GPIOs. MICN gets an AC-ground cap on the
    daughter board, as MIC_N1 does on the BM64 carrier.
    S/R is a mode-indicator output (high in transmit, low in receive, drives
    an LED in the reference design), not a strap -- an earlier draft said to
    ground it. The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
2026-10-02 BK3266: diagnostic header becomes 1x6 with COM, no shunts
    Buttons are active-high and a long hold powers off or re-pairs, so a
    jumper header has no safe shunt position. Switch to a 1x6 probe header:
    S/R and STAT outputs behind 1k series resistors, GND, and MODE/PP/CALL
    either side of a COM pin fed 3.3 V through 10k (the reference board's
    R6), so a press is a tweezer bridge and a slipped probe does no harm.
    Note that the LED pin sources current (anode on the pin, 1k to GND).
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2026-10-02 BOM: JLCPCB board + assembly cost by order quantity
    Per-board cost for 5, 30 and 160 (20 panels of 8) SMD5 boards from
    2026-10-02 JLC quotes, with shipping, sales tax and import tariff broken
    out. Tariff modelled as ~47.5% of merchandise, from two real DDP invoices
    (47.2%, 47.7%); shipping from cart estimates, noted as weight-based.
    Small orders are dominated by fixed per-order fees.
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2026-10-02 TVS: Taiwan Semi P6KE82A source; correct the line-protection description
    Checked D12 against the netlist: each line's tip and ring steer through
    M7 diodes to GND (D4-D7) and to a shared /P6K bus (D8-D11), and one
    unidirectional TVS (D12, cathode on /P6K) clamps the bus for both lines.
    That is the AG1171 datasheet's Figure 4 circuit ('only one needed per
    line card'), so a unidirectional P6KE82A is right.
    The hardware docs described the bridge as an in-series polarity
    corrector with the TVS across tip/ring, and building.md called D12
    bidirectional with no polarity; both fixed. BOM: Taiwan Semi P6KE82A
    ($0.58, in stock) becomes the primary DigiKey source, Littelfuse the
    alternate; the plain-P6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
2026-10-03 bringup: build bm64_pin only on boards that define the BM64 pins
    cmd_bm64_pin referenced BOARD_BT_MFB_PIN/_RST_PIN/_P20_PIN, which only
    the SMD4/SMD5 pin map defines, so the SMD2 (and THT) build failed to
    compile. Guard the command and its registration with #ifdef
    BOARD_BT_MFB_PIN, the same check bt_companion.c already uses.
2026-10-03 bringup: gated first_setup.py; fix serial prompt and setup bugs
    first_setup.py is now a sequence of gated steps -- chip (opt-in esptool
    read of chip/flash/MAC), console, codec, network, hardware, microsd,
    audio, verify, tests (opt-in) -- each running only if what it depends on
    passed, ending in a PASS/WARN/FAIL/SKIP table. microSD is skipped on
    2-line boards, warned about if no card is in use, and otherwise given
    sd_test's write/read/verify. Audio now includes the answering machine's
    am_greeting_l<N>.wav ('Leave a message after the beep'); the 211 record
    prompt gets its own wording. Uploads are read back to verify.
    Bugs fixed on the way:
    - /board_hw_set was sent lines=2/sd/1; the firmware o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
2026-10-03 wifi: one connection manager -- 3 tries per visible network, then setup AP
    Replaces the retry logic spread across the event handler with a single
    manager task:
    - scan; only saved networks that are on the air are tried, so a missing
    network costs nothing
    - the network it was last on goes first, then the rest strongest first,
    3 attempts each (15 s timeout per attempt)
    - if none connect, bring up the setup AP, and rescan every 60 s (not
    while someone is joined to the AP); join and close the AP as soon as a
    saved network reappears -- e.g. a router that boots slower than the
    board after a power cut
    - on a dropped link, start over with the same network first
    - wifi_set_credentials() now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
2026-10-03 8 MB flash layout and flash_board.py; fix SD self-test, port handling
    8 MB modules: partitions_8mb.csv keeps both 1.75 MB OTA slots and the
    2 MB bundled partition and shrinks storage from 6 MB to 2.375 MB
    (recording cap 1.5 MB). Selected by sdkconfig.8mb.defaults, layered last
    into a build.<board>_8mb/ directory. Adds sdkconfig.smd4.defaults so an
    SMD4 build dir other than build/ doesn't fall back to Kconfig's default
    THT board. SMD2 and SMD4 8 MB images both build.
    flash_board.py reads the board type from the running firmware's
    board_info (new pcb: and pcb_recorded: lines) or --board, reads flash
    size with esptool, creates/picks the build dir, builds, flashes, and
    checks the board comes ba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
2026-10-03 Setup network named after the board: 'Analog Redial - <name>'
    A board with a saved name now advertises its setup AP as
    'Analog Redial - <name>' (cut to the 32-byte SSID limit without
    splitting a UTF-8 character); a brand-new, unnamed board keeps
    'AnalogRedial-XXXX' from the MAC. New wifi_setup_ap_name() builds it.
    The web UI shows the real name: Settings -> Reset hint, the WiFi-cleared
    reboot page, and the factory-reset page (which, after the NVS erase,
    correctly gives the unnamed form). Docs updated where a named board is
    described. Verified on the SMD2: 'Analog Redial - Telephono'.
    flash_board.py: if the console doesn't answer -- e.g. a board asleep in
    low-power idle after 5 idle minutes,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
2026-10-03 Setup page: network list stuck on 'Scanning...' -- page was truncated
    The captive setup page's buffer size was a hand-kept sum of each
    argument's length. Adding the language selector (label + ~400 bytes of
    options with flag emoji) didn't add to that sum, so the page came out
    short and the cut fell on the closing <script>: the network list never
    left 'Scanning for nearby networks...' and /api/wifi_scan was never
    requested. The scan itself was fine -- the new wifi_scan console command
    found 9-11 networks with the setup AP up. The page is now measured with
    snprintf(NULL, 0, ...) and allocated to fit, so it can't drift again.
    Also logs each /api/wifi_scan request (count, time, whether the setup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
2026-10-03 wifi: pause between connect retries; allow WPA3; sturdier console detection
    Retries: after entering a password on the setup page the SMD2 rebooted,
    burned all three tries on 'Metolla at 8720' within one second (each
    failing in ~0.3 s with AUTH_FAIL 202), opened the setup AP, then joined
    the same network with the same password on the next 60 s pass. Routers
    often refuse an immediate retry, so attempts now wait 2 s before try 2
    and 4 s before try 3 (a credentials change still interrupts the wait).
    WPA3: the STA config set no SAE method (zeroed = unspecified) and left
    PMF off, so WPA2/WPA3 mixed networks were joined as WPA2 and WPA3-only
    routers requiring hash-to-element could never authentica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
2026-10-03 Grey out untranslated languages; link the two-line DigiKey list
    Language pickers (header and setup page) now show a language as
    disabled, '-- not translated yet', unless this board has its string
    table (i18n_<code>.json in storage); English is built in. The current
    language stays selectable either way. Verified on the SMD2: all four
    greyed out; uploading i18n_de.json enabled Deutsch, deleting it greyed
    it out again. One shared option builder replaces the two copies, and
    the setup page's option buffer grows from 400 to 800 bytes for the
    longer labels.
    BOM: link to the DigiKey parts list for a two-line board.
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2026-10-03 docs: real clone URL, trim pinout tables to schematic images, fix drift
    - README.md / getting-started.md: the placeholder <this-repo-url> is now
    the real clone URL (https://github.com/sdylewski/Analog-Redial.git --
    note the repo is still private, so this won't resolve for anyone else
    until it's made public).
    - hardware-smd4.md / hardware-smd5.md: replaced the hand-copied GPIO/
    ES8388/Card1 pin tables (which only ever drifted from the real
    schematic) with the actual schematic and PCB top/bottom layout,
    rendered via kicad-cli + pdftoppm/rsvg-convert into docs/pics/. Kept
    every table that carries real narrative -- J5 jumper wiring, the SHK
    divider rework, the TVS/steering-diode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
2026-10-03 Per-chip default board name, dimmer LED, LED reference doc, flash timing fix
    board.c: unnamed boards now default to one of ten short words (red, blue,
    green, gold, teal, coral, plum, amber, slate, rose), picked deterministically
    from the station MAC's last byte rather than a generic "phone" every board
    shares -- memorable and spellable where "phone2.local" wasn't, stable across
    reboots since it's derived from the chip rather than random or persisted.
    The existing mDNS collision check in wifi_apply_hostname() still applies on
    top: two boards landing on the same word still bump to e.g. "coral1".
    webui.c: the captive setup page gets an optional Board name field -- type
    one up front, or leave i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
2026-10-03 Consolidate the through-hole/WM8731 board's docs into one directory
    WM8731.md and BOM-through-hole.md move from archive/hardware/ into a new
    archive/hardware/through-hole-wm8731/, with a BRINGUP.md pulled out of
    firmware/README.md alongside them (its hand-typed console walkthrough was
    specific to the WM8731 board -- wm8731_init/wm8731_dump/wm8731_bypass
    don't exist on an ES8388 board) and a README.md indexing the three.
    Firmware support for this board is untouched -- CONFIG_BOARD_TYPE_THT,
    board_pins.h, components/wm8731/ all stay exactly as they are. This is
    documentation only, per CLAUDE.md's "don't remove without asking" on the
    firmware side.
    Fixed on the way:
    - firmware/README.md's int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
2026-10-03 Consolidate the SMD2 board's docs into one archive/hardware/smd2.md
    Only 3 SMD2 boards were ever built, long since superseded by SMD4 --
    merges three previously separate files into one: ROTARY_PHONE_SMD.md
    (the design reference, including the DTMF/clipping bodge-fix history and
    known bugs), BOM-smd.md (parts list), and the SMD2-specific sections
    (1B: ES8388+AG1171 DTMF clipping root-cause + resistor-divider rework,
    1C: AEC echo timing measurements on DualPhone/MaxPhone) pulled out of the
    old archive/HARDWARE_SIGNAL_LEVELS.md, which covered both this board and
    the through-hole/WM8731 board in one doc.
    That file's WM8731/AG1170-general sections move to
    archive/hardware/through-hole-wm8731/SIG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
2026-10-03 Collapsible setting hints, non-blocking self-test steps, "phone" default name
    Web UI: the longest setting descriptions now show a one-line summary with a
    "more detail" toggle (native <details>, no JS); hint text is 14px instead of
    13px everywhere.
    Self-test: "Watch for it now" (up to 15s) and "Ring it now" (4s) ran inside
    the single httpd worker, so every other page hung until they finished. They
    now run on a background task; the Diagnostics page auto-refreshes while one
    is in progress.
    Board name: drop the per-chip color-word default and go back to "phone",
    relying on the existing mDNS collision check (phone1, phone2, ...). The
    post-setup page still shows the address in large text.
    Co-Au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
2026-10-04 Prepare to give away; numbered names only last until reboot
    - New Settings -> Hardware -> Reset -> "Prepare to give away" (and
    first_setup.py --giveaway, which only runs it if every step passed):
    forgets all saved WiFi networks and the board name, keeps hardware
    settings, prompts/audio, setup password and self-test history, and reboots
    into setup mode. The recipient then gets the setup network and phone.local.
    - A name clash (phone -> phone1) is no longer saved: the web UI, mDNS and
    DHCP name all show phone1 for this boot only, so a board prepared next to
    another one is plain phone.local where it's alone. Names typed in the web
    UI are still saved.
    - Fix: Re-provision WiFi (and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
2026-10-04 smd2.md: document the USB D+/D- swap rework and a rework checklist
    The USB swap was only mentioned in passing ("unlike the USB D+/D- bodge")
    and never described. Adds it as a KNOWN BUG section, including the symptom
    of crossing the wires without cutting the original traces (both lines ~2.9 V,
    no USB device), plus a five-item rework checklist at the top for any bare
    SMD2, and a note that no BOOT jumper is needed to flash over USB.
2026-10-04 One "Reset WiFi" button; SMD5 notes updated for the fab version
    - Reset WiFi now forgets saved networks AND the board name (what "Prepare to
    give away" did), so one button covers moving a board and handing it over;
    the separate button and /prepare_giveaway are gone. first_setup.py's
    --giveaway is now --reset-wifi.
    - SMD5 sent to fab with the BM64 carrier and a BK3266 test board. Dev notes
    and docs/hardware-smd5.md now describe the fabricated design, checked
    against the schematic netlists: 8-pin J2 BM64 header with MFB on GPIO15
    (R17 pull-down), JP3/JP2 MCLK/card-detect jumpers (a clone board can run
    the normal SMD5 build), 100k SHK divider. Fixes the public J2 table, which
    ha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
2026-10-04 In-call voice effects: 5 Dalek, 6 chipmunk, 7 deep, 8 8-bit, 0 normal
    During a call, a touch-tone key (or a rotary-dialled digit) sets a voice
    effect for everyone on the call: both directions of a local bridge, or both
    the far end's voice and this line's uplink on a VoIP call. Set, not toggle,
    since the key tone can echo into the other phone's detector too.
    - components/audio/voice_fx.c: fixed-point (the C6 has no FPU). Dalek is a
    30 Hz ring modulator and 8-bit a bit-crusher with 4 kHz sample-and-hold,
    both zero-delay; chipmunk (1.5x) and deep (0.7x) use a 30 ms two-tap
    delay-line pitch shifter, ~15 ms added. Checked on the host: 440 Hz comes
    out at ~660/~300 Hz at both 8 and 48 kHz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
2026-10-04 Rename KiCad projects to Analog Redial v2/v3/v4/v5
    Rotary_phone_SMD2 -> "Analog Redial v2", Old/Rotary_phone_SMD3 ->
    "Old/Analog Redial v3", Rotary_phone_SMD4 -> "Analog Redial v4", and
    "Analog Redial 5" -> "Analog Redial v5": directories, project files, and the
    project-name references inside them (schematic annotation instances, the
    PCB's sheet-file fields), checked by exporting each netlist -- every part is
    still annotated. Silkscreen text and the SMD2 Gerber outputs keep their
    names. Doc and code references updated (link targets URL-encoded); two
    already-broken SMD2 BOM CSV links fixed on the way.
    Firmware board-type names (CONFIG_BOARD_TYPE_SMD2/SMD4/SMD5) unchanged.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
2026-10-04 Reset WiFi name checkbox, Vader and robot voices, docs as built, history
    - Reset WiFi gets an "Also reset the board name to phone" checkbox (off by
    default): plain reset for moving a board, ticked for handing it over.
    first_setup.py --reset-wifi ticks it.
    - Voice effects: 7 is now Darth Vader (0.8x pitch, overdrive, short "mask"
    comb resonance) and 9 a generic robot (110 Hz feedback comb, no delay).
    Dalek's make-up gain 2x -> 1.25x: multiplying by a sine halves the average
    power, and 1.25x restores some loudness without clipping (peak 31866 on a
    full-scale test prompt). 323 is now "Call other phone (Vader)".
    - SMD5 dev notes rewritten as a reference for the board as fabricated (8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
2026-10-04 KiCad: rename the Old/ projects, drop stray "ESP32 Phone" copies
    Old/rotary_phone_gateway -> "Old/Analog Redial v1" (the through-hole board)
    and Old/Rotary_phone_SMD_old -> "Old/Analog Redial v2 draft", with the
    project-name references inside updated (netlists export with every part
    annotated). Removes the leftover "ESP32 Phone.kicad_*" projects from the v2,
    v1 and v2-draft folders. Includes the v2 schematic's comment edit and its
    rename fix-ups.
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2026-10-04 BOM and v5 board updates; drop the old DigiKey cart CSV
    Scott's edits: BOM notes for the 30-pin clone module (aimed at v5), a
    shipping row, Bluetooth marked as v5, and the resolved "Open items" list
    removed; the v5 PCB as sent to fab (plus its project-name rename fix-ups);
    hardware/2026-07-02T230626.csv deleted.
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2026-10-04 Advertise the web UI over mDNS; fix the setup page's name hint
    - mdns_service_add() refuses (ESP_ERR_INVALID_ARG, unchecked) until a
    hostname exists, and wifi_init() called it before the hostname was set in
    wifi_apply_hostname() -- so _http._tcp was never advertised and boards
    never appeared in Bonjour browsers. Now added right after the hostname.
    phone.local itself (the A record) was unaffected.
    - Setup page board-name placeholder read "leave blank for": the quoted
    "phone" closed the HTML attribute early. Now "leave blank for default".
2026-10-04 mDNS: answer IPv6 lookups so <name>.local loads in ~1 s, not ~6 s
    The board never created an IPv6 link-local address on Wi-Fi, so mDNS had
    nothing to answer AAAA queries with and macOS waited ~5 s for one before
    falling back to IPv4. Create it on WIFI_EVENT_STA_CONNECTED. Measured on an
    SMD2: phone.local page load 5.9 s -> 0.9 s; AAAA now resolves.
2026-10-04 Condense the SMD2/SMD4 notes to as-built references; fold in SMD3
    - archive/hardware/smd2.md: 1923 -> 210 lines. The board as built plus a
    six-step rework checklist (USB swap, SLIC Vin/Vout, line-1 mic on RIN1,
    DTMF 10k/8.2k divider, LDO EN, SHK), designators, pin map, build options,
    microSD, AEC delays and the BOM. Investigation narratives, the WM8731
    comparison and the deleted DigiKey cart are gone.
    - New archive/hardware/smd4.md replaces ROTARY_PHONE_SMD3.md and
    ROTARY_PHONE_SMD4.md (v3 was the same schematic, never made): pin map from
    the netlist, J5, power, the SHK rework, expected ERC noise.
    - ANALOG_REDIAL_SMD5.md -> smd5.md to match; references, Kconfig help and
    the BOM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
2026-10-04 Remove superseded archive docs
    ESP32_PORT_PLAN.md (the Pi -> ESP32 port, done; the Pi repo is frozen),
    FEATURES.md and GETTING_STARTED.md (replaced by docs/features.md and
    docs/getting-started.md), PROJECT_UPDATE_PLAN.md (the old Pi Zero plan) and
    MCU_VS_PI_ZERO_STACK.md (a settled ESP32-vs-Pi comparison). References in
    CLAUDE.md, firmware/README.md, a webui.c comment and the archived hardware
    docs updated. Debug journals with measurements found nowhere else stay.
2026-10-04 Fix distorted dial tone and effects: lower default output, add tonetest
    Measured with the new `tonetest` console command (plays the dial tone and
    analyzes what the SLIC returns, with a `tx` mode for the digital samples):
    the firmware's tone is clean (0.01% distortion), but at the old default
    codec output (LOUT1VOL 31) it came back from the AG1171 at 19% / 37%
    distortion on an SMD4's two lines, falling to ~2% by LOUT1VOL 21. The
    SLIC's audio input was overdriven.
    - Default earpiece level 31 -> 21 (ES8388_DEFAULT_SPK_VOL); the web slider's
    fallback (30) now matches. Boards with a level already saved keep it.
    - Voice effects level-matched to the input (RMS now within ~2 dB; Vader was
    +3.4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
2026-10-04 Clear voice effect on every hang-up, log effect events and stats, raise default level
    enter_idle() now resets the effect and dialled call_fx, so no hang-up path
    can carry one into the next call. Effect keys, bridge setup, switches and
    call end log to the serial monitor with in/out RMS, peak and limiter counts.
    Default earpiece level 24 -> 28 (measured clean to ~31).
2026-10-05 Add fxtest: deterministic tone-in/spectrum-out check of every voice effect, software and through the line
    Also skip the uplink effect when nothing is reading the uplink (local calls),
    which removes up to half of the effect CPU cost per frame.
2026-10-08 Restructure public docs into a 4-step newcomer flow
    README becomes a front page: use cases first (Bluetooth marked coming
    soon), a "finer print" feature list, clickable web UI thumbnails, a
    case-photo placeholder, and a what-it-costs table with a pooled-order
    interest placeholder. Sourcing and JLCPCB cost/ordering move from the BOM
    into a new docs/board.md; getting-started.md splits into flashing.md
    (toolchain, flash, console self-test) and setup.md (Wi-Fi, web UI tour,
    dial codes, LED, BOOT button, OTA). Every guide page shares one nav bar.
    Also fixes stale content (internet radio is still a stub, 8 settings tabs
    not 6, nonexistent dialmon command, removed THT Kconfig default, SMD4 size,
    C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
2026-10-09 Add VoIP provisioner: claim a number from the board's web UI
    server/voip-provisioner/ is a stdlib-Python service that runs next to
    Asterisk: boards check, register and release numbers over a small JSON
    API, and it writes the SIP accounts and dialplan into include files under
    /etc/asterisk/redial/ and reloads Asterisk. Requests are HMAC-SHA256
    signed (timestamp + nonce + body hash), so neither the enrollment key nor
    the per-board token it issues crosses the network; per-key number ranges
    and board limits make it usable for several households, and the protocol
    works unchanged behind an HTTPS proxy on the internet. Includes an
    installer, systemd unit, admin commands and a test suite (11 tests,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
2026-10-09 Grow both OTA slots to 2 MB (+512 KB) for room to grow
    The app was 34 KB short of its 1.75 MB slot after the HTTPS client went
    in; it now has 290 KB free. 16 MB layout: offsets are explicit so storage
    and bundled keep their addresses (a USB reflash keeps recordings and
    uploaded clips) and ota_1 moves into the previously unused space at the
    end. 8 MB layout: bundled shrinks to 1 MB (the shipped audio is ~0.6 MB),
    storage grows to 2.875 MB but moves, so it is reformatted on the first
    flash; its recording cap rises to 2 MB.
    Existing boards need one USB flash to pick up the new table: an OTA image
    can't change partitions. Verified on an 8 MB SMD4 (boots, storage
    reformatted, bundled 614/957 KB)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
2026-10-09 voip-provisioner: add numbers to the boards' own context, not an include
    Asterisk tries a context's own patterns before included contexts, so a
    catch-all like 'exten => _X.,1,Hangup()' (as on the real target server)
    swallowed calls to numbers in an included context. The generated dialplan
    now re-opens the configured context, where an exact number beats any
    pattern. Installer takes a single --context; endpoints no longer pin a
    transport.
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2026-10-09 Fix form-value truncation, storage listing cap, and unsafe file names
    - form_field() cut the still-%XX-encoded value to the buffer size before
    decoding, so a WiFi or SIP password with several symbols (3 encoded bytes
    each) was silently saved short. It now decodes while copying. The WiFi and
    VoIP form body limits (384/512 bytes) also rejected long encoded forms
    outright; raised to fit every field fully encoded (768/1024).
    - Storage listing stopped at 64 files in readdir order before sorting, though
    the web UI expects 100: past 64 files (an SD card of recordings) the pages
    showed an arbitrary 64 instead of the newest. list_dir() now keeps the
    newest max_entries.
    - Storage path bu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
2026-10-09 Fix barge-in one-way audio, SIP spoofing, XSS, and files with spaces
    - player: after an explicit stop, the play task no longer silences the line.
    The FSM stops a clip and sets the line's next source in the same step
    (bridging an answering-machine barge-in, VoIP downlink, dial tone), and
    the lower-priority play task only noticed the stop afterwards -- its
    audio_tx_silence() cut that new audio, e.g. one-way audio when picking up
    during the greeting. It also no longer claims the line if stopped before
    playback began.
    - voip: INVITE/BYE/CANCEL are accepted only from the configured SIP server's
    address, so other hosts (or internet SIP scanners, once registered through
    a router) ca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
2026-10-09 Ring stop restores normal loop polarity; prune provisioner rate table
    ag1170_ring_stop() dropped RM but left F/R wherever the 20 Hz ring toggling
    last put it, so about half of all answered calls ran with reversed loop
    polarity. It now returns F/R to 0, the power-on state.
    The provisioner's per-address rate-limit table never forgot an address; on
    an internet-facing server it would grow without bound. It is now pruned of
    addresses with no recent activity once it passes 5000 entries.
2026-10-09 VOIP setup script: no shell injection from board name, number or password
    The downloadable Asterisk setup script is run with sudo on the PBX, but it
    embedded the free-form board name (settable by anyone on the LAN) and the
    SIP number in places bash expands -- an unquoted heredoc and a double-quoted
    awk argument -- so a name like $(...) ran as root there, and a SIP password
    containing $ was written wrong. It now uses the board's hostname form
    ([a-z0-9-]), a quoted heredoc delimiter, and only emits a line whose number
    is all digits and whose password has no control characters (a newline could
    end the heredoc early).
    Verified on an SMD4: the generated script is unchanged in content for a
    norma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
2026-10-09 Record why the board last restarted
    A crash, watchdog or brownout restart left no trace -- it just looked like
    a board that had rebooted. Abnormal reset reasons are now logged and added
    to the Status page's activity panel ("Restarted after a power brownout
    (supply too weak?)" etc.), and /api/status carries reset_reason
    (esp_reset_reason_t; 11 = USB reset after flashing, as verified on an SMD4).
2026-10-09 Browser firmware upload refuses images built for another board or flash size
    Every firmware image now embeds its build id ("smd4/16MB": board type and
    flash size) in a framed marker, board_image_marker. /ota_upload scans the
    uploaded image for it as it streams and, before making the new image
    bootable, refuses one whose id doesn't match this board's -- a wrong-board
    image starts up fine with the wrong pin map, so rollback never caught it.
    Images built before this check carry no id and are refused too (flash those
    over USB).
    Verified on an SMD4 (8 MB): the 16 MB SMD4 and the SMD2 images are refused
    ("that firmware is for smd2/16MB, but this board is smd4/8MB -- nothing was
    changed") and the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
2026-10-09 Optional web UI password
    Settings -> General -> Web password. With one set, pages stay readable
    but every POST, and the VoIP server script (which carries SIP passwords),
    needs a signed-in browser (30-day session cookie, kept in RAM) or HTTP
    Basic auth. The password is stored as a salted PBKDF2-SHA256 hash; five
    wrong tries lock sign-in for 30 s, doubling to 10 min. A refused form
    goes to the sign-in page and back.
    Forgotten password: BOOT-button rescue mode lets clients on its own
    network in without it; the 10 s hold and the console's 'webpass clear'
    remove it. The setup network that comes up on its own when no saved
    Wi-Fi is reachable does not bypass it.
    Scripts in firmware/bringup and fi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
2026-10-10 Bluetooth module choice (none/BM64/BK3266) and a BK3266 driver
    Settings -> Hardware now picks which module is on the J2 header; the
    choice is stored as board_bt_module_t (old saves that said 'fitted' read
    back as BM64) and takes effect on reboot. bt_companion dispatches to a
    new BK3266 backend: UART at 9600, frame parser and state mapping in
    plain C (bk3266_proto.c) with host tests built from the vendor's example
    frames, a task that polls call status, pairing/answer/reject/hang-up,
    and caller ID. The BK3266 can't dial out, so the dial plan stops offering
    1 + number when it's the selected module. Bluetooth tab, self-test and
    first_setup.py (--bt-module) are module-aware.
    Bring-up: bk_selftes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
2026-10-10 BK3266 dial-out test, supply-voltage and jumper-check notes
    test_bk3266_dialout.py checks on a real module whether anything can make
    the BK3266 call a chosen number: documented REDIAL, then (with --explore)
    the undocumented gaps in the command table and a few text-AT guesses.
    Dangerous codes (factory reset, clear pairings, test/idle/transmit mode)
    are refused. bk_frame/bk_send/bk_at now work while the driver runs.
    Corrects the earlier reading of codes 0x13-0x1C as DTMF digits: in the
    serial protocol they are queries and test tones. Adds the text-AT
    firmware's command and status table, a supply-voltage section (a 3.6 V
    XC6206 variant is a drop-in), the symptoms of a wrong JP2/JP3 jumper, and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
2026-10-10 v5 board: one set of files, named 'Analog Redial v5'
    The Oct 7 working copy (was 'Analog Redial 5.*') becomes
    'Analog Redial v5.*', matching v2/v4/v6 and the doc paths. Project name,
    schematic instance paths and PCB sheetfile references renamed to match;
    the silkscreen texts are untouched. The old as-fabbed v5 pcb, fab zip
    and stale project file are removed here and remain in d18d89c.
    Checked after the rename: netlist has the same 75 parts and 91 nets,
    DRC reports 0 violations / 0 unconnected / 0 footprint errors.
2026-10-11 v5 schematic: fix note wording (changes from SMD4)
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2026-10-11 sdcard: bring the SPI bus up once, so a remount doesn't log an error
    Observed on a real pull/reinsert: every remount logged
    'spi_bus_initialize: SPI bus already initialized' at error level.
    The bus is never freed, so initialise it on the first mount only.
2026-10-11 VoIP: keep looking for the server quietly, and again when the network changes
    Away from home the .local server name can't be resolved. The task
    already retried every 5 s forever, but each attempt blocked it for 2 s
    and logged a warning. Now: back off from 5 s to once a minute, say it
    once and then only every ~20 tries, and report 'found after N attempts'.
    Also fixes a staleness bug: once resolved, the server address was never
    looked up again, and the Contact address was only set at registration.
    If the board's own address changes (a different network, or a new DHCP
    lease), the cached server address and the registrations are dropped and
    looked up again, so credentials aren't sent to whatever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
2026-10-11 Storage listing: skip folders and dot-files; verify list status
    A card that has been in a Mac shows .Spotlight-V100, .fseventsd and
    ._name files as recordings. The store is flat: list only regular files
    that don't start with a dot. Seen on the dualphone2 after OTA.
    archive/VERIFY_2026-10.md: record what was proven on the 16 MB board.
2026-10-11 Docs: fix the board photo path and the SMD5 photo's alt text
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2026-10-14 Home Assistant: board-to-HA webhook events, and an untested HA doc
    A new webhook component POSTs JSON for offhook, onhook, dial, wrong_number,
    ring, answering_machine and recording to one http:// URL (Settings ->
    General). Its task and queue exist only once a URL is set. /api/status gains
    webhook_on, webhook_last_status and heap_largest_block. docs/home-assistant.md
    has REST sensor, rest_command and webhook-automation YAML; marked untested.
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2026-10-14 MQTT with Home Assistant auto-discovery, switchable at run time
    New mqtt_ha component: Settings -> General -> MQTT (Enabled checkbox, broker,
    user, password). While enabled the board publishes retained discovery
    messages (line sensors, ring buttons, an event entity, pin-output buttons,
    Wi-Fi signal, free memory), line state, and the same events the webhook
    sends, and accepts redial/<id>/cmd/ring/<line> and cmd/pin/<code>. While
    disabled nothing is allocated. Plain mqtt:// only.
    Works around an esp-mqtt (IDF 5.2.8) use-after-free: the client task writes
    client->state after esp_mqtt_client_stop() returns, so stop() now waits
    300 ms before destroying (crashed 1 in 4 on stop-then-start before).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
2026-10-14 MQTT review fixes; HA codes, message waiting, quiet-hours ring; clip OOM fix
    Review fixes:
    - MQTT events go through a queue to the mqttha task: the phone logic no
    longer calls into esp-mqtt, which could block it on a slow network write.
    - One shared telephony_bell() with a timer per line for the Diagnostics
    ring and Home Assistant: a second ring no longer leaves the first line
    ringing, and the timer leaves a real incoming call's bell alone.
    - Webhook: "answering_machine" was cut to 15 characters; a client-alloc
    failure showed as "HTTP 257".
    - MQTT: "test" added to the event types; late events from a client being
    torn down are ignored; the form names the real error and only keeps th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
2026-10-14 Explain the three wired options as four spare pins the J5 jumpers assign
    Friends found "second line / microSD / pin outputs" confusing without the
    reason they're exclusive. The diagrams and docs now say it once, in terms
    of what you do:
    - Overview diagrams (both layouts, all sizes): options bar / heading reads
    "Four spare pins, one job at a time: the jumpers pick."; each option says
    what you do (Jumpers on / Jumpers off, card in / Jumpers off, your
    wires); "4 pin outputs" is now "Your own gadgets" (relay, light, buzzer).
    - Letter and poster sizes: a drawing of J5 in each of the three states in
    the PICK ONE entry of the key; the diagram shrinks to fit the key.
    - New parts: j5-jumpers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
2026-10-14 Hackaday draft: sync with the live page (Home Assistant, J5 wording)
    Section 4 is now the text as it stands on hackaday.io: Home Assistant in the
    intro and as its own section, the four-spare-pins/J5 explanation, answering
    messages on the board or a card, the 3D case and GitHub sections. Notes
    what's still [YOU]: the broker address step, the v4-only case, and a
    duplicate Home Assistant paragraph on the live page. Adds the overview
    diagrams to the image list and a Home Assistant summary alternative.
2026-10-14 Top-layout overview: show J5 under each option, between it and the bar
    Each of second line / microSD / your own gadgets now has the J5 drawing for
    that option directly below it, captioned "J5 jumpers on", "J5 jumpers off,
    card in", "J5 jumpers off, your wires", so the jumper positions can be seen
    per option. The key's J5 strip is dropped from this layout (the side layout,
    whose cards are too narrow for it, keeps the strip). Also notes the three
    Hackaday page fixes in the draft's checklist.
2026-10-15 Overview diagrams: Wi-Fi and its services on top, wired options below
    Flipped both layouts. Wi-Fi bar and the web interface / VoIP server / Home
    Assistant now sit across the top, with the board under them; in the options
    layout the three jumper options (with their J5 drawings) are below the board
    on the pick-one bar, and in the side layout Bluetooth and the cell phone move
    below the board with the option cards still on the right. New parts:
    board-core-down (connector on the bottom edge) and bluetooth-adapter-below.
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2026-10-16 Settings cleanup: Features card, Home Assistant tab, card order, memory map
    - General: board hardware card moves here from Hardware; new Features card
    (VoIP, Bluetooth, Home Assistant) decides which optional tabs show.
    - Home Assistant gets its own tab (MQTT, webhook, HA codes); unticking it
    stops webhook events and turns MQTT off.
    - Cards reordered on every tab so rows fill before a full-width card;
    Operator help and Record message sit beside Dial codes.
    - Bluetooth: Status no longer squeezed into one column by a wrapper div.
    - Memory map: app slots together, larger partitions first, small ones
    folded into "Other".
    - WiFi card: Connect button showed the "Saved networks" label.
    Co-A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
2026-10-16 Settings: optional tabs always shown with an on/off bar; hardware choice drives Bluetooth
    - Remove the Features card. VoIP and Home Assistant have their switch in a
    bar at the top of their own tab; Bluetooth's bar says what turns it on.
    A dot on a tab marks a feature that's off. Settings are kept while off.
    - Board hardware: "J5 is used for" second line / microSD card / pin
    outputs (was "Neither"); choosing a Bluetooth module turns Bluetooth on
    at boot, None turns it off.
    - Shorter tab names (Phone, Dial Codes) so the tab row fits on one line.
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2026-10-16 Dial codes up to 10 digits; save the code tables one slot at a time
    - Codes can be 2-10 digits (code[12]); the recode boxes are wide enough to
    show all of them.
    - The dial-code and pin-code tables are saved as one small NVS blob per slot
    instead of one table-sized blob. A table-sized write needs a free stretch of
    a page, and on a board whose settings area had filled up it failed silently
    (new defaults, and later edits, never reached flash).
    - Saved tables from earlier firmware are converted at boot; the old copy is
    deleted only after the new one is written. Write errors are logged.
    - An empty clip table (built-in codes can't be deleted, so empty means lost)
    gets its defaults back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
2026-10-16 Dial codes: show whether each audio file is ready, let any code be removed
    - Each dial code row now says whether its file is on the board and looks
    playable (ready with length and size, file missing, or can't be played)
    and keeps the code either way. The check looks the way the phone does,
    including the .wav/.mp3 swap, and the web player uses the file that
    actually plays (dialup.mp3 now resolves to dialup.wav).
    - The file box has a pick-list of the audio files on the board.
    - Every code has a remove button, built-in ones included (they come back
    after a factory reset); an emptied table stays empty.
    - Boot log warns about dial codes whose audio file is missing.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
2026-10-16 Dial codes: built-in codes are recodable; drop the built-in label; review fixes
    - New "Built-in codes" card lists every fixed code (0, 211, 314, 321-324,
    811/812, 821/822, 899) with a box to give it another code; clearing the
    box restores the default. Codes this board can't use (3xx on a one-line
    board) are shown greyed out with the reason. Saved in NVS ("dialfixed").
    - The dial guide, Operator/Record cards and the readback buttons find
    built-ins by their default code, so a recoded one still shows and works.
    - No "built-in" label on clip codes.
    - Fix: a spoken readback digit ending by itself silenced the line ~120 ms
    later, cutting off a dial tone that started in the meantime (quic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
2026-10-16 Touch-tone detector follows fast dialers; web pages stop starving the audio
    DTMF (dialing "867-5309" on a lineman's test set dropped digits):
    - Four Goertzel windows staggered by a quarter window (a decision every
    ~6.4 ms) instead of one every ~25.6 ms, analysed at 8 kHz (the 48 kHz input
    is averaged 6:1), so it is cheaper than before (0.77 ms vs 0.93 ms per
    10 ms frame on the board) while tracking 40-50 ms tones and pauses.
    - A key that differs from the current one in both row and column starts a new
    press without waiting for a pause.
    - Tone-ness check: the strongest row and column bins must hold half the
    window's energy. Rejects speech, music and modem sounds that the shorter
    w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
2026-10-16 Pi (314): 1 s pause before it starts, much less time between digits
    - Starts one second after the number is dialled.
    - Gaps: about 20 ms between digits, 250 ms after every 5th and 500 ms after
    every 10th (was 80 / 450 / 900 ms).
    - Digit clips are played chained: all but the last skip the 120 ms tail wait
    and the line silencing (player_play_chained()).
    - storage_read_open() remembers names missing from writable storage until a
    file changes. Each miss cost ~225 ms and the bundled clips (the spoken
    digits) were opened twice per play, which is where most of the time between
    digits went. Whole reading: ~100 s -> ~51 s.
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2026-10-17 Call recording: a one-shot capture of everything one call sends and hears
    Settings -> Diagnostics -> Call recording. Press "Record the next call", lift a
    handset: from pickup to hang-up the board writes a stereo WAV to the microSD
    card, "call record YYMMDD HHMMSS.wav" (16 kHz, left = what the phone sends:
    voice and touch-tone digits; right = what the earpiece hears: dial tone,
    ringback, clips, the other party), then switches itself off. For demos, videos
    and bug reports.
    - New callcap component. Taps the uplink (diag tap) and downlink (the muxed
    TX) in the same audio pass so the channels stay aligned; buffers in ten 2 KB
    chunks passed to a writer task (one big buffer didn't fit the frag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
2026-10-18 Brownout record and warning; web server route table to 128
    Restart reasons (brownout, crash, watchdog) are now counted in NVS, so a
    power cycle or a boot loop can't erase them like it erases the RAM log;
    Settings -> Hardware shows the counts. After a brownout restart: an amber
    double blink on the RGB LED and a banner on every page until dismissed, a
    falling 880->220 Hz 'battery running flat' tone on the first pickup, and a
    'power' webhook/MQTT event.
    The route table (96) had overflowed at 97 routes, silently dropping the
    catch-all 404 route and /voip_instructions.txt.
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2026-10-18 Power diagnostics: skip USB console with no host; CPU per task in the black box
    With no computer on the native-USB console port (battery pack, charger),
    log output to it is now skipped (the RAM ring still gets it). The black
    box runs at high priority and records per-task CPU use since the last
    save and whether a USB host is present (FreeRTOS run-time stats on).
2026-10-18 Console: own read loop that sleeps with no USB host
    ESP-IDF's REPL task loops straight back into linenoise() when it returns
    NULL; with no computer on the native-USB port (any charger, battery pack
    or DC-jack power) that happens instantly, every time, and the black box
    measured it at 78% of the CPU. That starved clip playback (314 stopping
    after a few digits, then every clip failing) and the web server. The
    console now waits for a USB host and never spins.
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2026-10-18 README: overview diagram, a use-case table, a simpler cost table
    Adds the no-text setup overview, replaces the four use-case cards with a
    table (what you get / what you need, now including Home Assistant, the
    answering machine and pin outputs), and rebuilds the cost section as a
    per-board and five-board table with totals. Fixes 'an cheaper' and the
    'machine-' punctuation in the tagline.
2026-10-18 README: web-size overview image, finer print brought up to date, Bluetooth cost row
    New -web overview size: no legend, tight margins, text 12% larger. Pill
    widths and the Bluetooth board label adjusted so the larger text fits.
    README finer print now covers Home Assistant, pin outputs, call recording,
    spoken digits, recodable codes, the VoIP provisioner and test proxy and
    the brownout warning. Hackaday draft: J5 section rewritten as three
    options.
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2026-10-20 OTA layout gate; BM64 diagnostic leads on any of GPIO18-21; BK3266 wake experiments
    Web UI: a board whose update slots are still the old size shows a note and
    has the update check and banner switched off until it is reflashed over USB.
    BM64: the RST_N / P2_0 leads' pins are runtime settings in NVS
    (bm64_diagpins, bm64_findwire); IBDK entry that fails tries them swapped
    once. On the first real board the leads were on GPIO18/19, one header pin
    off the documented 19/20; with that set the EEPROM check ran and repaired
    4 of 6 audio bytes. BK3266: bk_powercycle and bk_wakeseq for WAKEUP
    experiments.
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2026-10-20 Bluetooth folder: drop vendor tool package and reverse-engineering scripts; keep the English BT401 datasheet
    The Microchip DSPK package (about 130 MB of Windows tools) stays on disk but is ignored; the BM64 probing
    scripts and the Arduino bridge are replaced by the firmware's own IBDK code. The EEPROM protocol notes are
    kept as BM64_EEPROM_PROTOCOL.md.
2026-10-20 Docs sweep: Bluetooth and v5 marked working; features, HA, setup, flashing and BOM brought up to date
    Web UI: the Bluetooth tab no longer calls v5 untested; it only says a V4 board needs the V5 hardware.
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2026-10-20 Wi-Fi: forgetting a saved network no longer brings it back as a duplicate
    The legacy single-network pair is written on every connect, and the one-time migration into the list
    re-ran whenever slot 0 was empty. It now runs once (mig_done) and skips a network already listed.
    Docs: the U5 voltage note is only about v6 and lives in the archive BOM.
2026-10-20 Hackaday: a read-only page checker using the official API
    archive/hackaday/check_page.py fetches the project and its logs (GET only, an
    API key from dev.hackaday.io) and reports: a summary over 140 characters,
    repeated words, double spaces, a missing space after a full stop, a paragraph
    that appears twice, leftover [YOU] / TODO notes, links that don't load,
    misspellings (aspell or hunspell), and any difference from
    archive/hackaday/hackaday-page.md, down to the changed words.
    The API docs don't list the response fields, so it finds every text-like
    field itself and prints what it found. The key comes from HACKADAY_API_KEY or
    ~/.config/hackaday/api_key, outside the repo, and is never printed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
2026-10-20 Web UI: Hardware tab rows (Restarts and Reset on row 2), idle power on by default with a short hint, dial guide cleanup
    Status page: the description sits under the code, no 'working' pills, enabled/disabled pills only for the
    Bluetooth, VoIP and Home Assistant codes. Dial codes 811/812 (internet radio) removed. Low-power idle mode and all
    its options default to on; 'not yet tested by ear' removed; the long hint moved into a Details expander.
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2026-10-21 Fix SMD2 build: guard BM64 diagnostic-pin code to boards that have the mode pins
2026-10-21 Mark v6 as next generation, in progress and untested; build v5 for now
    The public docs showed a v6 render as the "Get a board" hero image and listed
    only v4 and v5, so a visitor could take v6 for the board to build.
    - docs/board.md: v5 image on top; the version table gains a v6 column
    ("Next generation, in progress. Not built or tested yet") and a plain
    "Build v5 for now" note.
    - The clone-footprint warnings (board, bom, hardware-smd5) now say the v6
    fix is in progress and untested.
    - README project history: a "Next | v6" row, in progress, build v5 for now.
    - hardware/kicad/Analog Redial v6/README.md: the same, for anyone who lands in
    the folder.
    - CLAUDE.md: don't describe v6 as wo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
2026-10-23 Replace the BK3266 option with the BT401 (DFRobot DFR0781)
    Removes the BK3266 driver, console commands, test scripts and host test.
    Adds a text-AT driver (bt401.c, pure-C bt401_proto.c with host tests), the
    Hardware option, bring-up console commands and archive/hardware/bt401.md.
    Dial-out is supported. Untested on a real module.
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2026-10-23 wifi_proto: say the setting survives a reboot (the Wi-Fi driver stores it)
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2026-10-23 Update spoken audio: one button remakes every TTS clip whose voice or text changed
    The TTS service tags each WAV (voice + text hash, LIST/INFO) and reads dial codes
    written 2-1-1 as digits; the provisioner reports the voice and doesn't count cache
    hits against the quota (now 40/hour, 120/day). Boards compare the tag and render
    only what's out of date, in a background task.
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2026-10-24 Keep this board up to date: optional nightly automatic firmware update; clearer update banner
    New autoupdate component (off by default, 2:00 am): at the chosen hour the board reads
    the GitHub release list, downloads a newer release for itself into the spare slot,
    checks its SHA-256 and board id, and restarts into it; waits while a phone is in use;
    never replaces a development build. The update banner now has a bold Update now link
    and a small x in the corner that hides it until the next release.
2026-10-24 Automatic update: accept a tighter heap (48 KB free, 20 KB block) so SD-card boards can run it
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2026-10-25 Board-to-board: look for other boards as soon as Wi-Fi is up (quickly for the first minute) and remember them across reboots, so a number dialled right after power-up works
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2026-10-25 v6 board released (untested): clone 5V pin fix, silkscreen updates; JLCPCB export files; docs say untested but should work
    U5 stays the 3.3 V XC6206P332MR (JLC Basic); the 3.6 V part was not done.
2026-10-25 v5 PCB: clone 5V pin footprint fixed; docs say the warning is for boards made before the fix
2026-10-25 Docs pass: fix dial-up code (412), stale build options and tabs, ringing voltage, flashing steps, LED and Bluetooth details; HA timer/power events (also in MQTT discovery); SIP-provider idea in the a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
2026-10-25 Fixes from review: board-to-board hang-ups resent until answered and late BYEs answered; homecall peer list (moved boards, own address, digits-only numbers, line-2 number, locking); timer fallback be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
2026-10-25 Review fixes: no 1xxx board numbers on Bluetooth boards (or set by hand), why a board-to-board call failed in the activity log, idle-power savings estimate, folded VoIP settings span the row, console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
2026-10-25 v5 back to the as-fabbed files; v5.1 = v5 with the clone 5V-pin fix; track every board's JLCPCB/PCBWay exports. Docs: expansion header (J2) with its pinout, payphone section. Echo test: quiet the lin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
2026-10-25 Echo test: measure the background for 1.5 s and require it to be steady; use a few KB instead of two 38 KB buffers (it silently failed on a board with a microSD card, leaving the dial tone on); say w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
2026-10-25 Wi-Fi power-save with a VoIP server too; dial tone region card: follow box first, region list stays readable and unticks follow when used; digit readback text no longer says planned
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2026-10-27 v6 KiCad files and exports (SS34 D1, larger power vias, teardrops); PayPhone project and cards; README: fix the v5 board image name (case); ignore KiCad local history and editor backups
2026-10-27 v5 folder: README (as fabbed, known clone-pin error, where the fix is) and the fab package as sent on 2026-10-05; releases now build the 8 MB images too
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2026-10-27 Coin board: through-hole version with DigiKey parts, I2C/audio note, TVS standoff fix
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2026-10-27 BT401 notes: simpler pin table (fixes rendering), bench power-up steps
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2026-10-28 Fix echo Measure button (apostrophe broke the page script); dial-out accepts any number after the 9; note BT device rename
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2026-10-29 BT401 adapter board v1 released for fab (C1 to GND, reset and DACR on J2); docs: designed, not yet built or tested
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2026-10-30 Payphone coin board: Rz/Cz/Cp compensation worked out (DCM, 1 M / 150 nF / 100 pF), divider replaces the bleed chain, Rg 100 ohm, Cf/Cslope to ISENSE, names matched to the schematic; gen_modem.py syn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
2026-10-30 Payphone coin board schematic: through-hole footprints for all resistors and capacitors (1/4 W DIN0207, R11 0.5 W, Rcs 1 W, 5 mm ceramics, film Cz), G6S-2 footprint for K1, Cf 470 pF; Qa/Q3 swapped, 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
2026-10-30 Payphone_v1: U3 = UC3843BNG (onsemi UC3843AN obsolete); U4 ADS1115 fixed (VDD to 3.3 V, ADDR to GND, AIN1 divider 56k/10k, C17), ISENSE on AIN2; docs: THT vs SMT price comparison with Extended-fee re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
2026-10-31 Web UI: Board hardware card gets a Save and reboot button; it won't reboot while a line is in use (settings stay saved), and returns to the card afterwards
2026-10-31 16 MB layout uses all of flash: 3.5 MB OTA slots, 1.5 MB bundled, storage to the end (7.375 MB); a prompt whose generated file is missing counts as pending, and flash_board.py syncs prompts after fla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
2026-10-31 Heap: about 40 KB more free at idle. FatFs buffers sized for the SD card's 512-byte sectors, not 4 KB (CONFIG_WL_SECTOR_SIZE_512: ~25 KB while a card is mounted); a board confirmed as one line skips 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
2026-10-31 README related projects: drop Blue Pot (weeBell replaces it); weeBell's cost adds the gCore it needs; Analog Redial runs from a USB-C power bank; "2nd phone line" row
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2026-10-31 Coin board: U1 is a TCA9534APWR (TSSOP-16, LCSC C206010) at 0x39 (A0 to VIO), one above the main board's 0x38; P0-P7 keep the GP0-GP7 roles; R10 (MCP23008 reset pull-up) removed; docs list the new pi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
2026-10-31 Coin board docs: SMT board only, matching the schematic. Through-hole BOM, DigiKey lists, footprint tables and alternatives removed; one parts list in coin-board-smt.md; refs and parts corrected (Q1 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
2026-11-01 Coin board: Cp1 (100 pF, COMP to FB) added to the schematic and PCB updated from it; docs no longer list them as to do
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2026-11-01 Coin board, in progress: fewer Extended parts. D14 removed; F1 now a through-hole Bourns MF-R110 (C208481), hand-soldered; C21 replaced by C21-C23, three Basic 100 nF 50 V 1206 caps (C24497) in serie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
2026-11-01 Board-to-board numbers: only dial codes this board can use block a number, so a one-line board can be 321; resetting a built-in code now checks for conflicts
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2026-11-02 Coin board schematic review fixes: J1/J6 pin order now matches the v6 J11 header (a 1:1 cable used to swap +5 V and GND); D14 ES2D freewheel from RETURN to HV; R44 1 k in series with ADC AIN2; Rslope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
2026-11-02 Coin board docs brought in line with the schematic: J6/J11 pin order, P0 quarter and P2 nickel, U4 is a module on a header (its footprint's pad numbers still need fixing), D14, R44, parts no longer g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
2026-11-02 v6: drop the SMD6_CHEAP build. A clone module runs the smd6 build with JP2/JP3 on the clone side and keeps its USB console. smd6.md: bring-up checks for two lines on the card and the coin board on th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
2026-11-02 Touch-tone test: fix the script error that stopped every button, say to pick up the handset when on-hook; Copy log replaces email, and the log carries firmware and board details. * and # reach the di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
2026-11-04 Coin board: cost estimate for 5, 10 and 30 boards (JLCPCB parts, fees, PCB, shipping, tariff, DigiKey hand-solder parts), and six no-fee swaps for Extended parts
2026-11-04 Coin board: LCSC numbers on every part in the schematic from the JLCPCB selection, with fixes: D4 C81598 (was a SOD-323 part on SOD-123), R12 100 ohm 1206 C17901 (was 0603 on 0805, and 0.13 W is too 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
2026-11-05 Coin board: net classes and track/via presets (HighCurrent 1.0 mm, Power 0.8, HV 0.5 with 1.0 clearance, Default 0.25); Power pattern fixed to /20V
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2026-11-06 Prompts: stored in a hidden file on internal flash, not a 16-slot NVS table
    Up to 100 prompts, each costing only its own text; the generated text is kept
    as a hash. Boards with the old NVS table move it to .prompts.json on first boot
    and free the NVS space. A factory reset deletes the file.
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2026-11-06 Coin board firmware (U1 + U4 driver, coin inputs, collect/return), v6 J10 pin outputs
    - coinboard component: TCA9534A at 0x39 polled every 3 ms, debounced coin
    inputs, ADS1115 at 0x48, and the firing sequence with its limits (rail and
    HV checks, overcurrent, current after FIRE off, chip reset and held pins
    seen from the output readback). Settings and tests on the Payphone tab,
    /api/payphone "board", console "coinboard", a self-test check.
    - telephony: coins held per pickup; collected when a placed call is answered,
    returned on hang-up without one; coin tones ignored on the coin board's line.
    - v6: J10's P4-P7 (line 2 expander) as pin dial-code outputs.
    - Host tests for coin inputs,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
2026-11-07 Coin board: R1 (10k) LCSC C17414, R3 (100k) LCSC C149504 to match the swapped values; layout in progress
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2026-11-08 Echo cancellation: Enable is saved and restored at boot
    The saved value is the canceller version (AEC_SAVE_VERSION), so a line only
    comes back on under the same canceller. The CPU is held at full speed only
    while a call is running the canceller, so an enabled line no longer keeps
    an idle board out of low-power mode.
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2026-11-08 Coin board v1: released for fab
    Layout finished. Identical parts share one description, SOT-23 rotation
    fixed for JLCPCB, R17/R19 now 150k/27k (Basic), C5/C7/C14/C20, U3, F1
    and D3 hand-soldered. Docs: DigiKey order list with links, HASL needed
    for Economic PCBA.
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2026-11-08 Coin board docs: J2 has green on pin 1, white on pin 3; turn on Swap
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2026-11-11 Voice effects: cleaner chipmunk/Vader, a real robot voice, everything at 8 kHz
    - Pitch shifting splices by cross-correlation (jumps a whole number of voice
    periods, then crossfades in step) instead of blind 15-30 ms crossfades: on a
    voice-like test tone, harmonic purity 13 -> 19 dB, level wobble 12% -> 4%.
    - Robot: STFT with the phases zeroed, resynthesized every 8 ms -> a steady
    125 Hz monotone (was a 110 Hz comb that barely changed the voice).
    - Effects run at 8 kHz around the 48 kHz streams, and the 48 kHz uplink effect
    is skipped while a call reads the echo-cancelled 8 kHz stream. At 48 kHz the
    pitch effects did two 64-bit divides per sample per stream, which on a VoIP
    call w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
2026-11-11 Voice effects: anti-alias filter before the chipmunk shift, full-precision robot, both ~2 dB quieter
    - Chipmunk at 8 kHz pushed everything above 2.7 kHz past Nyquist, folding it
    back as harsh noise (a 3 kHz tone left its alias at -3.7 dB). A 6th-order
    low-pass ahead of the delay line: -38 dB. Crossfade 6 -> 8 ms.
    - Robot: block floating point around the FFT (a voice at -30 dBFS came out as
    a few bits of grain: -21 -> -36 dB error), and a fixed quadratic phase so
    each 8 ms frame is a short chirp instead of a click.
    - Uplink stats report the echo-cancelled path when that's the one running.
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
